anurakj/J88_stork/Air Filter.pdf

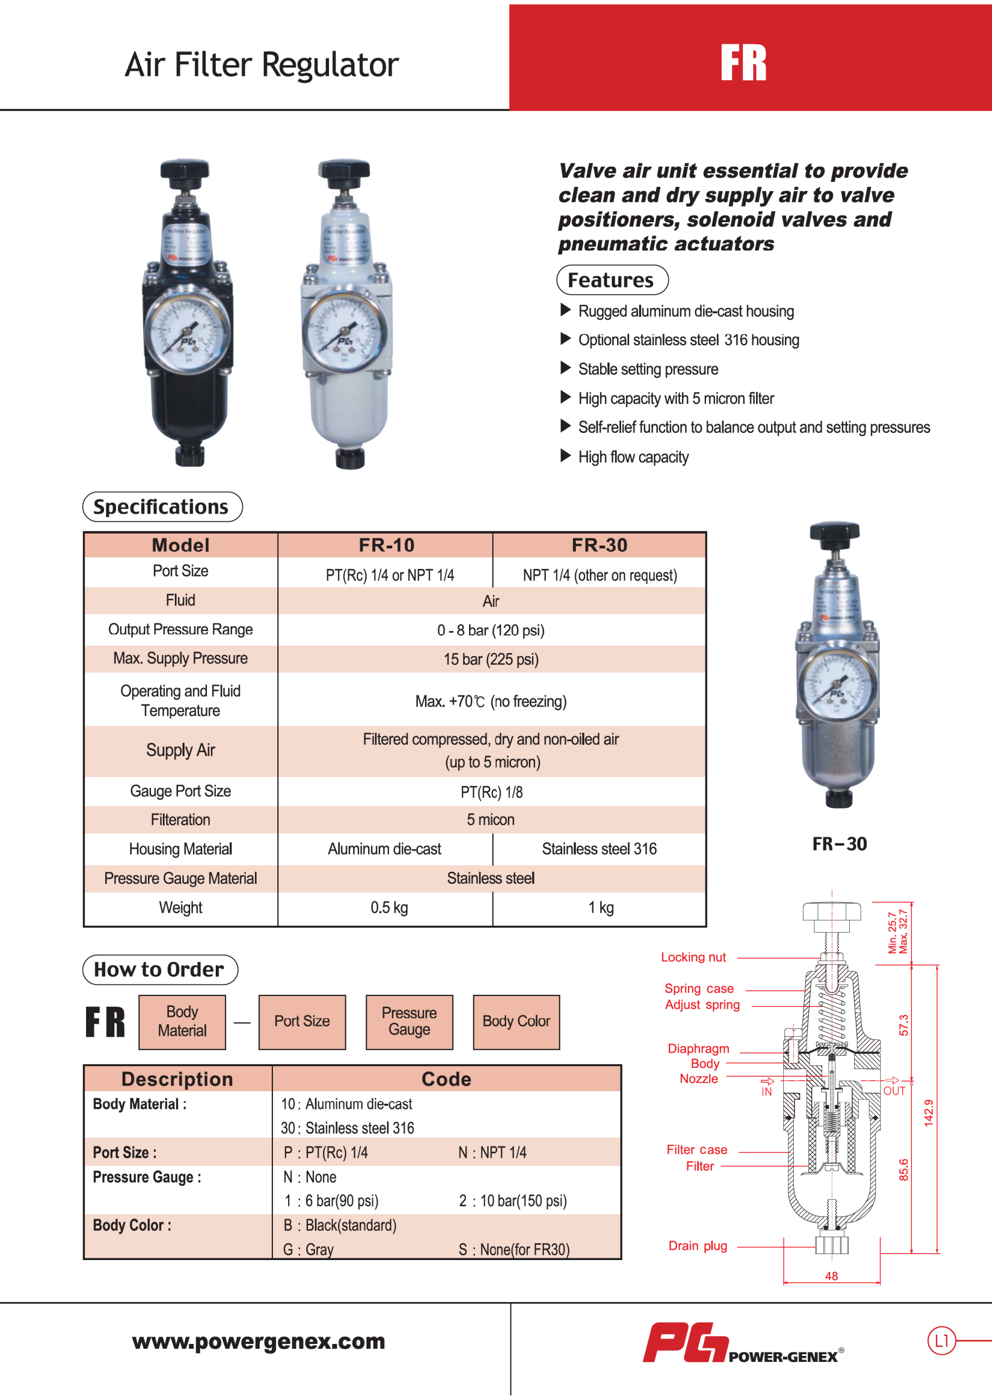
[picture p3: page 1]
