anurakj/J88_stork/Bypass_valves_logic_box/Catalogues/DIN_rail.png

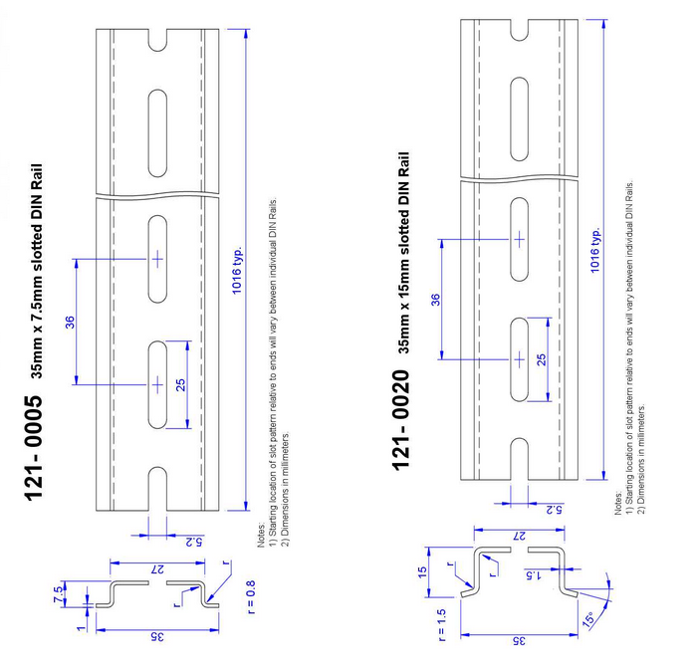
Bypass_valves_logic_box/Catalogues/DIN_rail.png
