anurakj/J88_stork/Bypass_valves_logic_box/Catalogues/Relay_socket_(Omron_PYFZ-14-E)_(top_view).png

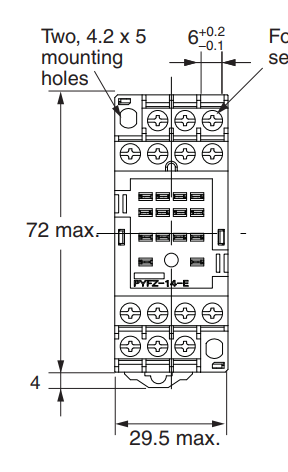
Bypass_valves_logic_box/Catalogues/Relay_socket_(Omron_PYFZ-14-E)_(top_view).png
