anurakj/J88_stork/ER.jpeg

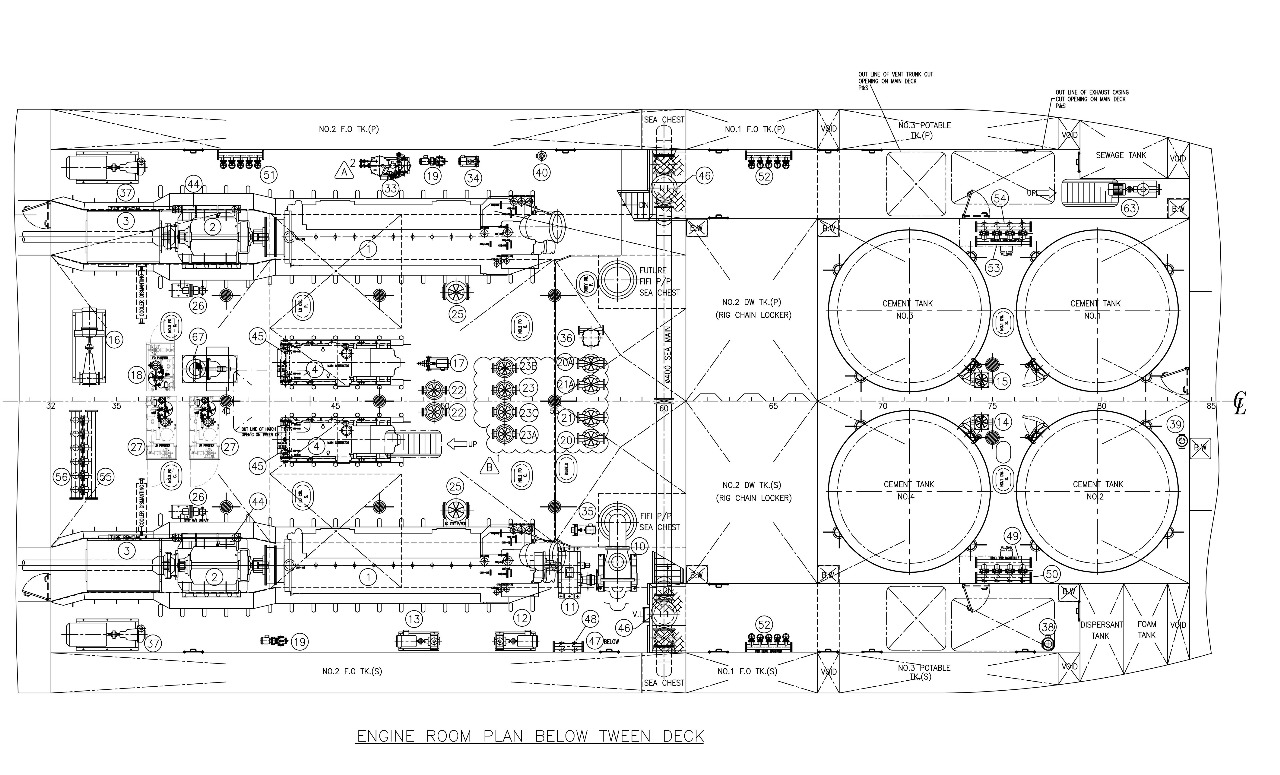
ER.jpeg
