anurakj/J88_stork/GSPL-P1482-PI-0301 Piping Spools drawing for BWTS  (1''& Above) R.B/Sampling.jpg

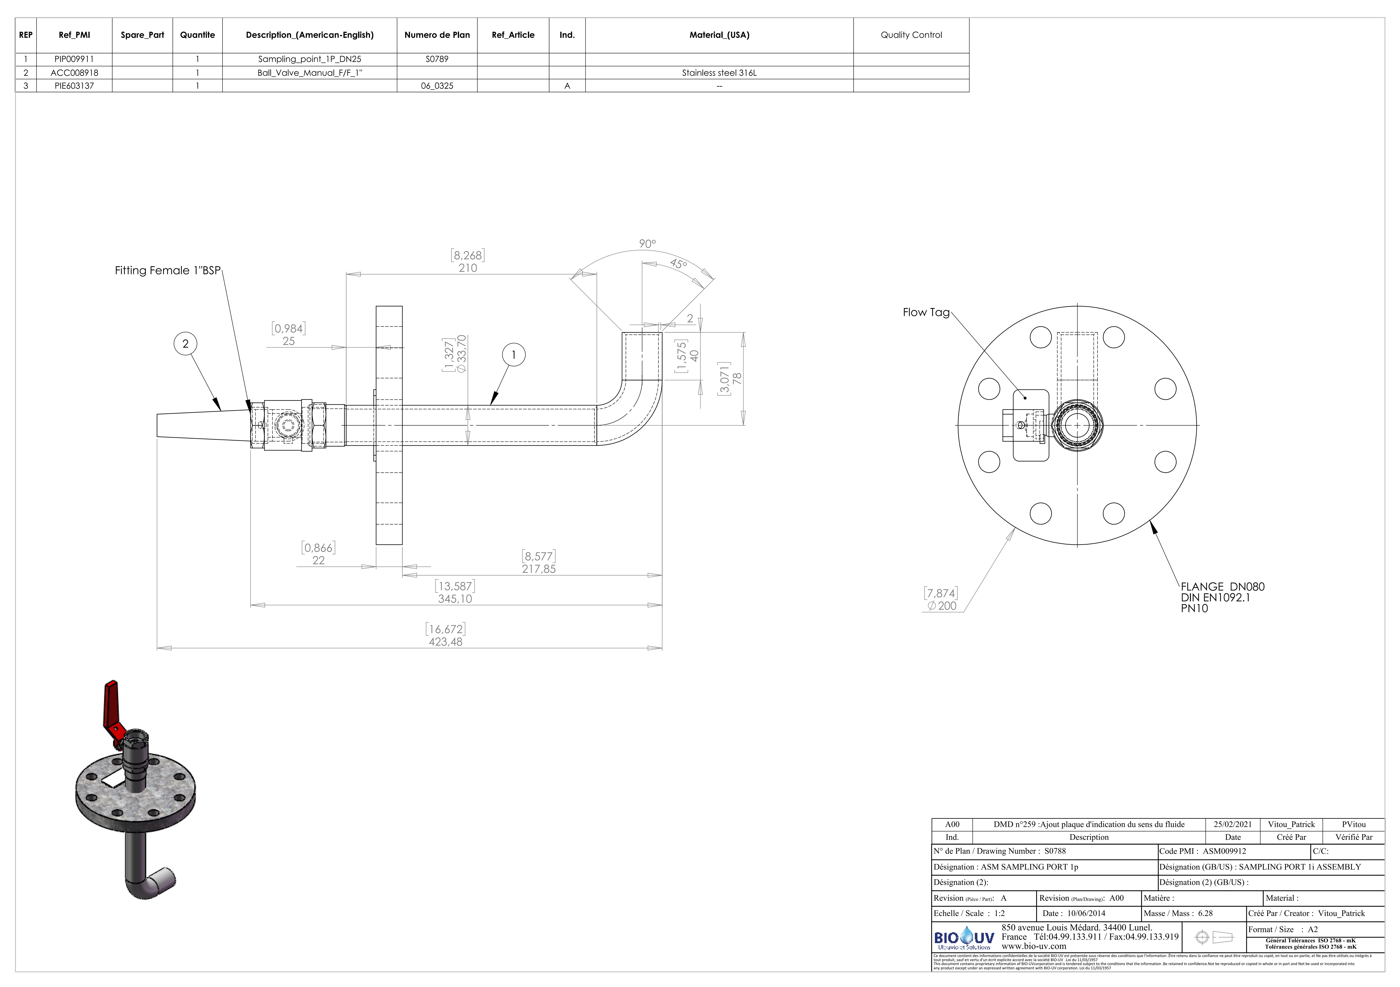
GSPL-P1482-PI-0301 Piping Spools drawing for BWTS (1''& Above) R.B/Sampling.jpg
