anurakj/J88_stork/Bypass_valves_logic_box/bypass valves logic box BOM_rev-B.xlsx

Revision-B |  |  | Note: This BOM is based on bypass valves configuration matrix revision B
Bypass valves logic box Bill Of Materials (BOM)
Vessel: J88 Stork
ITEM NO. | DESCRIPTION | BRAND/MODEL | QTY | Unit price (SGD) | sub totalc Price (SGD) | Remarks
1 | INTERPOSSING RELAY (4 CONTACTS) C/W SOCKET BASE |  | 20 pcs | $ 8.5 / set | 170 | Use 17 pcs. 3 pcs. for spare (loose spare. Not install in the box).
2 | 2 POLES 10 A MCB | Schneider | 1 pce | $ 23 / pce | 23
3 | 1.5 mm2 TERMINAL |  | 60 pcs | $ 0.85 / pce | 51
4 | Side plate for terminal |  | 10 pcs | $ 0.6 /pce | 6
5 | Stopper for terminal |  | 10 pcs | $ 0.6 /pce | 6
6 | Aluminium DIN RAIL 1 meter |  | 2 pcs | $ 3.5 / pce | 7
7 | 1.5 mm2 WIRE (GREY COLOUR) |  | 1 roll (100 meters) | $ 34 / roll | 34
8 | CABLE LUG PIN TYPE (1.5 mm2) |  | 1 pkt | $ 15 / pkt (500 pcs) | 15
9 | CONTROL BOX TO INSTALL ALL COMPONENTS) C/W MOUNTING HOLES AT 4 CORNERS) 400mm (W) X 500mm (H) X 200 MM (D) |  | 1 pce | $ 98 / pce | 98 | IP65, Color RAL7032 Light Grey
10 | M10 BOLT, NUT AND WASHER TO MOUNT THE CONTROL BOX |  | 4 set | $ 5 / set | 20 | Assume bolt nut 1 set 5 SGD
11 | 1.5 mm2 WHITE COLOUR FERRUL TUBE FOR WIRE ID |  | 5 meters | $ 0.2 / meter | 1
12 | 50mm x 50mm wire duct |  | 1 pce (2 meters) | $ 15 / pce | 15
13 | Cable grand (M20 X 1.5) (Nickel plated) |  | 17 pcs | $ 5.50 /pce | 93.5
14 | Cable grand (M25 X 1.5) (Nickel plated) |  | 1 pce | $ 7.60 /pce | 7.6
15 | Cable grand (M32 X 1.5) (Nickel plated) |  | 1 pce | $ 9.80 /pce | 9.8
16 | Design Engineering |  | 5 days | $ 25 /Hour | 1062.5 | 1day = 8.5 Hours
17 | Control BOX fabrication and wiring (Labour) |  | 5 days | $ 25 /Hour | 1062.5 | 1day = 8.5 Hours
18 | Warranty |  | 2 Years | $ 42.5 /Year | 85 | Inside the box have only MCB and relays. The components are very duable and maintenace free. Very rare that the relay will defected. (Assume in 1 year relay spoil 5 pcs.)
 |  |  |  | Total price | 2766.9 | <=== the figure is sum of prices above. (still not include the one that blank)
