anurakj/J88_stork/Bypass_valves_logic_box/Step_files/Relay_Socket.step

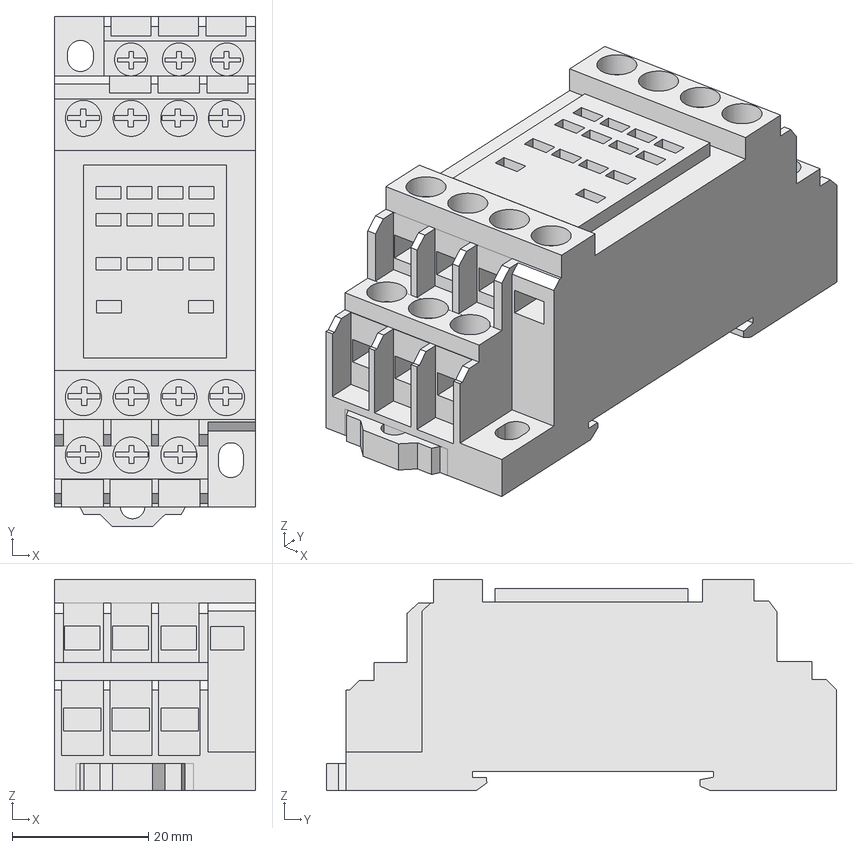
[picture p9: CAD file, 2024-11-26]
Bypass_valves_logic_box/Step_files/Relay_Socket.step
29.5 x 74.9 x 31.0 mm
