anurakj/J88_stork/Bypass_valves_logic_box/Step_files/interpossing_relay.step

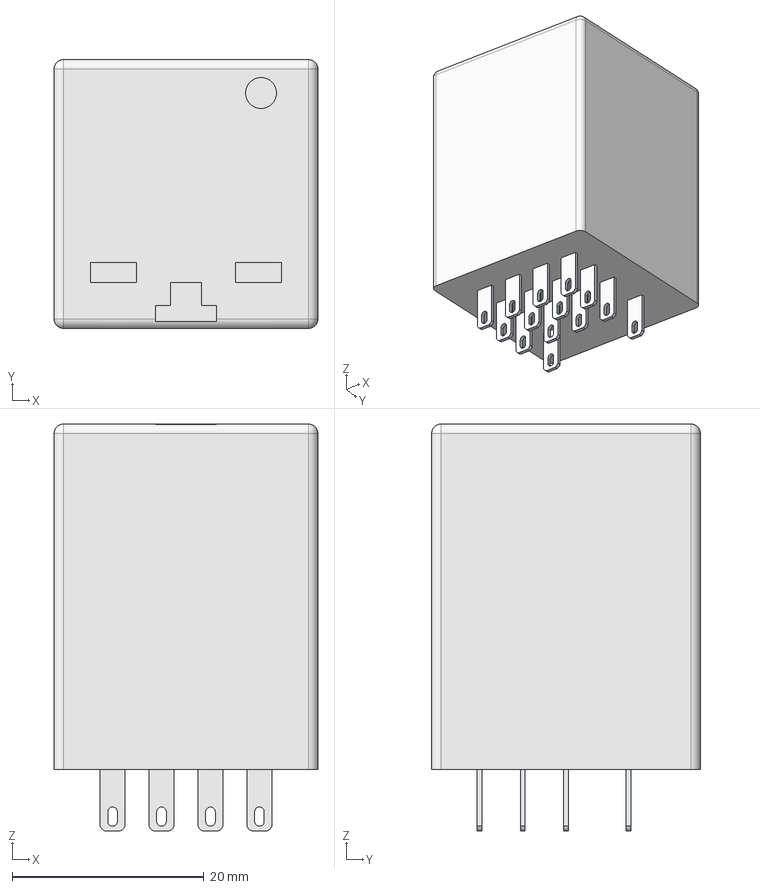
[picture p10: CAD file, 2024-11-26]
Bypass_valves_logic_box/Step_files/interpossing_relay.step
27.5 x 28.0 x 42.4 mm
