anurakj/J88_stork/Bypass_valves_logic_box/Bypass_valves_box_GA.dxf

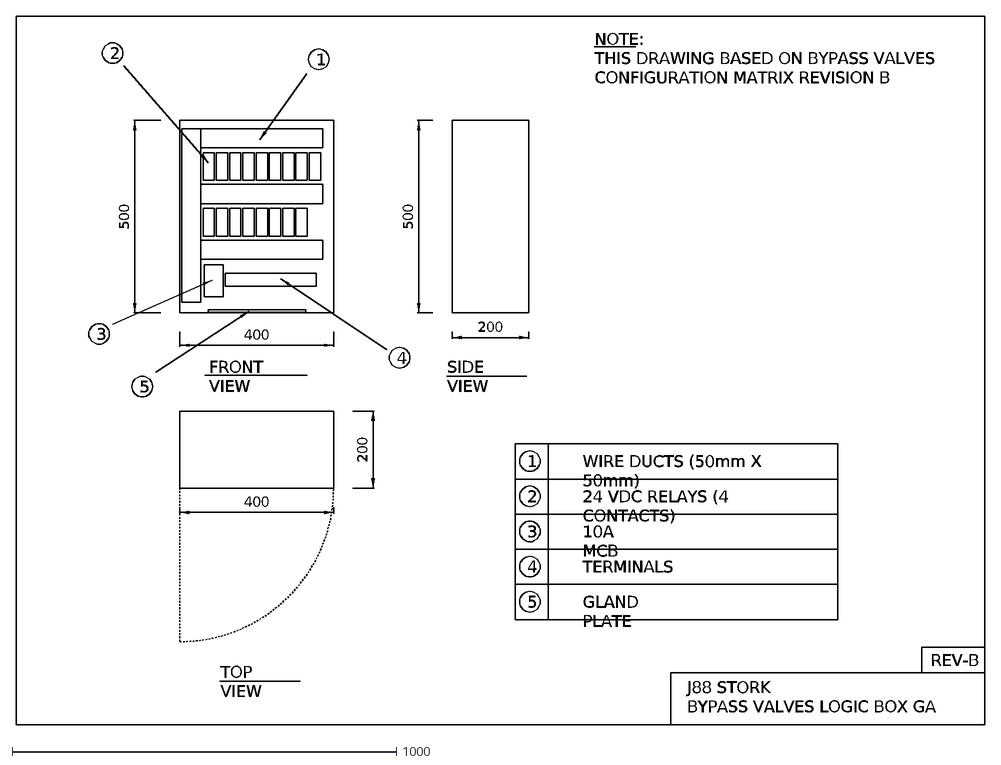
[picture p11: CAD file, 2024-11-26]
Bypass_valves_logic_box/Bypass_valves_box_GA.dxf
500
400
200
FRONT VIEW
SIDE VIEW
1
2
3
TOP VIEW
4
5
10A MCB
TERMINALS
GLAND PLATE
J88 STORK BYPASS VALVES LOGIC BOX GA
NOTE: THIS DRAWING BASED ON BYPASS VALVES CONFIGURATION MATRIX REVISION B
24 VDC RELAYS (4 CONTACTS)
WIRE DUCTS (50mm X 50mm)
REV-B
