anurakj/J88_stork/Bypass_valves_logic_box/Step_files/pxc_3044076_22_00_UT-2-5_3D_terminal.stp

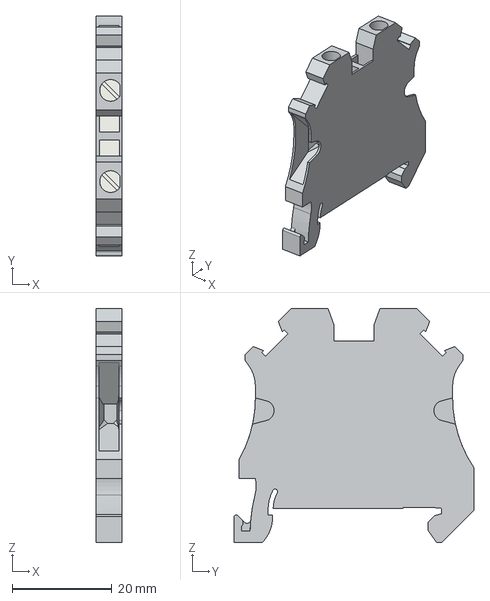
[picture p12: CAD file, 2024-11-26]
Bypass_valves_logic_box/Step_files/pxc_3044076_22_00_UT-2-5_3D_terminal.stp
5.15 x 48.0 x 46.9 mm
