anurakj/J88_stork/Bypass_valves_logic_box/Step_files/2P_10A_MCB.stp

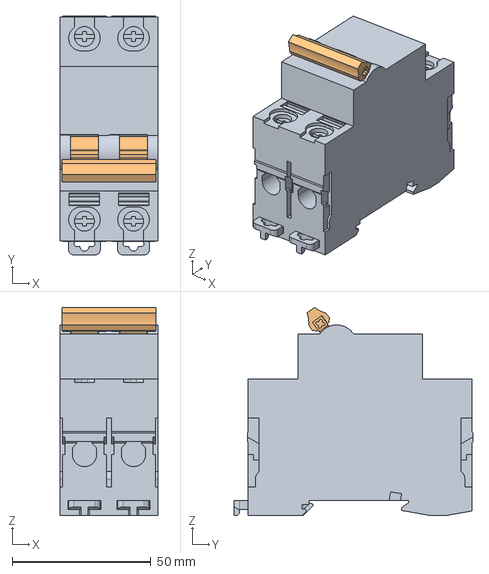
[picture p13: CAD file, 2024-11-26]
Bypass_valves_logic_box/Step_files/2P_10A_MCB.stp
35.4 x 86.2 x 75.1 mm
MANIFOLD_SOLID_BREP_17383
MANIFOLD_SOLID_BREP_21453
