anurakj/J88_stork/(list of files, cad)

Other CAD files:
Bypass_valves_logic_box/Bypass_valves_box_schematics_rev-C.dxf
Bypass_valves_logic_box/Catalogues/pxc_3044225_19_03_UT-35_2D.dxf
CAD_files/GSPL-P1482-PI-0001 BWTS PIPING SCHEMATIC R.B.dwg
GSPL-P1482-PI-0301 Piping Spools drawing for BWTS (1''& Above) R.B/BA01.010.1.dwg
CAD_files/GSPL-P1482-PI-0003 COMPRESSED AIR SYSTEM PIPING SCHEMATIC R.A.dwg
GSPL-P1482-PI-0301 Piping Spools drawing for BWTS (1''& Above) R.B/CA01.001.1.dwg
CAD_files/GSPL-P1482-PI-0004 SANITARY & F.W SERVICE SYSTEM PIPING SCHEMATIC R.A.dwg
GSPL-P1482-PI-0301 Piping Spools drawing for BWTS (1''& Above) R.B/BA02.005.1.dwg
Bypass_valves_logic_box/Step_files/Relay_Socket_black.step
GSPL-P1482-PI-0301 Piping Spools drawing for BWTS (1''& Above) R.B/BA02.003.1.dwg
Bypass_valves_logic_box/Step_files/interpossing_relay_red.step
GSPL-P1482-PI-0301 Piping Spools drawing for BWTS (1''& Above) R.B/BA01.011.1.dwg
GSPL-P1482-PI-0301 Piping Spools drawing for BWTS (1''& Above) R.B/BA01.001.1.dwg
GSPL-P1482-PI-0301 Piping Spools drawing for BWTS (1''& Above) R.B/BA03.001.1.dwg
GSPL-P1482-PI-0301 Piping Spools drawing for BWTS (1''& Above) R.B/BA05.001.1.dwg
GSPL-P1482-PI-0301 Piping Spools drawing for BWTS (1''& Above) R.B/BA06.001.1.dwg
GSPL-P1482-PI-0301 Piping Spools drawing for BWTS (1''& Above) R.B/BA03.017.1.dwg
GSPL-P1482-PI-0301 Piping Spools drawing for BWTS (1''& Above) R.B/BA03.008.1.dwg
GSPL-P1482-PI-0301 Piping Spools drawing for BWTS (1''& Above) R.B/BA01.003.1.dwg
GSPL-P1482-PI-0301 Piping Spools drawing for BWTS (1''& Above) R.B/BA01.009.1.dwg
GSPL-P1482-PI-0301 Piping Spools drawing for BWTS (1''& Above) R.B/BA03.010.1.dwg
GSPL-P1482-PI-0301 Piping Spools drawing for BWTS (1''& Above) R.B/BA04.003.1.dwg
GSPL-P1482-PI-0301 Piping Spools drawing for BWTS (1''& Above) R.B/BA04.002.1.dwg
GSPL-P1482-PI-0301 Piping Spools drawing for BWTS (1''& Above) R.B/BA03.005.1.dwg
GSPL-P1482-PI-0301 Piping Spools drawing for BWTS (1''& Above) R.B/BA03.007.1.dwg
GSPL-P1482-PI-0301 Piping Spools drawing for BWTS (1''& Above) R.B/BA03.009.1.dwg
GSPL-P1482-PI-0301 Piping Spools drawing for BWTS (1''& Above) R.B/BA03.014.1.dwg
GSPL-P1482-PI-0301 Piping Spools drawing for BWTS (1''& Above) R.B/BA03.006.1.dwg
GSPL-P1482-PI-0301 Piping Spools drawing for BWTS (1''& Above) R.B/BA02.001.1.dwg
GSPL-P1482-PI-0301 Piping Spools drawing for BWTS (1''& Above) R.B/BA03.011.1.dwg
GSPL-P1482-PI-0301 Piping Spools drawing for BWTS (1''& Above) R.B/BA02.004.1.dwg
GSPL-P1482-PI-0301 Piping Spools drawing for BWTS (1''& Above) R.B/BA01.007.1.dwg
GSPL-P1482-PI-0301 Piping Spools drawing for BWTS (1''& Above) R.B/Spool Index Sheet i.dwg
GSPL-P1482-PI-0301 Piping Spools drawing for BWTS (1''& Above) R.B/BA05.002.1.dwg
GSPL-P1482-PI-0301 Piping Spools drawing for BWTS (1''& Above) R.B/BA02.002.1.dwg
GSPL-P1482-PI-0301 Piping Spools drawing for BWTS (1''& Above) R.B/BA03.004.1.dwg
GSPL-P1482-PI-0301 Piping Spools drawing for BWTS (1''& Above) R.B/BA03.015.1.dwg
GSPL-P1482-PI-0301 Piping Spools drawing for BWTS (1''& Above) R.B/BA01.006.1.dwg
GSPL-P1482-PI-0301 Piping Spools drawing for BWTS (1''& Above) R.B/BA04.001.1.dwg
GSPL-P1482-PI-0301 Piping Spools drawing for BWTS (1''& Above) R.B/BA01.002.1.dwg
GSPL-P1482-PI-0301 Piping Spools drawing for BWTS (1''& Above) R.B/BA03.013.1.dwg
GSPL-P1482-PI-0301 Piping Spools drawing for BWTS (1''& Above) R.B/BA03.016.1.dwg
GSPL-P1482-PI-0301 Piping Spools drawing for BWTS (1''& Above) R.B/BA03.012.1.dwg
GSPL-P1482-PI-0301 Piping Spools drawing for BWTS (1''& Above) R.B/BA04.004.1.dwg
GSPL-P1482-PI-0301 Piping Spools drawing for BWTS (1''& Above) R.B/BA03.003.1.dwg
GSPL-P1482-PI-0301 Piping Spools drawing for BWTS (1''& Above) R.B/BA01.008.1.dwg
GSPL-P1482-PI-0301 Piping Spools drawing for BWTS (1''& Above) R.B/BA01.004.1.dwg
GSPL-P1482-PI-0301 Piping Spools drawing for BWTS (1''& Above) R.B/BA01.005.1.dwg
GSPL-P1482-PI-0301 Piping Spools drawing for BWTS (1''& Above) R.B/Sampling Port-01.dwg
GSPL-P1482-PI-0301 Piping Spools drawing for BWTS (1''& Above) R.B/BA03.002.1.dwg
0)_old_revisions/GSPL-P1482-PI-0001 BWTS PIPING SCHEMATIC R.A/GSPL-P1482-PI-0001 BWTS PIPING SCHEMATIC R.A.dwg
0)_old_revisions/GSPL-P1482-PI-0301 Piping Spools drawing for BWTS (1''& Above)/BA01.001.1.dwg
0)_old_revisions/GSPL-P1482-PI-0301 Piping Spools drawing for BWTS (1''& Above)/BA01.002.1.dwg
0)_old_revisions/GSPL-P1482-PI-0301 Piping Spools drawing for BWTS (1''& Above)/BA01.003.1.dwg
0)_old_revisions/GSPL-P1482-PI-0301 Piping Spools drawing for BWTS (1''& Above)/BA01.004.1.dwg
0)_old_revisions/GSPL-P1482-PI-0301 Piping Spools drawing for BWTS (1''& Above)/BA01.005.1.dwg
0)_old_revisions/GSPL-P1482-PI-0301 Piping Spools drawing for BWTS (1''& Above)/BA01.006.1.dwg
0)_old_revisions/GSPL-P1482-PI-0301 Piping Spools drawing for BWTS (1''& Above)/BA01.007.1.dwg
0)_old_revisions/GSPL-P1482-PI-0301 Piping Spools drawing for BWTS (1''& Above)/BA01.008.1.dwg
0)_old_revisions/GSPL-P1482-PI-0301 Piping Spools drawing for BWTS (1''& Above)/BA01.009.1.dwg
0)_old_revisions/GSPL-P1482-PI-0301 Piping Spools drawing for BWTS (1''& Above)/BA01.010.1.dwg
0)_old_revisions/GSPL-P1482-PI-0301 Piping Spools drawing for BWTS (1''& Above)/BA01.011.1.dwg
0)_old_revisions/GSPL-P1482-PI-0301 Piping Spools drawing for BWTS (1''& Above)/BA02.001.1.dwg
0)_old_revisions/GSPL-P1482-PI-0301 Piping Spools drawing for BWTS (1''& Above)/BA02.002.1.dwg
0)_old_revisions/GSPL-P1482-PI-0301 Piping Spools drawing for BWTS (1''& Above)/BA02.003.1.dwg
0)_old_revisions/GSPL-P1482-PI-0301 Piping Spools drawing for BWTS (1''& Above)/BA02.004.1.dwg
0)_old_revisions/GSPL-P1482-PI-0301 Piping Spools drawing for BWTS (1''& Above)/BA02.005.1.dwg
0)_old_revisions/GSPL-P1482-PI-0301 Piping Spools drawing for BWTS (1''& Above)/BA03.001.1.dwg
0)_old_revisions/GSPL-P1482-PI-0301 Piping Spools drawing for BWTS (1''& Above)/BA03.002.1.dwg
0)_old_revisions/GSPL-P1482-PI-0301 Piping Spools drawing for BWTS (1''& Above)/BA03.003.1.dwg
0)_old_revisions/GSPL-P1482-PI-0301 Piping Spools drawing for BWTS (1''& Above)/BA03.004.1.dwg
0)_old_revisions/GSPL-P1482-PI-0301 Piping Spools drawing for BWTS (1''& Above)/BA03.005.1.dwg
0)_old_revisions/GSPL-P1482-PI-0301 Piping Spools drawing for BWTS (1''& Above)/BA03.006.1.dwg
0)_old_revisions/GSPL-P1482-PI-0301 Piping Spools drawing for BWTS (1''& Above)/BA03.007.1.dwg
0)_old_revisions/GSPL-P1482-PI-0301 Piping Spools drawing for BWTS (1''& Above)/BA03.008.1.dwg
0)_old_revisions/GSPL-P1482-PI-0301 Piping Spools drawing for BWTS (1''& Above)/BA03.009.1.dwg
0)_old_revisions/GSPL-P1482-PI-0301 Piping Spools drawing for BWTS (1''& Above)/BA03.010.1.dwg
0)_old_revisions/GSPL-P1482-PI-0301 Piping Spools drawing for BWTS (1''& Above)/BA03.011.1.dwg
0)_old_revisions/GSPL-P1482-PI-0301 Piping Spools drawing for BWTS (1''& Above)/BA03.012.1.dwg
0)_old_revisions/GSPL-P1482-PI-0301 Piping Spools drawing for BWTS (1''& Above)/BA03.013.1.dwg
0)_old_revisions/GSPL-P1482-PI-0301 Piping Spools drawing for BWTS (1''& Above)/BA03.014.1.dwg
0)_old_revisions/GSPL-P1482-PI-0301 Piping Spools drawing for BWTS (1''& Above)/BA03.015.1.dwg
0)_old_revisions/GSPL-P1482-PI-0301 Piping Spools drawing for BWTS (1''& Above)/BA03.016.1.dwg
0)_old_revisions/GSPL-P1482-PI-0301 Piping Spools drawing for BWTS (1''& Above)/BA04.001.1.dwg
0)_old_revisions/GSPL-P1482-PI-0301 Piping Spools drawing for BWTS (1''& Above)/BA04.002.1.dwg
0)_old_revisions/GSPL-P1482-PI-0301 Piping Spools drawing for BWTS (1''& Above)/BA04.003.1.dwg
0)_old_revisions/GSPL-P1482-PI-0301 Piping Spools drawing for BWTS (1''& Above)/BA04.004.1.dwg
0)_old_revisions/GSPL-P1482-PI-0301 Piping Spools drawing for BWTS (1''& Above)/BA05.001.1.dwg
0)_old_revisions/GSPL-P1482-PI-0301 Piping Spools drawing for BWTS (1''& Above)/BA05.002.1.dwg
0)_old_revisions/GSPL-P1482-PI-0301 Piping Spools drawing for BWTS (1''& Above)/BA06.001.1.dwg
0)_old_revisions/GSPL-P1482-PI-0301 Piping Spools drawing for BWTS (1''& Above)/Sampling Port-01.dwg
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
