anurakj/J88_stork/GSPL-P1482-EL-0003 Wiring Diagram of Power System R.B.pdf

SCALE NTS | DRAWN | UNK | DRAWING NUMBER GSPL-P1482-EL-0003 | HULL NUMBER ------ | REV
| CHECKED | MM | | | B
SIZE A4 | VERIFIED | GC | DATE:-28.10.2024 | SHEET:- 01/12

## REVISIONS

# JP 88 STORK

# WIRING DIAGRAM OF POWER SYSTEM

B | 28.10.2024 | ISSUED FOR APPROVAL | UNK | MM | GC
A | 23.09.2024 | ISSUED FOR APPROVAL | UNK | MM | GC
REV | DATE | DESCRIPTION | MOD.BY | CKD.BY | APP.BY

## TITLE

## SHIP

1

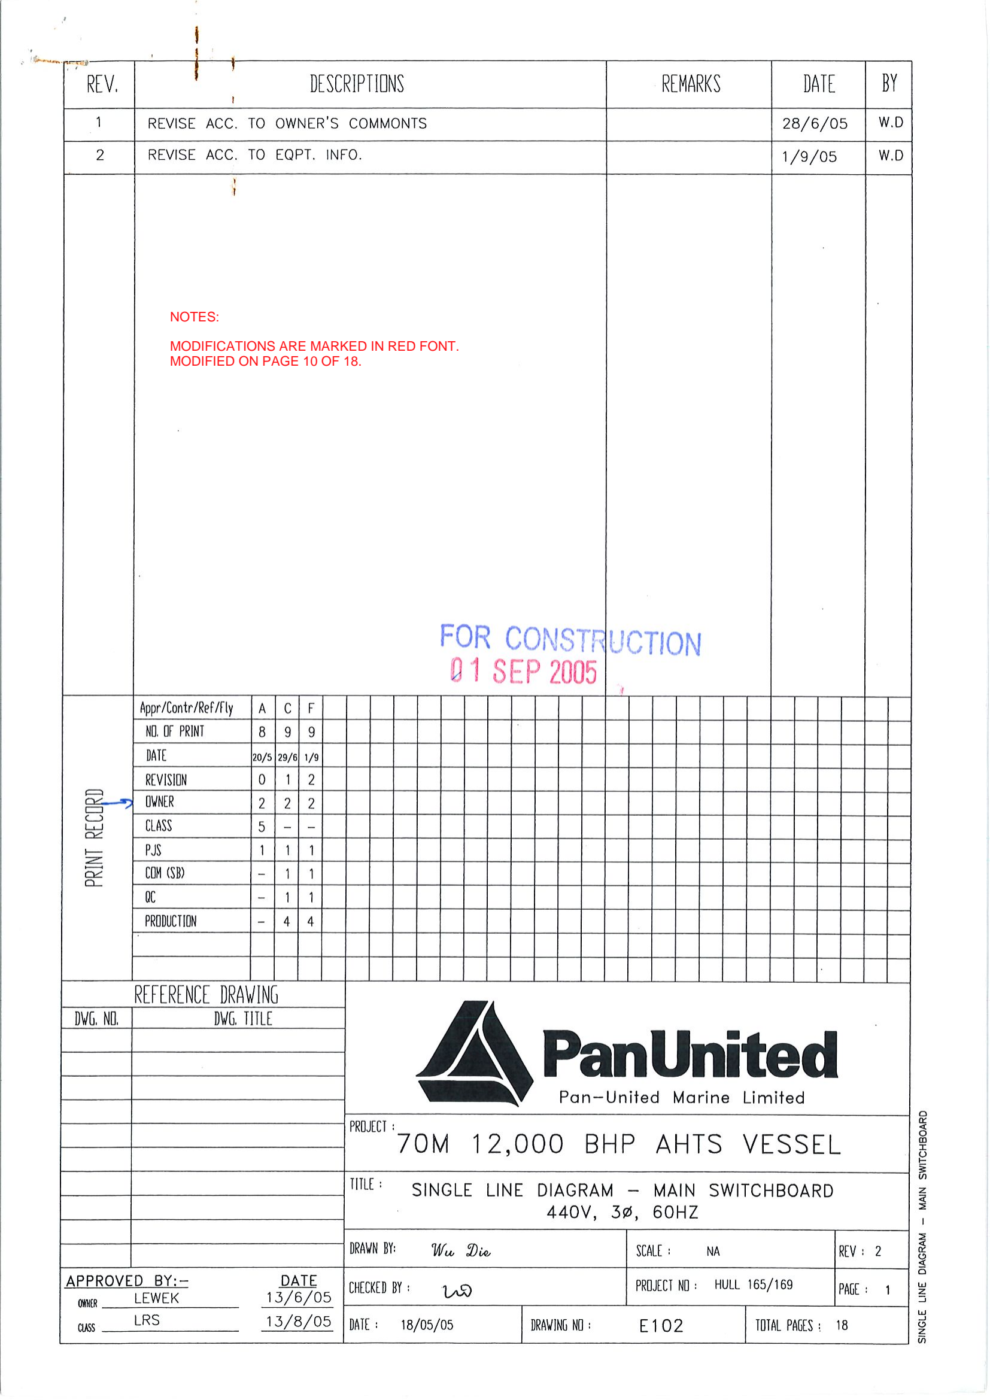
[picture p14: page 2]

NOTES:

MODIFICATIONS ARE MARKED IN RED FONT. MODIFIED ON PAGE 10 OF 18.

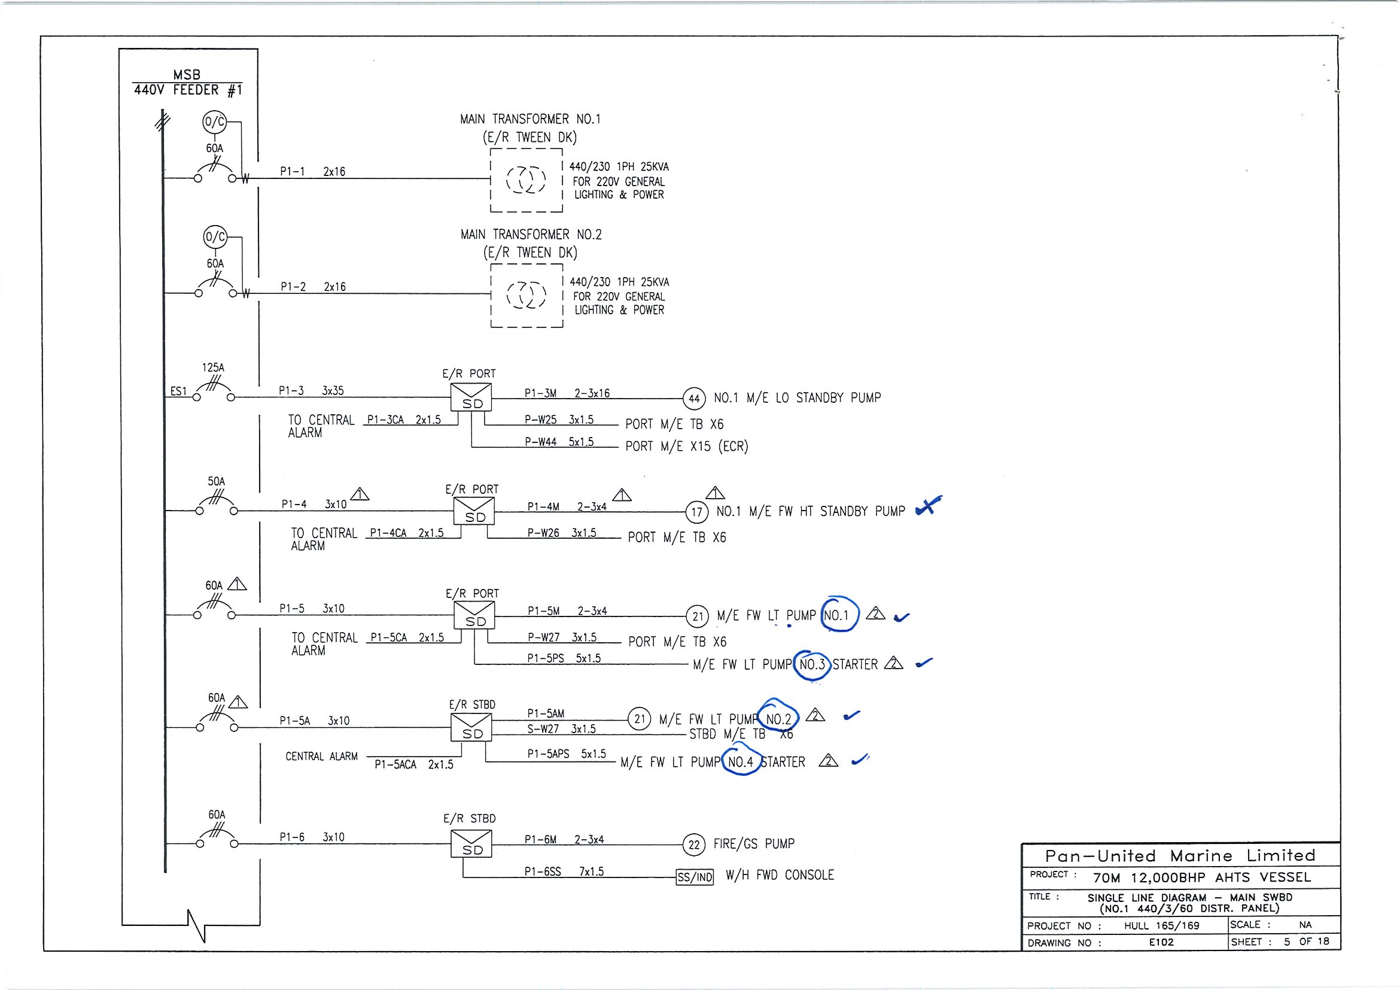
[picture p15: page 4]
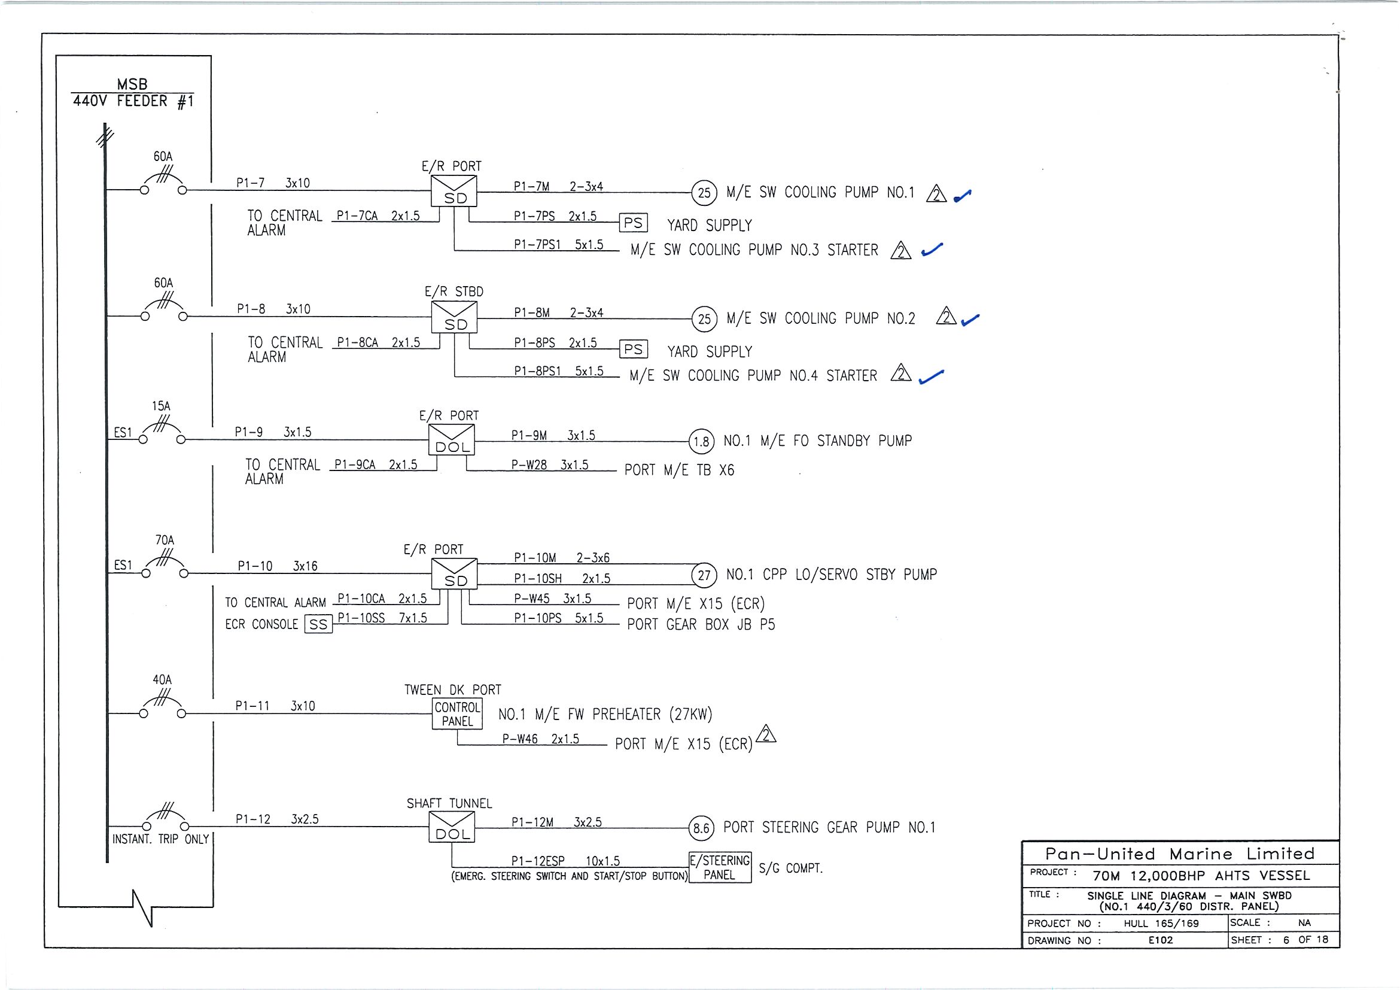
[picture p16: page 5]

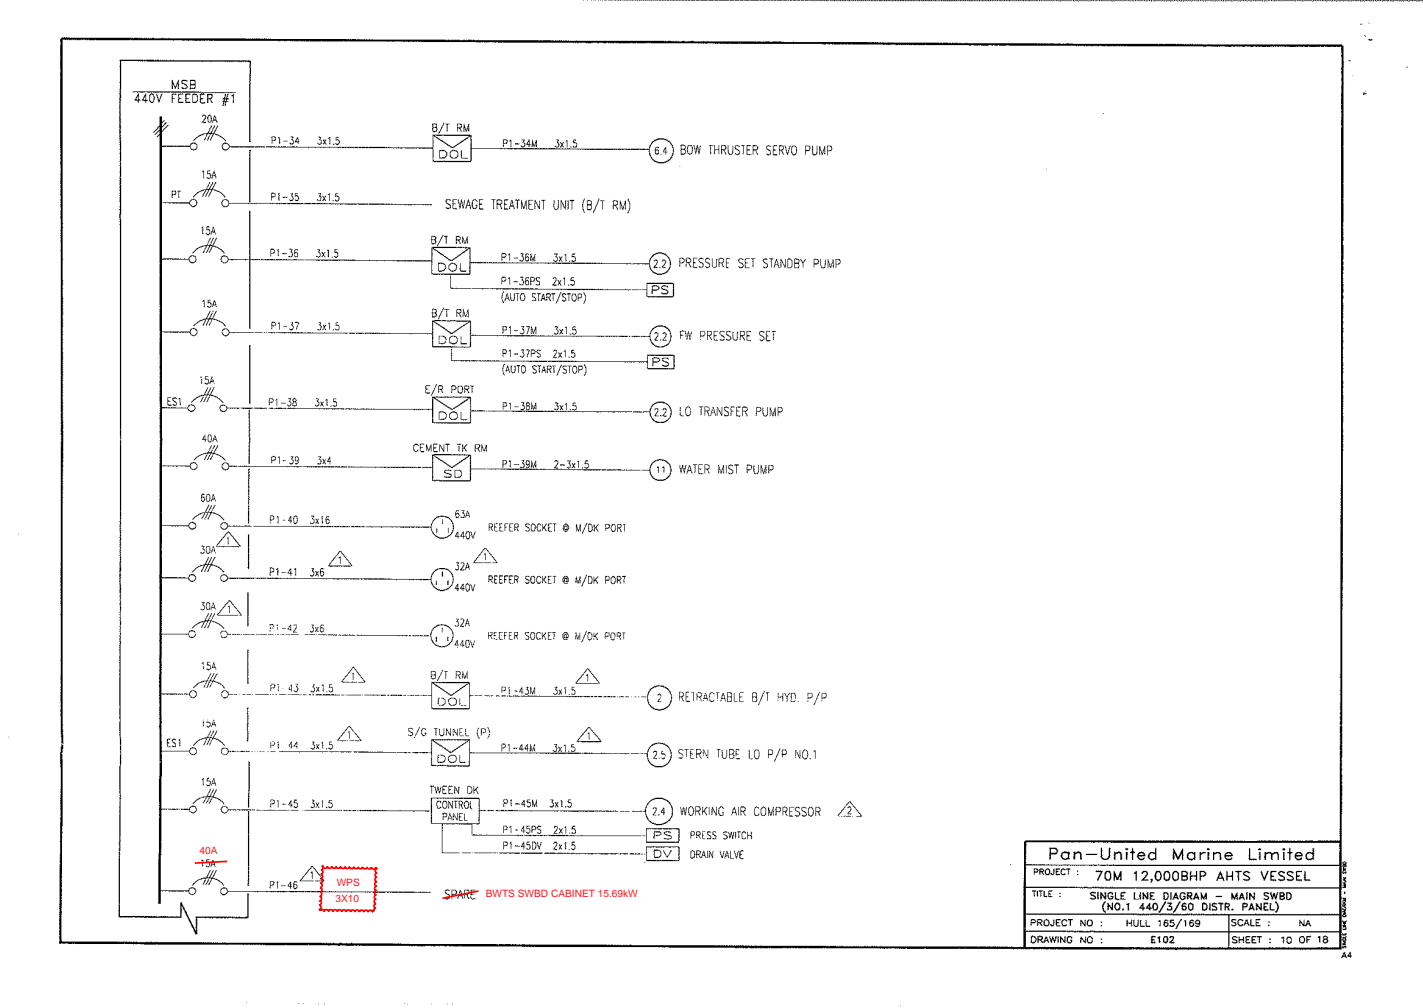
[picture p17: page 8]
P-BWTS-01 WPS; BWTS SWBD CABINET 15.69kW 3X10

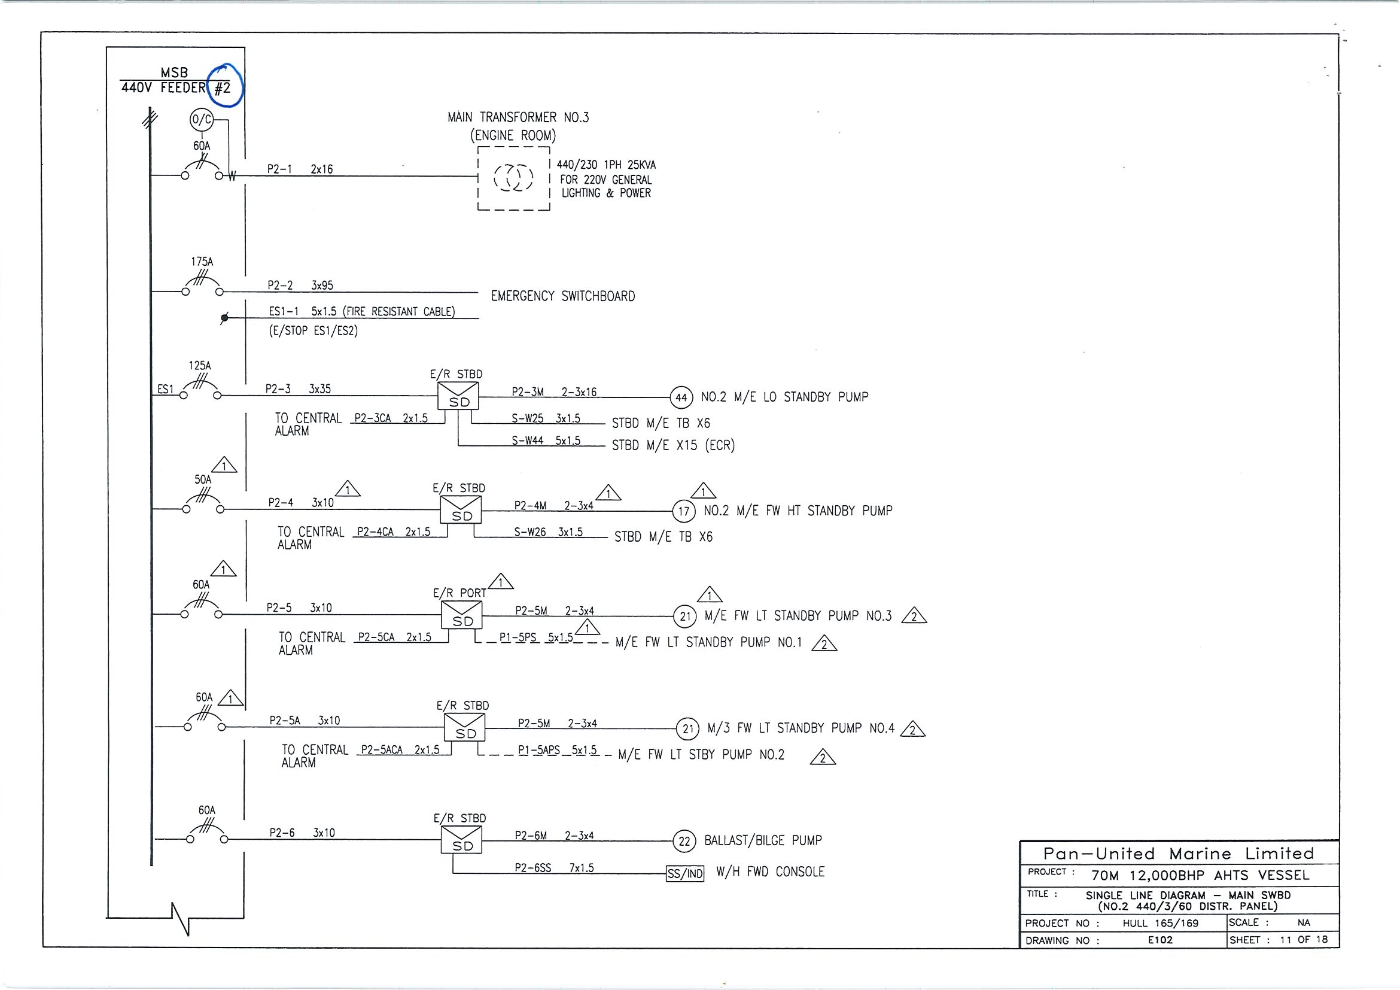
[picture p18: page 9]
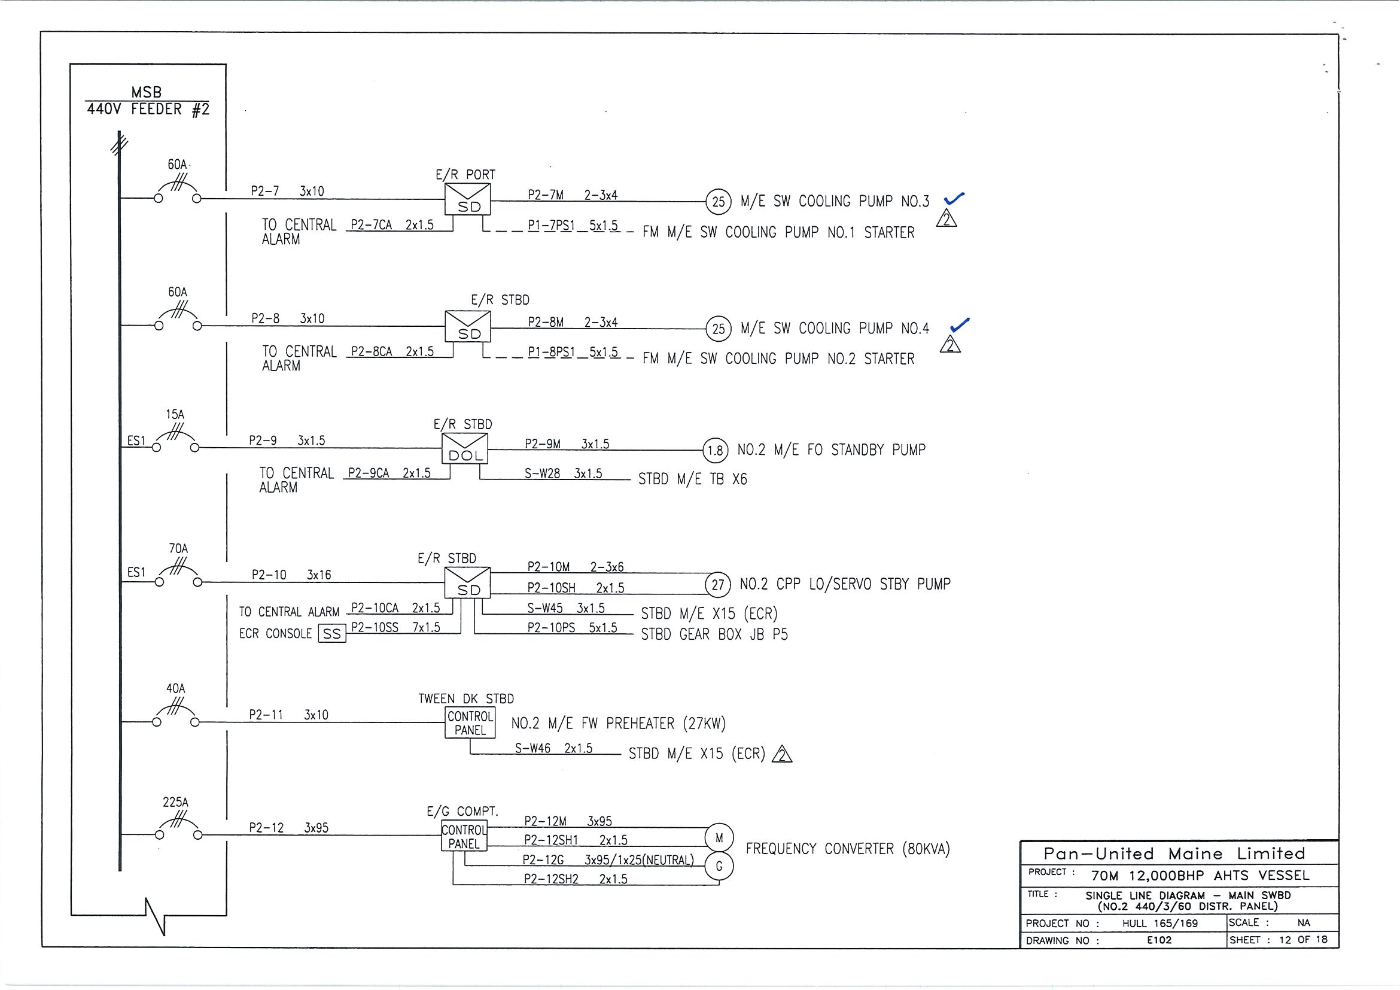
[picture p19: page 10]
