anurakj/J88_stork/0)_old_revisions/GSPL-P1482-PI-0104 VALVE LIST R.A.pdf

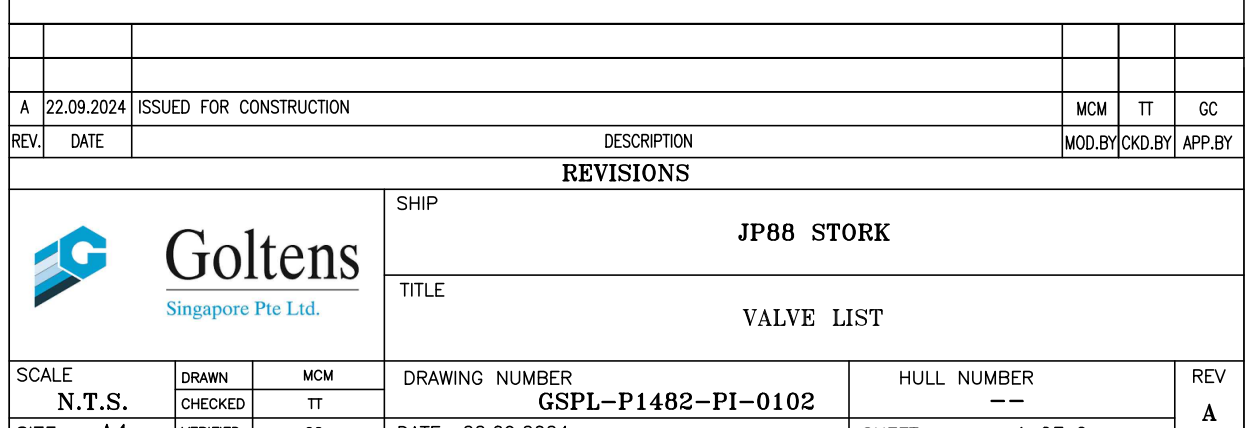
[picture p21: page 1]

BODY | TRIM
1 | BAV01 | Butterfly Valve (Manual) | 100A | 52 | JIS 5K | Wafer | Cast Iron | Al. Bronze | 1
2 | BAV02 | Butterfly Valve (Manual) | 100A | 52 | JIS 5K | Wafer | Cast Iron | Al. Bronze | 1
3 | BAV03 | Butterfly Valve (Manual) | 100A | 52 | JIS 5K | Wafer | Cast Iron | Al. Bronze | 1 | Valve with limit switch
4 | BAV04 | Butterfly Valve (Manual) | 100A | 52 | JIS 5K | Wafer | Cast Iron | Al. Bronze | 1 | Valve with limit switch
5 | BAV05 | Butterfly Valve (Manual) | 100A | 52 | JIS 5K | Wafer | Cast Iron | Al. Bronze | 1 | Valve with limit switch
6 | BAV06 | Butterfly Valve (Manual) | 100A | 52 | JIS 5K | Wafer | Cast Iron | Al. Bronze | 1 | Valve with limit switch
7 | BAV07 | Butterfly Valve (Manual) | 100A | 52 | JIS 5K | Wafer | Cast Iron | Al. Bronze | 1 | Valve with limit switch
8 | BAV08 | Butterfly Valve (Remote) | 100A | 52 | JIS 5K | Wafer | Cast Iron | Al. Bronze | 1
9 | BAV09 | Dual Plate Check Valve | 100A | 73 | JIS 5K | Wafer | Cast Iron | Al. Bronze | 1
10 | BAV10 | Butterfly Valve | 65A | 46 | JIS 5K | Wafer | Cast Iron | Al. Bronze | 1
11 | BAV11 | Dual Plate Check Valve | 65A | 67 | JIS 5K | Wafer | Cast Iron | Al. Bronze | 1
12 | CAV01 | Ball Valve | 15A | | JIS 10K | Flanged/ Threaded | Bronze | Bronze | 1
13 | AF01 | Air Regulator | 15A | | JIS 10K | Flanged/ Threaded | - | - | 1
14 | DH01 | Dehumidifier | 15A | | JIS 10K | Flanged/ Threaded | - | - | 1
15 | FWV01 | Ball Valve | 15A | | JIS 10K | Flanged/ Threaded | Bronze | Bronze | 1
16 | FWS01 | Y-Type Strainer - 50µm | 15A | | JIS 10K | Flanged/ Threaded | Bronze | | 1 | Mesh Size Max 50µm
1 | V01 | Butterfly Valve (Remote) | DN100 | PN10 | 1
2 | V02 | Butterfly Valve (Remote) | DN100 | PN10 | 1
3 | V03 | Butterfly Valve (Remote) | DN100 | PN10 | 1
4 | V04 | Butterfly Valve (Remote) | DN50 | PN10 | 1
5 | V05 | Ball Valve (Remote) | G1/2 | PN10 | 1
6 | V06 | Butterfly Valve (Remote) | DN80 | PN10 | 1
7 | VM51 | Butterfly Valve (Manual) | G1 | PN10 | 1
8 | VM52 | Butterfly Valve (Manual) | G1 | PN10 | 1
9 | VM53 | Butterfly Valve (Manual) | - | - | 1
10 | VM58 | Butterfly Valve (Manual) | - | - | 1
11 | VM54 | Butterfly Valve (Manual) | - | - | 1
12 | VM61 | Butterfly Valve (Manual) | - | - | 1
13 | VM62 | Butterfly Valve (Manual) | - | - | 1
14 | VM65 | Butterfly Valve (Manual) | - | - | 1
15 | VM71 | Butterfly Valve (Manual) | - | - | 1
16 | VM72 | Butterfly Valve (Manual) | - | - | 1
17 | PSV01 | Pressure Safety Valve | - | - | 1
18 | PSV11 | Pressure Safety Valve | - | - | 1
19 | V11 | Butterfly Valve (Remote) | DN50 | PN10 | 1
20 | V12 | Ball Valve (Remote) | G1/2 | PN10 | 1
21 | V13 | Ball Valve (Remote) | G1/2 | PN10 | 1
22 | PR01 | Pressure Reducing Valve | G1/2 | PN10 | 1
23 | PR02 | Pressure Reducing Valve | G1/2 | PN10 | 1
24 | PR03 | Pressure Reducing Valve | G1/2 | PN10 | 1
25 | SV | Solenoid Valve (Sampling) | DN25 | PN10 | 2
TAG NO. | DESCRIPTION | SIZE | LENGTH(FACE TO FACE IN MM) | RATING | STANDARD | END TYPE | MATERIAL Sl NO. | QUANTITY | WEIGHT (kg) | REMARKS

YARD/OWNER SCOPE

MAKER SCOPE
