anurakj/J88_stork/0)_old_revisions/GSPL-P1482-PI-0301 Piping Spools drawing for BWTS  (1''& Above).pdf

# SPOOL INDEX SHEET

SPOOL NAME | SHEET NO | DRAWN | DATE | REVISION | REMARKS
SPOOL INDEX SHEET | i | | 20-09-2024 | A
BA01-001 | 1 | | 20-09-2024 | A
BA01-002 | 2 | | 20-09-2024 | A
BA01-003 | 3 | | 20-09-2024 | A
BA01-004 | 4 | | 20-09-2024 | A
BA01-005 | 5 | | 20-09-2024 | A
BA01-006 | 6 | | 20-09-2024 | A
BA01-007 | 7 | | 20-09-2024 | A
BA01-008 | 8 | | 20-09-2024 | A
BA01-009 | 9 | | 20-09-2024 | A
BA01-010 | 10 | | 20-09-2024 | A
BA01-011 | 11 | | 20-09-2024 | A
BA02-001 | 12 | | 20-09-2024 | A
BA02-002 | 13 | | 20-09-2024 | A
BA02-003 | 14 | | 20-09-2024 | A
BA02-004 | 15 | | 20-09-2024 | A
BA02-005 | 16 | | 20-09-2024 | A
BA03-001 | 17 | | 20-09-2024 | A
BA03-002 | 18 | | 20-09-2024 | A
BA03-003 | 19 | | 20-09-2024 | A
BA03-004 | 20 | | 20-09-2024 | A
BA03-005 | 21 | | 20-09-2024 | A
BA03-006 | 22 | | 20-09-2024 | A
BA03-007 | 23 | | 20-09-2024 | A
BA03-008 | 24 | | 20-09-2024 | A
BA03-009 | 25 | | 20-09-2024 | A | | 1.GSPL-P1482-PI-0001 BWTS Piping Schematic 2.GSPL-P1482-PI-0003 Compressed air system piping schematic R.A 3.GSPL-P1482-PI-0004 Sanitary & F.W service system piping schematic R.A 4.GSPL-P1482-PI-0201 Piping Arrangement Drawing for BWTS (1" & Above)
BA03-010 | 26 | | 20-09-2024 | A
BA03-011 | 27 | | 20-09-2024 | A
BA03-012 | 28 | | 20-09-2024 | A
BA03-013 | 29 | | 20-09-2024 | A
BA03-014 | 30 | | 20-09-2024 | A
BA03-015 | 31 | | 20-09-2024 | A
BA03-016 | 32 | | 20-09-2024 | A
BA04-001 | 33 | | 20-09-2024 | A
BA04-002 | 34 | | 20-09-2024 | A
BA04-003 | 35 | | 20-09-2024 | A
BA04-004 | 36 | | 20-09-2024 | A
BA05-001 | 37 | | 20-09-2024 | A
BA05-002 | 38 | | 20-09-2024 | A
BA06-001 | 39 | | 20-09-2024 | A
SAMPLING PORT | 39A | 20-09-2024 | A

### BA 01 - 001 LINE NUMBER

# PIPE LEGEND

### SYSTEM SPOOL NUMBER

Client: EMAS OFFSHORE LIMITED | BWTS Maker : BIO-SEA
Location: - | IMO No.: 9354947
Project No: P1482 | Project Name: JP 88 STORK
Drawing title:
Scale | Format | Sheet | Drawing No: | Revision No.
N.T.S | A3

## PIPING SPOOL DRAWING FOR BWTS (1" & ABOVE)

A | 20/09/2024 | ISSUED FOR CONSTRUCTION | SK | TT | GC
REV. | DATE | DESCRIPTION | DRAWN BY | CHKD BY | APPRD
i | GSPL-P1482-PI-0301 | A

### REFERENCE DOCUMENTS:

### FWD(X)

### PORT(Y)

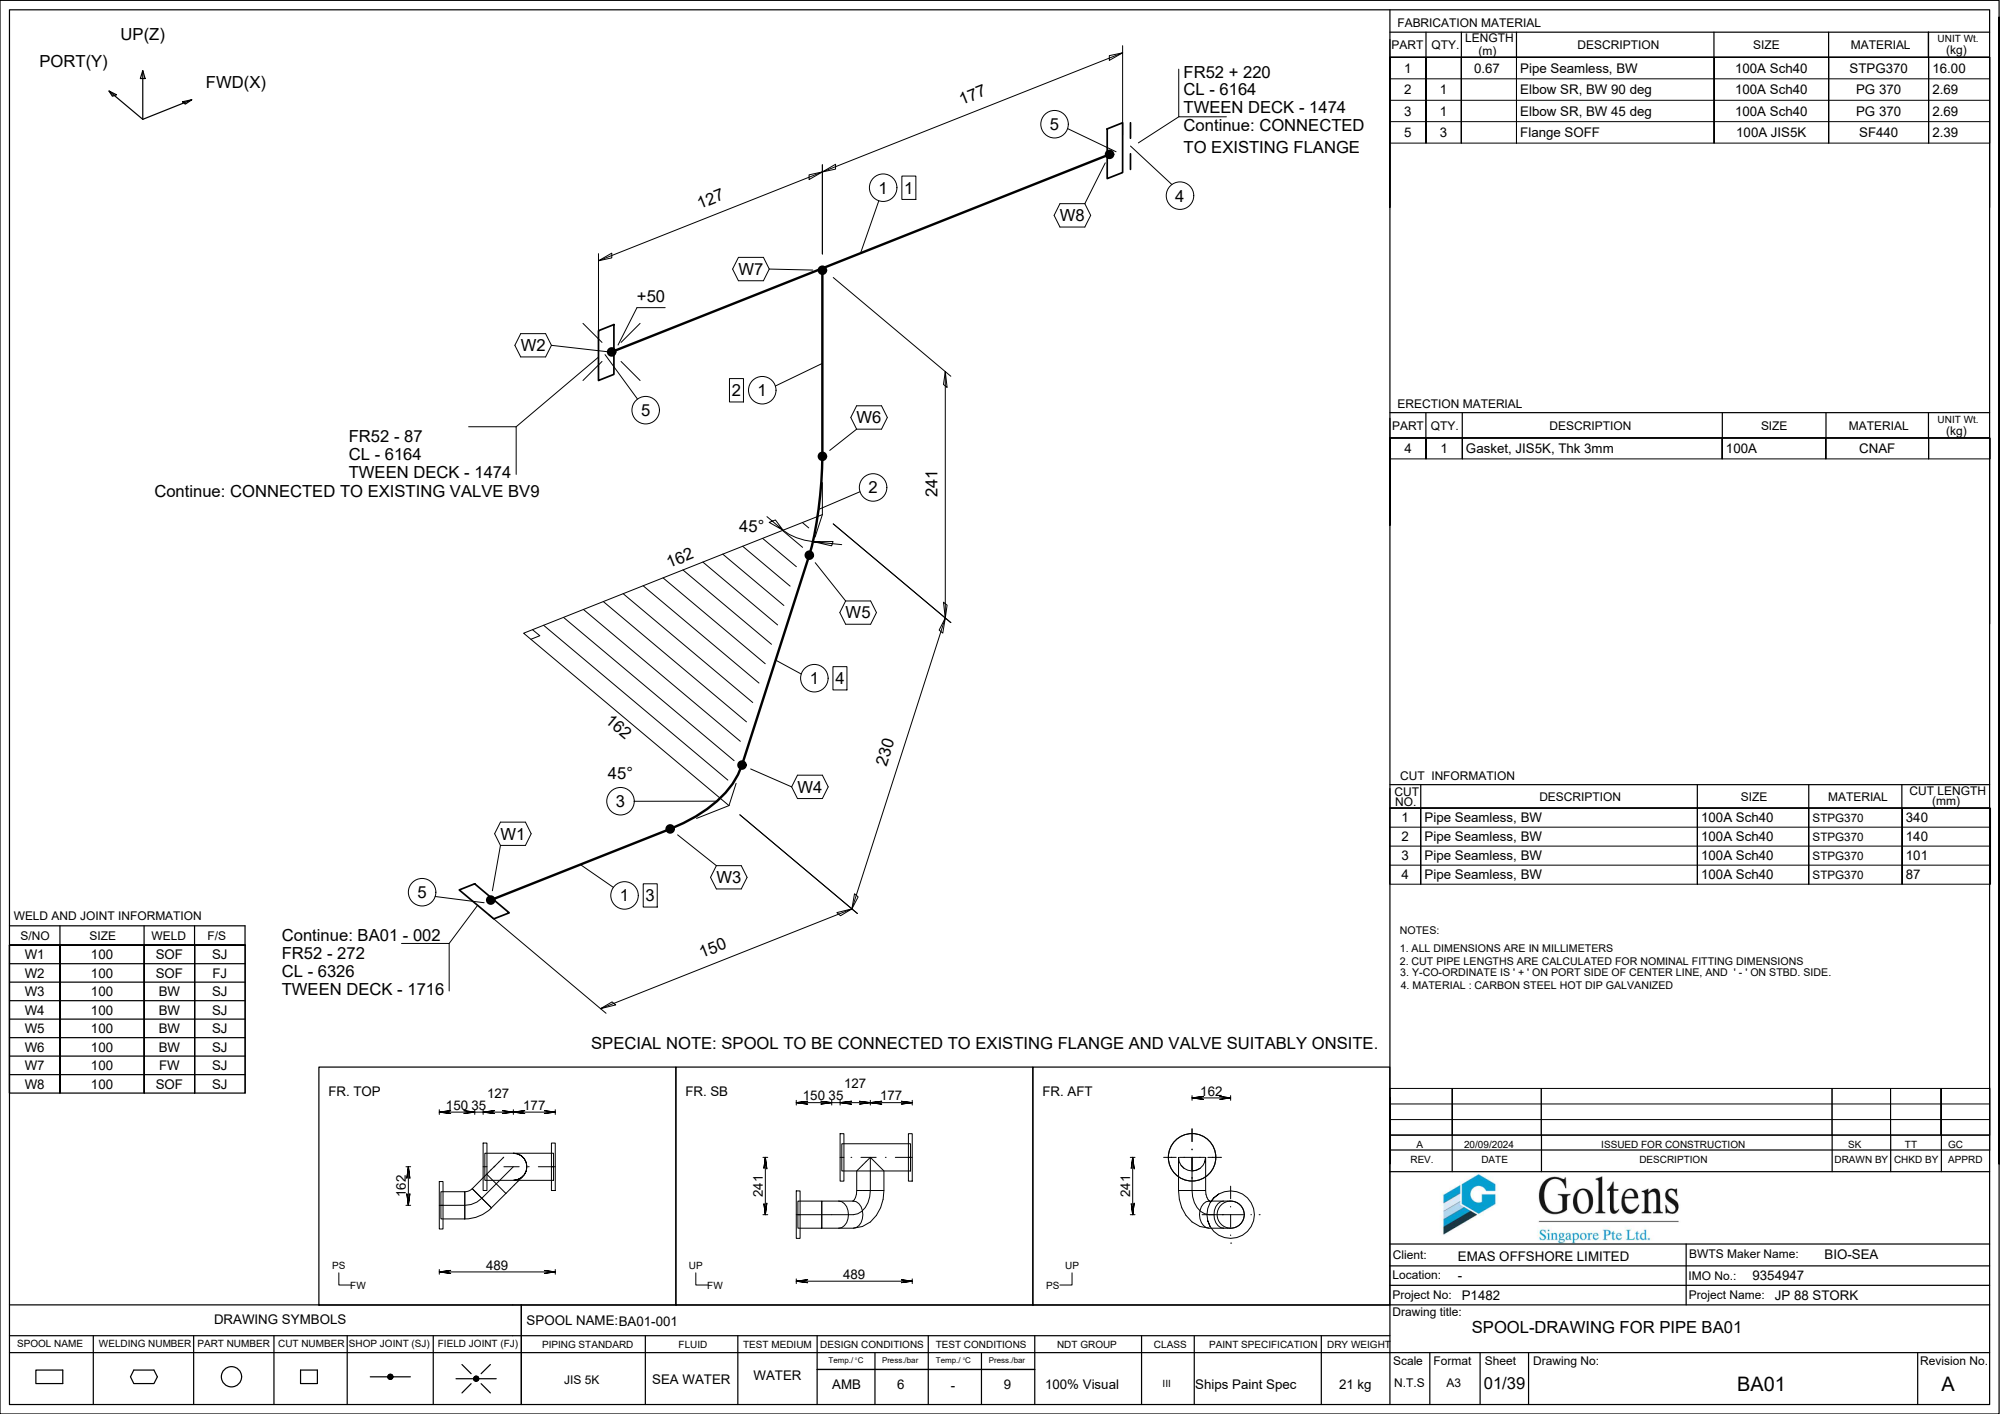
[picture p22: page 2]
162 127 FR. TOP; FR. AFT; AMB; SEA WATER; WATER; 100% Visual; Ships Paint Spec; JP 88 STORK; Flange SOFF; 100A JIS5K; Gasket, JIS5K, Thk 3mm; CNAF; SOF; Pipe Seamless, BW; 100A Sch40; STPG370; REV.; DATE; DESCRIPTION; DRAWN BY; CHKD BY; APPRD; Location:; Project No:; Client:; DRAWING SYMBOLS; SPOOL NAME; WELDING NUMBER; PART NUMBER; CUT NUMBER; FABRICATION MATERIAL; ERECTION MATERIAL; CUT INFORMATION; SIZE; WELD; PART; QTY.; MATERIAL; Temp./ C PIPING STANDARD; FLUID; TEST MEDIUM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

PART | QTY. | (m) | DESCRIPTION LENGTH | SIZE | MATERIAL | UNIT Wt. (kg)

TWEEN DECK - 1474
Continue: CONNECTED
TO EXISTING FLANGE

1 | | 0.67 | Pipe Seamless, BW | 100A Sch40 | STPG370 | 16.00
2 | 1 | | Elbow SR, BW 90 deg | 100A Sch40 | PG 370 | 2.69
3 | 1 | | Elbow SR, BW 45 deg | 100A Sch40 | PG 370 | 2.69

UNIT Wt. (kg)

Continue: CONNECTED TO EXISTING VALVE BV9

CUT NO. | DESCRIPTION | SIZE | MATERIAL | CUT LENGTH (mm)

1 | Pipe Seamless, BW | 100A Sch40 | STPG370 | 340
2 | Pipe Seamless, BW | 100A Sch40 | STPG370 | 140
3 | Pipe Seamless, BW | 100A Sch40 | STPG370 | 101

WELD AND JOINT INFORMATION

NOTES:
1. ALL DIMENSIONS ARE IN MILLIMETERS
2. CUT PIPE LENGTHS ARE CALCULATED FOR NOMINAL FITTING DIMENSIONS
3. Y-CO-ORDINATE IS ' + ' ON PORT SIDE OF CENTER LINE, AND ' - ' ON STBD. SIDE.
4. MATERIAL : CARBON STEEL HOT DIP GALVANIZED

W1 | 100 | SOF | SJ
W2 | 100 | SOF | FJ
W3 | 100 | BW | SJ
W4 | 100 | BW | SJ
W5 | 100 | BW | SJ
W6 | 100 | BW | SJ
W7 | 100 | FW | SJ

SPECIAL NOTE: SPOOL TO BE CONNECTED TO EXISTING FLANGE AND VALVE SUITABLY ONSITE.

- BIO-SEA
EMAS OFFSHORE LIMITED

BWTS Maker Name:

IMO No.: NDT GROUP

SPOOL-DRAWING FOR PIPE

SHOP JOINT (SJ) | FIELD JOINT (FJ) | TEST CONDITIONS | | CLASS | PAINT SPECIFICATION

Press./bar | Temp./ C | Press./bar

### FWD(X)

### UP(Z)

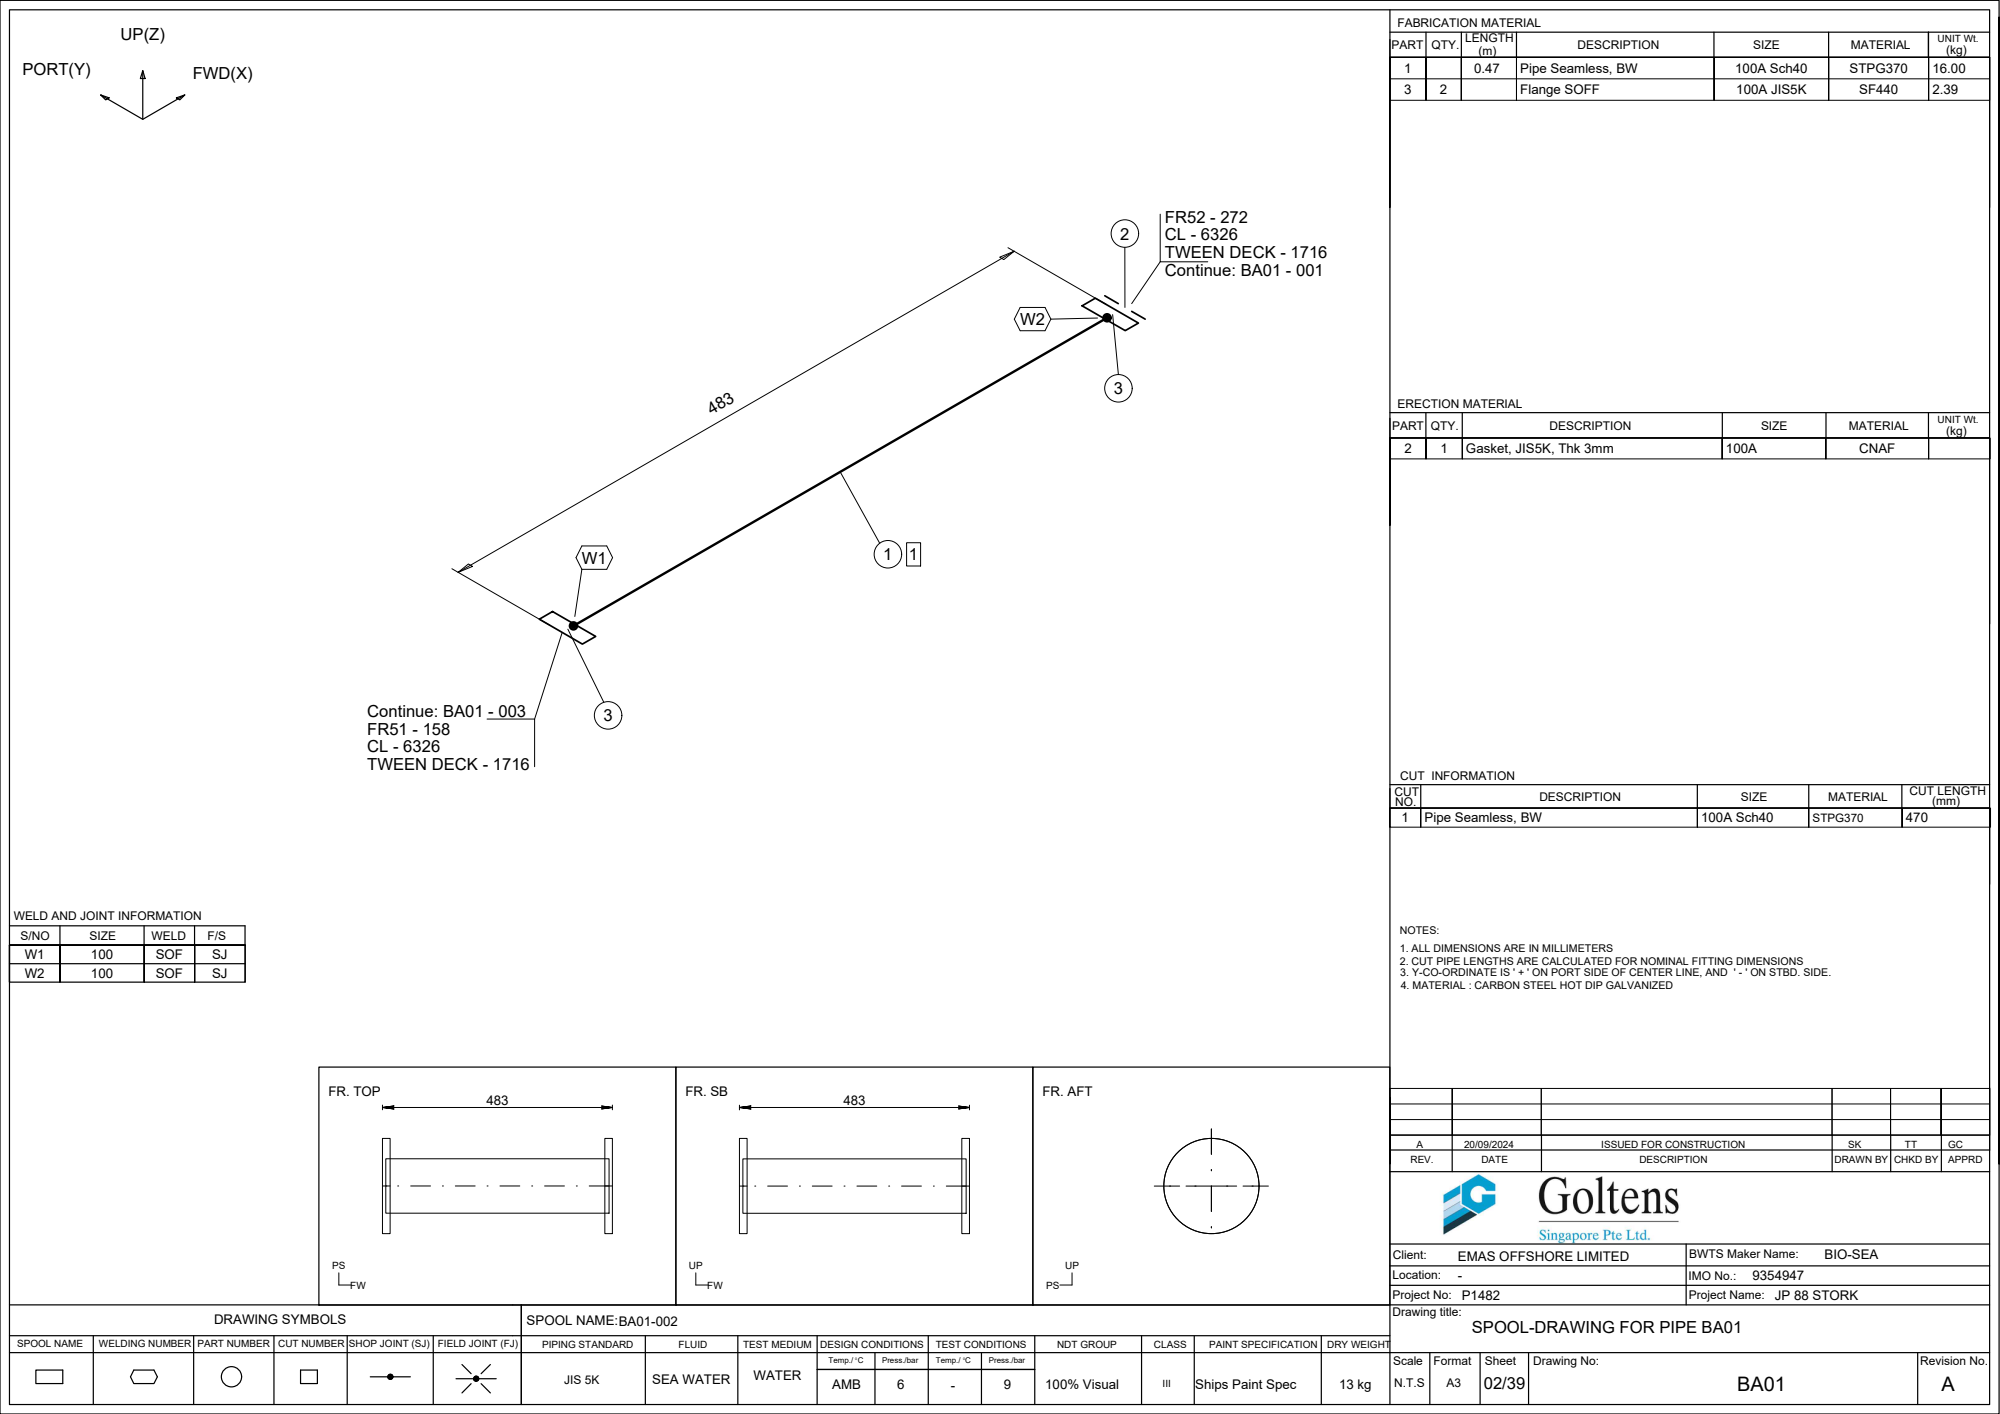
[picture p23: page 3]
PORT(Y); 483 FR. TOP; FR. AFT; AMB; Pipe Seamless, BW; 100A Sch40; STPG370; Flange SOFF; 100A JIS5K; Gasket, JIS5K, Thk 3mm; CNAF; SOF; REV.; DATE; DESCRIPTION; DRAWN BY; CHKD BY; APPRD; Location:; Client:; ERECTION MATERIAL; CUT INFORMATION; SIZE; WELD; PART; QTY.; MATERIAL; ISSUED FOR CONSTRUCTION; TWEEN DECK - 1716; Continue: BA01 - 001; FR51 - 158 CL - 6326 TWEEN DECK - 1716; Continue: BA01 - 003

UNIT Wt. (kg)

CUT NO. | DESCRIPTION | SIZE | MATERIAL | CUT LENGTH (mm)

1 | Pipe Seamless, BW | 100A Sch40 | STPG370 | 470

WELD AND JOINT INFORMATION

NOTES:
1. ALL DIMENSIONS ARE IN MILLIMETERS
2. CUT PIPE LENGTHS ARE CALCULATED FOR NOMINAL FITTING DIMENSIONS
3. Y-CO-ORDINATE IS ' + ' ON PORT SIDE OF CENTER LINE, AND ' - ' ON STBD. SIDE.
4. MATERIAL : CARBON STEEL HOT DIP GALVANIZED

- BIO-SEA
EMAS OFFSHORE LIMITED

BWTS Maker Name:

IMO No.: NDT GROUP

PORT(Y) | FWD(X)

### TWEEN DECK - 1716

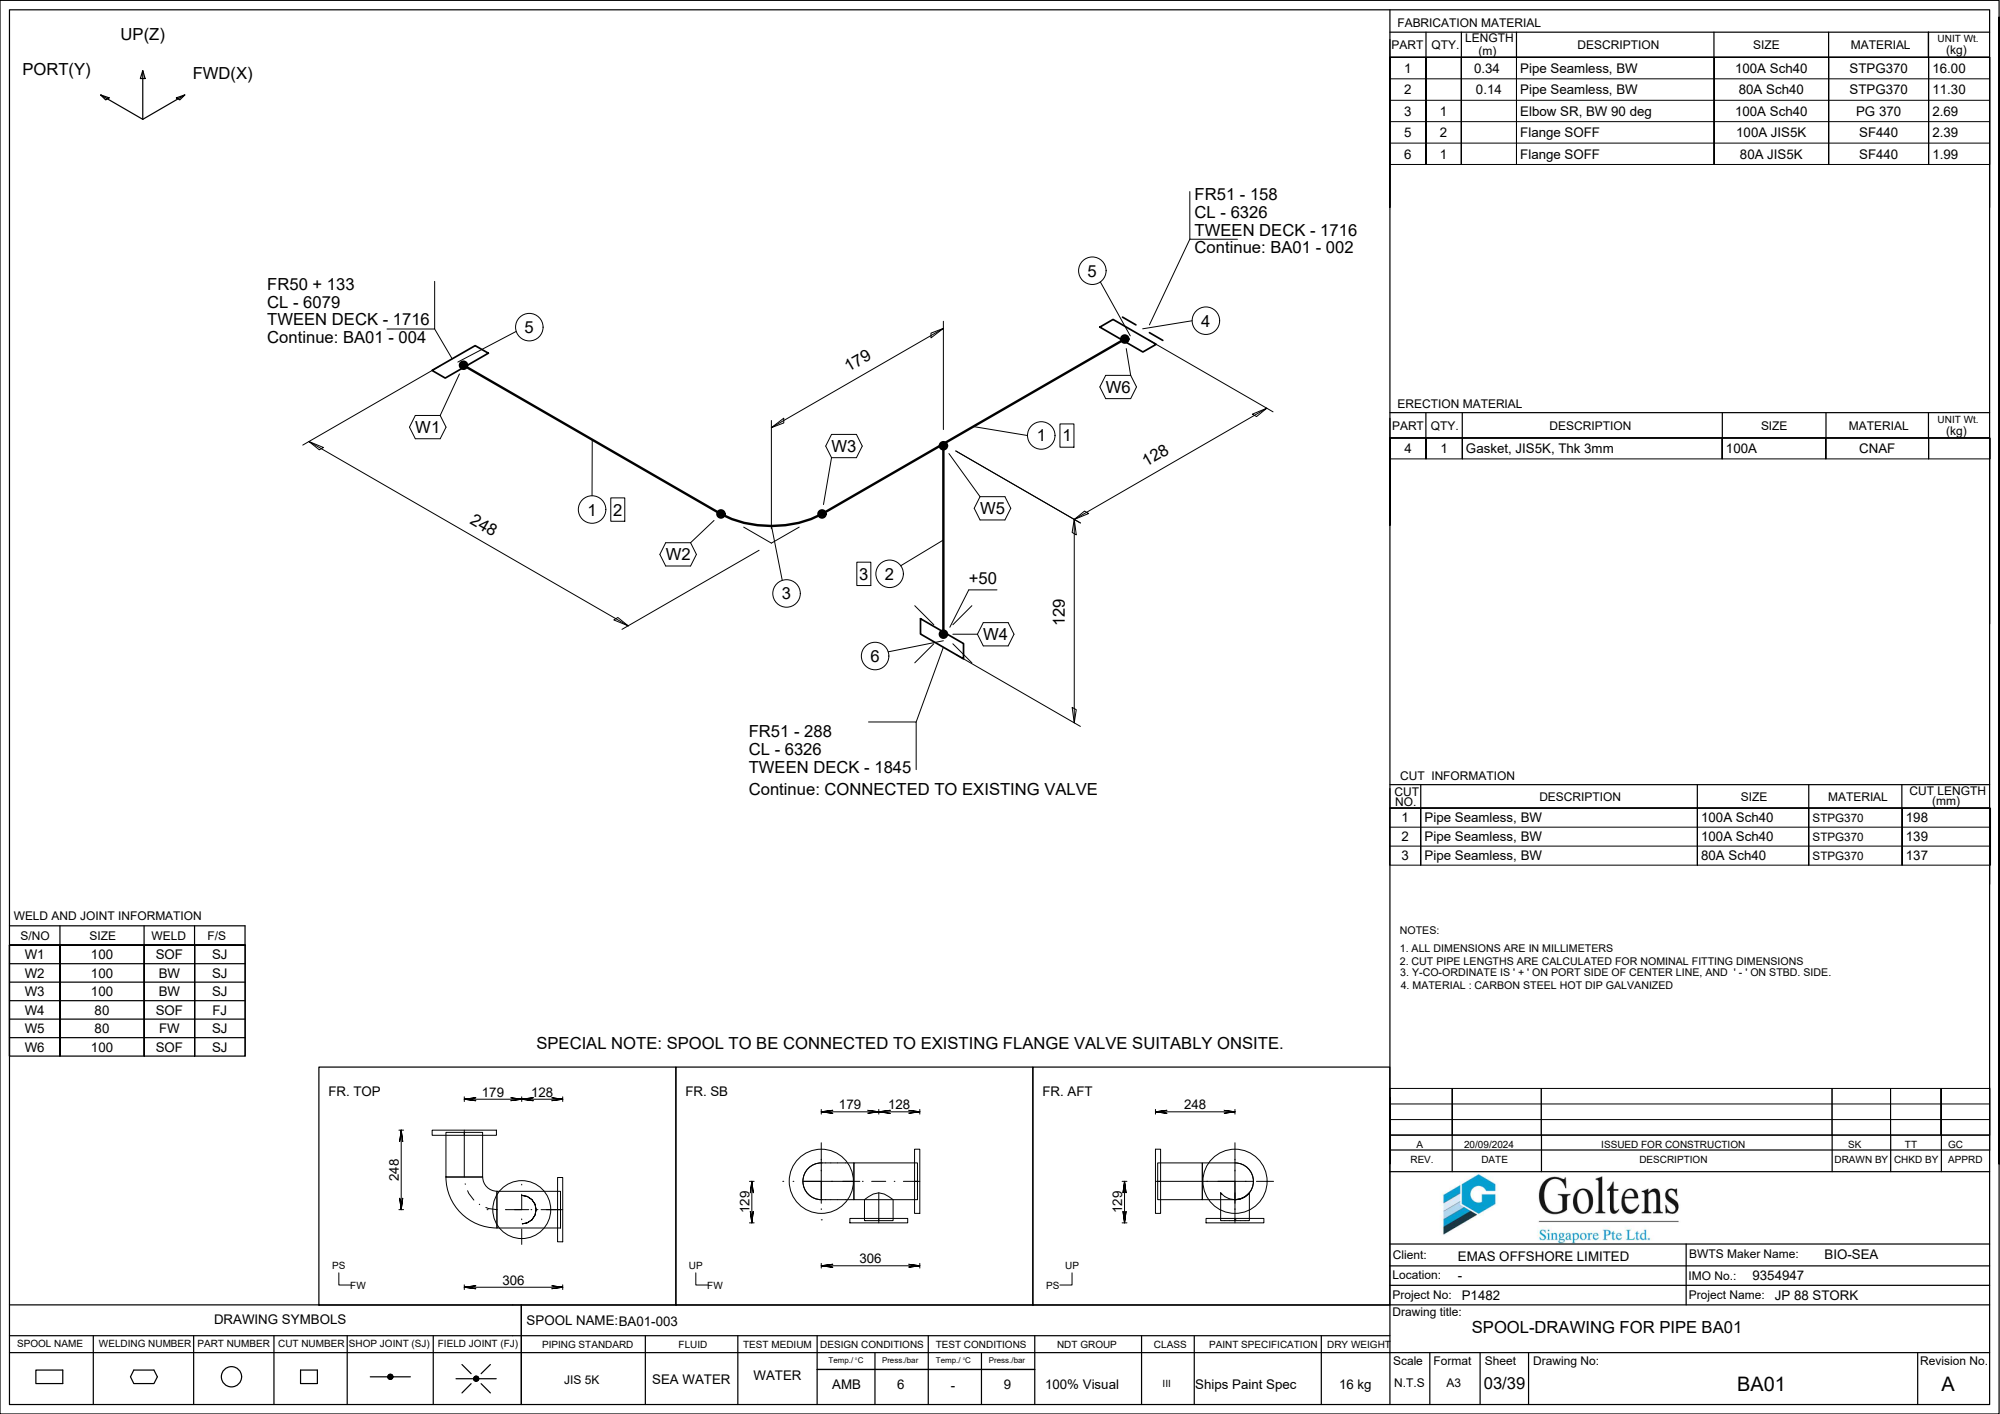
[picture p24: page 4]
FR. TOP; FR. AFT; AMB; Flange SOFF; 80A JIS5K; Gasket, JIS5K, Thk 3mm; CNAF; SOF; Pipe Seamless, BW; 80A Sch40; STPG370; REV.; DATE; DESCRIPTION; DRAWN BY; CHKD BY; APPRD; Location:; Client:; ERECTION MATERIAL; CUT INFORMATION; SIZE; WELD; PART; QTY.; MATERIAL; ISSUED FOR CONSTRUCTION; Continue: BA01 - 004; TWEEN DECK - 1716; Continue: BA01 - 002

1 | | 0.34 | Pipe Seamless, BW | 100A Sch40 | STPG370 | 16.00
2 | | 0.14 | Pipe Seamless, BW | 80A Sch40 | STPG370 | 11.30
3 | 1 | | Elbow SR, BW 90 deg | 100A Sch40 | PG 370 | 2.69
5 | 2 | | Flange SOFF | 100A JIS5K | SF440 | 2.39

UNIT Wt. (kg)

TWEEN DECK - 1845
Continue: CONNECTED TO EXISTING VALVE

CUT NO. | DESCRIPTION | SIZE | MATERIAL | CUT LENGTH (mm)

1 | Pipe Seamless, BW | 100A Sch40 | STPG370 | 198
2 | Pipe Seamless, BW | 100A Sch40 | STPG370 | 139

WELD AND JOINT INFORMATION

NOTES:
1. ALL DIMENSIONS ARE IN MILLIMETERS
2. CUT PIPE LENGTHS ARE CALCULATED FOR NOMINAL FITTING DIMENSIONS
3. Y-CO-ORDINATE IS ' + ' ON PORT SIDE OF CENTER LINE, AND ' - ' ON STBD. SIDE.
4. MATERIAL : CARBON STEEL HOT DIP GALVANIZED

W1 | 100 | SOF | SJ
W2 | 100 | BW | SJ
W3 | 100 | BW | SJ
W4 | 80 | SOF | FJ
W5 | 80 | FW | SJ

SPECIAL NOTE: SPOOL TO BE CONNECTED TO EXISTING FLANGE VALVE SUITABLY ONSITE.

- BIO-SEA
EMAS OFFSHORE LIMITED

BWTS Maker Name:

IMO No.: NDT GROUP

### TWEEN DECK - 1382

FR50 - 150

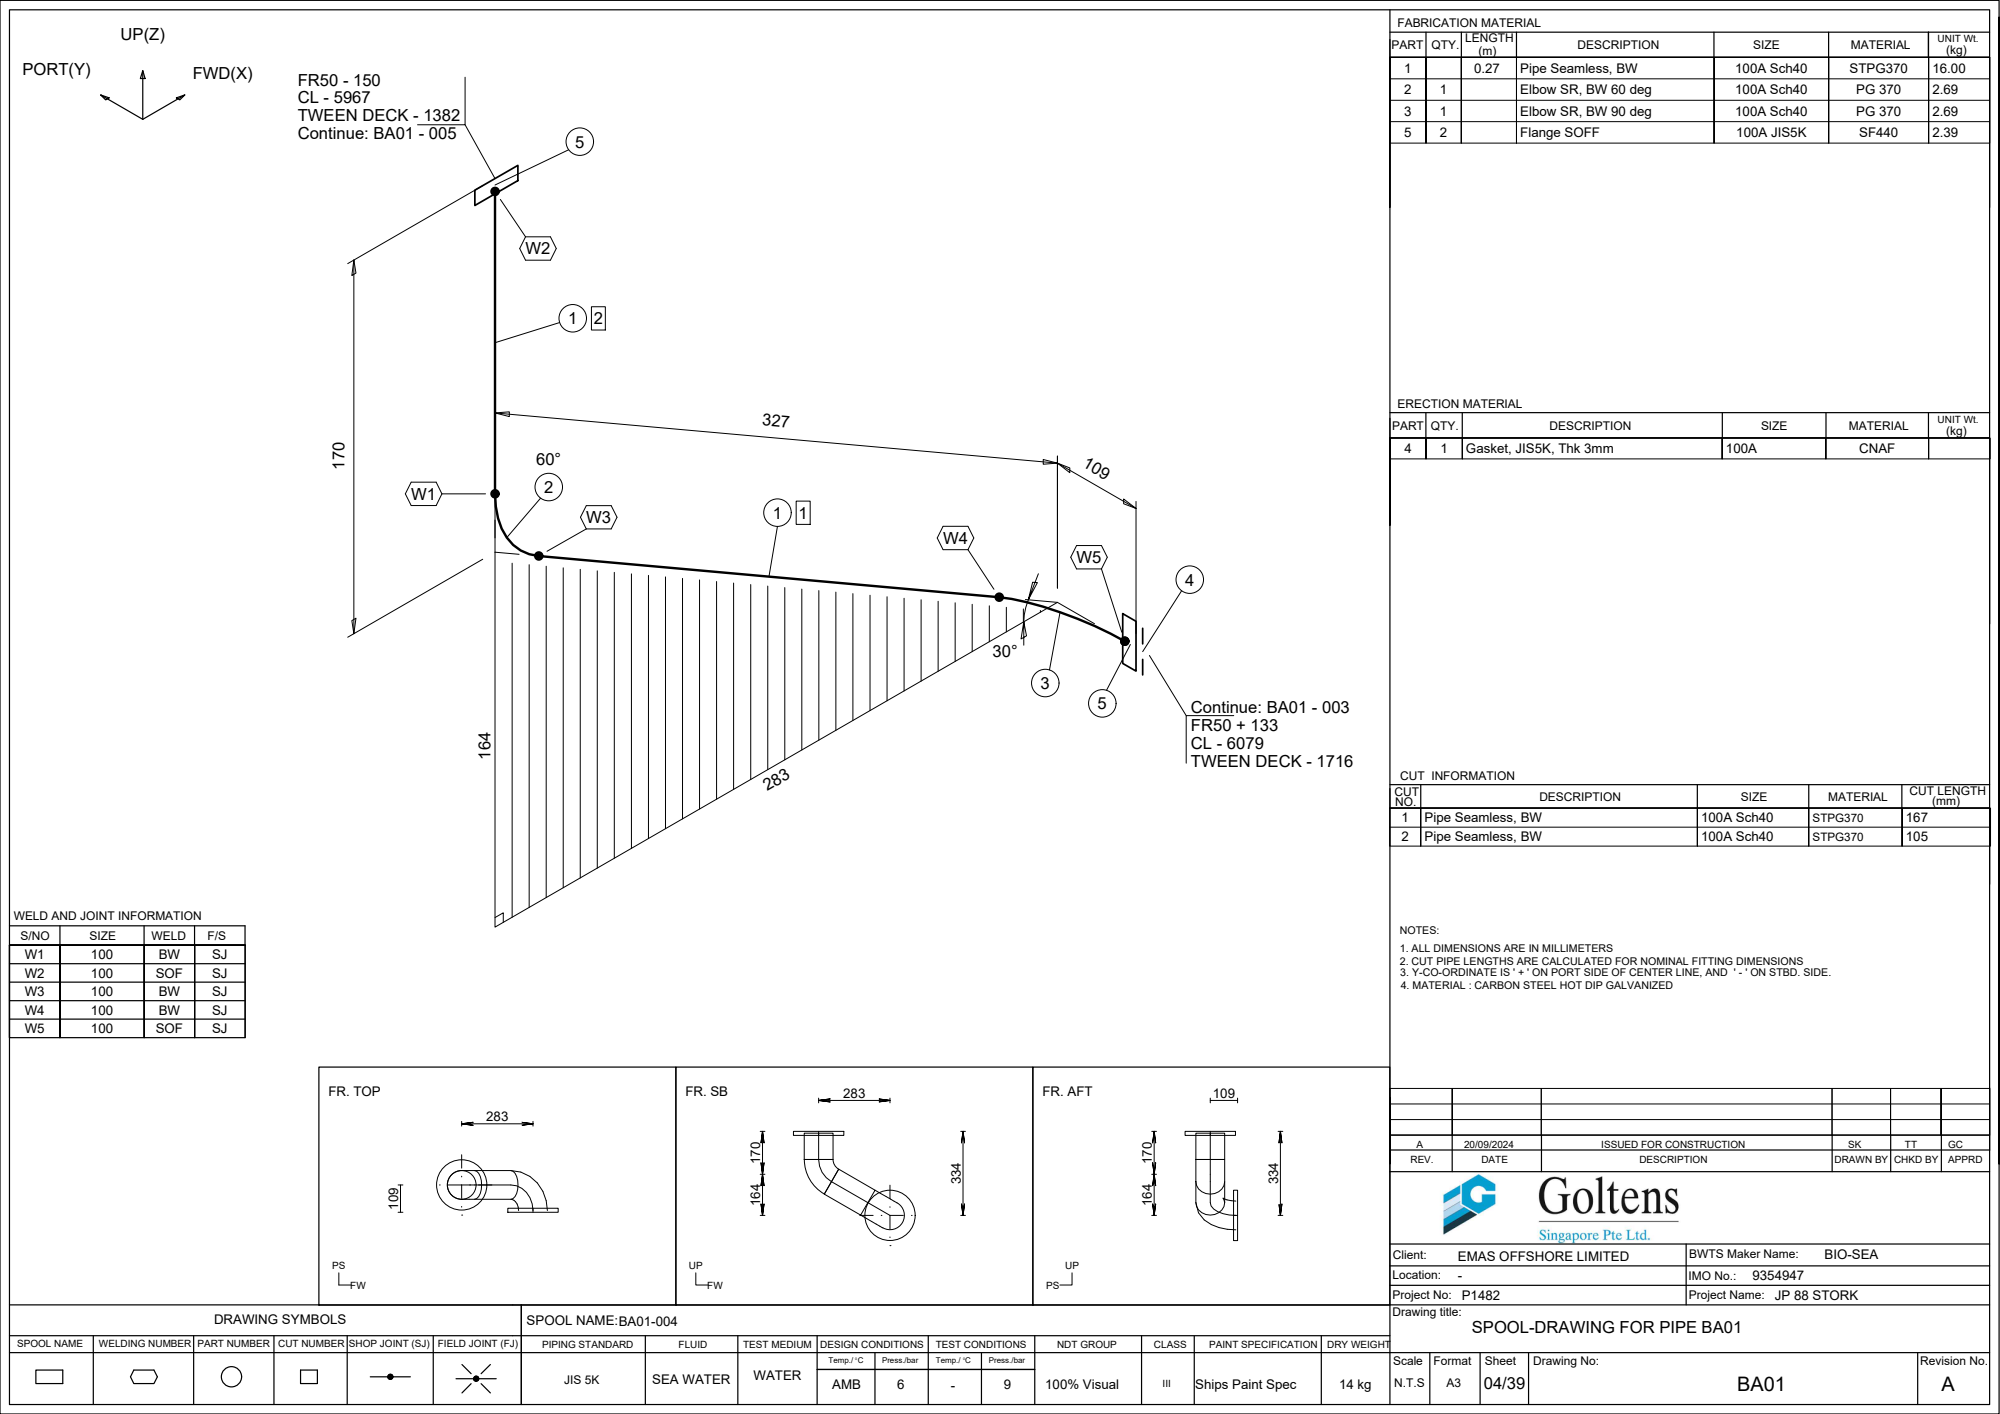
[picture p25: page 5]
FR. TOP; FR. AFT; AMB; Flange SOFF; 100A JIS5K; Gasket, JIS5K, Thk 3mm; CNAF; SOF; Pipe Seamless, BW; 100A Sch40; STPG370; REV.; DATE; DESCRIPTION; DRAWN BY; CHKD BY; APPRD; Location:; Client:; ERECTION MATERIAL; CUT INFORMATION; SIZE; WELD; PART; QTY.; MATERIAL; ISSUED FOR CONSTRUCTION; Continue: BA01 - 005; FR50 + 133 CL - 6079 TWEEN DECK - 1716; Continue: BA01 - 003

1 | | 0.27 | Pipe Seamless, BW | 100A Sch40 | STPG370 | 16.00
2 | 1 | | Elbow SR, BW 60 deg | 100A Sch40 | PG 370 | 2.69
3 | 1 | | Elbow SR, BW 90 deg | 100A Sch40 | PG 370 | 2.69

UNIT Wt. (kg)

CUT NO. | DESCRIPTION | SIZE | MATERIAL | CUT LENGTH (mm)

1 | Pipe Seamless, BW | 100A Sch40 | STPG370 | 167

WELD AND JOINT INFORMATION

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

W1 | 100 | BW | SJ
W2 | 100 | SOF | SJ
W3 | 100 | BW | SJ
W4 | 100 | BW | SJ

- BIO-SEA
EMAS OFFSHORE LIMITED

BWTS Maker Name:

IMO No.: NDT GROUP

### PORT(Y)

### FWD(X)

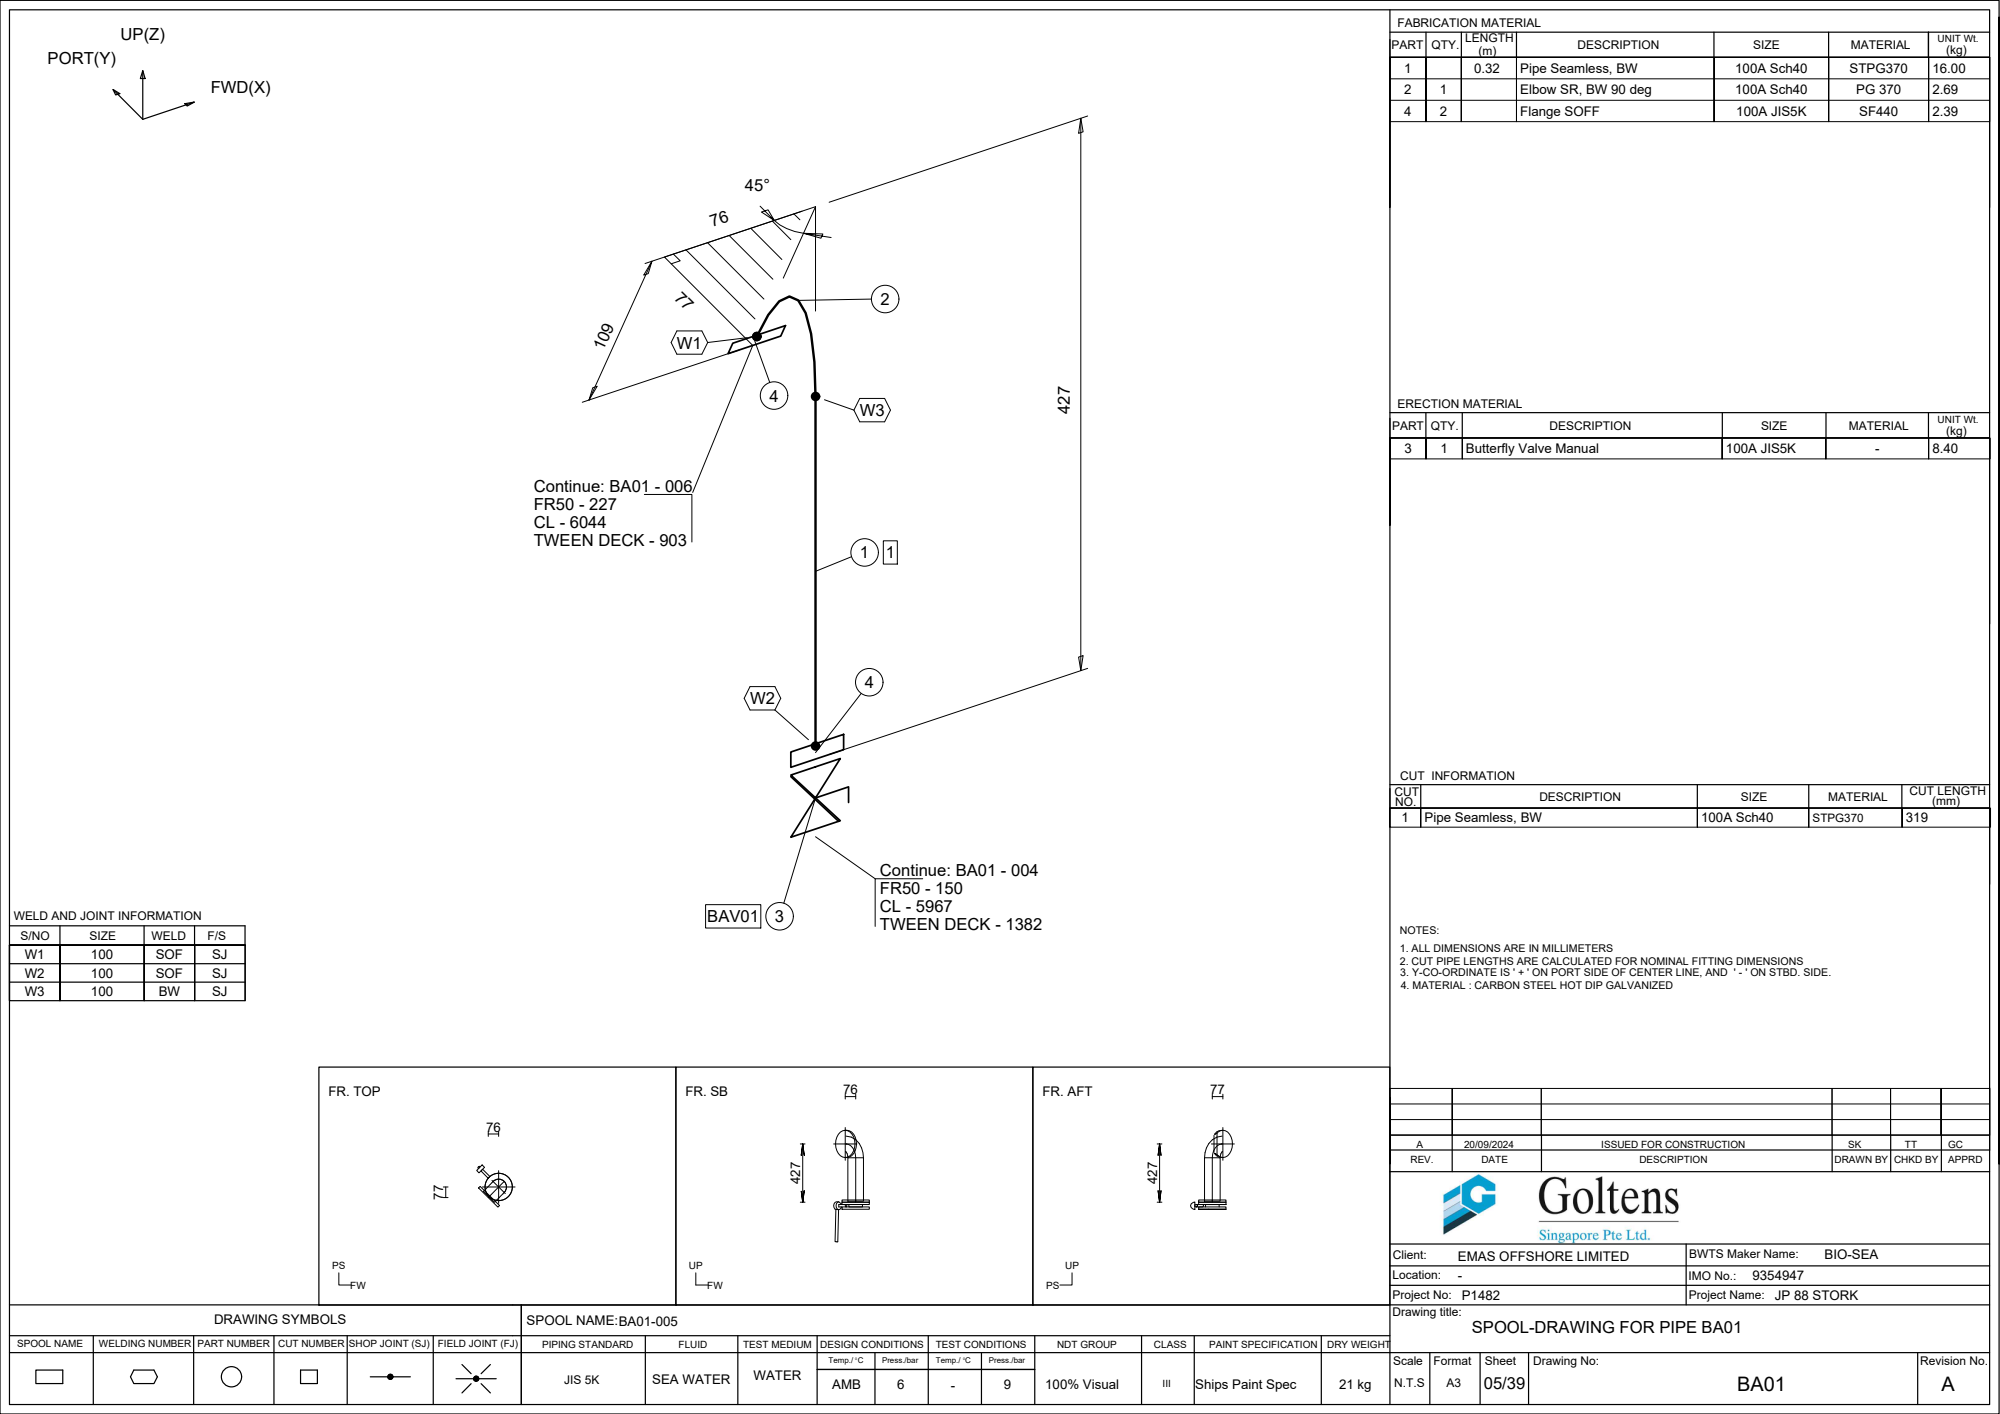
[picture p26: page 6]
FR. TOP; FR. AFT; AMB; Flange SOFF; 100A JIS5K; Butterfly Valve Manual; REV.; DATE; DESCRIPTION; DRAWN BY; CHKD BY; APPRD; Location:; Client:; ERECTION MATERIAL; CUT INFORMATION; SIZE; WELD; PART; QTY.; MATERIAL; ISSUED FOR CONSTRUCTION; FR50 - 227 CL - 6044 TWEEN DECK - 903; Continue: BA01 - 006; FR50 - 150 CL - 5967 TWEEN DECK - 1382; Continue: BA01 - 004; BAV01

1 | | 0.32 | Pipe Seamless, BW | 100A Sch40 | STPG370 | 16.00
2 | 1 | | Elbow SR, BW 90 deg | 100A Sch40 | PG 370 | 2.69

UNIT Wt. (kg)

CUT NO. | DESCRIPTION | SIZE | MATERIAL | CUT LENGTH (mm)

1 | Pipe Seamless, BW | 100A Sch40 | STPG370 | 319

WELD AND JOINT INFORMATION

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

W1 | 100 | SOF | SJ
W2 | 100 | SOF | SJ

- BIO-SEA
EMAS OFFSHORE LIMITED

BWTS Maker Name:

IMO No.: NDT GROUP

### FWD(X)

### PORT(Y)

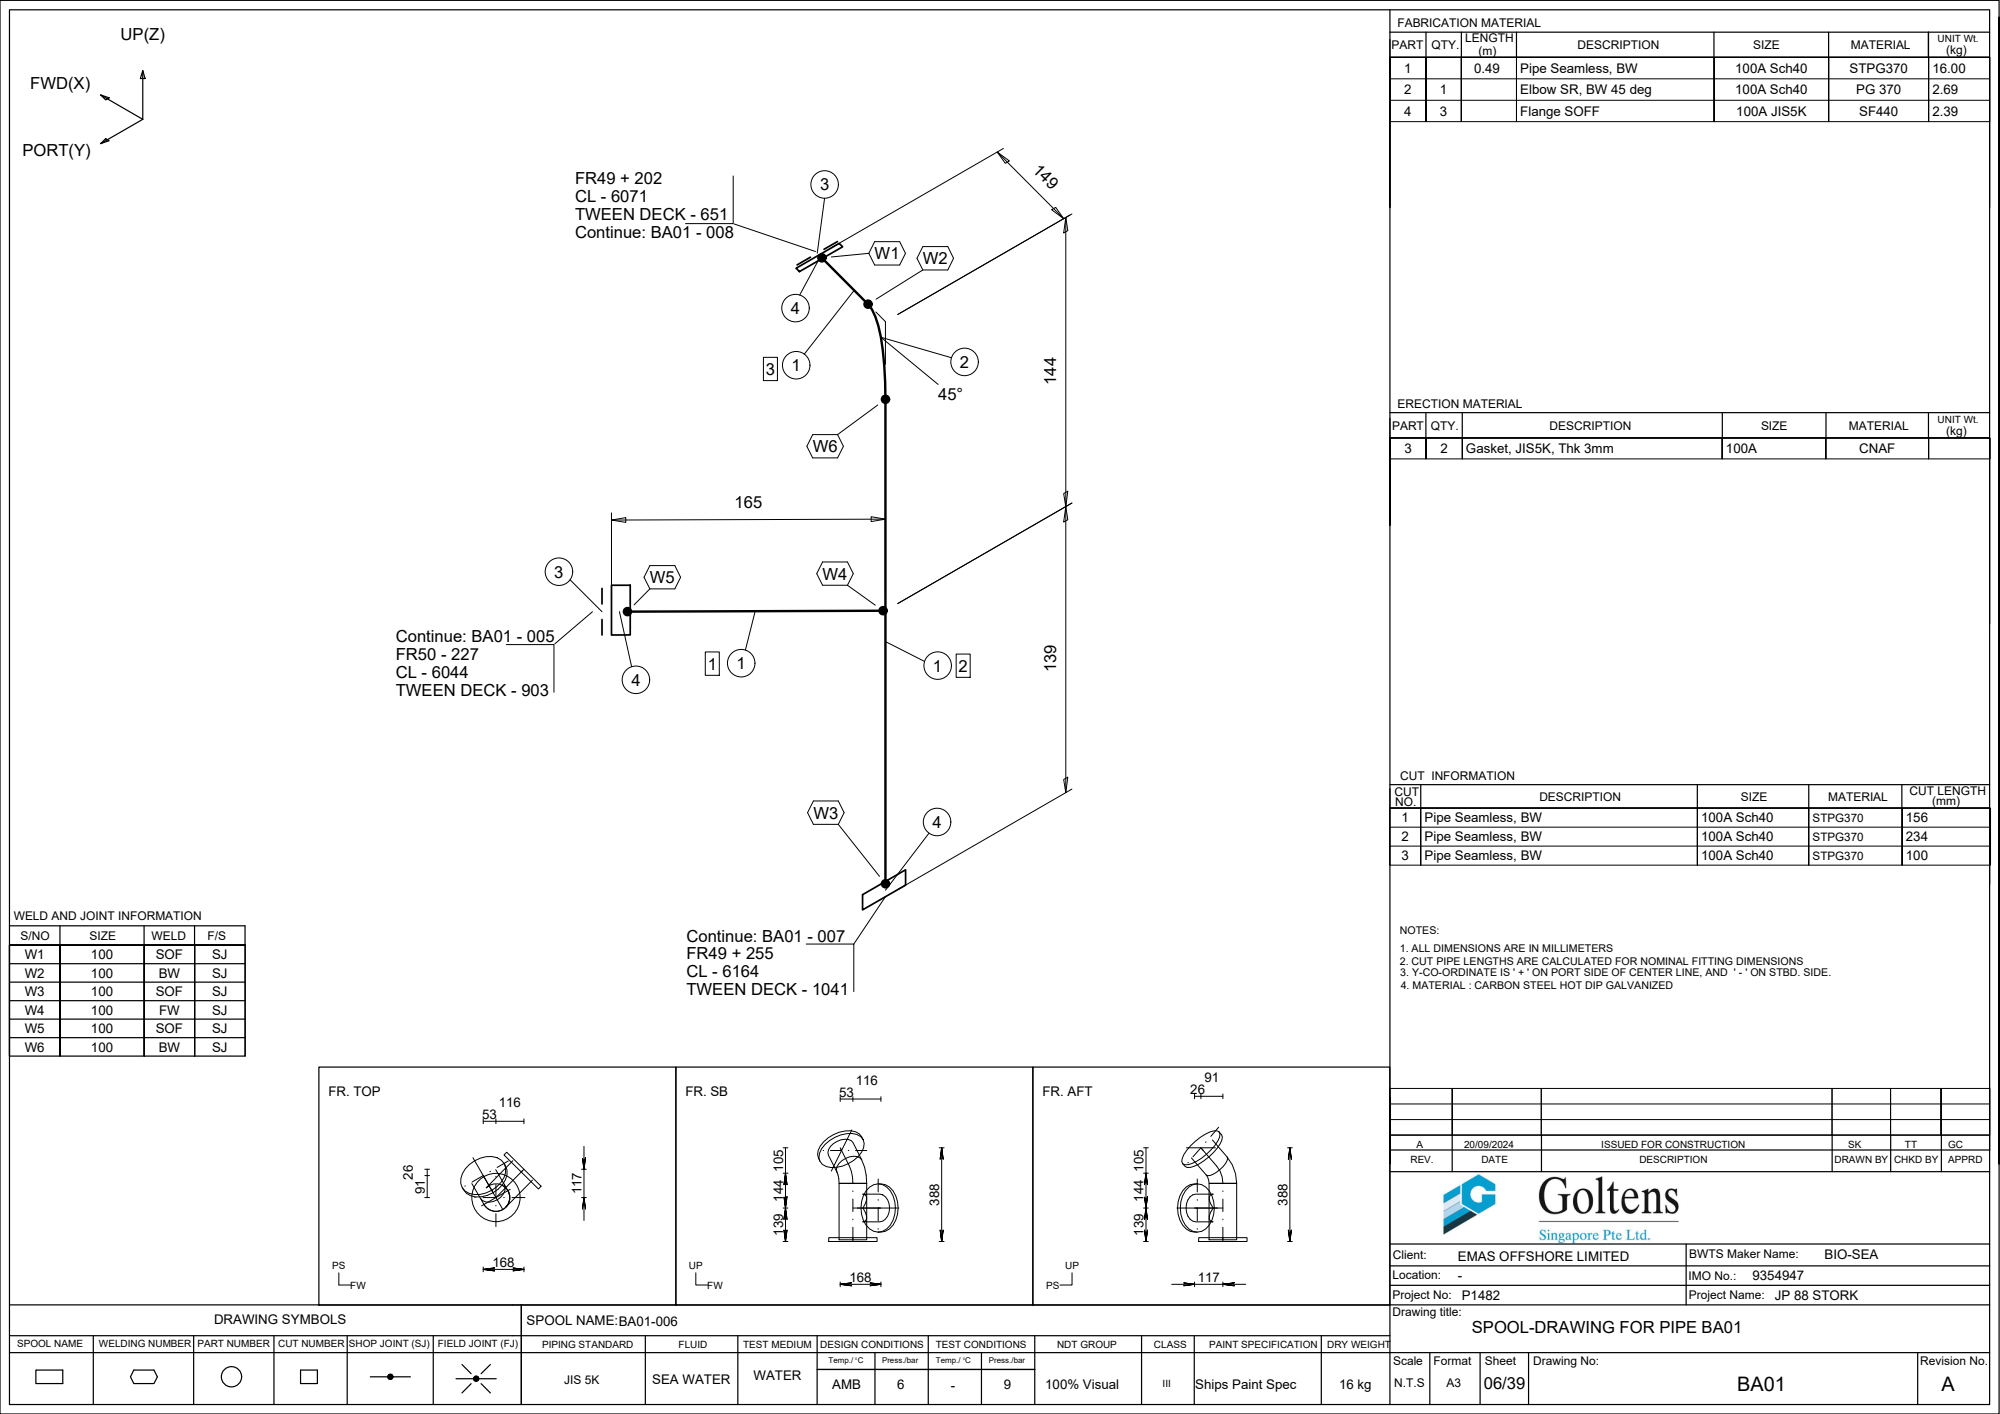
[picture p27: page 7]
FR. TOP; FR. AFT; AMB; Flange SOFF; 100A JIS5K; Gasket, JIS5K, Thk 3mm; CNAF; Pipe Seamless, BW; 100A Sch40; STPG370; REV.; DATE; DESCRIPTION; DRAWN BY; CHKD BY; APPRD; Location:; Client:; ERECTION MATERIAL; CUT INFORMATION; SIZE; WELD; PART; QTY.; MATERIAL; ISSUED FOR CONSTRUCTION; FR49 + 255 CL - 6164 TWEEN DECK - 1041; Continue: BA01 - 007; TWEEN DECK - 651; Continue: BA01 - 008; FR50 - 227 CL - 6044 TWEEN DECK - 903; Continue: BA01 - 005

1 | | 0.49 | Pipe Seamless, BW | 100A Sch40 | STPG370 | 16.00
2 | 1 | | Elbow SR, BW 45 deg | 100A Sch40 | PG 370 | 2.69

4. MATERIAL : CARBON STEEL HOT DIP GALVANIZED 139 144

UNIT Wt. (kg)

CUT NO. | DESCRIPTION | SIZE | MATERIAL | CUT LENGTH (mm)

1 | Pipe Seamless, BW | 100A Sch40 | STPG370 | 156
2 | Pipe Seamless, BW | 100A Sch40 | STPG370 | 234

WELD AND JOINT INFORMATION

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

W1 | 100 | SOF | SJ
W2 | 100 | BW | SJ
W3 | 100 | SOF | SJ
W4 | 100 | FW | SJ
W5 | 100 | SOF | SJ

- BIO-SEA
EMAS OFFSHORE LIMITED

BWTS Maker Name:

IMO No.: NDT GROUP

### TWEEN DECK - 1041

FR49 + 255

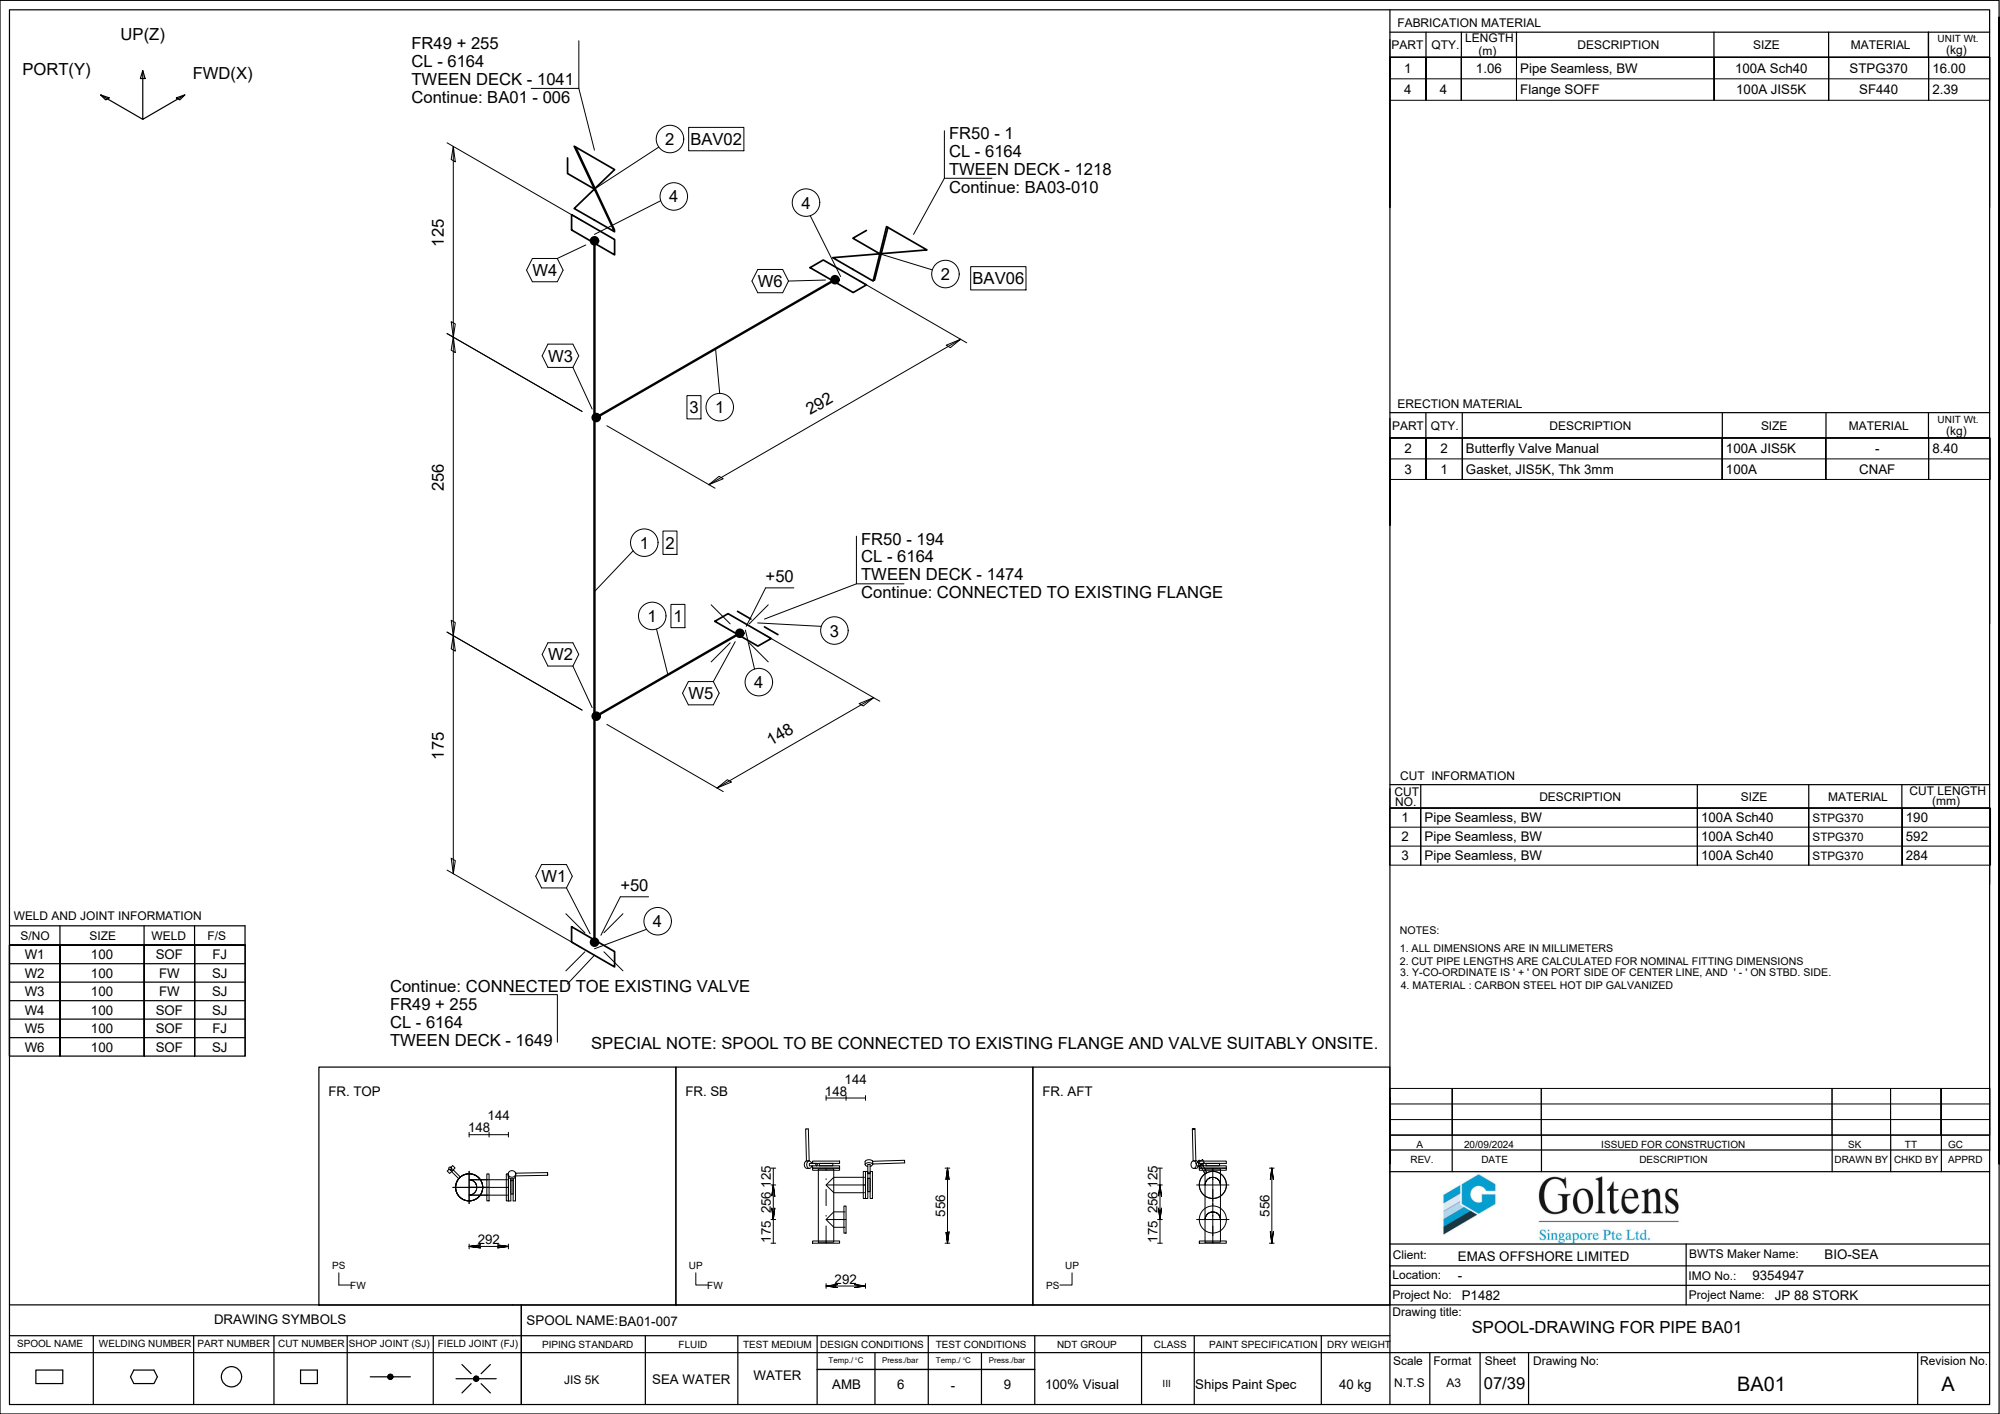
[picture p28: page 8]
FR. TOP; FR. AFT; AMB; Pipe Seamless, BW; 100A Sch40; STPG370; Flange SOFF; 100A JIS5K; Gasket, JIS5K, Thk 3mm; CNAF; SOF; REV.; DATE; DESCRIPTION; DRAWN BY; CHKD BY; APPRD; Location:; Client:; ERECTION MATERIAL; CUT INFORMATION; SIZE; WELD; ISSUED FOR CONSTRUCTION; Continue: BA01 - 006; TWEEN DECK - 1218; Continue: BA03-010; BAV02; BAV06

PART | QTY. | DESCRIPTION | SIZE | MATERIAL | UNIT Wt. (kg)

2 | 2 | Butterfly Valve Manual | 100A JIS5K | - | 8.40

4. MATERIAL : CARBON STEEL HOT DIP GALVANIZED 175 256

TWEEN DECK - 1474
Continue: CONNECTED TO EXISTING FLANGE

CUT NO. | DESCRIPTION | SIZE | MATERIAL | CUT LENGTH (mm)

1 | Pipe Seamless, BW | 100A Sch40 | STPG370 | 190
2 | Pipe Seamless, BW | 100A Sch40 | STPG370 | 592

WELD AND JOINT INFORMATION

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

W1 | 100 | SOF | FJ
W2 | 100 | FW | SJ
W3 | 100 | FW | SJ
W4 | 100 | SOF | SJ
W5 | 100 | SOF | FJ

Continue: CONNECTED TOE EXISTING VALVE
TWEEN DECK - 1649

SPECIAL NOTE: SPOOL TO BE CONNECTED TO EXISTING FLANGE AND VALVE SUITABLY ONSITE.

- BIO-SEA
EMAS OFFSHORE LIMITED

BWTS Maker Name:

IMO No.: NDT GROUP

### TWEEN DECK - 430

FR49 + 137

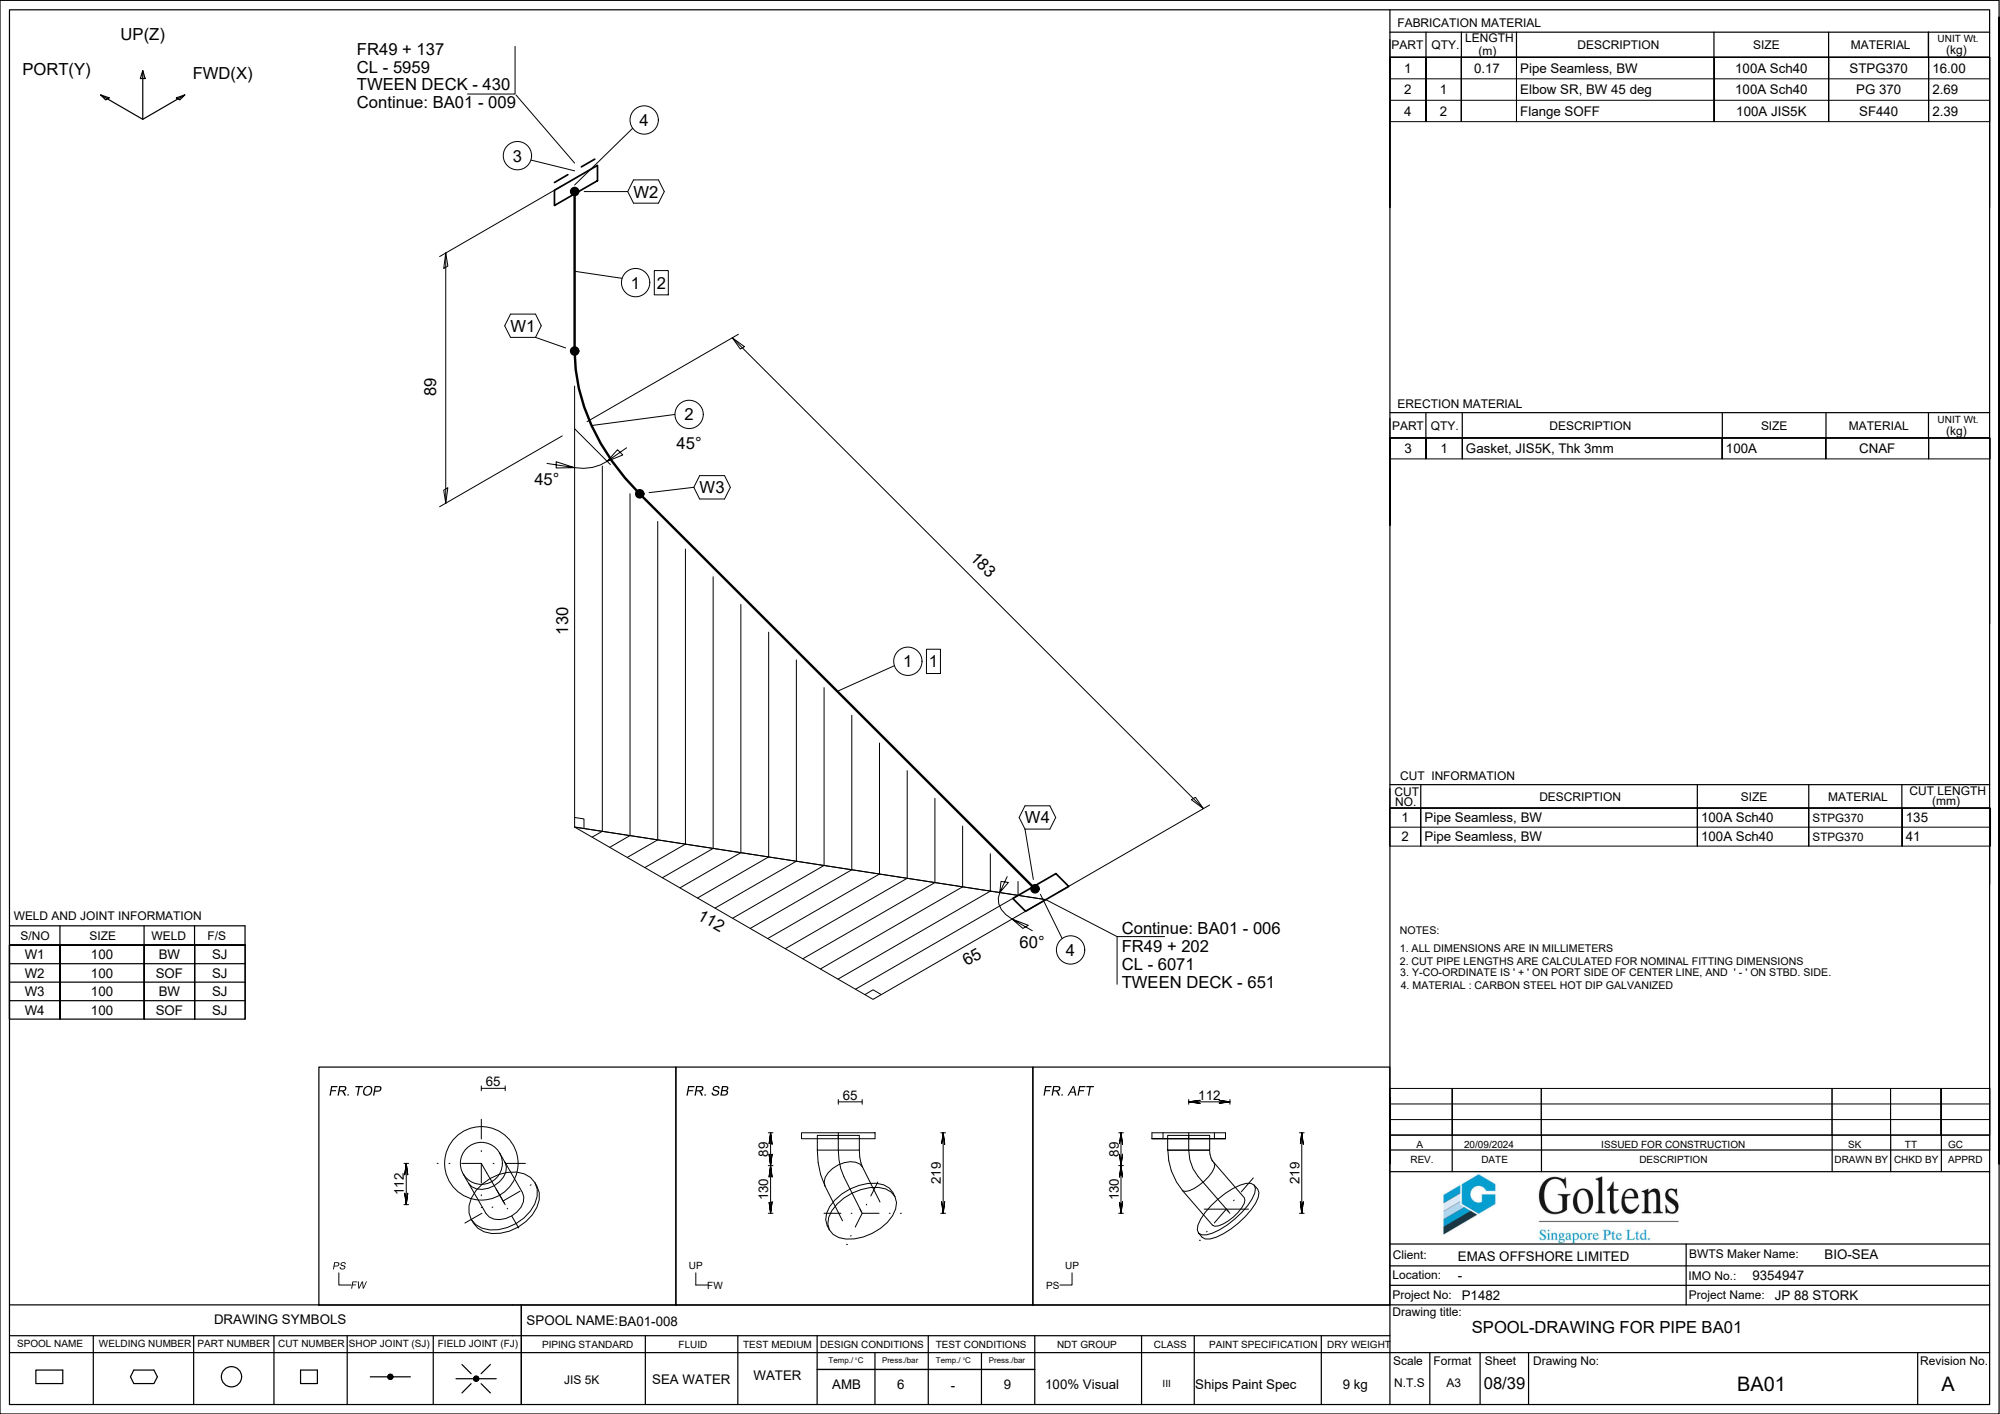
[picture p29: page 9]
FR. TOP; FR. AFT; AMB; Flange SOFF; 100A JIS5K; Gasket, JIS5K, Thk 3mm; CNAF; SOF; Pipe Seamless, BW; 100A Sch40; STPG370; REV.; DATE; DESCRIPTION; DRAWN BY; CHKD BY; APPRD; Location:; Client:; ERECTION MATERIAL; CUT INFORMATION; SIZE; WELD; PART; QTY.; MATERIAL; ISSUED FOR CONSTRUCTION; Continue: BA01 - 009; FR49 + 202 CL - 6071 TWEEN DECK - 651; Continue: BA01 - 006

1 | | 0.17 | Pipe Seamless, BW | 100A Sch40 | STPG370 | 16.00
2 | 1 | | Elbow SR, BW 45 deg | 100A Sch40 | PG 370 | 2.69

UNIT Wt. (kg)

CUT NO. | DESCRIPTION | SIZE | MATERIAL | CUT LENGTH (mm)

1 | Pipe Seamless, BW | 100A Sch40 | STPG370 | 135

WELD AND JOINT INFORMATION

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

W1 | 100 | BW | SJ
W2 | 100 | SOF | SJ
W3 | 100 | BW | SJ

- BIO-SEA
EMAS OFFSHORE LIMITED

BWTS Maker Name:

IMO No.: NDT GROUP

### TWEEN DECK - 24

FR49 + 137

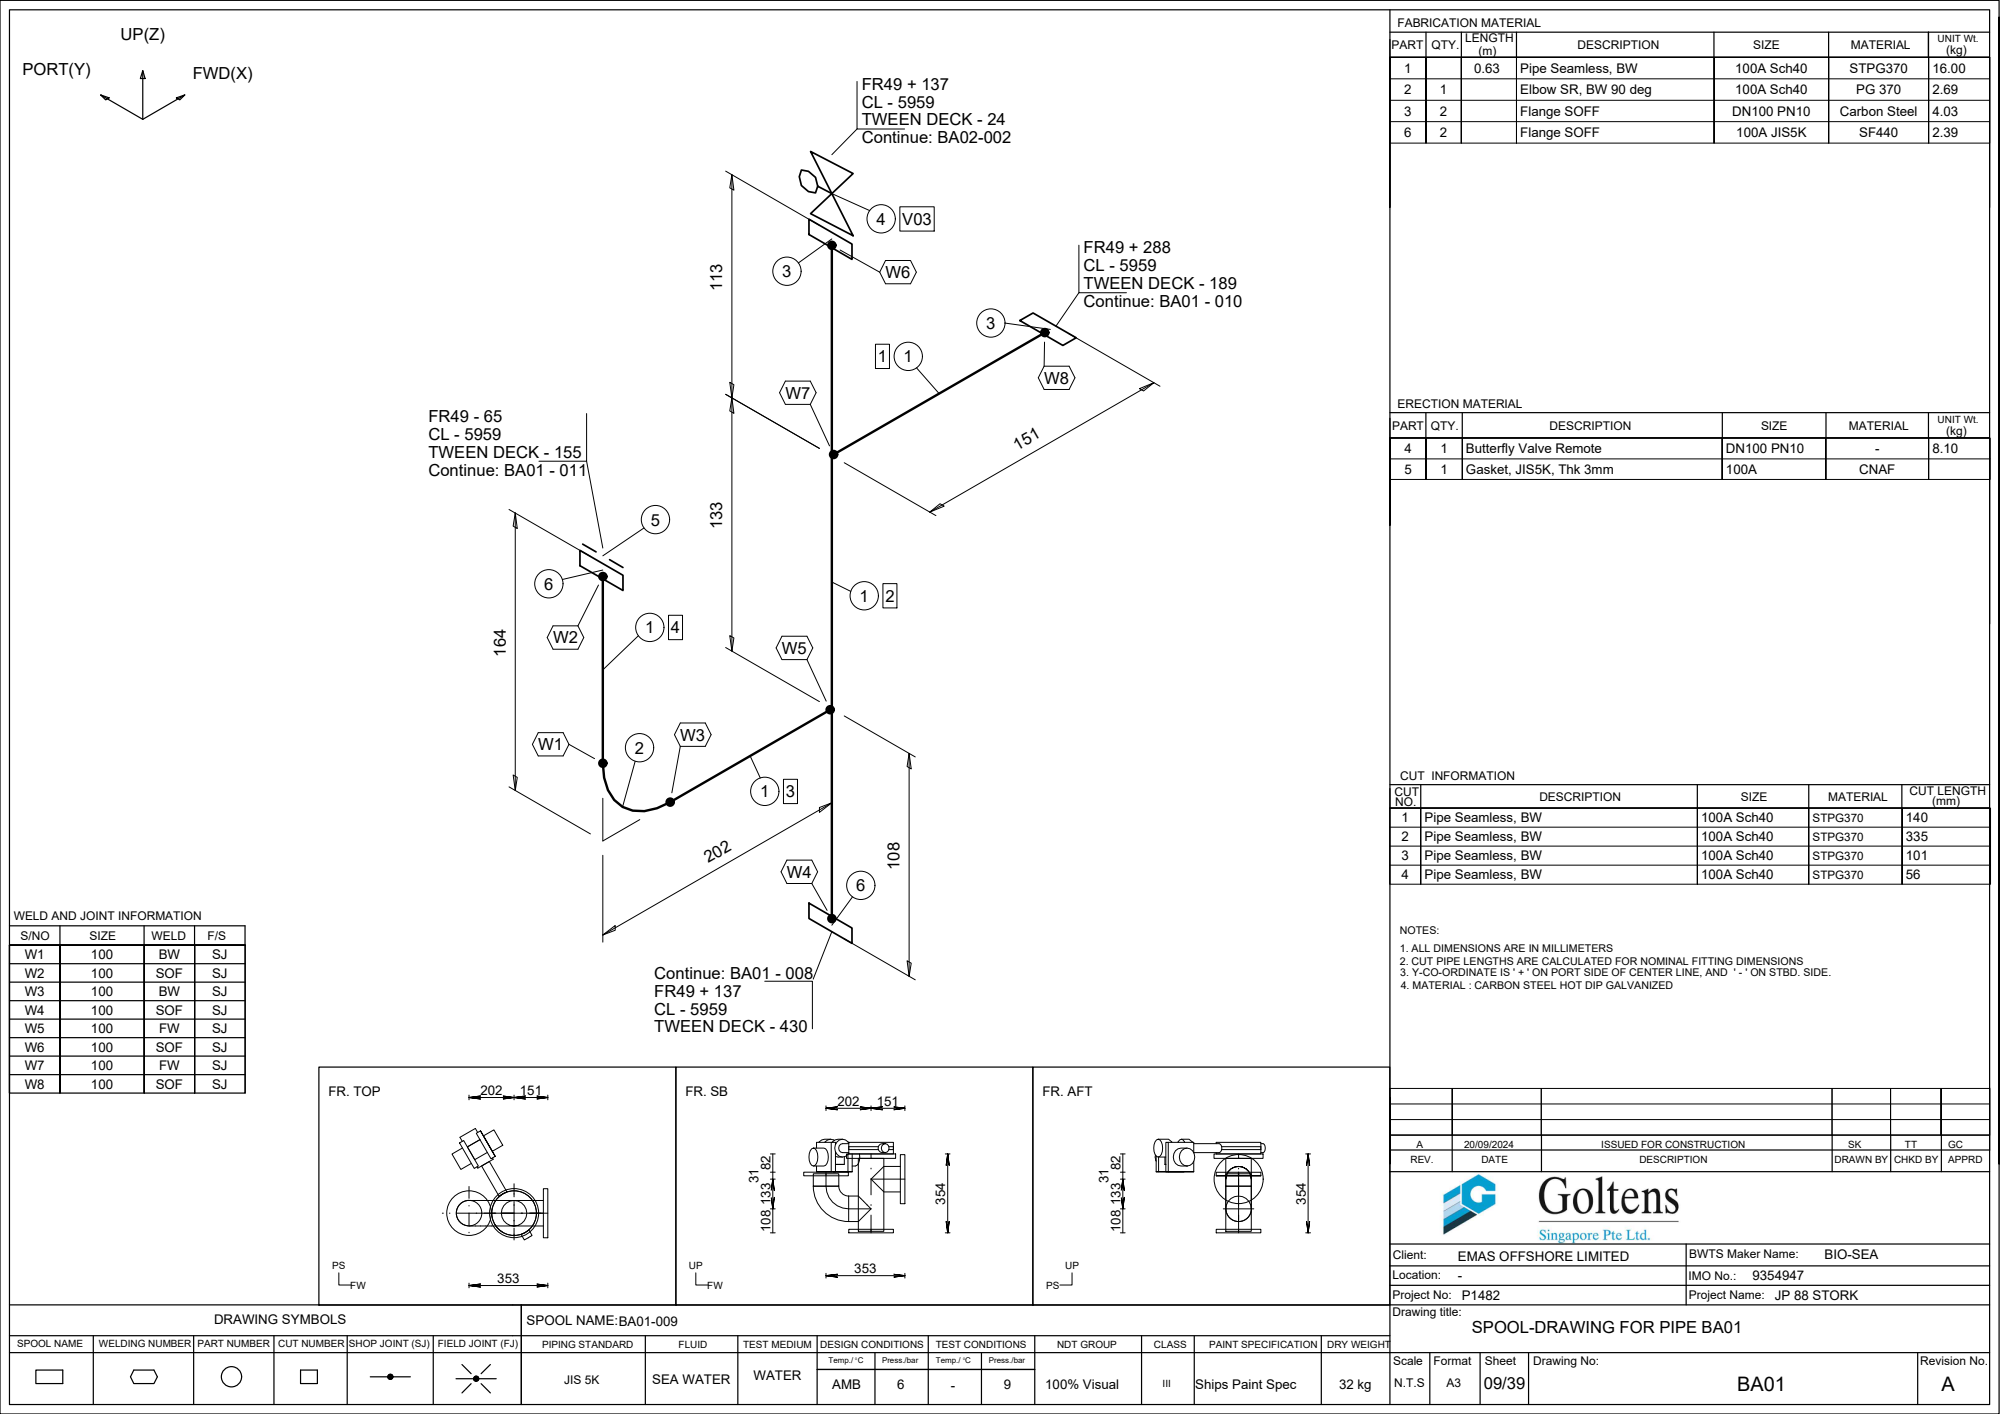
[picture p30: page 10]
FR. TOP; FR. AFT; AMB; Flange SOFF; 100A JIS5K; Gasket, JIS5K, Thk 3mm; CNAF; SOF; Pipe Seamless, BW; 100A Sch40; STPG370; REV.; DATE; DESCRIPTION; DRAWN BY; CHKD BY; APPRD; Location:; Client:; ERECTION MATERIAL; CUT INFORMATION; SIZE; WELD; ISSUED FOR CONSTRUCTION; FR49 + 137 CL - 5959 TWEEN DECK - 430; Continue: BA01 - 008; Continue: BA02-002; TWEEN DECK - 189; Continue: BA01 - 010; TWEEN DECK - 155; Continue: BA01 - 011

1 | | 0.63 | Pipe Seamless, BW | 100A Sch40 | STPG370 | 16.00
2 | 1 | | Elbow SR, BW 90 deg | 100A Sch40 | PG 370 | 2.69
3 | 2 | | Flange SOFF | DN100 PN10 | Carbon Steel | 4.03

PART | QTY. | DESCRIPTION | SIZE | MATERIAL | UNIT Wt. (kg)

4 | 1 | Butterfly Valve Remote | DN100 PN10 | - | 8.10

CUT NO. | DESCRIPTION | SIZE | MATERIAL | CUT LENGTH (mm)

1 | Pipe Seamless, BW | 100A Sch40 | STPG370 | 140
2 | Pipe Seamless, BW | 100A Sch40 | STPG370 | 335
3 | Pipe Seamless, BW | 100A Sch40 | STPG370 | 101

WELD AND JOINT INFORMATION

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

W1 | 100 | BW | SJ
W2 | 100 | SOF | SJ
W3 | 100 | BW | SJ
W4 | 100 | SOF | SJ
W5 | 100 | FW | SJ
W6 | 100 | SOF | SJ
W7 | 100 | FW | SJ

- BIO-SEA
EMAS OFFSHORE LIMITED

BWTS Maker Name:

IMO No.: NDT GROUP

### FWD(X)

### PORT(Y)

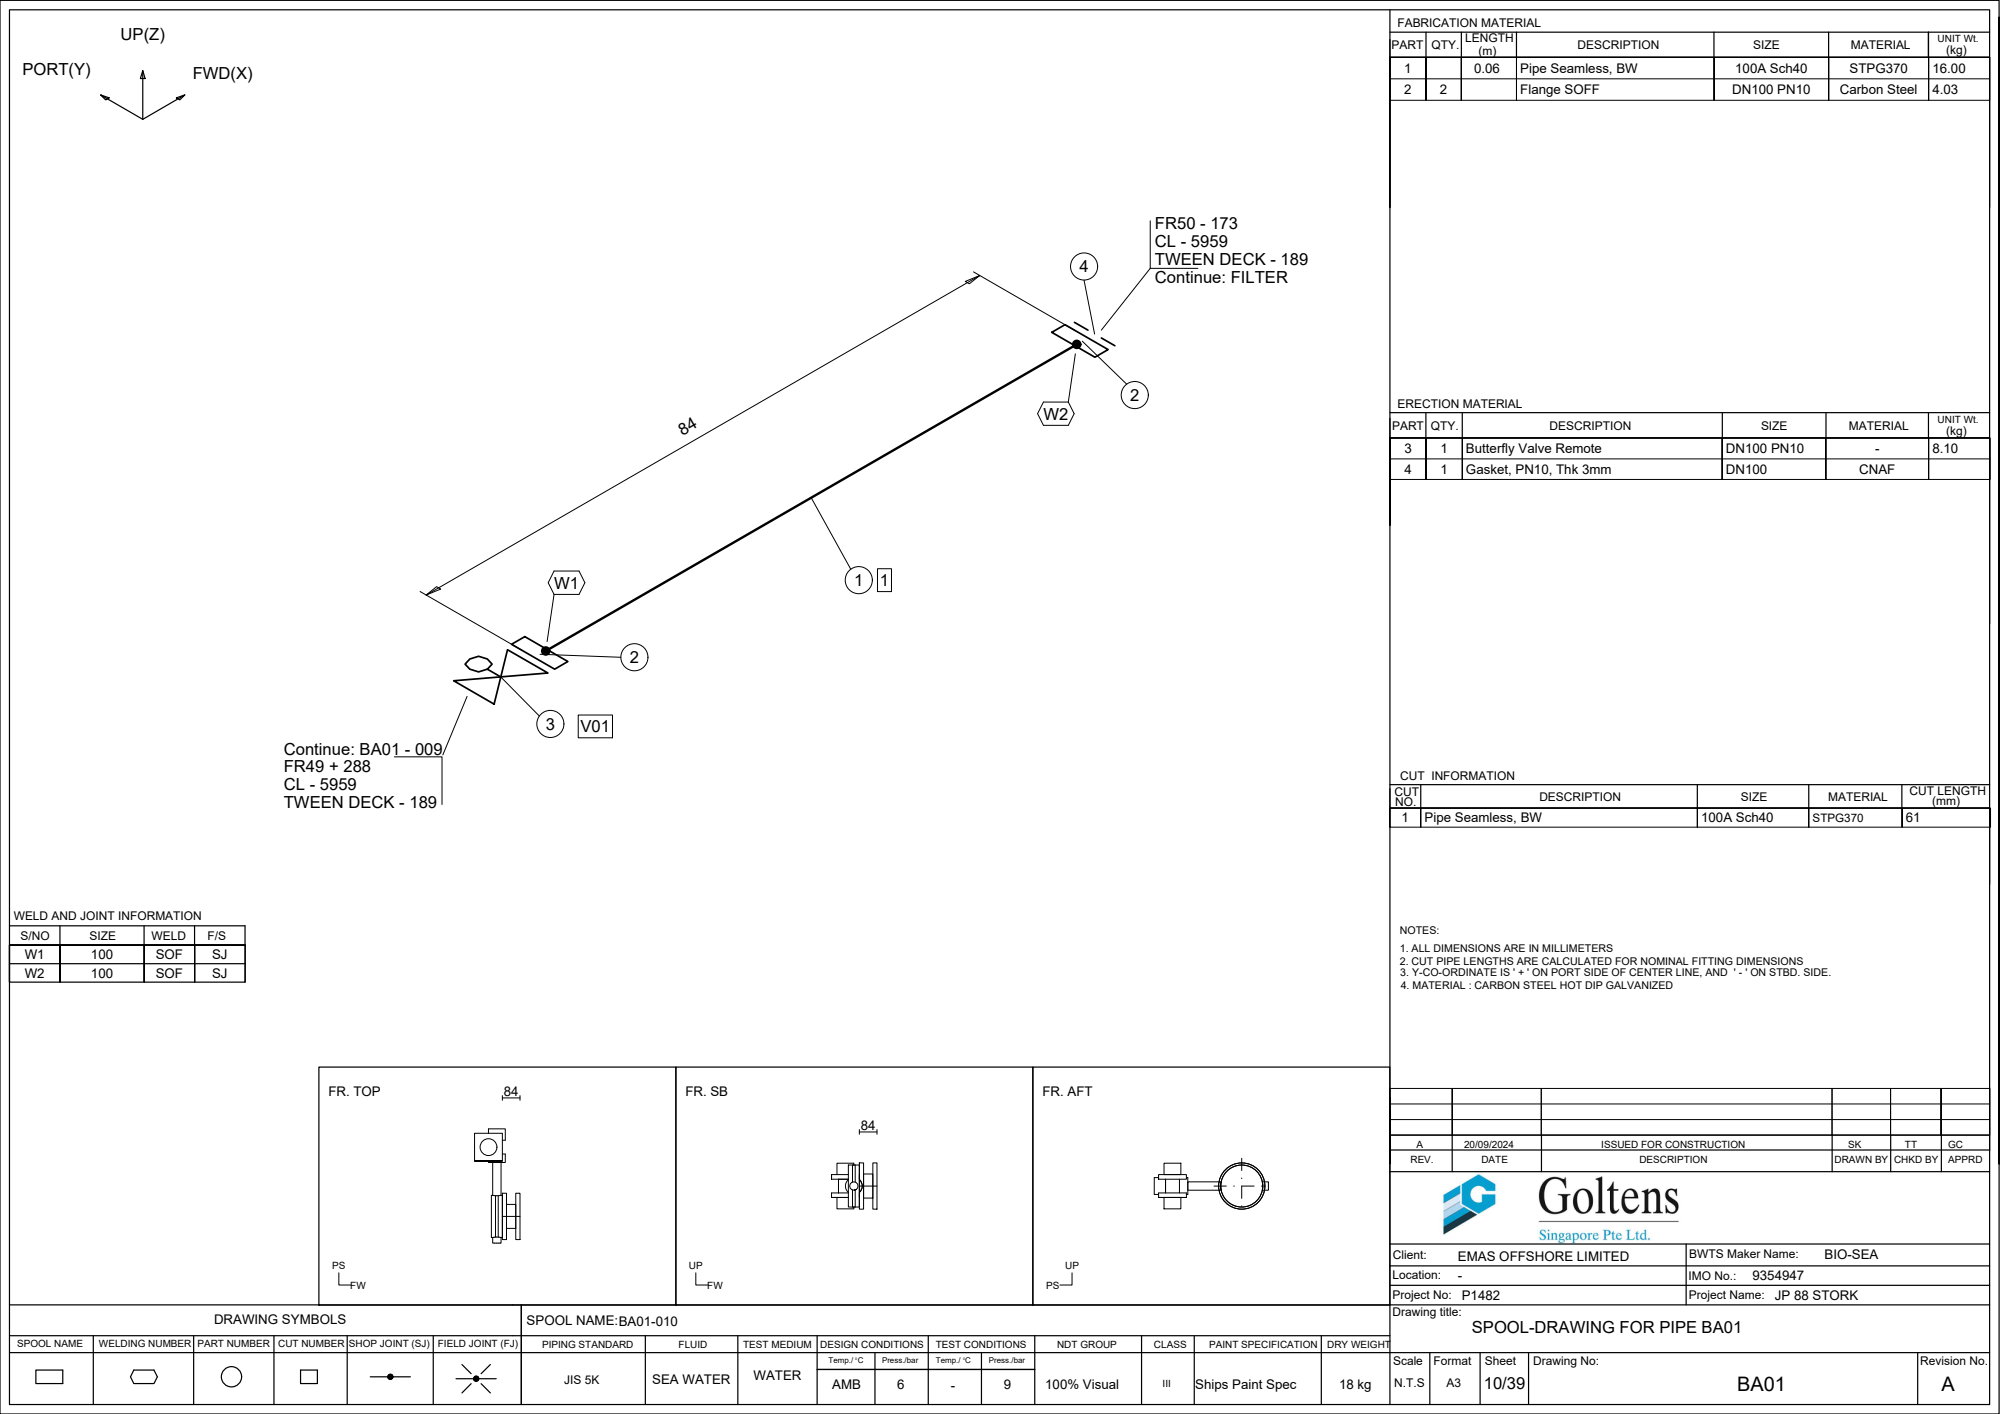
[picture p31: page 11]
FR. TOP; FR. AFT; AMB; Pipe Seamless, BW; 100A Sch40; STPG370; Flange SOFF; Carbon Steel; Gasket, PN10, Thk 3mm; CNAF; SOF; REV.; DATE; DESCRIPTION; DRAWN BY; CHKD BY; APPRD; Location:; Client:; ERECTION MATERIAL; CUT INFORMATION; SIZE; WELD; ISSUED FOR CONSTRUCTION; TWEEN DECK - 189; Continue: FILTER; FR49 + 288 CL - 5959 TWEEN DECK - 189; Continue: BA01 - 009

PART | QTY. | DESCRIPTION | SIZE | MATERIAL | UNIT Wt. (kg)

3 | 1 | Butterfly Valve Remote | DN100 PN10 | - | 8.10

CUT NO. | DESCRIPTION | SIZE | MATERIAL | CUT LENGTH (mm)

1 | Pipe Seamless, BW | 100A Sch40 | STPG370 | 61

WELD AND JOINT INFORMATION

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

- BIO-SEA
EMAS OFFSHORE LIMITED

BWTS Maker Name:

IMO No.: NDT GROUP

### FWD(X)

PORT(Y) | 347 | 347

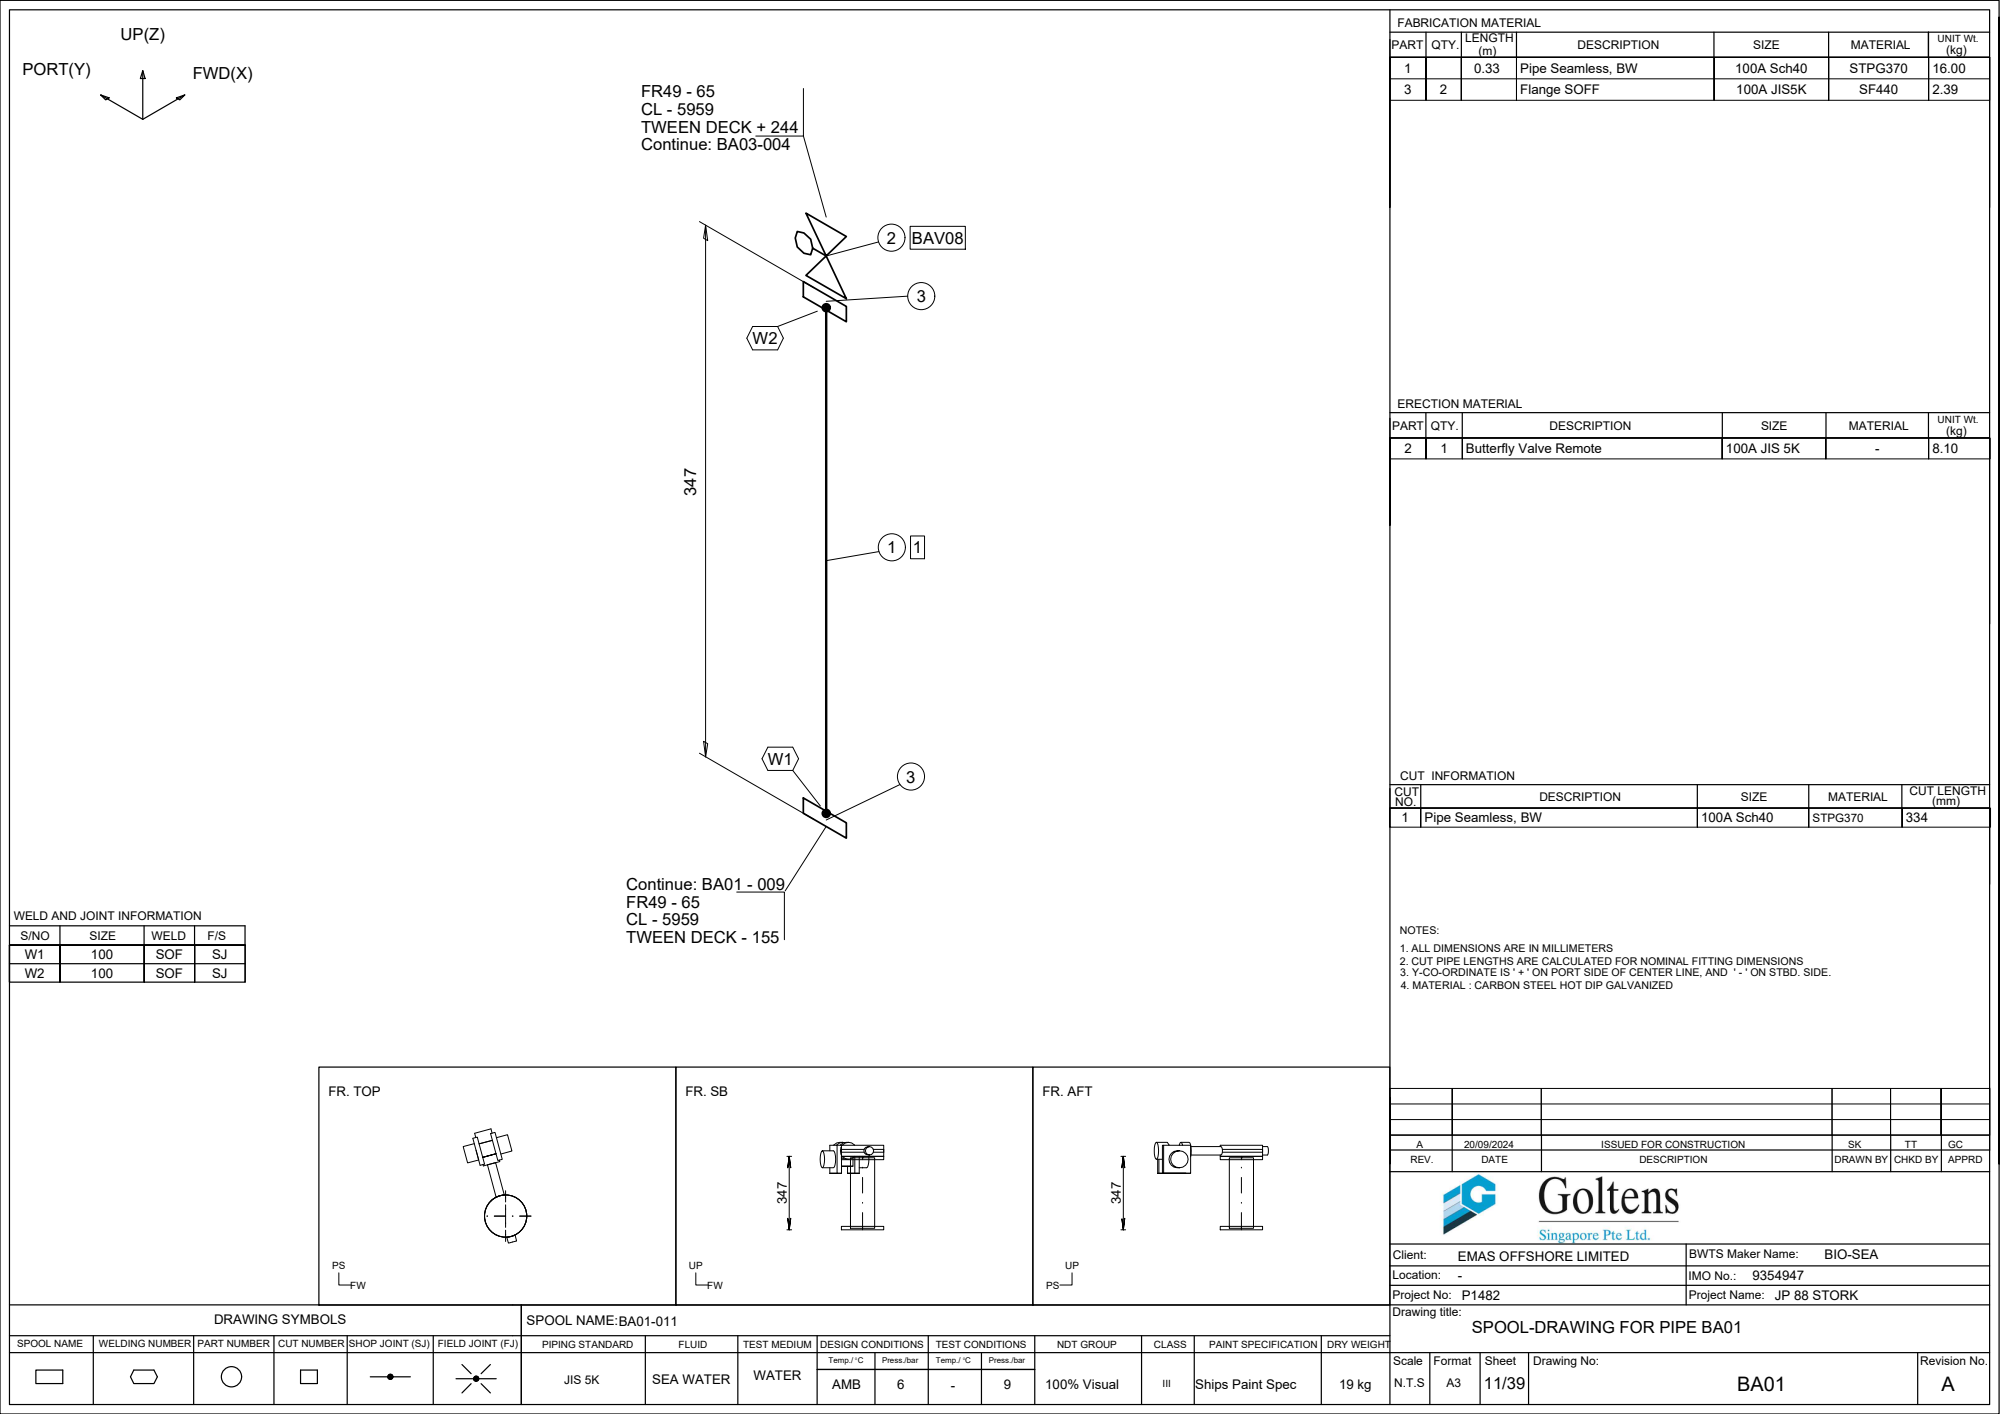
[picture p32: page 12]
FR. TOP; FR. AFT; AMB; Pipe Seamless, BW; 100A Sch40; STPG370; Flange SOFF; 100A JIS5K; Butterfly Valve Remote; 100A JIS 5K; SOF; REV.; DATE; DESCRIPTION; DRAWN BY; CHKD BY; APPRD; Location:; Client:; ERECTION MATERIAL; CUT INFORMATION; SIZE; WELD; PART; QTY.; MATERIAL; ISSUED FOR CONSTRUCTION; TWEEN DECK + 244; Continue: BA03-004; FR49 - 65 CL - 5959 TWEEN DECK - 155; Continue: BA01 - 009; BAV08

UNIT Wt. (kg)

4. MATERIAL : CARBON STEEL HOT DIP GALVANIZED 347

CUT NO. | DESCRIPTION | SIZE | MATERIAL | CUT LENGTH (mm)

1 | Pipe Seamless, BW | 100A Sch40 | STPG370 | 334

WELD AND JOINT INFORMATION

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

- BIO-SEA
EMAS OFFSHORE LIMITED

BWTS Maker Name:

IMO No.: NDT GROUP

### FWD(X)

### PORT(Y)

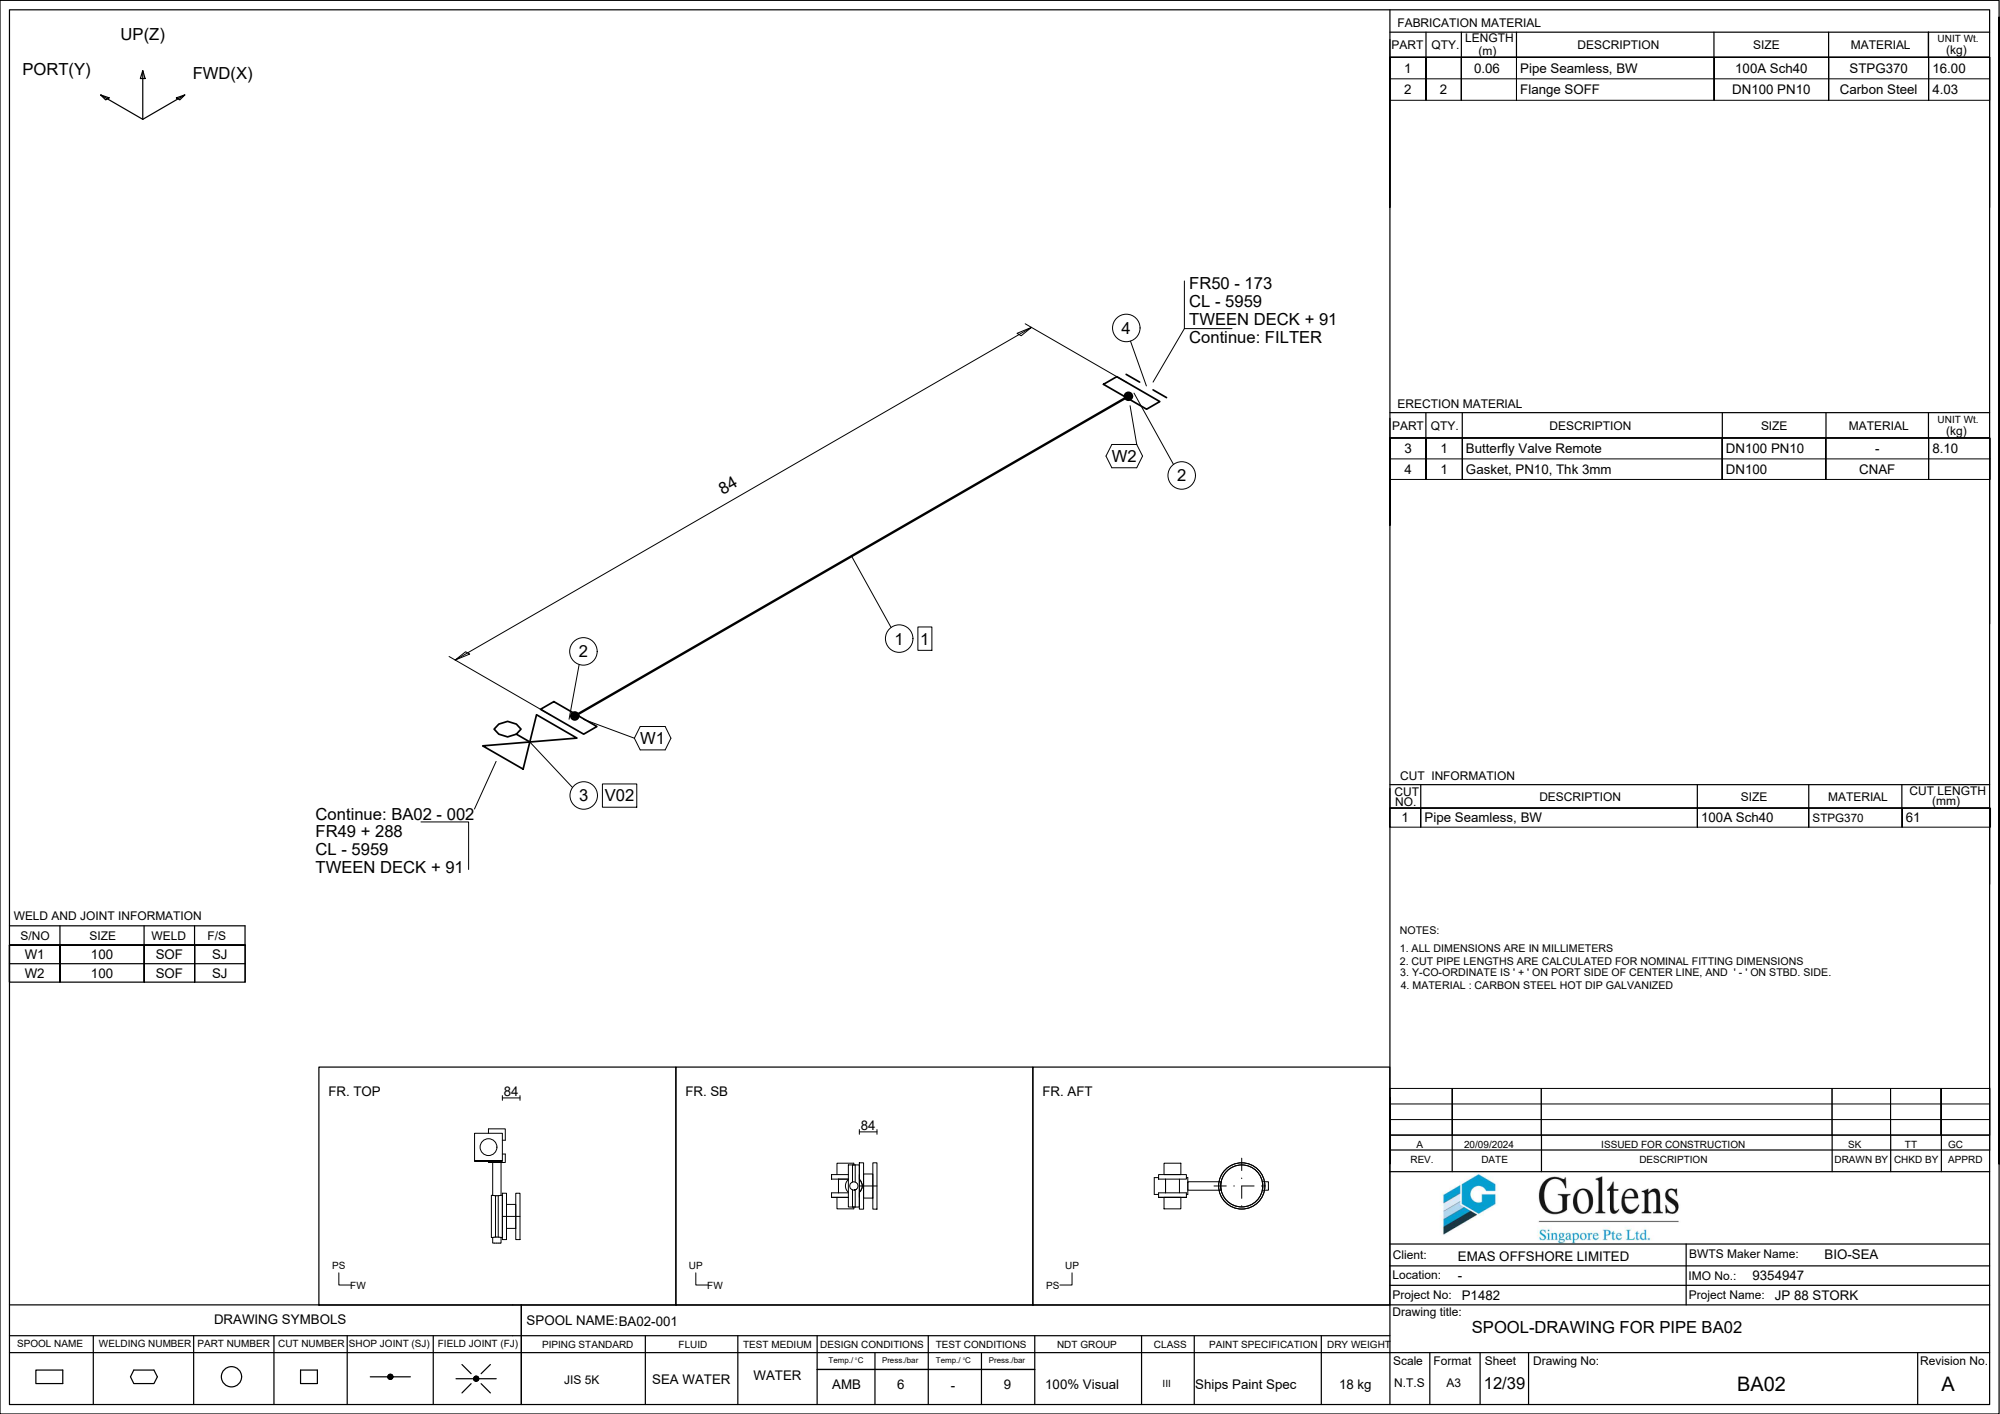
[picture p33: page 13]
FR. TOP; FR. AFT; AMB; Pipe Seamless, BW; 100A Sch40; STPG370; Flange SOFF; Carbon Steel; Gasket, PN10, Thk 3mm; CNAF; SOF; REV.; DATE; DESCRIPTION; DRAWN BY; CHKD BY; APPRD; Location:; Client:; ERECTION MATERIAL; CUT INFORMATION; SIZE; WELD; ISSUED FOR CONSTRUCTION; TWEEN DECK + 91; Continue: FILTER; FR49 + 288 CL - 5959 TWEEN DECK + 91; Continue: BA02 - 002

PART | QTY. | DESCRIPTION | SIZE | MATERIAL | UNIT Wt. (kg)

3 | 1 | Butterfly Valve Remote | DN100 PN10 | - | 8.10

CUT NO. | DESCRIPTION | SIZE | MATERIAL | CUT LENGTH (mm)

1 | Pipe Seamless, BW | 100A Sch40 | STPG370 | 61

WELD AND JOINT INFORMATION

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

- BIO-SEA
EMAS OFFSHORE LIMITED

BWTS Maker Name:

IMO No.: NDT GROUP

### TWEEN DECK + 362

CL - 5959

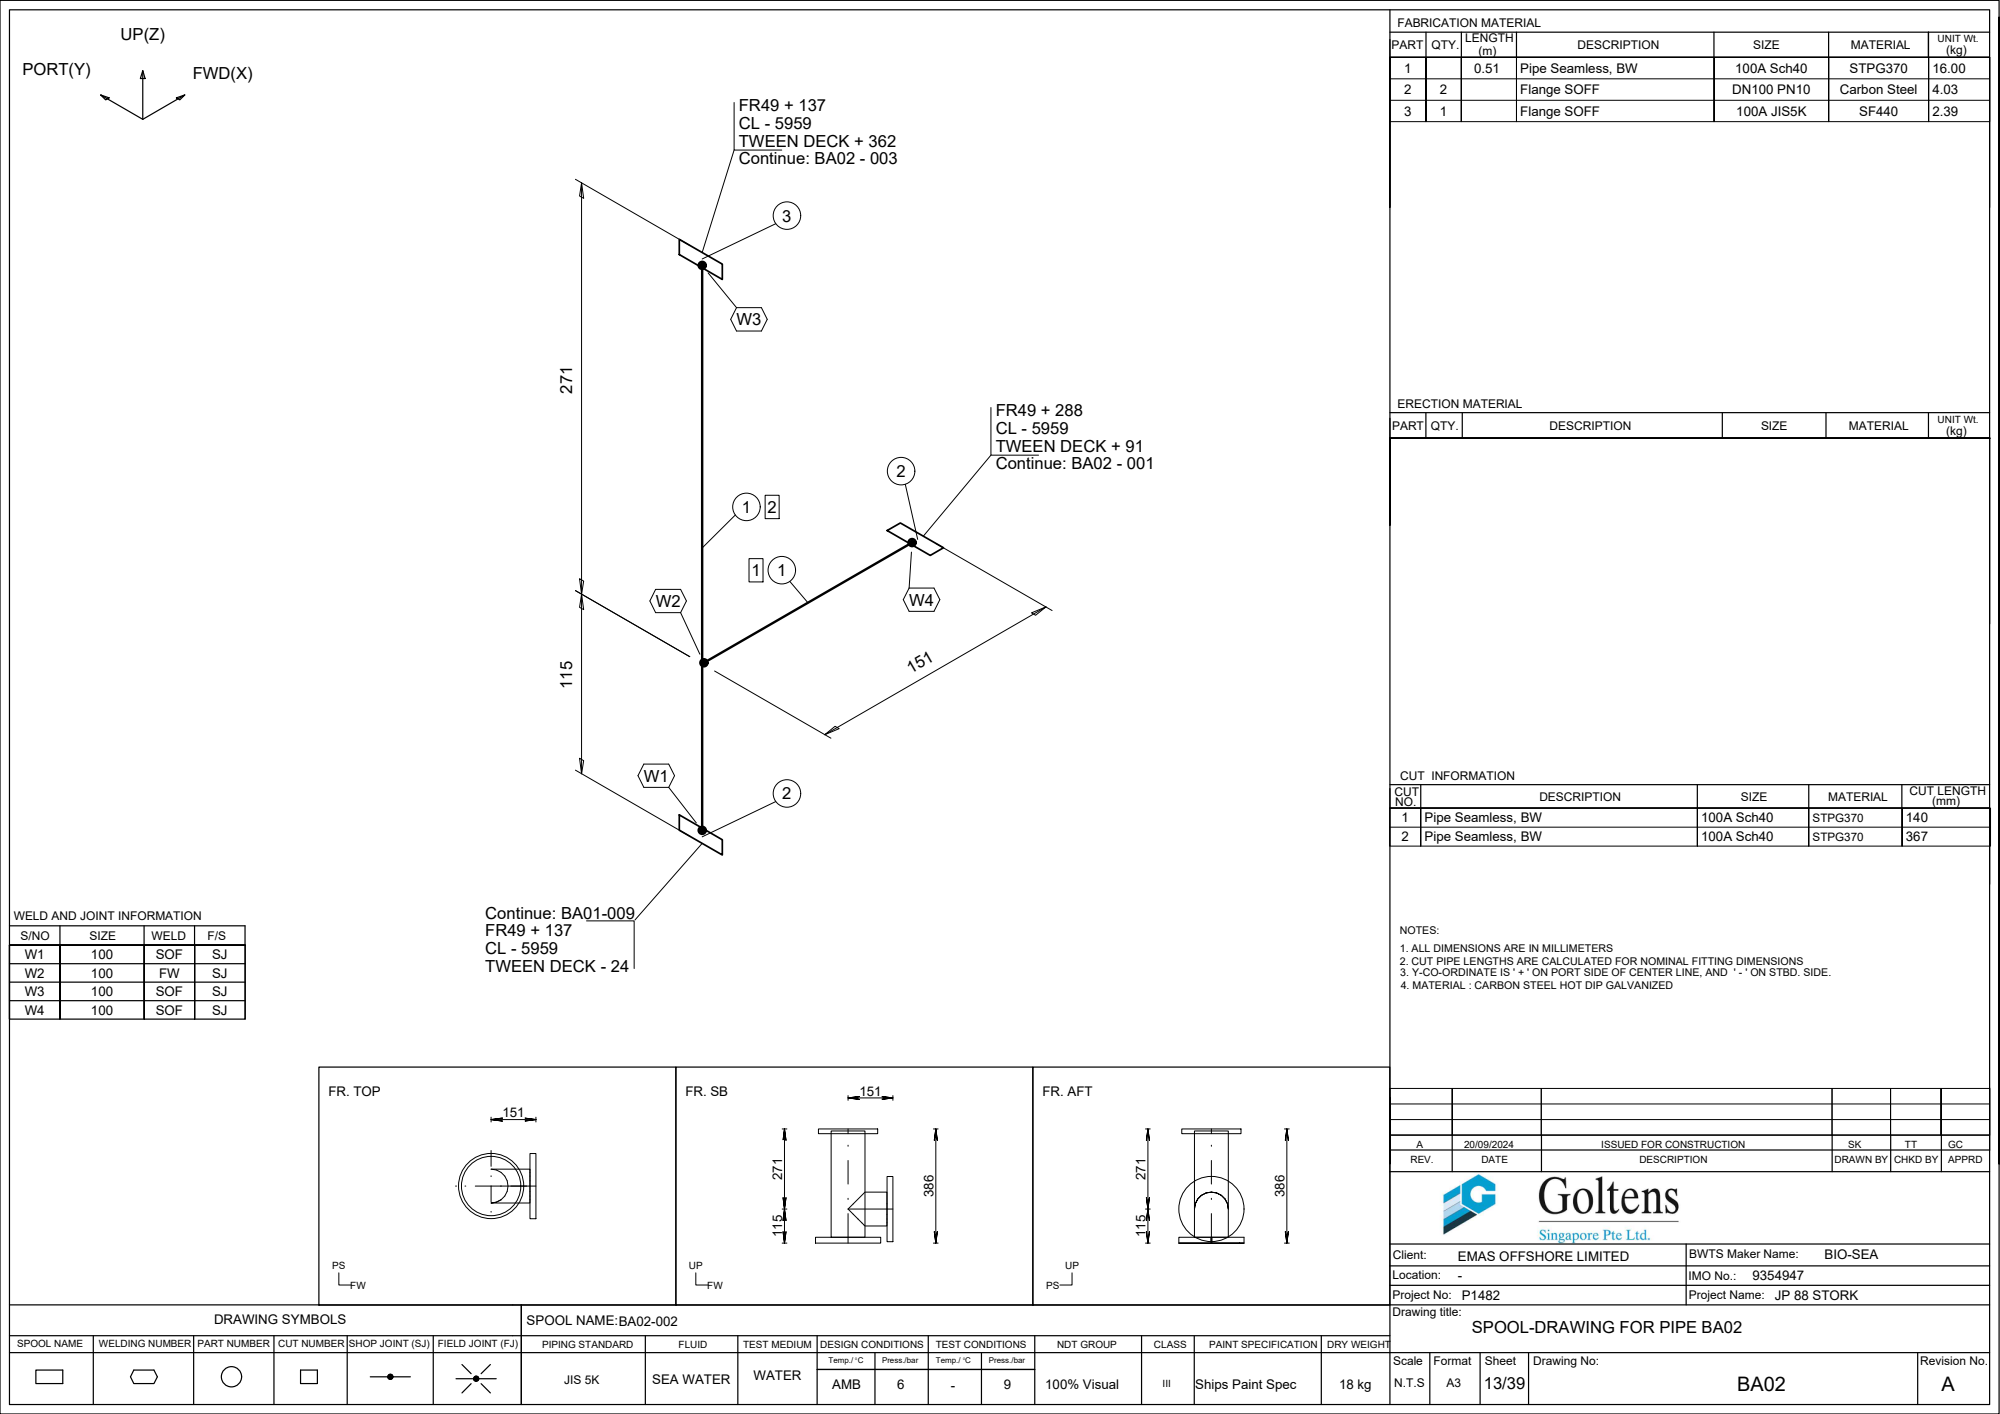
[picture p34: page 14]
FR. TOP; FR. AFT; AMB; Flange SOFF; 100A JIS5K; SOF; Pipe Seamless, BW; 100A Sch40; STPG370; REV.; DATE; DESCRIPTION; DRAWN BY; CHKD BY; APPRD; Location:; Client:; ERECTION MATERIAL; CUT INFORMATION; SIZE; WELD; PART; QTY.; MATERIAL; ISSUED FOR CONSTRUCTION; 4. MATERIAL : CARBON STEEL HOT DIP GALVANIZED 115; 151 ²⁷¹; Continue: BA02 - 003; TWEEN DECK + 91; Continue: BA02 - 001; FR49 + 137 CL - 5959 TWEEN DECK - 24; Continue: BA01-009

1 | | 0.51 | Pipe Seamless, BW | 100A Sch40 | STPG370 | 16.00
2 | 2 | | Flange SOFF | DN100 PN10 | Carbon Steel | 4.03

UNIT Wt. (kg)

CUT NO. | DESCRIPTION | SIZE | MATERIAL | CUT LENGTH (mm)

1 | Pipe Seamless, BW | 100A Sch40 | STPG370 | 140

WELD AND JOINT INFORMATION

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

W1 | 100 | SOF | SJ
W2 | 100 | FW | SJ
W3 | 100 | SOF | SJ

- BIO-SEA
EMAS OFFSHORE LIMITED

BWTS Maker Name:

IMO No.: NDT GROUP

2
W3

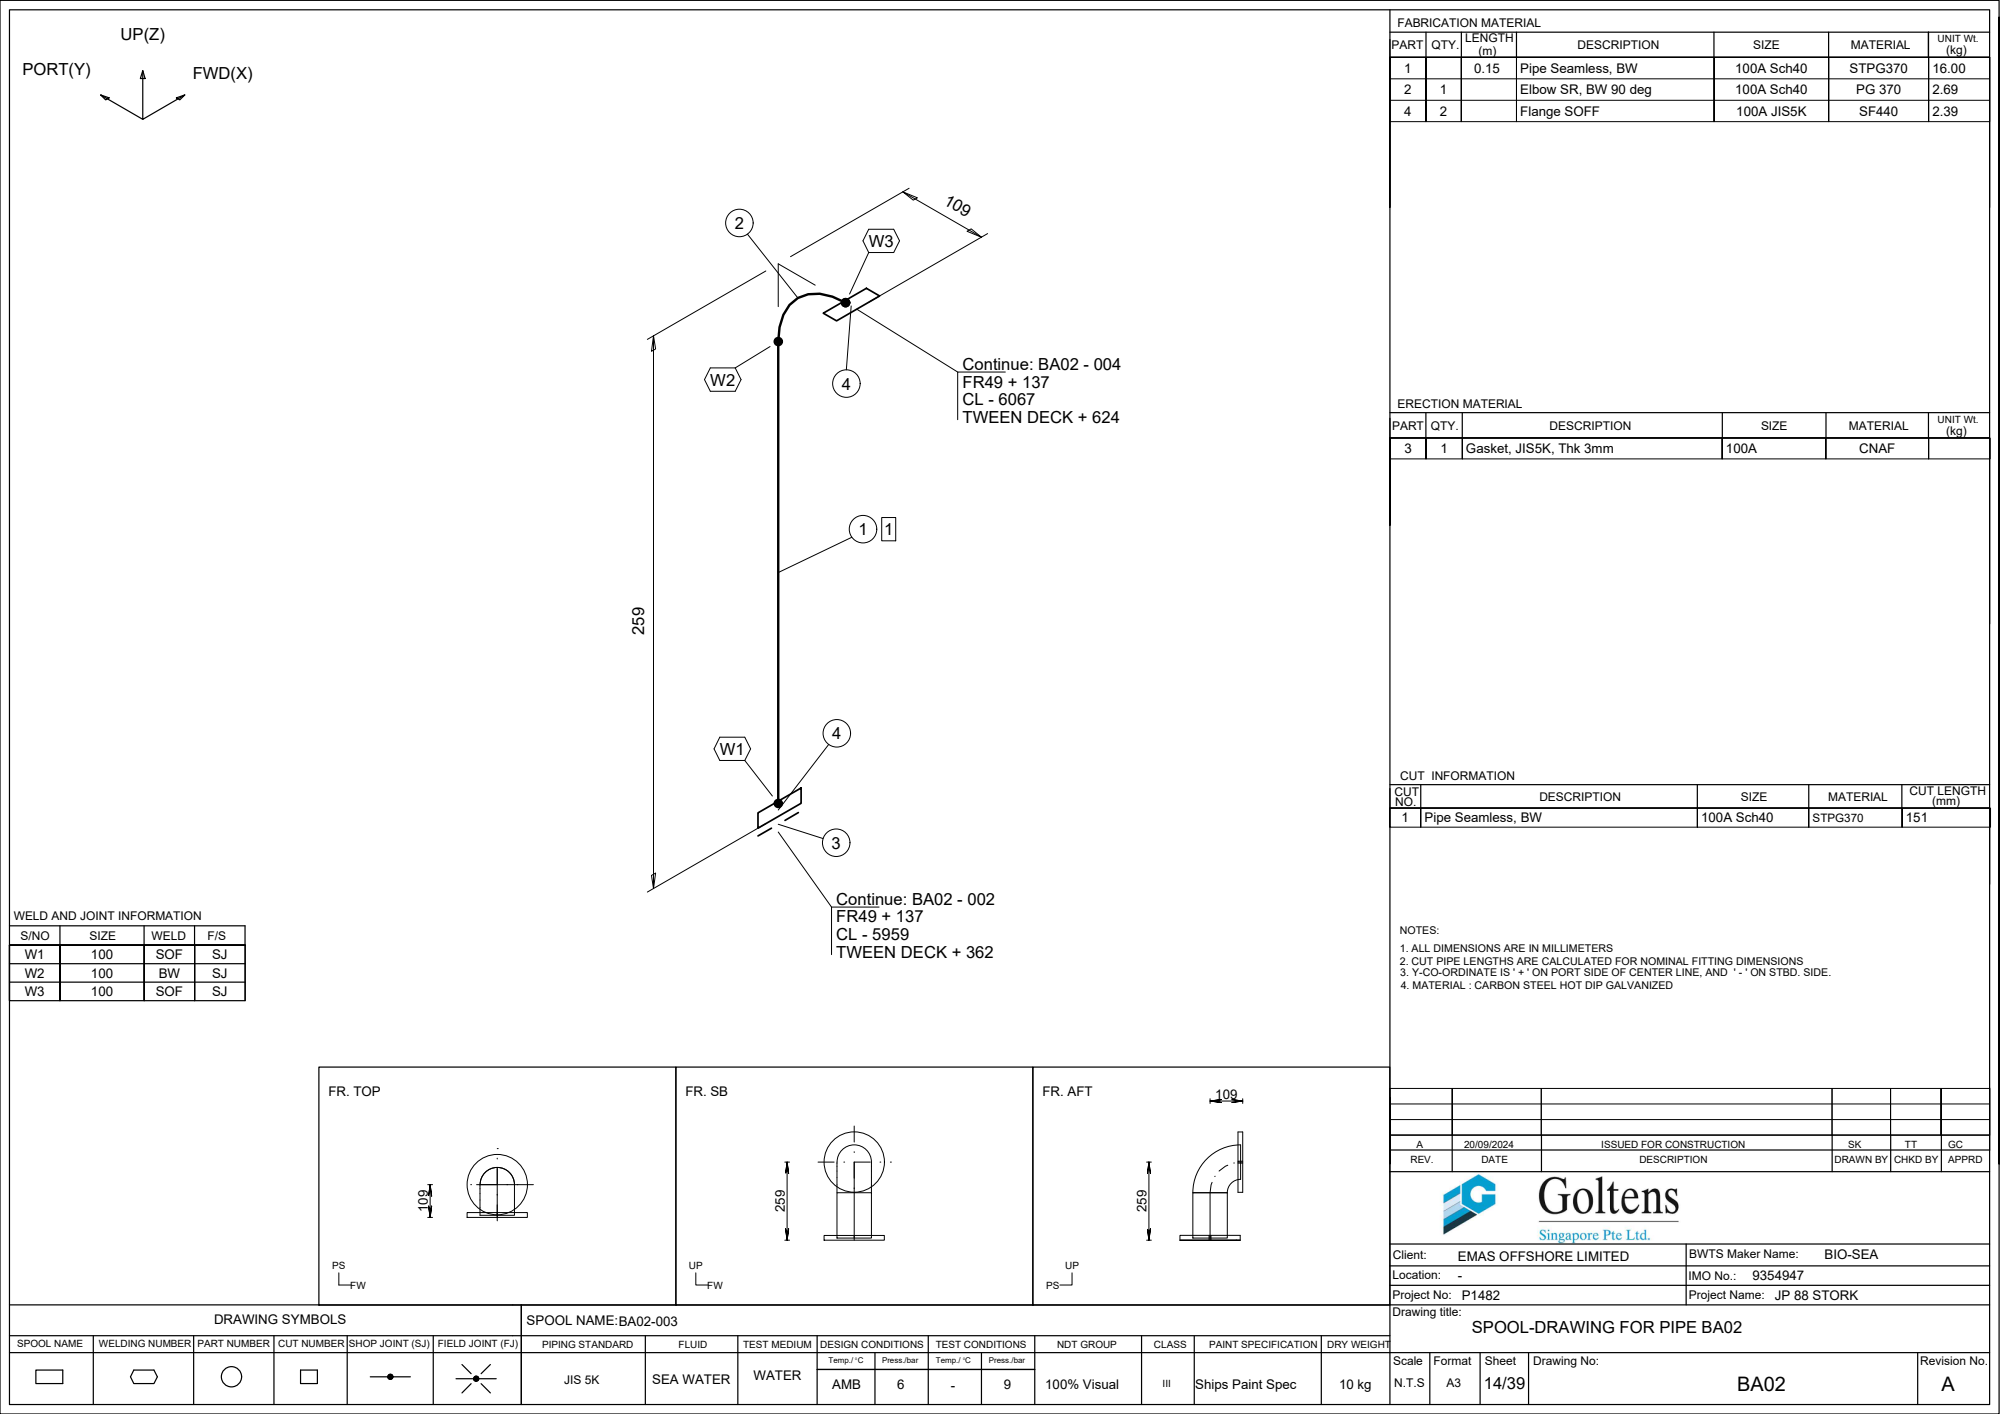
[picture p35: page 15]
FR. TOP; FR. AFT; AMB; Flange SOFF; 100A JIS5K; Gasket, JIS5K, Thk 3mm; CNAF; SOF; REV.; DATE; DESCRIPTION; DRAWN BY; CHKD BY; APPRD; Location:; Client:; ERECTION MATERIAL; CUT INFORMATION; SIZE; WELD; PART; QTY.; MATERIAL; ISSUED FOR CONSTRUCTION; FR49 + 137 CL - 5959 TWEEN DECK + 362; Continue: BA02 - 002; FR49 + 137 CL - 6067 TWEEN DECK + 624; Continue: BA02 - 004

1 | | 0.15 | Pipe Seamless, BW | 100A Sch40 | STPG370 | 16.00
2 | 1 | | Elbow SR, BW 90 deg | 100A Sch40 | PG 370 | 2.69

UNIT Wt. (kg)

4. MATERIAL : CARBON STEEL HOT DIP GALVANIZED 259

CUT NO. | DESCRIPTION | SIZE | MATERIAL | CUT LENGTH (mm)

1 | Pipe Seamless, BW | 100A Sch40 | STPG370 | 151

WELD AND JOINT INFORMATION

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

W1 | 100 | SOF | SJ
W2 | 100 | BW | SJ

- BIO-SEA
EMAS OFFSHORE LIMITED

BWTS Maker Name:

IMO No.: NDT GROUP

# UP(Z) 175

### TWEEN DECK + 624

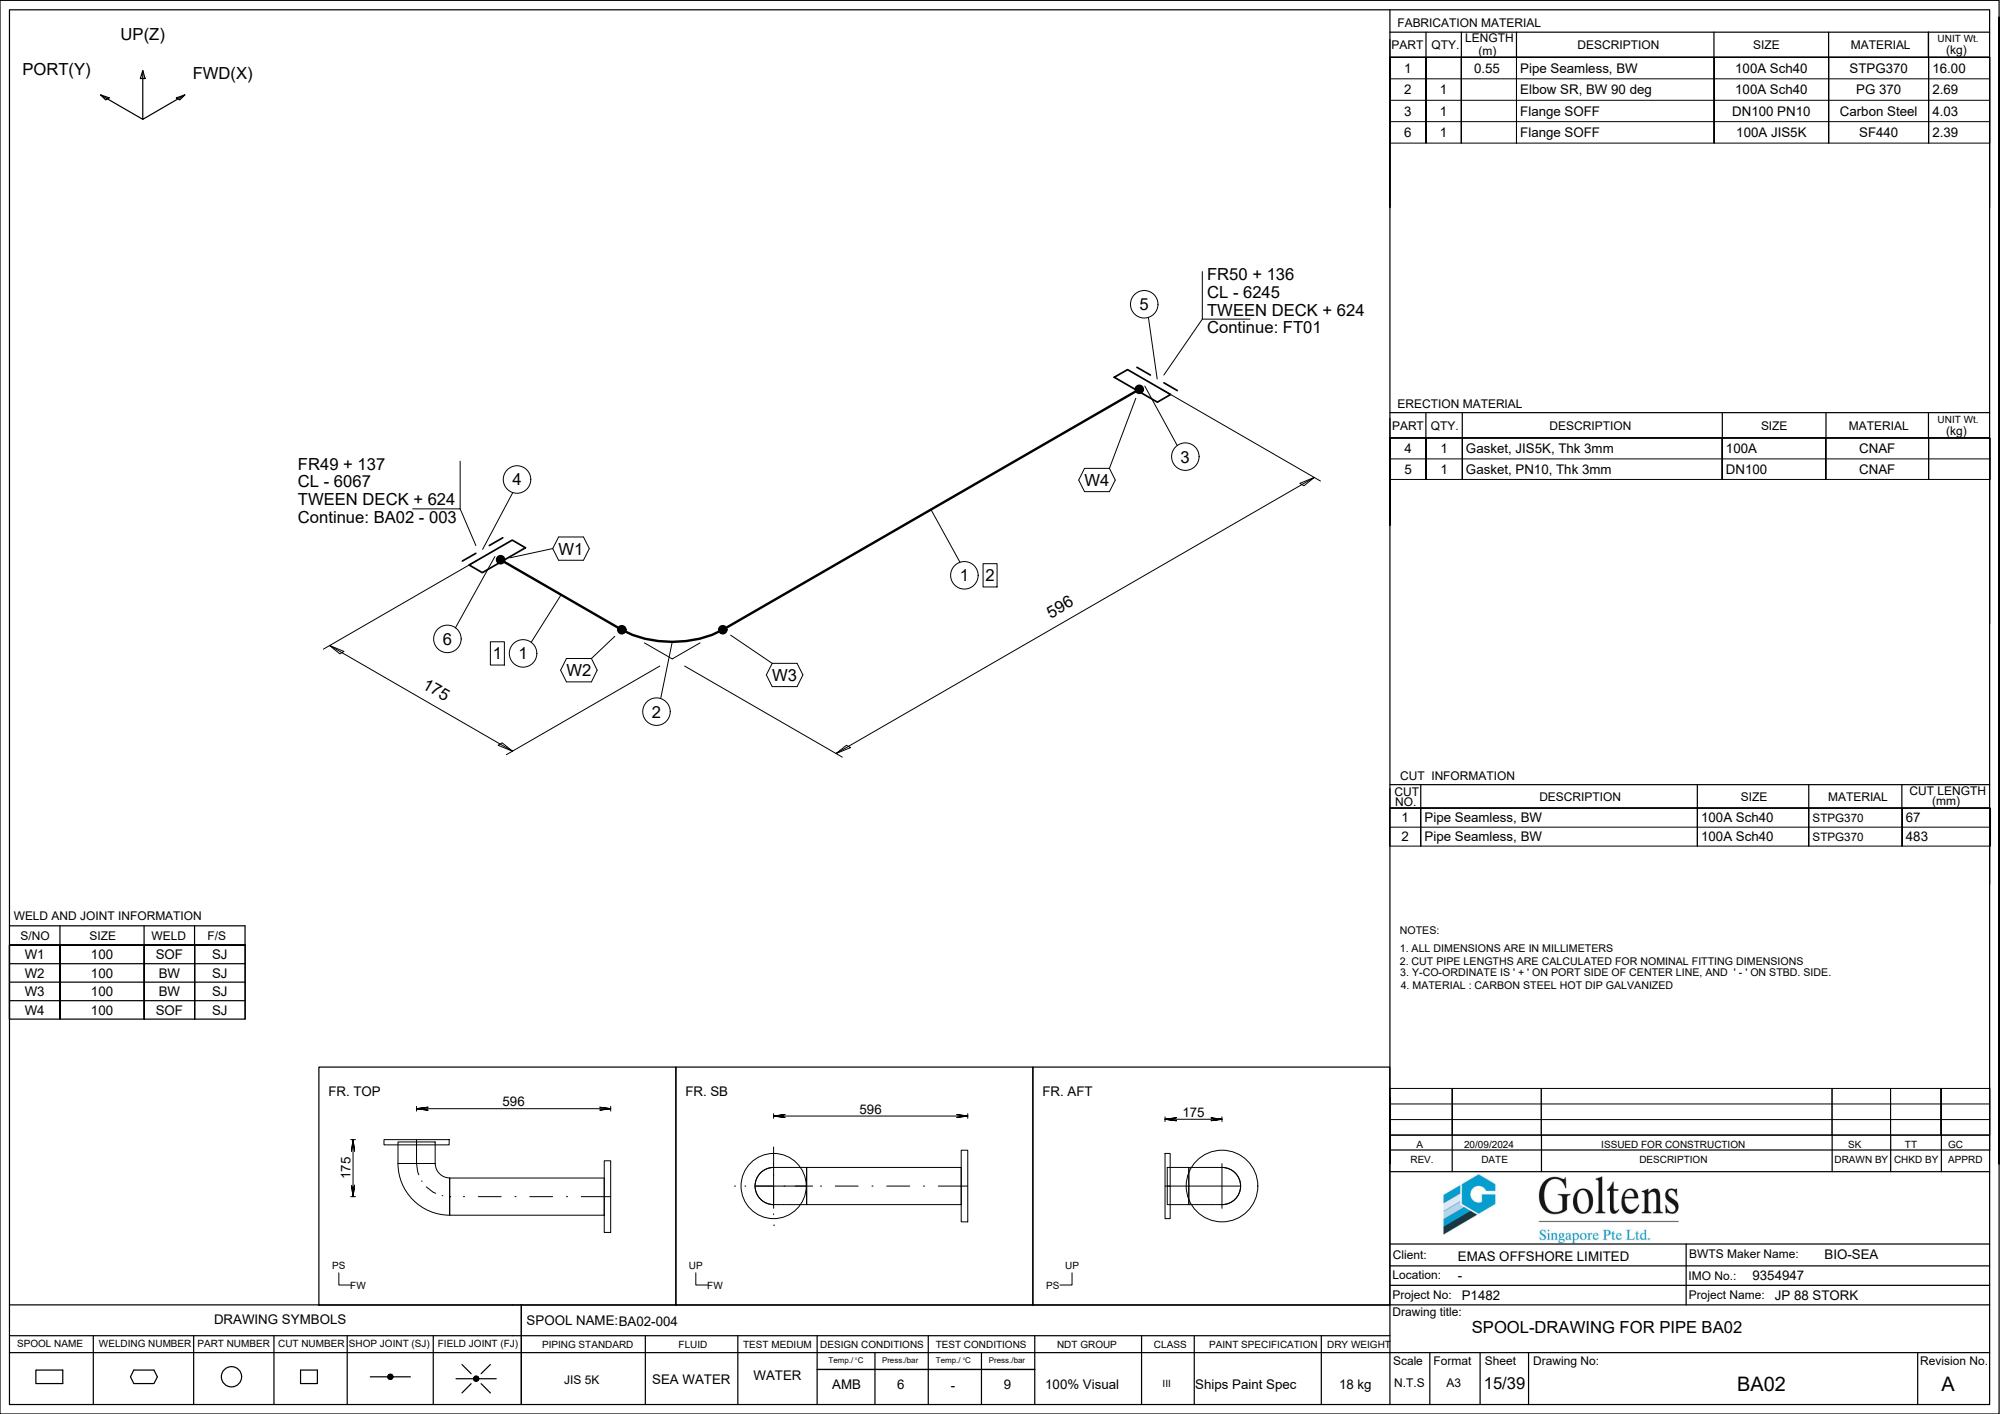
[picture p36: page 16]
FR. TOP; FR. AFT; AMB; Flange SOFF; 100A JIS5K; Gasket, PN10, Thk 3mm; CNAF; SOF; Pipe Seamless, BW; 100A Sch40; STPG370; REV.; DATE; DESCRIPTION; DRAWN BY; CHKD BY; APPRD; Location:; Client:; ERECTION MATERIAL; CUT INFORMATION; SIZE; WELD; ISSUED FOR CONSTRUCTION; TWEEN DECK + 624; Continue: BA02 - 003; Continue: FT01

1 | | 0.55 | Pipe Seamless, BW | 100A Sch40 | STPG370 | 16.00
2 | 1 | | Elbow SR, BW 90 deg | 100A Sch40 | PG 370 | 2.69
3 | 1 | | Flange SOFF | DN100 PN10 | Carbon Steel | 4.03

PART | QTY. | DESCRIPTION | SIZE | MATERIAL | UNIT Wt. (kg)

4 | 1 | Gasket, JIS5K, Thk 3mm | 100A | CNAF

CUT NO. | DESCRIPTION | SIZE | MATERIAL | CUT LENGTH (mm)

1 | Pipe Seamless, BW | 100A Sch40 | STPG370 | 67

WELD AND JOINT INFORMATION

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

W1 | 100 | SOF | SJ
W2 | 100 | BW | SJ
W3 | 100 | BW | SJ

- BIO-SEA
EMAS OFFSHORE LIMITED

BWTS Maker Name:

IMO No.: NDT GROUP

### PORT(Y) FWD(X)

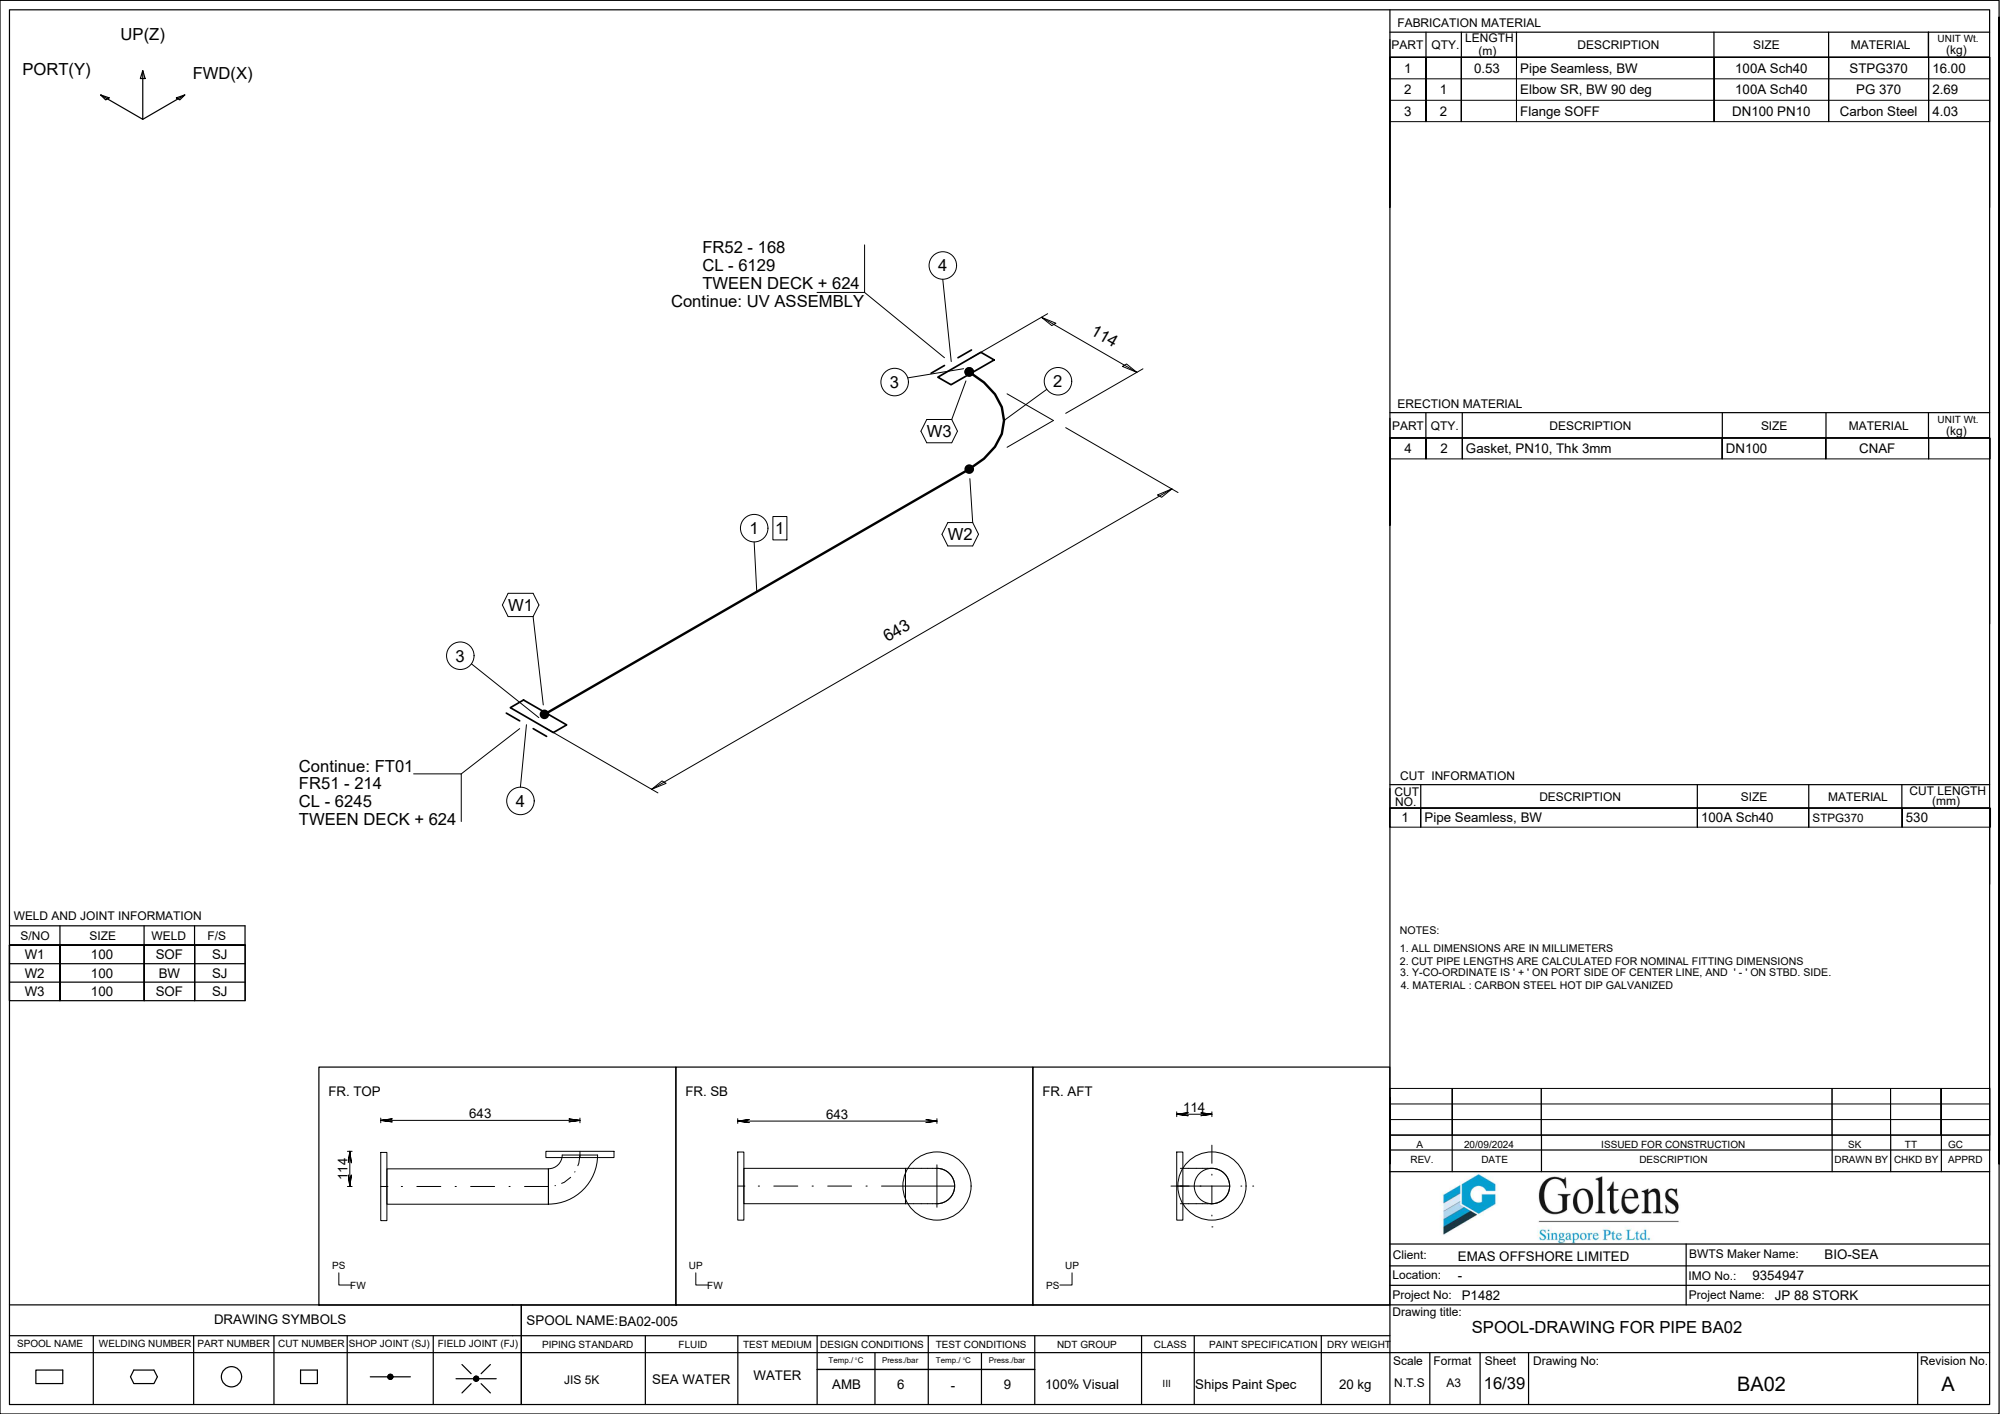
[picture p37: page 17]
FR. TOP; FR. AFT; AMB; Flange SOFF; Carbon Steel; Gasket, PN10, Thk 3mm; CNAF; SOF; REV.; DATE; DESCRIPTION; DRAWN BY; CHKD BY; APPRD; Location:; Client:; ERECTION MATERIAL; CUT INFORMATION; SIZE; WELD; PART; QTY.; MATERIAL; ISSUED FOR CONSTRUCTION; FR51 - 214 CL - 6245 TWEEN DECK + 624; Continue: FT01

1 | | 0.53 | Pipe Seamless, BW | 100A Sch40 | STPG370 | 16.00
2 | 1 | | Elbow SR, BW 90 deg | 100A Sch40 | PG 370 | 2.69

TWEEN DECK + 624
Continue: UV ASSEMBLY

UNIT Wt. (kg)

CUT NO. | DESCRIPTION | SIZE | MATERIAL | CUT LENGTH (mm)

1 | Pipe Seamless, BW | 100A Sch40 | STPG370 | 530

WELD AND JOINT INFORMATION

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

W1 | 100 | SOF | SJ
W2 | 100 | BW | SJ

- BIO-SEA
EMAS OFFSHORE LIMITED

BWTS Maker Name:

IMO No.: NDT GROUP

### FWD(X)

### PORT(Y)

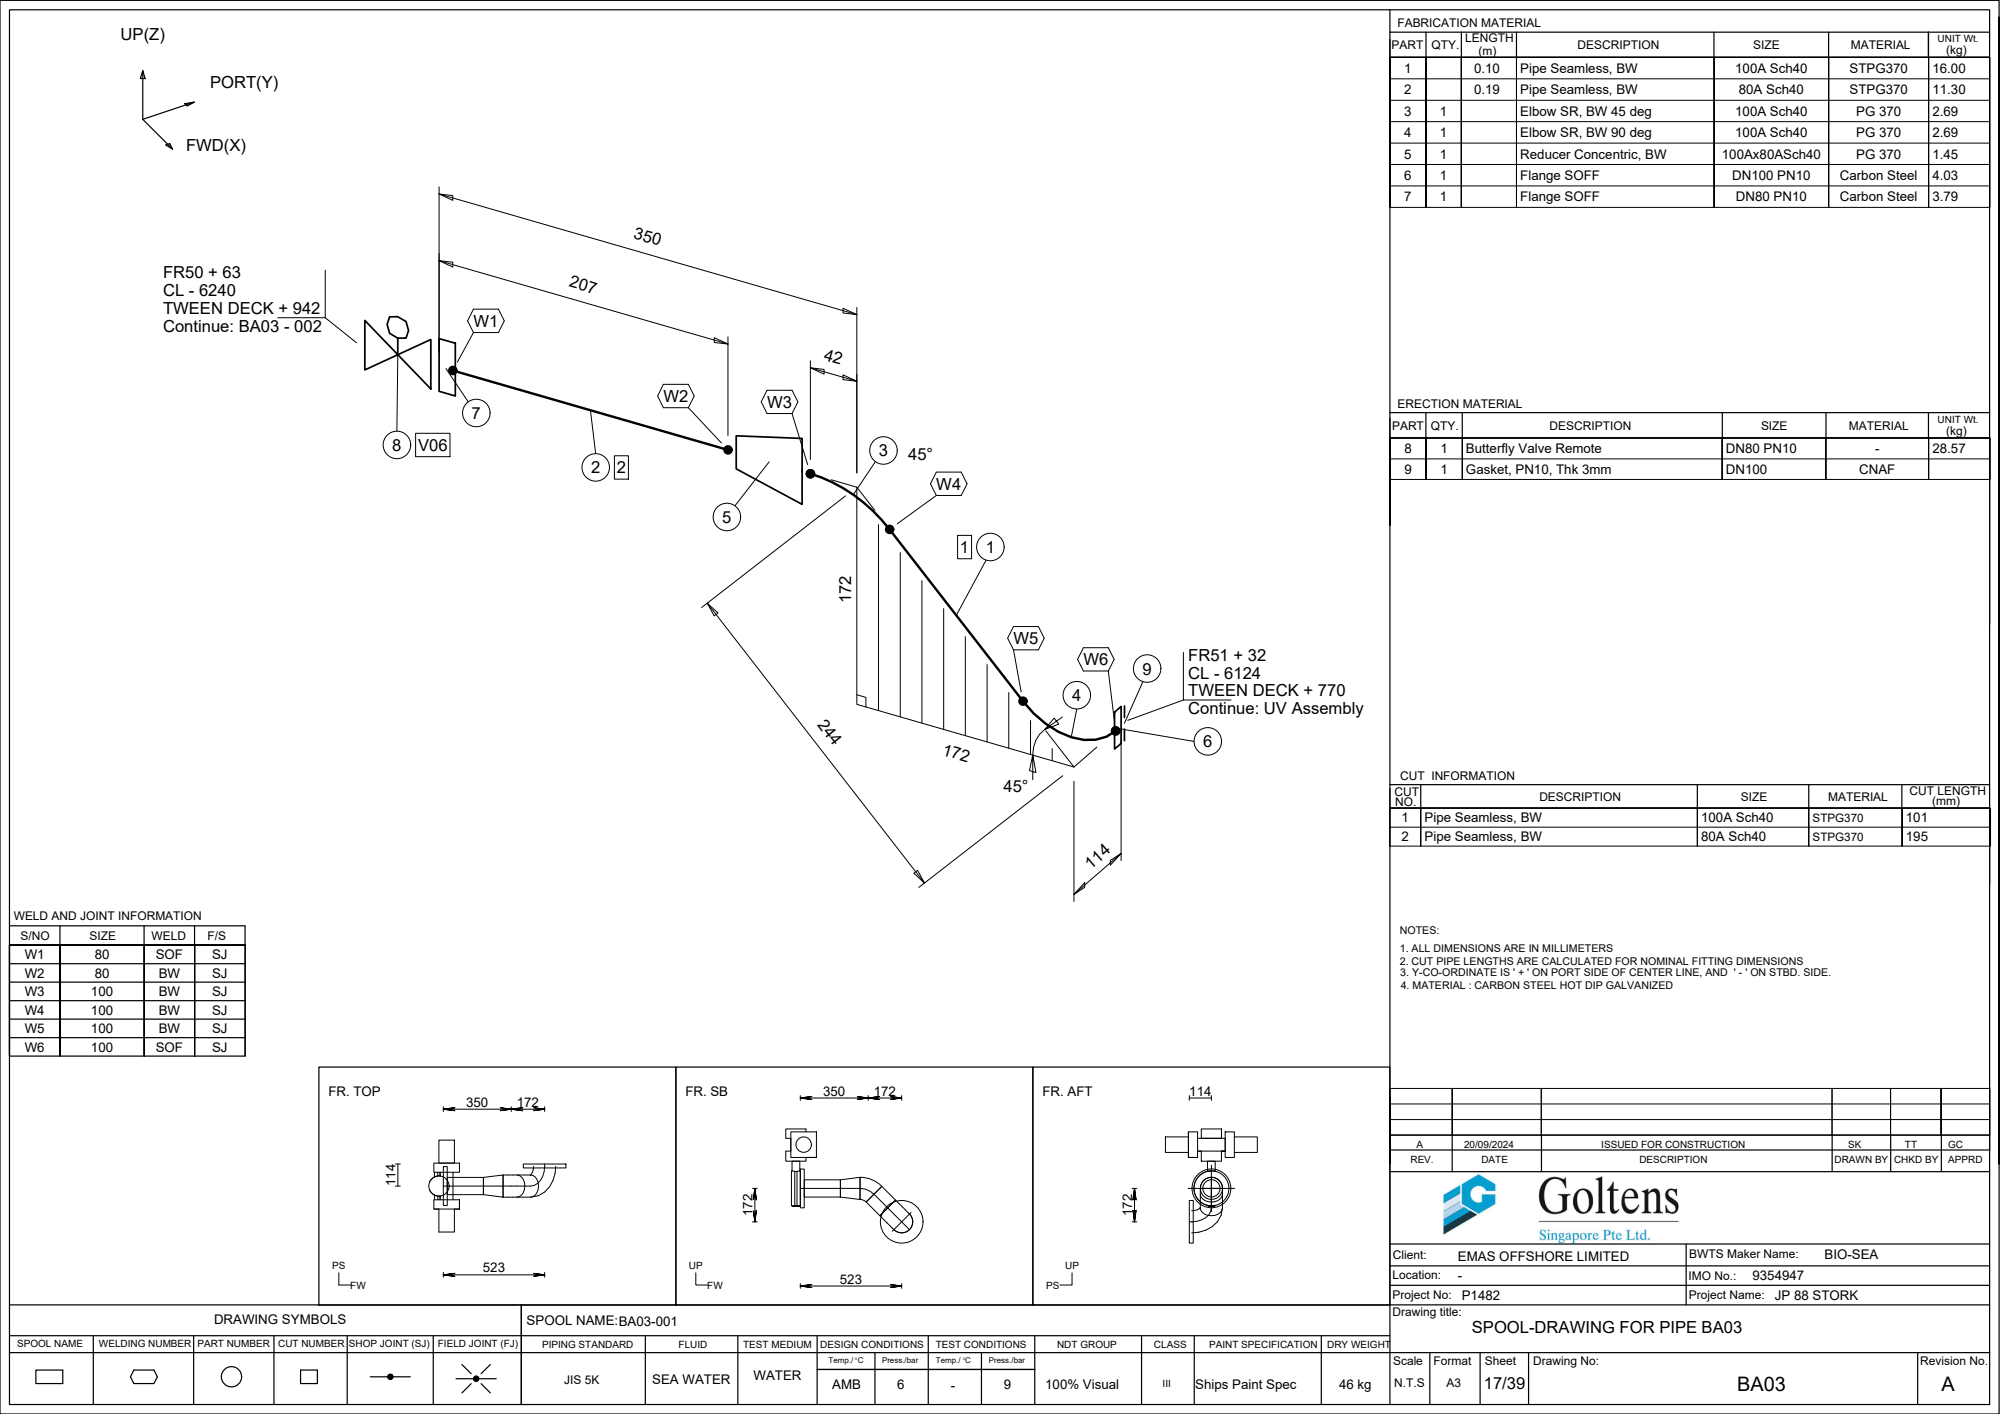
[picture p38: page 18]
FR. TOP; FR. AFT; AMB; Flange SOFF; Carbon Steel; Gasket, PN10, Thk 3mm; CNAF; SOF; Pipe Seamless, BW; 80A Sch40; STPG370; REV.; DATE; DESCRIPTION; DRAWN BY; CHKD BY; APPRD; Location:; Client:; ERECTION MATERIAL; CUT INFORMATION; SIZE; WELD; ISSUED FOR CONSTRUCTION; TWEEN DECK + 942; Continue: BA03 - 002; TWEEN DECK + 770; Continue: UV Assembly

1 | | 0.10 | Pipe Seamless, BW | 100A Sch40 | STPG370 | 16.00
2 | | 0.19 | Pipe Seamless, BW | 80A Sch40 | STPG370 | 11.30
3 | 1 | | Elbow SR, BW 45 deg | 100A Sch40 | PG 370 | 2.69
4 | 1 | | Elbow SR, BW 90 deg | 100A Sch40 | PG 370 | 2.69
5 | 1 | | Reducer Concentric, BW | 100Ax80ASch40 | PG 370 | 1.45
6 | 1 | | Flange SOFF | DN100 PN10 | Carbon Steel | 4.03

PART | QTY. | DESCRIPTION | SIZE | MATERIAL | UNIT Wt. (kg)

8 | 1 | Butterfly Valve Remote | DN80 PN10 | - | 28.57

CUT NO. | DESCRIPTION | SIZE | MATERIAL | CUT LENGTH (mm)

1 | Pipe Seamless, BW | 100A Sch40 | STPG370 | 101

WELD AND JOINT INFORMATION

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

W1 | 80 | SOF | SJ
W2 | 80 | BW | SJ
W3 | 100 | BW | SJ
W4 | 100 | BW | SJ
W5 | 100 | BW | SJ

- BIO-SEA
EMAS OFFSHORE LIMITED

BWTS Maker Name:

IMO No.: NDT GROUP

UP(Z) | 60 | 60

### TWEEN DECK + 942

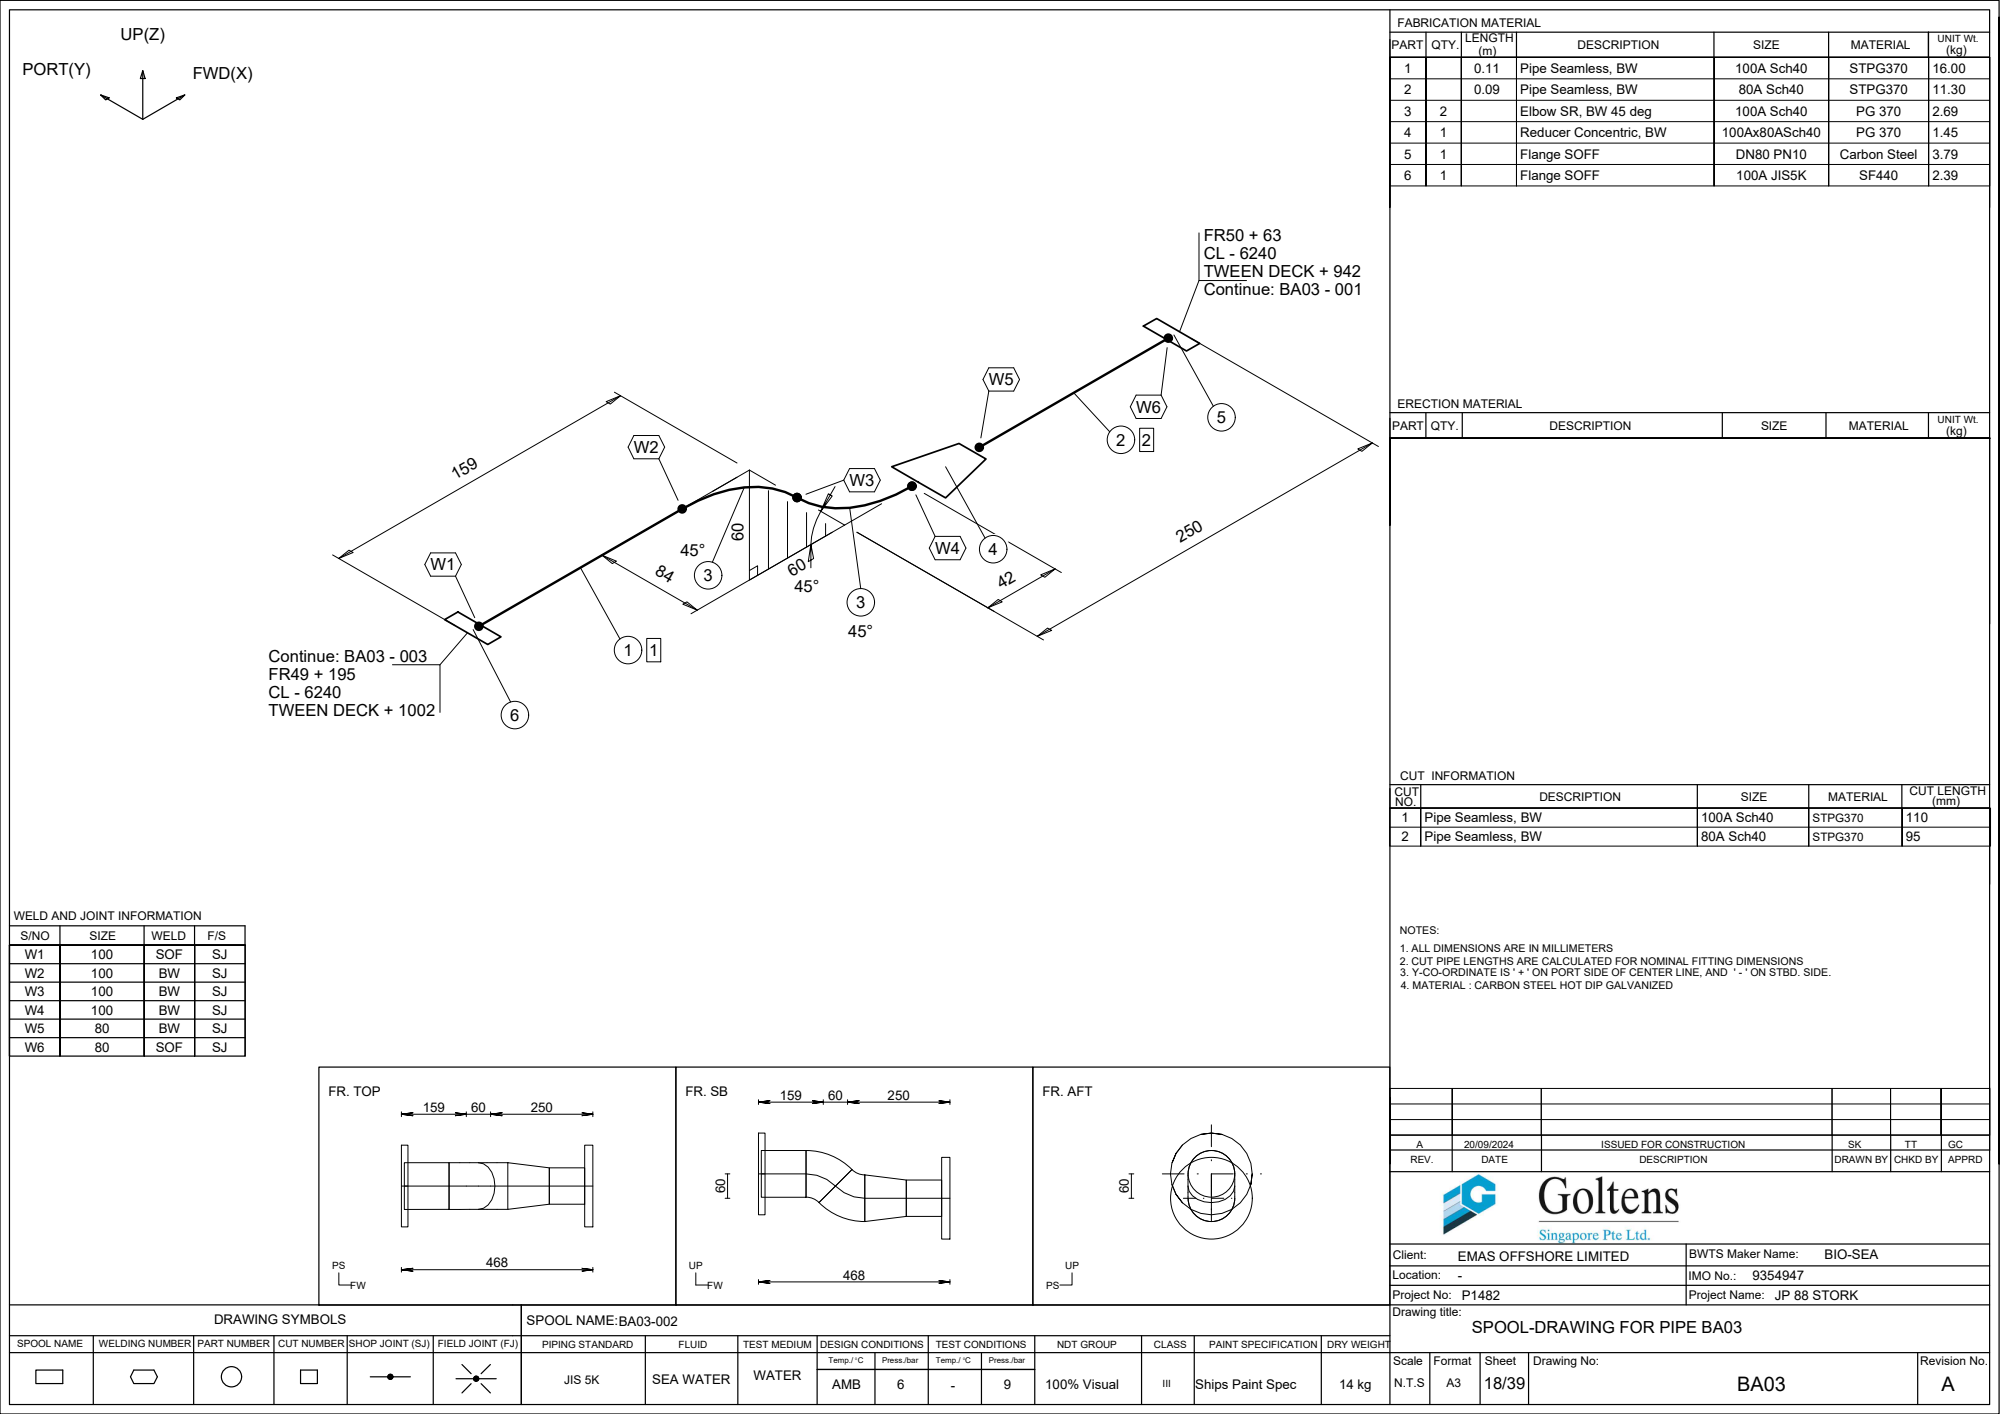
[picture p39: page 19]
FR. TOP; FR. AFT; AMB; Flange SOFF; 100A JIS5K; SOF; Pipe Seamless, BW; 80A Sch40; STPG370; REV.; DATE; DESCRIPTION; DRAWN BY; CHKD BY; APPRD; Location:; Client:; ERECTION MATERIAL; CUT INFORMATION; SIZE; WELD; PART; QTY.; MATERIAL; ISSUED FOR CONSTRUCTION; FR49 + 195 CL - 6240 TWEEN DECK + 1002; Continue: BA03 - 003; Continue: BA03 - 001

1 | | 0.11 | Pipe Seamless, BW | 100A Sch40 | STPG370 | 16.00
2 | | 0.09 | Pipe Seamless, BW | 80A Sch40 | STPG370 | 11.30
3 | 2 | | Elbow SR, BW 45 deg | 100A Sch40 | PG 370 | 2.69
4 | 1 | | Reducer Concentric, BW | 100Ax80ASch40 | PG 370 | 1.45
5 | 1 | | Flange SOFF | DN80 PN10 | Carbon Steel | 3.79

UNIT Wt. (kg)

CUT NO. | DESCRIPTION | SIZE | MATERIAL | CUT LENGTH (mm)

1 | Pipe Seamless, BW | 100A Sch40 | STPG370 | 110

WELD AND JOINT INFORMATION

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

W1 | 100 | SOF | SJ
W2 | 100 | BW | SJ
W3 | 100 | BW | SJ
W4 | 100 | BW | SJ
W5 | 80 | BW | SJ

- BIO-SEA
EMAS OFFSHORE LIMITED

BWTS Maker Name:

IMO No.: NDT GROUP

### TWEEN DECK + 1002

FR49 + 195

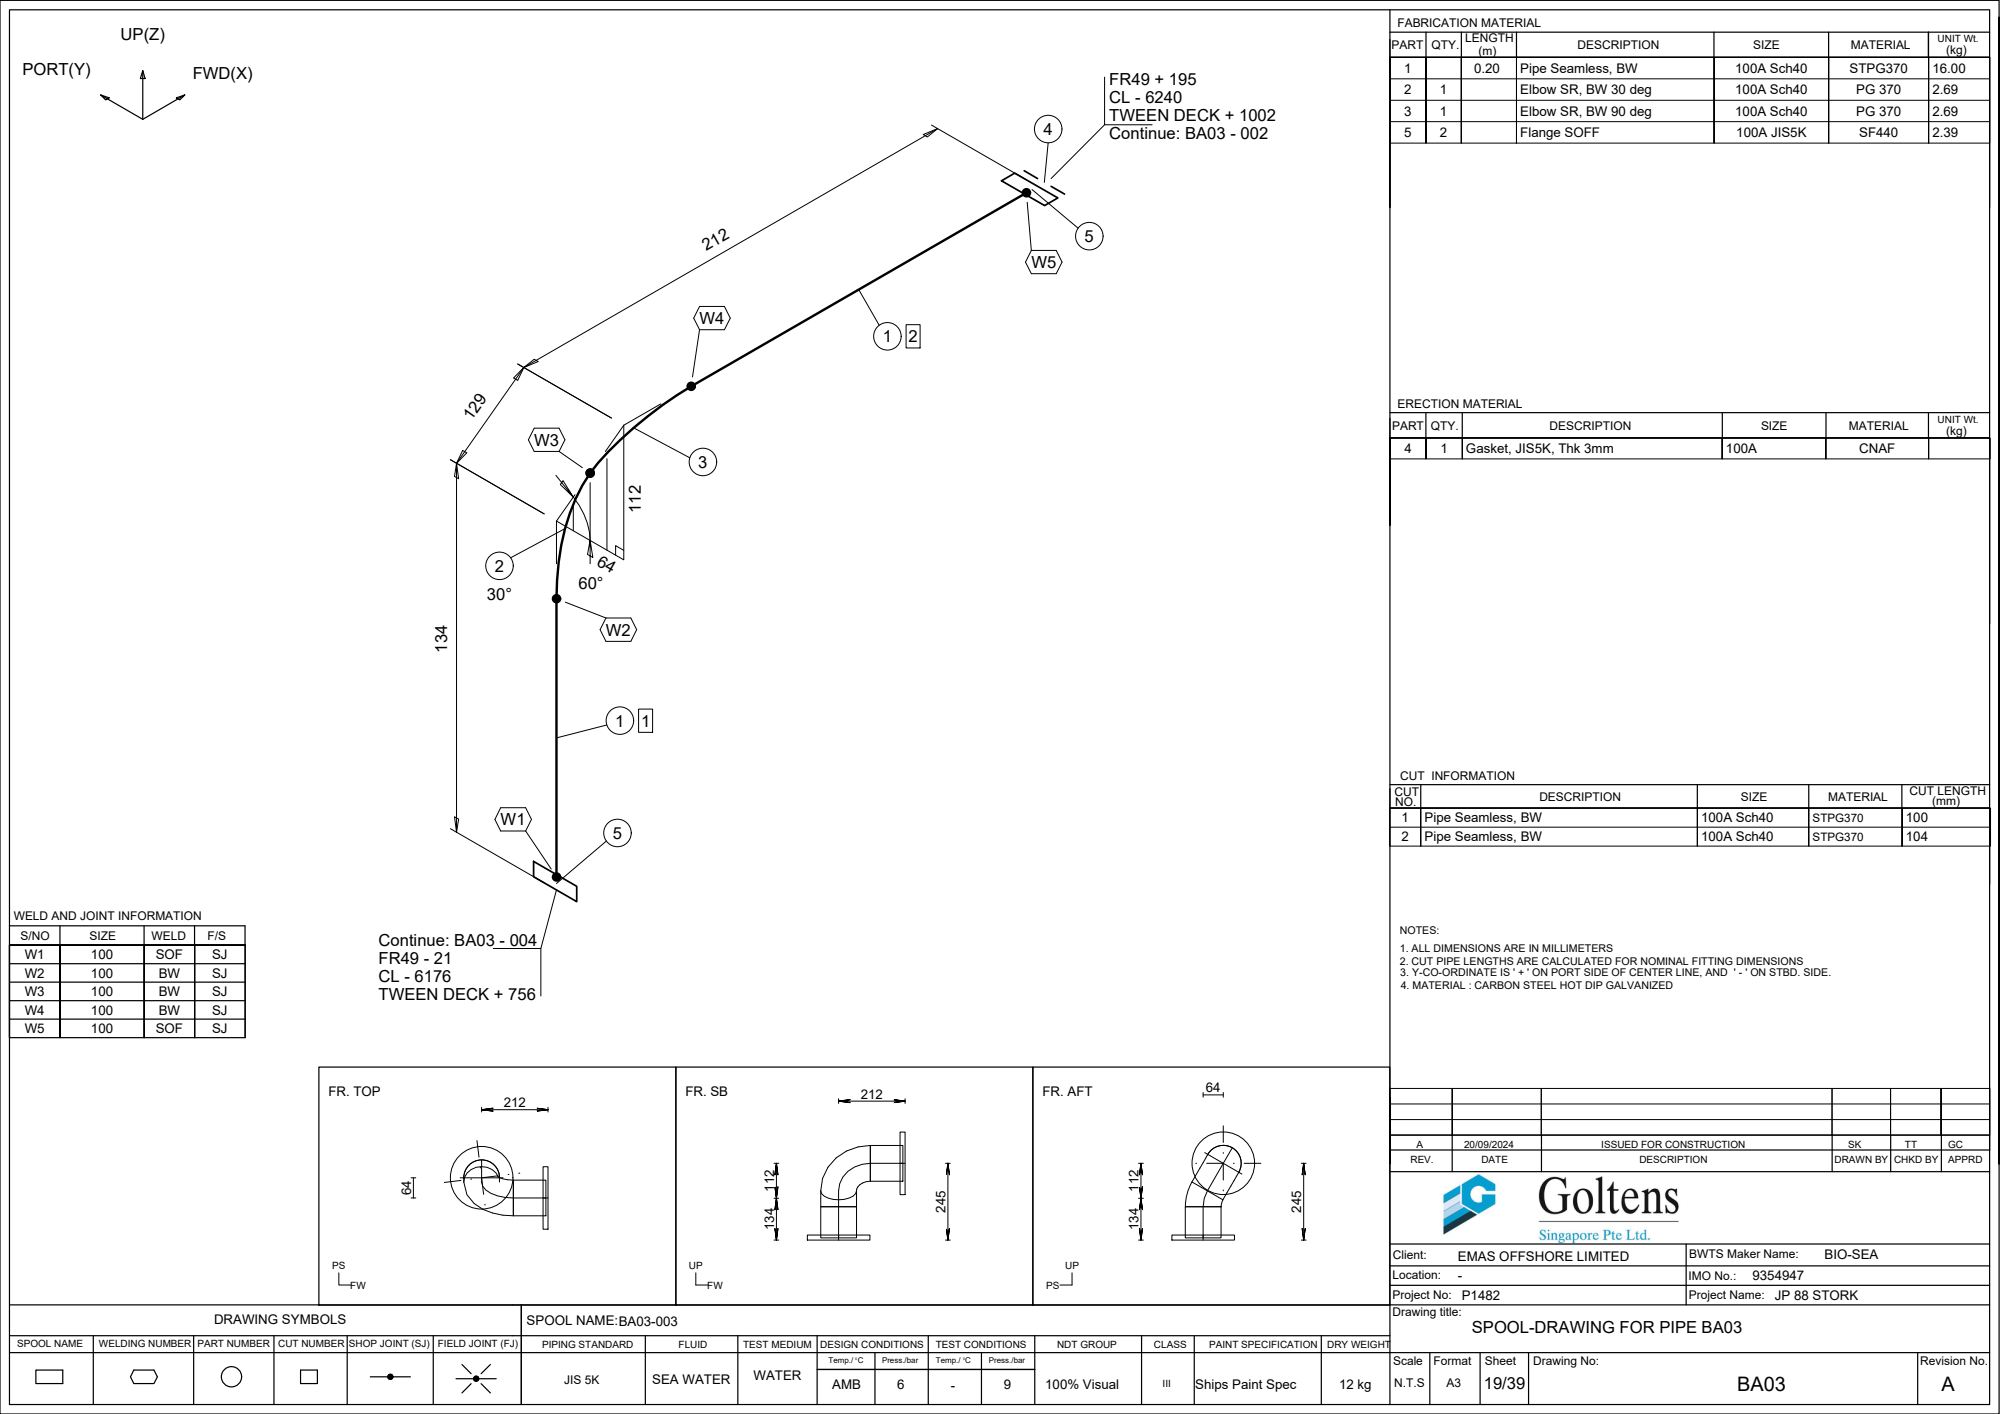
[picture p40: page 20]
FR. TOP; FR. AFT; AMB; Flange SOFF; 100A JIS5K; Gasket, JIS5K, Thk 3mm; CNAF; SOF; Pipe Seamless, BW; 100A Sch40; STPG370; REV.; DATE; DESCRIPTION; DRAWN BY; CHKD BY; APPRD; Location:; Client:; ERECTION MATERIAL; CUT INFORMATION; SIZE; WELD; PART; QTY.; MATERIAL; ISSUED FOR CONSTRUCTION; FR49 - 21 CL - 6176 TWEEN DECK + 756; Continue: BA03 - 004; Continue: BA03 - 002

1 | | 0.20 | Pipe Seamless, BW | 100A Sch40 | STPG370 | 16.00
2 | 1 | | Elbow SR, BW 30 deg | 100A Sch40 | PG 370 | 2.69
3 | 1 | | Elbow SR, BW 90 deg | 100A Sch40 | PG 370 | 2.69

UNIT Wt. (kg)

CUT NO. | DESCRIPTION | SIZE | MATERIAL | CUT LENGTH (mm)

1 | Pipe Seamless, BW | 100A Sch40 | STPG370 | 100

WELD AND JOINT INFORMATION

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

W1 | 100 | SOF | SJ
W2 | 100 | BW | SJ
W3 | 100 | BW | SJ
W4 | 100 | BW | SJ

- BIO-SEA
EMAS OFFSHORE LIMITED

BWTS Maker Name:

IMO No.: NDT GROUP

### TWEEN DECK + 756

FR49 - 21

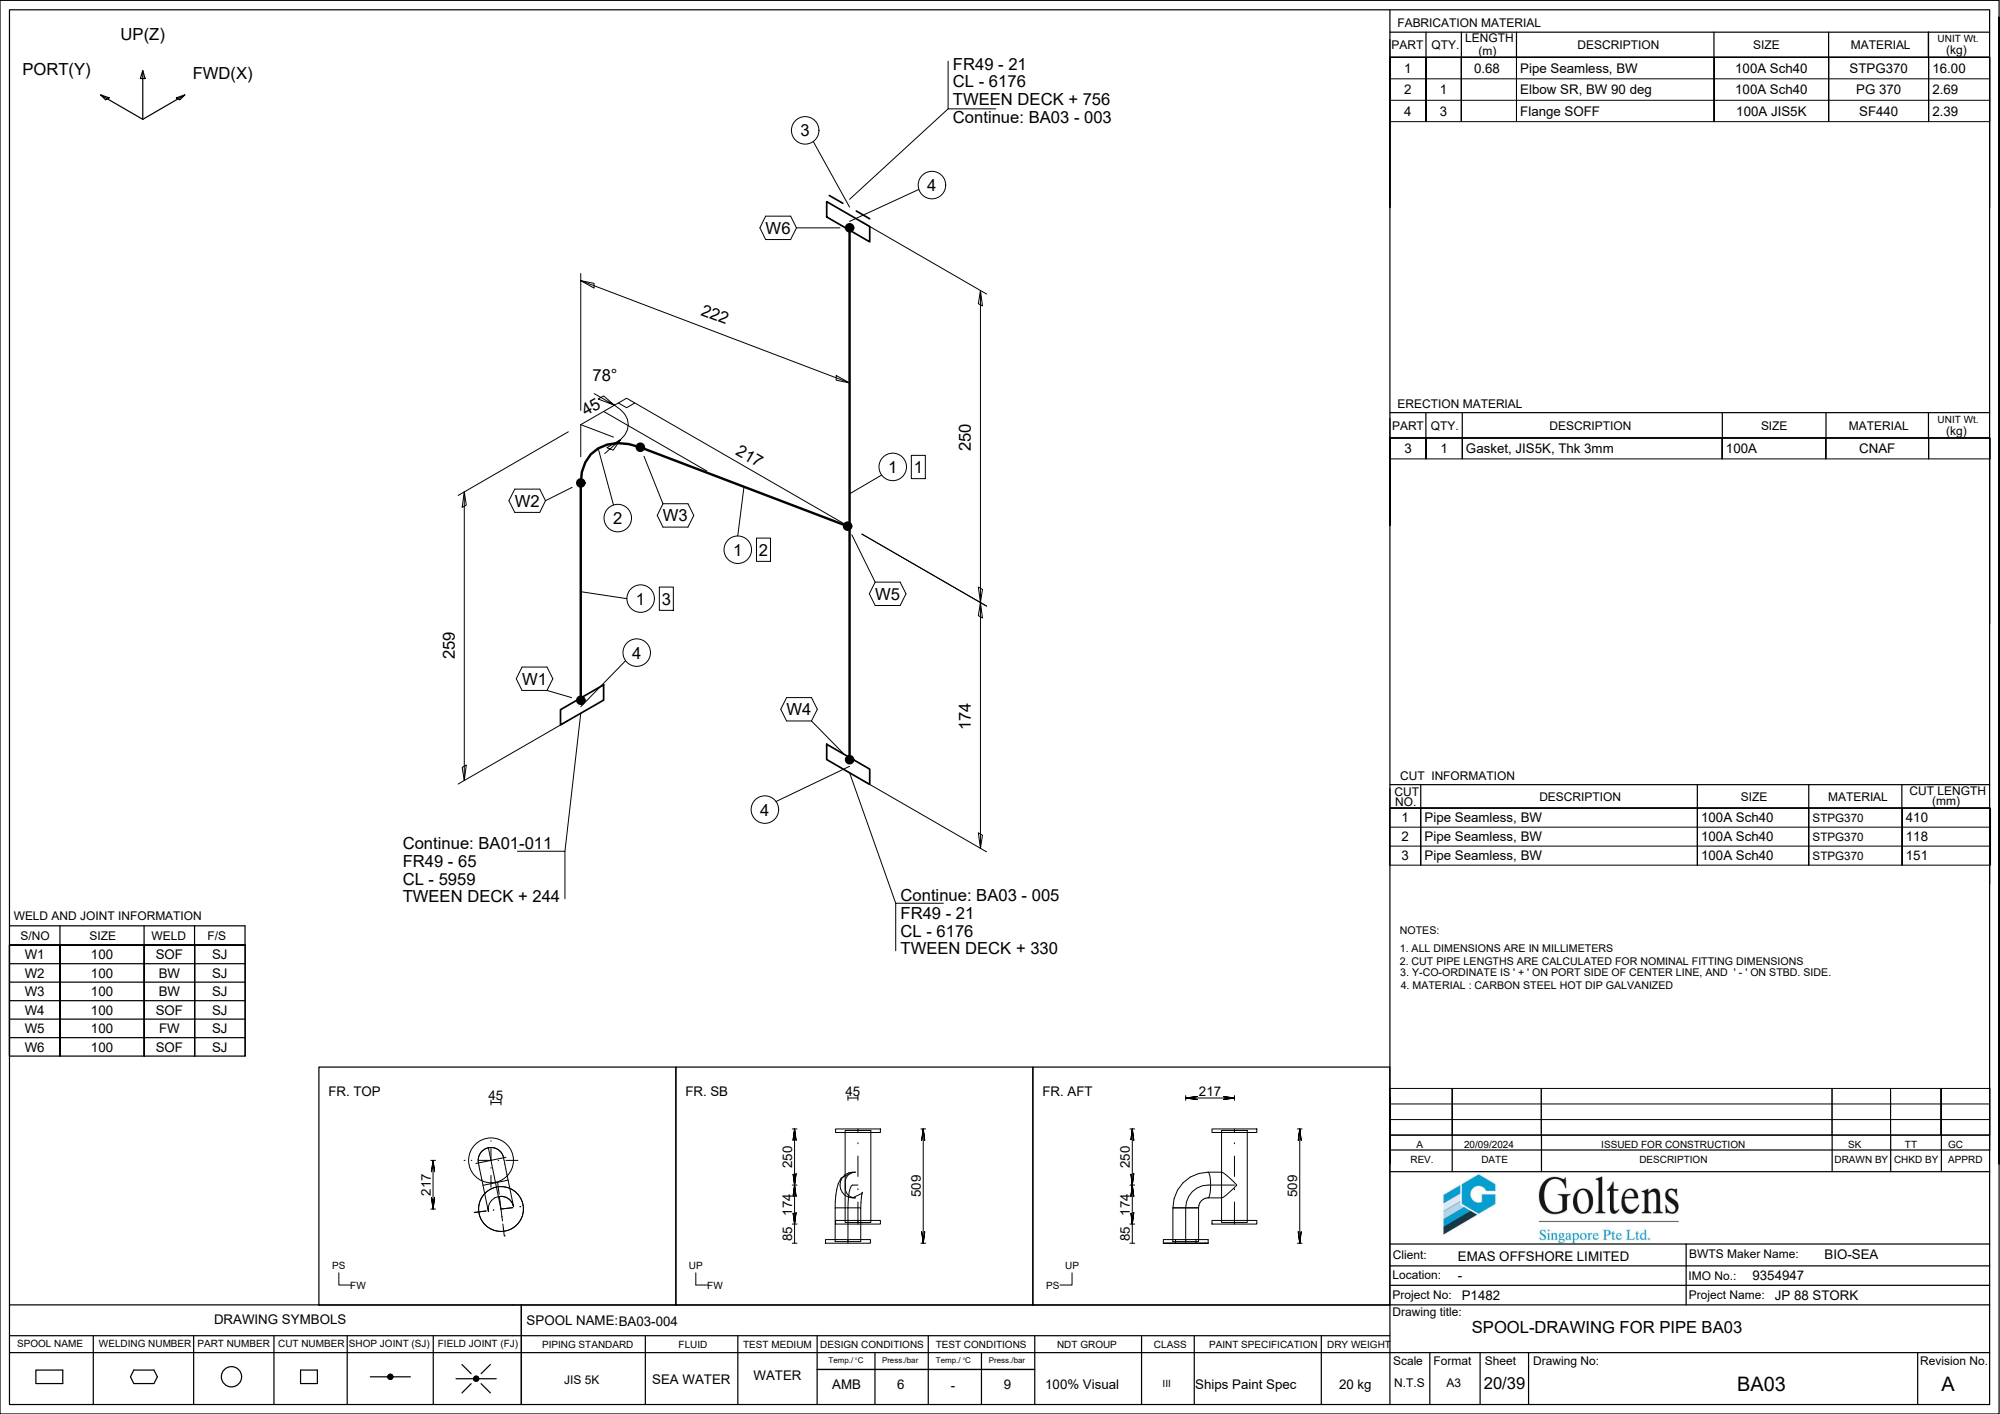
[picture p41: page 21]
217 45 FR. TOP; FR. AFT; AMB; Flange SOFF; 100A JIS5K; Gasket, JIS5K, Thk 3mm; CNAF; SOF; Pipe Seamless, BW; 100A Sch40; STPG370; REV.; DATE; DESCRIPTION; DRAWN BY; CHKD BY; APPRD; Location:; Client:; ERECTION MATERIAL; CUT INFORMATION; SIZE; WELD; PART; QTY.; MATERIAL; ISSUED FOR CONSTRUCTION; Continue: BA03 - 003; FR49 - 65 CL - 5959 TWEEN DECK + 244; Continue: BA01-011; FR49 - 21 CL - 6176 TWEEN DECK + 330; Continue: BA03 - 005

1 | | 0.68 | Pipe Seamless, BW | 100A Sch40 | STPG370 | 16.00
2 | 1 | | Elbow SR, BW 90 deg | 100A Sch40 | PG 370 | 2.69

UNIT Wt. (kg)

CUT NO. | DESCRIPTION | SIZE | MATERIAL | CUT LENGTH (mm)

1 | Pipe Seamless, BW | 100A Sch40 | STPG370 | 410
2 | Pipe Seamless, BW | 100A Sch40 | STPG370 | 118

WELD AND JOINT INFORMATION

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

W1 | 100 | SOF | SJ
W2 | 100 | BW | SJ
W3 | 100 | BW | SJ
W4 | 100 | SOF | SJ
W5 | 100 | FW | SJ

- BIO-SEA
EMAS OFFSHORE LIMITED

BWTS Maker Name:

IMO No.: NDT GROUP

### TWEEN DECK + 167

CL - 6176

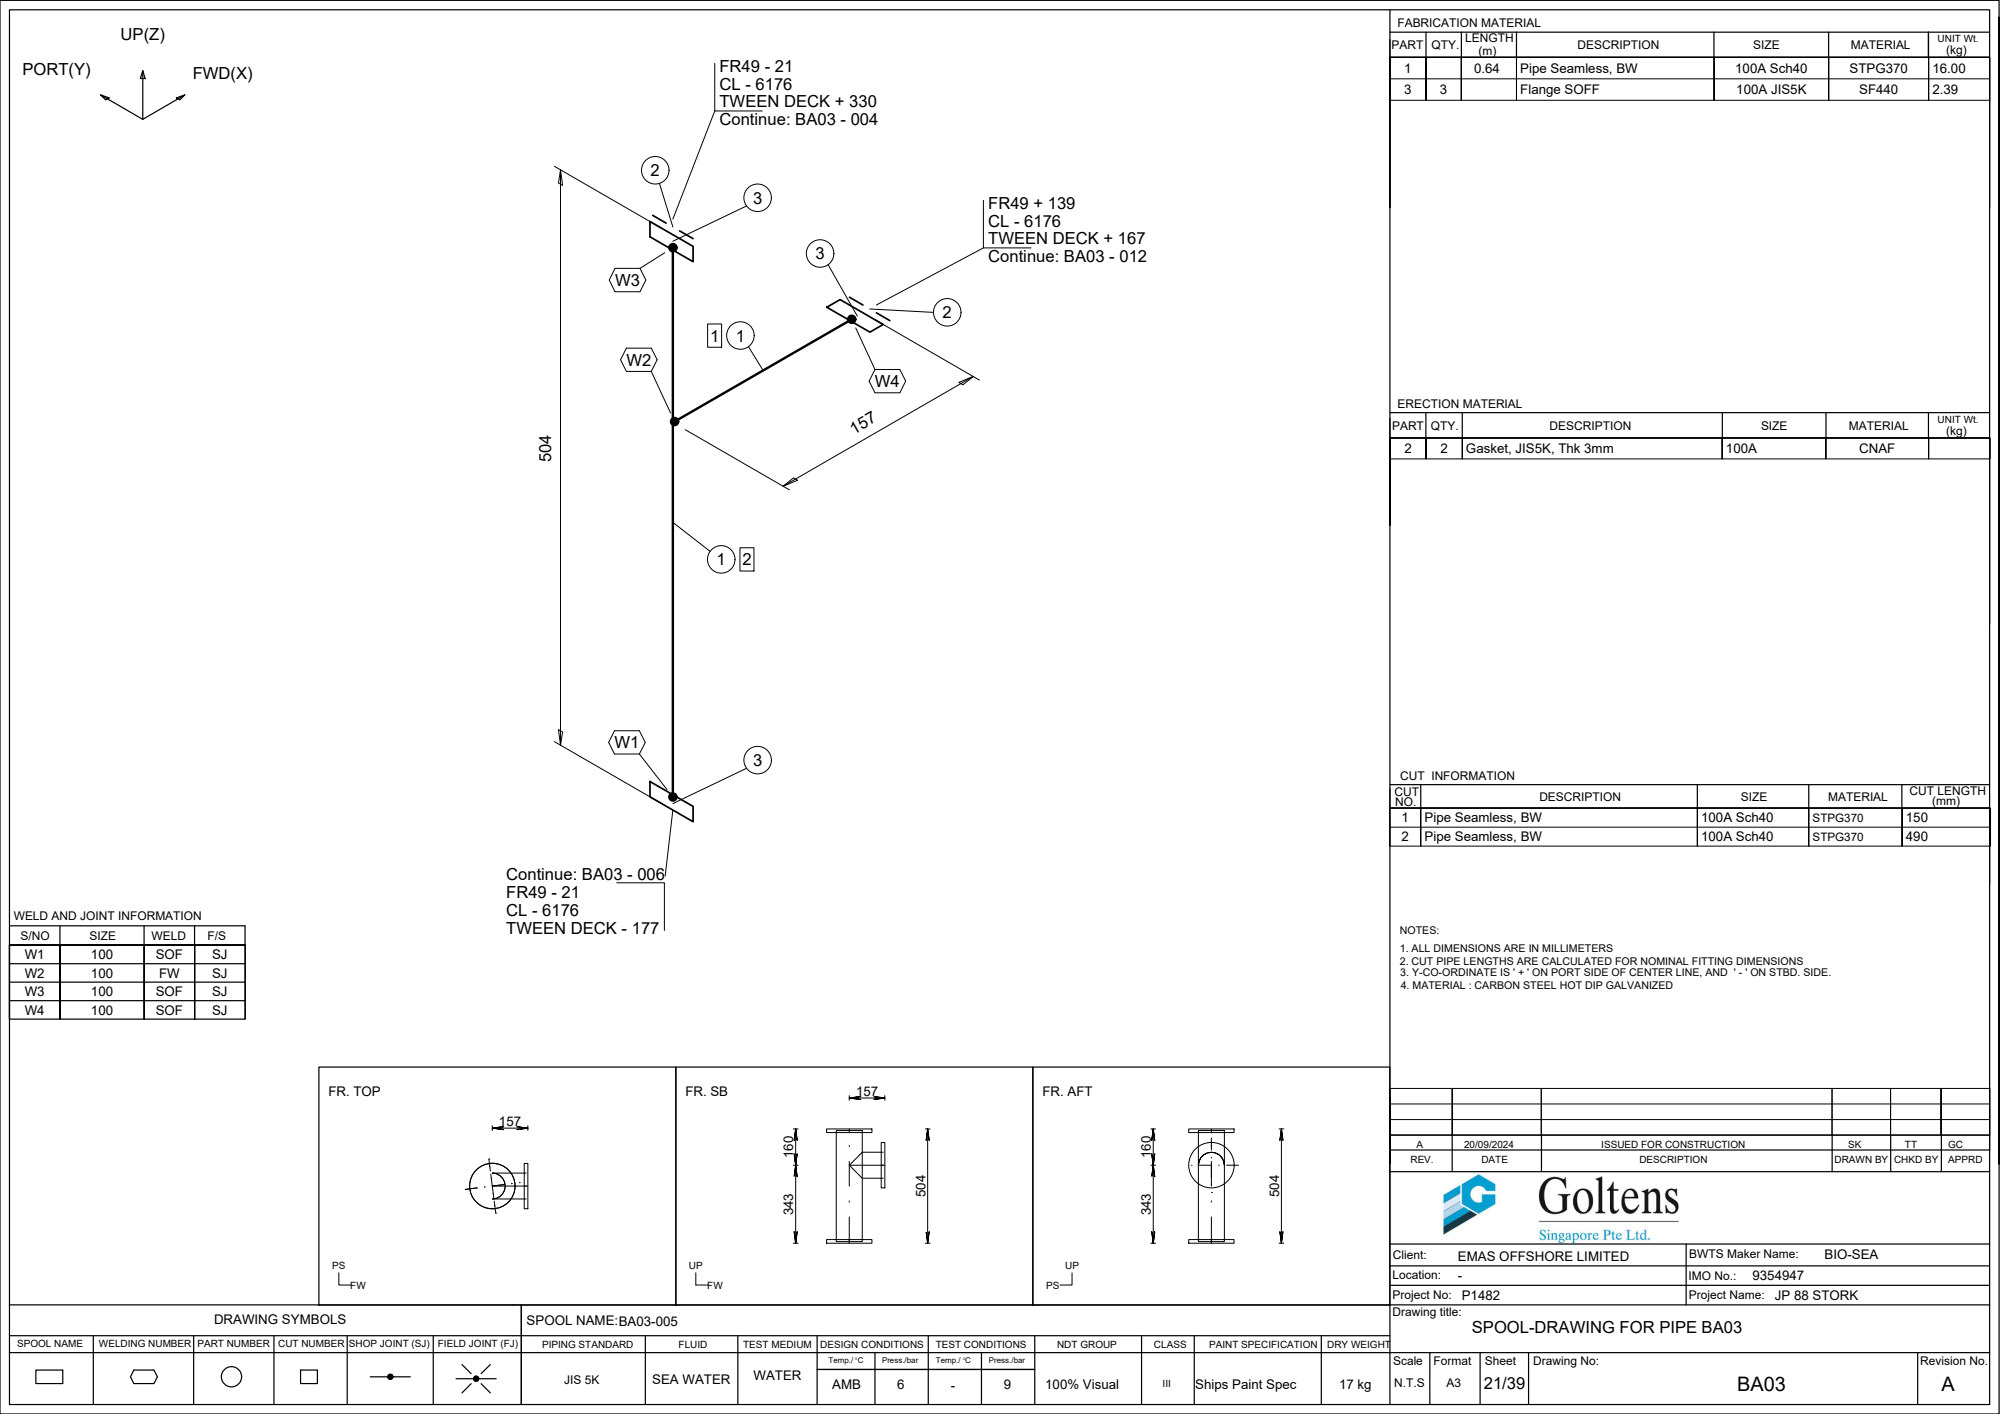
[picture p42: page 22]
FR. TOP; FR. AFT; AMB; Pipe Seamless, BW; 100A Sch40; STPG370; Flange SOFF; 100A JIS5K; Gasket, JIS5K, Thk 3mm; CNAF; SOF; REV.; DATE; DESCRIPTION; DRAWN BY; CHKD BY; APPRD; Location:; Client:; ERECTION MATERIAL; CUT INFORMATION; SIZE; WELD; PART; QTY.; MATERIAL; ISSUED FOR CONSTRUCTION; FR49 - 21 CL - 6176 TWEEN DECK - 177; Continue: BA03 - 006; Continue: BA03 - 012; TWEEN DECK + 330; Continue: BA03 - 004

UNIT Wt. (kg)

4. MATERIAL : CARBON STEEL HOT DIP GALVANIZED 504

CUT NO. | DESCRIPTION | SIZE | MATERIAL | CUT LENGTH (mm)

1 | Pipe Seamless, BW | 100A Sch40 | STPG370 | 150

WELD AND JOINT INFORMATION

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

W1 | 100 | SOF | SJ
W2 | 100 | FW | SJ
W3 | 100 | SOF | SJ

- BIO-SEA
EMAS OFFSHORE LIMITED

BWTS Maker Name:

IMO No.: NDT GROUP

### FWD(X)

PORT(Y) | 514 | 514

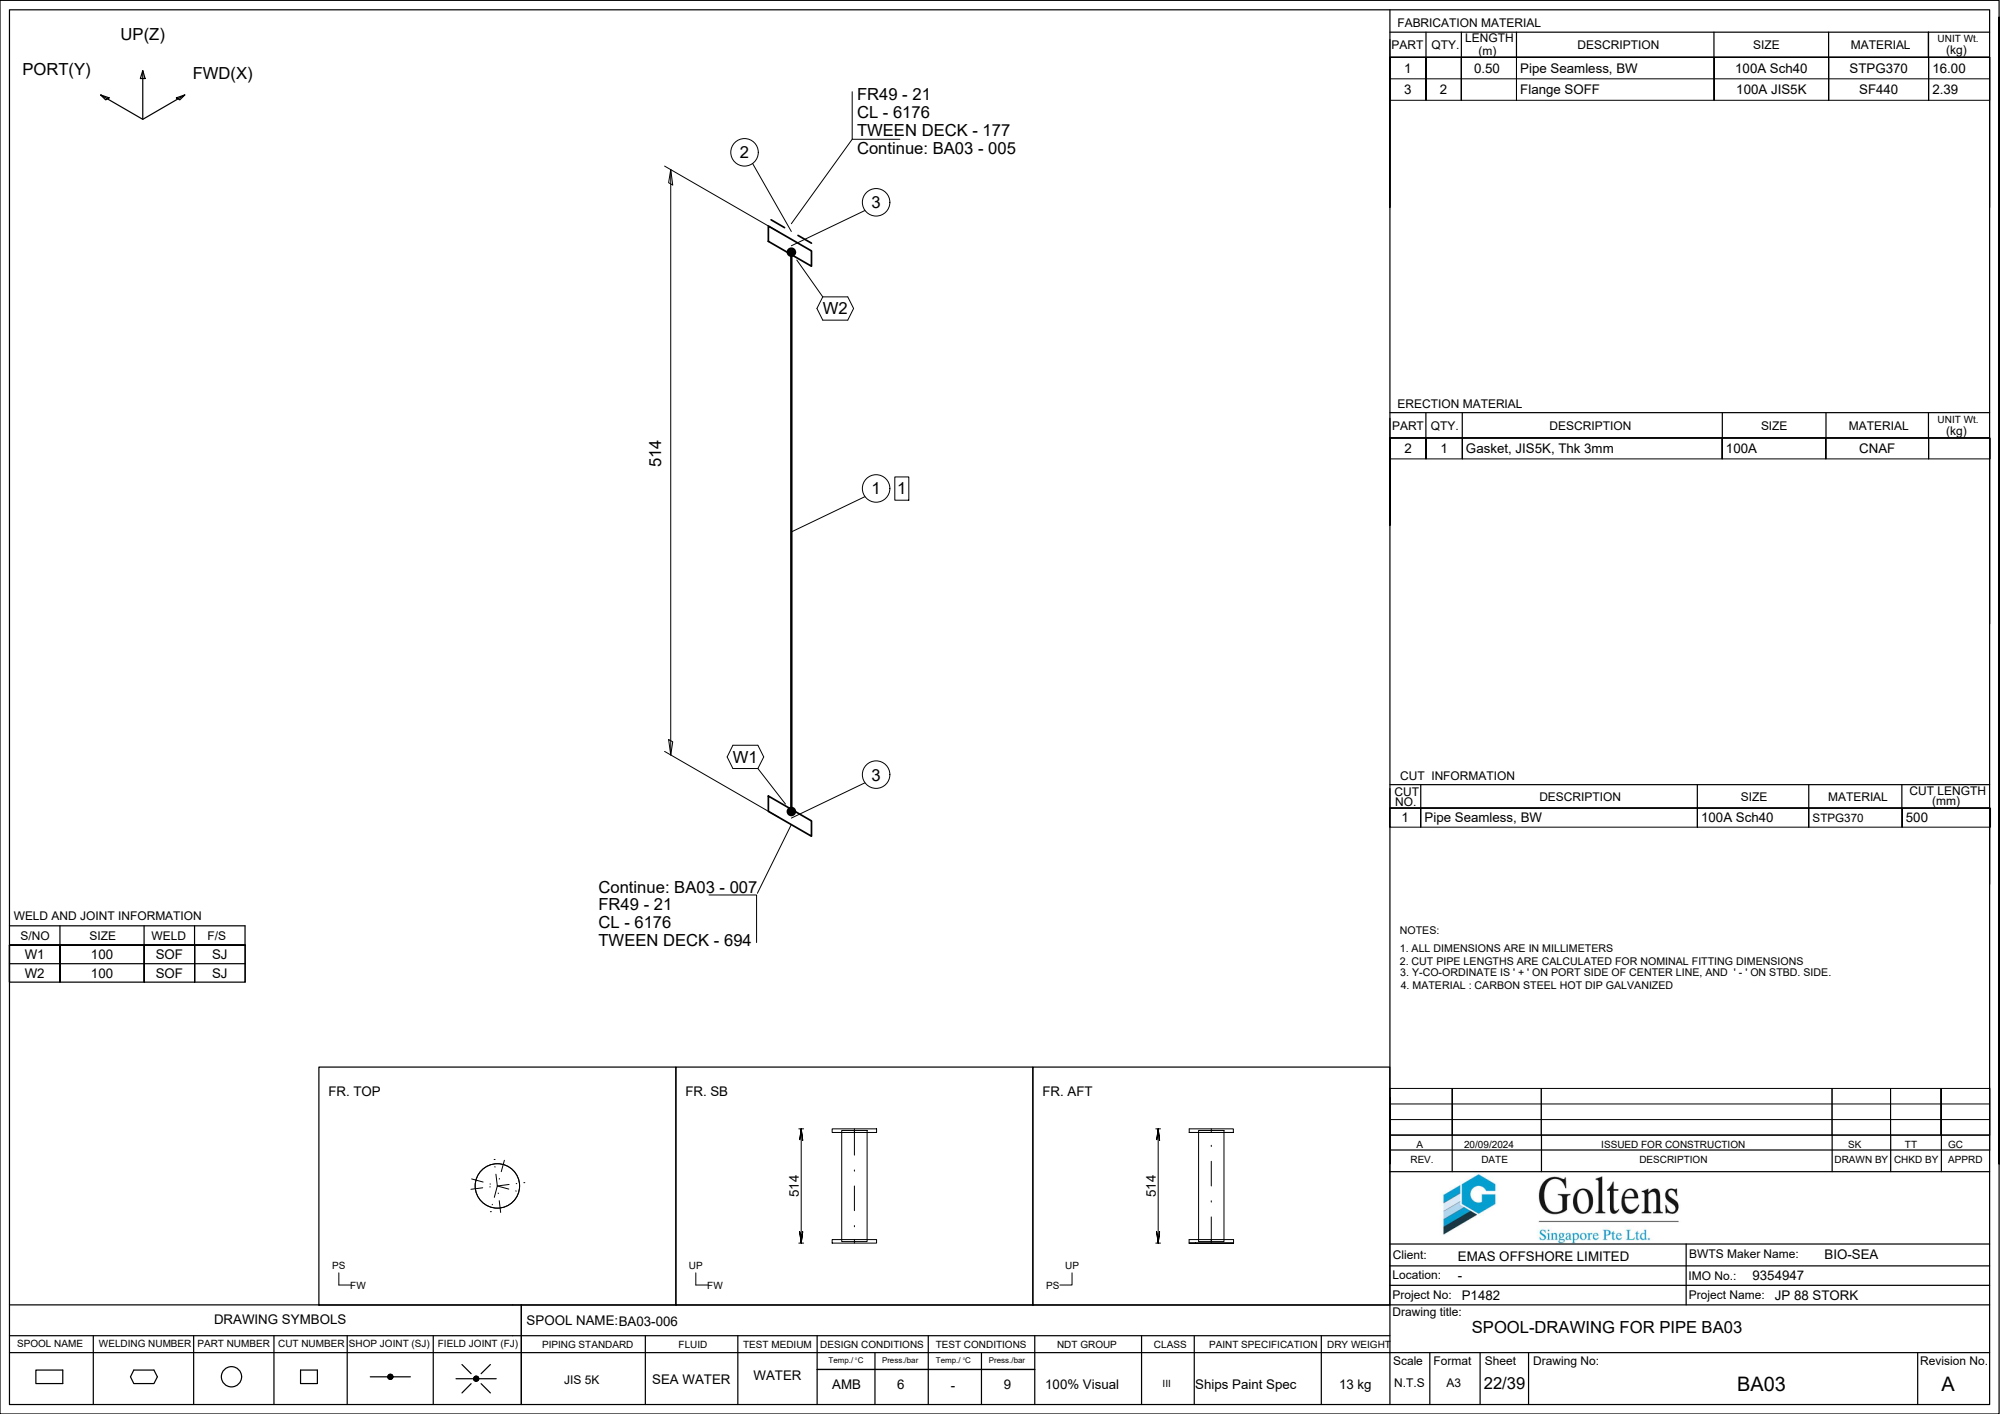
[picture p43: page 23]
FR. TOP; FR. AFT; AMB; Pipe Seamless, BW; 100A Sch40; STPG370; Flange SOFF; 100A JIS5K; Gasket, JIS5K, Thk 3mm; CNAF; SOF; REV.; DATE; DESCRIPTION; DRAWN BY; CHKD BY; APPRD; Location:; Client:; ERECTION MATERIAL; CUT INFORMATION; SIZE; WELD; PART; QTY.; MATERIAL; ISSUED FOR CONSTRUCTION; FR49 - 21 CL - 6176 TWEEN DECK - 694; Continue: BA03 - 007; TWEEN DECK - 177; Continue: BA03 - 005

UNIT Wt. (kg)

4. MATERIAL : CARBON STEEL HOT DIP GALVANIZED 514

CUT NO. | DESCRIPTION | SIZE | MATERIAL | CUT LENGTH (mm)

1 | Pipe Seamless, BW | 100A Sch40 | STPG370 | 500

WELD AND JOINT INFORMATION

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

- BIO-SEA
EMAS OFFSHORE LIMITED

BWTS Maker Name:

IMO No.: NDT GROUP

### TWEEN DECK - 694

FR49 - 21

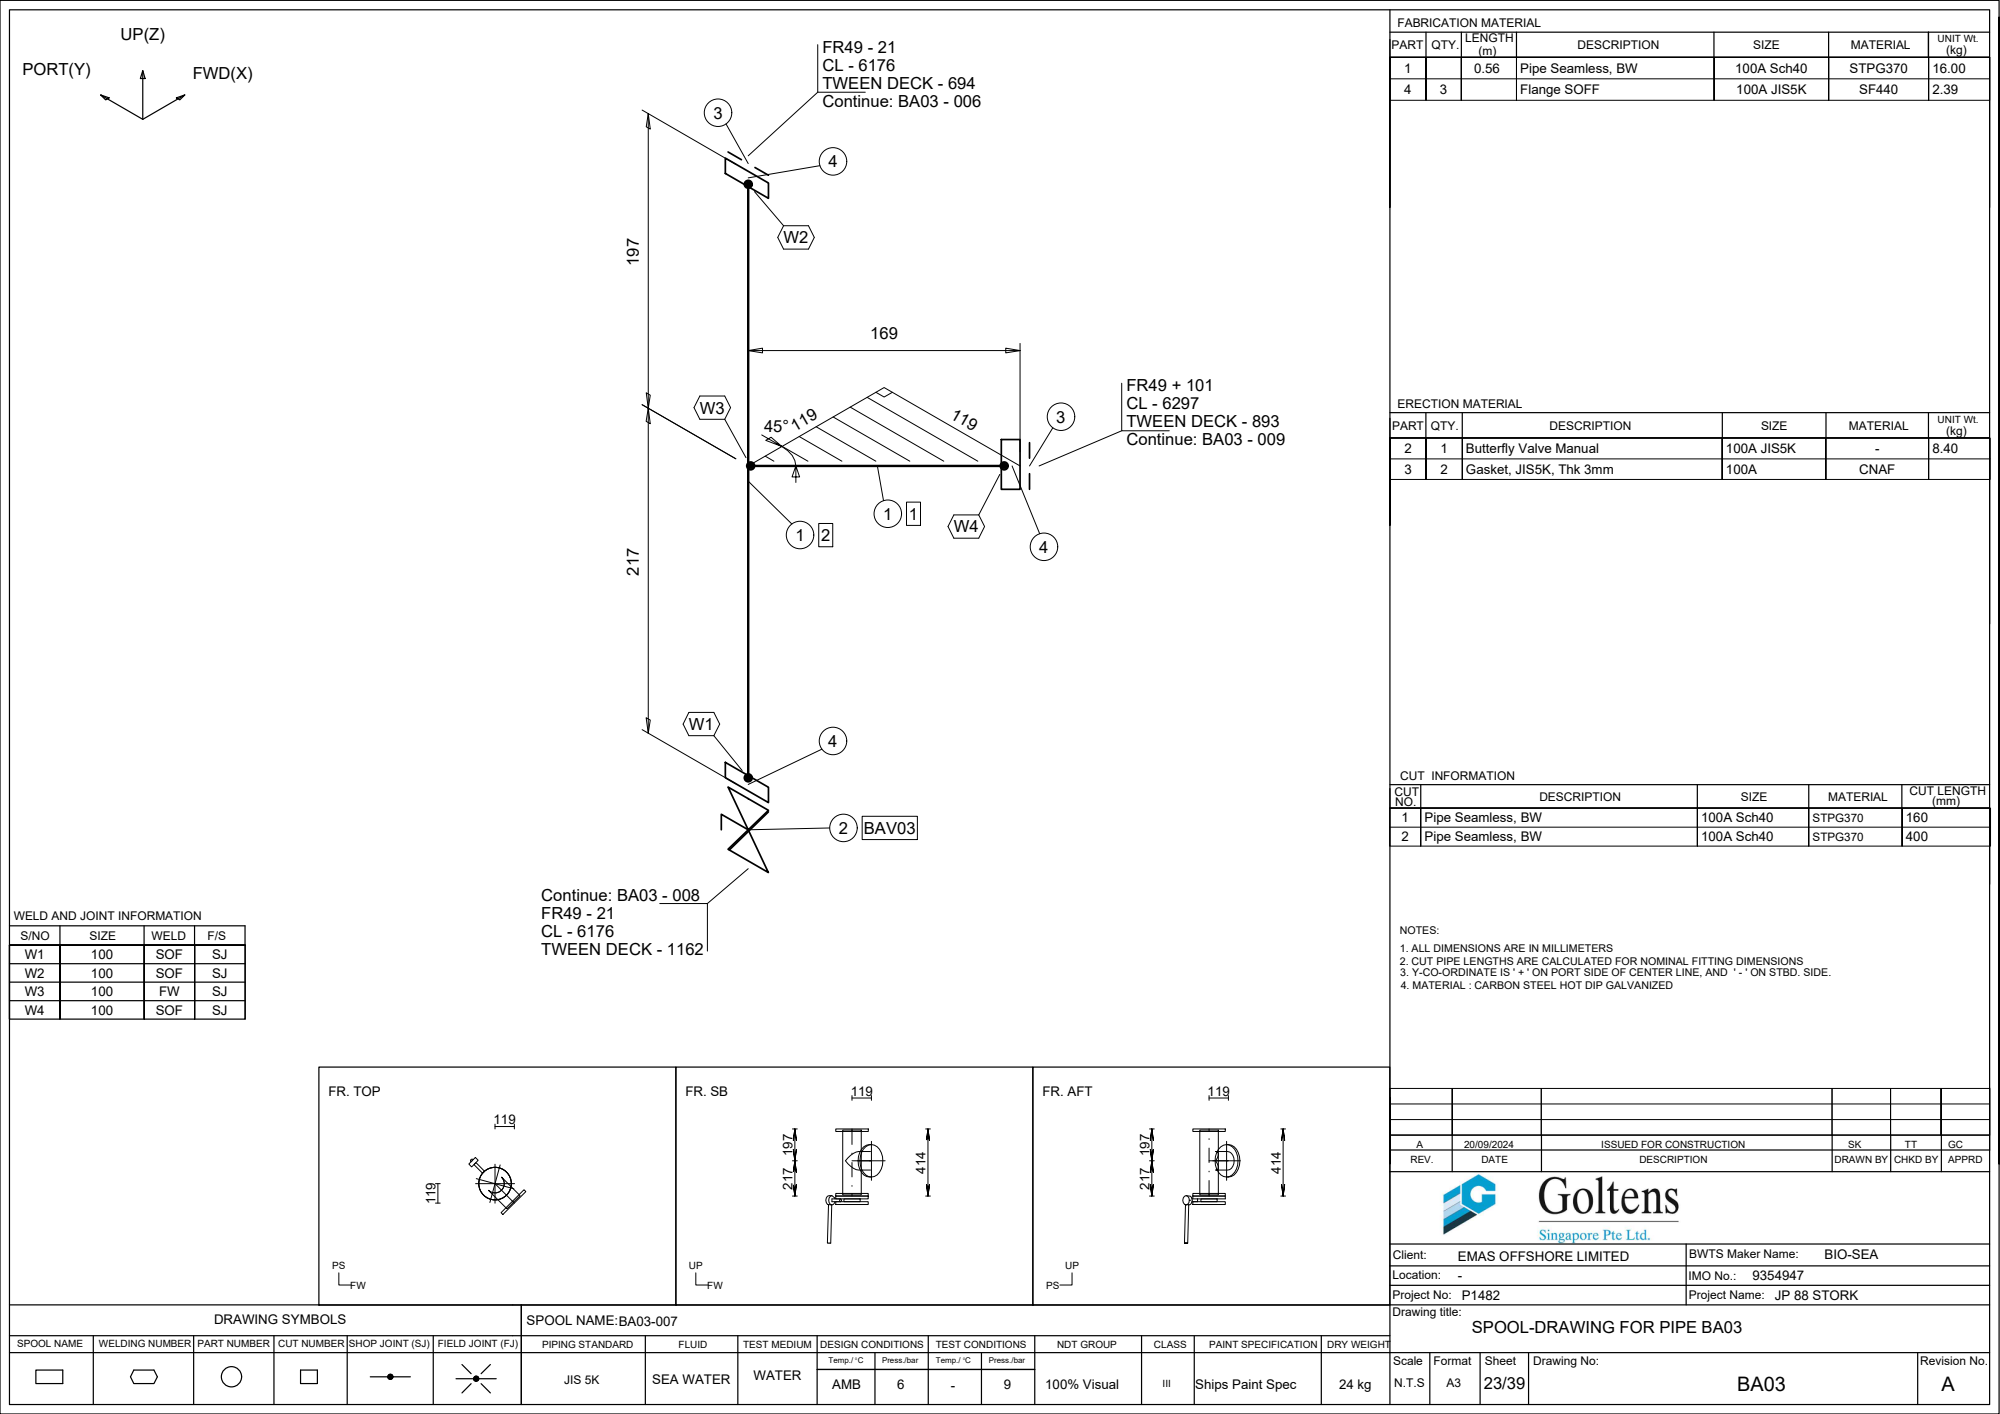
[picture p44: page 24]
FR. TOP; FR. AFT; AMB; Pipe Seamless, BW; 100A Sch40; STPG370; Flange SOFF; 100A JIS5K; Gasket, JIS5K, Thk 3mm; CNAF; SOF; REV.; DATE; DESCRIPTION; DRAWN BY; CHKD BY; APPRD; Location:; Client:; ERECTION MATERIAL; CUT INFORMATION; SIZE; WELD; ISSUED FOR CONSTRUCTION; TWEEN DECK - 893; Continue: BA03 - 009; Continue: BA03 - 006; FR49 - 21 CL - 6176 TWEEN DECK - 1162; Continue: BA03 - 008; BAV03

PART | QTY. | DESCRIPTION | SIZE | MATERIAL | UNIT Wt. (kg)

2 | 1 | Butterfly Valve Manual | 100A JIS5K | - | 8.40

CUT NO. | DESCRIPTION | SIZE | MATERIAL | CUT LENGTH (mm)

1 | Pipe Seamless, BW | 100A Sch40 | STPG370 | 160

WELD AND JOINT INFORMATION

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

W1 | 100 | SOF | SJ
W2 | 100 | SOF | SJ
W3 | 100 | FW | SJ

- BIO-SEA
EMAS OFFSHORE LIMITED

BWTS Maker Name:

IMO No.: NDT GROUP

### TWEEN DECK - 1162

FR49 - 21

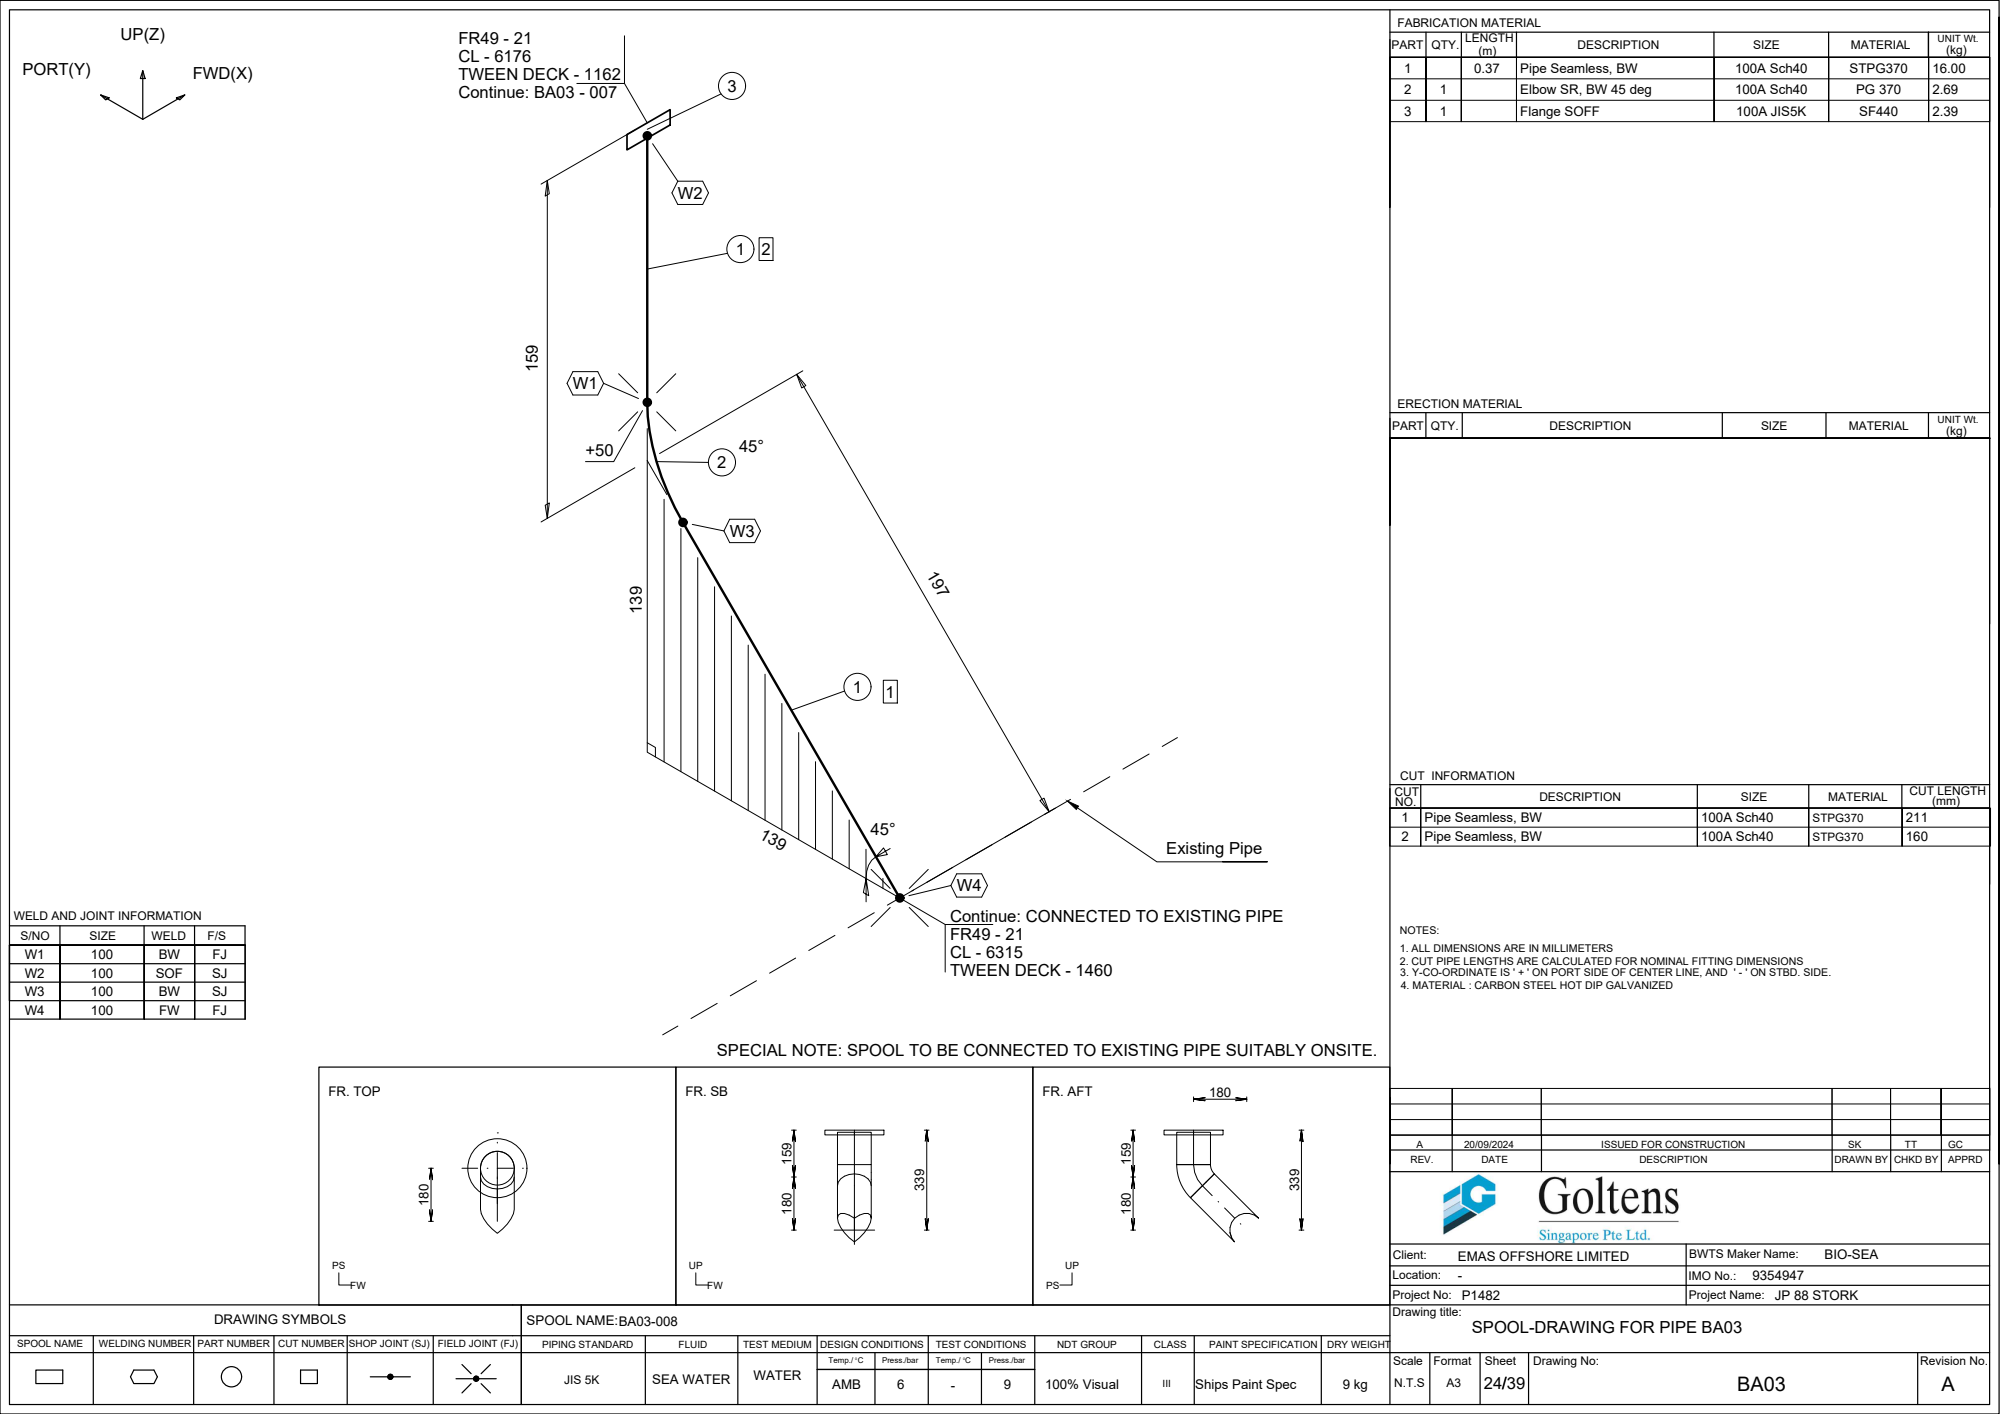
[picture p45: page 25]
FR. TOP; FR. AFT; AMB; Flange SOFF; 100A JIS5K; Pipe Seamless, BW; 100A Sch40; STPG370; REV.; DATE; DESCRIPTION; DRAWN BY; CHKD BY; APPRD; Location:; Client:; ERECTION MATERIAL; CUT INFORMATION; SIZE; WELD; PART; QTY.; MATERIAL; ISSUED FOR CONSTRUCTION; Continue: BA03 - 007; Existing Pipe

1 | | 0.37 | Pipe Seamless, BW | 100A Sch40 | STPG370 | 16.00
2 | 1 | | Elbow SR, BW 45 deg | 100A Sch40 | PG 370 | 2.69

UNIT Wt. (kg)

CUT NO. | DESCRIPTION | SIZE | MATERIAL | CUT LENGTH (mm)

1 | Pipe Seamless, BW | 100A Sch40 | STPG370 | 211

WELD AND JOINT INFORMATION

Continue: CONNECTED TO EXISTING PIPE
TWEEN DECK - 1460

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

W1 | 100 | BW | FJ
W2 | 100 | SOF | SJ
W3 | 100 | BW | SJ

SPECIAL NOTE: SPOOL TO BE CONNECTED TO EXISTING PIPE SUITABLY ONSITE.

- BIO-SEA
EMAS OFFSHORE LIMITED

BWTS Maker Name:

IMO No.: NDT GROUP

### TWEEN DECK - 893

CL - 6332

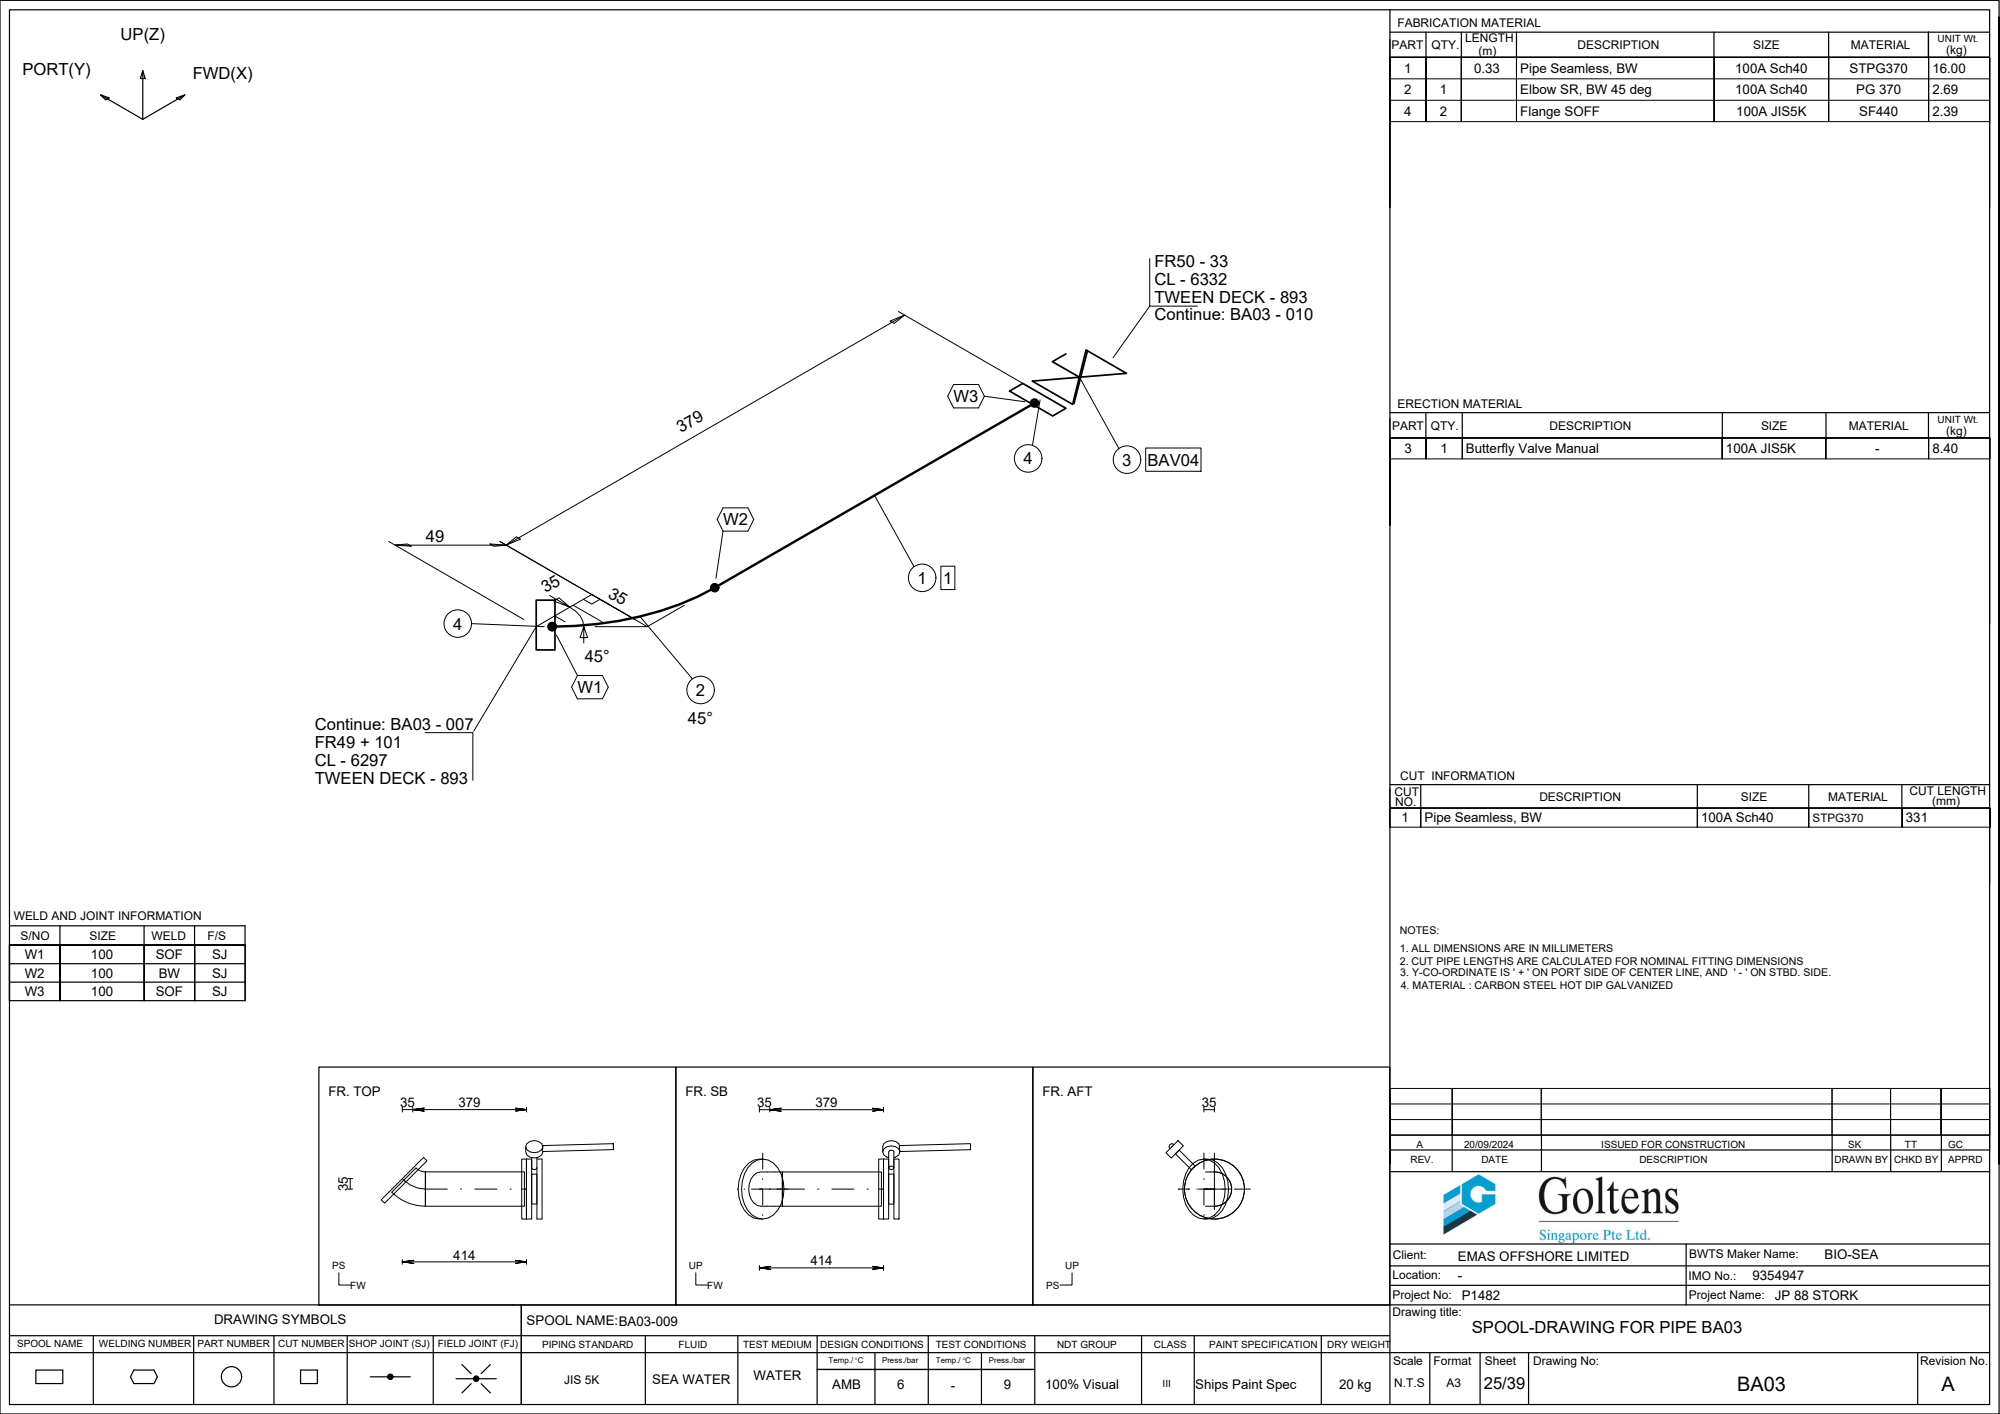
[picture p46: page 26]
FR. TOP; FR. AFT; AMB; Flange SOFF; 100A JIS5K; Butterfly Valve Manual; SOF; REV.; DATE; DESCRIPTION; DRAWN BY; CHKD BY; APPRD; Location:; Client:; ERECTION MATERIAL; CUT INFORMATION; SIZE; WELD; PART; QTY.; MATERIAL; ISSUED FOR CONSTRUCTION; FR49 + 101 CL - 6297 TWEEN DECK - 893; Continue: BA03 - 007; Continue: BA03 - 010; BAV04

1 | | 0.33 | Pipe Seamless, BW | 100A Sch40 | STPG370 | 16.00
2 | 1 | | Elbow SR, BW 45 deg | 100A Sch40 | PG 370 | 2.69

UNIT Wt. (kg)

CUT NO. | DESCRIPTION | SIZE | MATERIAL | CUT LENGTH (mm)

1 | Pipe Seamless, BW | 100A Sch40 | STPG370 | 331

WELD AND JOINT INFORMATION

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

W1 | 100 | SOF | SJ
W2 | 100 | BW | SJ

- BIO-SEA
EMAS OFFSHORE LIMITED

BWTS Maker Name:

IMO No.: NDT GROUP

### FWD(X)

### TWEEN DECK - 1218

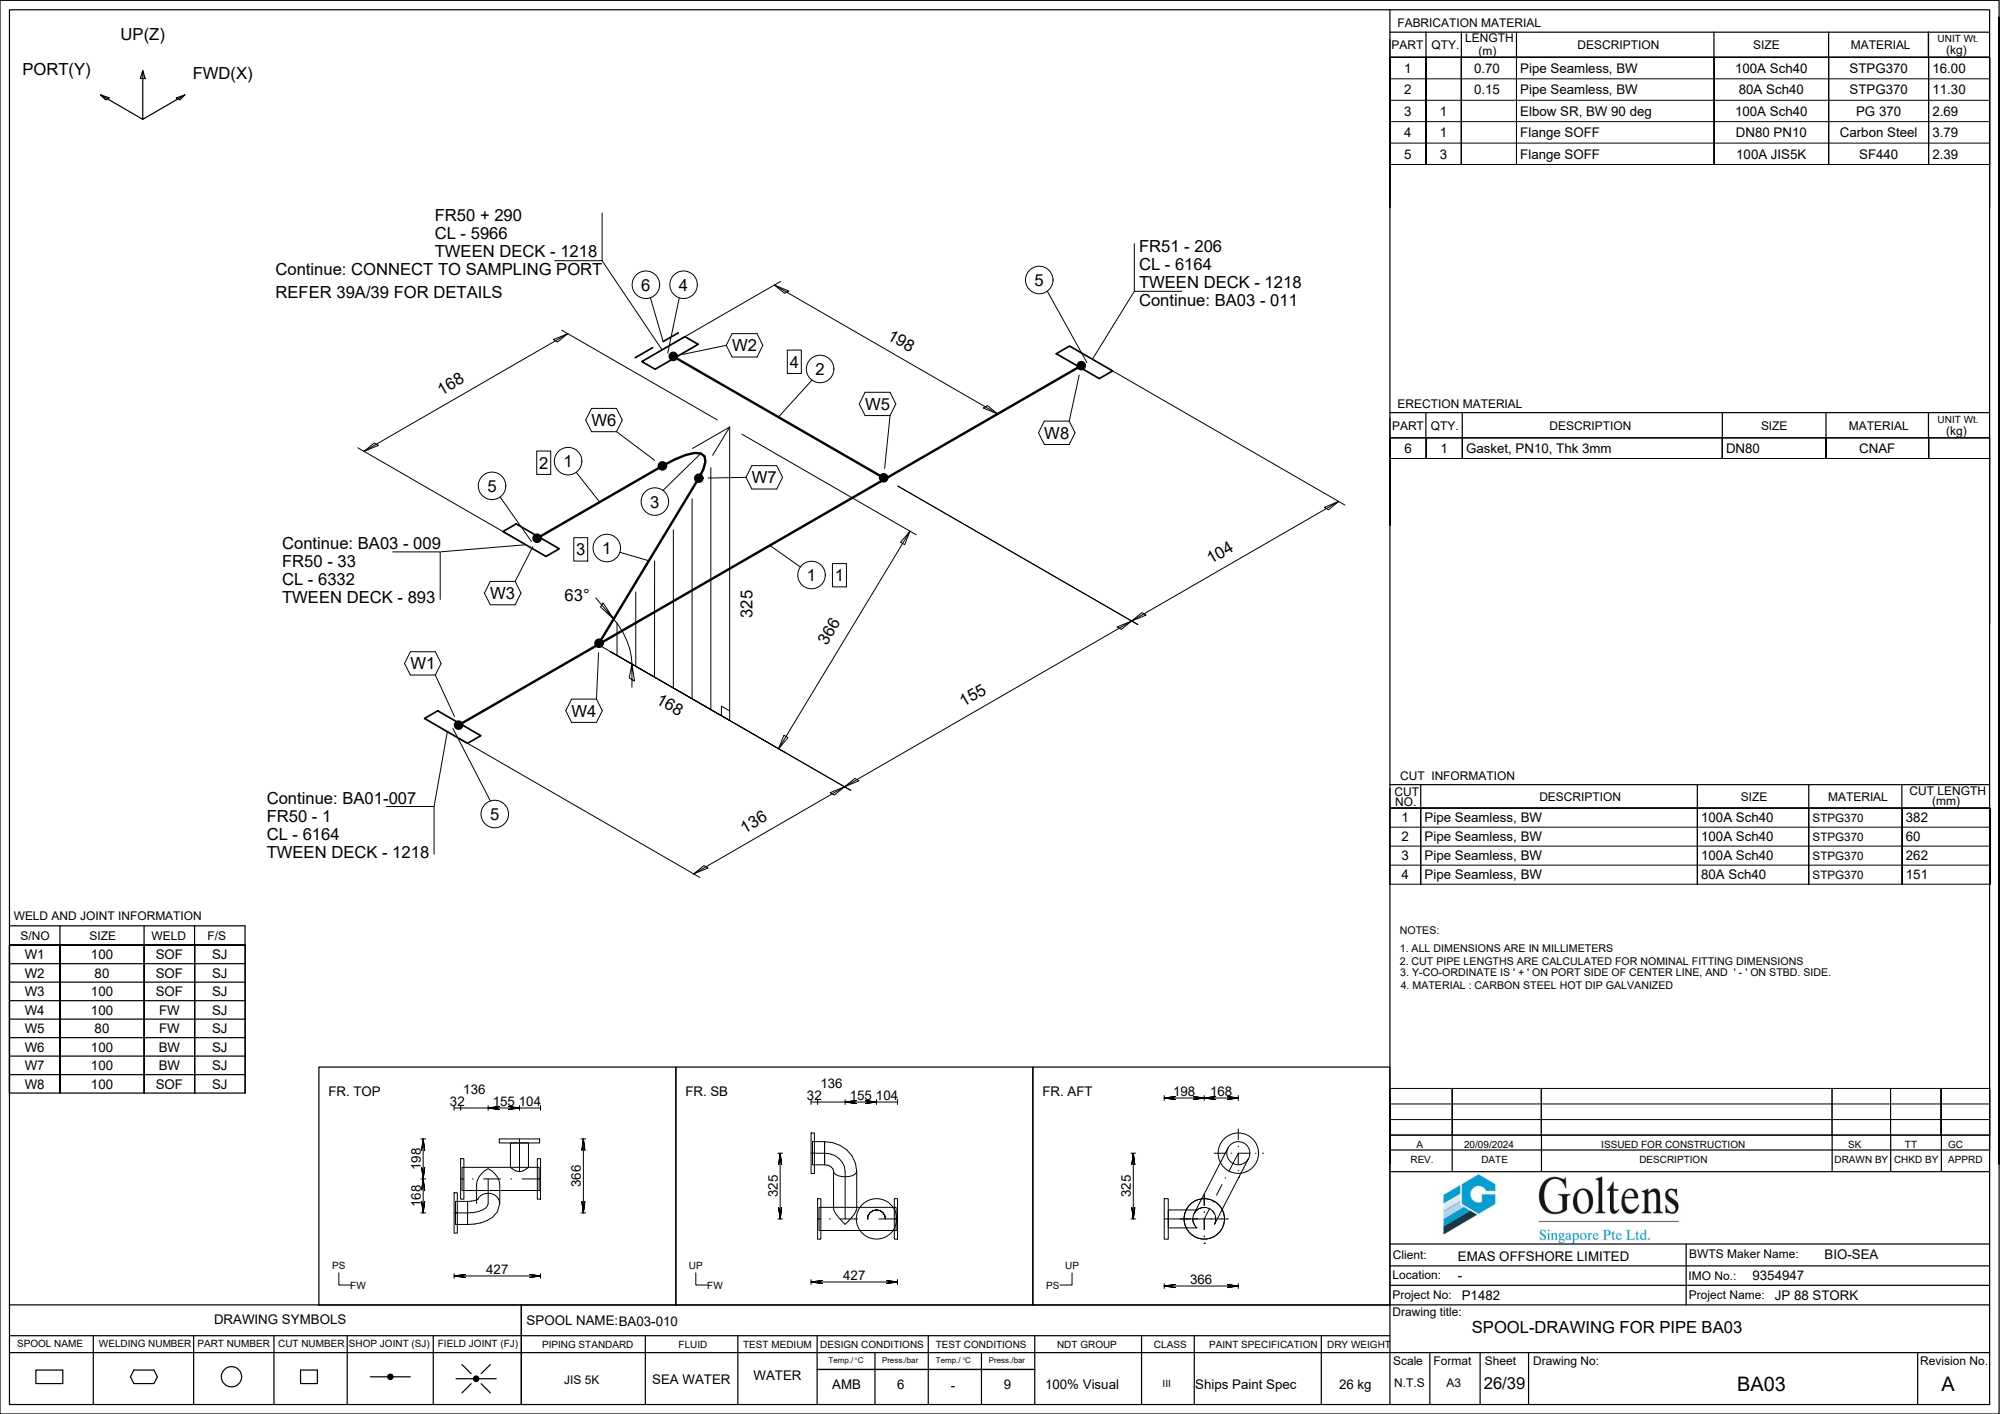
[picture p47: page 27]
PORT(Y); FR. TOP; FR. AFT; AMB; Flange SOFF; 100A JIS5K; SOF; Pipe Seamless, BW; 80A Sch40; STPG370; REV.; DATE; DESCRIPTION; DRAWN BY; CHKD BY; APPRD; Location:; Client:; ERECTION MATERIAL; CUT INFORMATION; SIZE; WELD; ISSUED FOR CONSTRUCTION; FR50 - 1 CL - 6164 TWEEN DECK - 1218; Continue: BA01-007; FR50 - 33 CL - 6332 TWEEN DECK - 893; Continue: BA03 - 009; TWEEN DECK - 1218; Continue: BA03 - 011; REFER 39A/39 FOR DETAILS

1 | | 0.70 | Pipe Seamless, BW | 100A Sch40 | STPG370 | 16.00
2 | | 0.15 | Pipe Seamless, BW | 80A Sch40 | STPG370 | 11.30
3 | 1 | | Elbow SR, BW 90 deg | 100A Sch40 | PG 370 | 2.69
4 | 1 | | Flange SOFF | DN80 PN10 | Carbon Steel | 3.79

Continue: CONNECT TO SAMPLING PORT

PART | QTY. | DESCRIPTION | SIZE | MATERIAL | UNIT Wt. (kg)

6 | 1 | Gasket, PN10, Thk 3mm | DN80 | CNAF

CUT NO. | DESCRIPTION | SIZE | MATERIAL | CUT LENGTH (mm)

1 | Pipe Seamless, BW | 100A Sch40 | STPG370 | 382
2 | Pipe Seamless, BW | 100A Sch40 | STPG370 | 60
3 | Pipe Seamless, BW | 100A Sch40 | STPG370 | 262

WELD AND JOINT INFORMATION

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

W1 | 100 | SOF | SJ
W2 | 80 | SOF | SJ
W3 | 100 | SOF | SJ
W4 | 100 | FW | SJ
W5 | 80 | FW | SJ
W6 | 100 | BW | SJ
W7 | 100 | BW | SJ

- BIO-SEA
EMAS OFFSHORE LIMITED

BWTS Maker Name:

IMO No.: NDT GROUP

### TWEEN DECK - 1218

CL - 6164

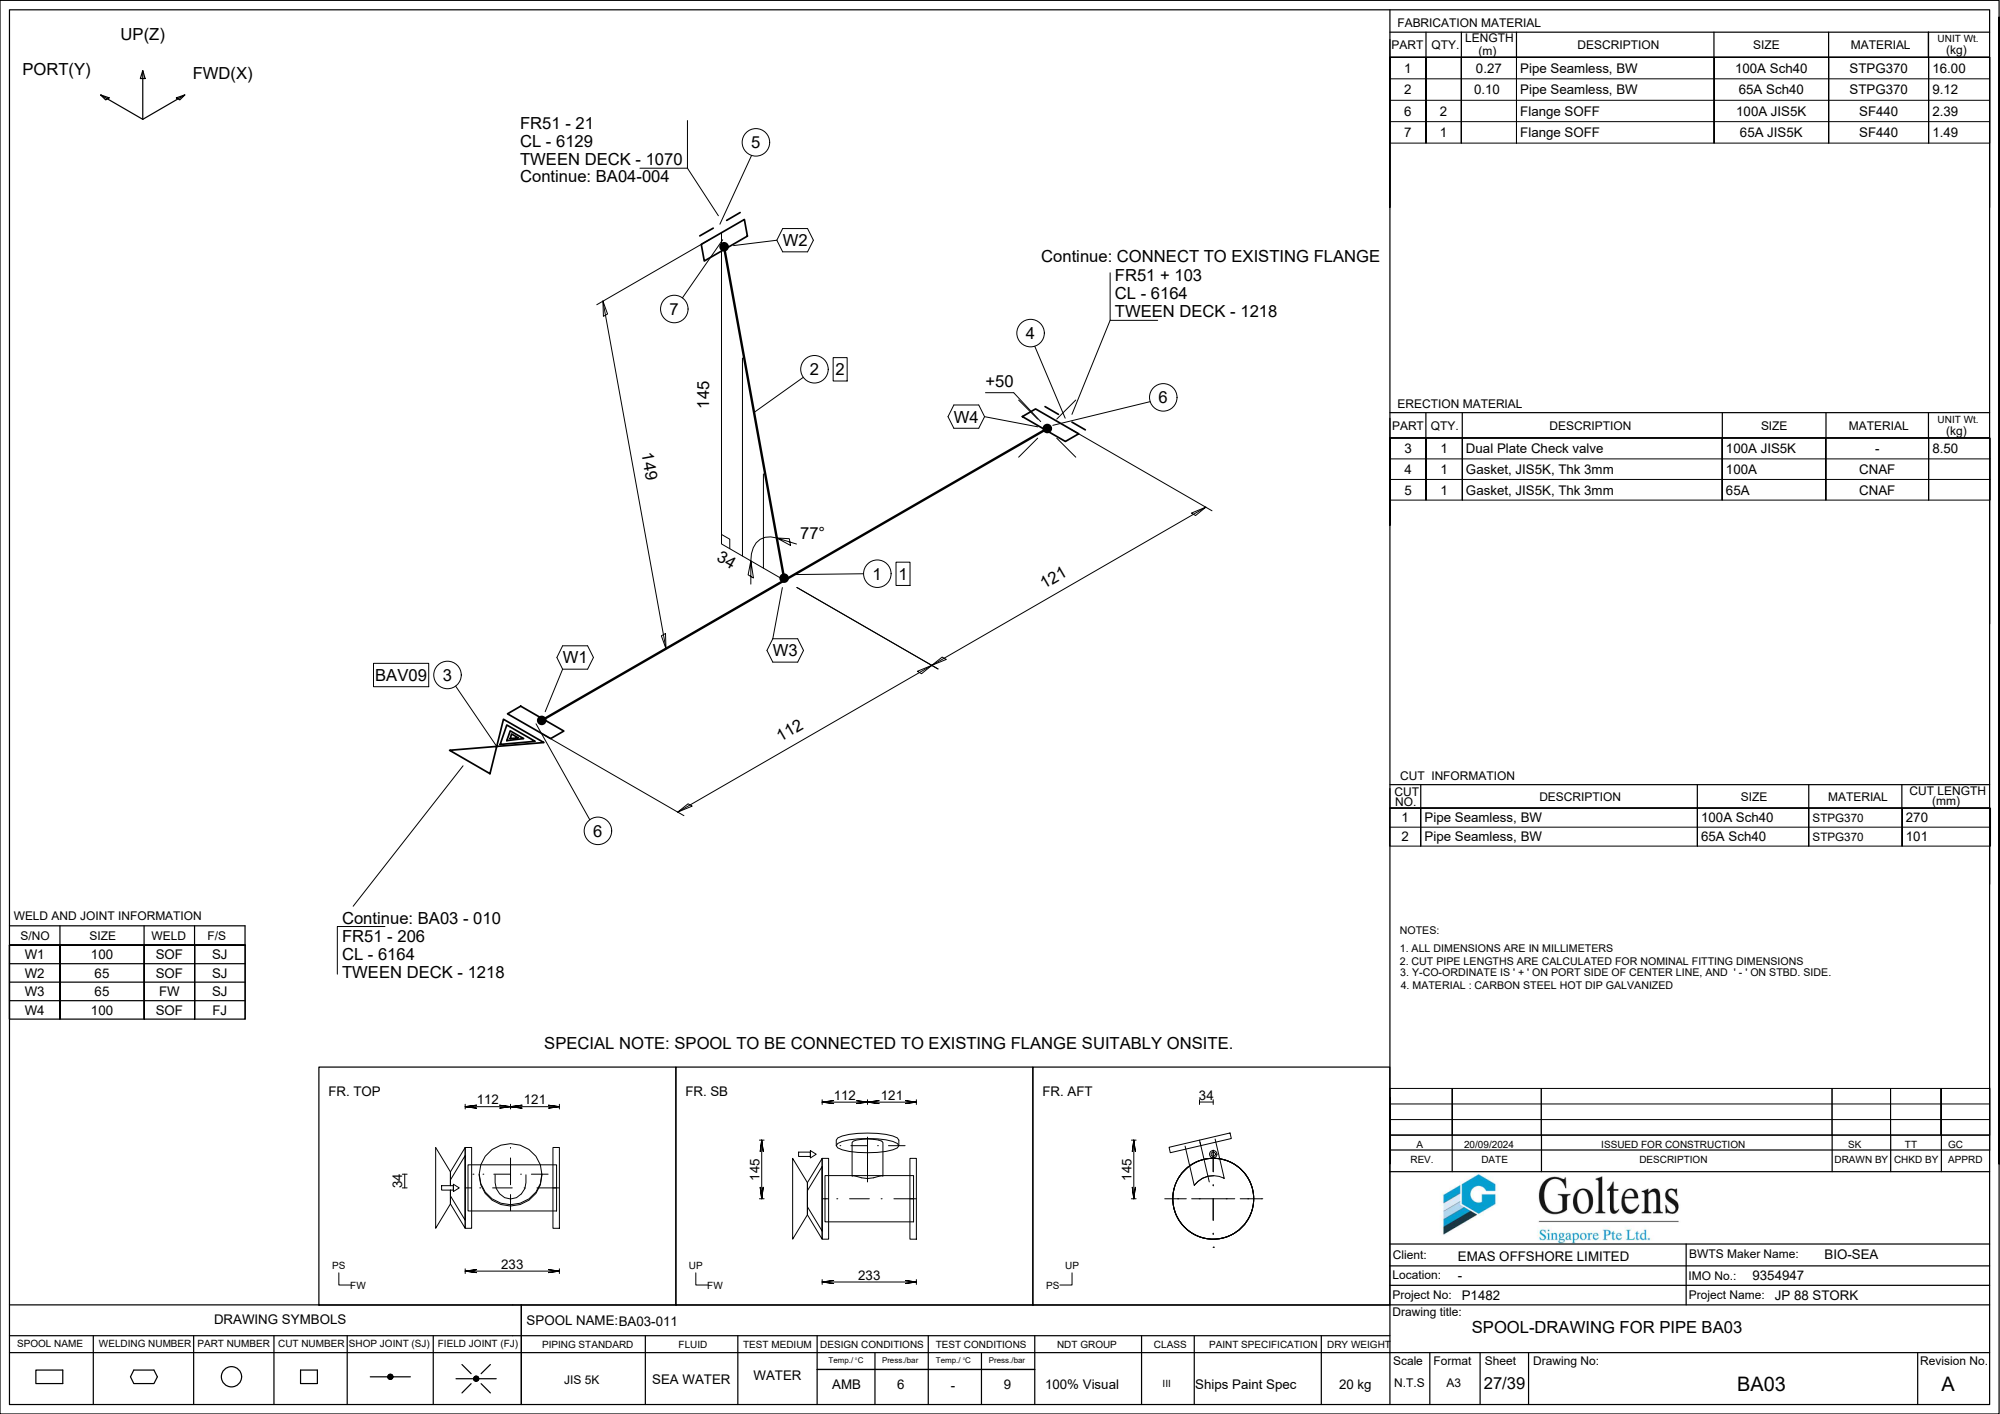
[picture p48: page 28]
FR. TOP; FR. AFT; AMB; Flange SOFF; 65A JIS5K; Gasket, JIS5K, Thk 3mm; CNAF; SOF; Pipe Seamless, BW; 65A Sch40; STPG370; REV.; DATE; DESCRIPTION; DRAWN BY; CHKD BY; APPRD; Location:; Client:; ERECTION MATERIAL; CUT INFORMATION; SIZE; WELD; ISSUED FOR CONSTRUCTION; FR51 - 206 CL - 6164 TWEEN DECK - 1218; Continue: BA03 - 010; TWEEN DECK - 1070; Continue: BA04-004; BAV09

1 | | 0.27 | Pipe Seamless, BW | 100A Sch40 | STPG370 | 16.00
2 | | 0.10 | Pipe Seamless, BW | 65A Sch40 | STPG370 | 9.12
6 | 2 | | Flange SOFF | 100A JIS5K | SF440 | 2.39

Continue: CONNECT TO EXISTING FLANGE

PART | QTY. | DESCRIPTION | SIZE | MATERIAL | UNIT Wt. (kg)

3 | 1 | Dual Plate Check valve | 100A JIS5K | - | 8.50
4 | 1 | Gasket, JIS5K, Thk 3mm | 100A | CNAF

CUT NO. | DESCRIPTION | SIZE | MATERIAL | CUT LENGTH (mm)

1 | Pipe Seamless, BW | 100A Sch40 | STPG370 | 270

WELD AND JOINT INFORMATION

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

W1 | 100 | SOF | SJ
W2 | 65 | SOF | SJ
W3 | 65 | FW | SJ

SPECIAL NOTE: SPOOL TO BE CONNECTED TO EXISTING FLANGE SUITABLY ONSITE.

- BIO-SEA
EMAS OFFSHORE LIMITED

BWTS Maker Name:

IMO No.: NDT GROUP

### FWD(X)

### PORT(Y)

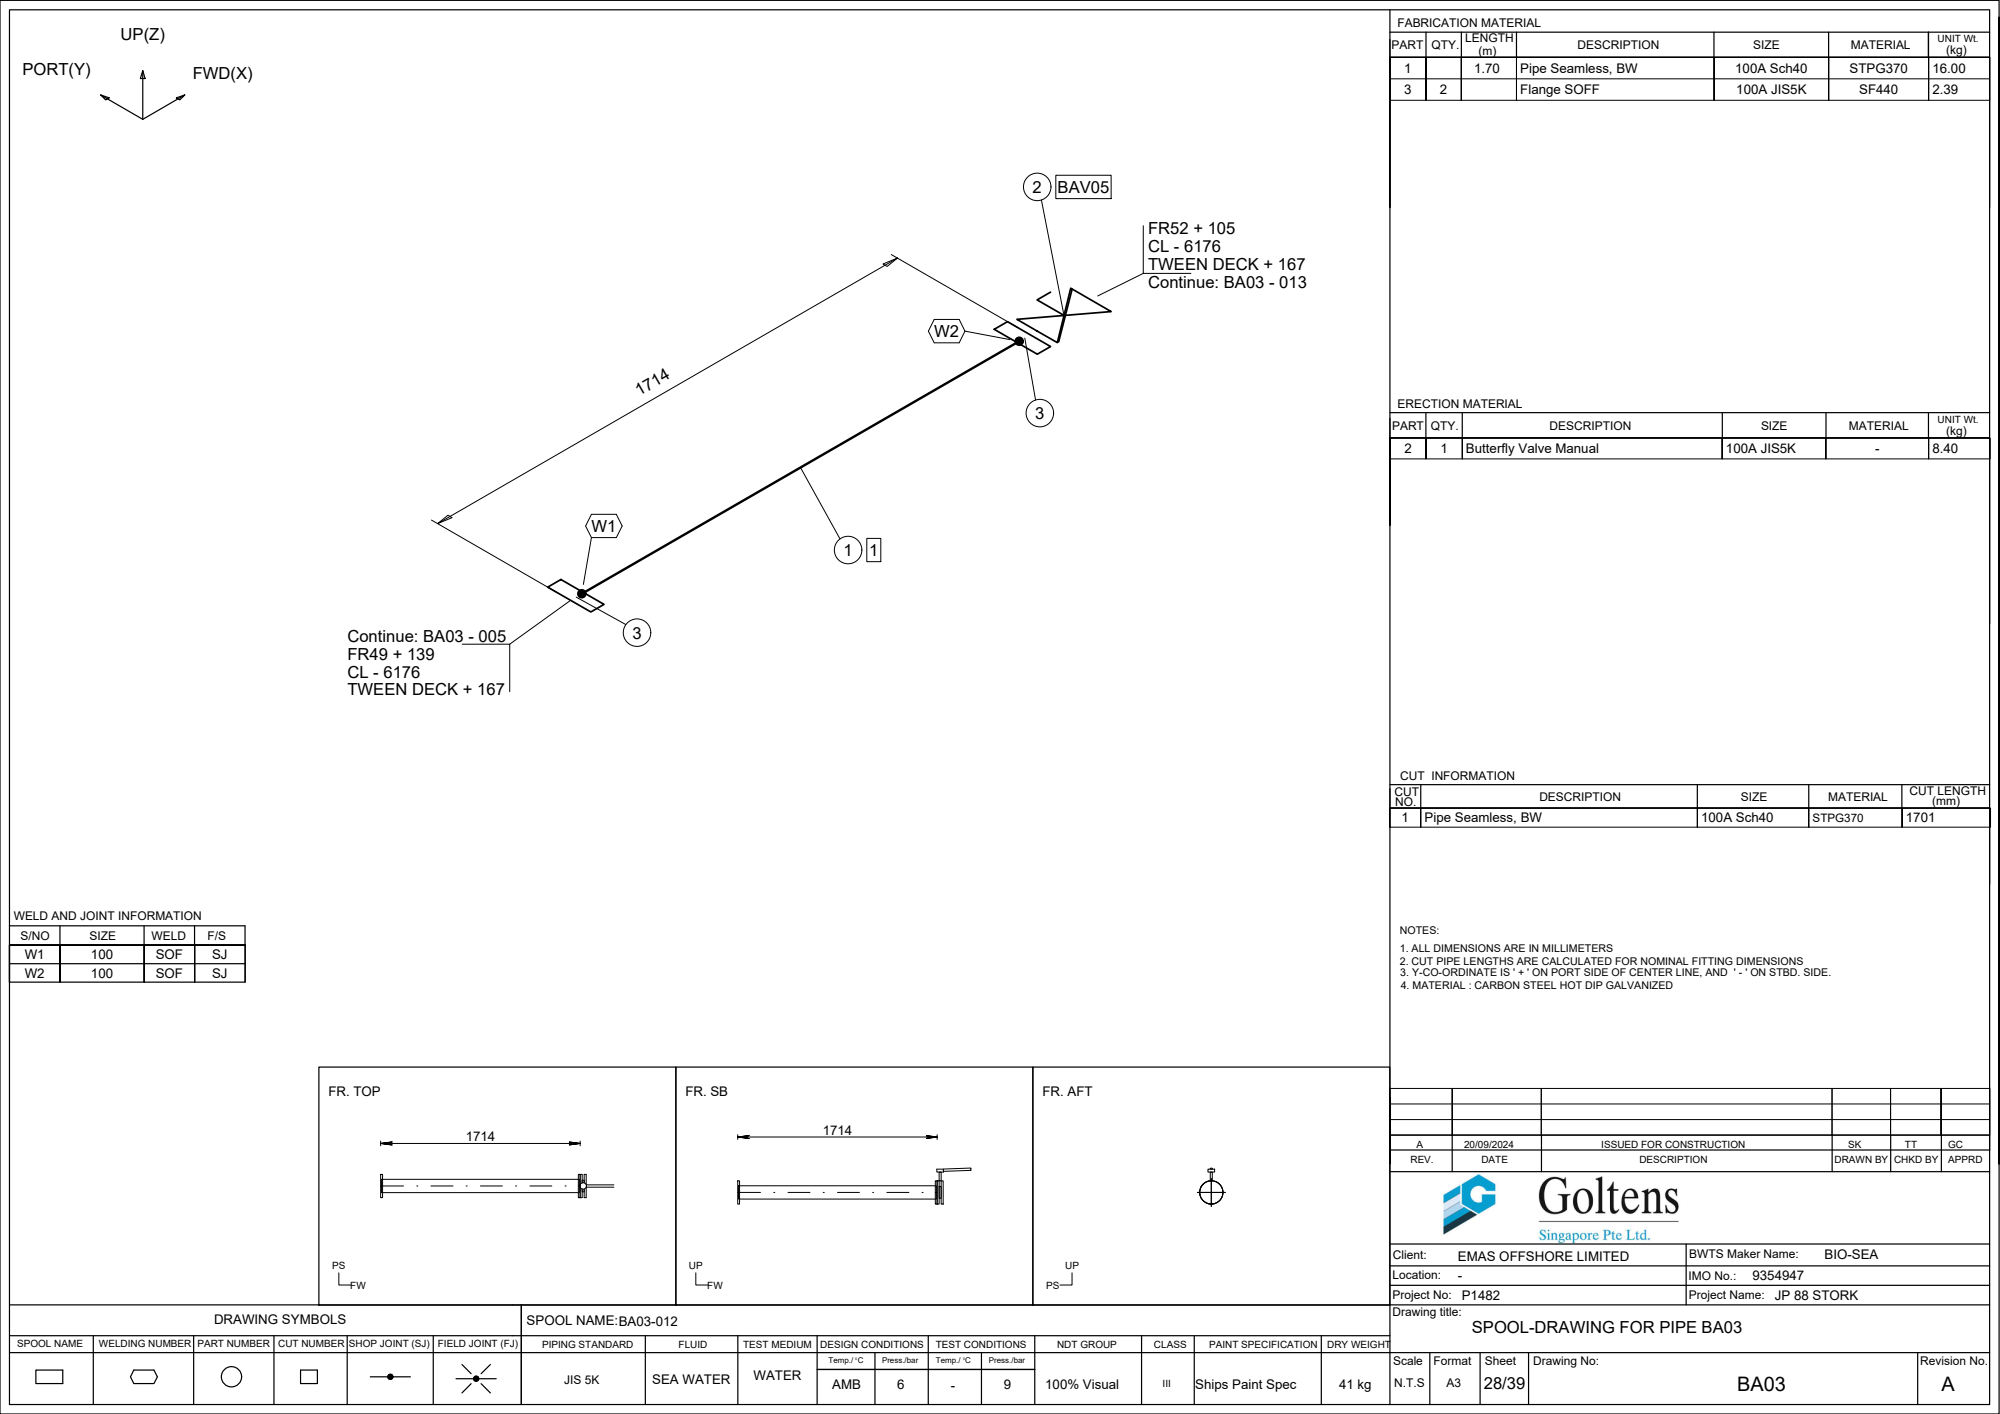
[picture p49: page 29]
FR. TOP; FR. AFT; AMB; Pipe Seamless, BW; 100A Sch40; STPG370; Flange SOFF; 100A JIS5K; Butterfly Valve Manual; SOF; REV.; DATE; DESCRIPTION; DRAWN BY; CHKD BY; APPRD; Location:; Client:; ERECTION MATERIAL; CUT INFORMATION; SIZE; WELD; PART; QTY.; MATERIAL; ISSUED FOR CONSTRUCTION; FR49 + 139 CL - 6176 TWEEN DECK + 167; Continue: BA03 - 005; TWEEN DECK + 167; Continue: BA03 - 013; BAV05

UNIT Wt. (kg)

CUT NO. | DESCRIPTION | SIZE | MATERIAL | CUT LENGTH (mm)

1 | Pipe Seamless, BW | 100A Sch40 | STPG370 | 1701

WELD AND JOINT INFORMATION

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

- BIO-SEA
EMAS OFFSHORE LIMITED

BWTS Maker Name:

IMO No.: NDT GROUP

W4

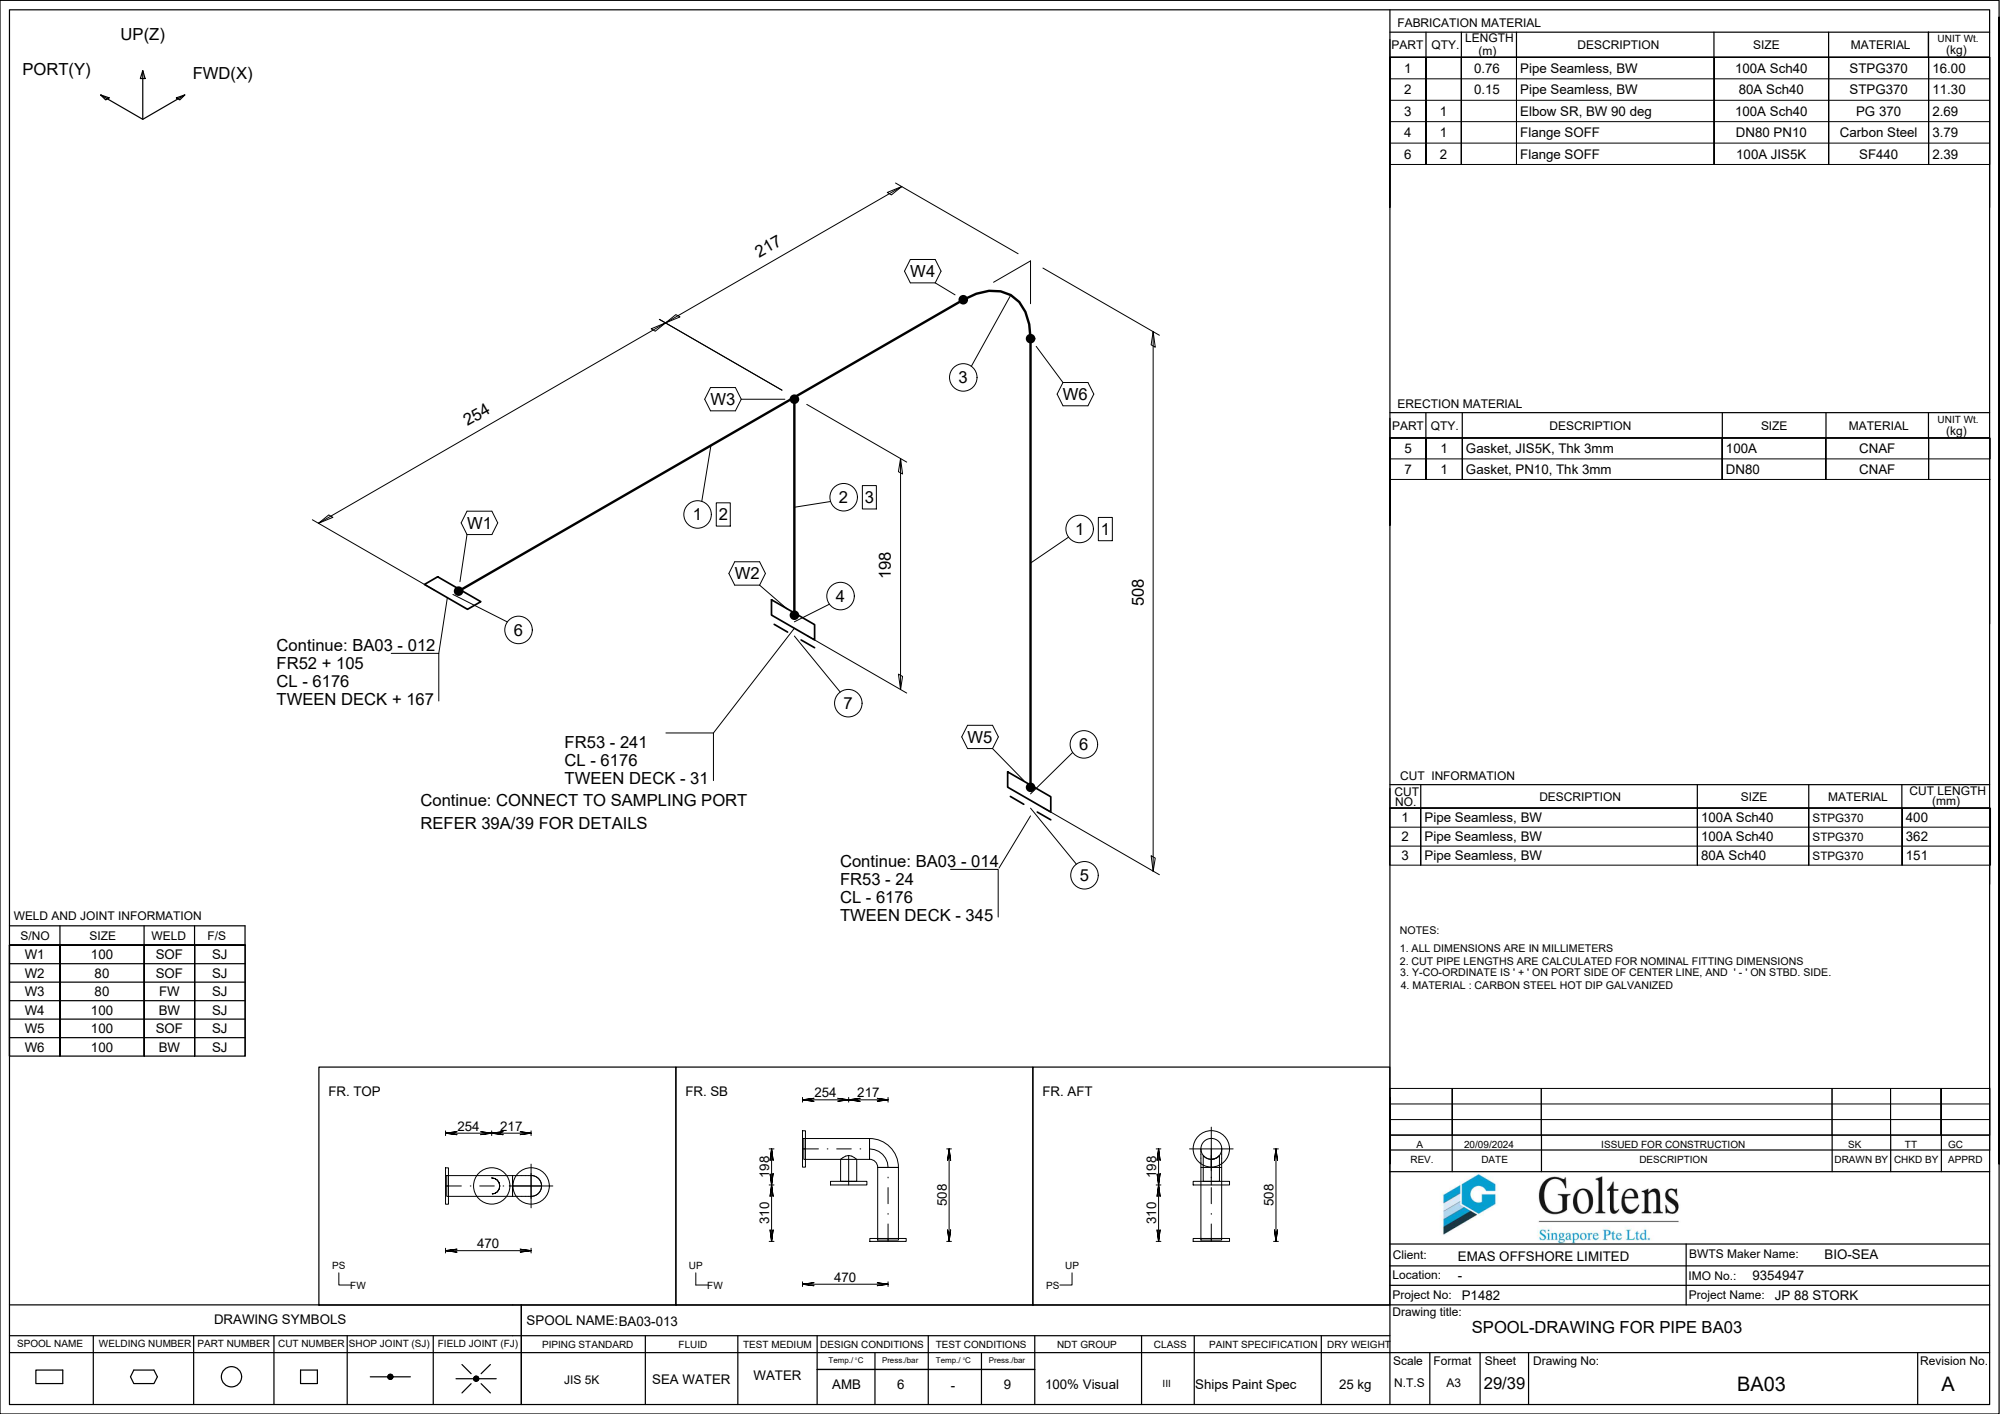
[picture p50: page 30]
FR. TOP; FR. AFT; AMB; Flange SOFF; 100A JIS5K; Pipe Seamless, BW; 80A Sch40; STPG370; REV.; DATE; DESCRIPTION; DRAWN BY; CHKD BY; APPRD; Location:; Client:; ERECTION MATERIAL; CUT INFORMATION; SIZE; WELD; ISSUED FOR CONSTRUCTION; FR52 + 105 CL - 6176 TWEEN DECK + 167; Continue: BA03 - 012; FR53 - 241 CL - 6176 TWEEN DECK - 31; FR53 - 24 CL - 6176 TWEEN DECK - 345; Continue: BA03 - 014

1 | | 0.76 | Pipe Seamless, BW | 100A Sch40 | STPG370 | 16.00
2 | | 0.15 | Pipe Seamless, BW | 80A Sch40 | STPG370 | 11.30
3 | 1 | | Elbow SR, BW 90 deg | 100A Sch40 | PG 370 | 2.69
4 | 1 | | Flange SOFF | DN80 PN10 | Carbon Steel | 3.79

PART | QTY. | DESCRIPTION | SIZE | MATERIAL | UNIT Wt. (kg)

5 7 | 1 1 | Gasket, JIS5K, Thk 3mm Gasket, PN10, Thk 3mm | 100A DN80 | CNAF

Continue: CONNECT TO SAMPLING PORT
REFER 39A/39 FOR DETAILS

CUT NO. | DESCRIPTION | SIZE | MATERIAL | CUT LENGTH (mm)

1 | Pipe Seamless, BW | 100A Sch40 | STPG370 | 400
2 | Pipe Seamless, BW | 100A Sch40 | STPG370 | 362

WELD AND JOINT INFORMATION

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

W1 | 100 | SOF | SJ
W2 | 80 | SOF | SJ
W3 | 80 | FW | SJ
W4 | 100 | BW | SJ
W5 | 100 | SOF | SJ

- BIO-SEA
EMAS OFFSHORE LIMITED

BWTS Maker Name:

IMO No.: NDT GROUP

### TWEEN DECK - 345

FR53 - 24

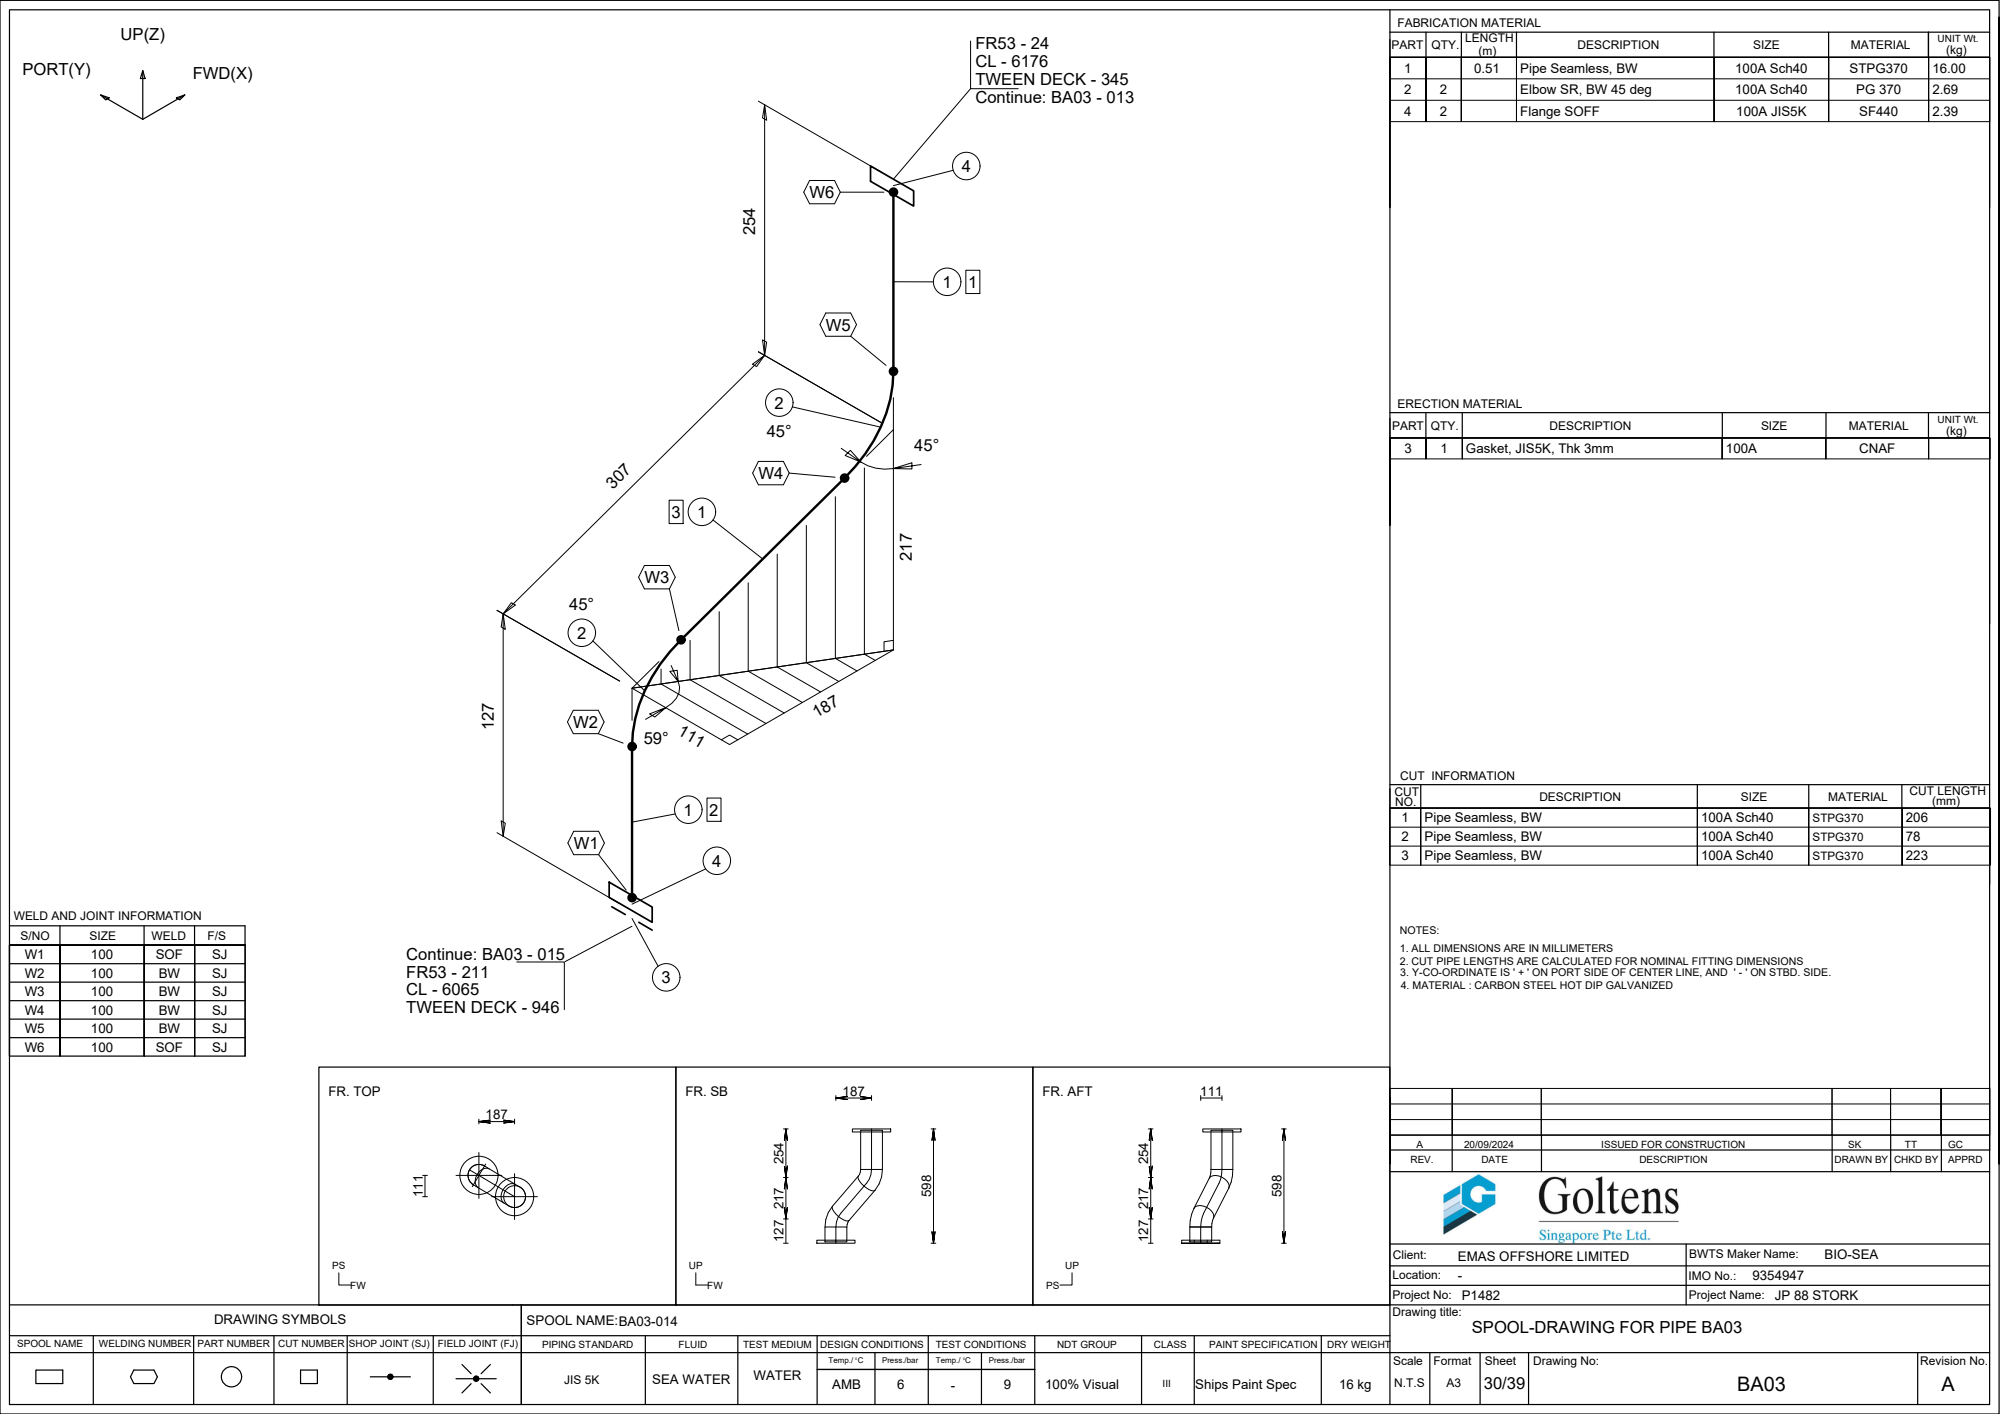
[picture p51: page 31]
FR. TOP; FR. AFT; AMB; Flange SOFF; 100A JIS5K; Gasket, JIS5K, Thk 3mm; CNAF; SOF; Pipe Seamless, BW; 100A Sch40; STPG370; REV.; DATE; DESCRIPTION; DRAWN BY; CHKD BY; APPRD; Location:; Client:; ERECTION MATERIAL; CUT INFORMATION; SIZE; WELD; PART; QTY.; MATERIAL; ISSUED FOR CONSTRUCTION; FR53 - 211 CL - 6065 TWEEN DECK - 946; Continue: BA03 - 015; Continue: BA03 - 013

1 | | 0.51 | Pipe Seamless, BW | 100A Sch40 | STPG370 | 16.00
2 | 2 | | Elbow SR, BW 45 deg | 100A Sch40 | PG 370 | 2.69

UNIT Wt. (kg)

CUT NO. | DESCRIPTION | SIZE | MATERIAL | CUT LENGTH (mm)

1 | Pipe Seamless, BW | 100A Sch40 | STPG370 | 206
2 | Pipe Seamless, BW | 100A Sch40 | STPG370 | 78

WELD AND JOINT INFORMATION

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

W1 | 100 | SOF | SJ
W2 | 100 | BW | SJ
W3 | 100 | BW | SJ
W4 | 100 | BW | SJ
W5 | 100 | BW | SJ

- BIO-SEA
EMAS OFFSHORE LIMITED

BWTS Maker Name:

IMO No.: NDT GROUP

### TWEEN DECK - 946

CL - 6065

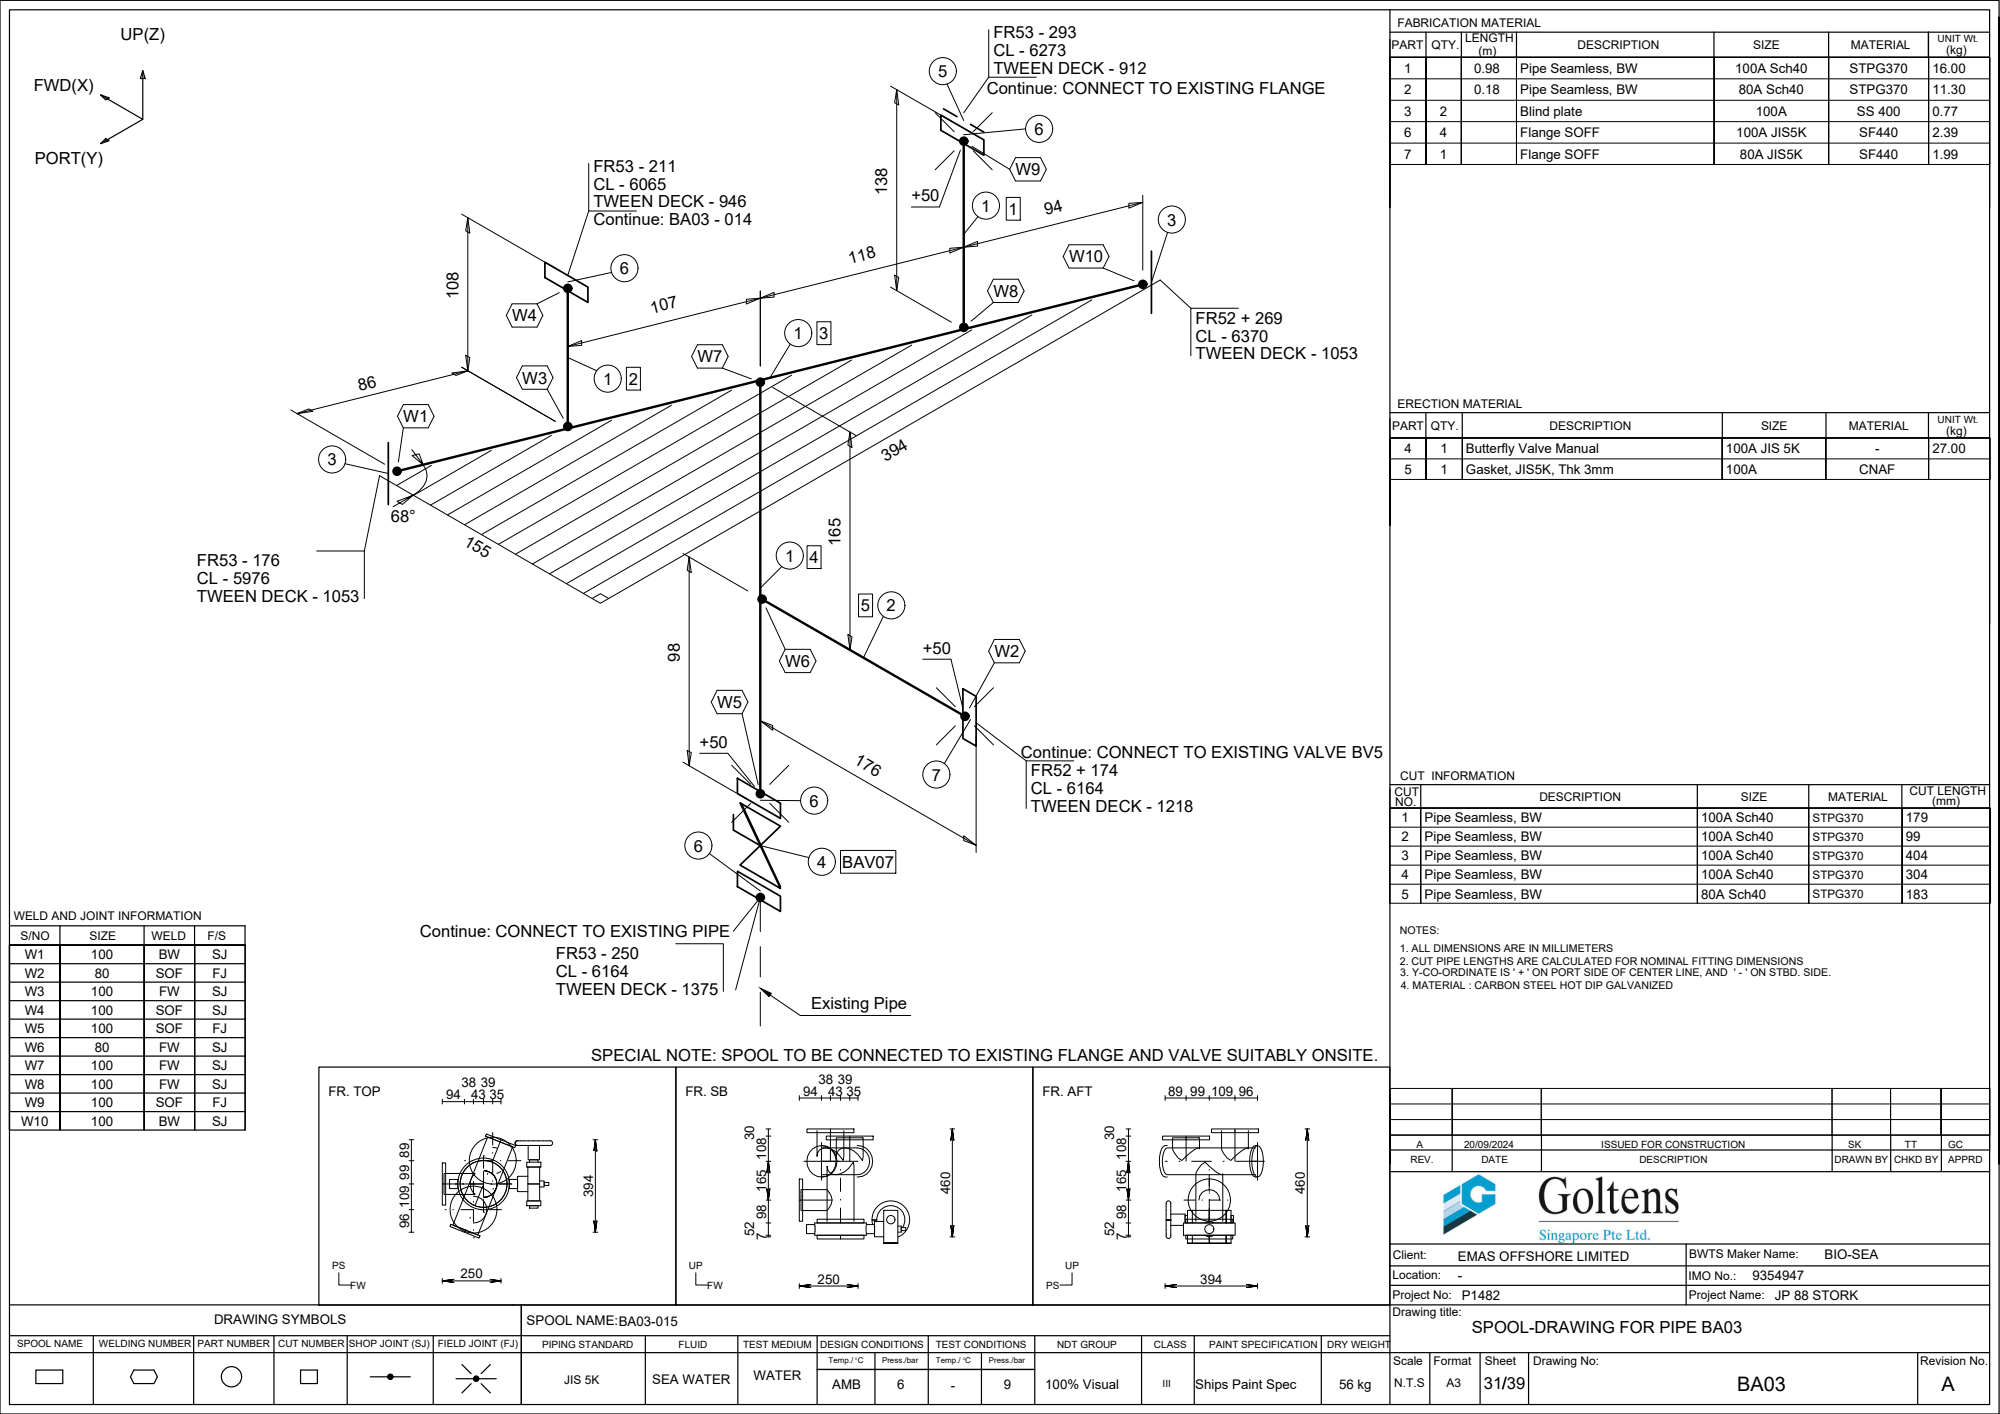
[picture p52: page 32]
94 39 FR. TOP; FR. AFT; AMB; Flange SOFF; 80A JIS5K; Gasket, JIS5K, Thk 3mm; CNAF; Pipe Seamless, BW; 80A Sch40; STPG370; REV.; DATE; DESCRIPTION; DRAWN BY; CHKD BY; APPRD; Location:; Client:; ERECTION MATERIAL; CUT INFORMATION; SIZE; WELD; ISSUED FOR CONSTRUCTION; Continue: BA03 - 014; TWEEN DECK - 912; FR52 + 269 CL - 6370 TWEEN DECK - 1053; FR53 - 176 CL - 5976 TWEEN DECK - 1053; FR53 - 250 CL - 6164 TWEEN DECK - 1375; BAV07; Existing Pipe; FWD(X); Continue: CONNECT TO EXISTING FLANGE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

1 | | 0.98 | Pipe Seamless, BW | 100A Sch40 | STPG370 | 16.00
2 | | 0.18 | Pipe Seamless, BW | 80A Sch40 | STPG370 | 11.30
3 | 2 | | Blind plate | 100A | SS 400 | 0.77
6 | 4 | | Flange SOFF | 100A JIS5K | SF440 | 2.39

PART | QTY. | DESCRIPTION | SIZE | MATERIAL | UNIT Wt. (kg)

4 | 1 | Butterfly Valve Manual | 100A JIS 5K | - | 27.00

Continue: CONNECT TO EXISTING VALVE BV5
TWEEN DECK - 1218

CUT NO. | DESCRIPTION | SIZE | MATERIAL | CUT LENGTH (mm)

1 | Pipe Seamless, BW | 100A Sch40 | STPG370 | 179
2 | Pipe Seamless, BW | 100A Sch40 | STPG370 | 99
3 | Pipe Seamless, BW | 100A Sch40 | STPG370 | 404
4 | Pipe Seamless, BW | 100A Sch40 | STPG370 | 304

WELD AND JOINT INFORMATION

Continue: CONNECT TO EXISTING PIPE

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

W1 | 100 | BW | SJ
W2 | 80 | SOF | FJ
W3 | 100 | FW | SJ
W4 | 100 | SOF | SJ
W5 | 100 | SOF | FJ
W6 | 80 | FW | SJ
W7 | 100 | FW | SJ
W8 | 100 | FW | SJ
W9 | 100 | SOF | FJ

SPECIAL NOTE: SPOOL TO BE CONNECTED TO EXISTING FLANGE AND VALVE SUITABLY ONSITE.

- BIO-SEA
EMAS OFFSHORE LIMITED

BWTS Maker Name:

IMO No.: NDT GROUP

### FWD(X)

### PORT(Y)

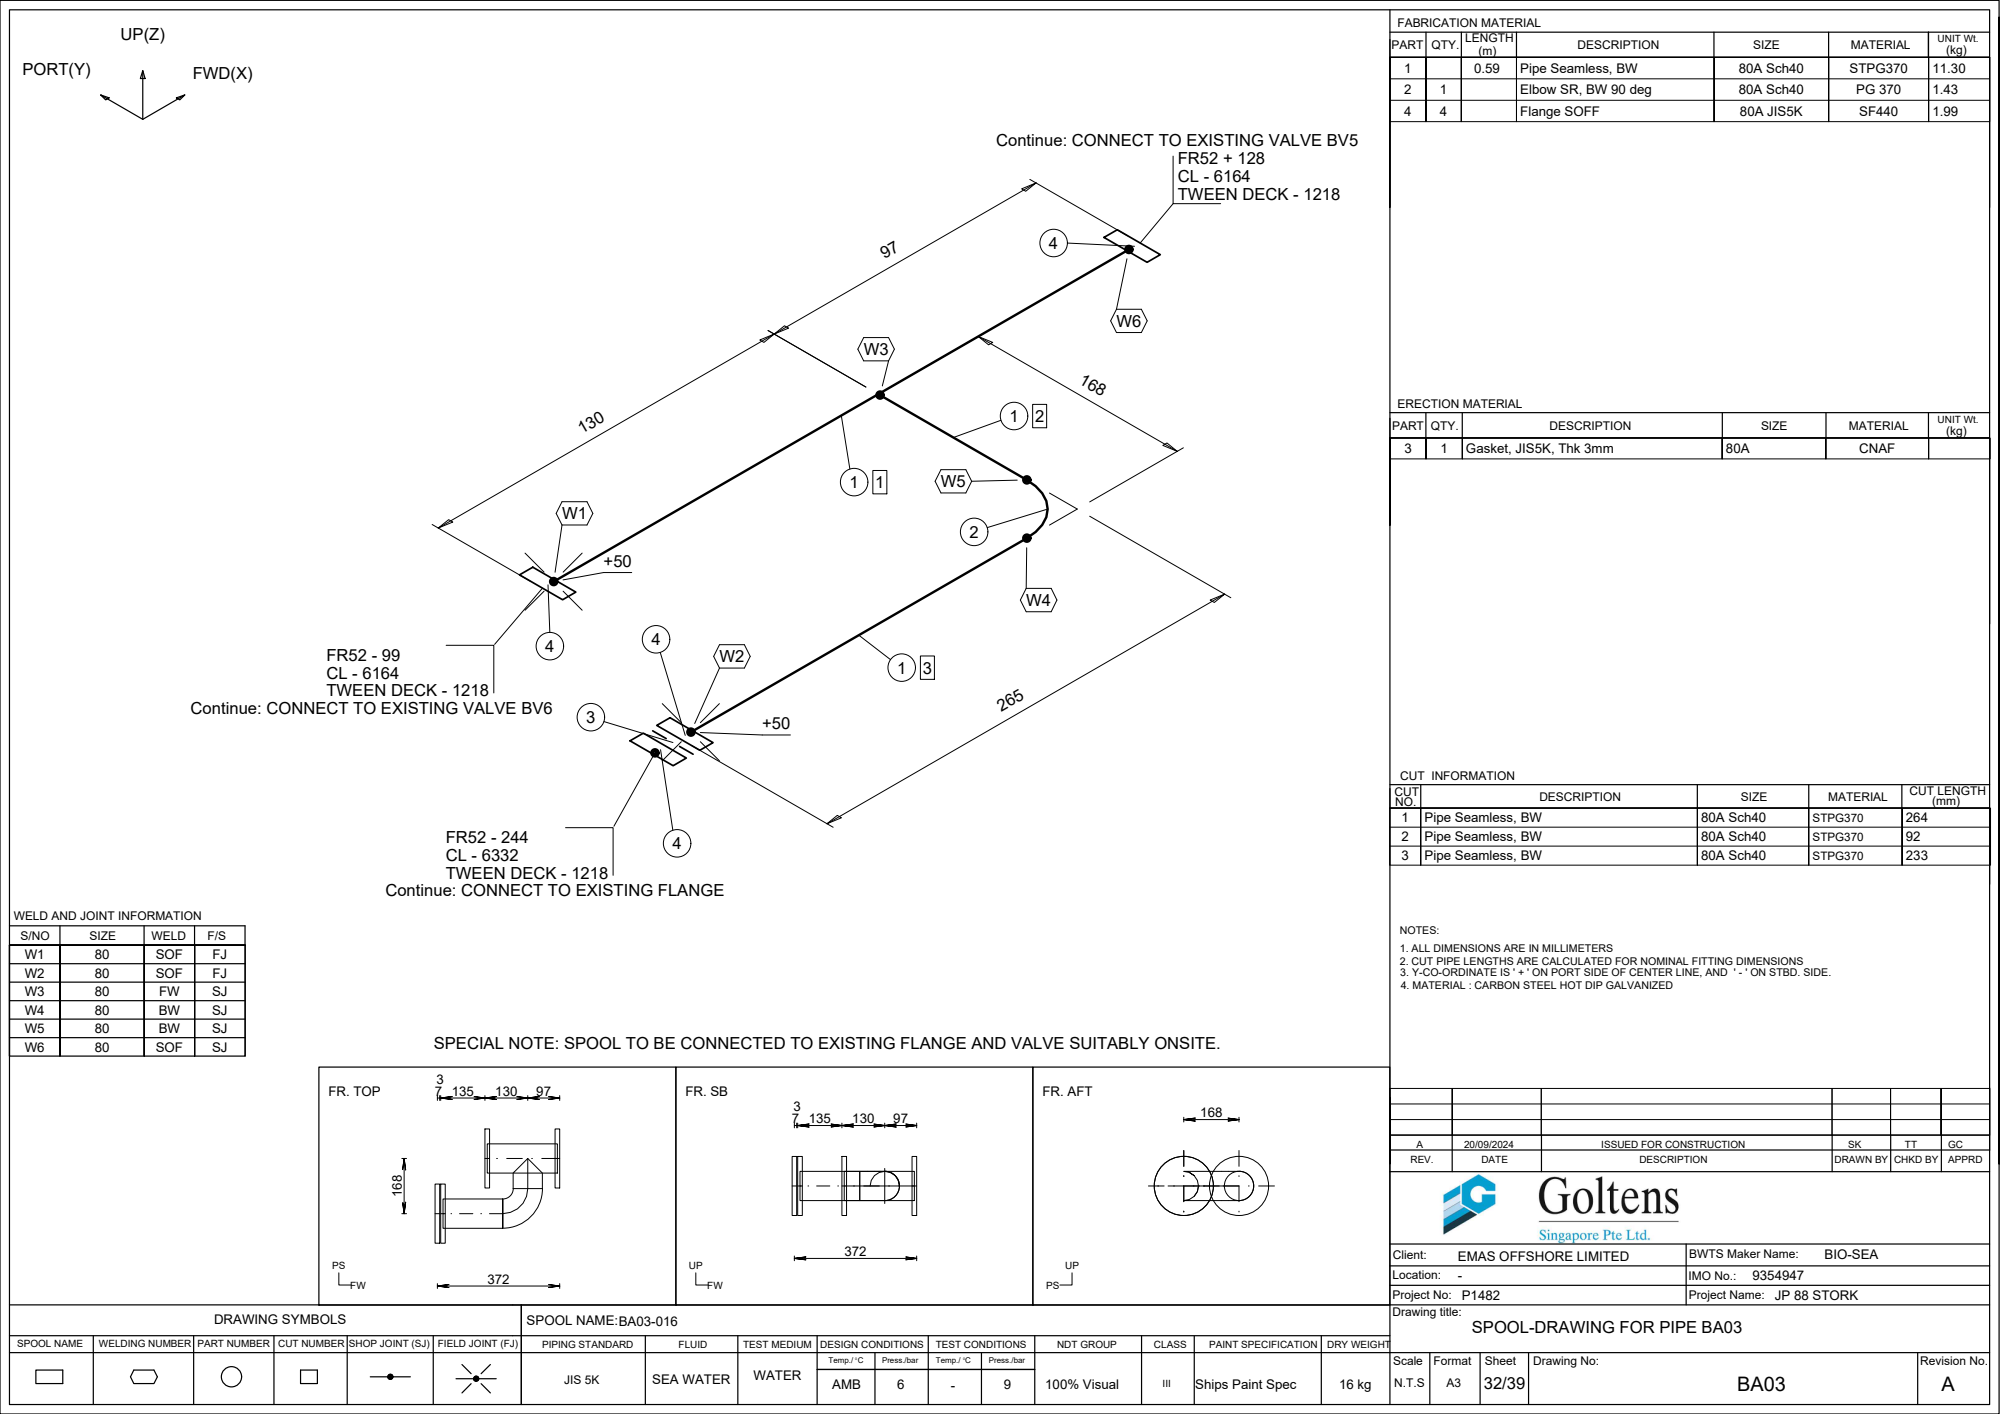
[picture p53: page 33]
FR. TOP; FR. AFT; AMB; Flange SOFF; 80A JIS5K; Gasket, JIS5K, Thk 3mm; CNAF; SOF; Pipe Seamless, BW; 80A Sch40; STPG370; REV.; DATE; DESCRIPTION; DRAWN BY; CHKD BY; APPRD; Location:; Client:; ERECTION MATERIAL; CUT INFORMATION; SIZE; WELD; PART; QTY.; MATERIAL; ISSUED FOR CONSTRUCTION; FR52 - 99 CL - 6164 TWEEN DECK - 1218; TWEEN DECK - 1218; FR52 - 244 CL - 6332 TWEEN DECK - 1218

1 | | 0.59 | Pipe Seamless, BW | 80A Sch40 | STPG370 | 11.30
2 | 1 | | Elbow SR, BW 90 deg | 80A Sch40 | PG 370 | 1.43

Continue: CONNECT TO EXISTING VALVE BV5

UNIT Wt. (kg)

Continue: CONNECT TO EXISTING VALVE BV6

CUT NO. | DESCRIPTION | SIZE | MATERIAL | CUT LENGTH (mm)

1 | Pipe Seamless, BW | 80A Sch40 | STPG370 | 264
2 | Pipe Seamless, BW | 80A Sch40 | STPG370 | 92

Continue: CONNECT TO EXISTING FLANGE

WELD AND JOINT INFORMATION

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

W1 | 80 | SOF | FJ
W2 | 80 | SOF | FJ
W3 | 80 | FW | SJ
W4 | 80 | BW | SJ
W5 | 80 | BW | SJ

SPECIAL NOTE: SPOOL TO BE CONNECTED TO EXISTING FLANGE AND VALVE SUITABLY ONSITE.

- BIO-SEA
EMAS OFFSHORE LIMITED

BWTS Maker Name:

IMO No.: NDT GROUP

### TWEEN DECK - 46

FR51 - 49

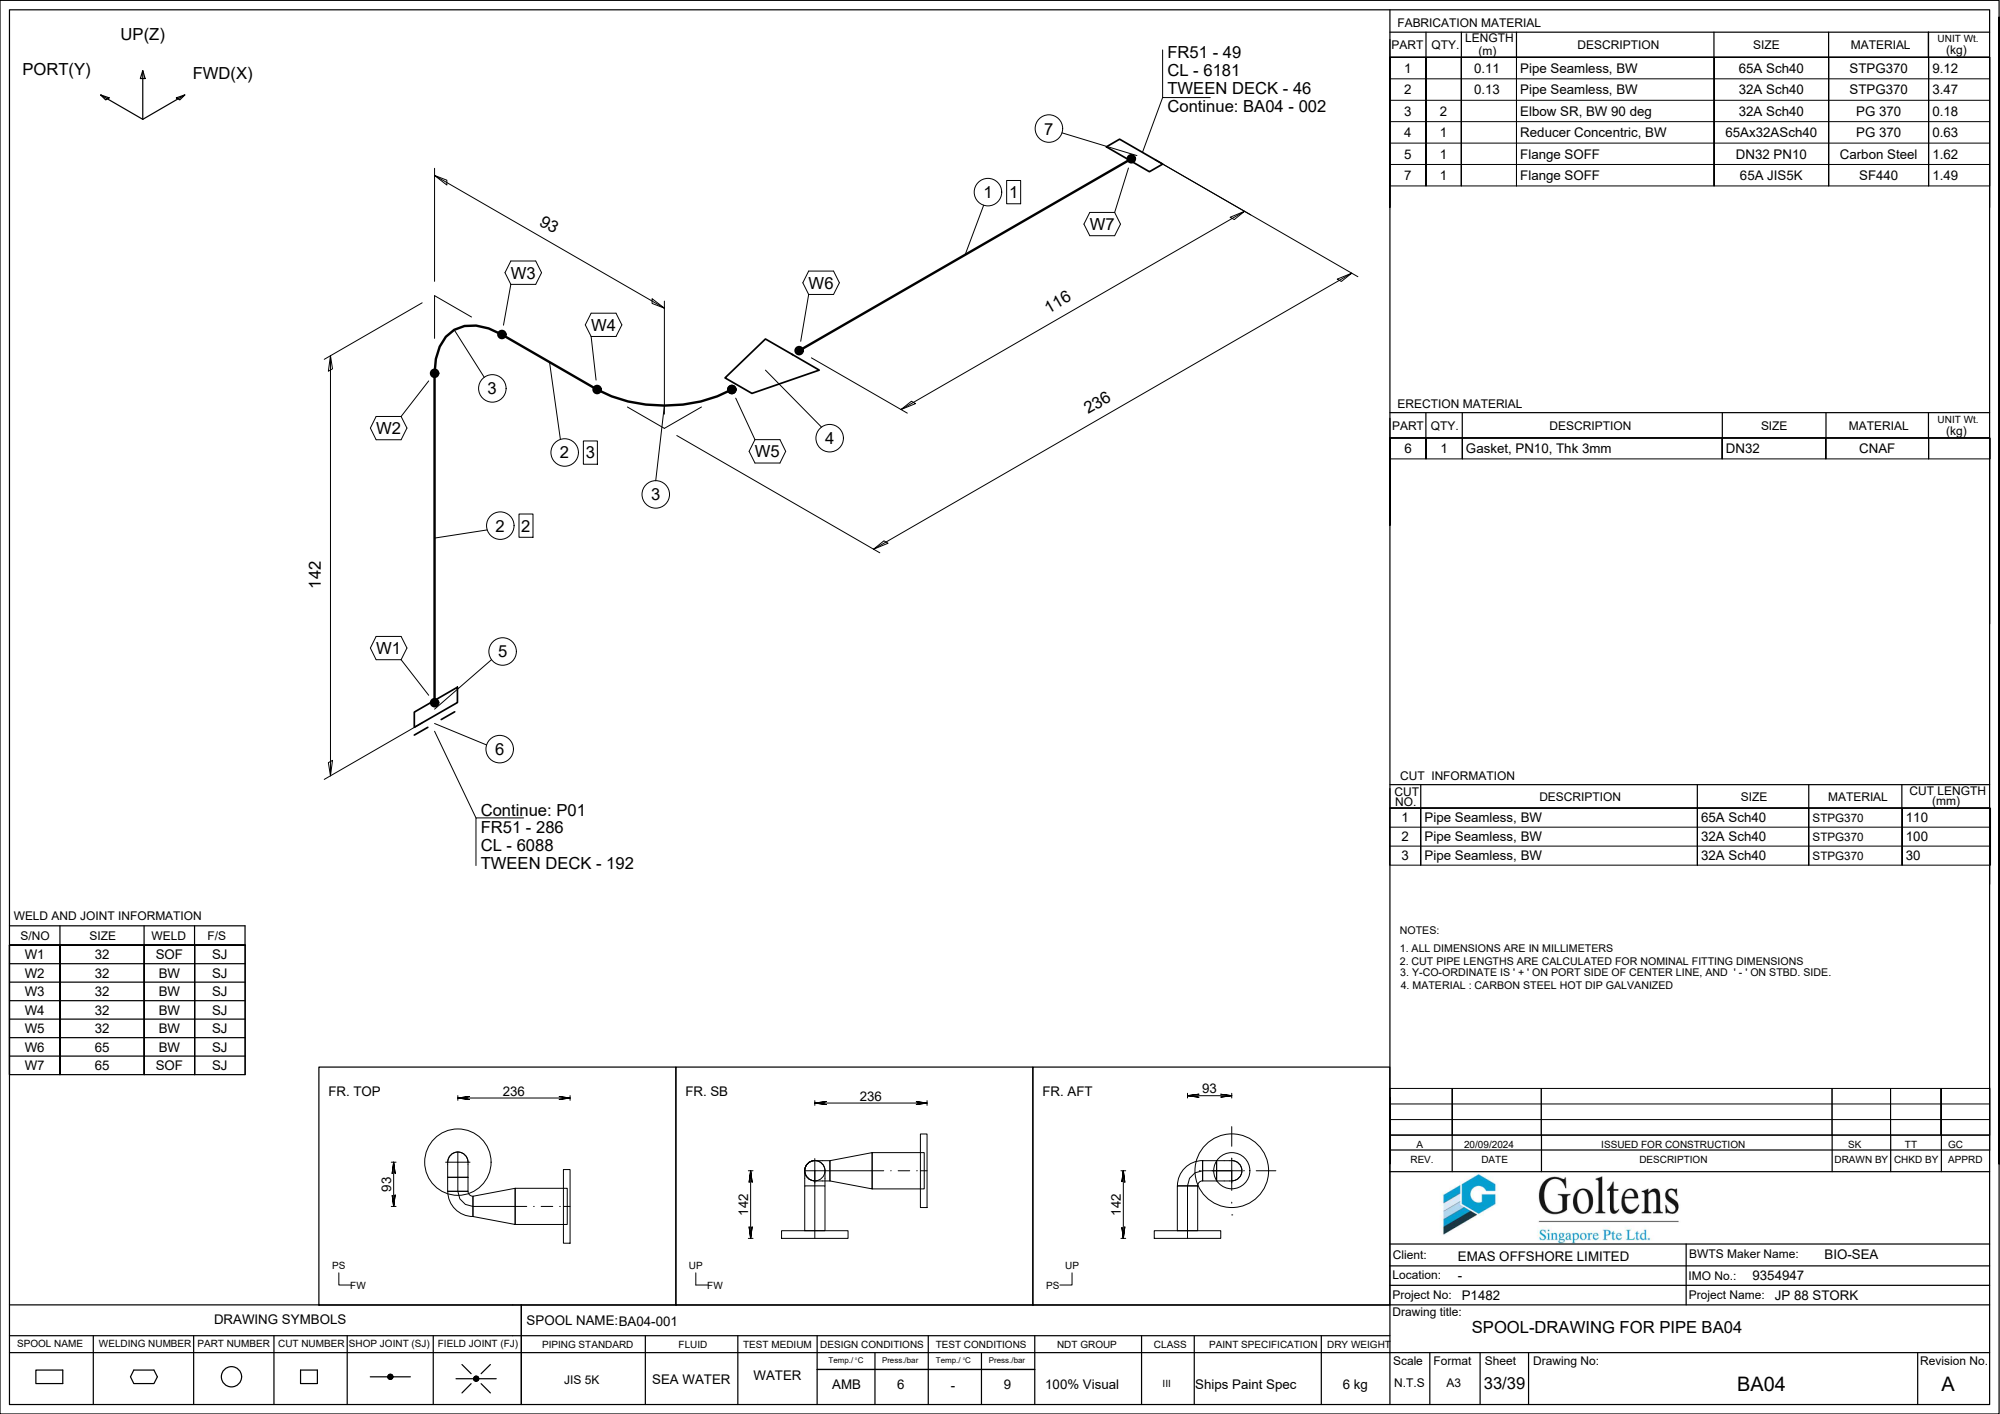
[picture p54: page 34]
93 236 FR. TOP; FR. AFT; AMB; Flange SOFF; 65A JIS5K; Gasket, PN10, Thk 3mm; CNAF; SOF; Pipe Seamless, BW; 32A Sch40; STPG370; REV.; DATE; DESCRIPTION; DRAWN BY; CHKD BY; APPRD; Location:; Client:; ERECTION MATERIAL; CUT INFORMATION; SIZE; WELD; PART; QTY.; MATERIAL; ISSUED FOR CONSTRUCTION; Continue: BA04 - 002; FR51 - 286 CL - 6088 TWEEN DECK - 192; Continue: P01

1 | | 0.11 | Pipe Seamless, BW | 65A Sch40 | STPG370 | 9.12
2 | | 0.13 | Pipe Seamless, BW | 32A Sch40 | STPG370 | 3.47
3 | 2 | | Elbow SR, BW 90 deg | 32A Sch40 | PG 370 | 0.18
4 | 1 | | Reducer Concentric, BW | 65Ax32ASch40 | PG 370 | 0.63
5 | 1 | | Flange SOFF | DN32 PN10 | Carbon Steel | 1.62

UNIT Wt. (kg)

CUT NO. | DESCRIPTION | SIZE | MATERIAL | CUT LENGTH (mm)

1 | Pipe Seamless, BW | 65A Sch40 | STPG370 | 110
2 | Pipe Seamless, BW | 32A Sch40 | STPG370 | 100

WELD AND JOINT INFORMATION

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

W1 | 32 | SOF | SJ
W2 | 32 | BW | SJ
W3 | 32 | BW | SJ
W4 | 32 | BW | SJ
W5 | 32 | BW | SJ
W6 | 65 | BW | SJ

- BIO-SEA
EMAS OFFSHORE LIMITED

BWTS Maker Name:

IMO No.: NDT GROUP

### FWD(X)

PORT(Y) | 169 | 169

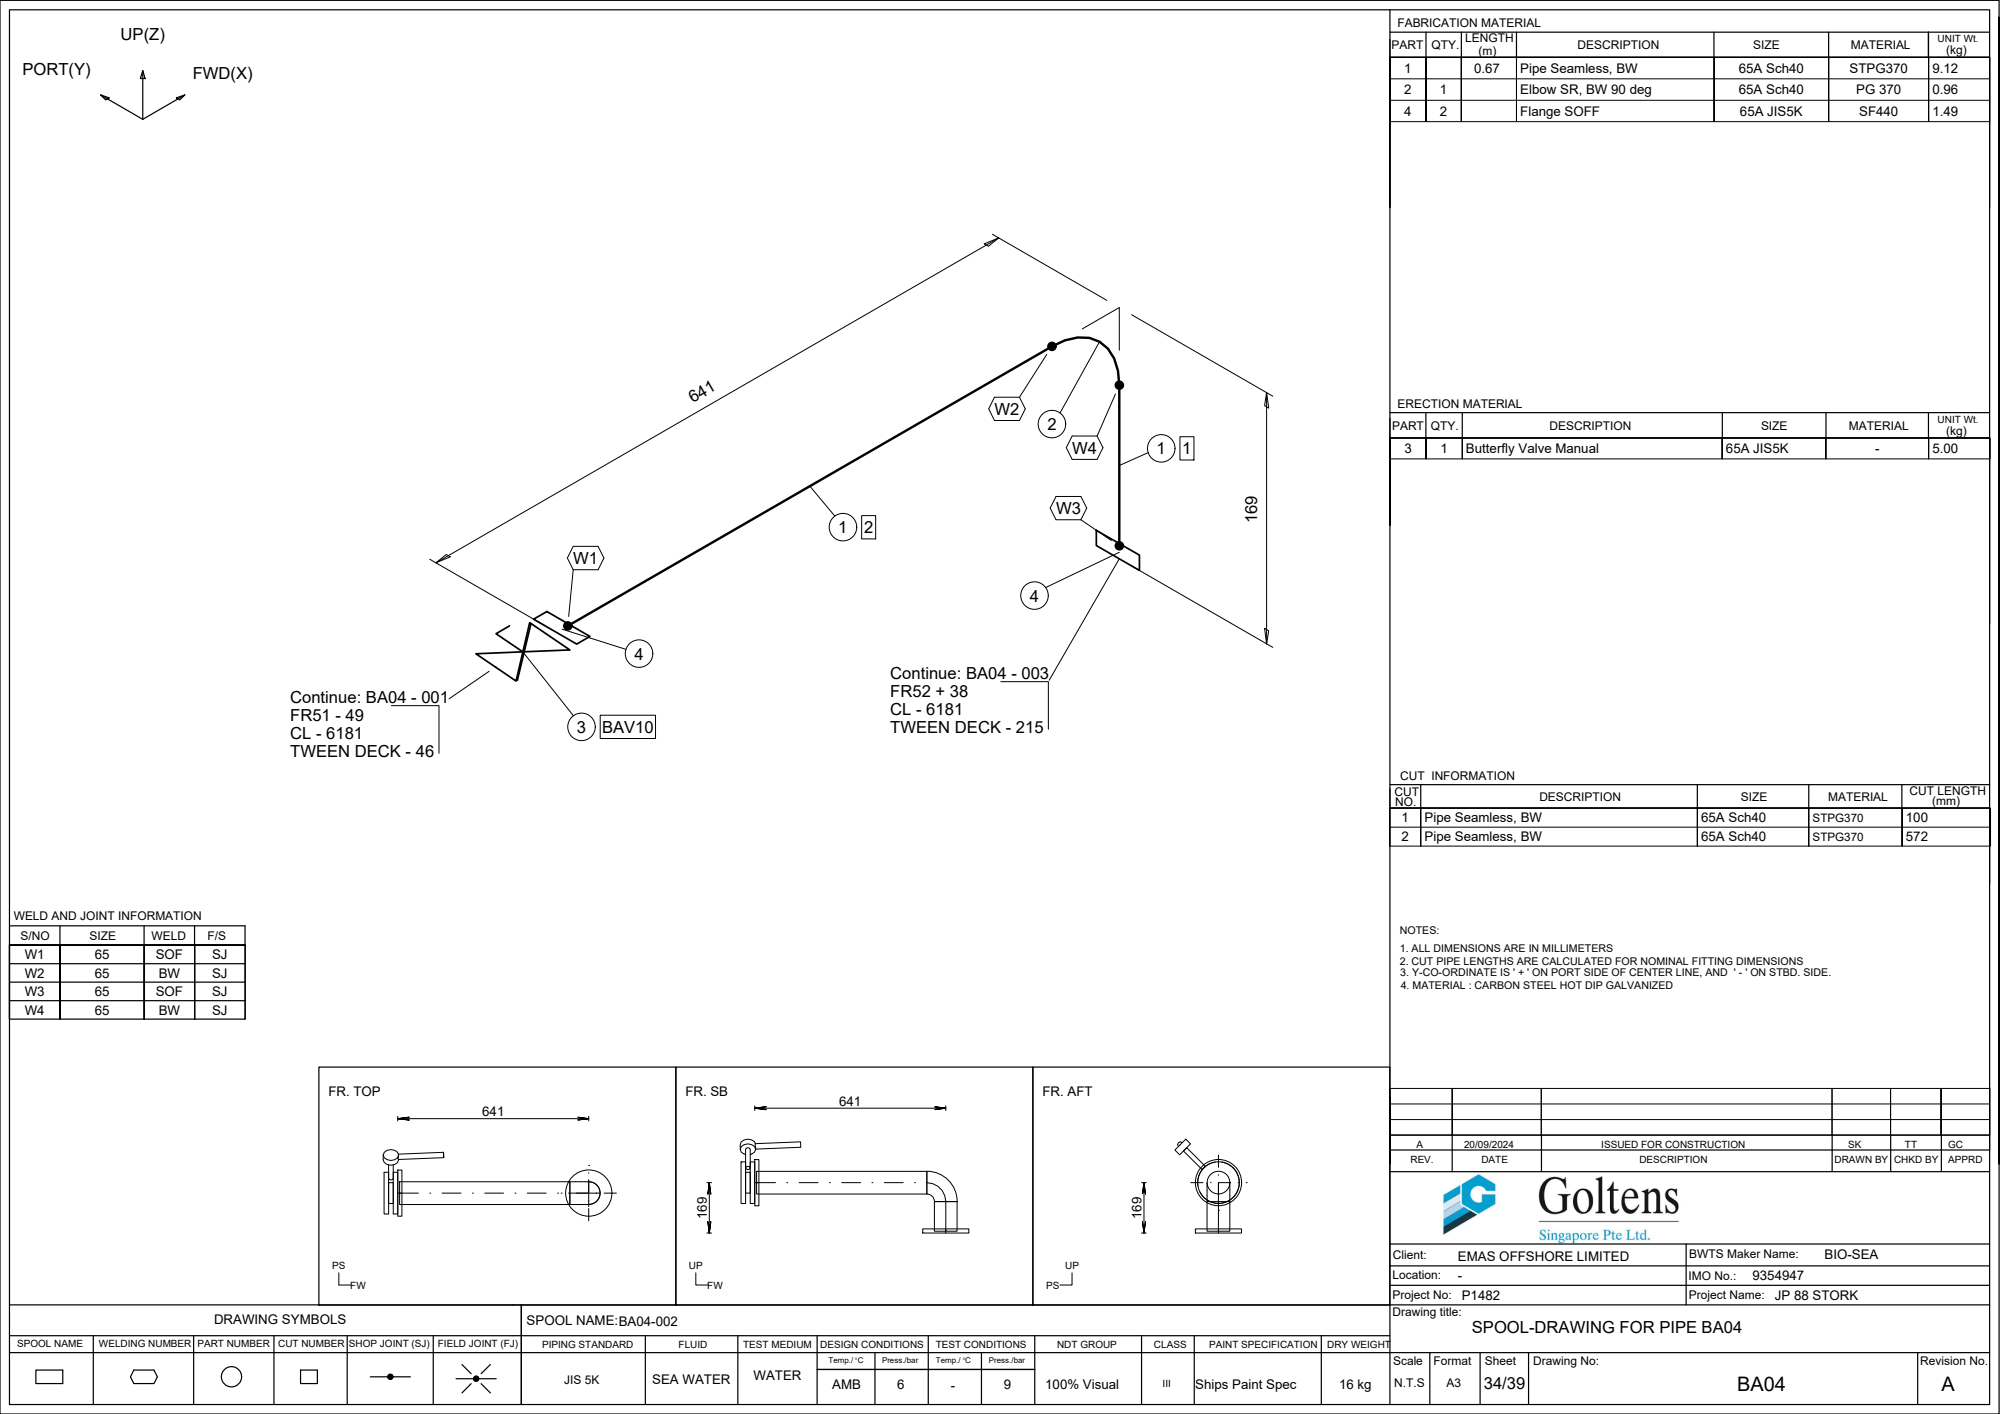
[picture p55: page 35]
FR. TOP; FR. AFT; AMB; Flange SOFF; 65A JIS5K; Butterfly Valve Manual; Pipe Seamless, BW; 65A Sch40; STPG370; REV.; DATE; DESCRIPTION; DRAWN BY; CHKD BY; APPRD; Location:; Client:; ERECTION MATERIAL; CUT INFORMATION; SIZE; WELD; PART; QTY.; MATERIAL; ISSUED FOR CONSTRUCTION; FR51 - 49 CL - 6181 TWEEN DECK - 46; Continue: BA04 - 001; CL - 6181 TWEEN DECK - 215; Continue: BA04 - 003; BAV10

1 | | 0.67 | Pipe Seamless, BW | 65A Sch40 | STPG370 | 9.12
2 | 1 | | Elbow SR, BW 90 deg | 65A Sch40 | PG 370 | 0.96

UNIT Wt. (kg)

4. MATERIAL : CARBON STEEL HOT DIP GALVANIZED 169

CUT NO. | DESCRIPTION | SIZE | MATERIAL | CUT LENGTH (mm)

1 | Pipe Seamless, BW | 65A Sch40 | STPG370 | 100

WELD AND JOINT INFORMATION

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

W1 | 65 | SOF | SJ
W2 | 65 | BW | SJ
W3 | 65 | SOF | SJ

- BIO-SEA
EMAS OFFSHORE LIMITED

BWTS Maker Name:

IMO No.: NDT GROUP

### PORT(Y) FWD(X)

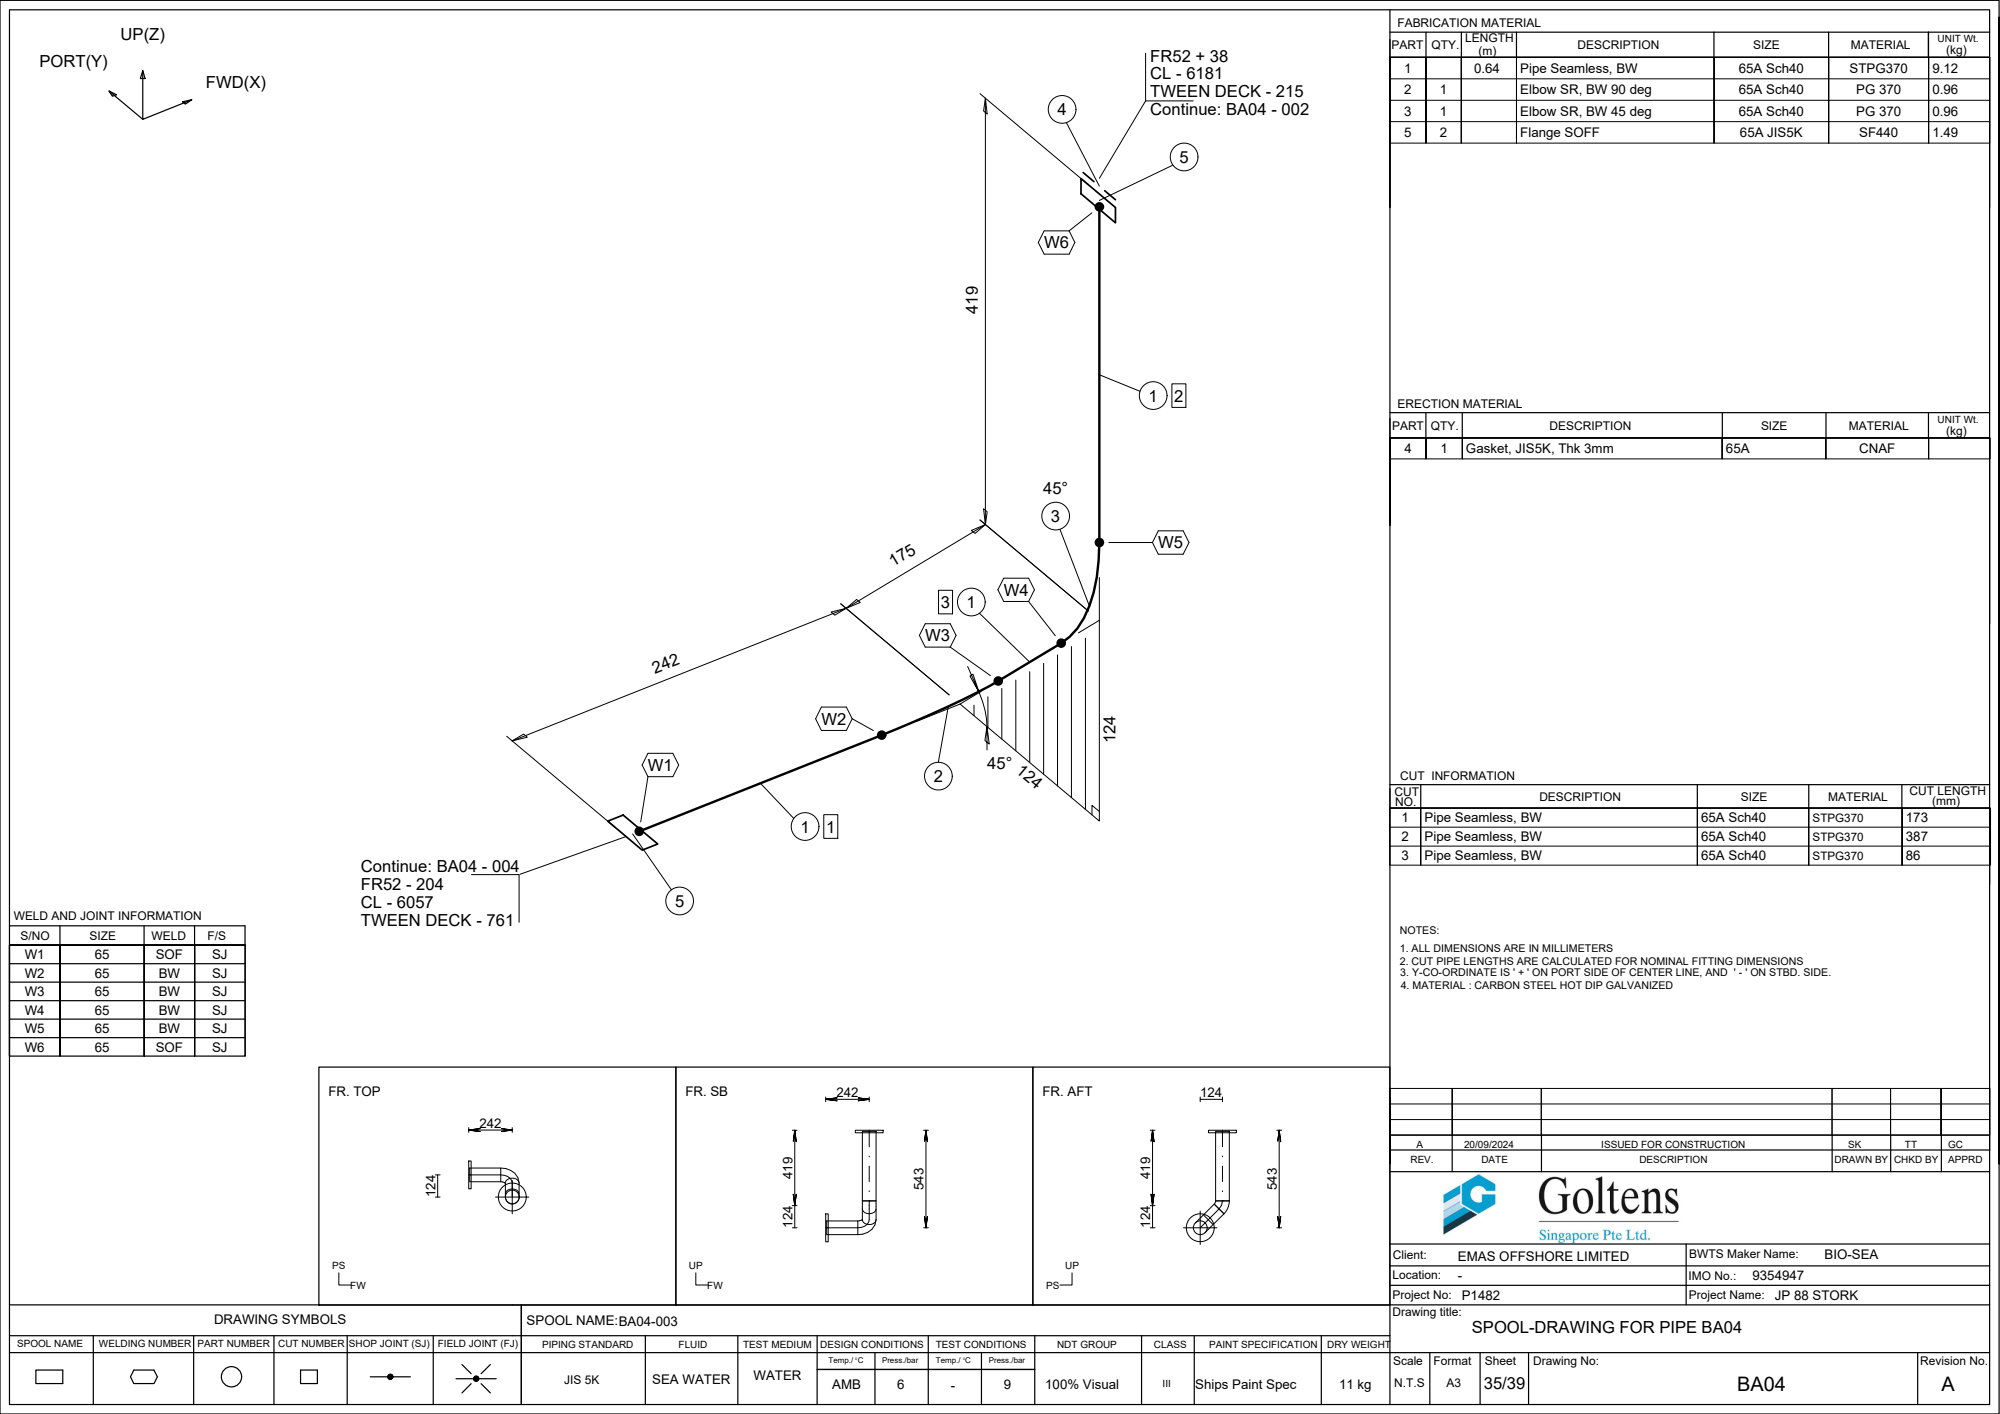
[picture p56: page 36]
FR. TOP; FR. AFT; AMB; Flange SOFF; 65A JIS5K; Gasket, JIS5K, Thk 3mm; CNAF; SOF; Pipe Seamless, BW; 65A Sch40; STPG370; REV.; DATE; DESCRIPTION; DRAWN BY; CHKD BY; APPRD; Location:; Client:; ERECTION MATERIAL; CUT INFORMATION; SIZE; WELD; PART; QTY.; MATERIAL; ISSUED FOR CONSTRUCTION; TWEEN DECK - 215; Continue: BA04 - 002; FR52 - 204 CL - 6057 TWEEN DECK - 761; Continue: BA04 - 004

1 | | 0.64 | Pipe Seamless, BW | 65A Sch40 | STPG370 | 9.12
2 | 1 | | Elbow SR, BW 90 deg | 65A Sch40 | PG 370 | 0.96
3 | 1 | | Elbow SR, BW 45 deg | 65A Sch40 | PG 370 | 0.96

UNIT Wt. (kg)

CUT NO. | DESCRIPTION | SIZE | MATERIAL | CUT LENGTH (mm)

1 | Pipe Seamless, BW | 65A Sch40 | STPG370 | 173
2 | Pipe Seamless, BW | 65A Sch40 | STPG370 | 387

WELD AND JOINT INFORMATION

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

W1 | 65 | SOF | SJ
W2 | 65 | BW | SJ
W3 | 65 | BW | SJ
W4 | 65 | BW | SJ
W5 | 65 | BW | SJ

- BIO-SEA
EMAS OFFSHORE LIMITED

BWTS Maker Name:

IMO No.: NDT GROUP

### TWEEN DECK - 761

CL - 6057

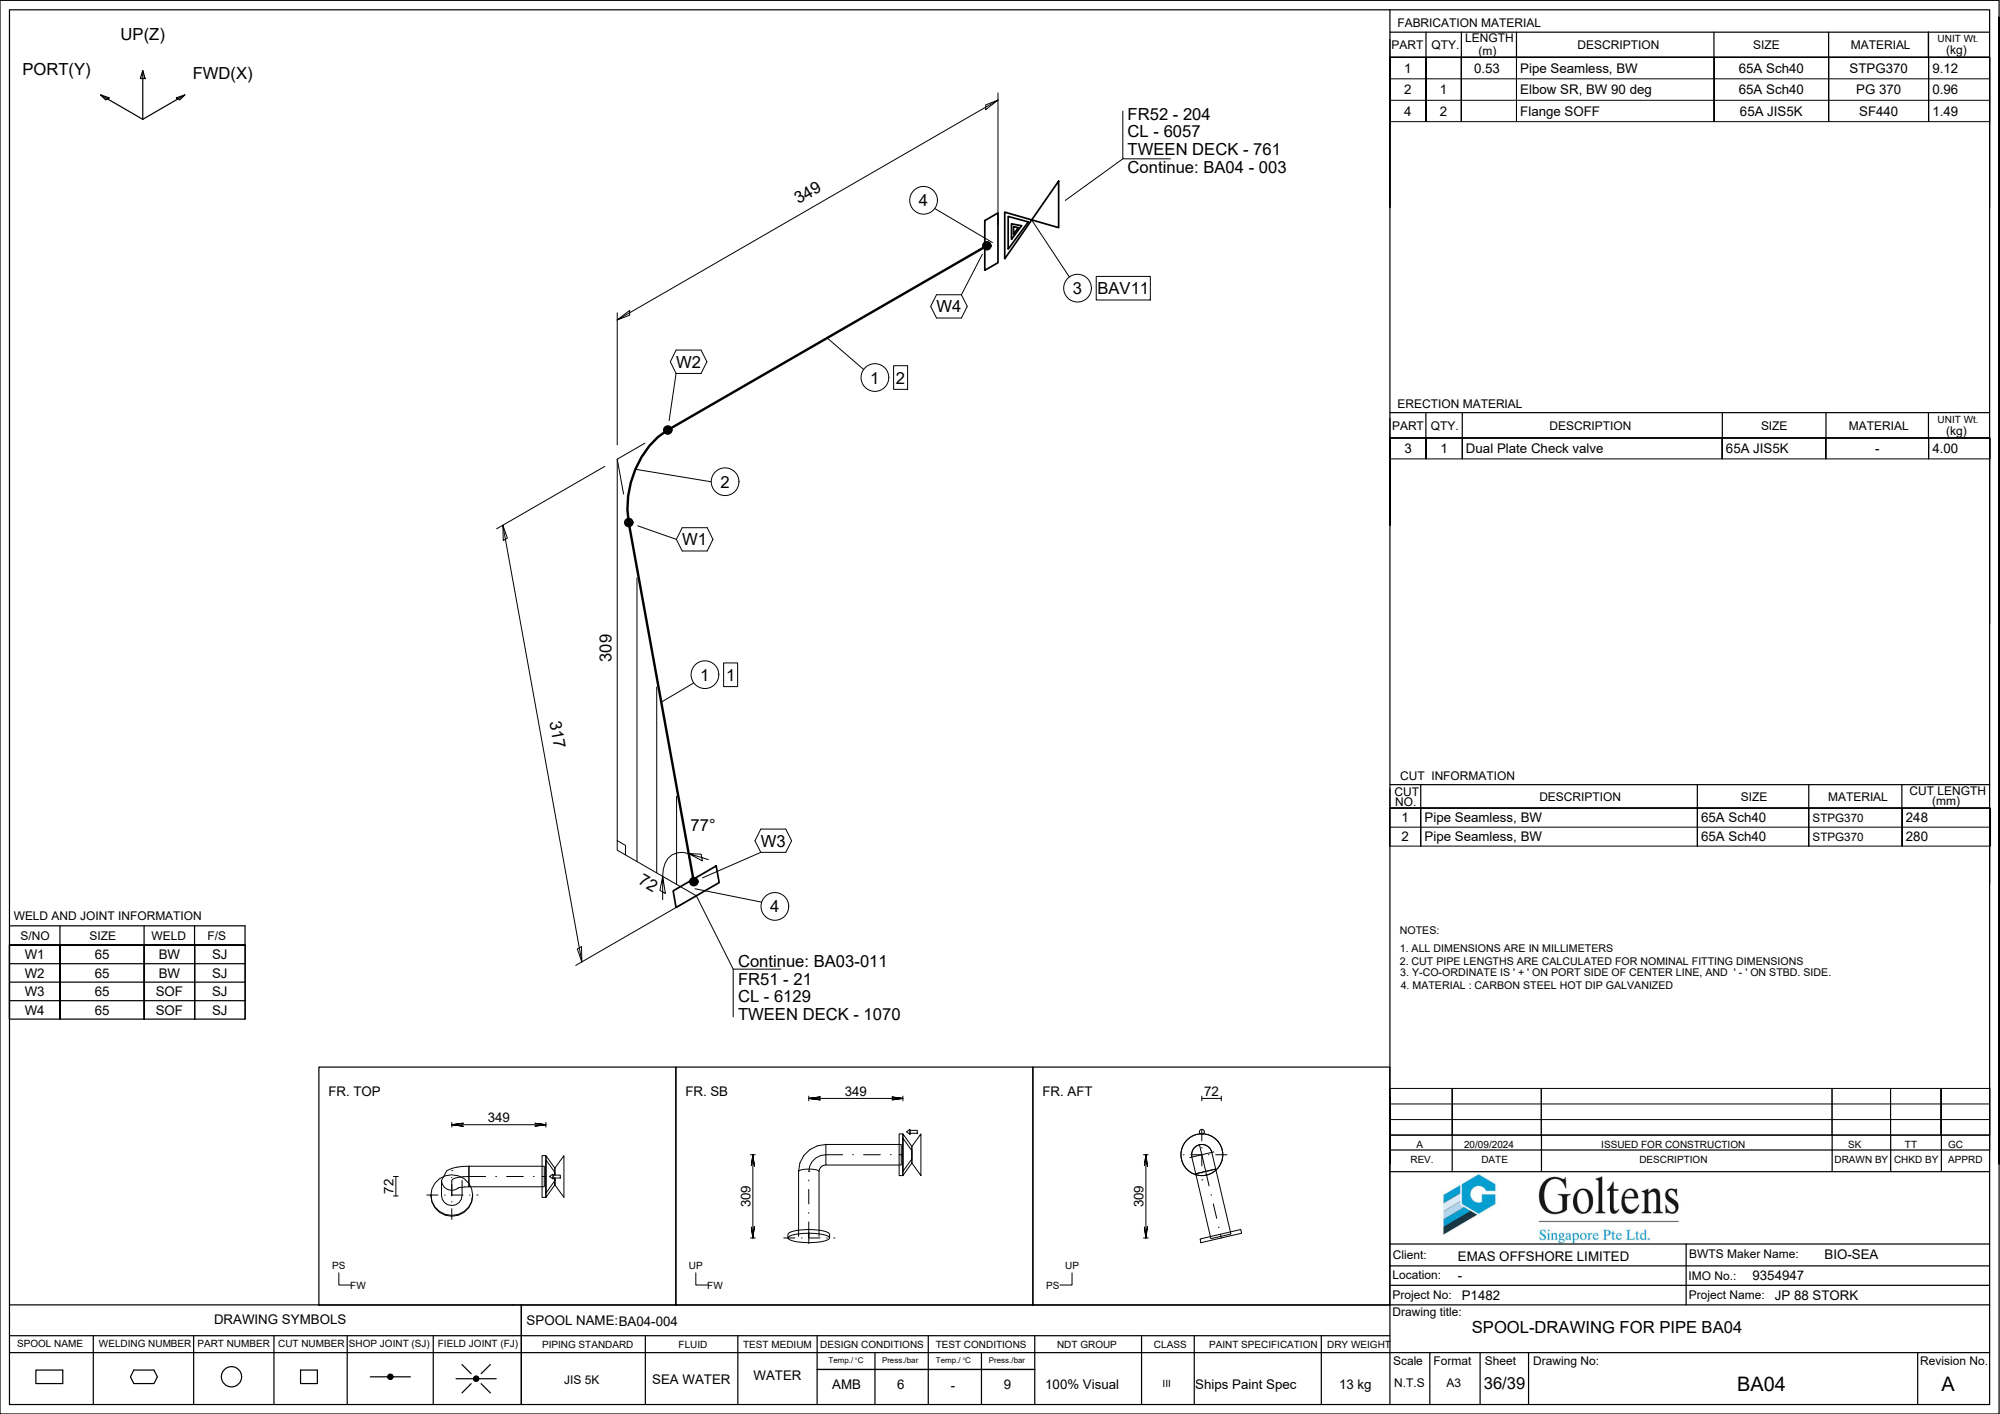
[picture p57: page 37]
FR. TOP; FR. AFT; AMB; Flange SOFF; 65A JIS5K; Dual Plate Check valve; SOF; Pipe Seamless, BW; 65A Sch40; STPG370; REV.; DATE; DESCRIPTION; DRAWN BY; CHKD BY; APPRD; Location:; Client:; ERECTION MATERIAL; CUT INFORMATION; SIZE; WELD; PART; QTY.; MATERIAL; ISSUED FOR CONSTRUCTION; Continue: BA04 - 003; FR51 - 21 CL - 6129 TWEEN DECK - 1070; Continue: BA03-011; BAV11

1 | | 0.53 | Pipe Seamless, BW | 65A Sch40 | STPG370 | 9.12
2 | 1 | | Elbow SR, BW 90 deg | 65A Sch40 | PG 370 | 0.96

UNIT Wt. (kg)

CUT NO. | DESCRIPTION | SIZE | MATERIAL | CUT LENGTH (mm)

1 | Pipe Seamless, BW | 65A Sch40 | STPG370 | 248

WELD AND JOINT INFORMATION

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

W1 | 65 | BW | SJ
W2 | 65 | BW | SJ
W3 | 65 | SOF | SJ

- BIO-SEA
EMAS OFFSHORE LIMITED

BWTS Maker Name:

IMO No.: NDT GROUP

### PORT(Y) FWD(X)

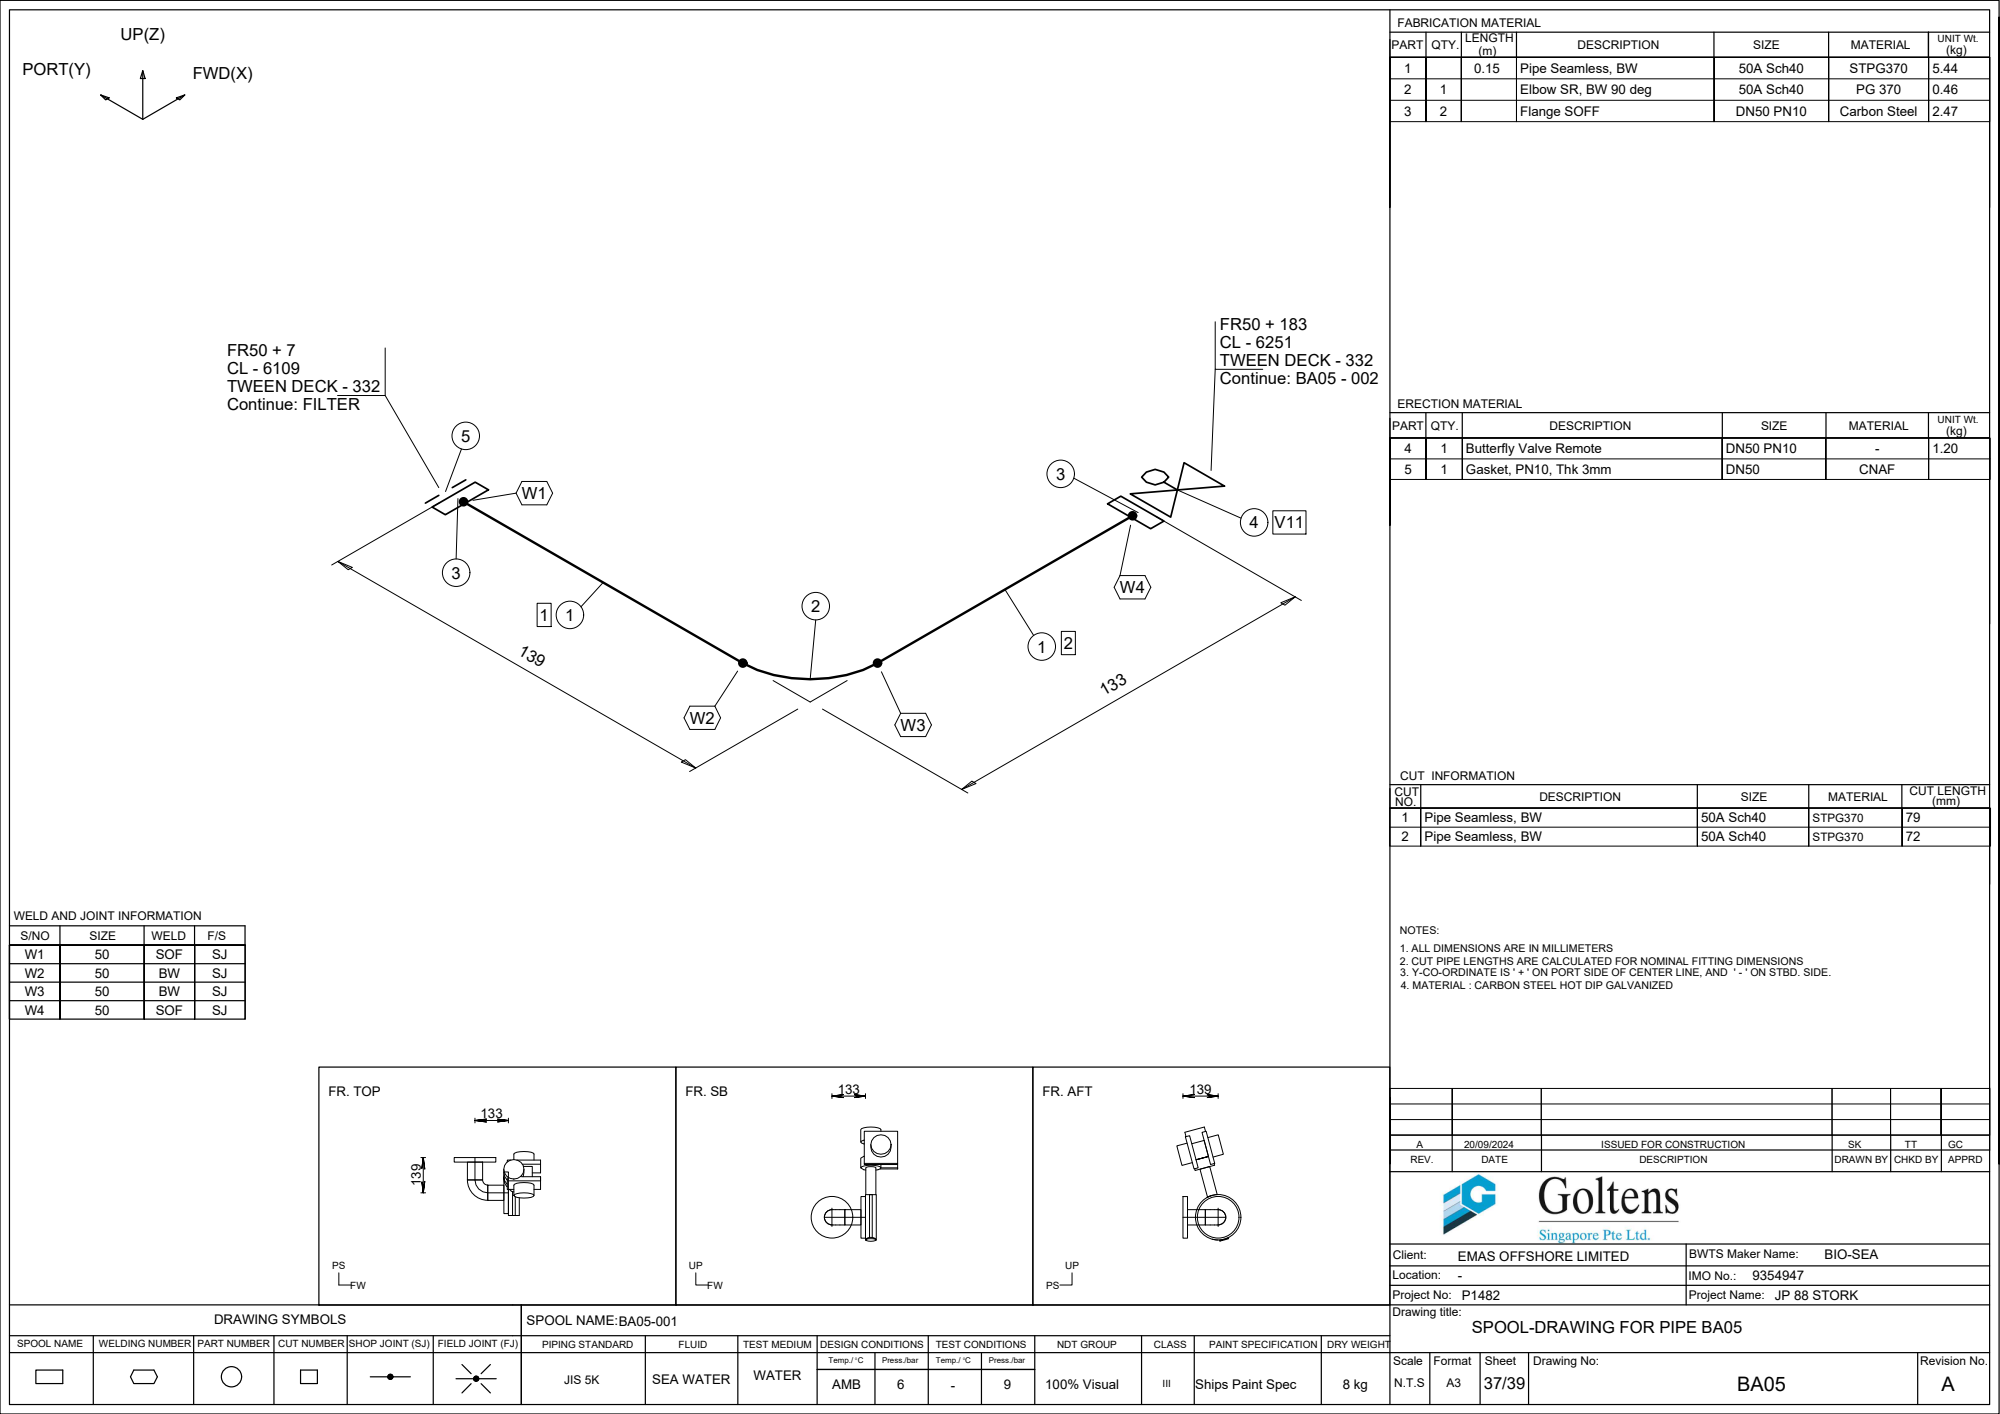
[picture p58: page 38]
FR. TOP; FR. AFT; AMB; Flange SOFF; Carbon Steel; Gasket, PN10, Thk 3mm; CNAF; SOF; Pipe Seamless, BW; 50A Sch40; STPG370; REV.; DATE; DESCRIPTION; DRAWN BY; CHKD BY; APPRD; Location:; Client:; ERECTION MATERIAL; CUT INFORMATION; SIZE; WELD; ISSUED FOR CONSTRUCTION; TWEEN DECK - 332

1 | | 0.15 | Pipe Seamless, BW | 50A Sch40 | STPG370 | 5.44
2 | 1 | | Elbow SR, BW 90 deg | 50A Sch40 | PG 370 | 0.46

Continue: BA05 - 002 TWEEN DECK - 332
Continue: FILTER

PART | QTY. | DESCRIPTION | SIZE | MATERIAL | UNIT Wt. (kg)

4 | 1 | Butterfly Valve Remote | DN50 PN10 | - | 1.20

CUT NO. | DESCRIPTION | SIZE | MATERIAL | CUT LENGTH (mm)

1 | Pipe Seamless, BW | 50A Sch40 | STPG370 | 79

WELD AND JOINT INFORMATION

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

W1 | 50 | SOF | SJ
W2 | 50 | BW | SJ
W3 | 50 | BW | SJ

- BIO-SEA
EMAS OFFSHORE LIMITED

BWTS Maker Name:

IMO No.: NDT GROUP

### TWEEN DECK - 332

FR51 + 177

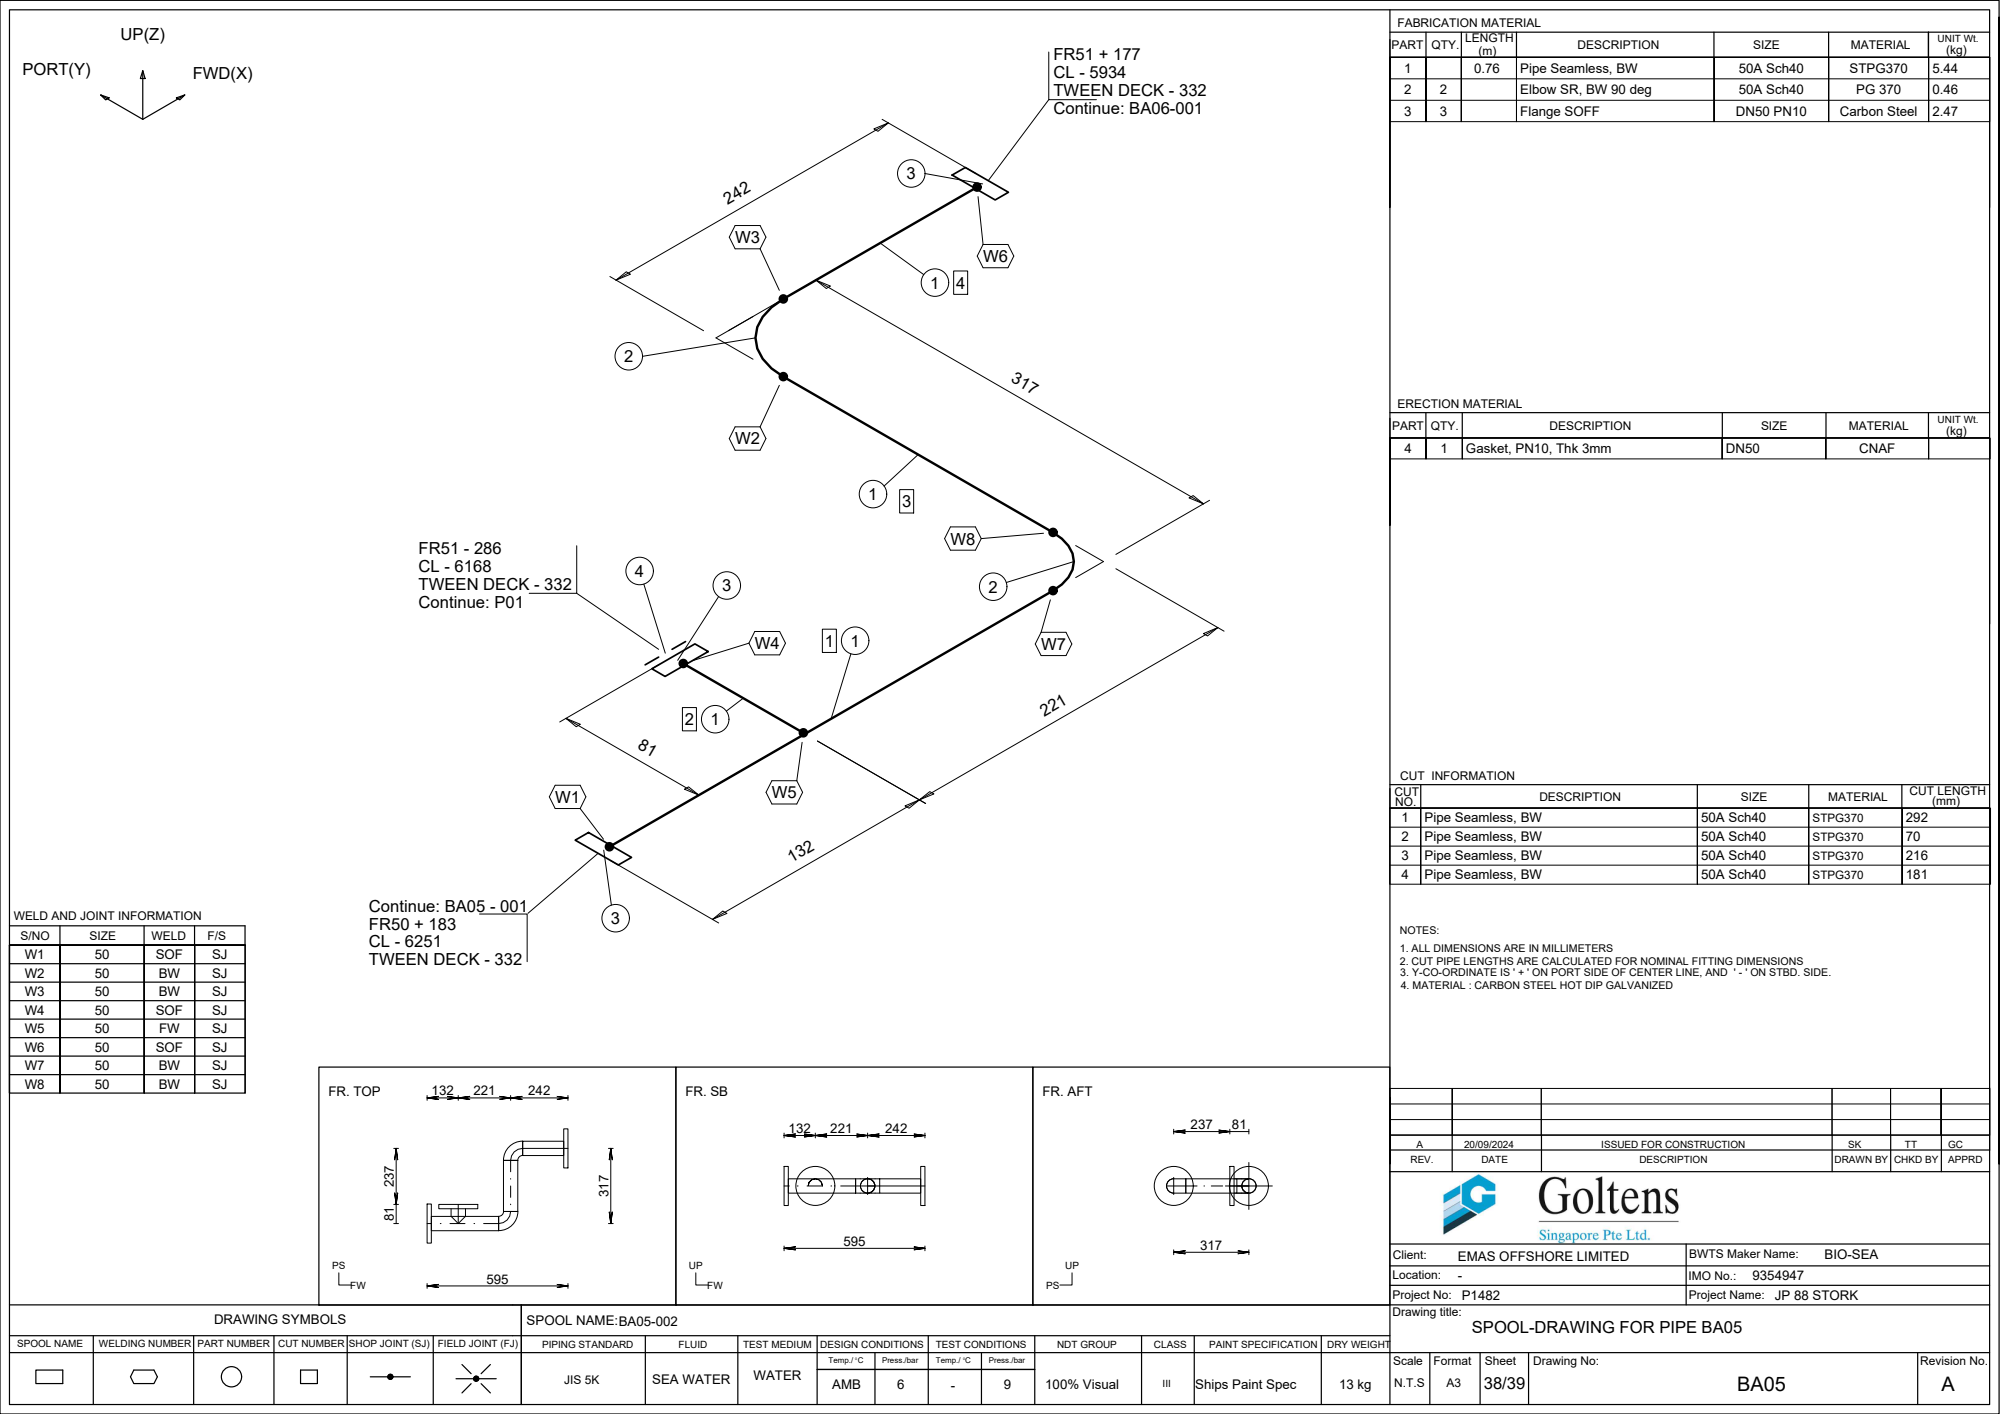
[picture p59: page 39]
FR. TOP; FR. AFT; AMB; Flange SOFF; Carbon Steel; Gasket, PN10, Thk 3mm; CNAF; Pipe Seamless, BW; 50A Sch40; STPG370; REV.; DATE; DESCRIPTION; DRAWN BY; CHKD BY; APPRD; Location:; Client:; ERECTION MATERIAL; CUT INFORMATION; SIZE; WELD; PART; QTY.; MATERIAL; ISSUED FOR CONSTRUCTION; Continue: BA06-001; FR50 + 183 CL - 6251 TWEEN DECK - 332; Continue: BA05 - 001; TWEEN DECK - 332; Continue: P01

1 | | 0.76 | Pipe Seamless, BW | 50A Sch40 | STPG370 | 5.44
2 | 2 | | Elbow SR, BW 90 deg | 50A Sch40 | PG 370 | 0.46

UNIT Wt. (kg)

CUT NO. | DESCRIPTION | SIZE | MATERIAL | CUT LENGTH (mm)

1 | Pipe Seamless, BW | 50A Sch40 | STPG370 | 292
2 | Pipe Seamless, BW | 50A Sch40 | STPG370 | 70
3 | Pipe Seamless, BW | 50A Sch40 | STPG370 | 216

WELD AND JOINT INFORMATION

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

W1 | 50 | SOF | SJ
W2 | 50 | BW | SJ
W3 | 50 | BW | SJ
W4 | 50 | SOF | SJ
W5 | 50 | FW | SJ
W6 | 50 | SOF | SJ
W7 | 50 | BW | SJ

- BIO-SEA
EMAS OFFSHORE LIMITED

BWTS Maker Name:

IMO No.: NDT GROUP

### FWD(X)

PORT(Y) | 150 | 150

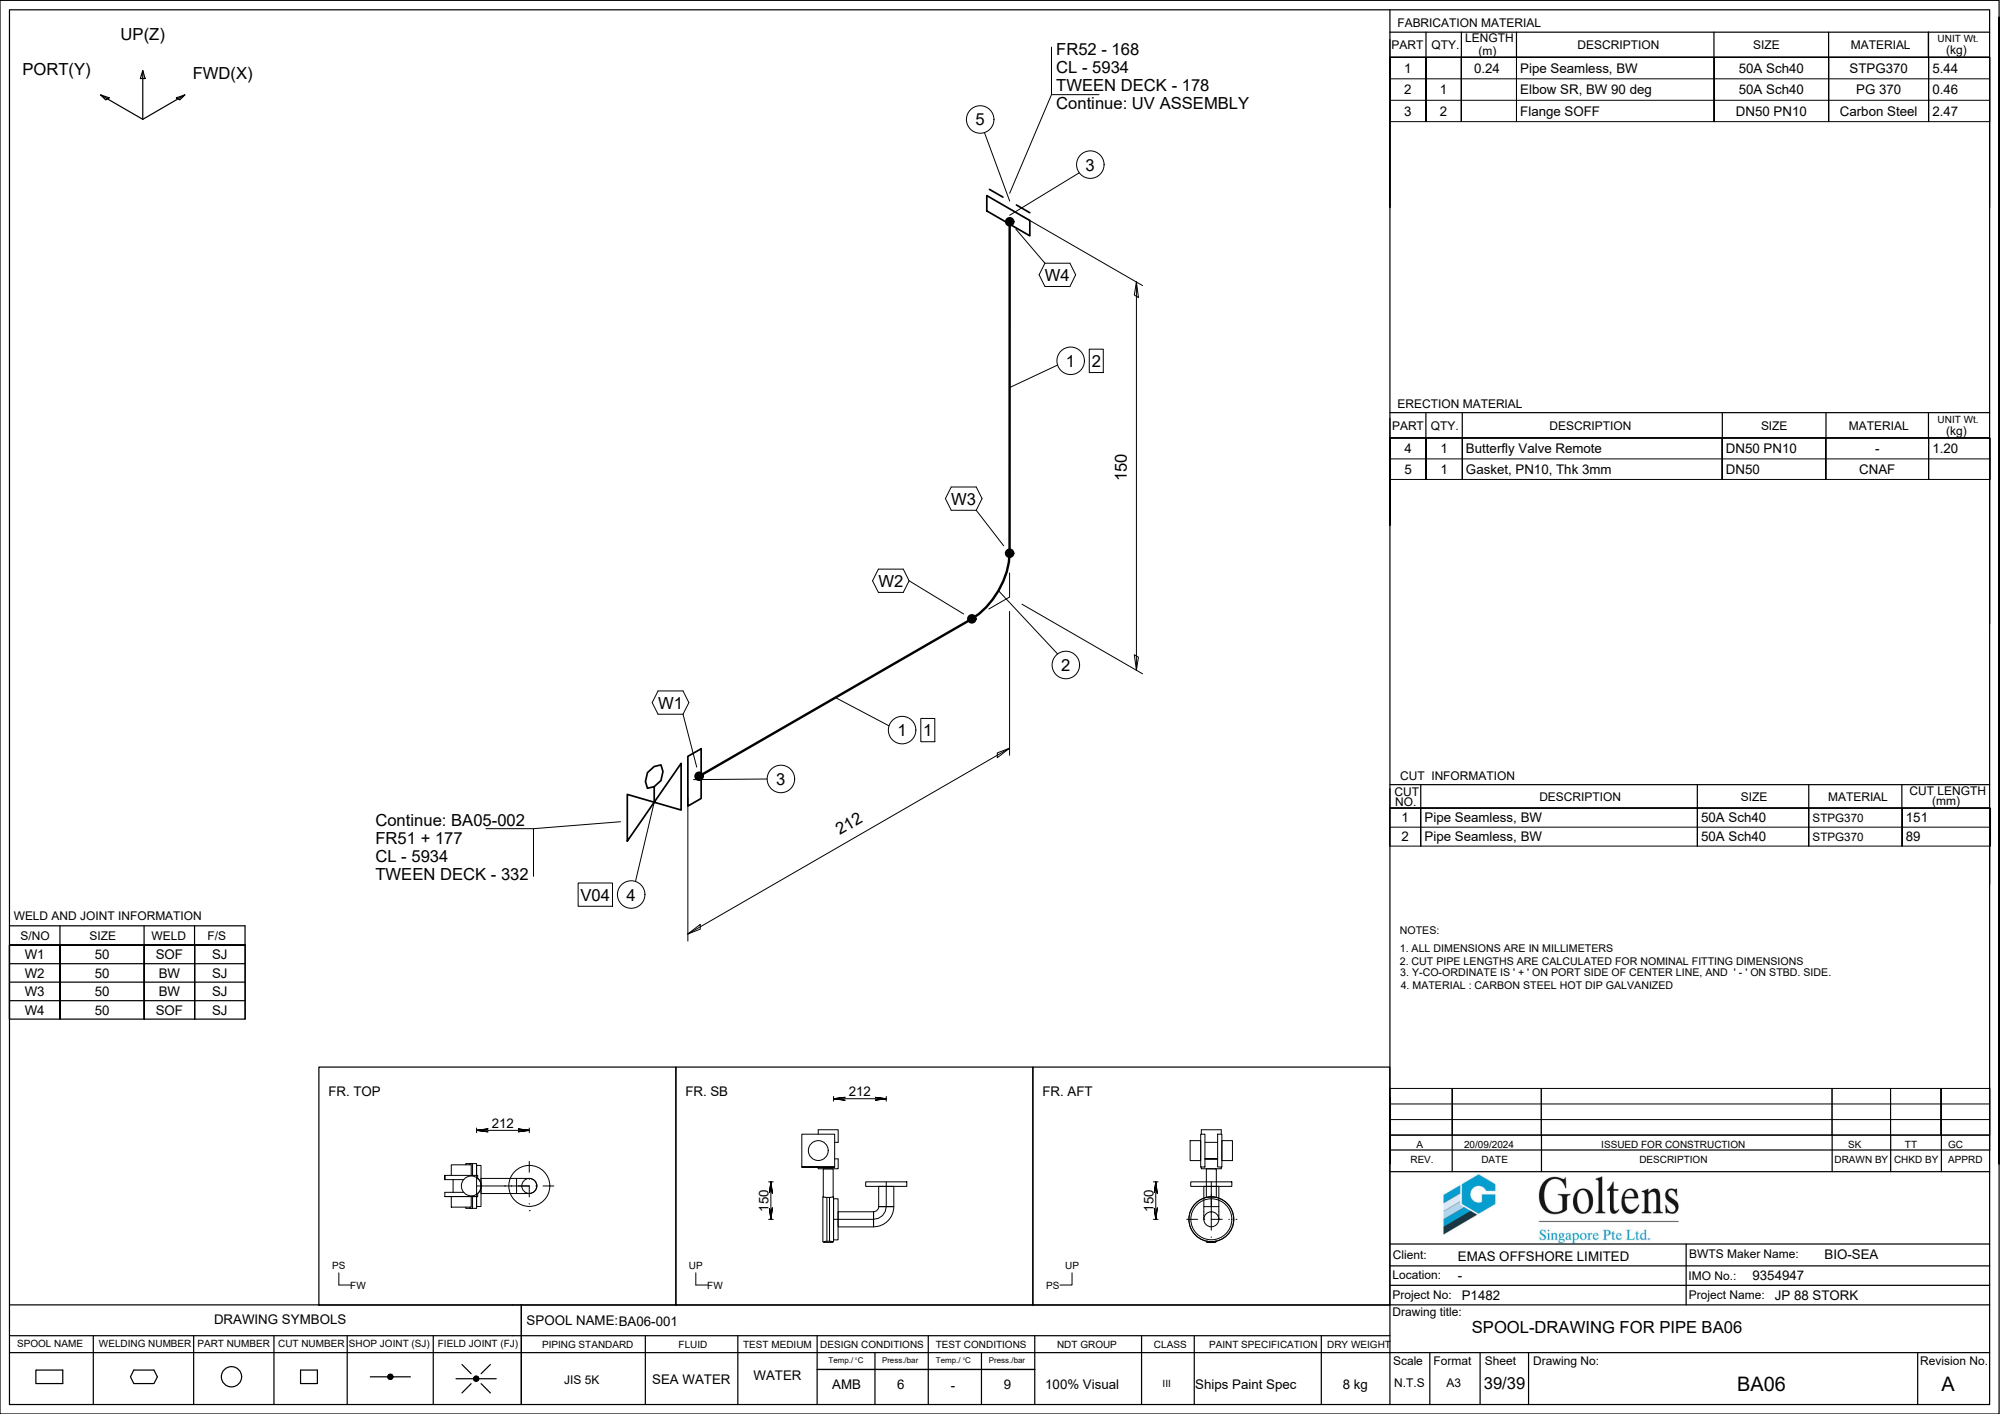
[picture p60: page 40]
FR. TOP; FR. AFT; AMB; Flange SOFF; Carbon Steel; Gasket, PN10, Thk 3mm; CNAF; SOF; Pipe Seamless, BW; 50A Sch40; STPG370; REV.; DATE; DESCRIPTION; DRAWN BY; CHKD BY; APPRD; Location:; Client:; ERECTION MATERIAL; CUT INFORMATION; SIZE; WELD; ISSUED FOR CONSTRUCTION; FR51 + 177 CL - 5934 TWEEN DECK - 332; Continue: BA05-002

1 | | 0.24 | Pipe Seamless, BW | 50A Sch40 | STPG370 | 5.44
2 | 1 | | Elbow SR, BW 90 deg | 50A Sch40 | PG 370 | 0.46

TWEEN DECK - 178
Continue: UV ASSEMBLY

PART | QTY. | DESCRIPTION | SIZE | MATERIAL | UNIT Wt. (kg)

4 | 1 | Butterfly Valve Remote | DN50 PN10 | - | 1.20

CUT NO. | DESCRIPTION | SIZE | MATERIAL | CUT LENGTH (mm)

1 | Pipe Seamless, BW | 50A Sch40 | STPG370 | 151

WELD AND JOINT INFORMATION

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

W1 | 50 | SOF | SJ
W2 | 50 | BW | SJ
W3 | 50 | BW | SJ

- BIO-SEA
EMAS OFFSHORE LIMITED

BWTS Maker Name:

IMO No.: NDT GROUP

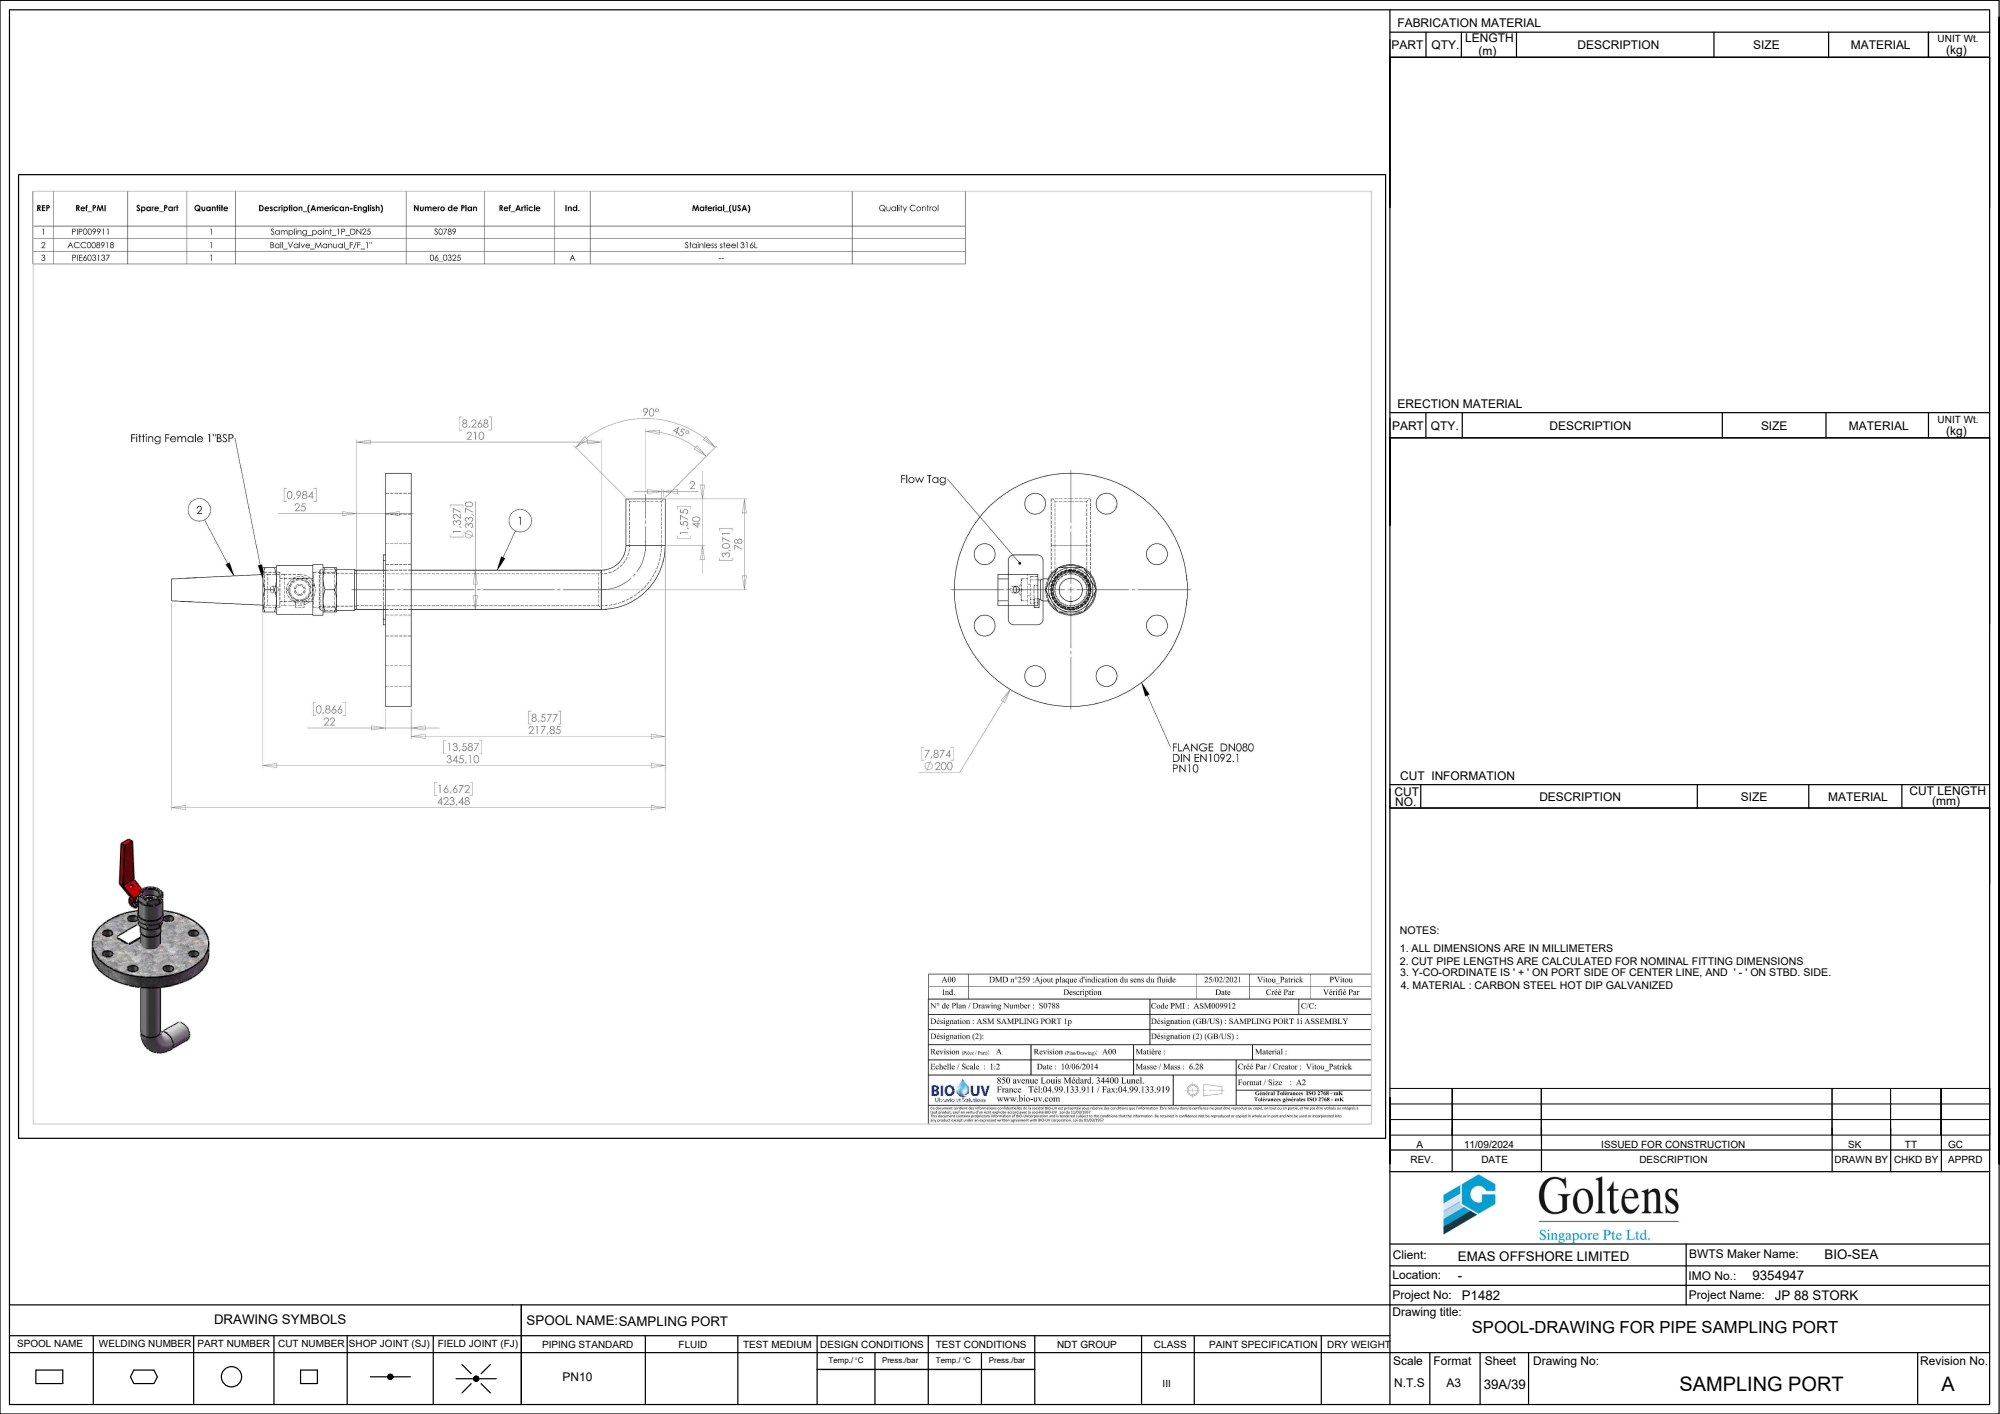
[picture p61: page 41]
SAMPLING PORT; REV.; DATE; DESCRIPTION; DRAWN BY; CHKD BY; APPRD; Location:; Client:; ERECTION MATERIAL; CUT; SIZE; MATERIAL; CUT INFORMATION; PART; QTY.; CUT LENGTH (mm); ISSUED FOR CONSTRUCTION

UNIT Wt. (kg)

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

- BIO-SEA
EMAS OFFSHORE LIMITED

BWTS Maker Name:

IMO No.: NDT GROUP
