anurakj/J88_stork/0)_old_revisions/GSPL-P1482-PI-0001 BWTS PIPING SCHEMATIC R.C.pdf

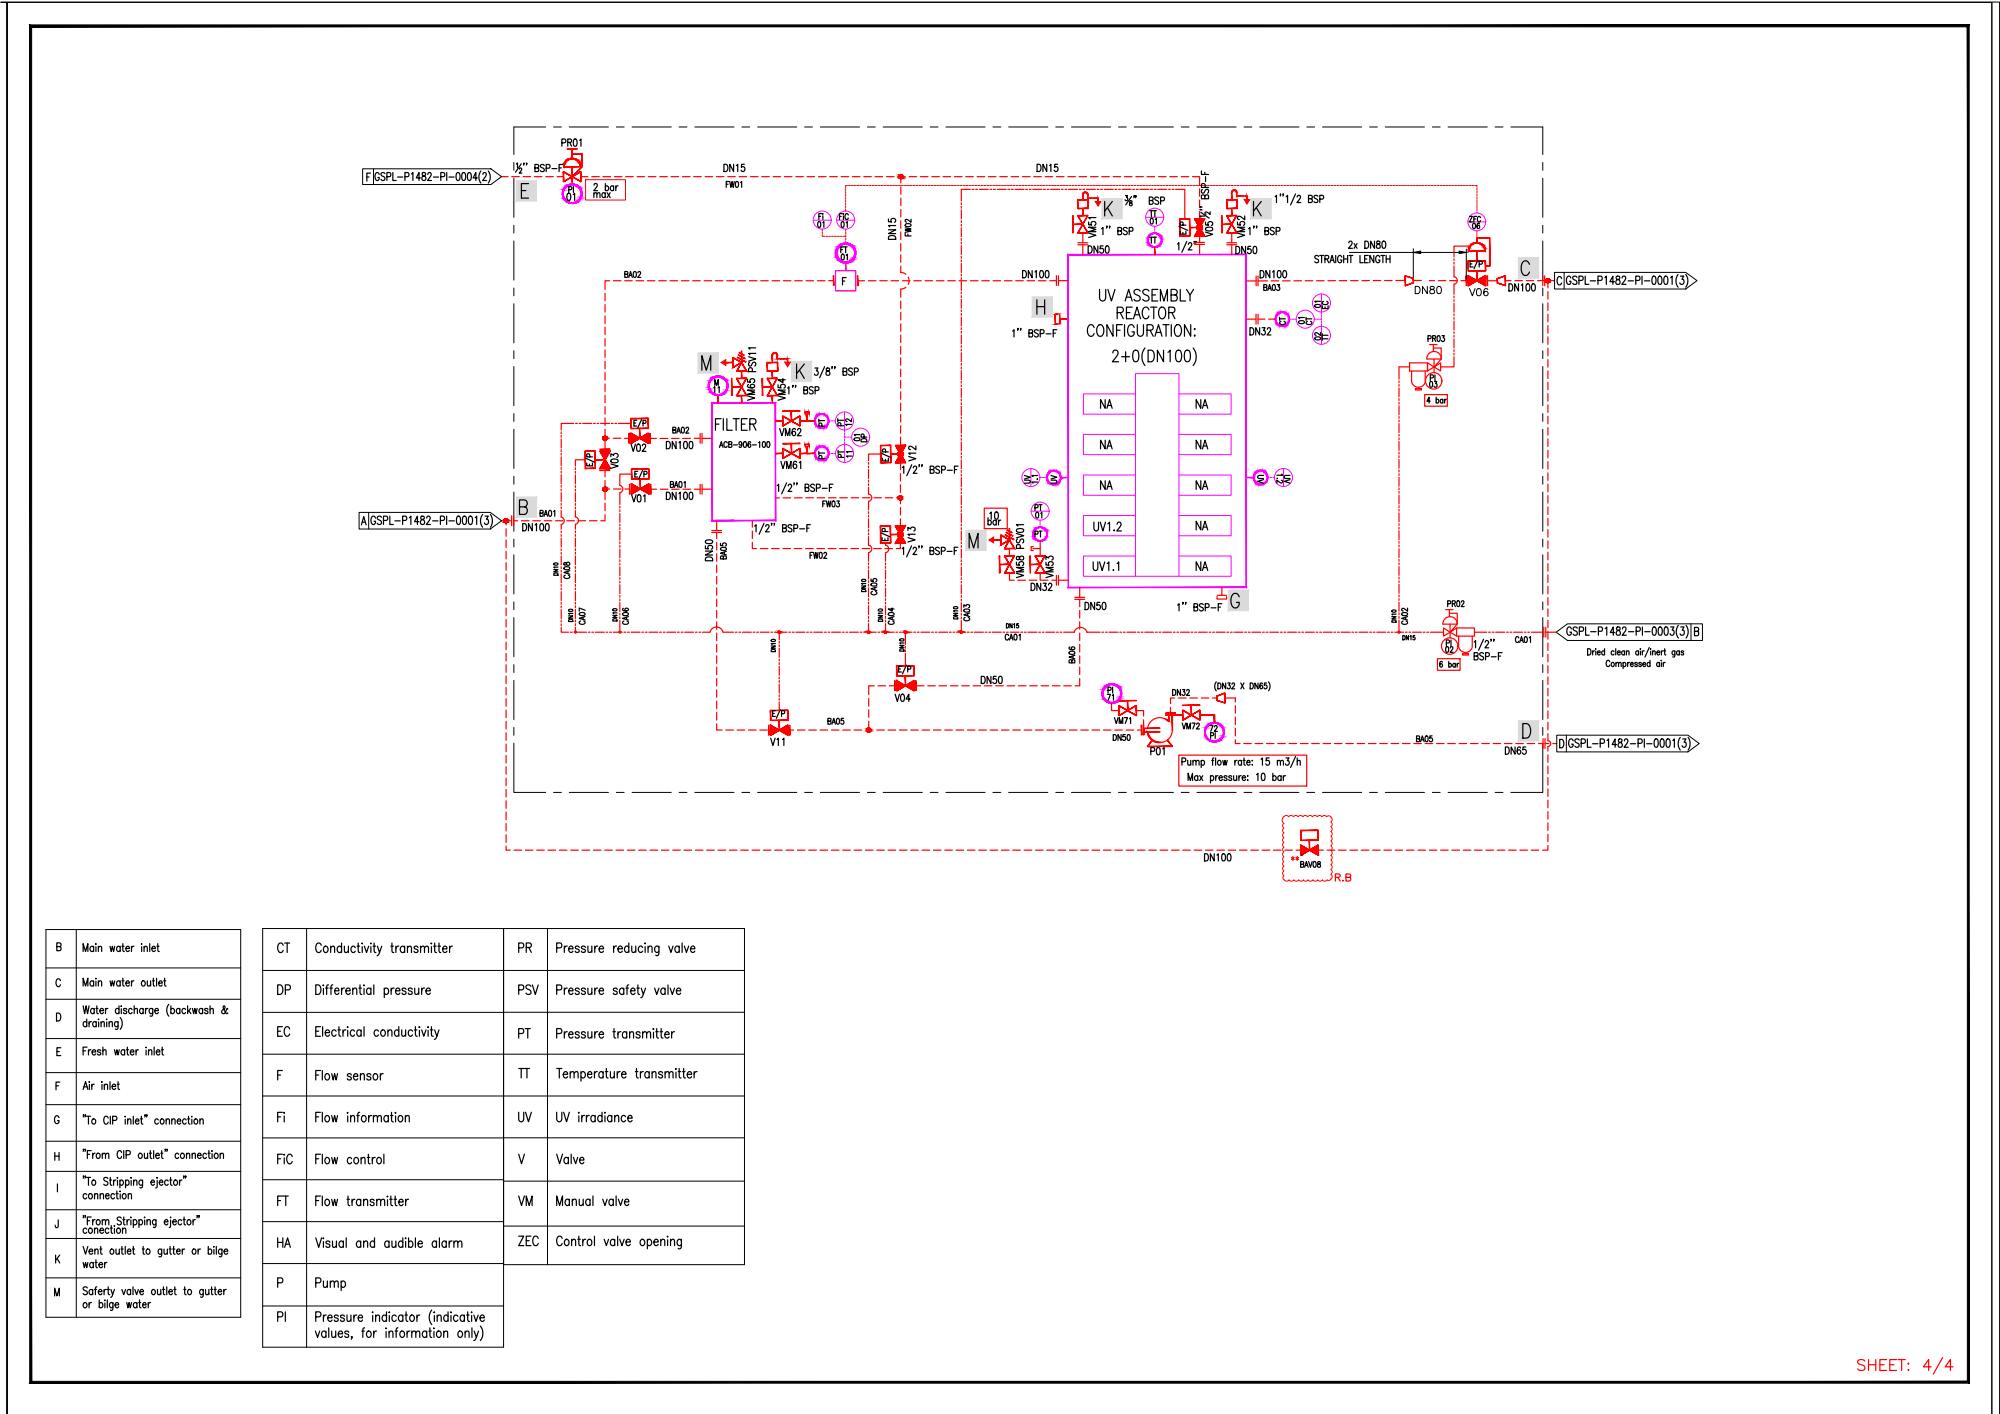
[picture p162: page 4]
