anurakj/J88_stork/Bypass_valves_logic_box/0)_old_revisions/Bypass_valves_box_schematics_rev_A.pdf

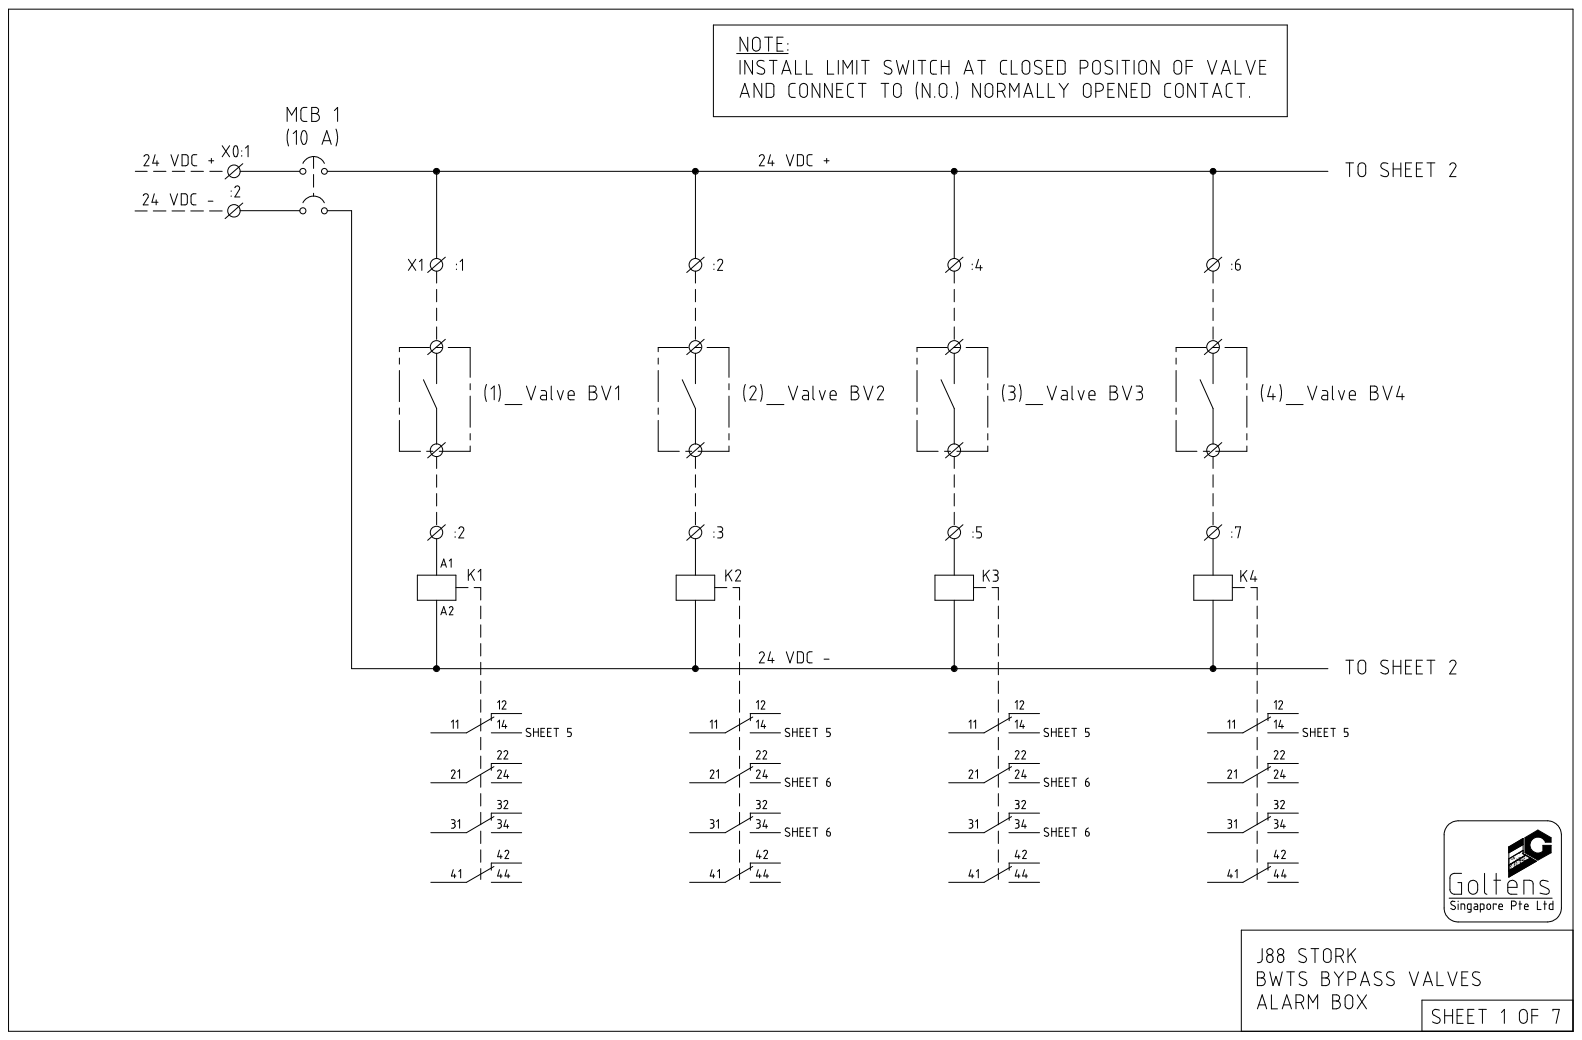
[picture p163: page 1]
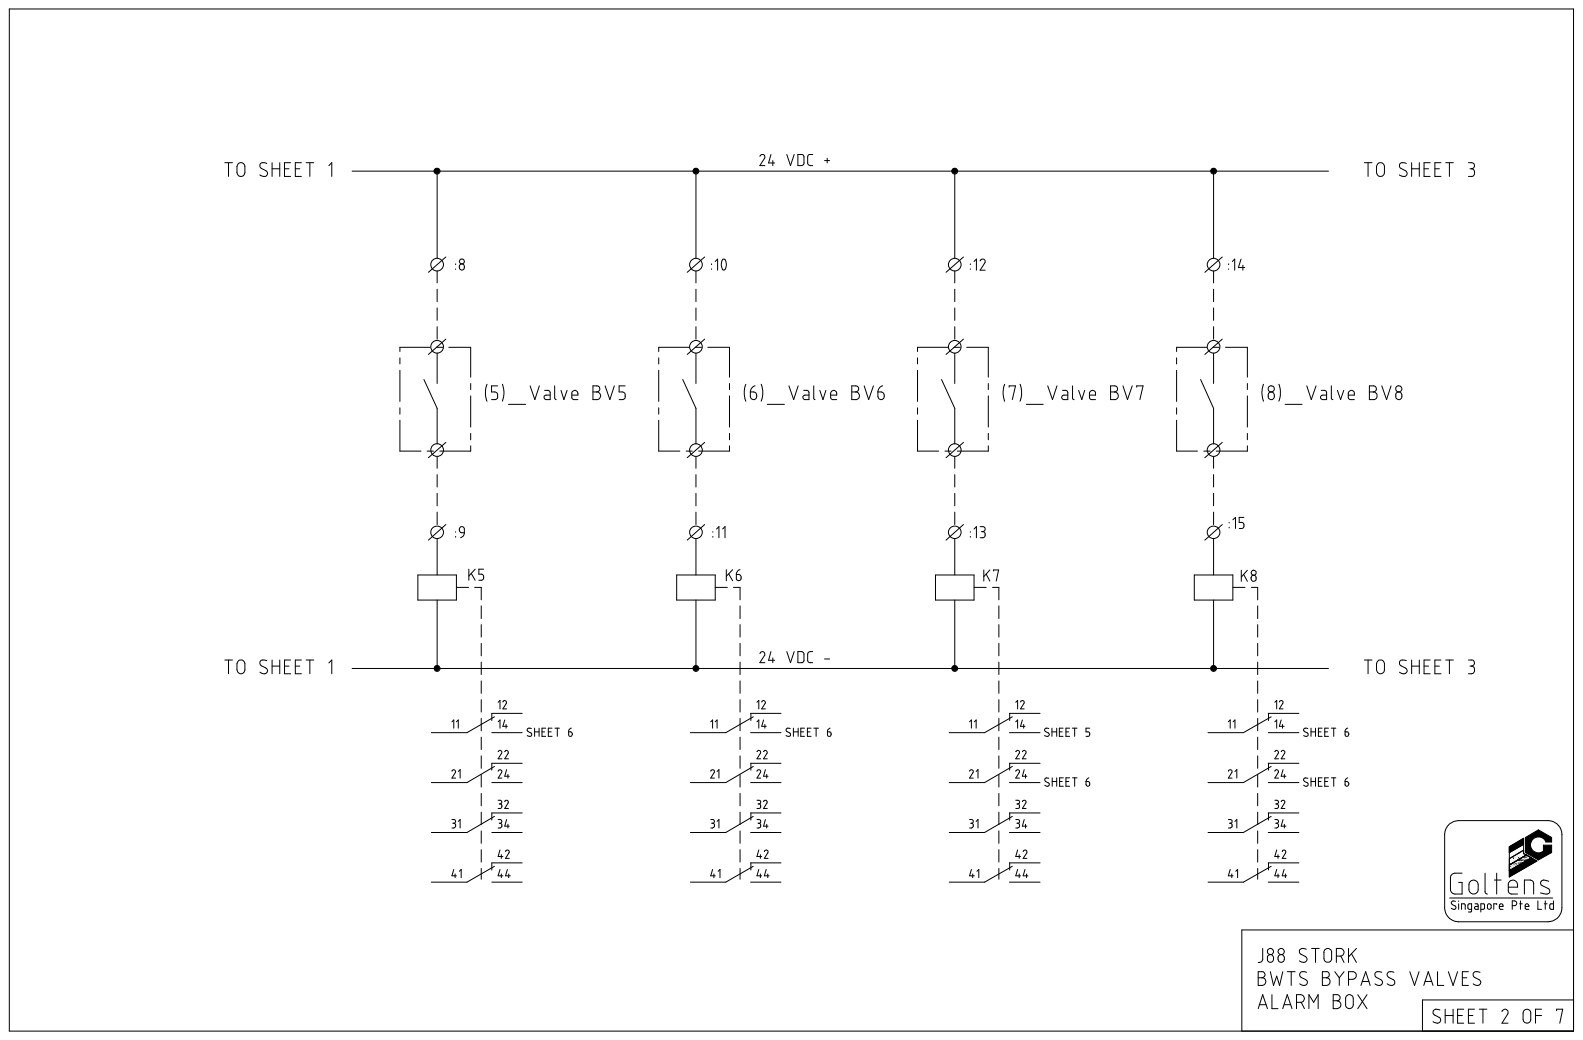
[picture p164: page 2]
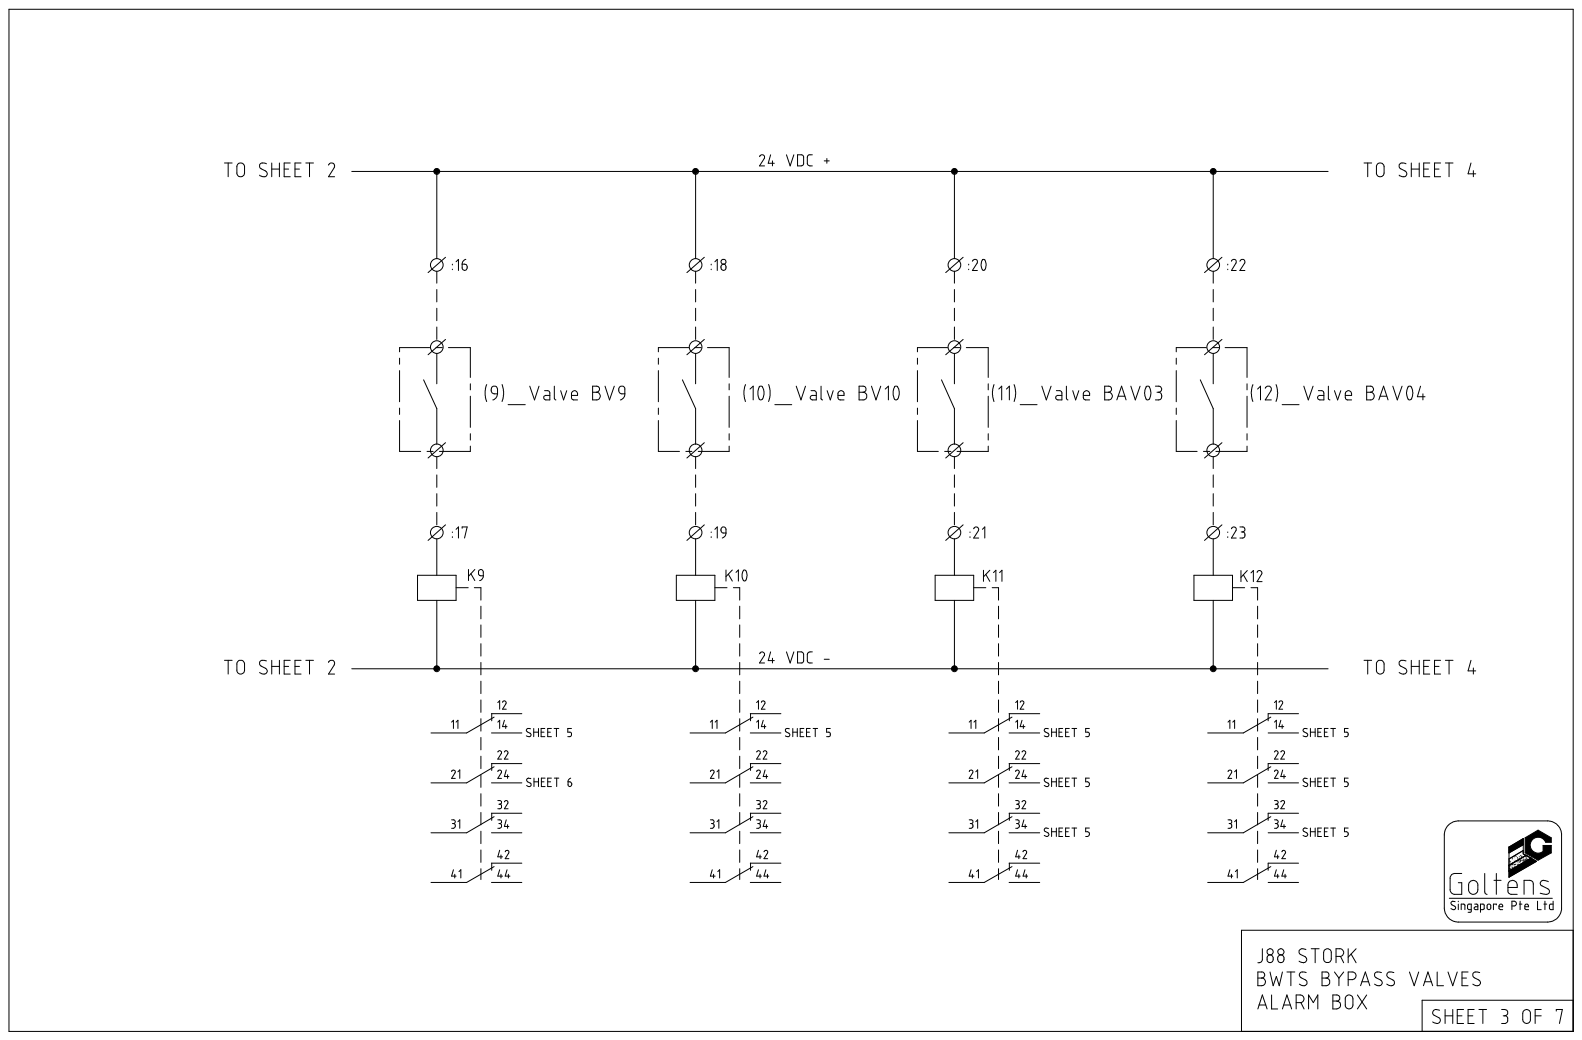
[picture p165: page 3]
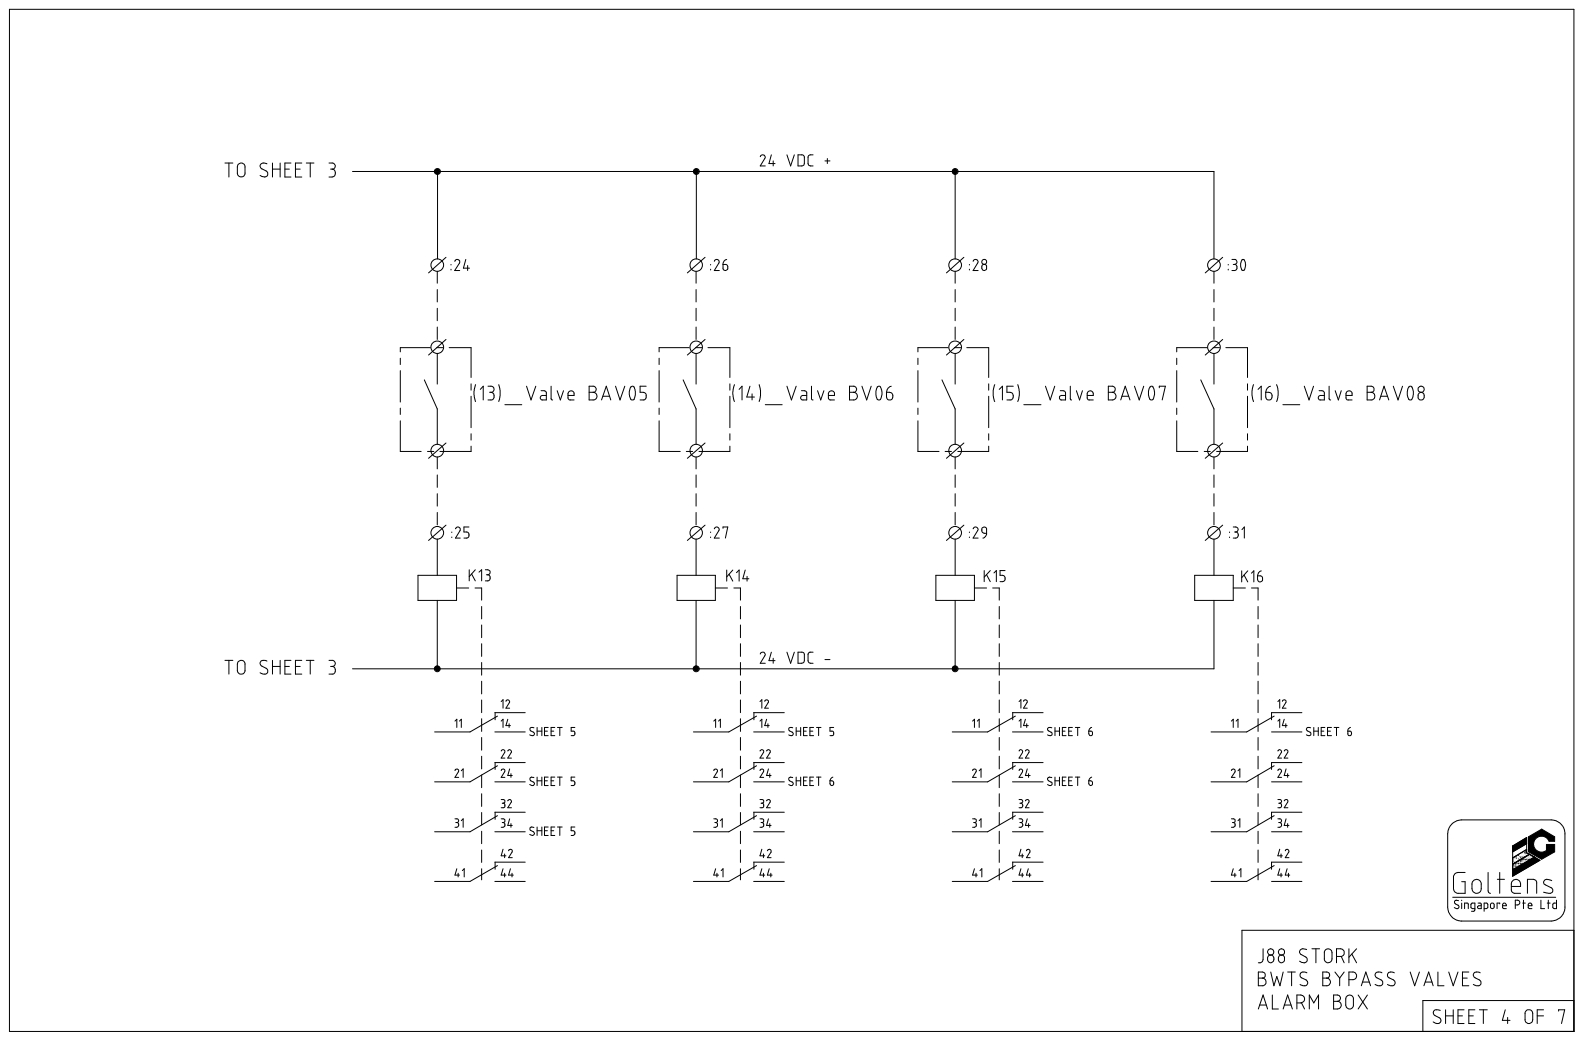
[picture p166: page 4]
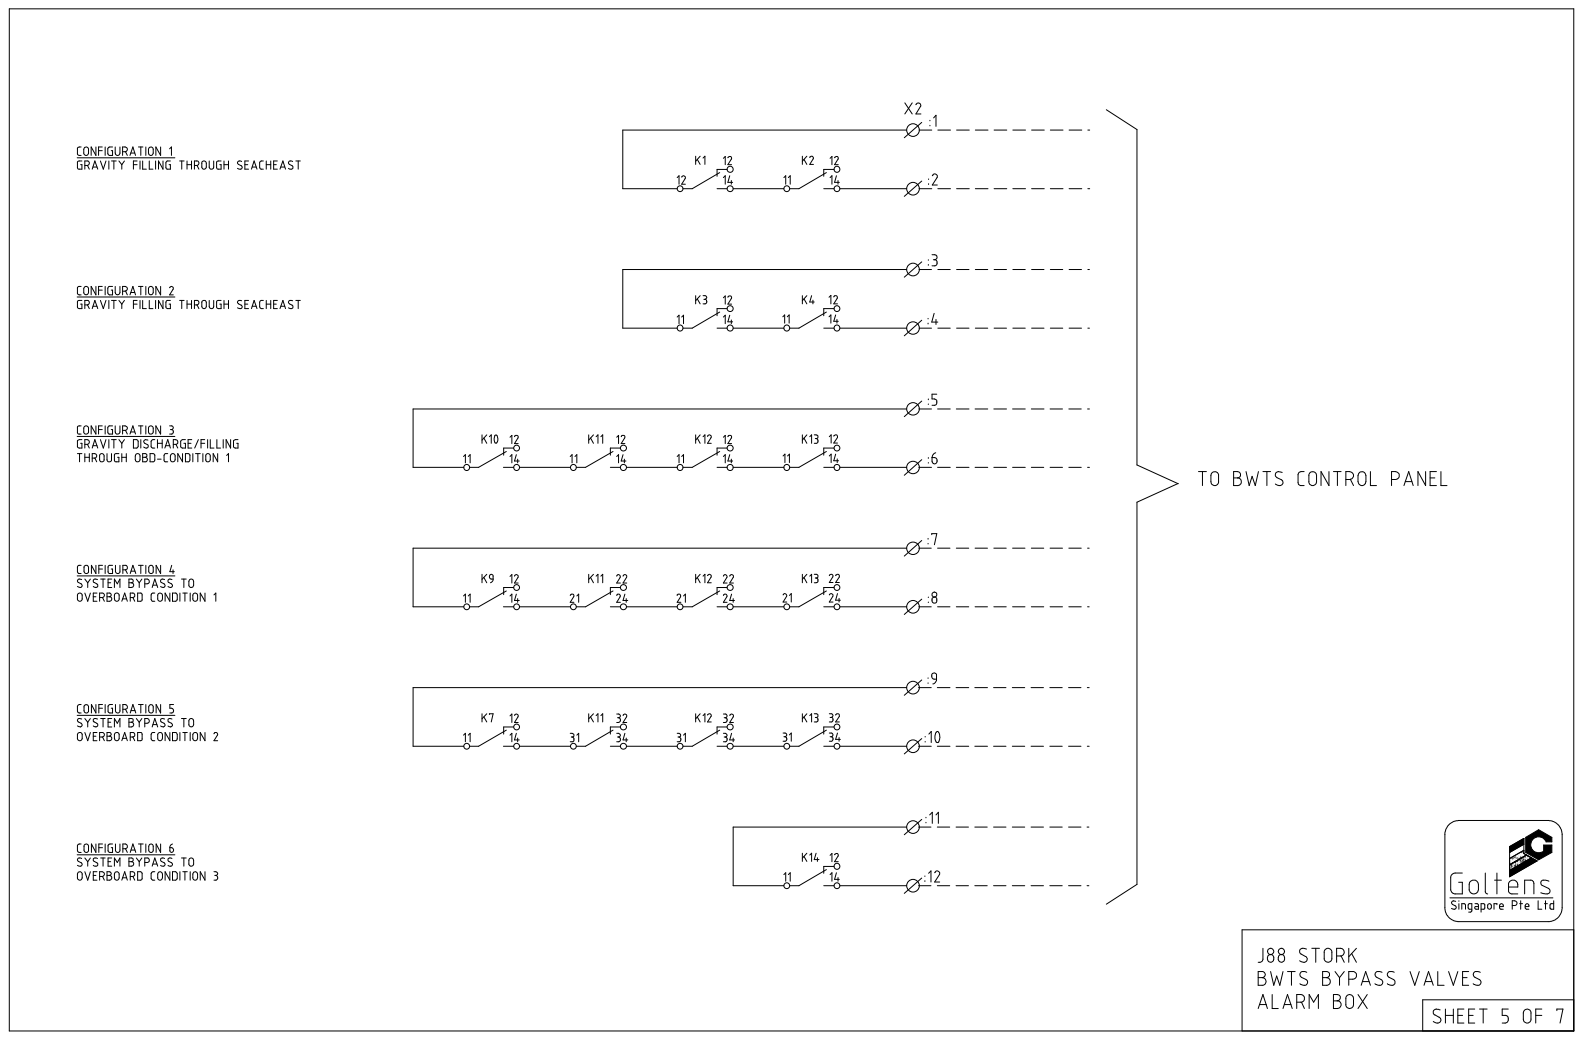
[picture p167: page 5]
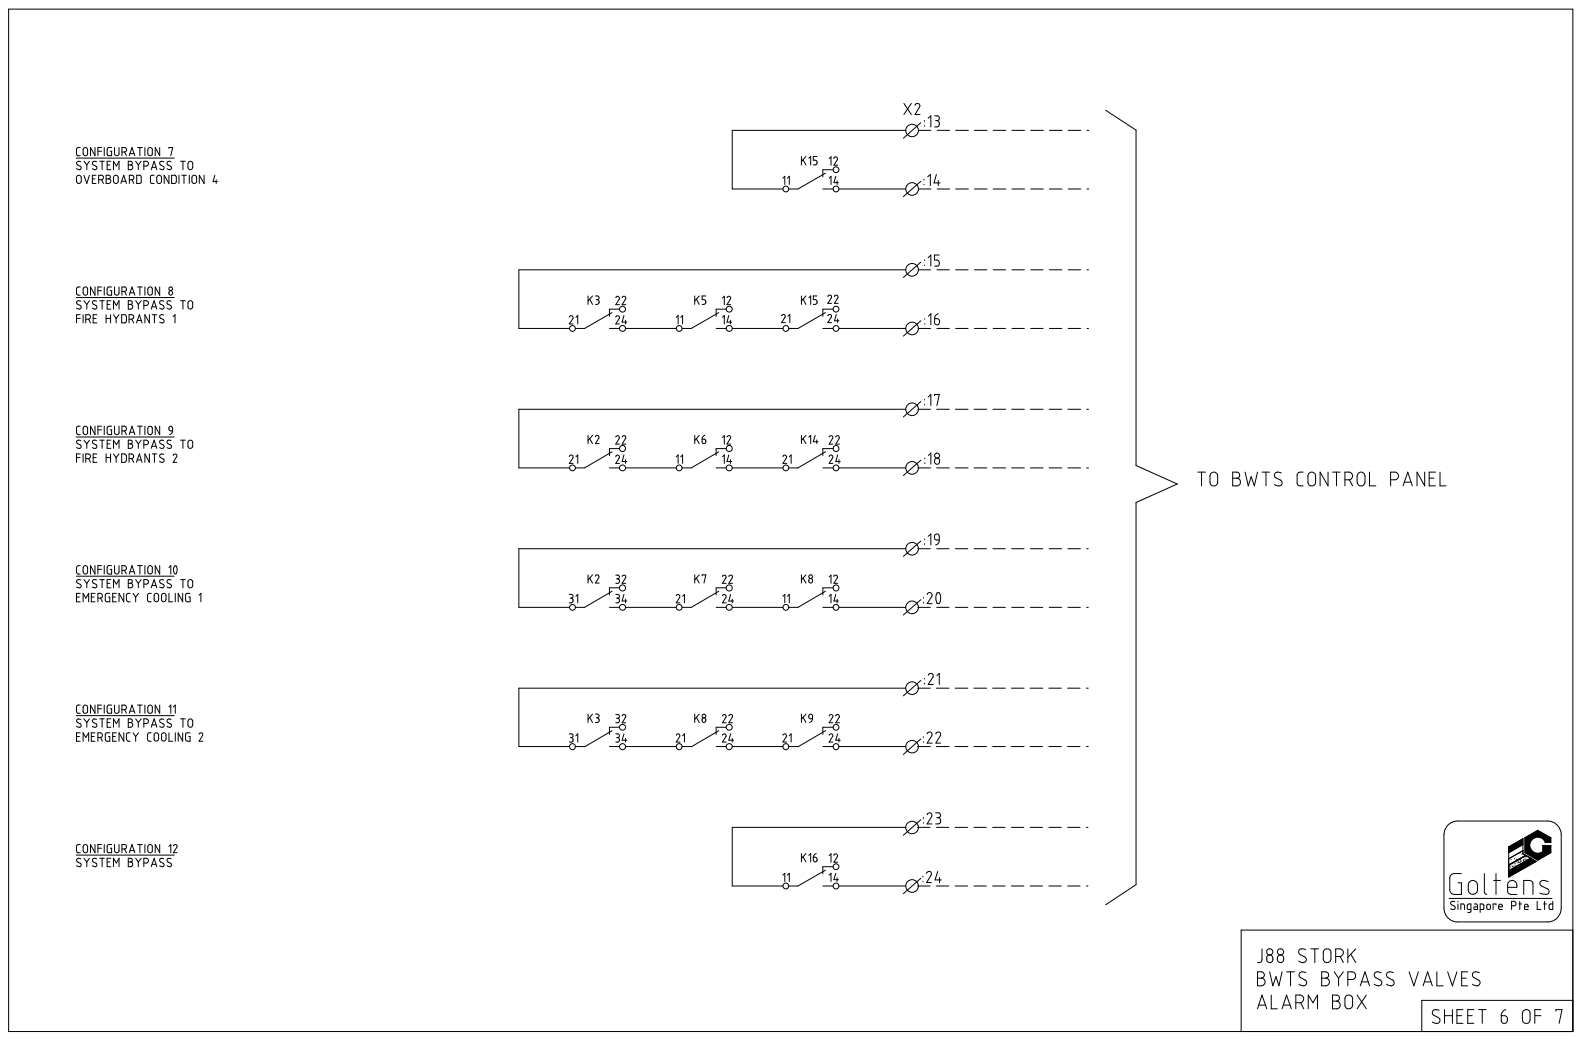
[picture p168: page 6]
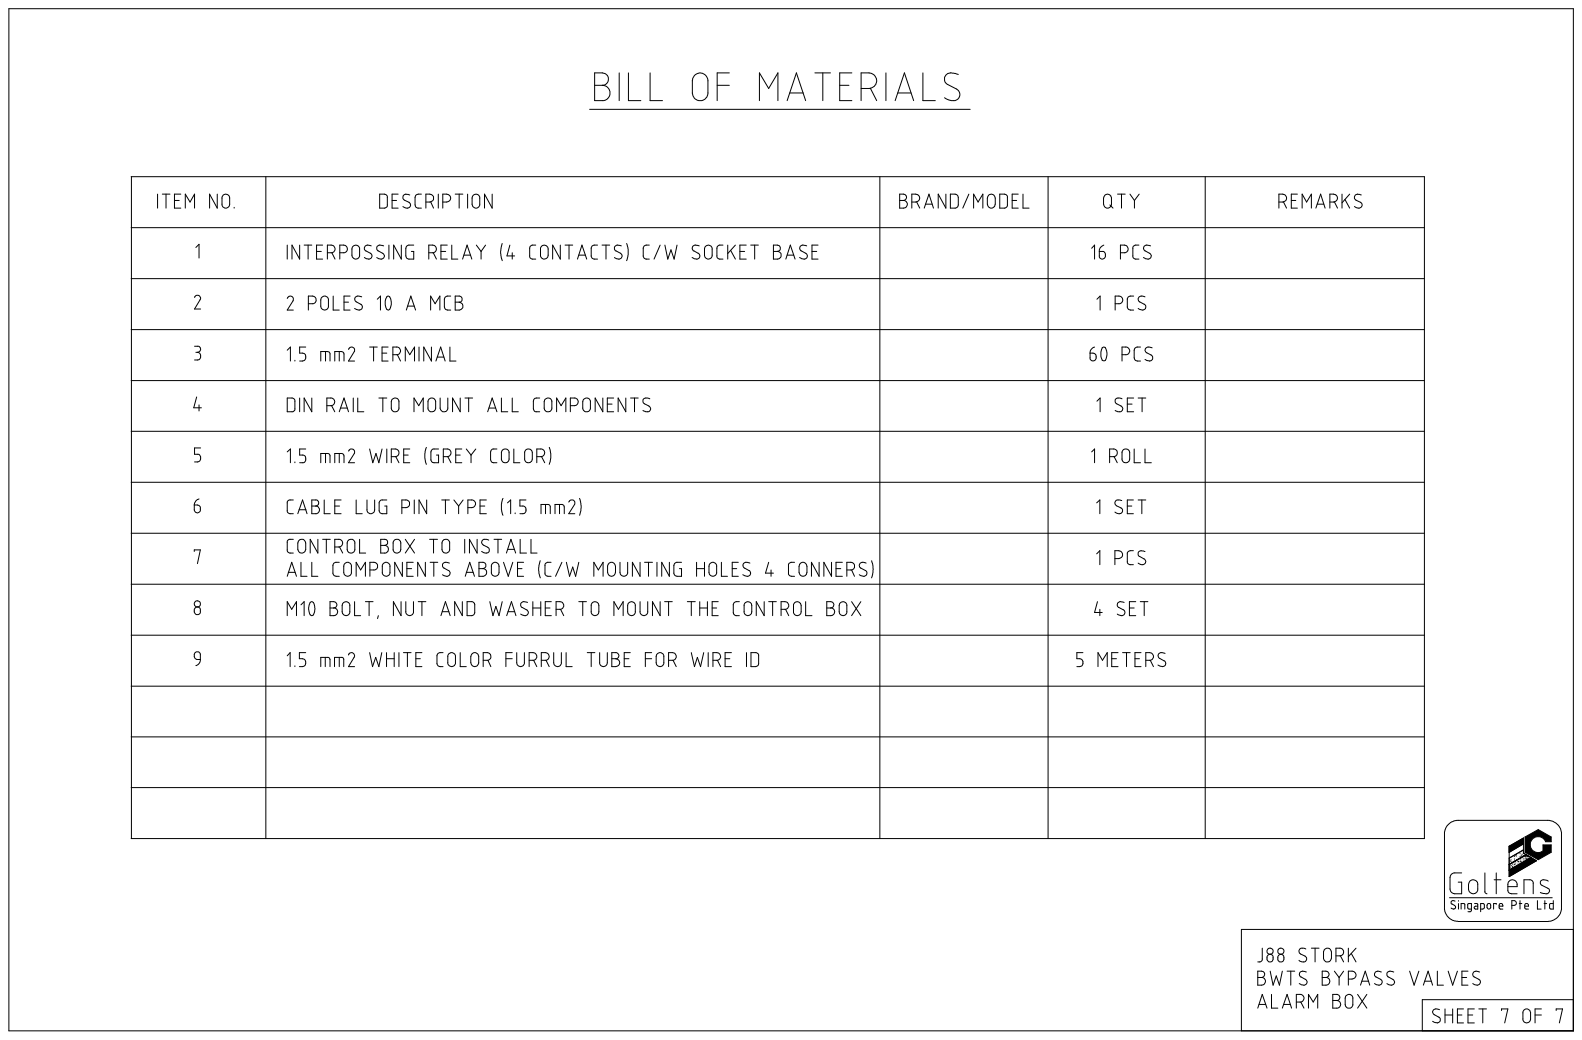
[picture p169: page 7]
