anurakj/J88_stork/GSPL-P1482-GE-0004 Light ship weight estimation R.A.pdf

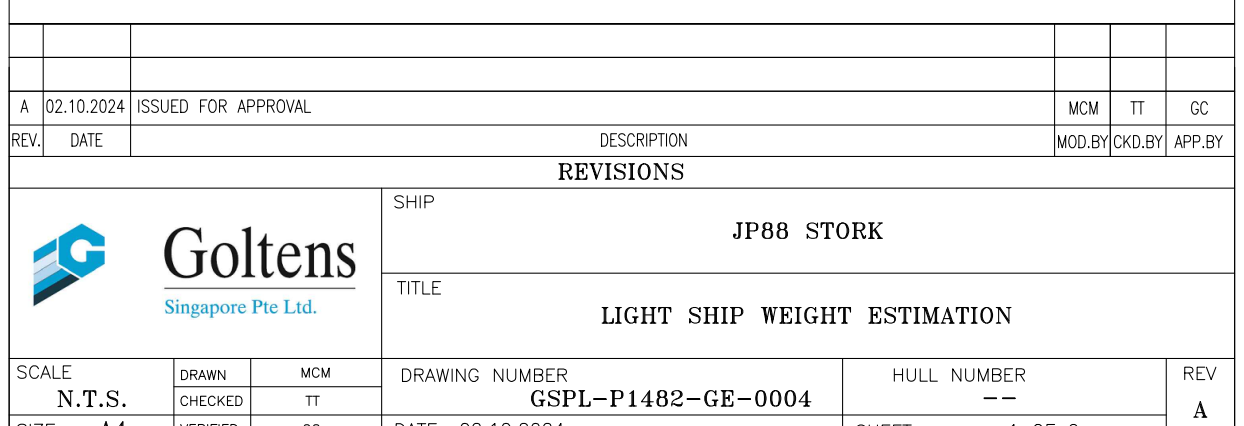
[picture p62: page 1]

LIGHT SHIP WEIGHT | 2552.26 Tons
1% of LSW | 25.5226 Tons
DESCRIPTION | TON | LCG | TCG | VCG | L-M
FILTER | 0.098 | 30.004 | -5.958 | 4.425 | 2.940
UV ASSEMBLY | 0.145 | 30.915 | -5.625 | 5.140 | 4.483
BACK FLUSH PUMP | 0.027 | 30.317 | -5.997 | 4.072 | 0.819
SWITCHBOARD CABINET | 0.016 | 32.008 | -6.186 | 3.515 | 0.512
CONTROL CABINET | 0.035 | 33.399 | -6.186 | 3.445 | 1.169
ELECTRONIC BALLAST NO.1 | 0.010 | 32.099 | -6.031 | 3.242 | 0.334
ELECTRONIC BALLAST NO.2 | 0.010 | 32.099 | -6.031 | 3.100 | 0.334
FILTER & BACK FLUSH FOUNDATION | 0.060 | 30.126 | -5.964 | 3.956 | 1.808
CONTROL CABINET FOUNDATION | 0.031 | 33.375 | -6.298 | 3.449 | 1.035
Pipe & Support | 1.348 | 30.524 | -6.104 | 3.800 | 41.146
Platform, Grating | 0.190 | 31.275 | -5.839 | 3.902 | 5.942
1.971 | 30.709 | -6.035 | 3.927 | 60.521
DESCRIPTION | MT | LCG | L-M
Existing Lightship | 2552.26 | 31.5 | 80396.19
New Additional Weight | 1.971 | 30.709 | 60.52117
New Lightship and LCG | 2554.23 | 31.4993896 | 80456.71
Percentage Change of Lightship | 0.07721784 | Less than 1%
DESCRIPTION | MT | VCG | V-M
Existing Lightship | 2552.26 | 6.385 | 16296.18
New Additional Weight | 1.971 | 3.927 | 7.739725
New Lightship and VCG | 2554.23 | 6.3831036 | 16303.92
-0.00061037 | m

### 63 m

CONCLUSION:

Difference in LCG
Length between perpendiculars
Change In LCG | 0.01%
Change In VCG | 0.010%
Allowable change in LCG | 0.315
| LIGHTSHIP WEIGHT ESTIMATE
DRAWING NO. | FORMAT | A4 | DRAWN | SK
SHIP NAMEJP88 STORK | | SHEET NO | 02/02 | CHECKED | TT
DATE | 02-10-2024 | REV. | A | APPRD | GC

After BWTS Reftrofit, the change in lightship weight is not exceeding 1.0% and the change in LCG is not exceeding 0.5% of LBP. Hence the most recent approved stability booklet remain valid.

Total Weight

The change in Lightship weight is Less than 1%

The change in LCG is Less than 0.5% of LBP

m (0.5% of LBP)
