anurakj/J88_stork/GSPL-P1482-PI-0301 Piping Spools drawing for BWTS  (1''& Above) R.B.pdf

# SPOOL INDEX SHEET

SPOOL NAME | SHEET NO | DRAWN | DATE | REVISION | REMARKS
SPOOL INDEX SHEET | i | | 12-10-2024 | B
BA01-001 | 1 | | 12-10-2024 | B
BA01-002 | 2 | | 12-10-2024 | B
BA01-003 | 3 | | 12-10-2024 | B
BA01-004 | 4 | | 12-10-2024 | B
BA01-005 | 5 | | 12-10-2024 | B
BA01-006 | 6 | | 12-10-2024 | B
BA01-007 | 7 | | 12-10-2024 | B
BA01-008 | 8 | | 12-10-2024 | B
BA01-009 | 9 | | 12-10-2024 | B
BA01-010 | 10 | | 12-10-2024 | B
BA01-011 | 11 | | 12-10-2024 | B
BA02-001 | 12 | | 12-10-2024 | B
BA02-002 | 13 | | 12-10-2024 | B
BA02-003 | 14 | | 12-10-2024 | B
BA02-004 | 15 | | 12-10-2024 | B
BA02-005 | 16 | | 12-10-2024 | B
BA03-001 | 17 | | 12-10-2024 | B
BA03-002 | 18 | | 12-10-2024 | B
BA03-003 | 19 | | 12-10-2024 | B
BA03-004 | 20 | | 12-10-2024 | B
BA03-005 | 21 | | 12-10-2024 | B
BA03-006 | 22 | | 12-10-2024 | B
BA03-007 | 23 | | 12-10-2024 | B
BA03-008 | 24 | | 12-10-2024 | B
BA03-009 | 25 | | 12-10-2024 | B | | 1.GSPL-P1482-PI-0001 BWTS Piping Schematic 2.GSPL-P1482-PI-0003 Compressed air system piping schematic 3.GSPL-P1482-PI-0004 Sanitary & F.W service system piping schematic 4.GSPL-P1482-PI-0201 Piping Arrangement Drawing for BWTS (1" & Above)
BA03-010 | 26 | | 12-10-2024 | B
BA03-011 | 27 | | 12-10-2024 | B
BA03-012 | 28 | | 12-10-2024 | B
BA03-013 | 29 | | 12-10-2024 | B
BA03-014 | 30 | | 12-10-2024 | B
BA03-015 | 31 | | 12-10-2024 | B
BA03-016 | 32 | | 12-10-2024 | B
BA03-017 | 33 | | 12-10-2024 | B
BA04-001 | 34 | | 12-10-2024 | B
BA04-002 | 35 | | 12-10-2024 | B
BA04-003 | 36 | | 12-10-2024 | B
BA04-004 | 37 | 12-10-2024 | B
BA05-001 | 38 | 12-10-2024 | B
BA05-002 | 39 | 12-10-2024 | B
BA06-001 | 40 | 12-10-2024 | B
SAMPLING PORT | 40A | 12-10-2024 | B
CA01 | 40B | 12-10-2024 | B

### BA 01 - 001 LINE NUMBER

# PIPE LEGEND

### SYSTEM SPOOL NUMBER

Client: EMAS OFFSHORE LIMITED | BWTS Maker : BIO-SEA
Location: - | IMO No.: 9354947
Project No: P1482 | Project Name: JP 88 STORK
Drawing title:
Scale | Format | Sheet | Drawing No: | Revision No.
N.T.S | A3

## PIPING SPOOL DRAWING FOR BWTS (1" & ABOVE)

A | 20/09/2024 | ISSUED FOR CONSTRUCTION | SK | TT | GC
REV. | DATE | DESCRIPTION | DRAWN BY | CHKD BY | APPRD
i | GSPL-P1482-PI-0301 | B

### REFERENCE DOCUMENTS:

B | 12/10/2024 | ISSUED FOR CONSTRUCTION | SK | TT | GC

### FWD(X)

### PORT(Y)

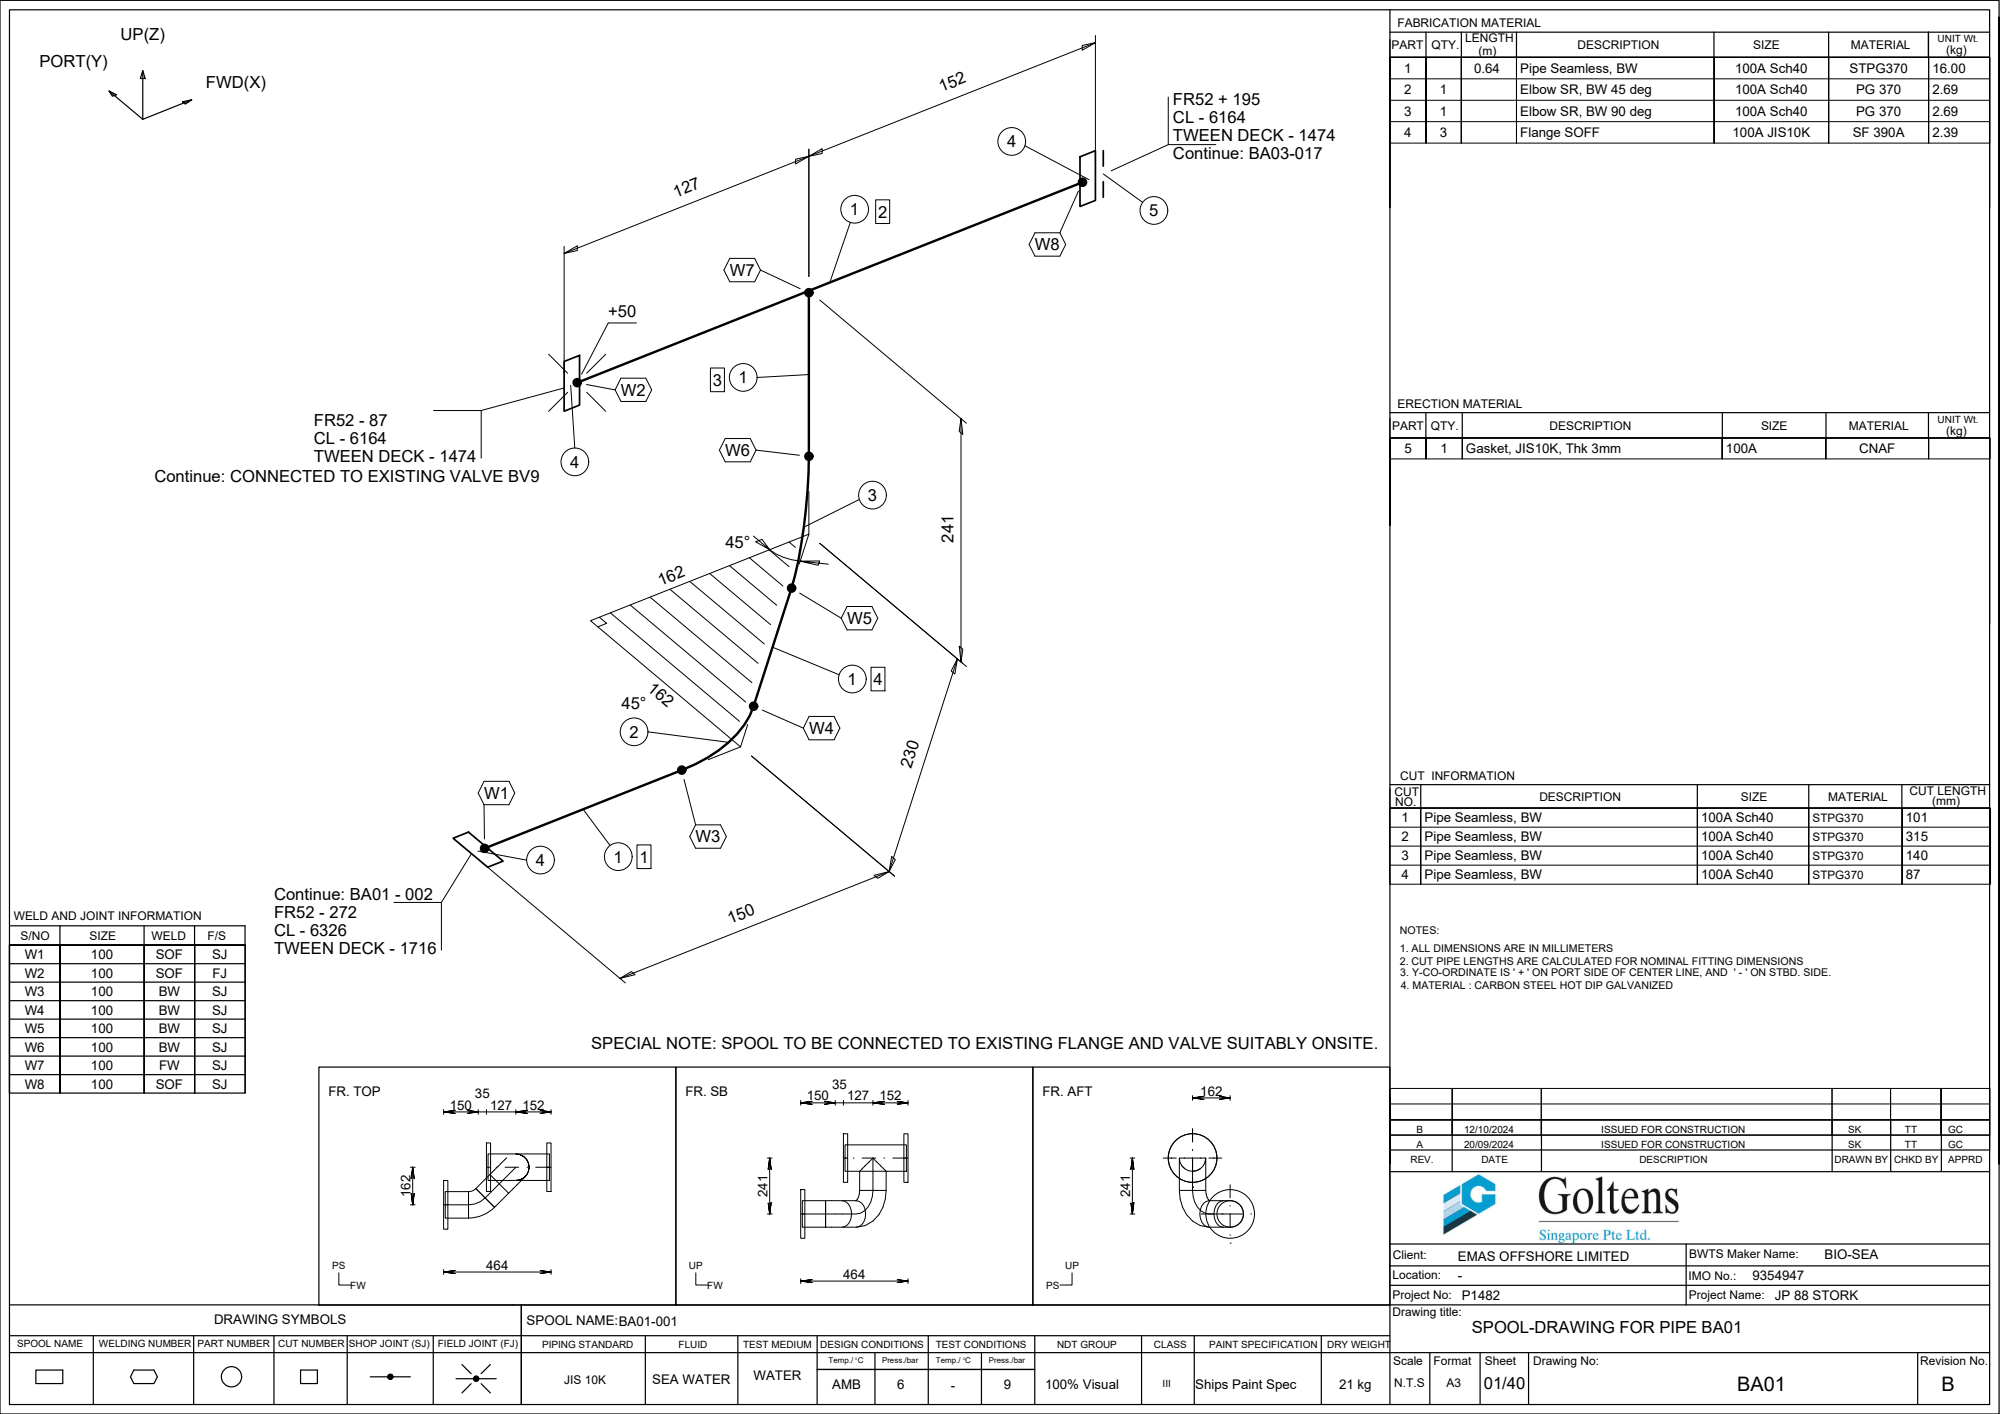
[picture p69: page 2]
FR. TOP; FR. AFT; AMB; SEA WATER; WATER; 100% Visual; Ships Paint Spec; JP 88 STORK; Flange SOFF; 100A JIS10K; Gasket, JIS10K, Thk 3mm; CNAF; SOF; Pipe Seamless, BW; 100A Sch40; STPG370; REV.; DATE; DESCRIPTION; DRAWN BY; CHKD BY; APPRD; Location:; Project No:; Client:; DRAWING SYMBOLS; SPOOL NAME; WELDING NUMBER; PART NUMBER; CUT NUMBER; FABRICATION MATERIAL; ERECTION MATERIAL; CUT INFORMATION; SIZE; WELD; PART; QTY.; MATERIAL; Temp./ C PIPING STANDARD; FLUID; TEST MEDIUM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

PART | QTY. | (m) | DESCRIPTION LENGTH | SIZE | MATERIAL | UNIT Wt. (kg)

1 | | 0.64 | Pipe Seamless, BW | 100A Sch40 | STPG370 | 16.00
2 | 1 | | Elbow SR, BW 45 deg | 100A Sch40 | PG 370 | 2.69
3 | 1 | | Elbow SR, BW 90 deg | 100A Sch40 | PG 370 | 2.69

UNIT Wt. (kg)

Continue: CONNECTED TO EXISTING VALVE BV9

CUT NO. | DESCRIPTION | SIZE | MATERIAL | CUT LENGTH (mm)

1 | Pipe Seamless, BW | 100A Sch40 | STPG370 | 101
2 | Pipe Seamless, BW | 100A Sch40 | STPG370 | 315
3 | Pipe Seamless, BW | 100A Sch40 | STPG370 | 140

WELD AND JOINT INFORMATION

NOTES:
1. ALL DIMENSIONS ARE IN MILLIMETERS
2. CUT PIPE LENGTHS ARE CALCULATED FOR NOMINAL FITTING DIMENSIONS
3. Y-CO-ORDINATE IS ' + ' ON PORT SIDE OF CENTER LINE, AND ' - ' ON STBD. SIDE.
4. MATERIAL : CARBON STEEL HOT DIP GALVANIZED

W1 | 100 | SOF | SJ
W2 | 100 | SOF | FJ
W3 | 100 | BW | SJ
W4 | 100 | BW | SJ
W5 | 100 | BW | SJ
W6 | 100 | BW | SJ
W7 | 100 | FW | SJ

SPECIAL NOTE: SPOOL TO BE CONNECTED TO EXISTING FLANGE AND VALVE SUITABLY ONSITE.

B | 12/10/2024 | ISSUED FOR CONSTRUCTION | SK | TT | GC
A | 20/09/2024 | ISSUED FOR CONSTRUCTION | SK | TT | GC

- BIO-SEA
EMAS OFFSHORE LIMITED

BWTS Maker Name:

IMO No.: NDT GROUP

SPOOL-DRAWING FOR PIPE

SHOP JOINT (SJ) | FIELD JOINT (FJ) | TEST CONDITIONS | | CLASS | PAINT SPECIFICATION

Press./bar | Temp./ C | Press./bar

### UP(Z)

PORT(Y) | FWD(X)

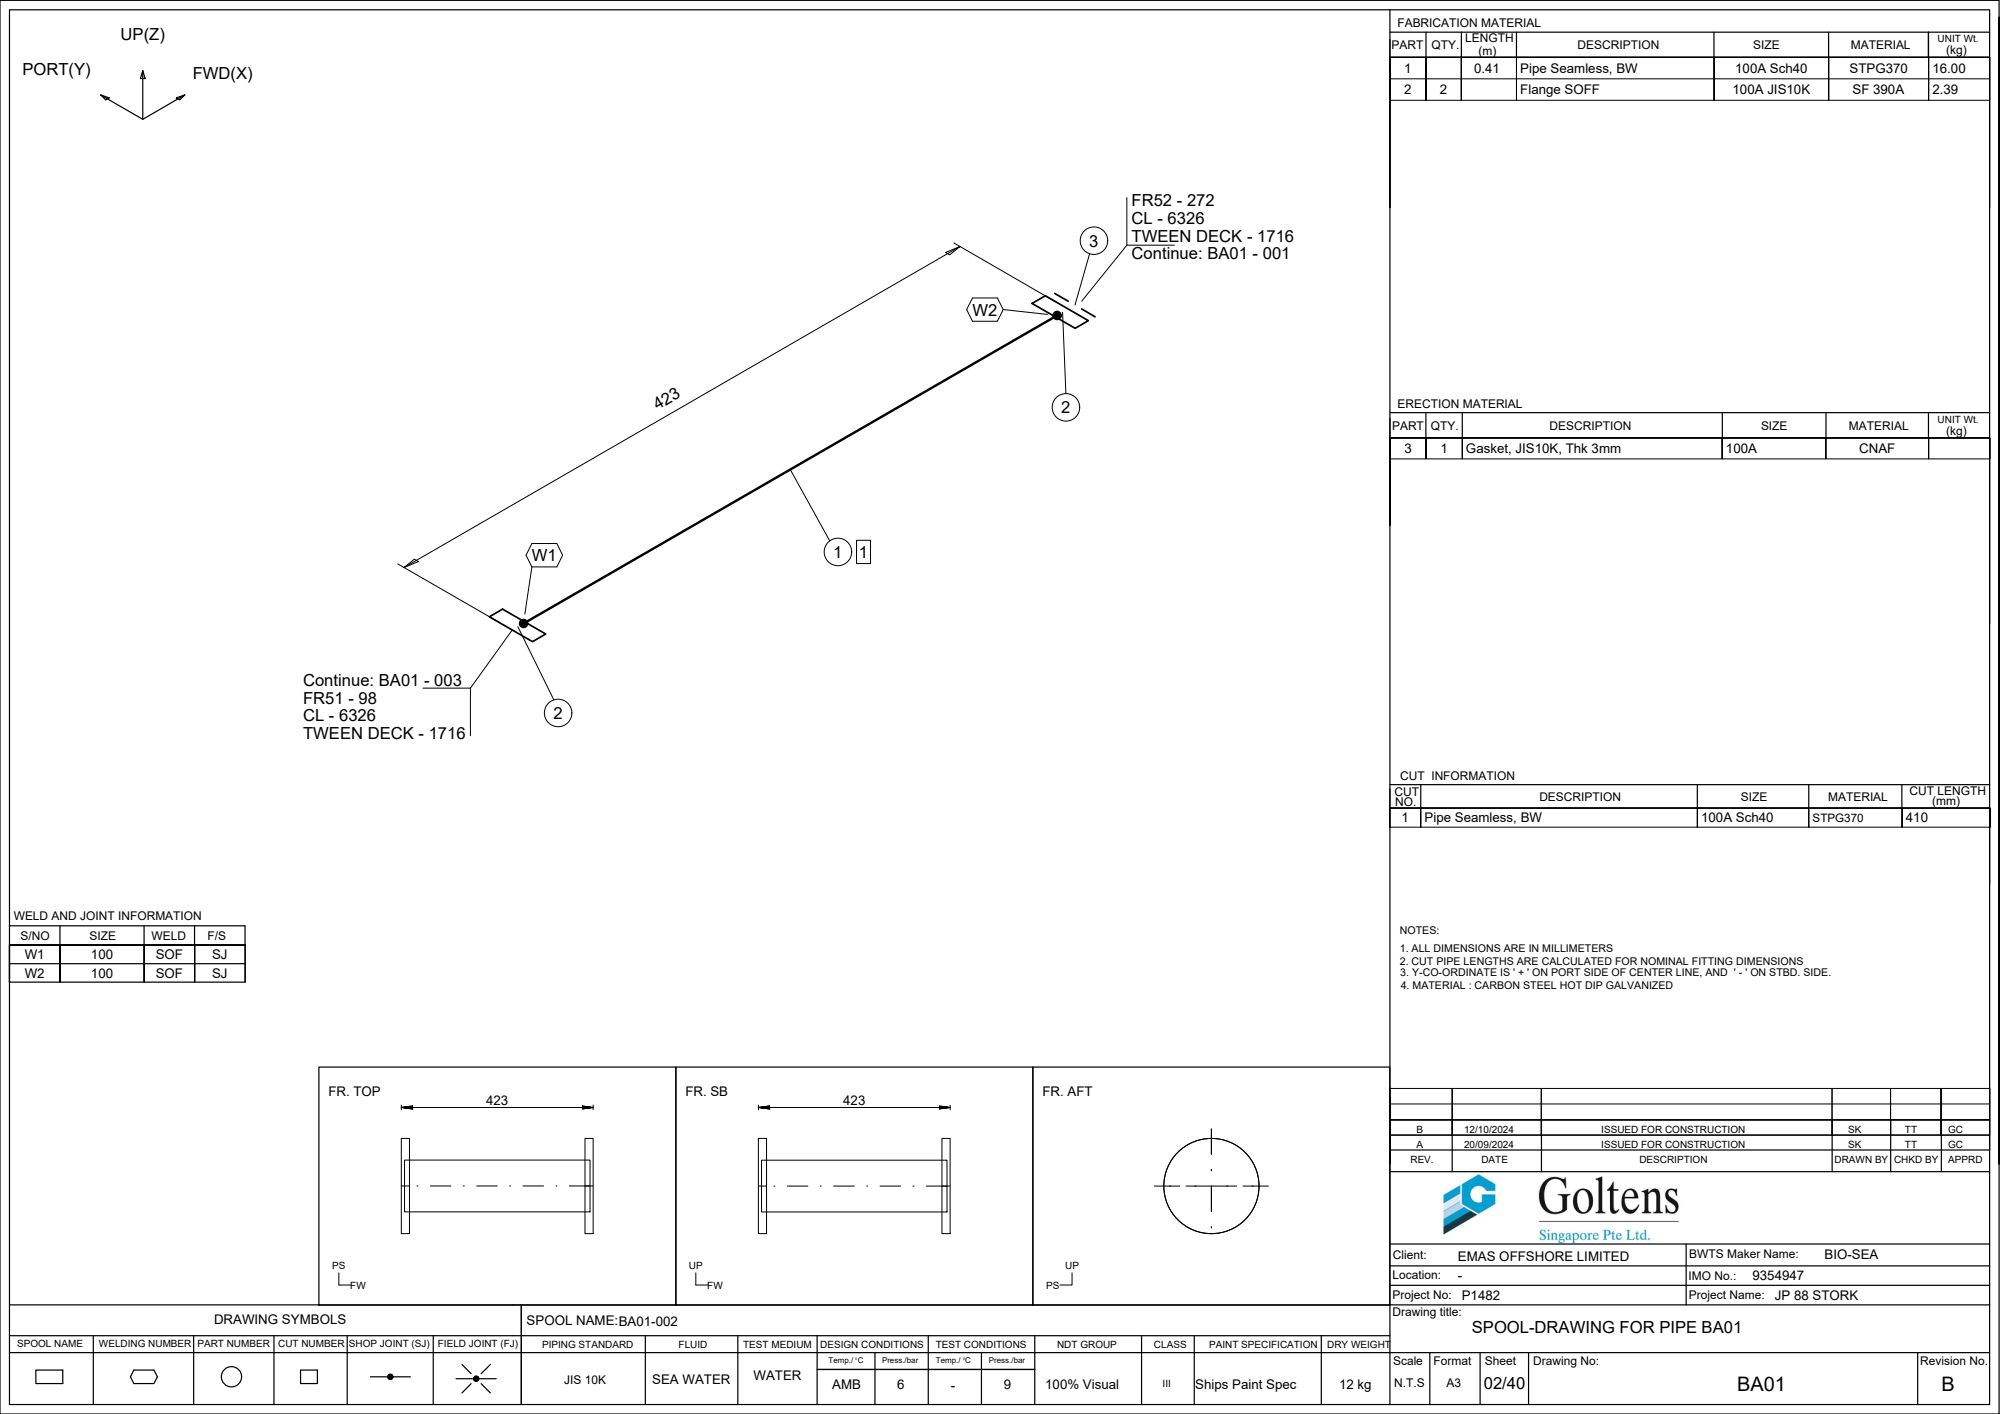
[picture p70: page 3]
FR. TOP; FR. AFT 423; AMB; Pipe Seamless, BW; 100A Sch40; STPG370; Flange SOFF; 100A JIS10K; Gasket, JIS10K, Thk 3mm; CNAF; SOF; REV.; DATE; DESCRIPTION; DRAWN BY; CHKD BY; APPRD; Location:; Client:; ERECTION MATERIAL; CUT INFORMATION; SIZE; WELD; PART; QTY.; MATERIAL; TWEEN DECK - 1716; Continue: BA01 - 001; FR51 - 98 CL - 6326 TWEEN DECK - 1716; Continue: BA01 - 003

UNIT Wt. (kg)

CUT NO. | DESCRIPTION | SIZE | MATERIAL | CUT LENGTH (mm)

1 | Pipe Seamless, BW | 100A Sch40 | STPG370 | 410

WELD AND JOINT INFORMATION

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

- BIO-SEA
EMAS OFFSHORE LIMITED

BWTS Maker Name:

IMO No.: NDT GROUP

### TWEEN DECK - 1716

CL - 6326

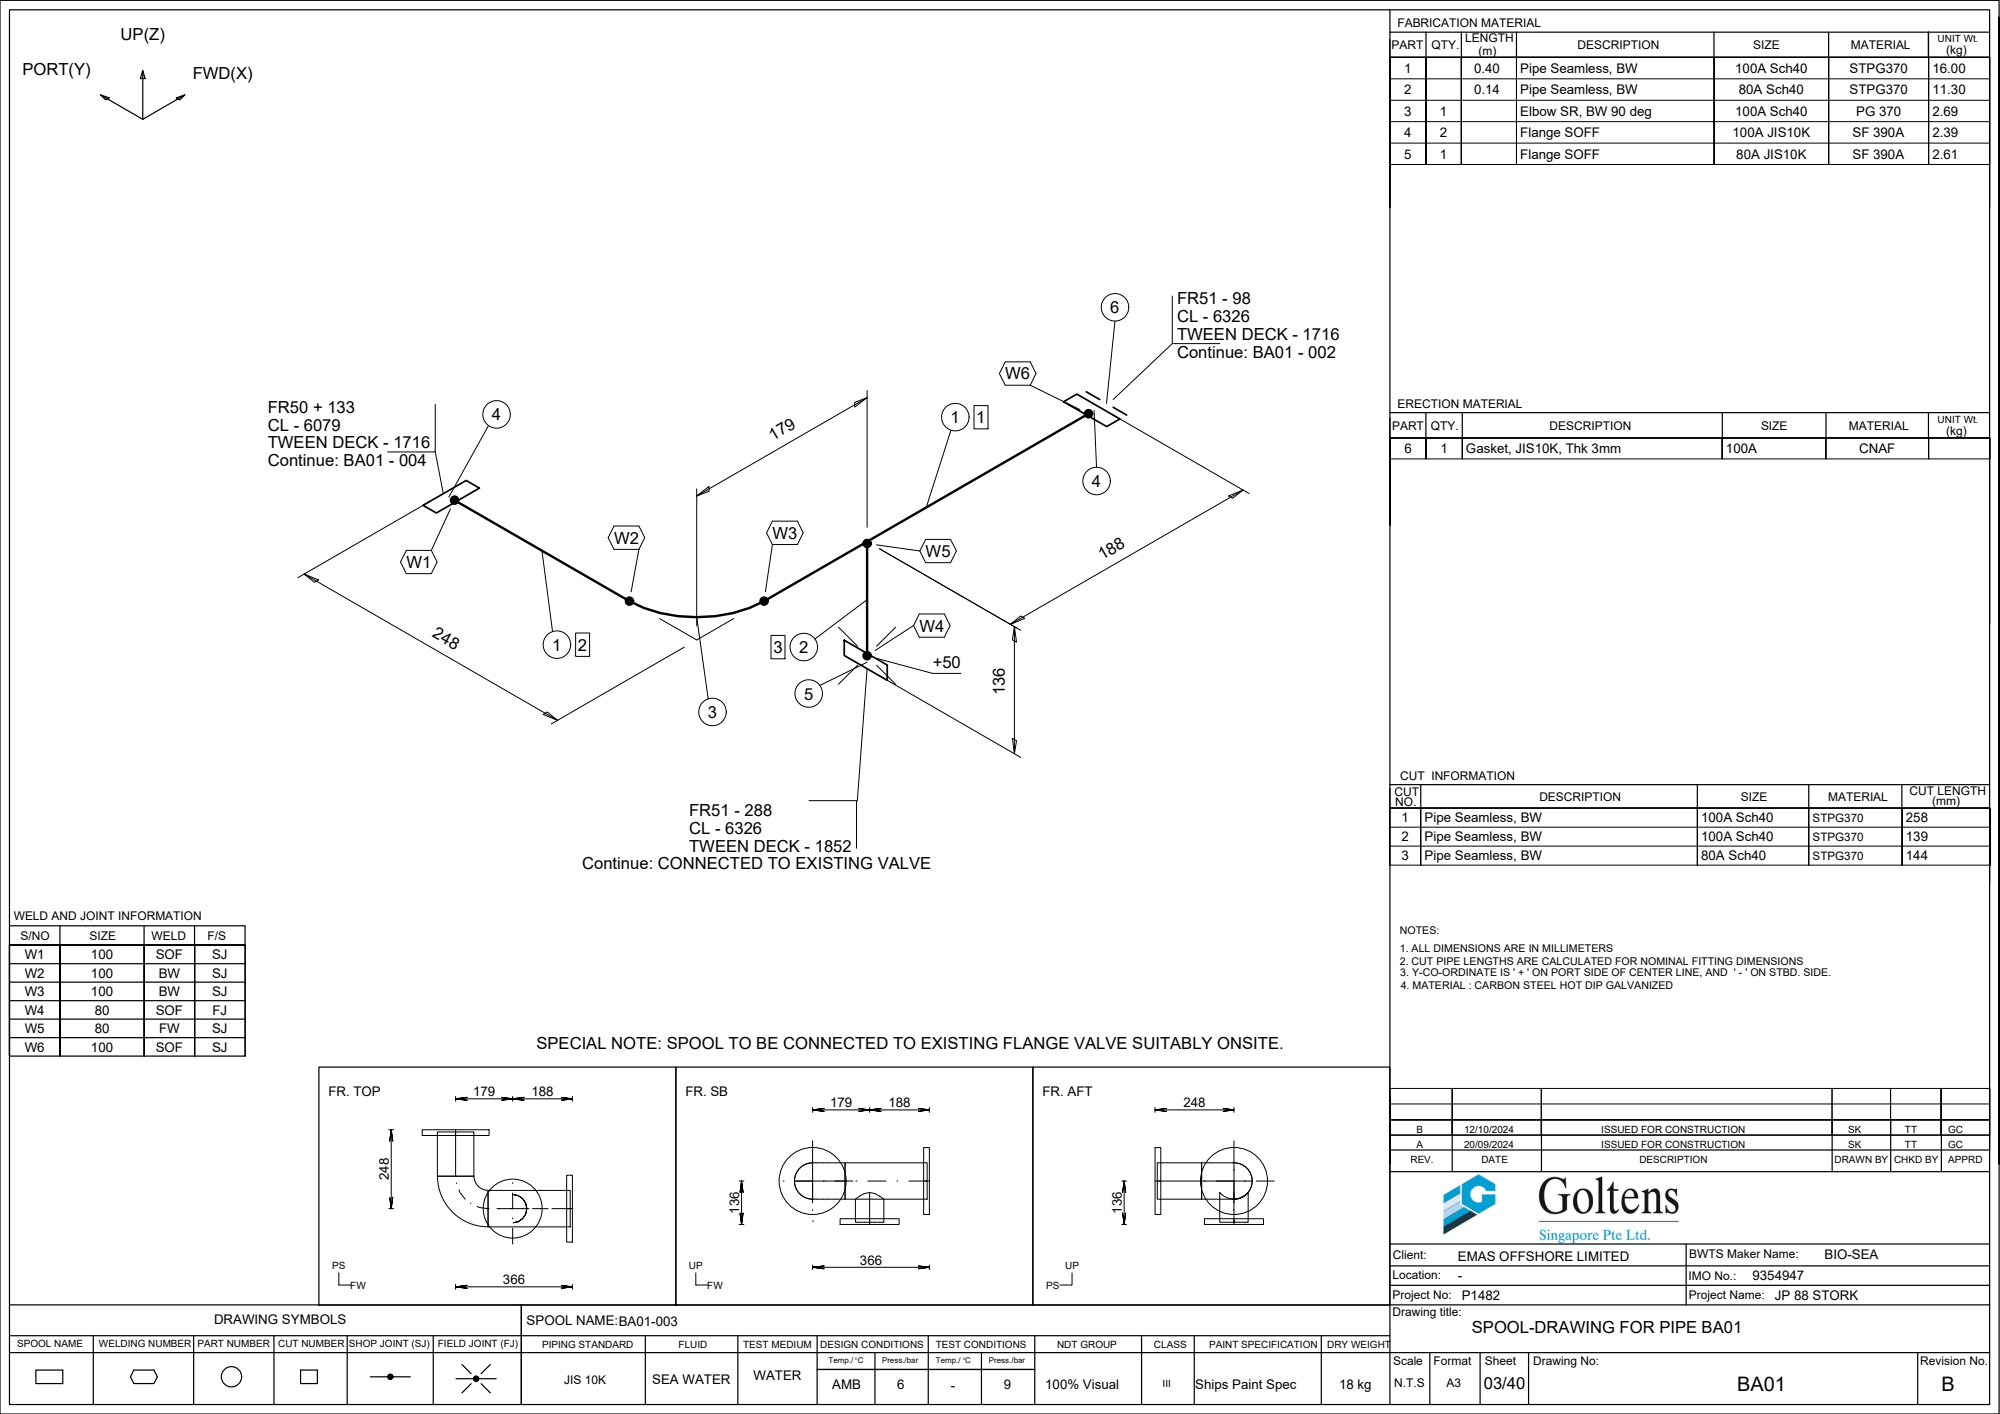
[picture p71: page 4]
FR. TOP; FR. AFT 248; AMB; Flange SOFF; 80A JIS10K; Gasket, JIS10K, Thk 3mm; CNAF; SOF; Pipe Seamless, BW; 80A Sch40; STPG370; REV.; DATE; DESCRIPTION; DRAWN BY; CHKD BY; APPRD; Location:; Client:; ERECTION MATERIAL; CUT INFORMATION; SIZE; WELD; PART; QTY.; MATERIAL; TWEEN DECK - 1716; Continue: BA01 - 004; Continue: BA01 - 002; FR51 - 288 CL - 6326 TWEEN DECK - 1852

1 | | 0.40 | Pipe Seamless, BW | 100A Sch40 | STPG370 | 16.00
2 | | 0.14 | Pipe Seamless, BW | 80A Sch40 | STPG370 | 11.30
3 | 1 | | Elbow SR, BW 90 deg | 100A Sch40 | PG 370 | 2.69
4 | 2 | | Flange SOFF | 100A JIS10K | SF 390A | 2.39

UNIT Wt. (kg)

CUT NO. | DESCRIPTION | SIZE | MATERIAL | CUT LENGTH (mm)

1 | Pipe Seamless, BW | 100A Sch40 | STPG370 | 258
2 | Pipe Seamless, BW | 100A Sch40 | STPG370 | 139

Continue: CONNECTED TO EXISTING VALVE

WELD AND JOINT INFORMATION

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

W1 | 100 | SOF | SJ
W2 | 100 | BW | SJ
W3 | 100 | BW | SJ
W4 | 80 | SOF | FJ
W5 | 80 | FW | SJ

SPECIAL NOTE: SPOOL TO BE CONNECTED TO EXISTING FLANGE VALVE SUITABLY ONSITE.

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

- BIO-SEA
EMAS OFFSHORE LIMITED

BWTS Maker Name:

IMO No.: NDT GROUP

### TWEEN DECK - 1382

FR50 - 150

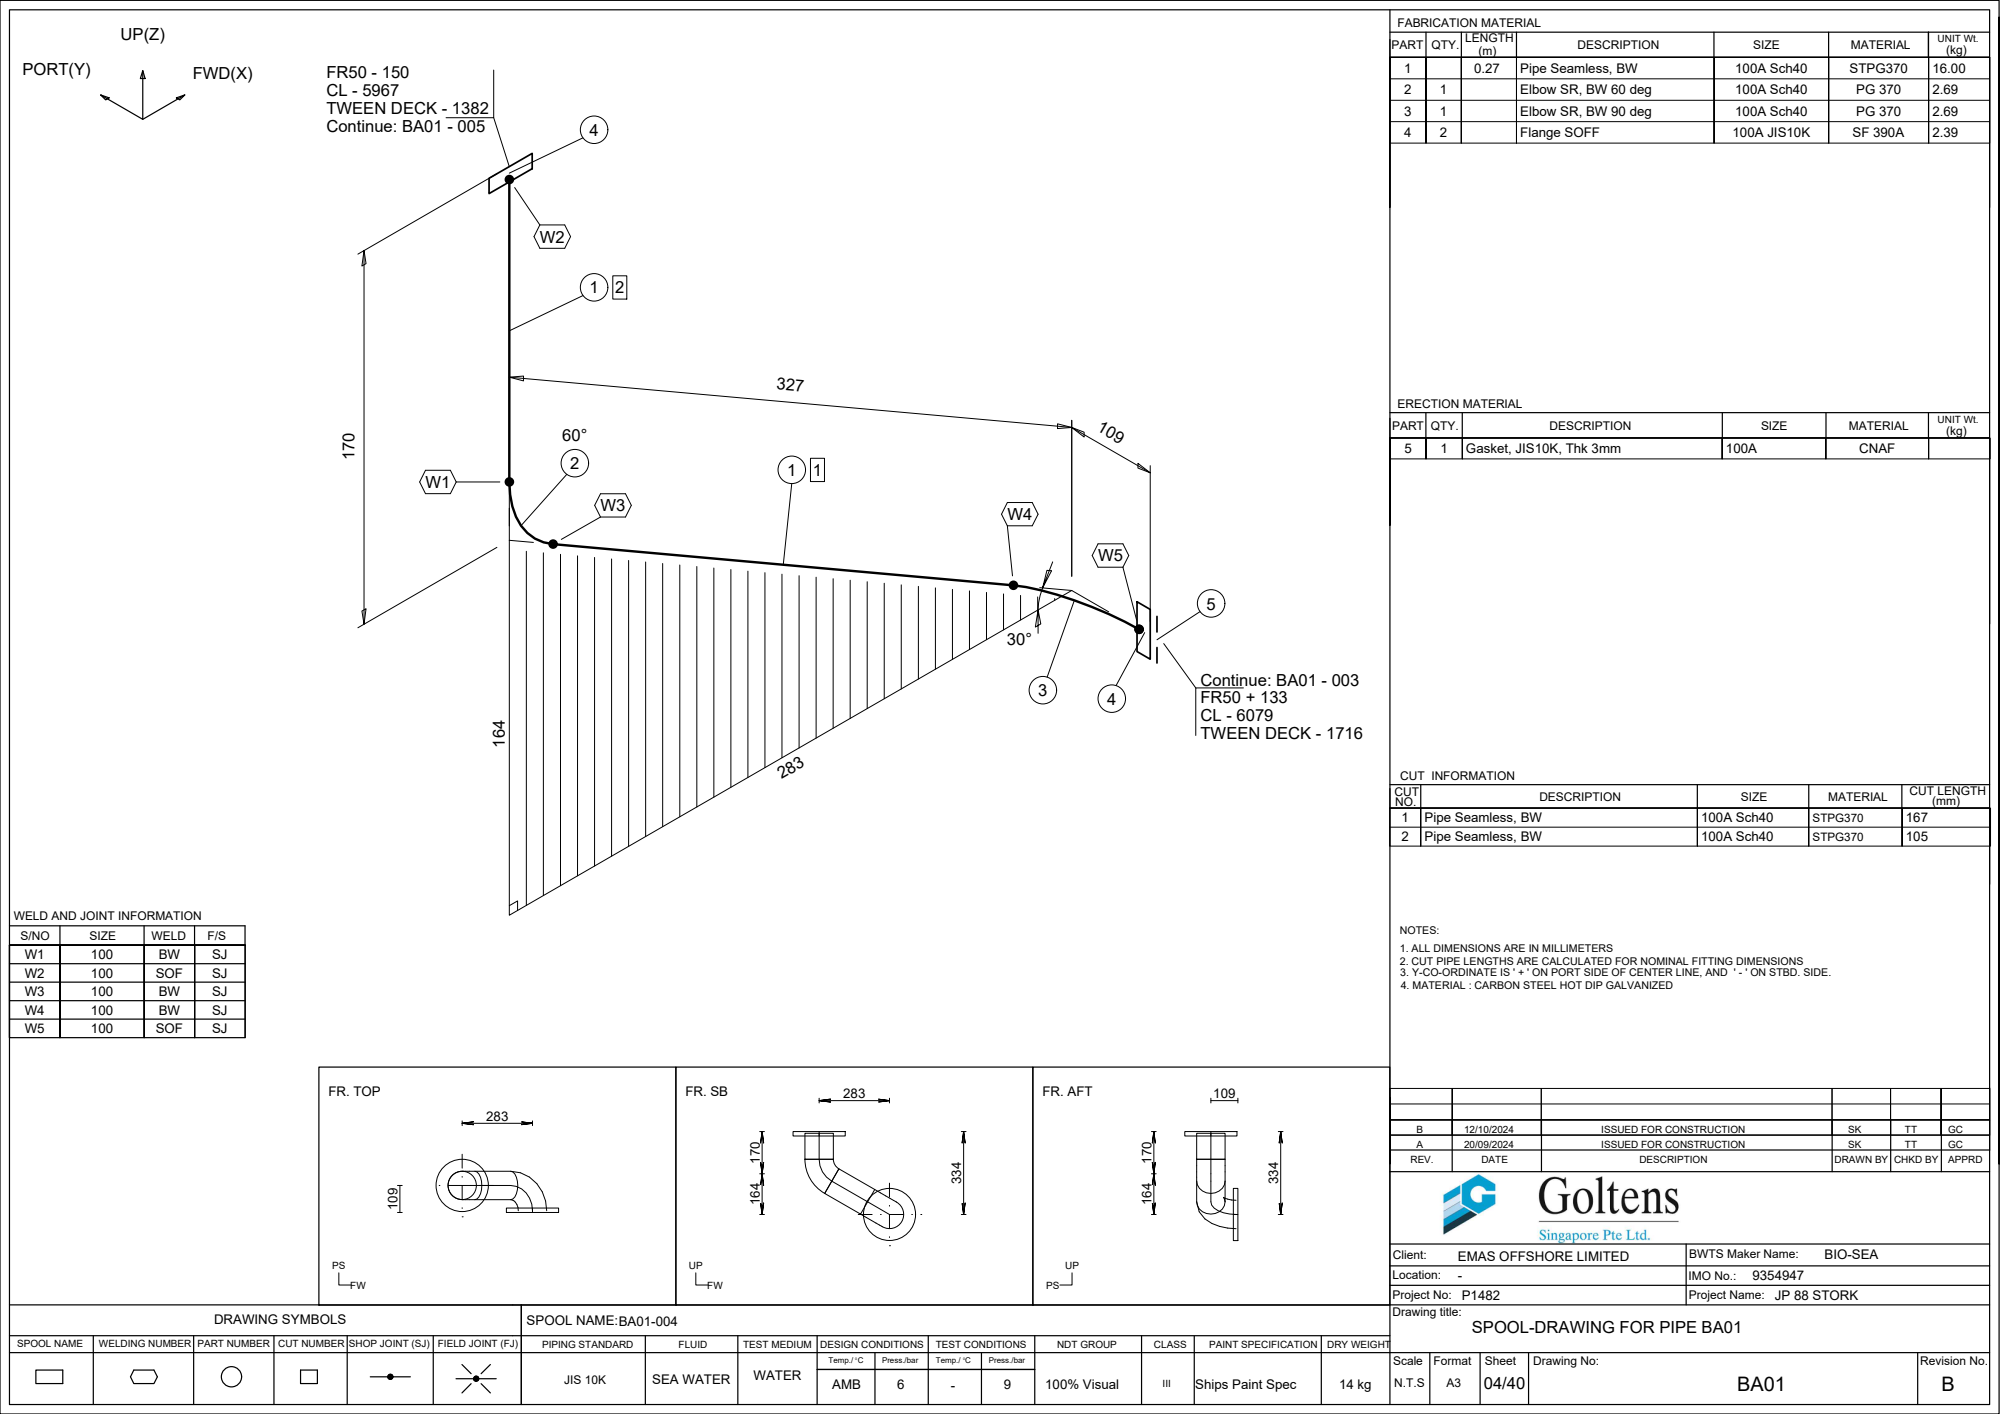
[picture p72: page 5]
FR. TOP; FR. AFT; AMB; Flange SOFF; 100A JIS10K; Gasket, JIS10K, Thk 3mm; CNAF; SOF; Pipe Seamless, BW; 100A Sch40; STPG370; REV.; DATE; DESCRIPTION; DRAWN BY; CHKD BY; APPRD; Location:; Client:; ERECTION MATERIAL; CUT INFORMATION; SIZE; WELD; PART; QTY.; MATERIAL; Continue: BA01 - 005; FR50 + 133 CL - 6079 TWEEN DECK - 1716; Continue: BA01 - 003 3

1 | | 0.27 | Pipe Seamless, BW | 100A Sch40 | STPG370 | 16.00
2 | 1 | | Elbow SR, BW 60 deg | 100A Sch40 | PG 370 | 2.69
3 | 1 | | Elbow SR, BW 90 deg | 100A Sch40 | PG 370 | 2.69

UNIT Wt. (kg)

CUT NO. | DESCRIPTION | SIZE | MATERIAL | CUT LENGTH (mm)

1 | Pipe Seamless, BW | 100A Sch40 | STPG370 | 167

WELD AND JOINT INFORMATION

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

W1 | 100 | BW | SJ
W2 | 100 | SOF | SJ
W3 | 100 | BW | SJ
W4 | 100 | BW | SJ

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

- BIO-SEA
EMAS OFFSHORE LIMITED

BWTS Maker Name:

IMO No.: NDT GROUP

### FWD(X)

### PORT(Y)

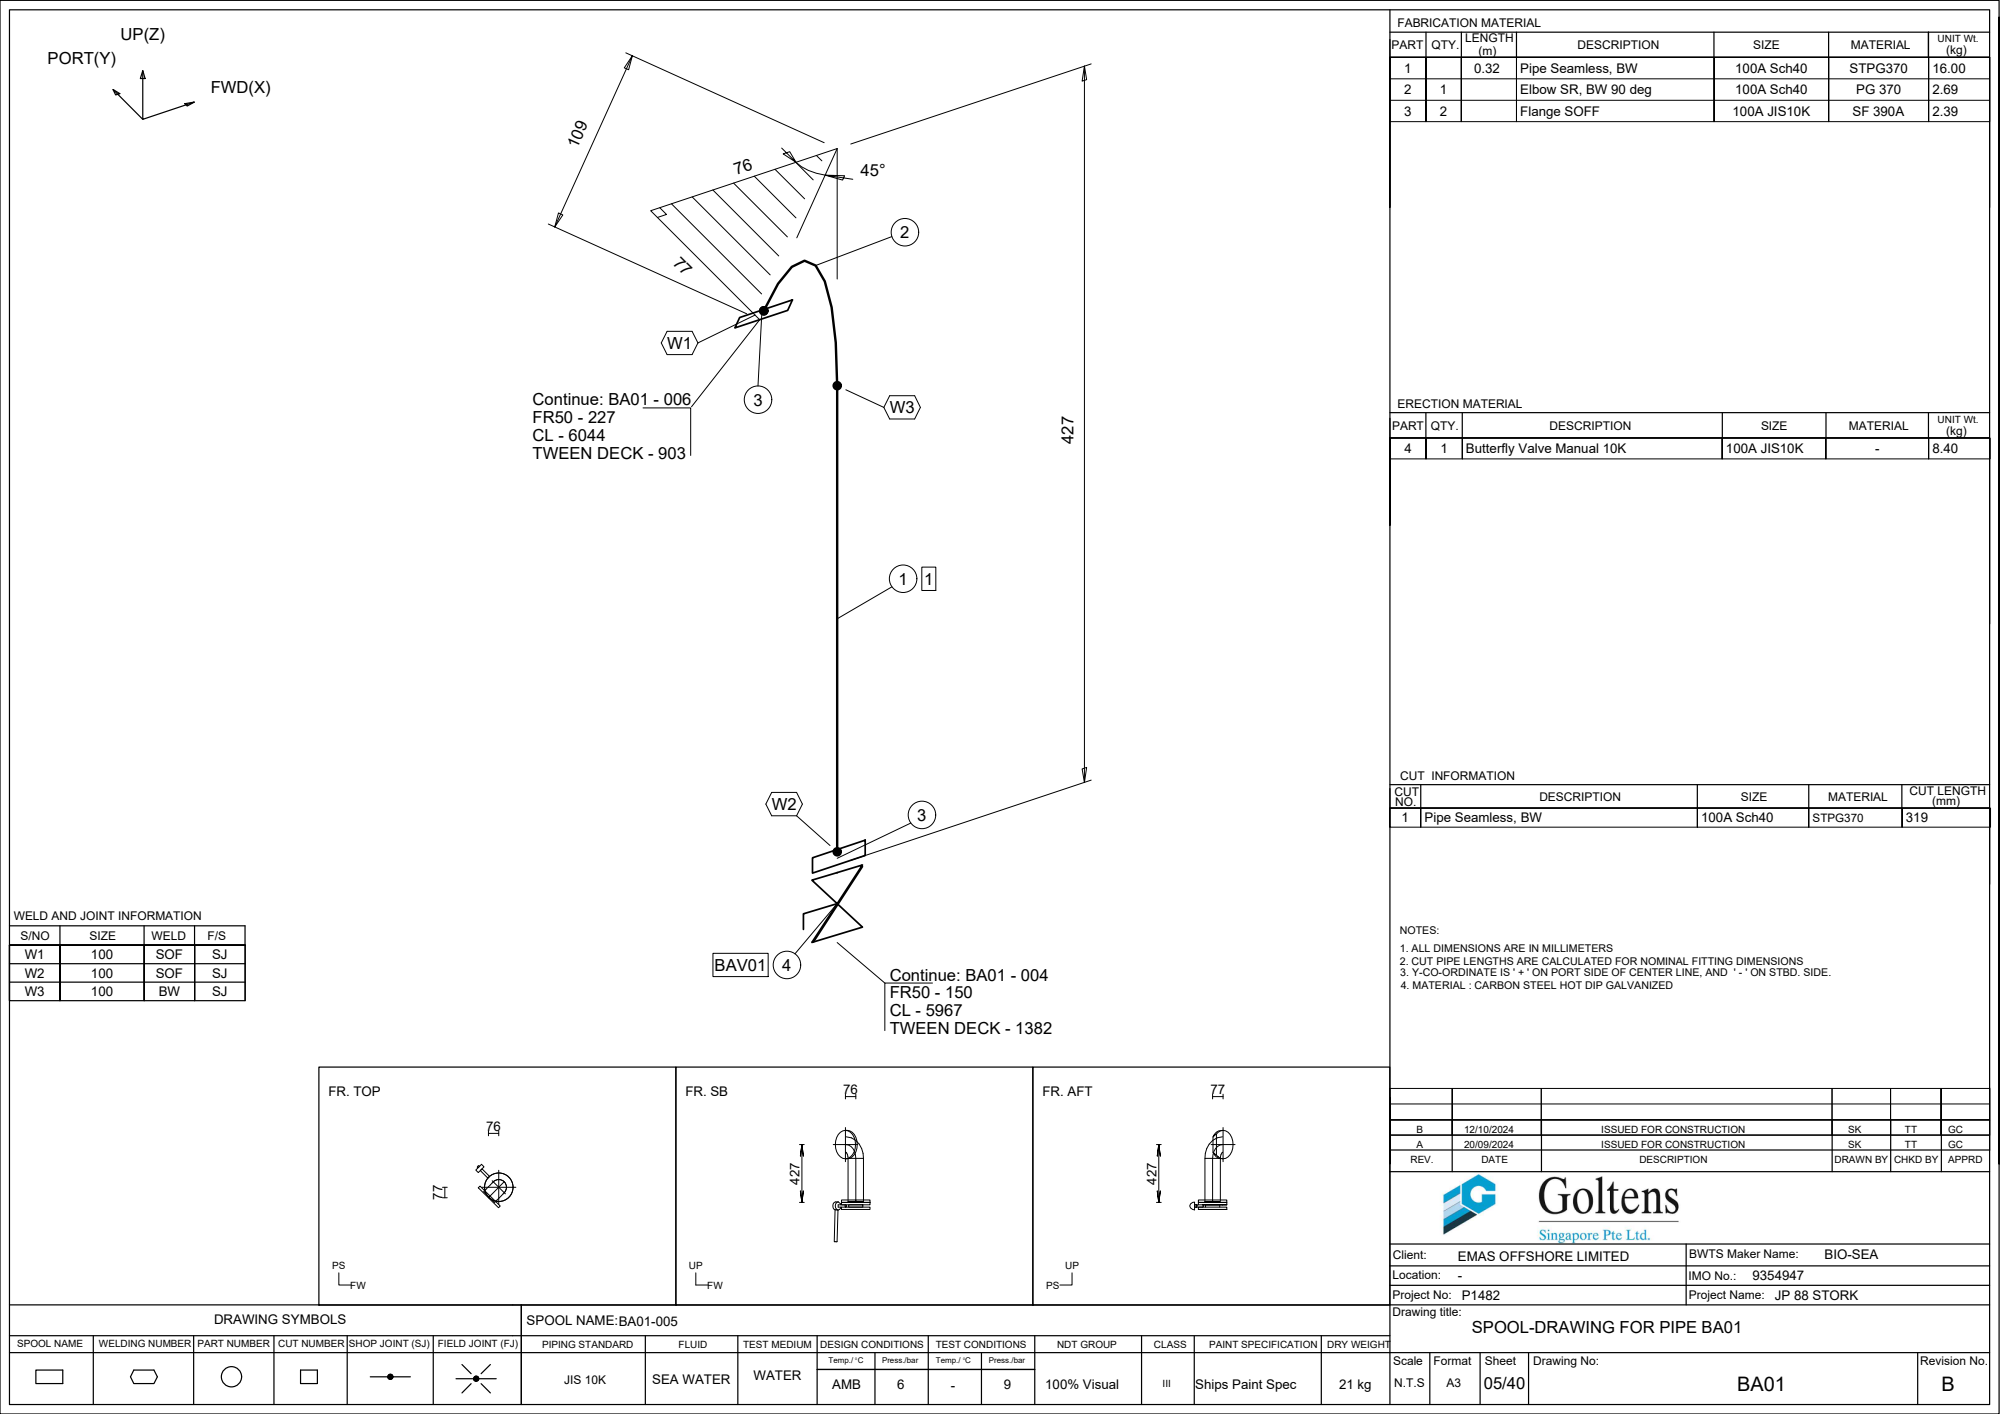
[picture p73: page 6]
FR. TOP; FR. AFT; AMB; Flange SOFF; 100A JIS10K; Butterfly Valve Manual 10K; REV.; DATE; DESCRIPTION; DRAWN BY; CHKD BY; APPRD; Location:; Client:; ERECTION MATERIAL; CUT INFORMATION; SIZE; WELD; PART; QTY.; MATERIAL; FR50 - 150 CL - 5967 TWEEN DECK - 1382; Continue: BA01 - 004; FR50 - 227 CL - 6044 TWEEN DECK - 903; Continue: BA01 - 006; BAV01

1 | | 0.32 | Pipe Seamless, BW | 100A Sch40 | STPG370 | 16.00
2 | 1 | | Elbow SR, BW 90 deg | 100A Sch40 | PG 370 | 2.69

UNIT Wt. (kg)

CUT NO. | DESCRIPTION | SIZE | MATERIAL | CUT LENGTH (mm)

1 | Pipe Seamless, BW | 100A Sch40 | STPG370 | 319

WELD AND JOINT INFORMATION

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

W1 | 100 | SOF | SJ
W2 | 100 | SOF | SJ

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

- BIO-SEA
EMAS OFFSHORE LIMITED

BWTS Maker Name:

IMO No.: NDT GROUP

### PORT(Y)

### FWD(X)

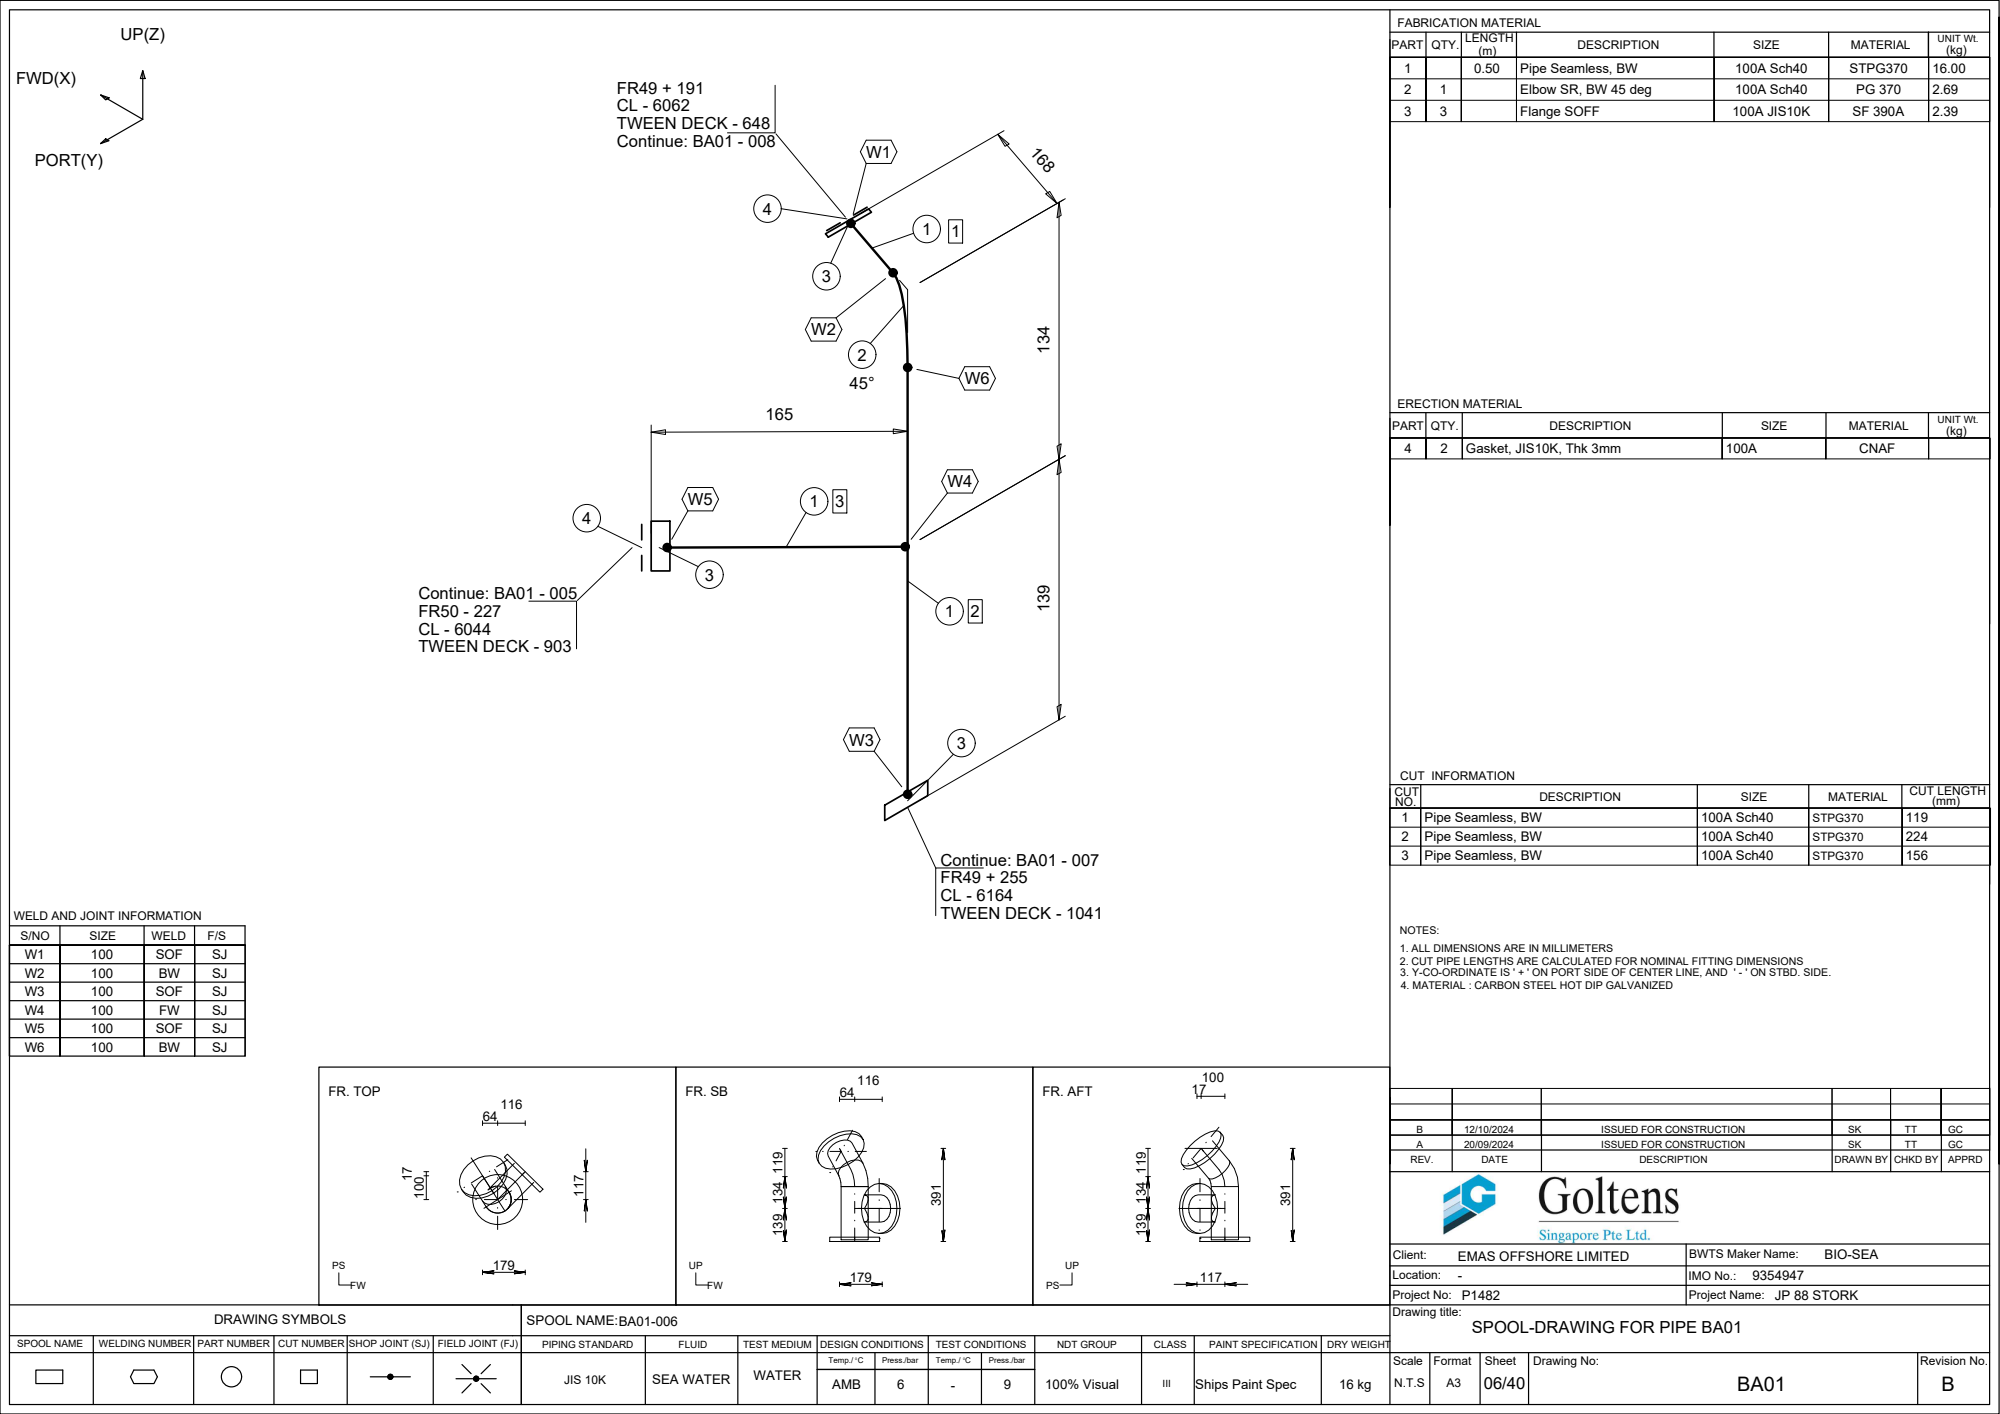
[picture p74: page 7]
FR. TOP; FR. AFT 134 100; AMB; Flange SOFF; 100A JIS10K; Gasket, JIS10K, Thk 3mm; CNAF; Pipe Seamless, BW; 100A Sch40; STPG370; REV.; DATE; DESCRIPTION; DRAWN BY; CHKD BY; APPRD; Location:; Client:; ERECTION MATERIAL; CUT INFORMATION; SIZE; WELD; PART; QTY.; MATERIAL; FR50 - 227 CL - 6044 TWEEN DECK - 903; Continue: BA01 - 005; FR49 + 255 CL - 6164 TWEEN DECK - 1041; Continue: BA01 - 007; TWEEN DECK - 648; Continue: BA01 - 008

1 | | 0.50 | Pipe Seamless, BW | 100A Sch40 | STPG370 | 16.00
2 | 1 | | Elbow SR, BW 45 deg | 100A Sch40 | PG 370 | 2.69

UNIT Wt. (kg)

CUT NO. | DESCRIPTION | SIZE | MATERIAL | CUT LENGTH (mm)

1 | Pipe Seamless, BW | 100A Sch40 | STPG370 | 119
2 | Pipe Seamless, BW | 100A Sch40 | STPG370 | 224

WELD AND JOINT INFORMATION

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

W1 | 100 | SOF | SJ
W2 | 100 | BW | SJ
W3 | 100 | SOF | SJ
W4 | 100 | FW | SJ
W5 | 100 | SOF | SJ

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

- BIO-SEA
EMAS OFFSHORE LIMITED

BWTS Maker Name:

IMO No.: NDT GROUP

### TWEEN DECK - 1218

CL - 6164

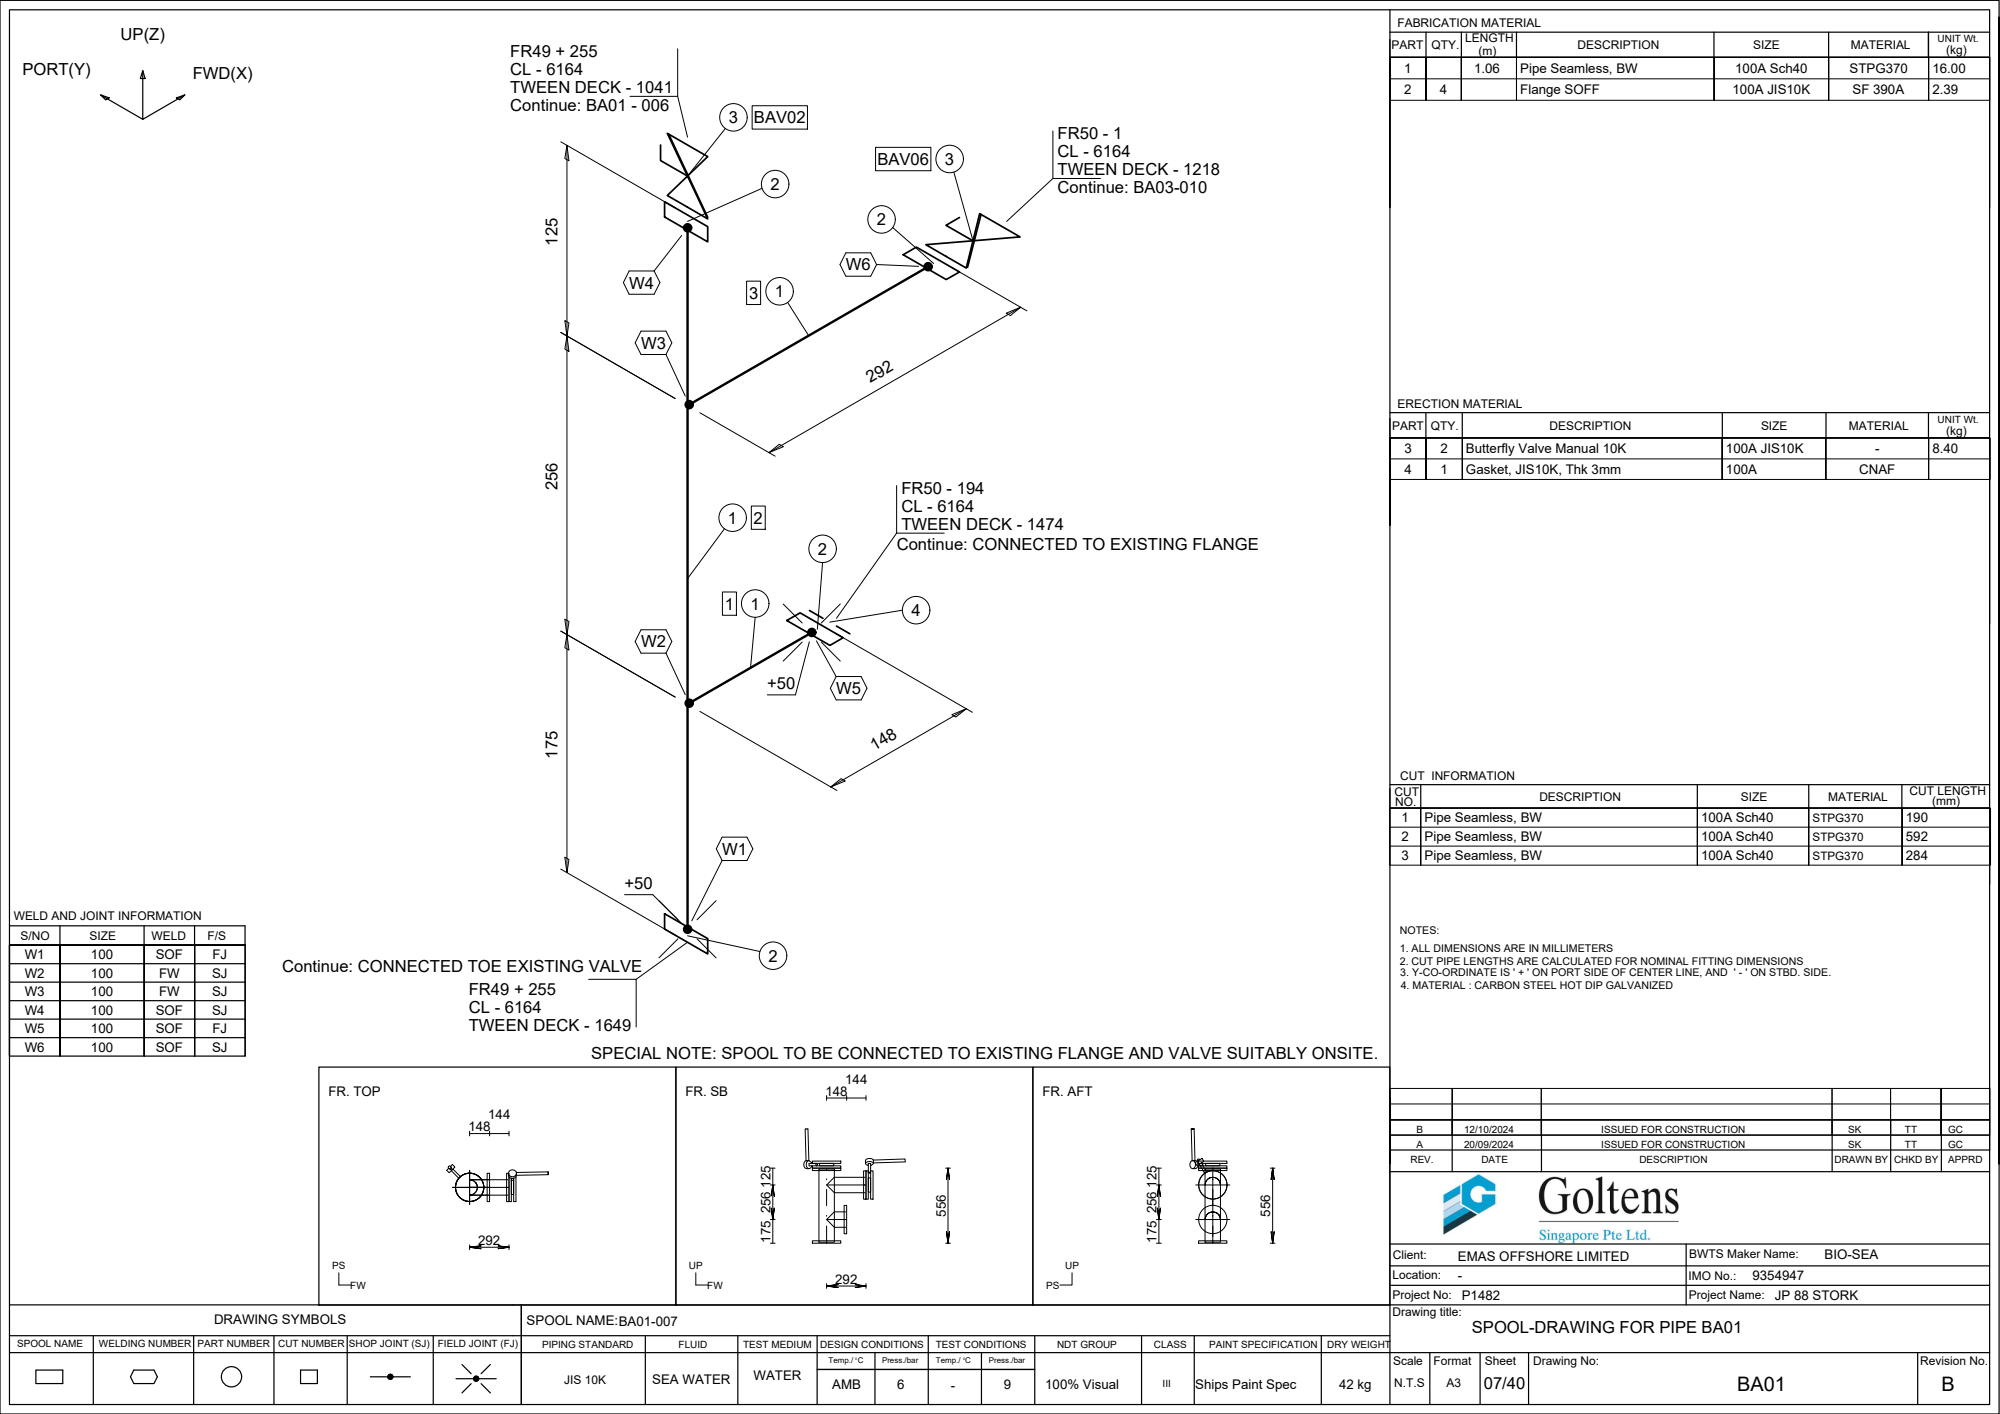
[picture p75: page 8]
FR. TOP; FR. AFT; AMB; Pipe Seamless, BW; 100A Sch40; STPG370; Flange SOFF; 100A JIS10K; Gasket, JIS10K, Thk 3mm; CNAF; SOF; REV.; DATE; DESCRIPTION; DRAWN BY; CHKD BY; APPRD; Location:; Client:; ERECTION MATERIAL; CUT INFORMATION; SIZE; WELD; ISSUED FOR CONSTRUCTION; FR49 + 255 CL - 6164 TWEEN DECK - 1649; Continue: BA03-010; TWEEN DECK - 1041; Continue: BA01 - 006; BAV02; BAV06

PART | QTY. | DESCRIPTION | SIZE | MATERIAL | UNIT Wt. (kg)

3 | 2 | Butterfly Valve Manual 10K | 100A JIS10K | - | 8.40

TWEEN DECK - 1474
Continue: CONNECTED TO EXISTING FLANGE

CUT NO. | DESCRIPTION | SIZE | MATERIAL | CUT LENGTH (mm)

1 | Pipe Seamless, BW | 100A Sch40 | STPG370 | 190
2 | Pipe Seamless, BW | 100A Sch40 | STPG370 | 592

WELD AND JOINT INFORMATION

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

W1 | 100 | SOF | FJ
W2 | 100 | FW | SJ
W3 | 100 | FW | SJ
W4 | 100 | SOF | SJ
W5 | 100 | SOF | FJ

Continue: CONNECTED TOE EXISTING VALVE

SPECIAL NOTE: SPOOL TO BE CONNECTED TO EXISTING FLANGE AND VALVE SUITABLY ONSITE.

- BIO-SEA
EMAS OFFSHORE LIMITED

BWTS Maker Name:

IMO No.: NDT GROUP

### TWEEN DECK - 431

FR49 + 125

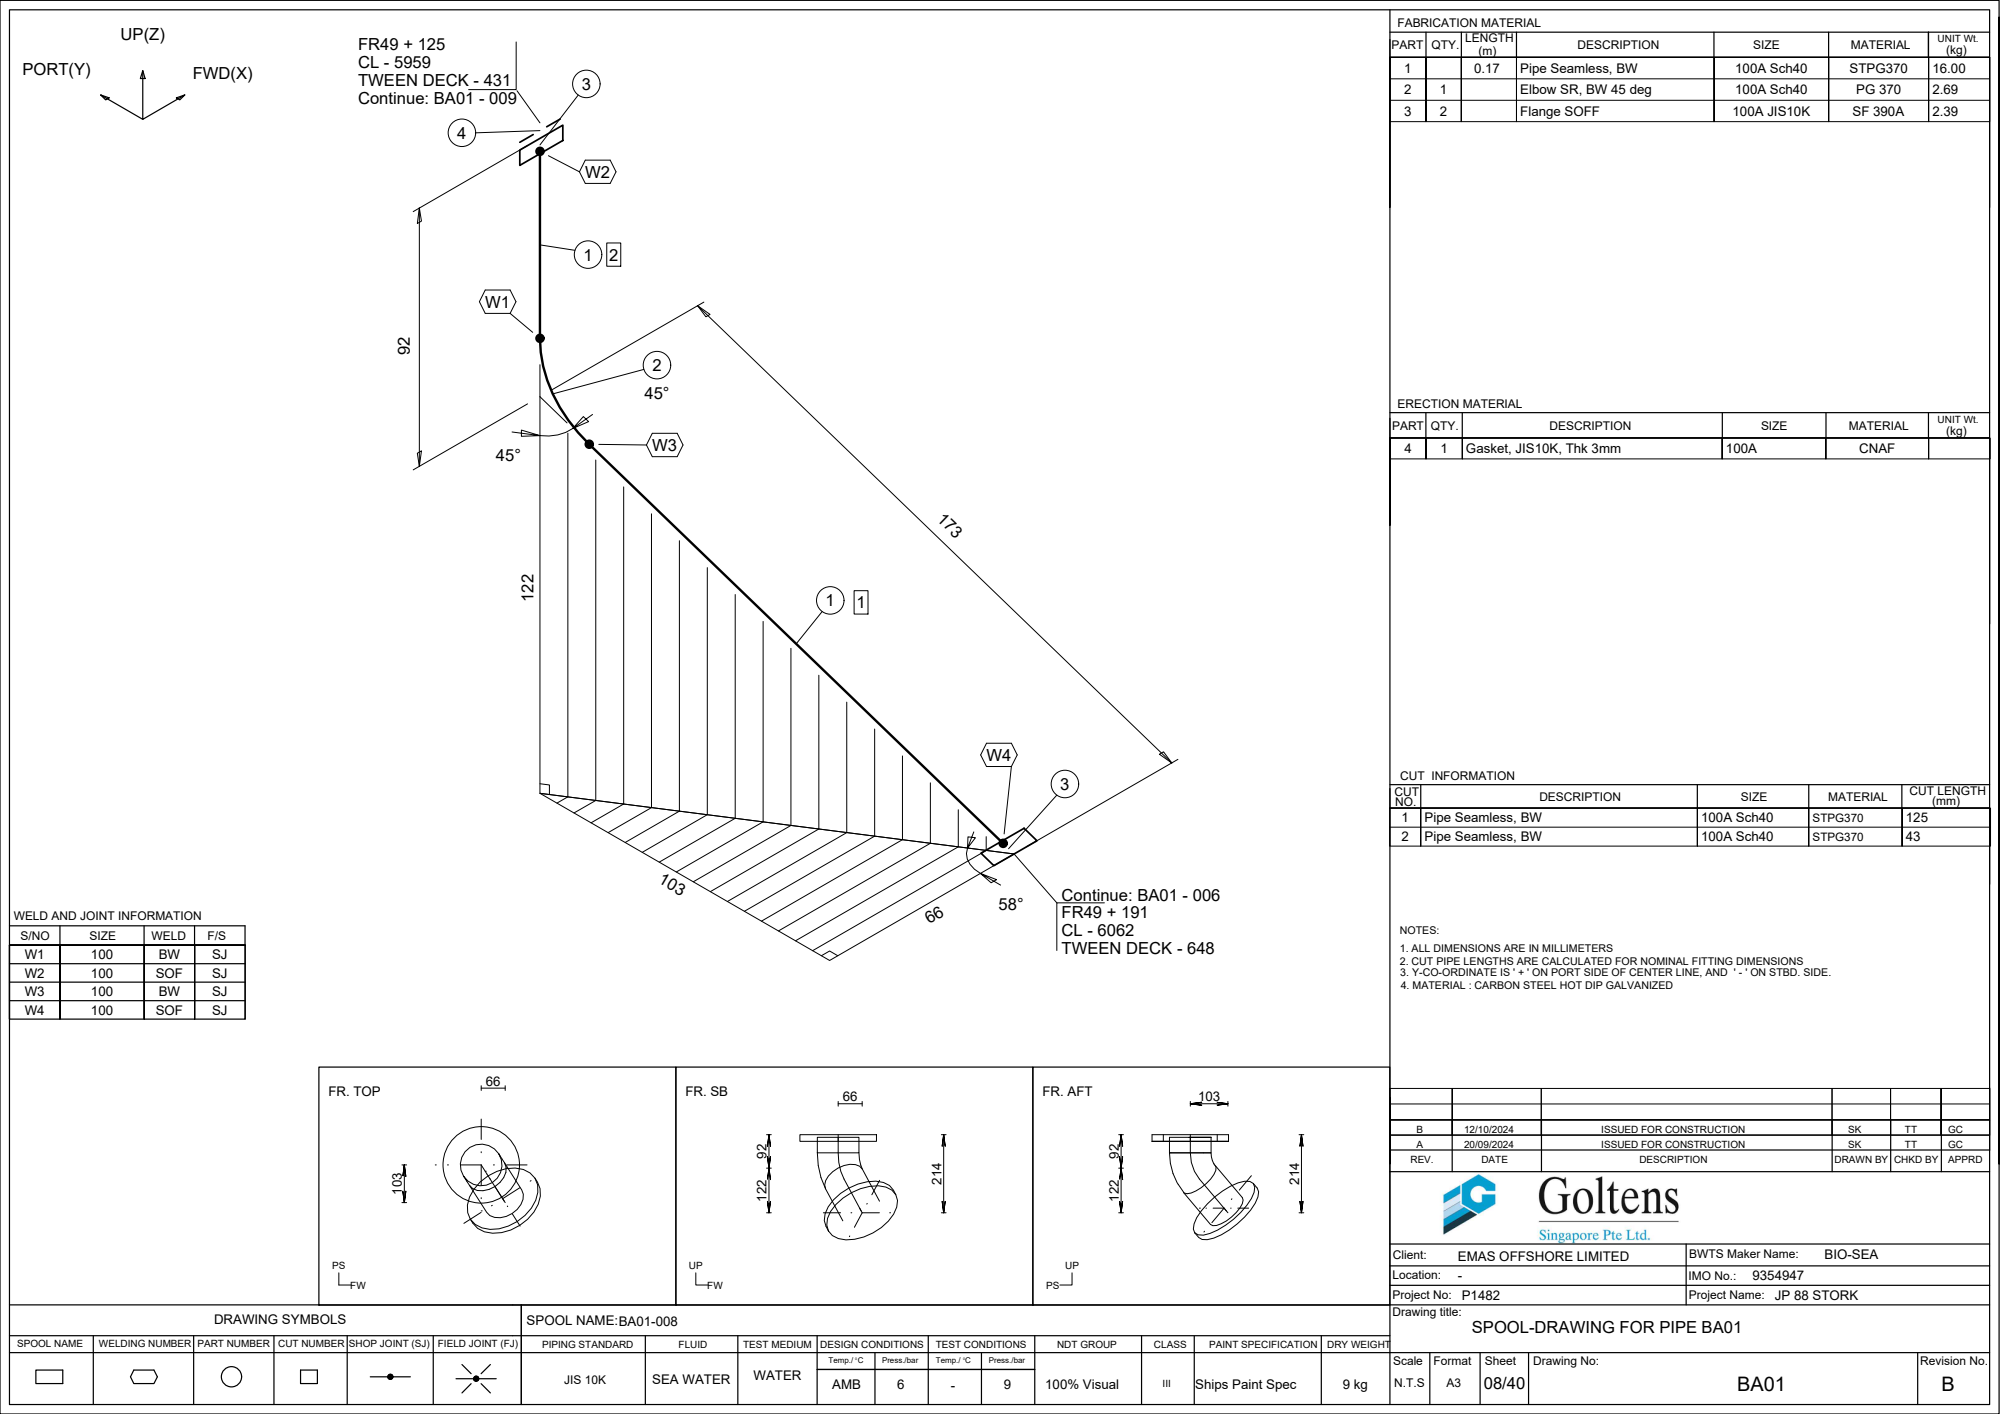
[picture p76: page 9]
103 FR. TOP; FR. AFT 214 92 103; AMB; Flange SOFF; 100A JIS10K; Gasket, JIS10K, Thk 3mm; CNAF; SOF; Pipe Seamless, BW; 100A Sch40; STPG370; REV.; DATE; DESCRIPTION; DRAWN BY; CHKD BY; APPRD; Location:; Client:; ERECTION MATERIAL; CUT INFORMATION; SIZE; WELD; PART; QTY.; MATERIAL; Continue: BA01 - 009; FR49 + 191 CL - 6062 TWEEN DECK - 648; Continue: BA01 - 006

1 | | 0.17 | Pipe Seamless, BW | 100A Sch40 | STPG370 | 16.00
2 | 1 | | Elbow SR, BW 45 deg | 100A Sch40 | PG 370 | 2.69

UNIT Wt. (kg)

CUT NO. | DESCRIPTION | SIZE | MATERIAL | CUT LENGTH (mm)

1 | Pipe Seamless, BW | 100A Sch40 | STPG370 | 125

WELD AND JOINT INFORMATION

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

W1 | 100 | BW | SJ
W2 | 100 | SOF | SJ
W3 | 100 | BW | SJ

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

- BIO-SEA
EMAS OFFSHORE LIMITED

BWTS Maker Name:

IMO No.: NDT GROUP

### TWEEN DECK - 15

FR49 + 125

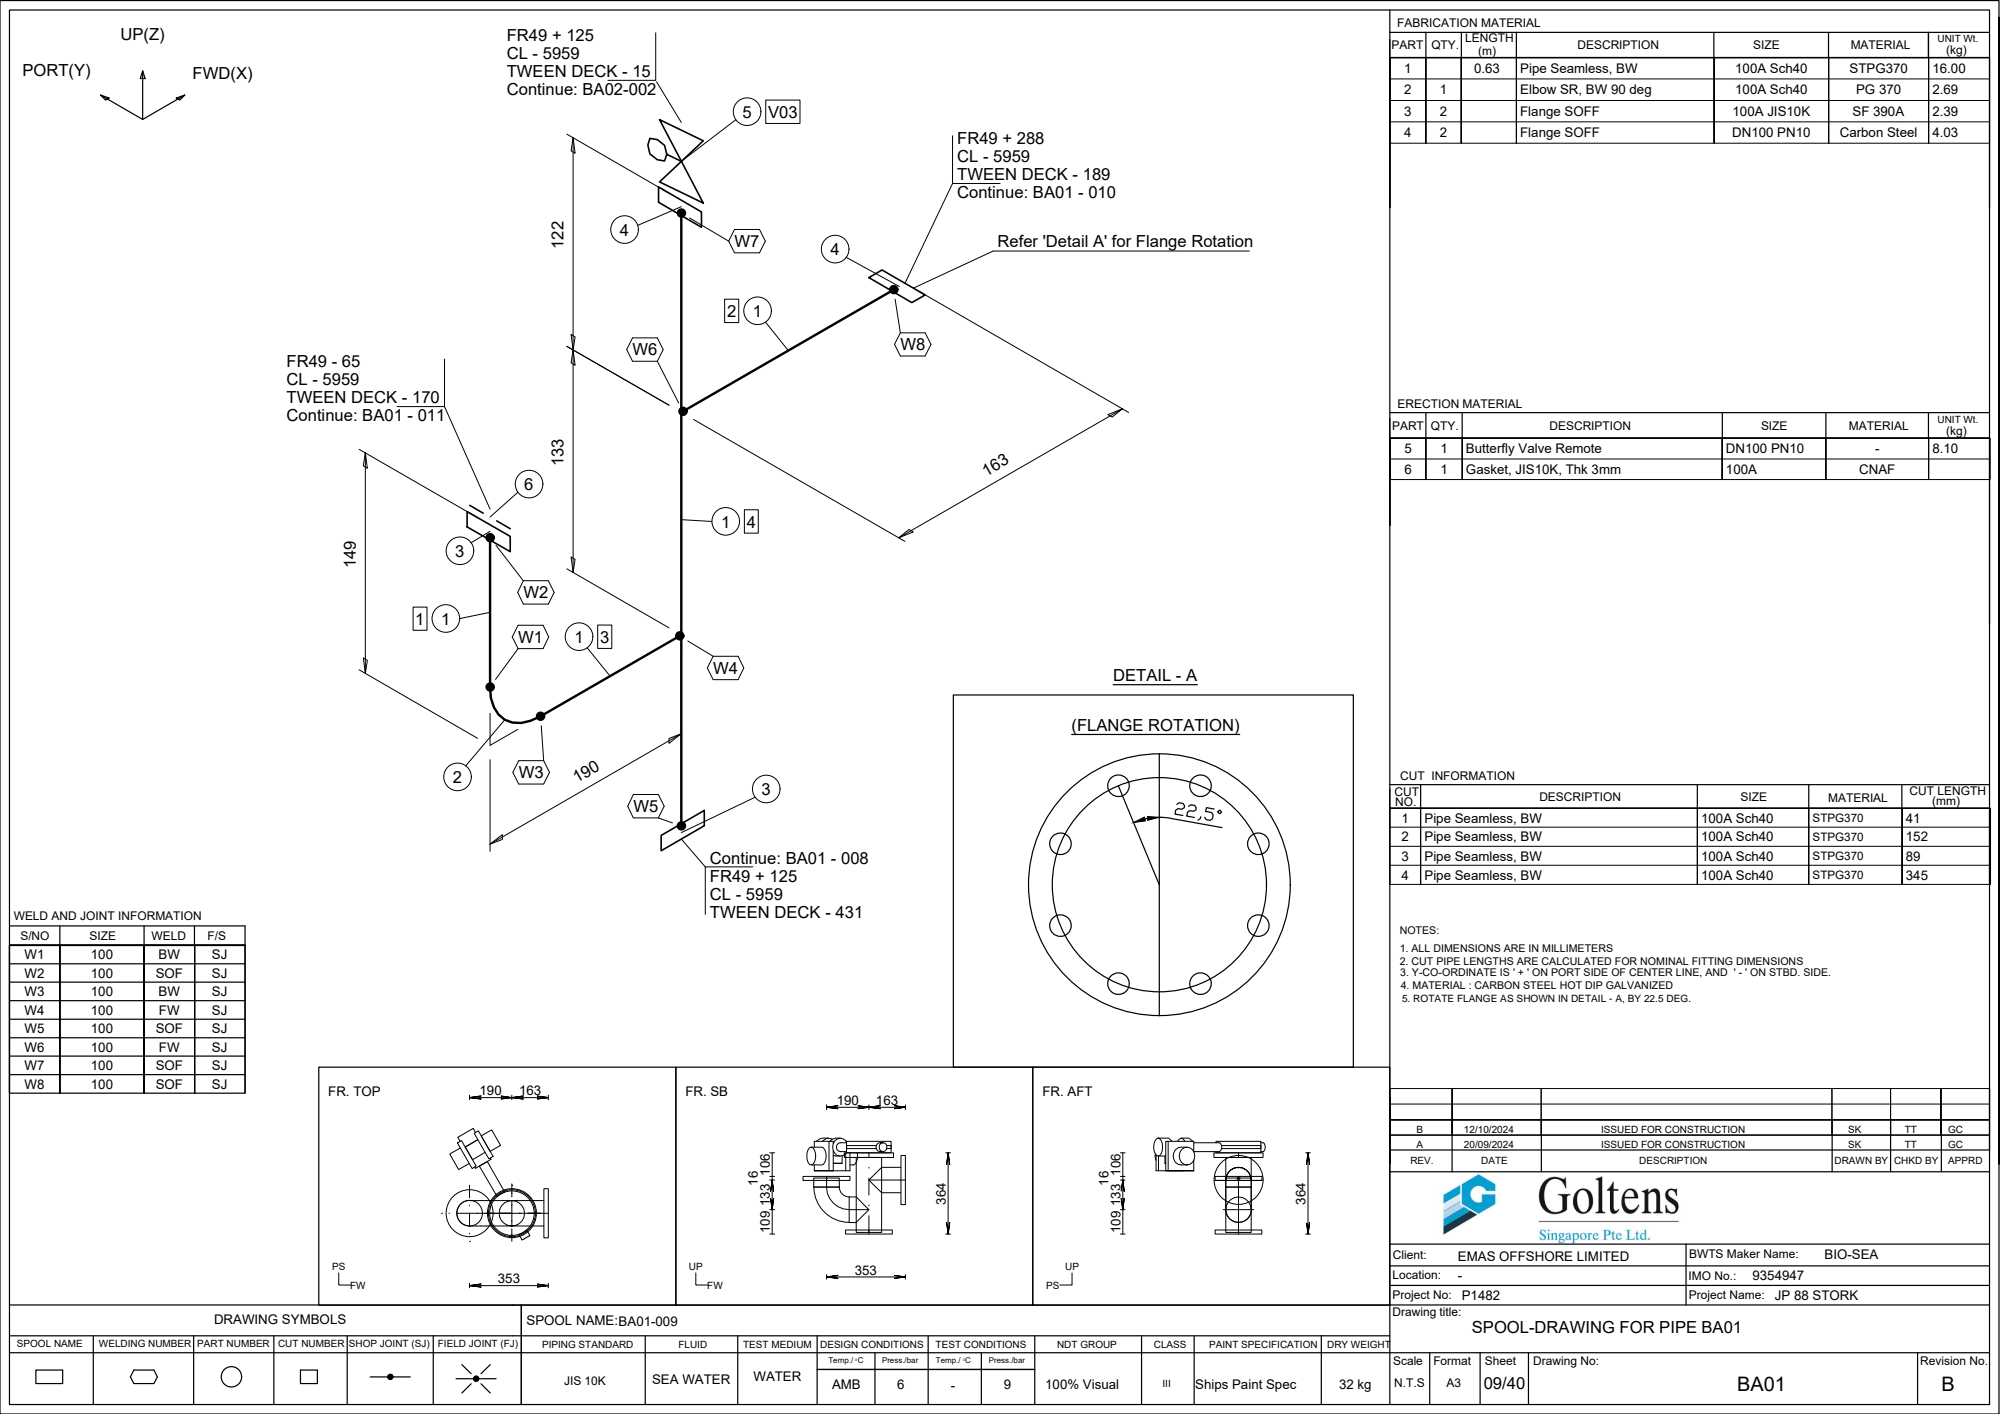
[picture p77: page 10]
FR. TOP; FR. AFT 16; AMB; Flange SOFF; Carbon Steel; Gasket, JIS10K, Thk 3mm; CNAF; SOF; Pipe Seamless, BW; 100A Sch40; STPG370; REV.; DATE; DESCRIPTION; DRAWN BY; CHKD BY; APPRD; Location:; Client:; ERECTION MATERIAL; CUT INFORMATION; SIZE; WELD; IMO No.:; NDT GROUP; ISSUED FOR CONSTRUCTION; FR49 + 125 CL - 5959 TWEEN DECK - 431; Continue: BA01 - 008; TWEEN DECK - 170; Continue: BA01 - 011; Continue: BA02-002; TWEEN DECK - 189; Continue: BA01 - 010; (FLANGE ROTATION); DETAIL - A

1 | | 0.63 | Pipe Seamless, BW | 100A Sch40 | STPG370 | 16.00
2 | 1 | | Elbow SR, BW 90 deg | 100A Sch40 | PG 370 | 2.69
3 | 2 | | Flange SOFF | 100A JIS10K | SF 390A | 2.39

Refer 'Detail A' for Flange Rotation

PART | QTY. | DESCRIPTION | SIZE | MATERIAL | UNIT Wt. (kg)

5 | 1 | Butterfly Valve Remote | DN100 PN10 | - | 8.10

CUT NO. | DESCRIPTION | SIZE | MATERIAL | CUT LENGTH (mm)

1 | Pipe Seamless, BW | 100A Sch40 | STPG370 | 41
2 | Pipe Seamless, BW | 100A Sch40 | STPG370 | 152
3 | Pipe Seamless, BW | 100A Sch40 | STPG370 | 89

WELD AND JOINT INFORMATION

NOTES:
1. ALL DIMENSIONS ARE IN MILLIMETERS
2. CUT PIPE LENGTHS ARE CALCULATED FOR NOMINAL FITTING DIMENSIONS
3. Y-CO-ORDINATE IS ' + ' ON PORT SIDE OF CENTER LINE, AND ' - ' ON STBD. SIDE.
4. MATERIAL : CARBON STEEL HOT DIP GALVANIZED
5. ROTATE FLANGE AS SHOWN IN DETAIL - A, BY 22.5 DEG.

W1 | 100 | BW | SJ
W2 | 100 | SOF | SJ
W3 | 100 | BW | SJ
W4 | 100 | FW | SJ
W5 | 100 | SOF | SJ
W6 | 100 | FW | SJ
W7 | 100 | SOF | SJ

- BIO-SEA
EMAS OFFSHORE LIMITED

BWTS Maker Name:

### TWEEN DECK - 189

CL - 5959

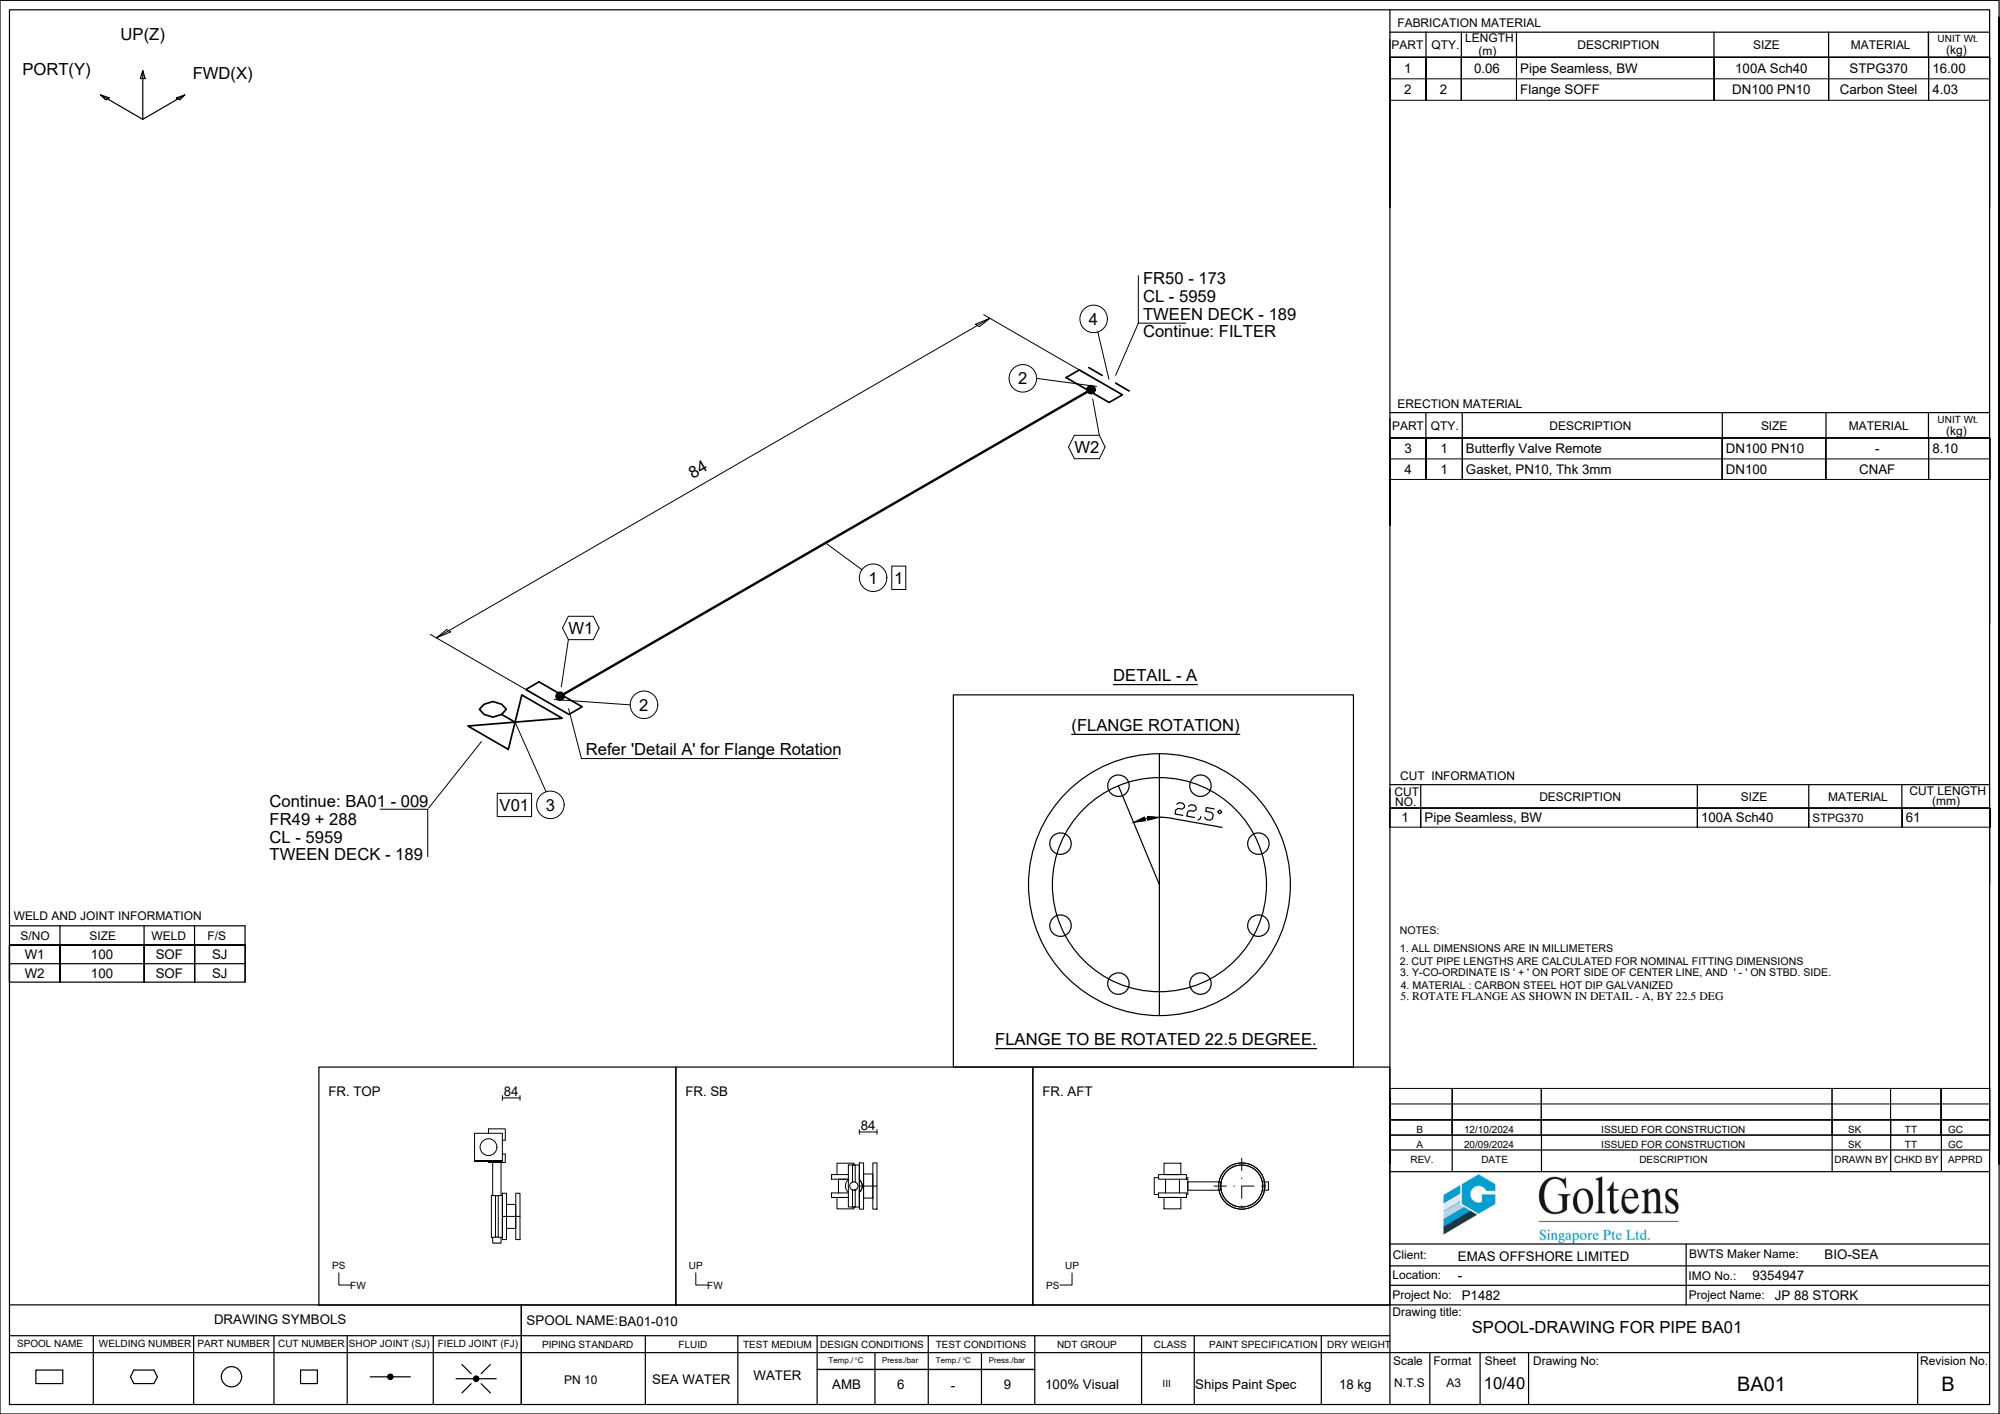
[picture p78: page 11]
FR. TOP; FR. AFT; AMB; Pipe Seamless, BW; 100A Sch40; STPG370; Flange SOFF; Carbon Steel; Gasket, PN10, Thk 3mm; CNAF; SOF; REV.; DATE; DESCRIPTION; DRAWN BY; CHKD BY; APPRD; Location:; Client:; ERECTION MATERIAL; CUT INFORMATION; SIZE; WELD; FR49 + 288 CL - 5959 TWEEN DECK - 189; Continue: BA01 - 009; Continue: FILTER; (FLANGE ROTATION); DETAIL - A

PART | QTY. | DESCRIPTION | SIZE | MATERIAL | UNIT Wt. (kg)

3 | 1 | Butterfly Valve Remote | DN100 PN10 | - | 8.10

Refer 'Detail A' for Flange Rotation

CUT NO. | DESCRIPTION | SIZE | MATERIAL | CUT LENGTH (mm)

1 | Pipe Seamless, BW | 100A Sch40 | STPG370 | 61

WELD AND JOINT INFORMATION

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

FLANGE TO BE ROTATED 22.5 DEGREE.

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

- BIO-SEA
EMAS OFFSHORE LIMITED

BWTS Maker Name:

IMO No.: NDT GROUP

### FWD(X)

PORT(Y) | 362 | 362

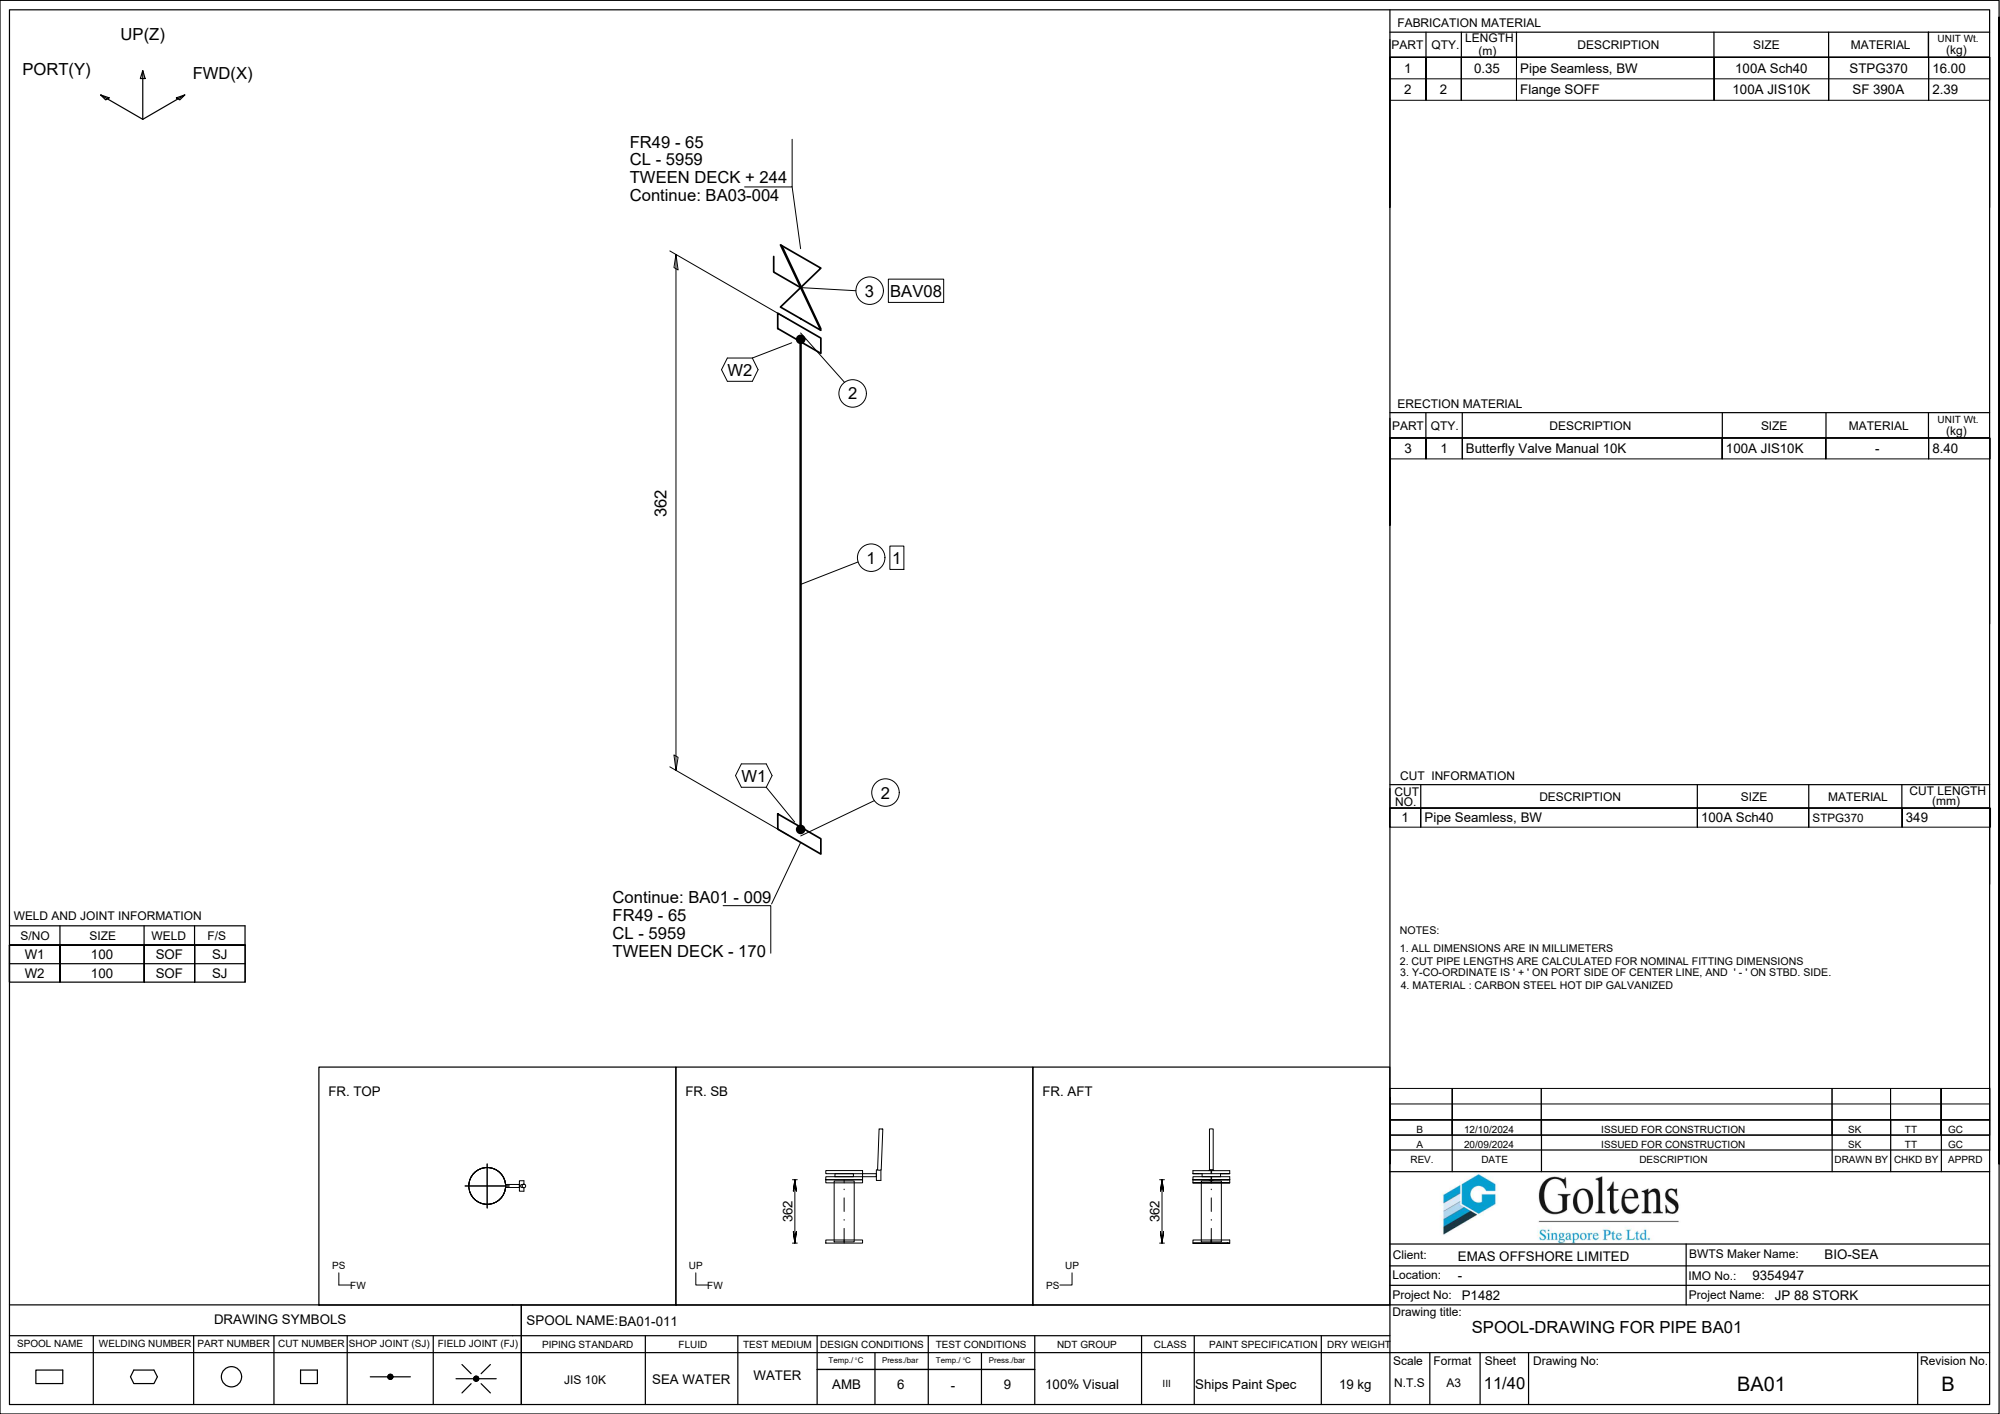
[picture p79: page 12]
FR. TOP; FR. AFT; AMB; Pipe Seamless, BW; 100A Sch40; STPG370; Flange SOFF; 100A JIS10K; Butterfly Valve Manual 10K; SOF; REV.; DATE; DESCRIPTION; DRAWN BY; CHKD BY; APPRD; Location:; Client:; ERECTION MATERIAL; CUT INFORMATION; SIZE; WELD; PART; QTY.; MATERIAL; ISSUED FOR CONSTRUCTION; TWEEN DECK + 244; Continue: BA03-004; FR49 - 65 CL - 5959 TWEEN DECK - 170; Continue: BA01 - 009; BAV08

UNIT Wt. (kg)

CUT NO. | DESCRIPTION | SIZE | MATERIAL | CUT LENGTH (mm)

1 | Pipe Seamless, BW | 100A Sch40 | STPG370 | 349

WELD AND JOINT INFORMATION

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

- BIO-SEA
EMAS OFFSHORE LIMITED

BWTS Maker Name:

IMO No.: NDT GROUP

### TWEEN DECK + 91

CL - 5959

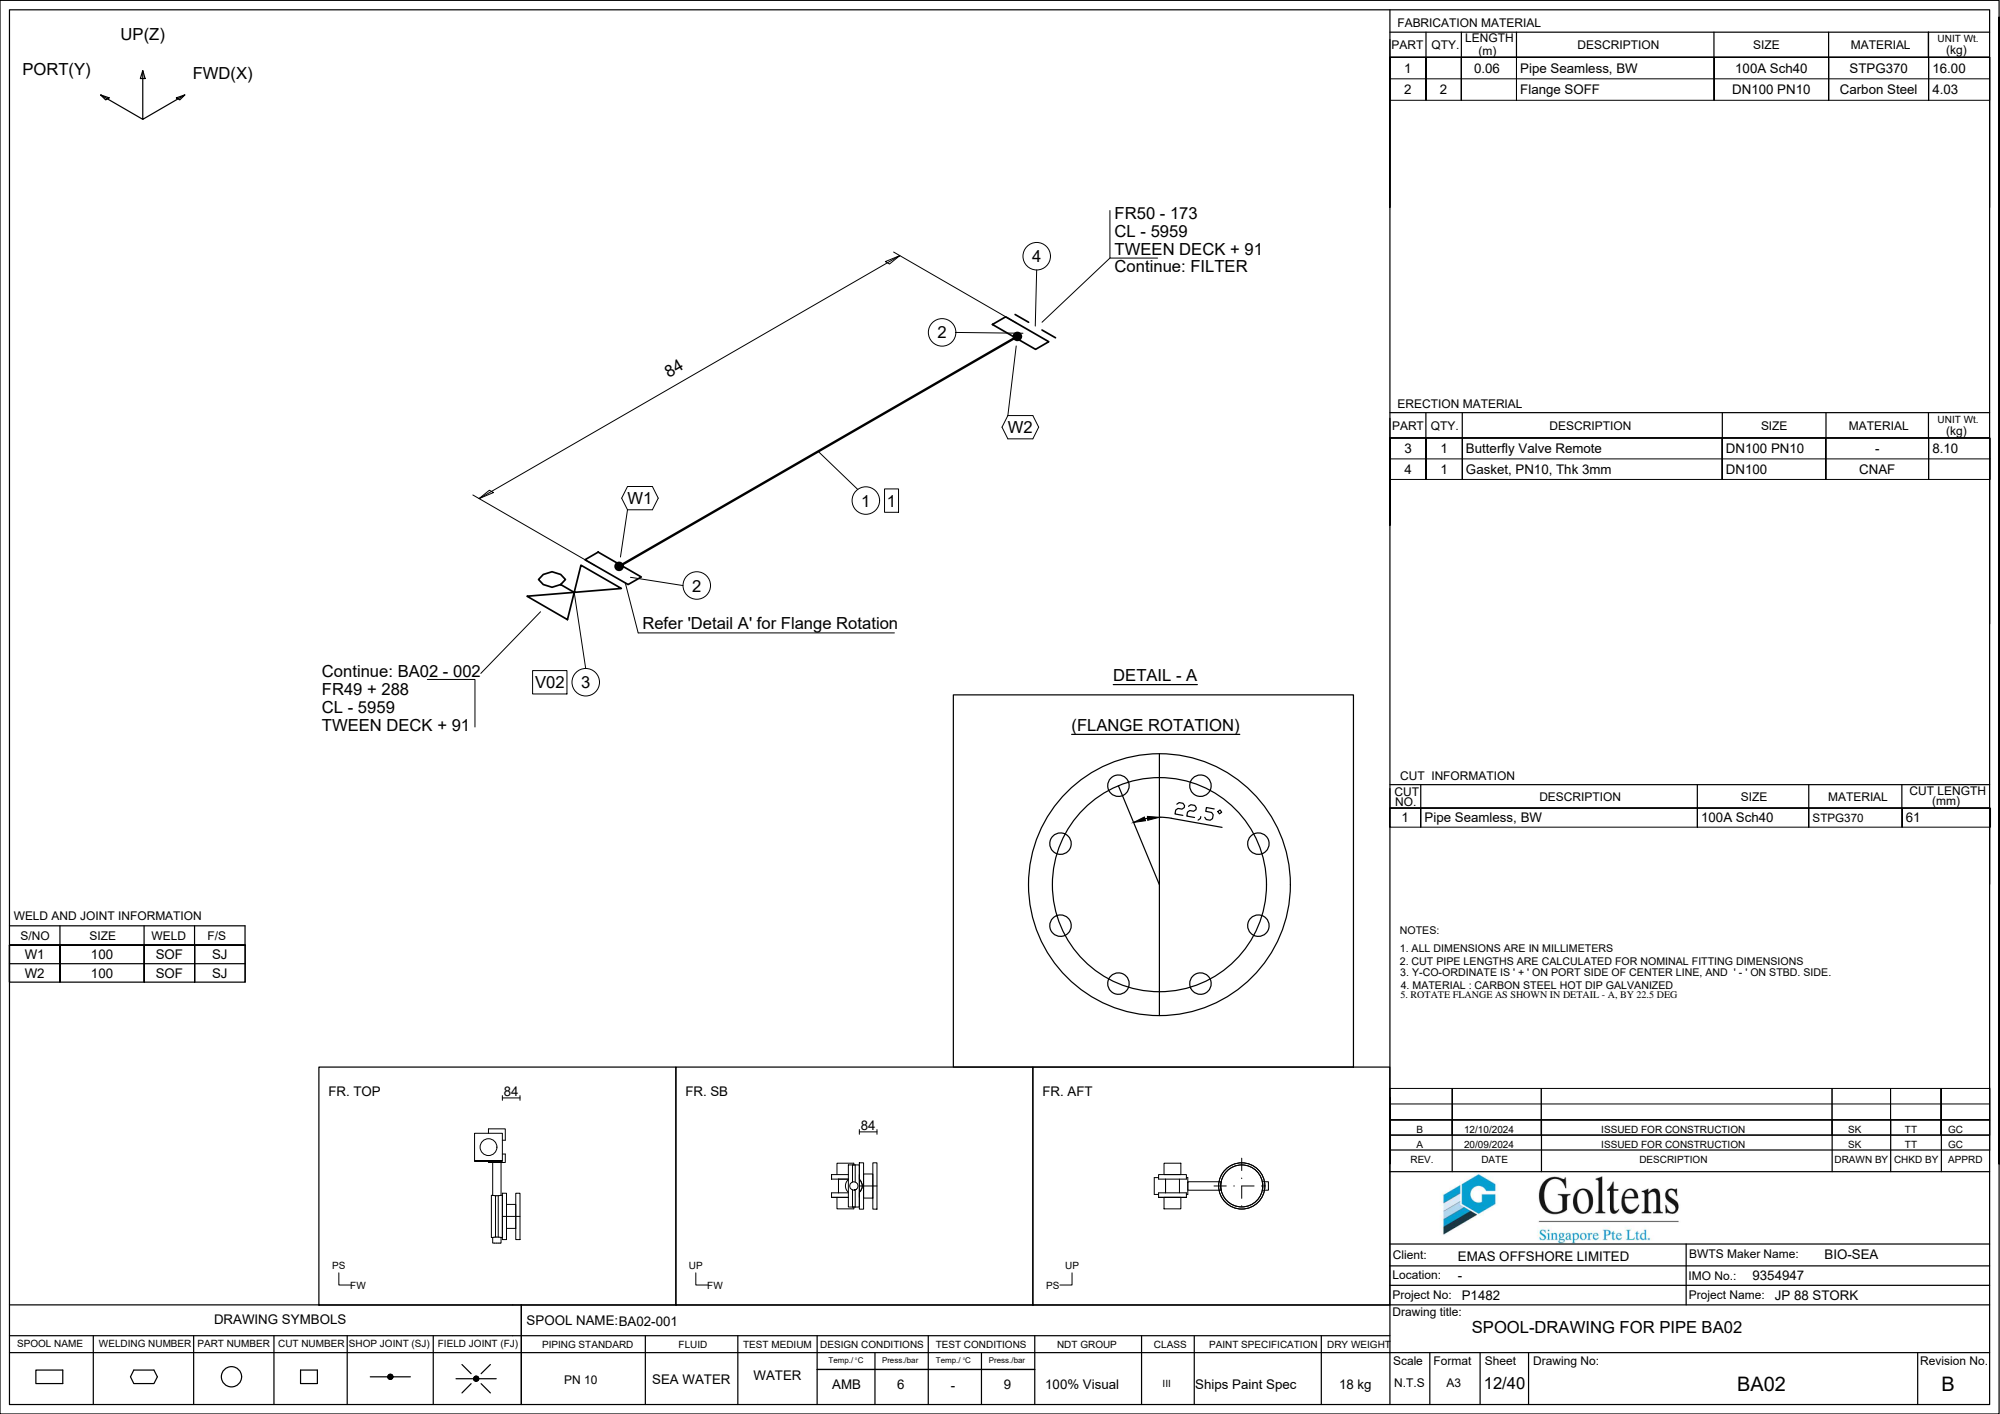
[picture p80: page 13]
FR. TOP; FR. AFT; AMB; Pipe Seamless, BW; 100A Sch40; STPG370; Flange SOFF; Carbon Steel; Gasket, PN10, Thk 3mm; CNAF; SOF; REV.; DATE; DESCRIPTION; DRAWN BY; CHKD BY; APPRD; Location:; Client:; ERECTION MATERIAL; CUT INFORMATION; SIZE; WELD; FR49 + 288 CL - 5959 TWEEN DECK + 91; Continue: BA02 - 002; Continue: FILTER; (FLANGE ROTATION); DETAIL - A

PART | QTY. | DESCRIPTION | SIZE | MATERIAL | UNIT Wt. (kg)

3 | 1 | Butterfly Valve Remote | DN100 PN10 | - | 8.10

Refer 'Detail A' for Flange Rotation

CUT NO. | DESCRIPTION | SIZE | MATERIAL | CUT LENGTH (mm)

1 | Pipe Seamless, BW | 100A Sch40 | STPG370 | 61

WELD AND JOINT INFORMATION

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

- BIO-SEA
EMAS OFFSHORE LIMITED

BWTS Maker Name:

IMO No.: NDT GROUP

### TWEEN DECK + 370

FR49 + 125

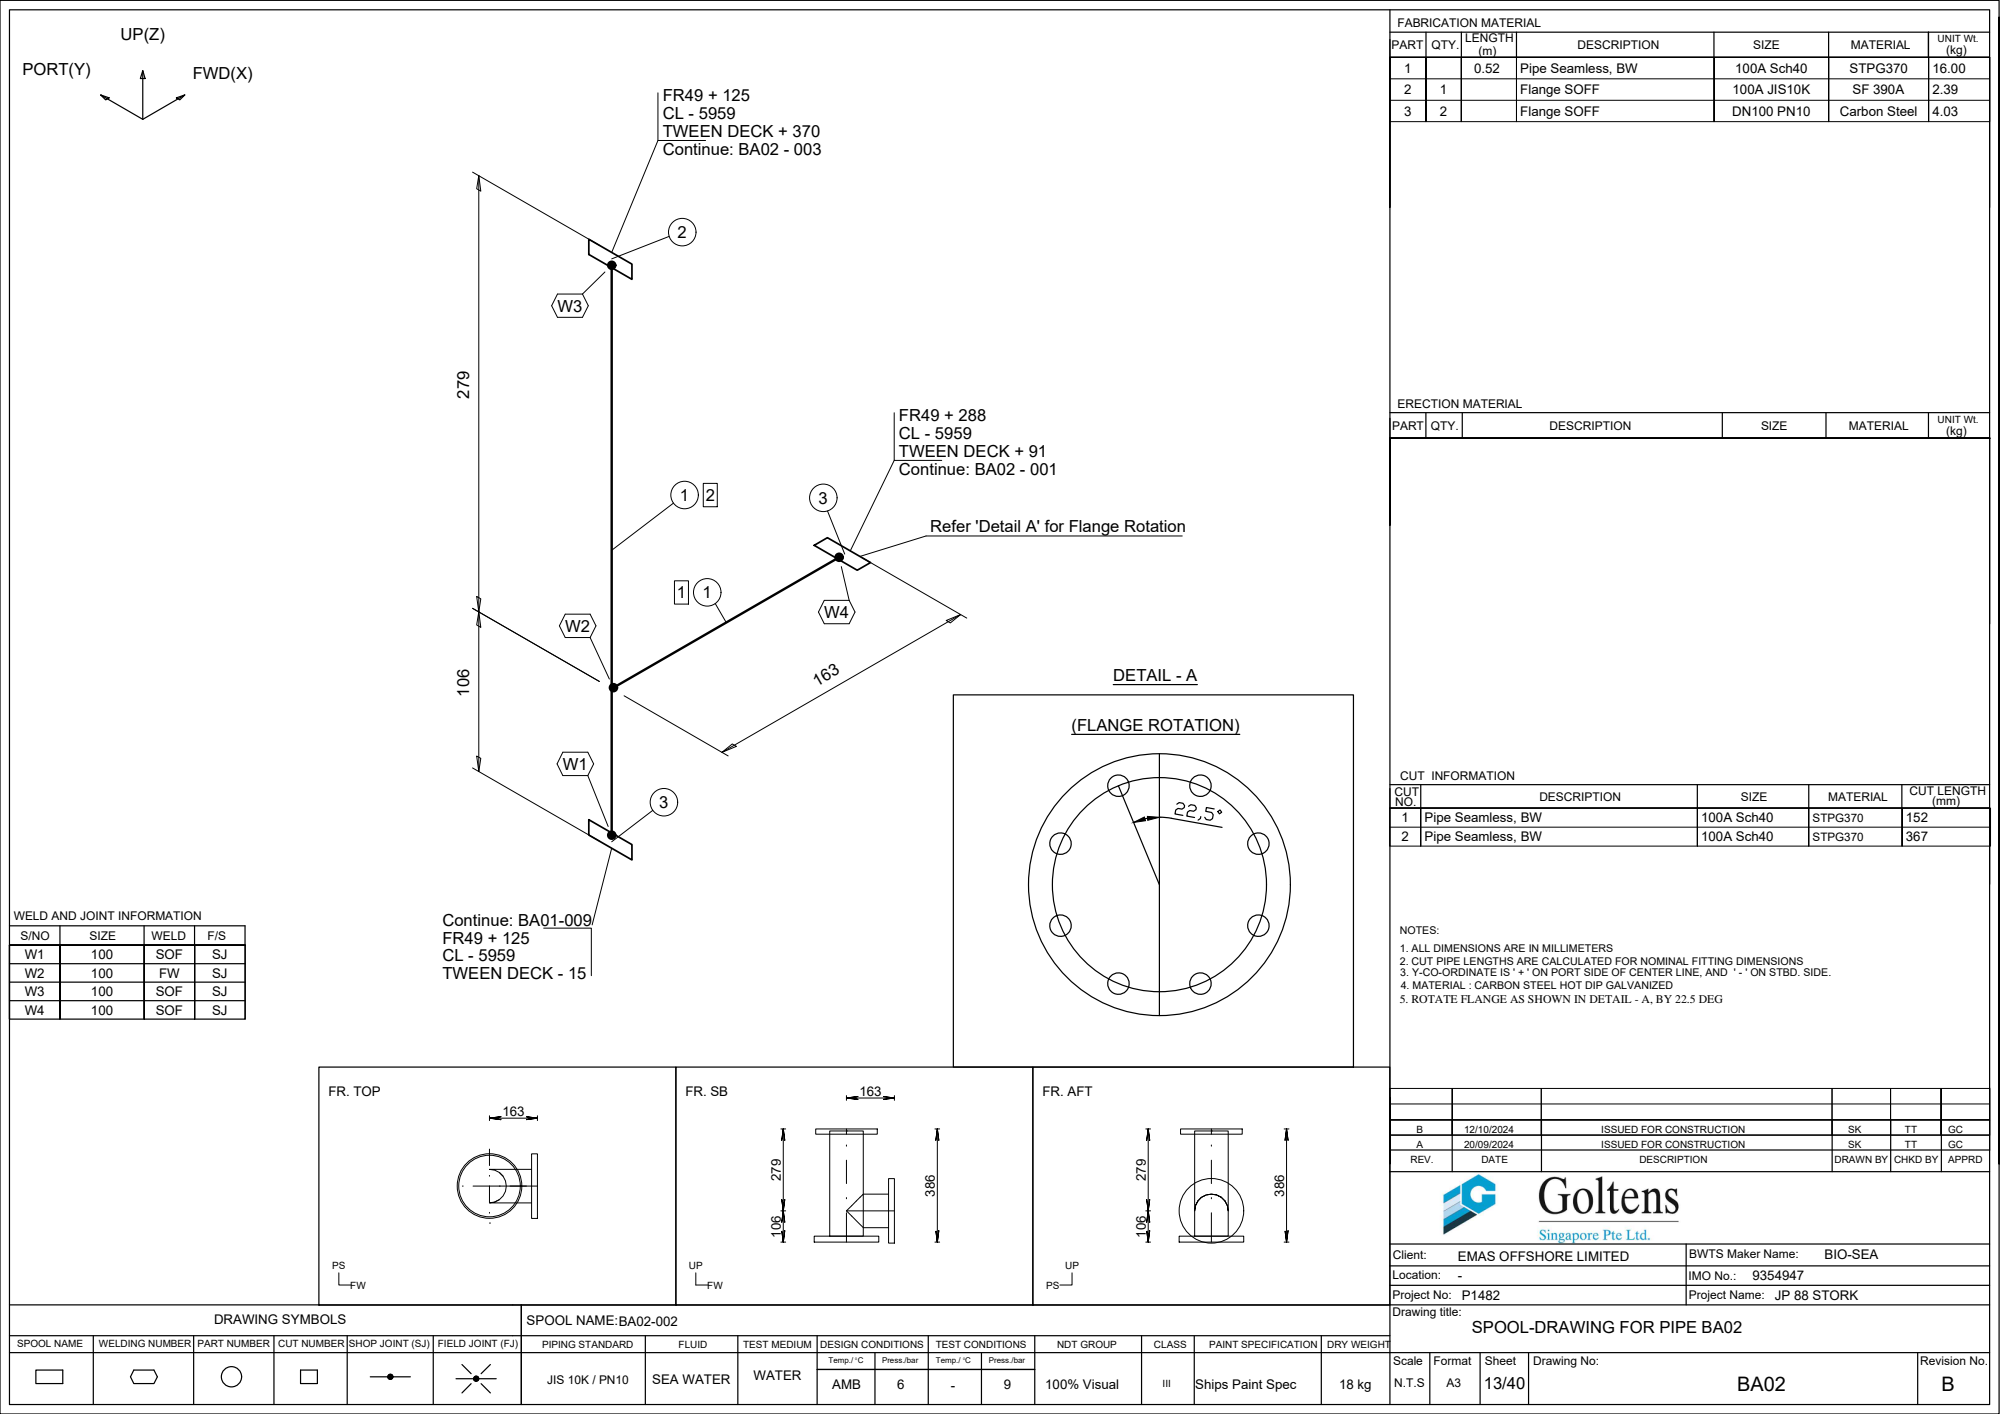
[picture p81: page 14]
FR. TOP; FR. AFT 106 279; AMB; Flange SOFF; Carbon Steel; SOF; Pipe Seamless, BW; 100A Sch40; STPG370; REV.; DATE; DESCRIPTION; DRAWN BY; CHKD BY; APPRD; Location:; Client:; ERECTION MATERIAL; CUT INFORMATION; SIZE; WELD; PART; QTY.; MATERIAL; JIS 10K / PN10; ISSUED FOR CONSTRUCTION; Continue: BA02 - 003; FR49 + 125 CL - 5959 TWEEN DECK - 15; Continue: BA01-009; TWEEN DECK + 91; Continue: BA02 - 001; (FLANGE ROTATION); DETAIL - A

1 | | 0.52 | Pipe Seamless, BW | 100A Sch40 | STPG370 | 16.00
2 | 1 | | Flange SOFF | 100A JIS10K | SF 390A | 2.39

UNIT Wt. (kg)

Refer 'Detail A' for Flange Rotation

CUT NO. | DESCRIPTION | SIZE | MATERIAL | CUT LENGTH (mm)

1 | Pipe Seamless, BW | 100A Sch40 | STPG370 | 152

WELD AND JOINT INFORMATION

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

W1 | 100 | SOF | SJ
W2 | 100 | FW | SJ
W3 | 100 | SOF | SJ

- BIO-SEA
EMAS OFFSHORE LIMITED

BWTS Maker Name:

IMO No.: NDT GROUP

FR49 + 125
CL - 6067

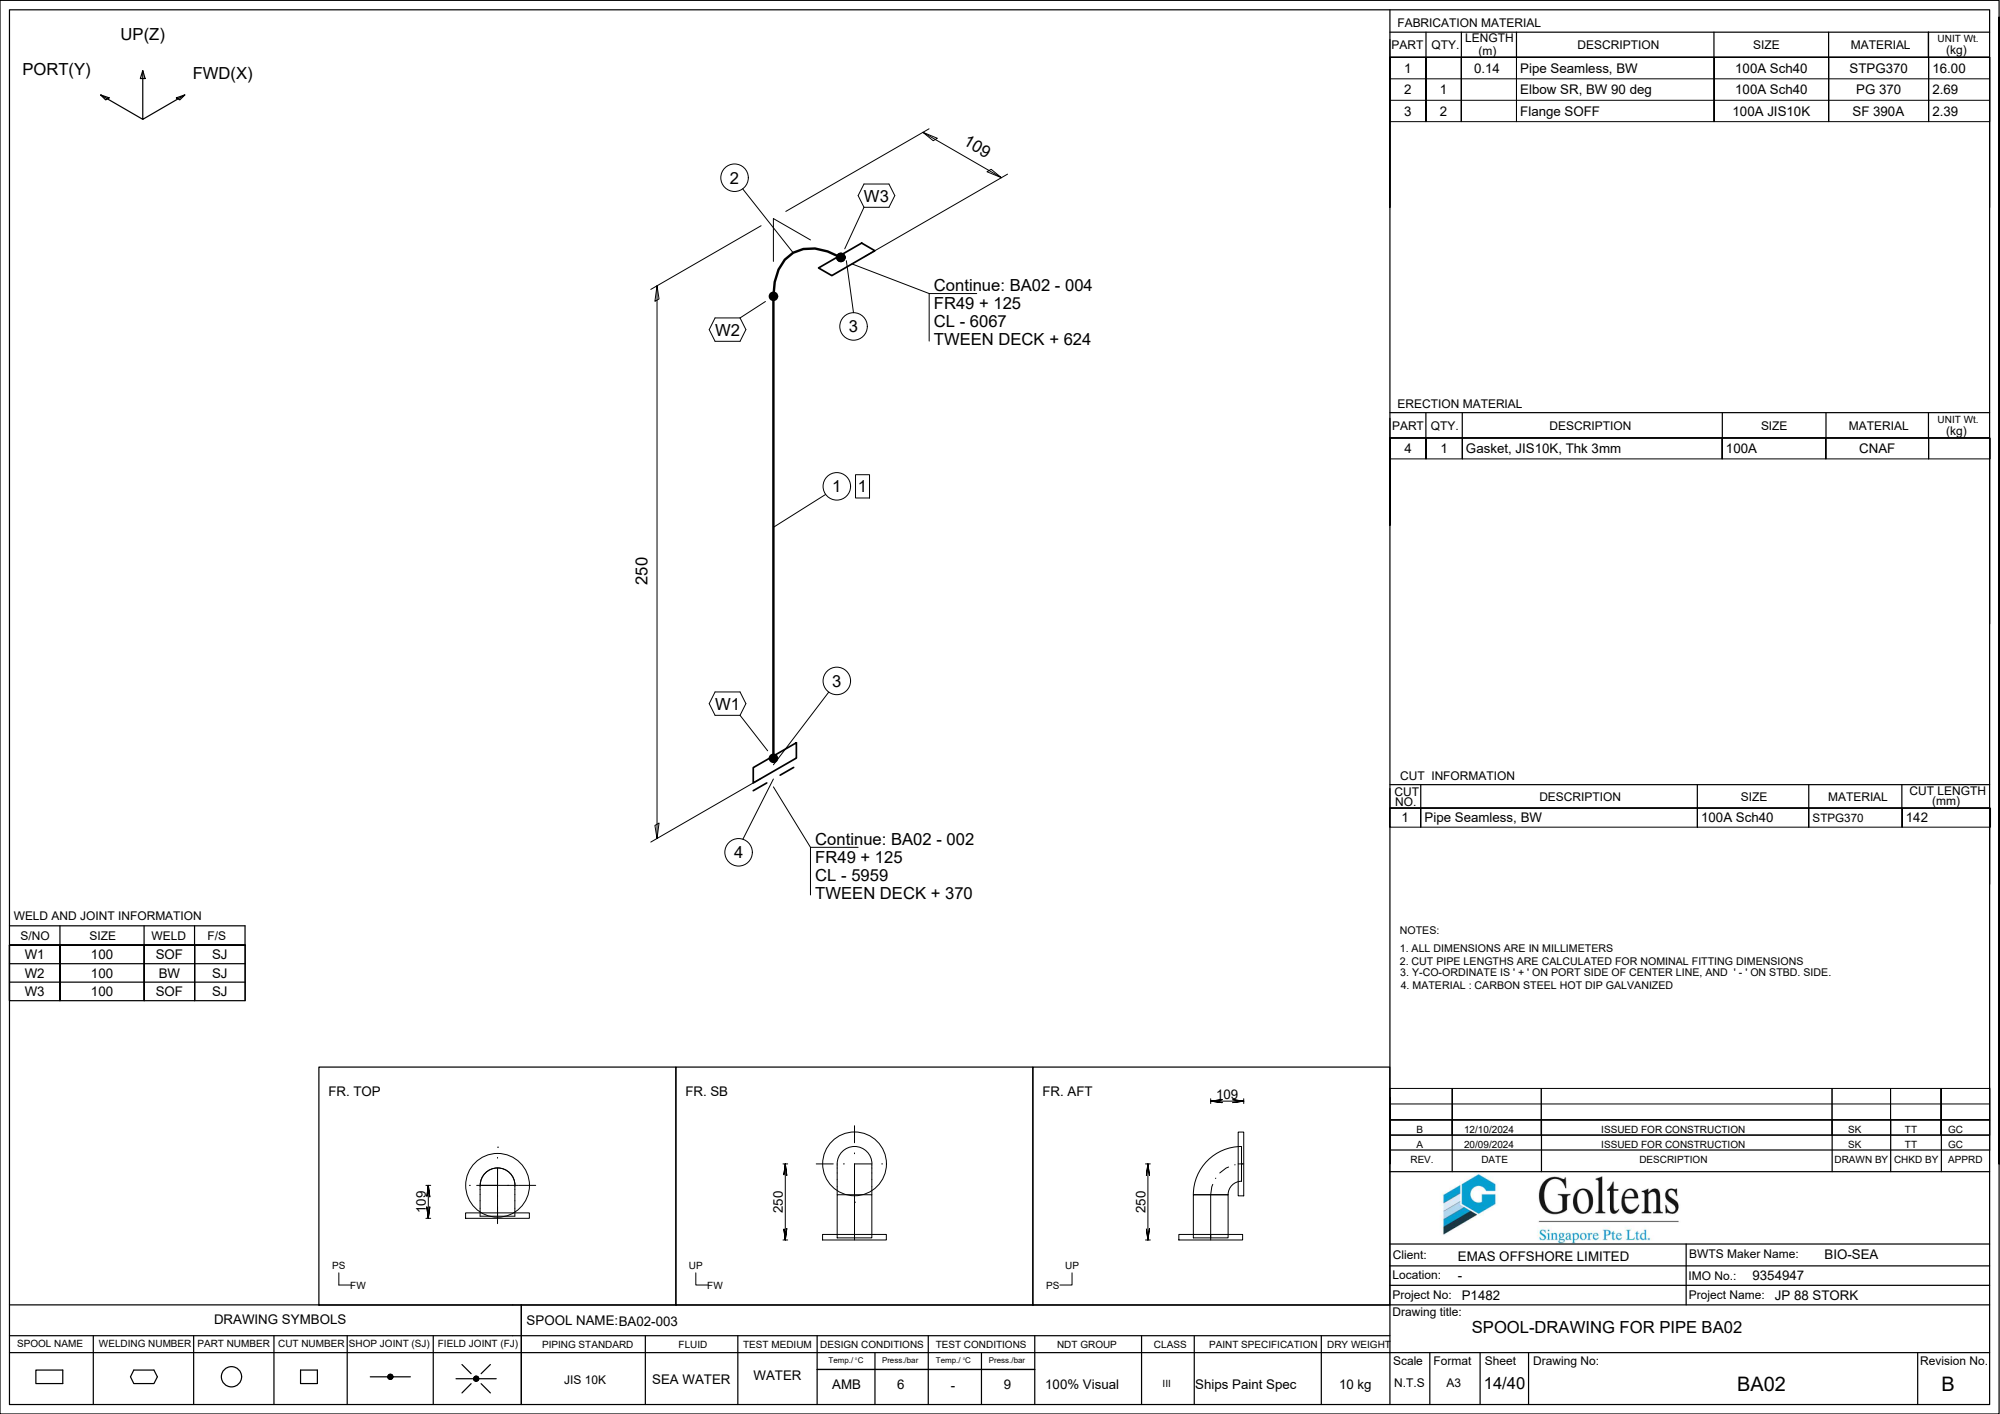
[picture p82: page 15]
FR. TOP; FR. AFT; AMB; Flange SOFF; 100A JIS10K; Gasket, JIS10K, Thk 3mm; CNAF; SOF; REV.; DATE; DESCRIPTION; DRAWN BY; CHKD BY; APPRD; Location:; Client:; ERECTION MATERIAL; CUT INFORMATION; SIZE; WELD; PART; QTY.; MATERIAL; ISSUED FOR CONSTRUCTION; FR49 + 125 CL - 5959 TWEEN DECK + 370; Continue: BA02 - 002; TWEEN DECK + 624; Continue: BA02 - 004

1 | | 0.14 | Pipe Seamless, BW | 100A Sch40 | STPG370 | 16.00
2 | 1 | | Elbow SR, BW 90 deg | 100A Sch40 | PG 370 | 2.69

UNIT Wt. (kg)

CUT NO. | DESCRIPTION | SIZE | MATERIAL | CUT LENGTH (mm)

1 | Pipe Seamless, BW | 100A Sch40 | STPG370 | 142

WELD AND JOINT INFORMATION

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

W1 | 100 | SOF | SJ
W2 | 100 | BW | SJ

- BIO-SEA
EMAS OFFSHORE LIMITED

BWTS Maker Name:

IMO No.: NDT GROUP

PORT(Y) | FWD(X) | 175

### TWEEN DECK + 624

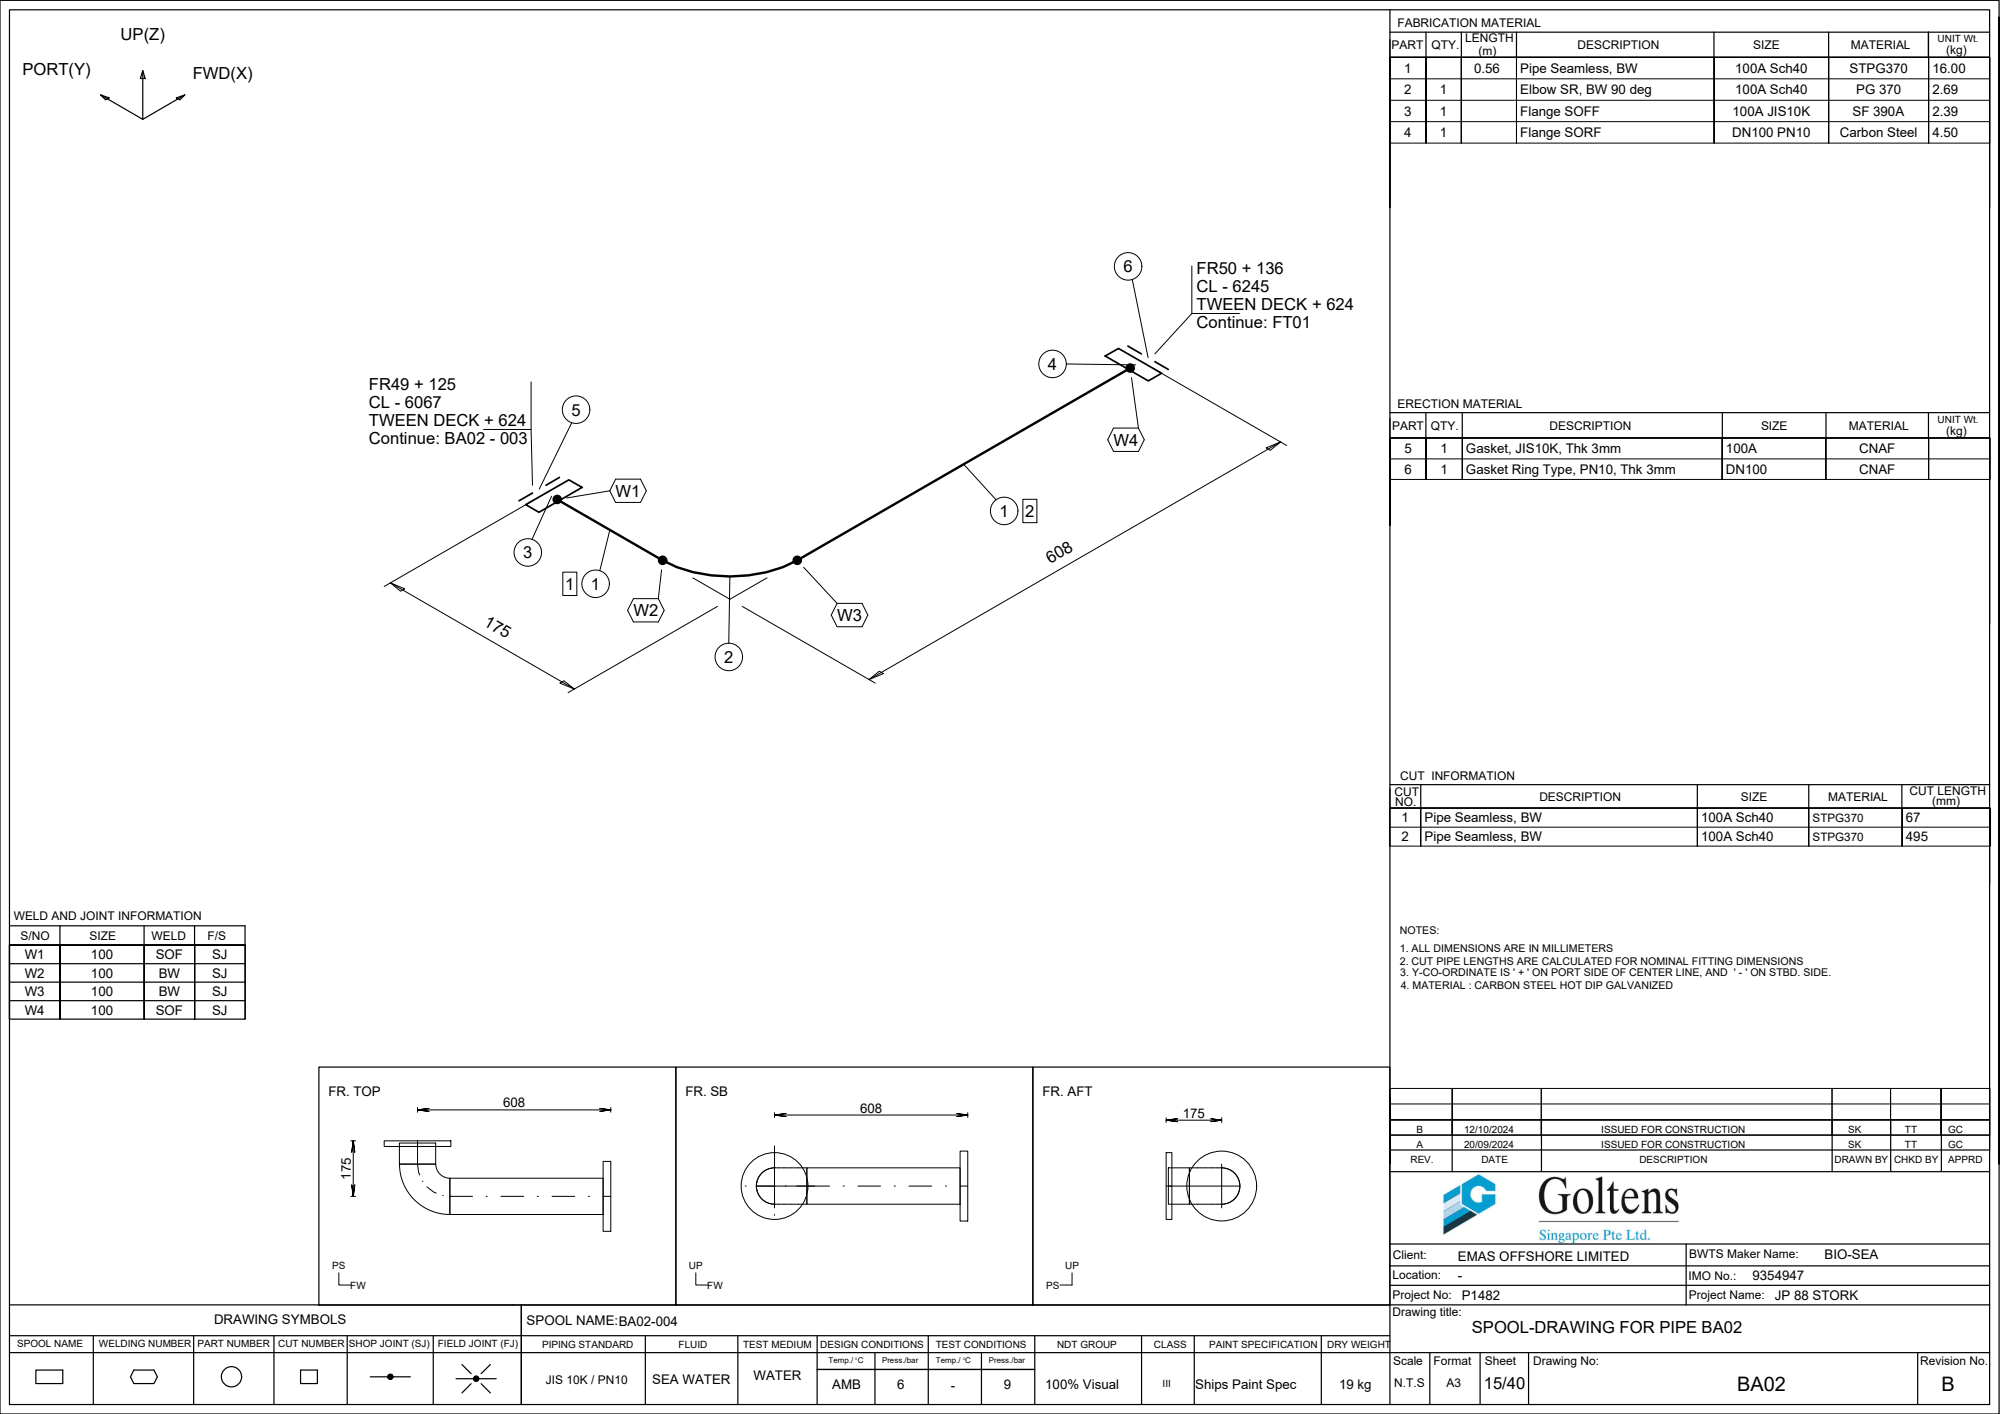
[picture p83: page 16]
FR. TOP; FR. AFT; AMB; Flange SORF; Carbon Steel; Gasket Ring Type, PN10, Thk 3mm; CNAF; SOF; Pipe Seamless, BW; 100A Sch40; STPG370; REV.; DATE; DESCRIPTION; DRAWN BY; CHKD BY; APPRD; Location:; Client:; ERECTION MATERIAL; CUT INFORMATION; SIZE; WELD; JIS 10K / PN10; TWEEN DECK + 624; Continue: BA02 - 003; Continue: FT01

1 | | 0.56 | Pipe Seamless, BW | 100A Sch40 | STPG370 | 16.00
2 | 1 | | Elbow SR, BW 90 deg | 100A Sch40 | PG 370 | 2.69
3 | 1 | | Flange SOFF | 100A JIS10K | SF 390A | 2.39

PART | QTY. | DESCRIPTION | SIZE | MATERIAL | UNIT Wt. (kg)

5 | 1 | Gasket, JIS10K, Thk 3mm | 100A | CNAF

CUT NO. | DESCRIPTION | SIZE | MATERIAL | CUT LENGTH (mm)

1 | Pipe Seamless, BW | 100A Sch40 | STPG370 | 67

WELD AND JOINT INFORMATION

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

W1 | 100 | SOF | SJ
W2 | 100 | BW | SJ
W3 | 100 | BW | SJ

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

- BIO-SEA
EMAS OFFSHORE LIMITED

BWTS Maker Name:

IMO No.: NDT GROUP

PORT(Y) | FWD(X) | 114

### TWEEN DECK + 624

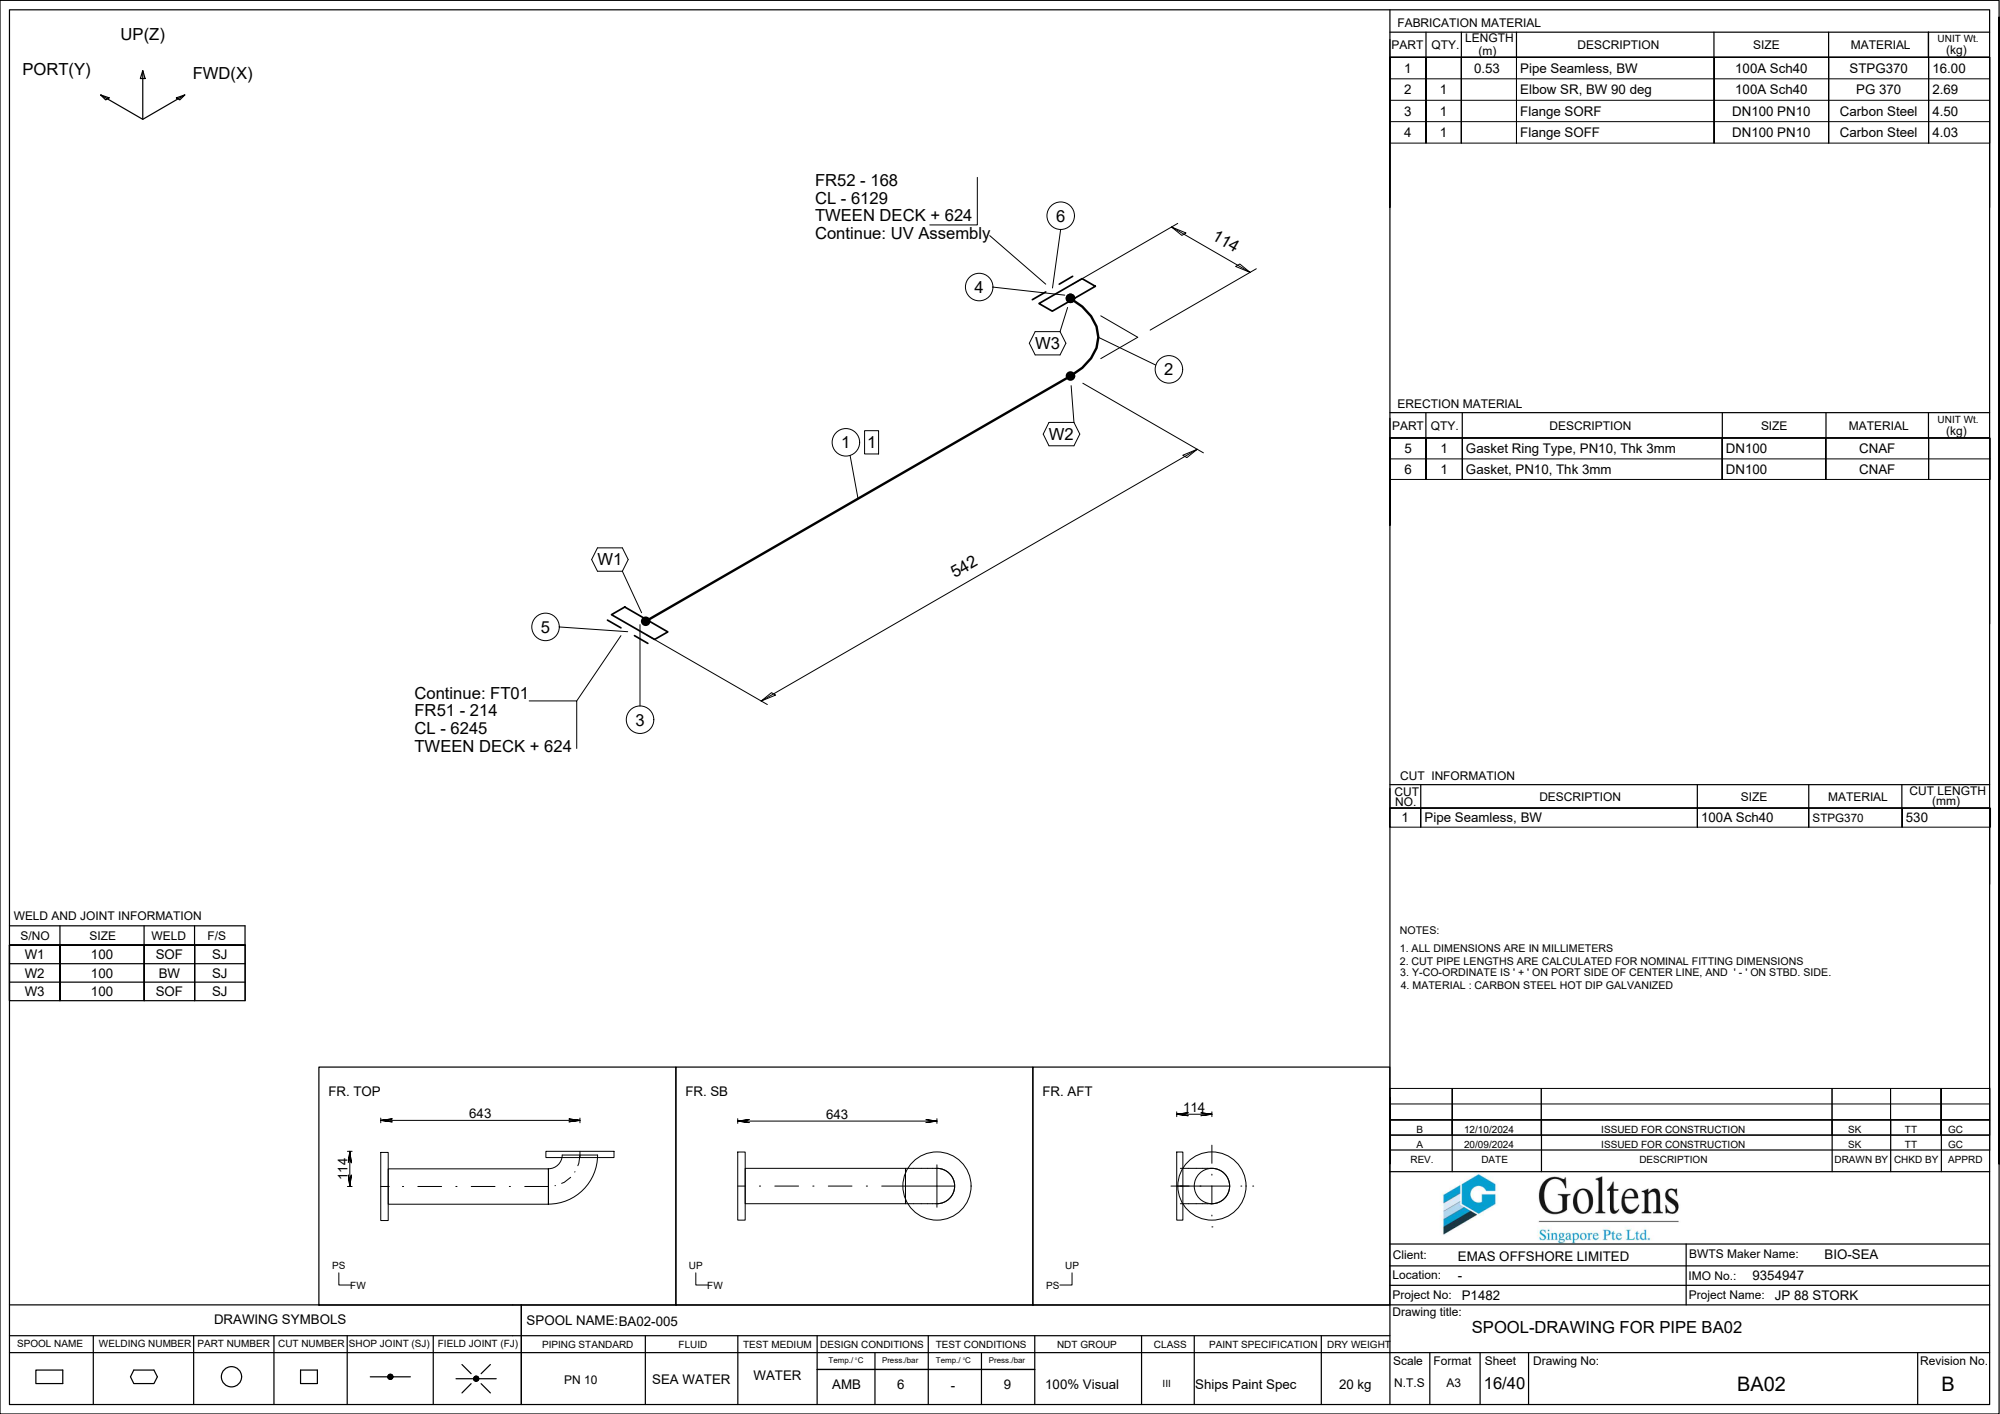
[picture p84: page 17]
FR. TOP; FR. AFT; AMB; Flange SOFF; Carbon Steel; Gasket, PN10, Thk 3mm; CNAF; SOF; REV.; DATE; DESCRIPTION; DRAWN BY; CHKD BY; APPRD; Location:; Client:; ERECTION MATERIAL; CUT INFORMATION; SIZE; WELD; FR51 - 214 CL - 6245 TWEEN DECK + 624; Continue: FT01

1 | | 0.53 | Pipe Seamless, BW | 100A Sch40 | STPG370 | 16.00
2 | 1 | | Elbow SR, BW 90 deg | 100A Sch40 | PG 370 | 2.69
3 | 1 | | Flange SORF | DN100 PN10 | Carbon Steel | 4.50

Continue: UV Assembly

PART | QTY. | DESCRIPTION | SIZE | MATERIAL | UNIT Wt. (kg)

5 | 1 | Gasket Ring Type, PN10, Thk 3mm | DN100 | CNAF

CUT NO. | DESCRIPTION | SIZE | MATERIAL | CUT LENGTH (mm)

1 | Pipe Seamless, BW | 100A Sch40 | STPG370 | 530

WELD AND JOINT INFORMATION

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

W1 | 100 | SOF | SJ
W2 | 100 | BW | SJ

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

- BIO-SEA
EMAS OFFSHORE LIMITED

BWTS Maker Name:

IMO No.: NDT GROUP

### FWD(X)

### PORT(Y)

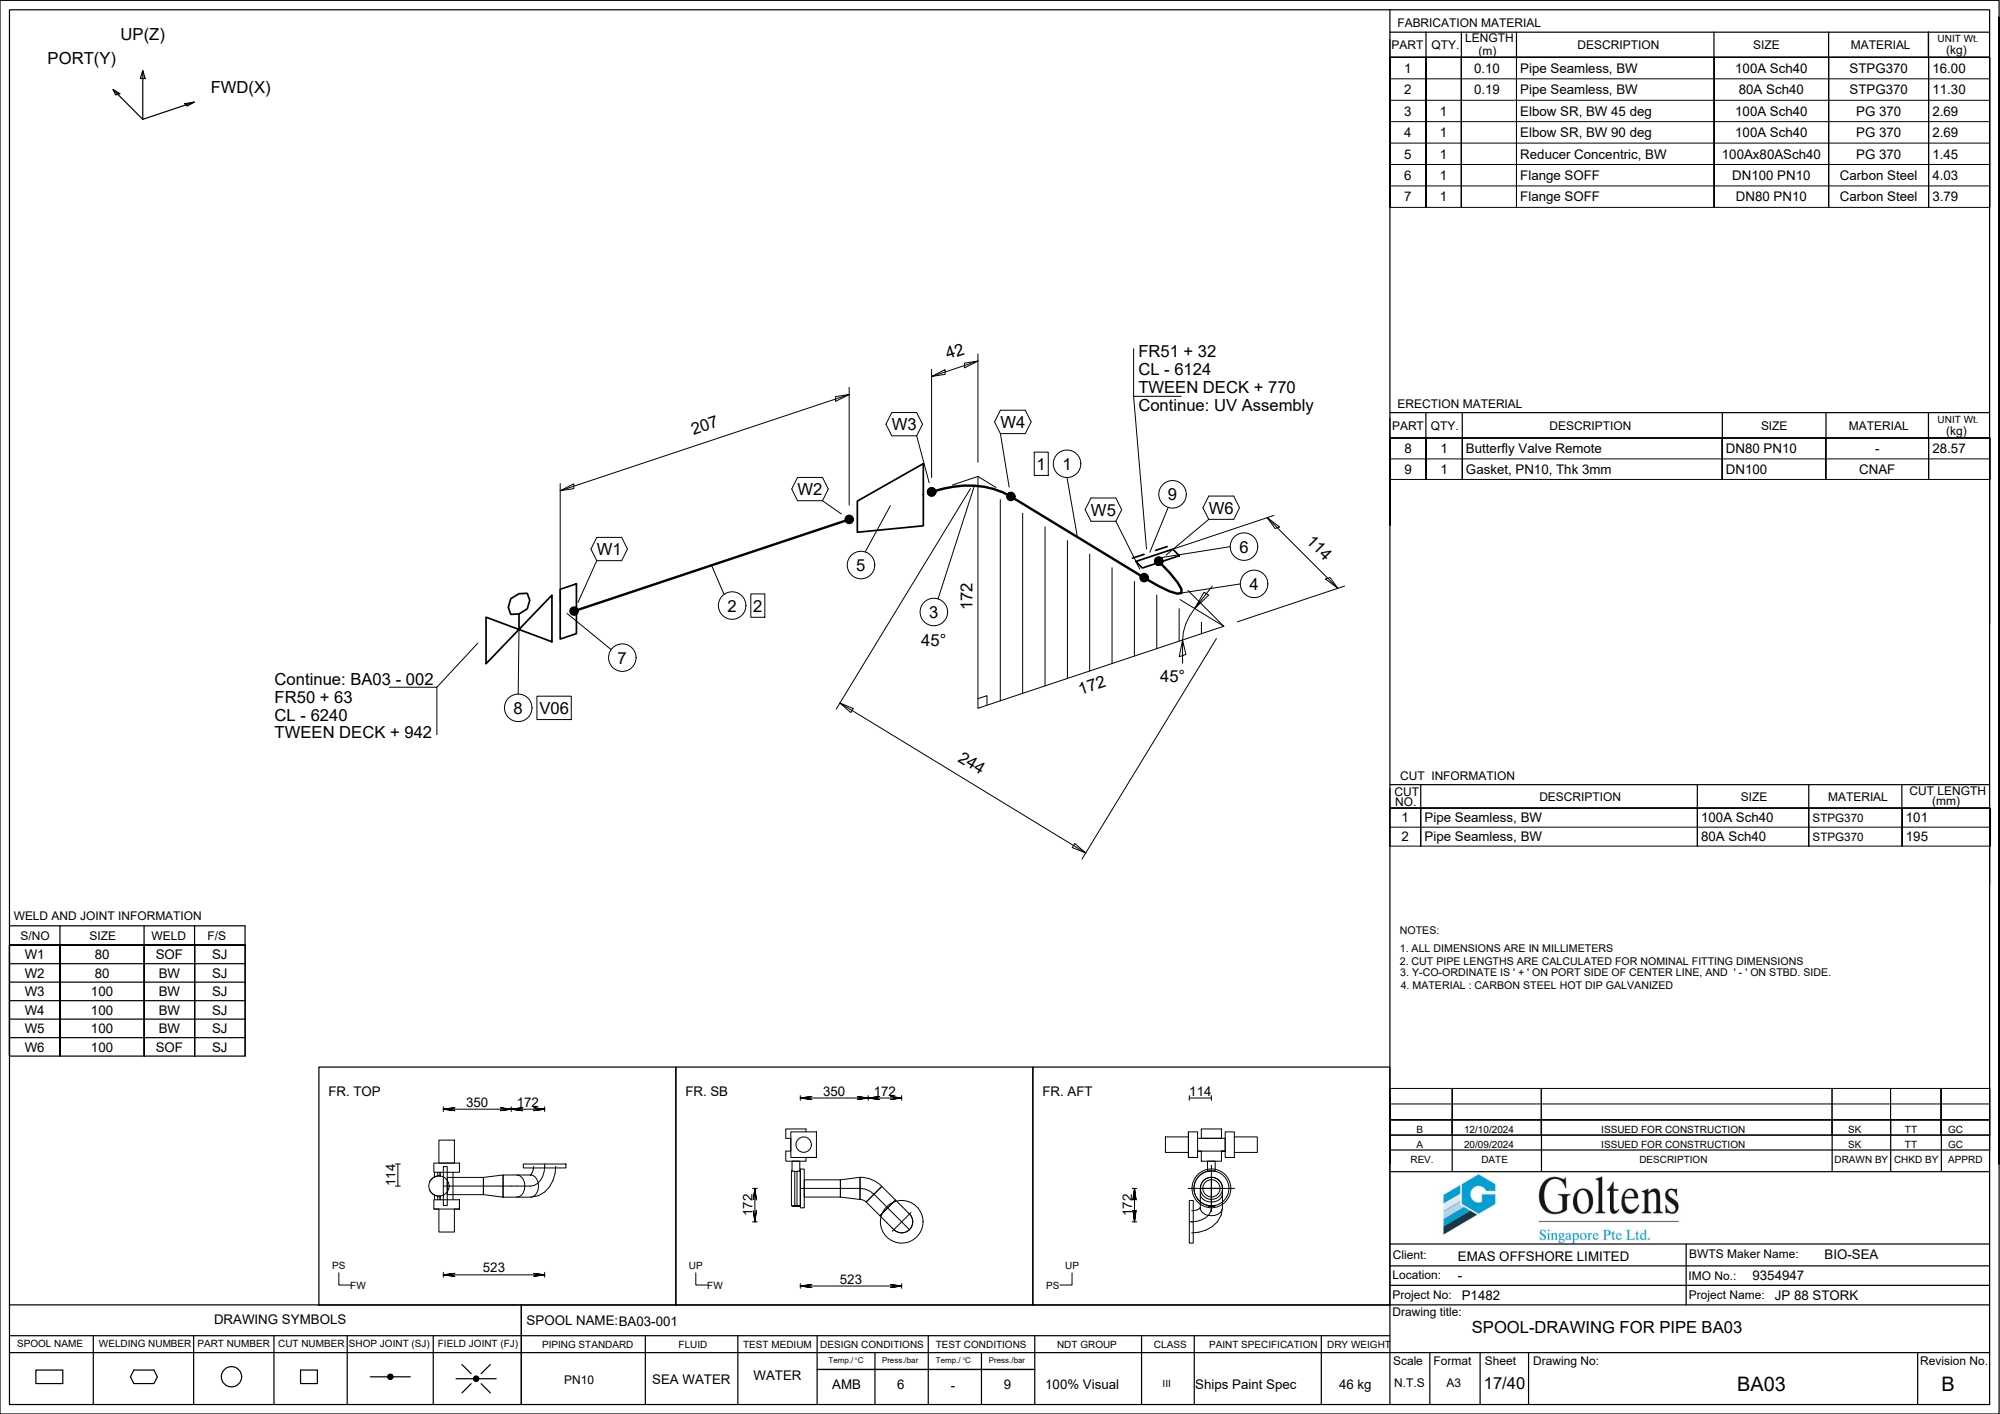
[picture p85: page 18]
FR. TOP; FR. AFT; AMB; Flange SOFF; Carbon Steel; Gasket, PN10, Thk 3mm; CNAF; SOF; Pipe Seamless, BW; 80A Sch40; STPG370; REV.; DATE; DESCRIPTION; DRAWN BY; CHKD BY; APPRD; Location:; Client:; ERECTION MATERIAL; CUT INFORMATION; SIZE; WELD; 45° 172 ¹⁷²; FR50 + 63 CL - 6240 TWEEN DECK + 942; Continue: BA03 - 002

1 | | 0.10 | Pipe Seamless, BW | 100A Sch40 | STPG370 | 16.00
2 | | 0.19 | Pipe Seamless, BW | 80A Sch40 | STPG370 | 11.30
3 | 1 | | Elbow SR, BW 45 deg | 100A Sch40 | PG 370 | 2.69
4 | 1 | | Elbow SR, BW 90 deg | 100A Sch40 | PG 370 | 2.69
5 | 1 | | Reducer Concentric, BW | 100Ax80ASch40 | PG 370 | 1.45
6 | 1 | | Flange SOFF | DN100 PN10 | Carbon Steel | 4.03

TWEEN DECK + 770
Continue: UV Assembly

PART | QTY. | DESCRIPTION | SIZE | MATERIAL | UNIT Wt. (kg)

8 | 1 | Butterfly Valve Remote | DN80 PN10 | - | 28.57

CUT NO. | DESCRIPTION | SIZE | MATERIAL | CUT LENGTH (mm)

1 | Pipe Seamless, BW | 100A Sch40 | STPG370 | 101

WELD AND JOINT INFORMATION

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

W1 | 80 | SOF | SJ
W2 | 80 | BW | SJ
W3 | 100 | BW | SJ
W4 | 100 | BW | SJ
W5 | 100 | BW | SJ

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

- BIO-SEA
EMAS OFFSHORE LIMITED

BWTS Maker Name:

IMO No.: NDT GROUP

UP(Z) | 60 | 60

CL - 6240

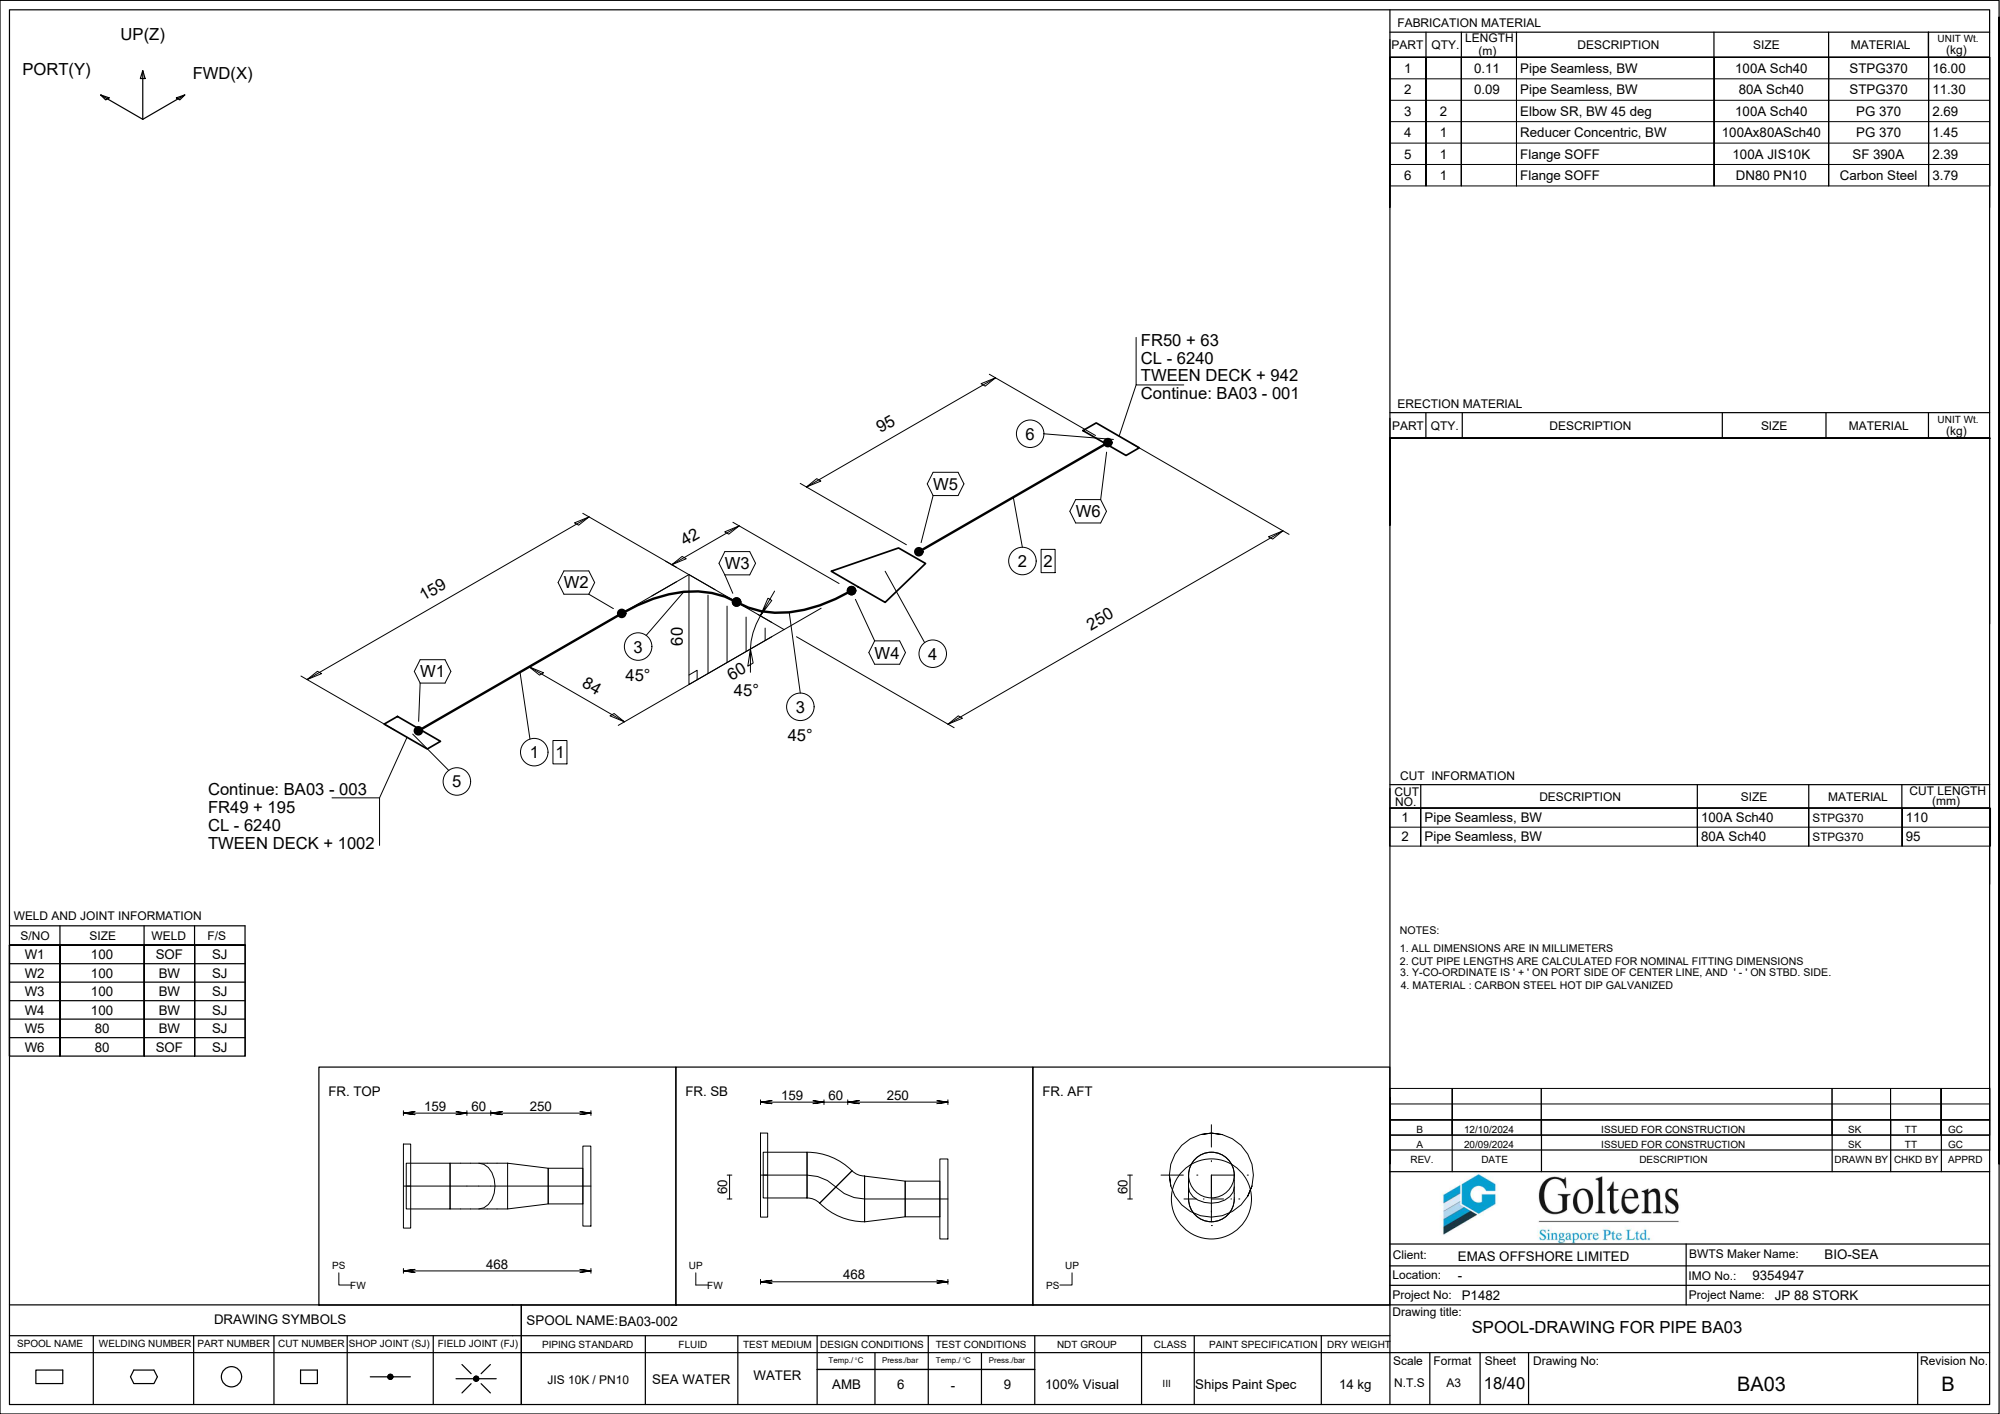
[picture p86: page 19]
FR. TOP; FR. AFT; AMB; Flange SOFF; Carbon Steel; SOF; Pipe Seamless, BW; 80A Sch40; STPG370; REV.; DATE; DESCRIPTION; DRAWN BY; CHKD BY; APPRD; Location:; Client:; ERECTION MATERIAL; CUT INFORMATION; SIZE; WELD; PART; QTY.; MATERIAL; JIS 10K / PN10; FR49 + 195 CL - 6240 TWEEN DECK + 1002; Continue: BA03 - 003; TWEEN DECK + 942; Continue: BA03 - 001

1 | | 0.11 | Pipe Seamless, BW | 100A Sch40 | STPG370 | 16.00
2 | | 0.09 | Pipe Seamless, BW | 80A Sch40 | STPG370 | 11.30
3 | 2 | | Elbow SR, BW 45 deg | 100A Sch40 | PG 370 | 2.69
4 | 1 | | Reducer Concentric, BW | 100Ax80ASch40 | PG 370 | 1.45
5 | 1 | | Flange SOFF | 100A JIS10K | SF 390A | 2.39

UNIT Wt. (kg)

CUT NO. | DESCRIPTION | SIZE | MATERIAL | CUT LENGTH (mm)

1 | Pipe Seamless, BW | 100A Sch40 | STPG370 | 110

WELD AND JOINT INFORMATION

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

W1 | 100 | SOF | SJ
W2 | 100 | BW | SJ
W3 | 100 | BW | SJ
W4 | 100 | BW | SJ
W5 | 80 | BW | SJ

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

- BIO-SEA
EMAS OFFSHORE LIMITED

BWTS Maker Name:

IMO No.: NDT GROUP

### TWEEN DECK + 1002

CL - 6240

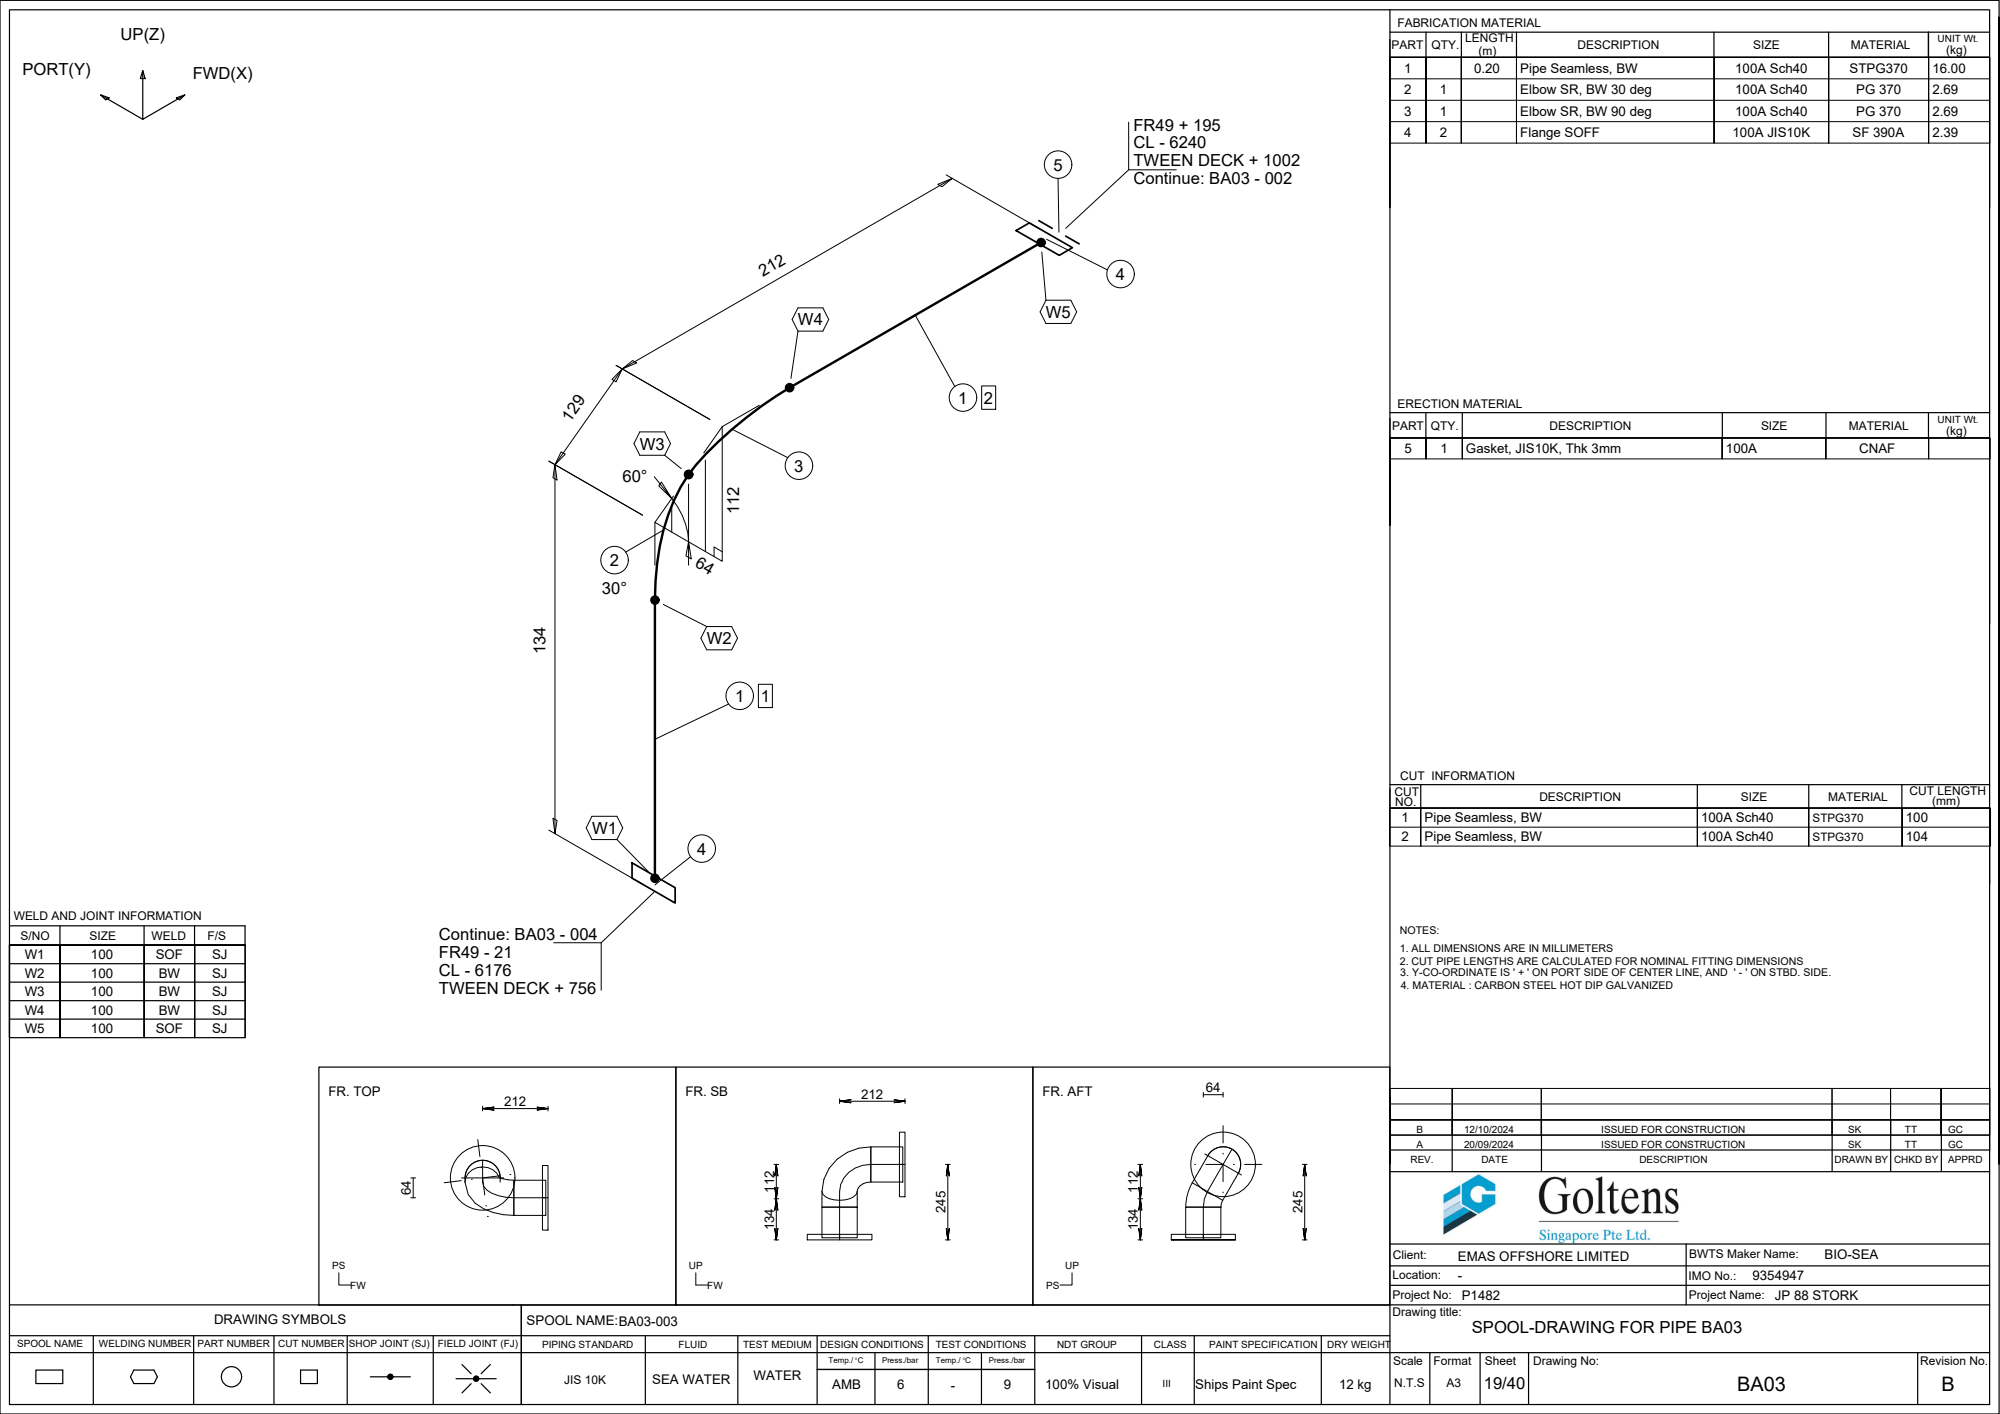
[picture p87: page 20]
64 FR. TOP; FR. AFT; AMB; Flange SOFF; 100A JIS10K; Gasket, JIS10K, Thk 3mm; CNAF; SOF; Pipe Seamless, BW; 100A Sch40; STPG370; REV.; DATE; DESCRIPTION; DRAWN BY; CHKD BY; APPRD; Location:; Client:; ERECTION MATERIAL; CUT INFORMATION; SIZE; WELD; PART; QTY.; MATERIAL; FR49 - 21 CL - 6176 TWEEN DECK + 756; Continue: BA03 - 004; Continue: BA03 - 002

1 | | 0.20 | Pipe Seamless, BW | 100A Sch40 | STPG370 | 16.00
2 | 1 | | Elbow SR, BW 30 deg | 100A Sch40 | PG 370 | 2.69
3 | 1 | | Elbow SR, BW 90 deg | 100A Sch40 | PG 370 | 2.69

UNIT Wt. (kg)

CUT NO. | DESCRIPTION | SIZE | MATERIAL | CUT LENGTH (mm)

1 | Pipe Seamless, BW | 100A Sch40 | STPG370 | 100

WELD AND JOINT INFORMATION

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

W1 | 100 | SOF | SJ
W2 | 100 | BW | SJ
W3 | 100 | BW | SJ
W4 | 100 | BW | SJ

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

- BIO-SEA
EMAS OFFSHORE LIMITED

BWTS Maker Name:

IMO No.: NDT GROUP

### TWEEN DECK + 756

FR49 - 21

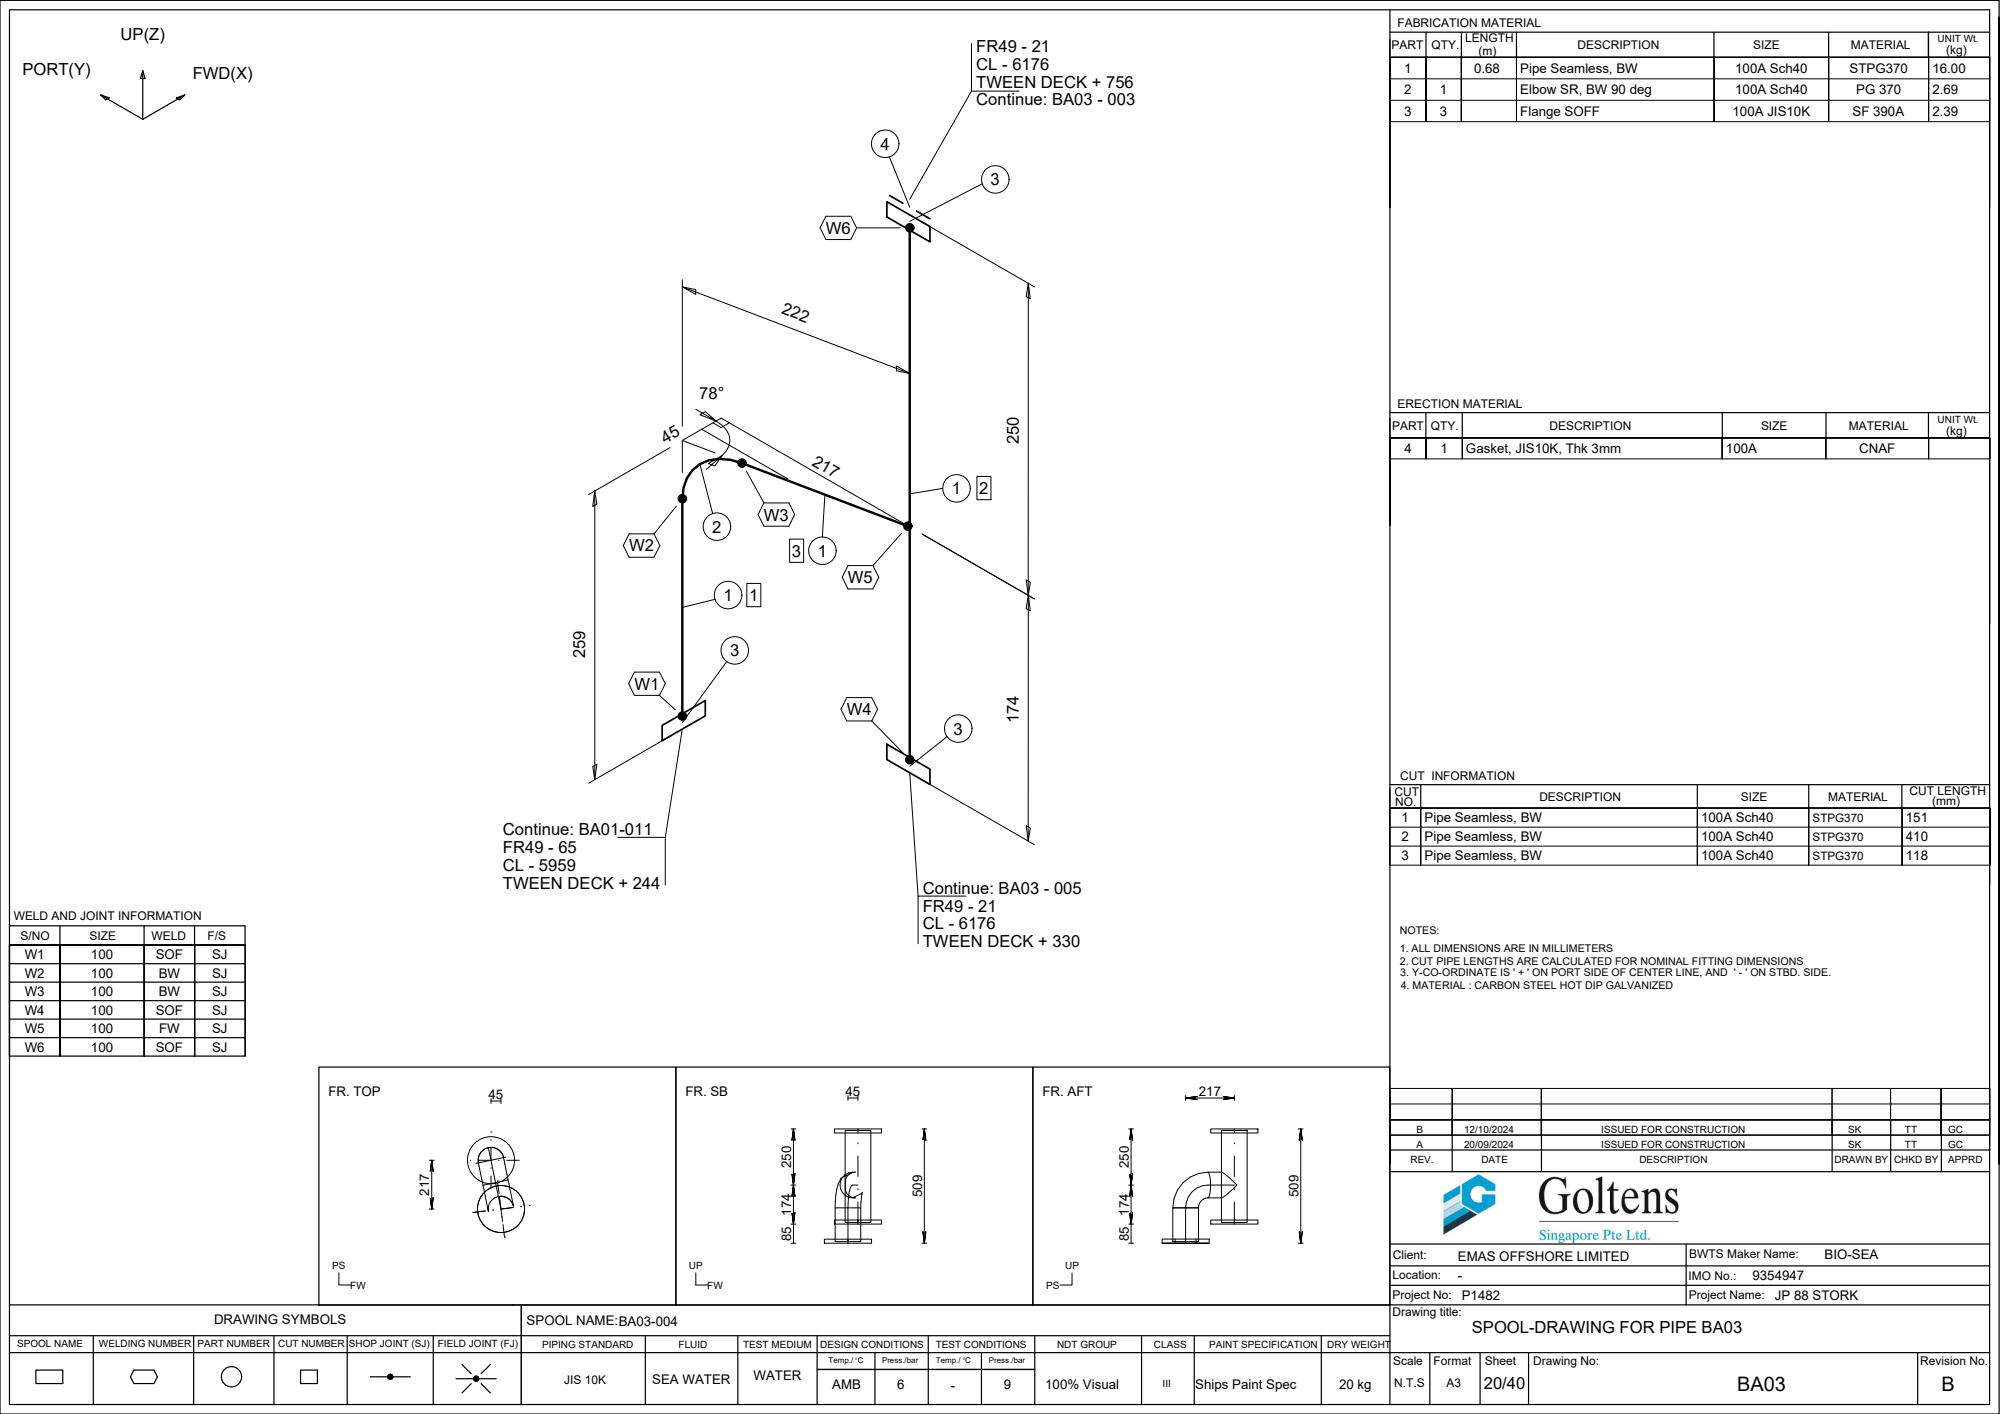
[picture p88: page 21]
FR. TOP; FR. AFT; AMB; Flange SOFF; 100A JIS10K; Gasket, JIS10K, Thk 3mm; CNAF; SOF; Pipe Seamless, BW; 100A Sch40; STPG370; REV.; DATE; DESCRIPTION; DRAWN BY; CHKD BY; APPRD; Location:; Client:; ERECTION MATERIAL; CUT INFORMATION; SIZE; WELD; PART; QTY.; MATERIAL; Continue: BA03 - 003; FR49 - 21 CL - 6176 TWEEN DECK + 330; Continue: BA03 - 005; FR49 - 65 CL - 5959 TWEEN DECK + 244; Continue: BA01-011

1 | | 0.68 | Pipe Seamless, BW | 100A Sch40 | STPG370 | 16.00
2 | 1 | | Elbow SR, BW 90 deg | 100A Sch40 | PG 370 | 2.69

UNIT Wt. (kg)

CUT NO. | DESCRIPTION | SIZE | MATERIAL | CUT LENGTH (mm)

1 | Pipe Seamless, BW | 100A Sch40 | STPG370 | 151
2 | Pipe Seamless, BW | 100A Sch40 | STPG370 | 410

WELD AND JOINT INFORMATION

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

W1 | 100 | SOF | SJ
W2 | 100 | BW | SJ
W3 | 100 | BW | SJ
W4 | 100 | SOF | SJ
W5 | 100 | FW | SJ

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

- BIO-SEA
EMAS OFFSHORE LIMITED

BWTS Maker Name:

IMO No.: NDT GROUP

### TWEEN DECK + 330

FR49 - 21

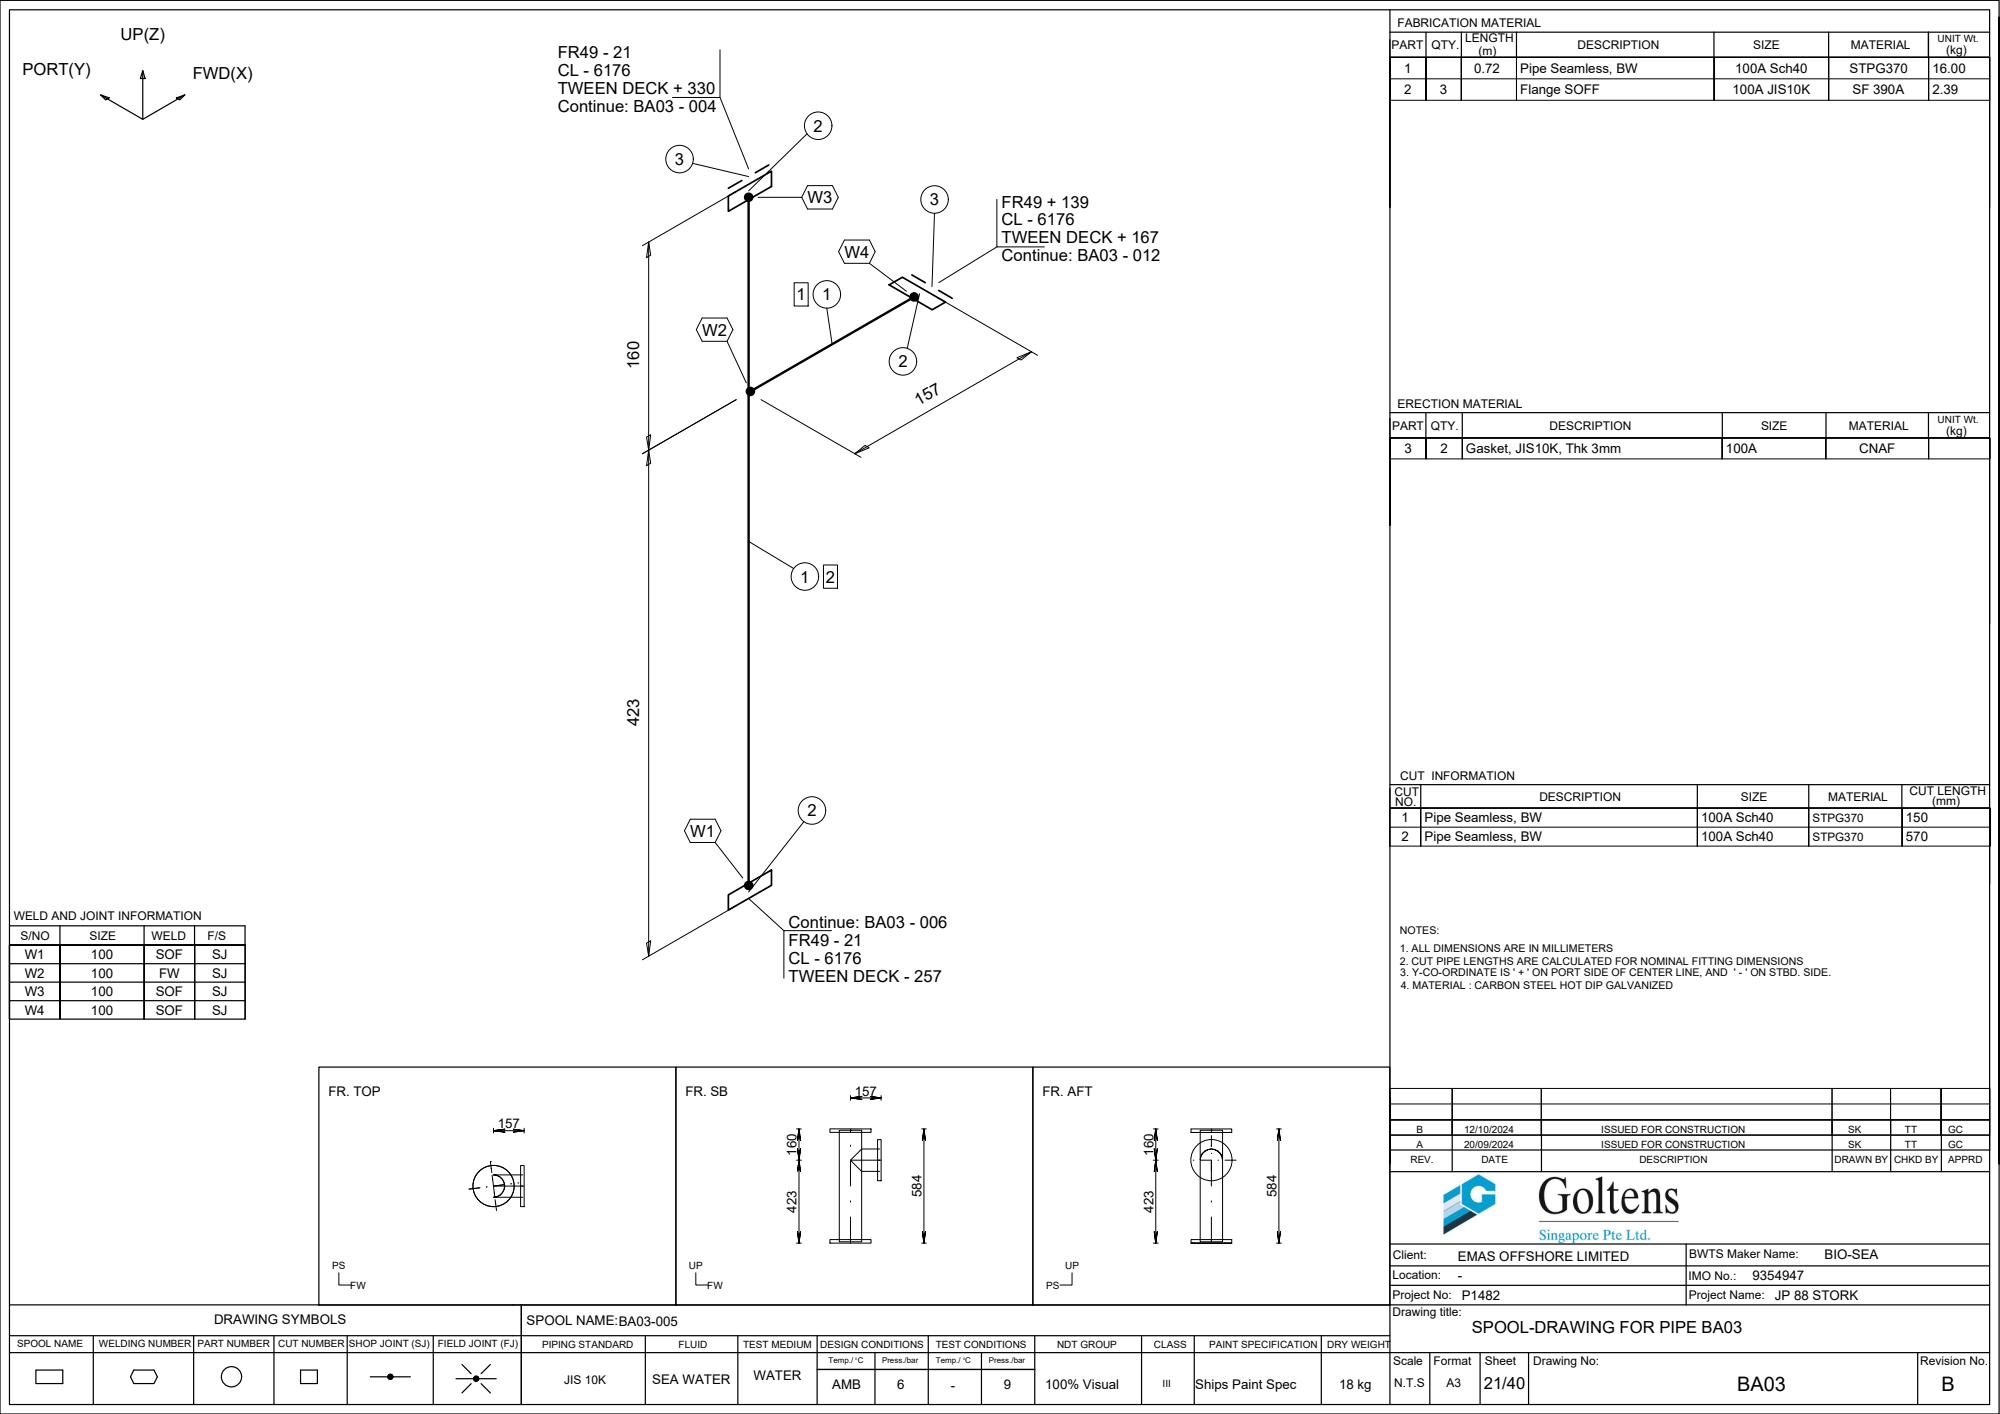
[picture p89: page 22]
FR. TOP; FR. AFT; AMB; Pipe Seamless, BW; 100A Sch40; STPG370; Flange SOFF; 100A JIS10K; Gasket, JIS10K, Thk 3mm; CNAF; SOF; REV.; DATE; DESCRIPTION; DRAWN BY; CHKD BY; APPRD; Location:; Client:; ERECTION MATERIAL; CUT INFORMATION; SIZE; WELD; PART; QTY.; MATERIAL; ISSUED FOR CONSTRUCTION; Continue: BA03 - 004; FR49 - 21 CL - 6176 TWEEN DECK - 257; Continue: BA03 - 006; TWEEN DECK + 167; Continue: BA03 - 012

UNIT Wt. (kg)

CUT NO. | DESCRIPTION | SIZE | MATERIAL | CUT LENGTH (mm)

1 | Pipe Seamless, BW | 100A Sch40 | STPG370 | 150

WELD AND JOINT INFORMATION

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

W1 | 100 | SOF | SJ
W2 | 100 | FW | SJ
W3 | 100 | SOF | SJ

- BIO-SEA
EMAS OFFSHORE LIMITED

BWTS Maker Name:

IMO No.: NDT GROUP

### FWD(X)

PORT(Y) | 434 | 434

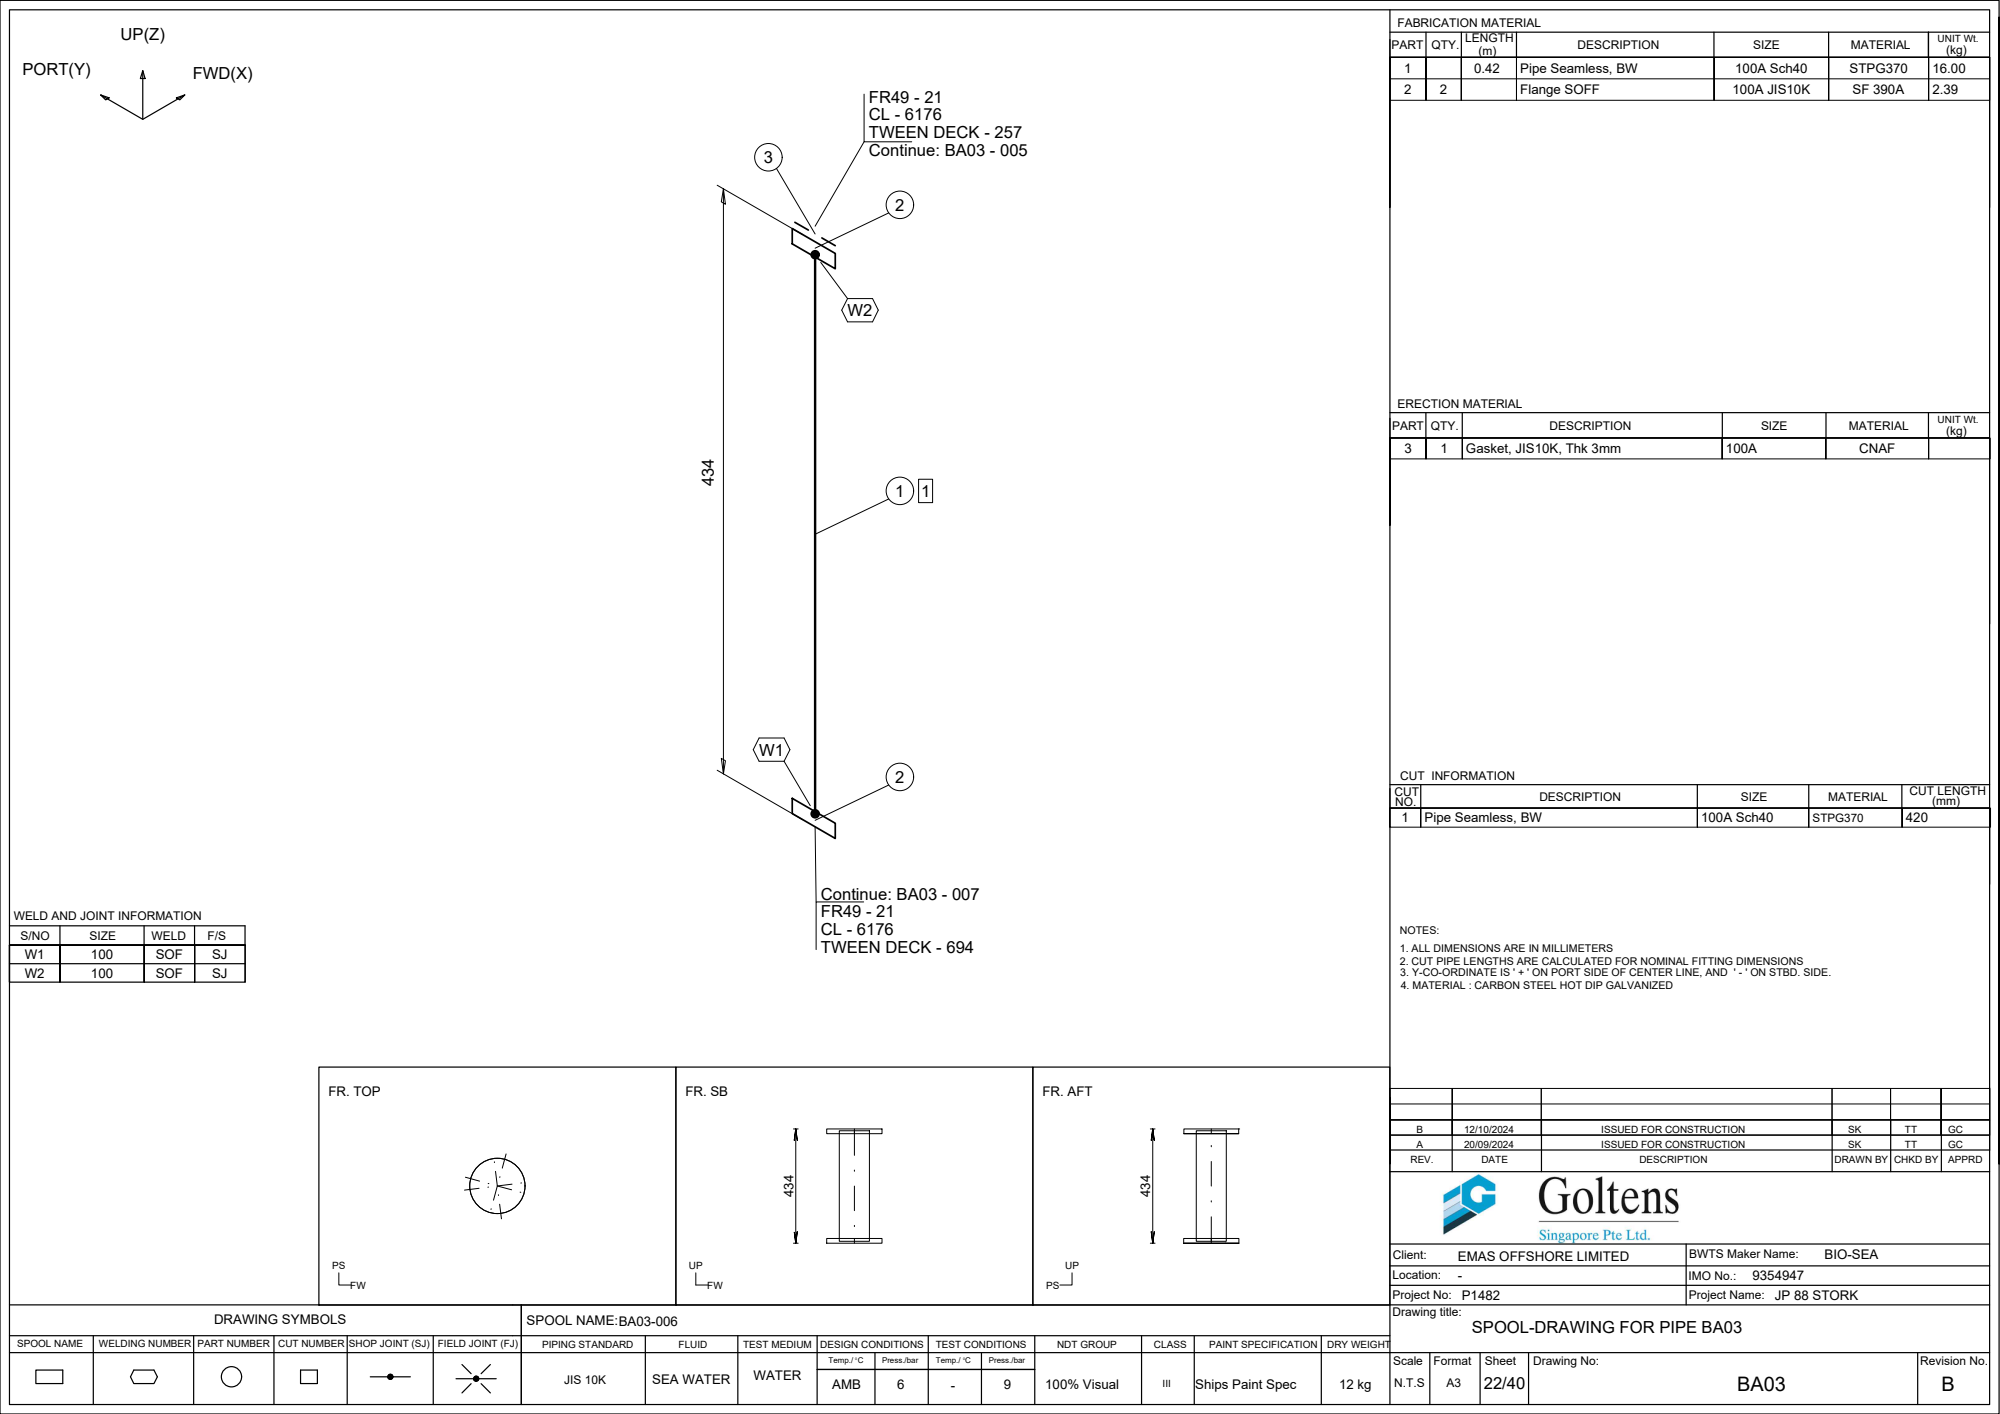
[picture p90: page 23]
FR. TOP; FR. AFT; AMB; Pipe Seamless, BW; 100A Sch40; STPG370; Flange SOFF; 100A JIS10K; Gasket, JIS10K, Thk 3mm; CNAF; SOF; REV.; DATE; DESCRIPTION; DRAWN BY; CHKD BY; APPRD; Location:; Client:; ERECTION MATERIAL; CUT INFORMATION; SIZE; WELD; PART; QTY.; MATERIAL; ISSUED FOR CONSTRUCTION; TWEEN DECK - 257; Continue: BA03 - 005; FR49 - 21 CL - 6176 TWEEN DECK - 694; Continue: BA03 - 007

UNIT Wt. (kg)

CUT NO. | DESCRIPTION | SIZE | MATERIAL | CUT LENGTH (mm)

1 | Pipe Seamless, BW | 100A Sch40 | STPG370 | 420

WELD AND JOINT INFORMATION

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

- BIO-SEA
EMAS OFFSHORE LIMITED

BWTS Maker Name:

IMO No.: NDT GROUP
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
