anurakj/J88_stork/GSPL-P1482-PI-0302 Piping Support Detailed drawing for BWTS  (1 & Above).pdf

1. ALL DIMENSIONS ARE IN MILLIMETERS. 2. THE PAD TO ANGLE JOINT SHALL BE TACK WELDED FOR FINAL ADJUSTMENT ON-BOARD. NOTES: REFERENCE DRAWINGS:- 1) PIPING SUPPORT LAYOUT DRAWING FOR BWTS SUPPORT INDEX SHEET SHEET NO | DRAWN | DATE | REVISION | REMARKS COVER PAGE | i | 20/09/2024 | A PAD DETAILS | ii | 20/09/2024 | A U-Bolt Typical Details | iii | 20/09/2024 | A BA-S-01 | 1 | 20/09/2024 | A BA-S-02 | 2 | 20/09/2024 | A BA-S-03 | 3 | 20/09/2024 | A BA-S-04 | 4 | 20/09/2024 | A BA-S-05 | 5 | 20/09/2024 | A BA-S-06 | 6 | 20/09/2024 | A BA-S-07 | 7 | 20/09/2024 | A BA-S-08 | 8 | 20/09/2024 | A BA-S-09 | 9 | 20/09/2024 | A BA-S-10 | 10 | 20/09/2024 | A | A EMAS OFFSHORE LIMITED P1482 - | BIO-SEA 9354947 JP 88 STORK REV. | DATE | DESCRIPTION | DRAWN BY | CHKD BY | APPRD Drawing title: Location: Project No: Client: Scale | Format | Sheet | Drawing No: | Revision No. N.T.S | A3 | Project Name: IMO No.: BWTS Maker Name: PIPING SUPPORT DETAILED DRAWING FOR BWTS (1" & ABOVE) A | 20/09/2024 | ISSUED FOR CONSTRUCTION | SK | TT | GC i | GSPL-P1482-PI-0302

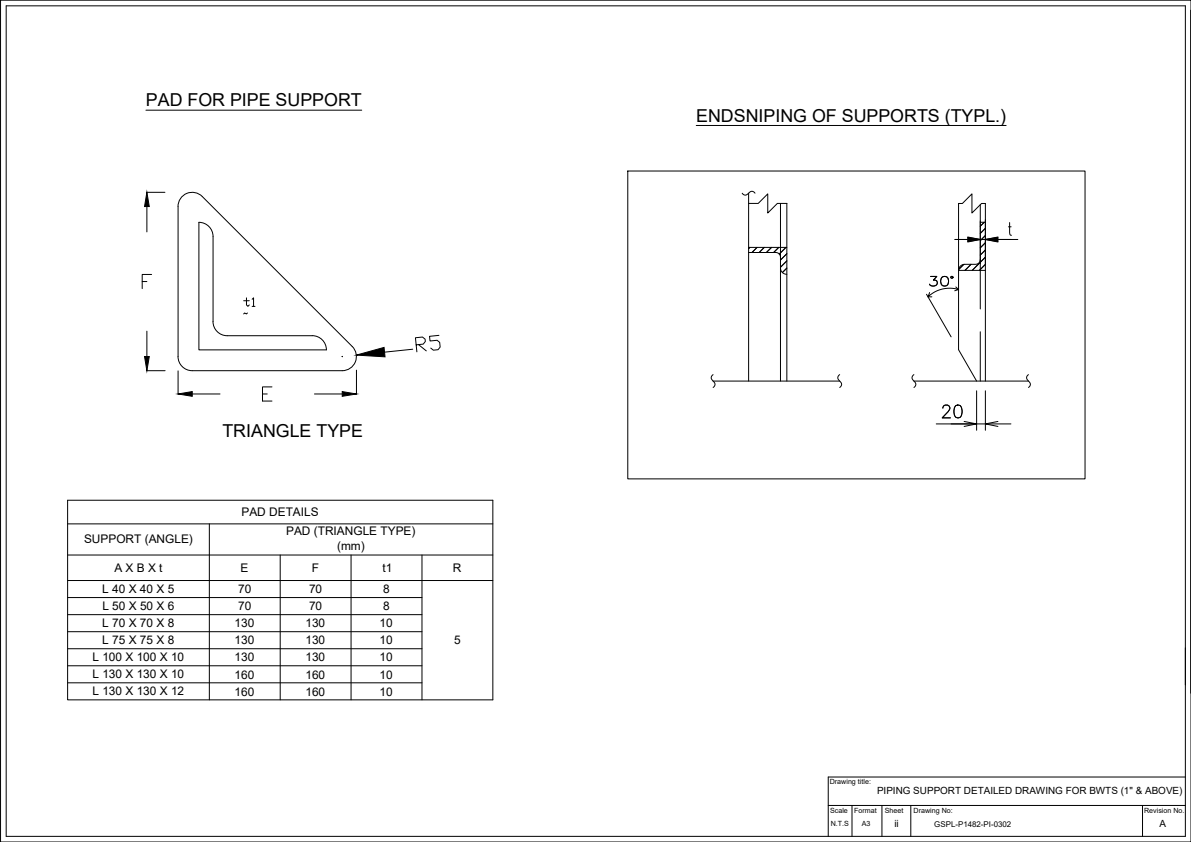
[picture p91: page 2]
A Drawing title: Scale; Format; Sheet; Drawing No:; Revision No. N.T.S; A3 PAD FOR PIPE SUPPORT TRIANGLE TYPE PAD DETAILS SUPPORT (ANGLE); PAD (TRIANGLE TYPE) (mm) A X B X t; ii ENDSNIPING OF SUPPORTS (TYPL.) PIPING SUPPORT DETAILED DRAWING FOR BWTS (1" & ABOVE) GSPL-P1482-PI-0302

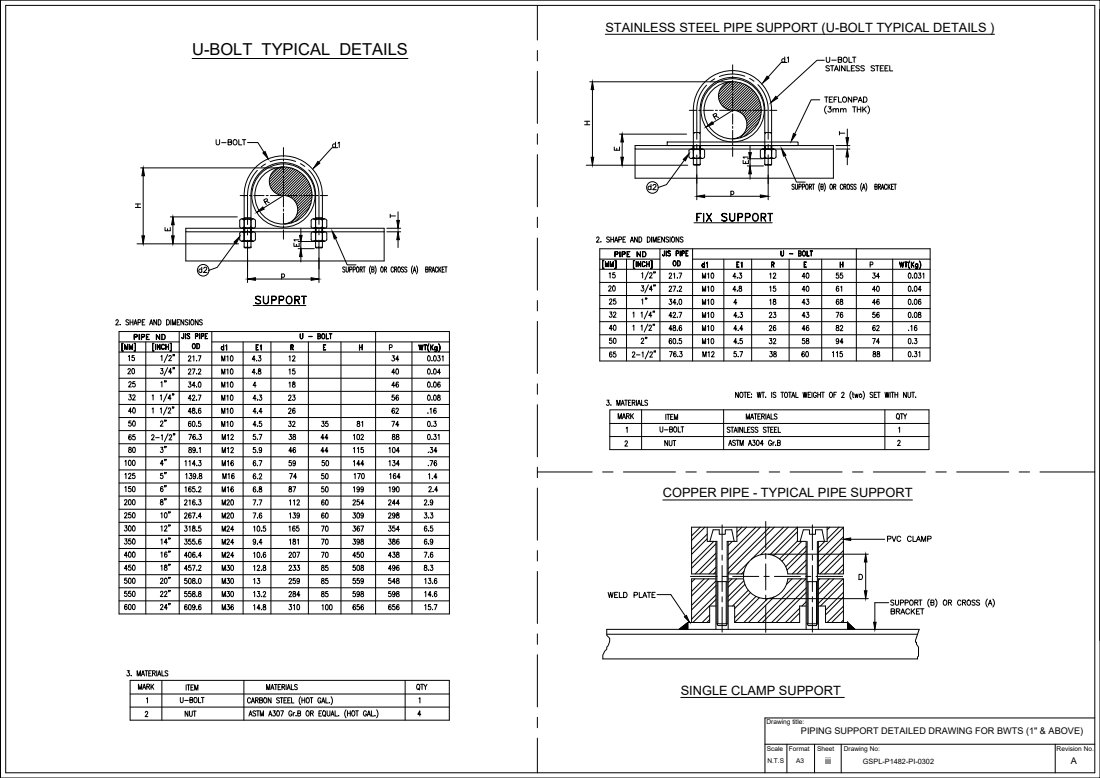
[picture p92: page 3]
A Drawing title: Scale; Format; Sheet; Drawing No:; Revision No. N.T.S; iii PIPING SUPPORT DETAILED DRAWING FOR BWTS (1" & ABOVE) GSPL-P1482-PI-0302 U-BOLT TYPICAL DETAILS; STAINLESS STEEL PIPE SUPPORT (U-BOLT TYPICAL DETAILS ) COPPER PIPE - TYPICAL PIPE SUPPORT SINGLE CLAMP SUPPORT

## BA-S-01

# SUPPORT DRAWING

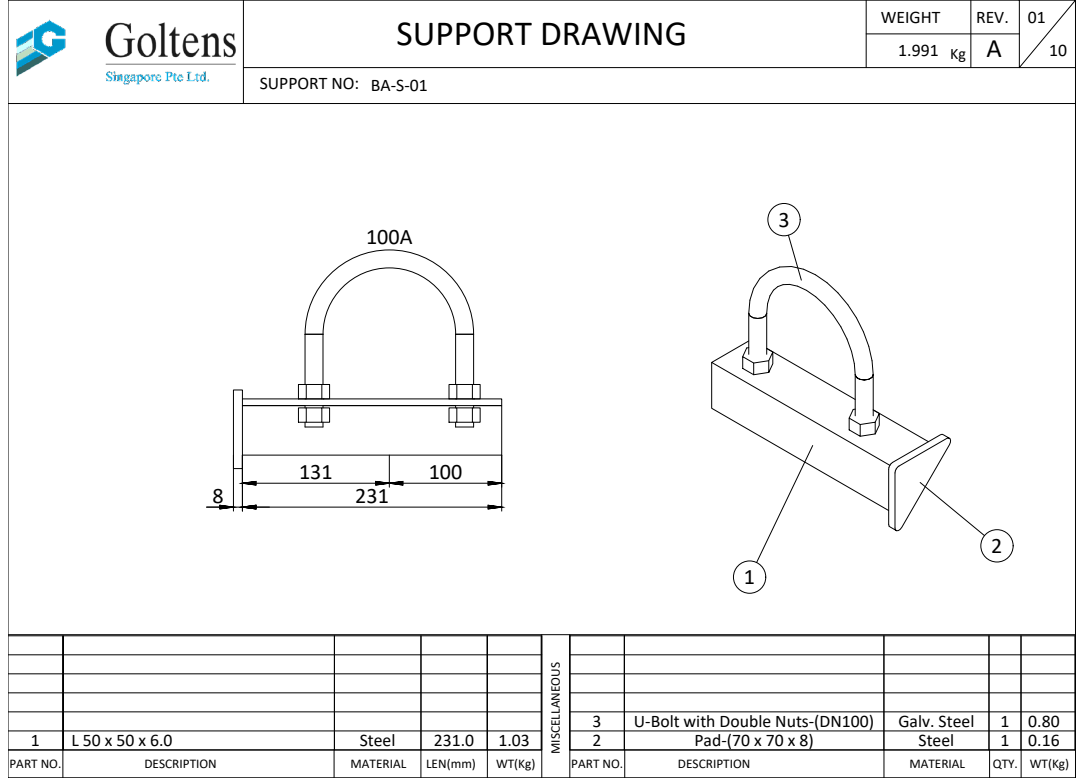
[picture p93: page 4]
Steel; Pad-(70 x 70 x 8); U-Bolt with Double Nuts-(DN100); Galv. Steel; PART NO.; DESCRIPTION; LEN(mm); MISCELLANEOUS; REV.; SUPPORT NO:; MATERIAL; QTY.; WEIGHT

424
100 | 324 | 462

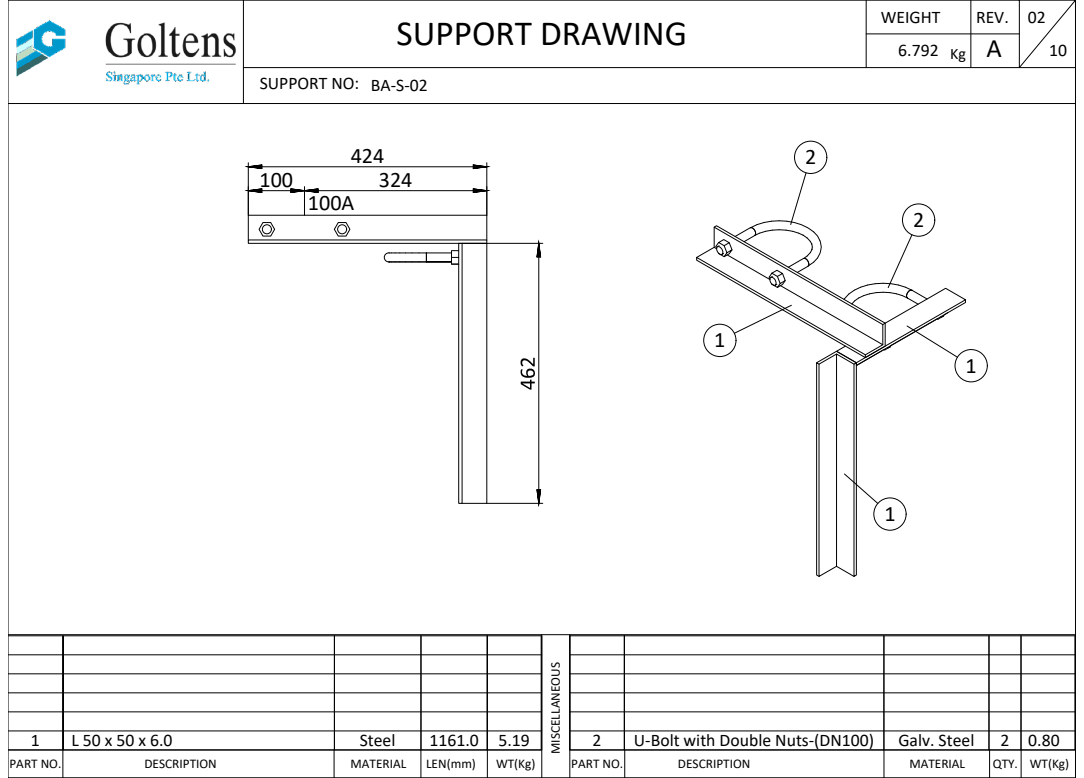
[picture p94: page 5]
Steel; U-Bolt with Double Nuts-(DN100); Galv. Steel; PART NO.; DESCRIPTION; LEN(mm); MISCELLANEOUS; SUPPORT NO:

3

## BA-S-03

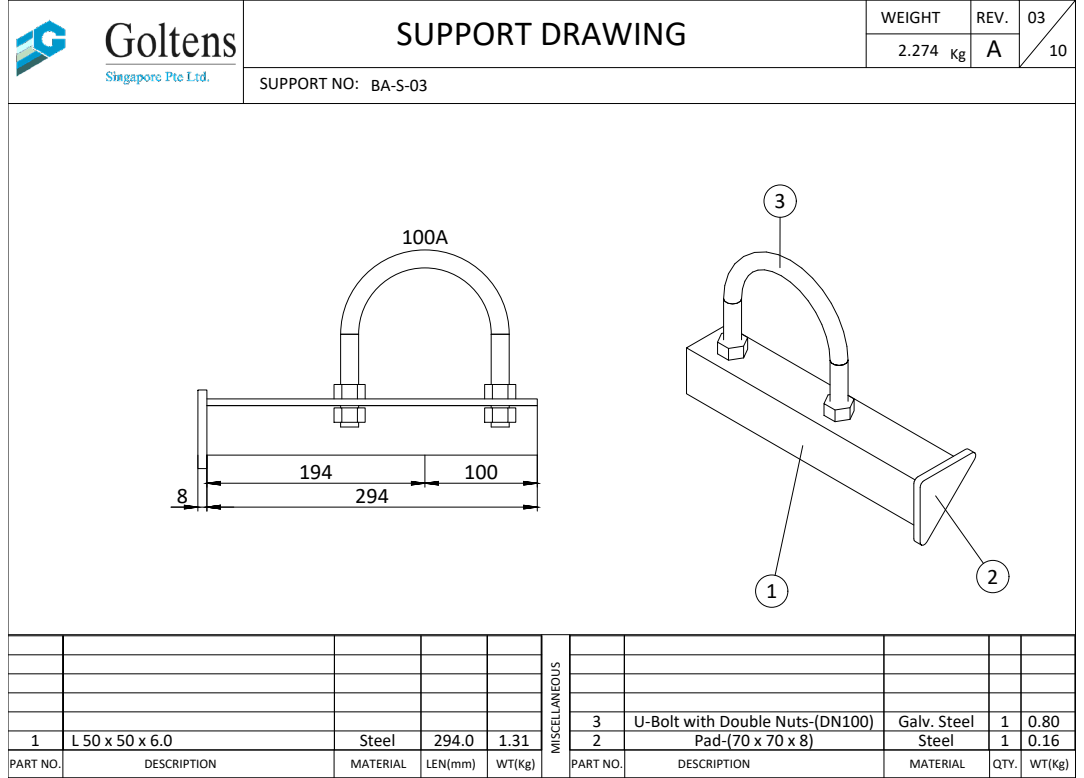
[picture p95: page 6]
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

## BA-S-04

## SUPPORT NO:

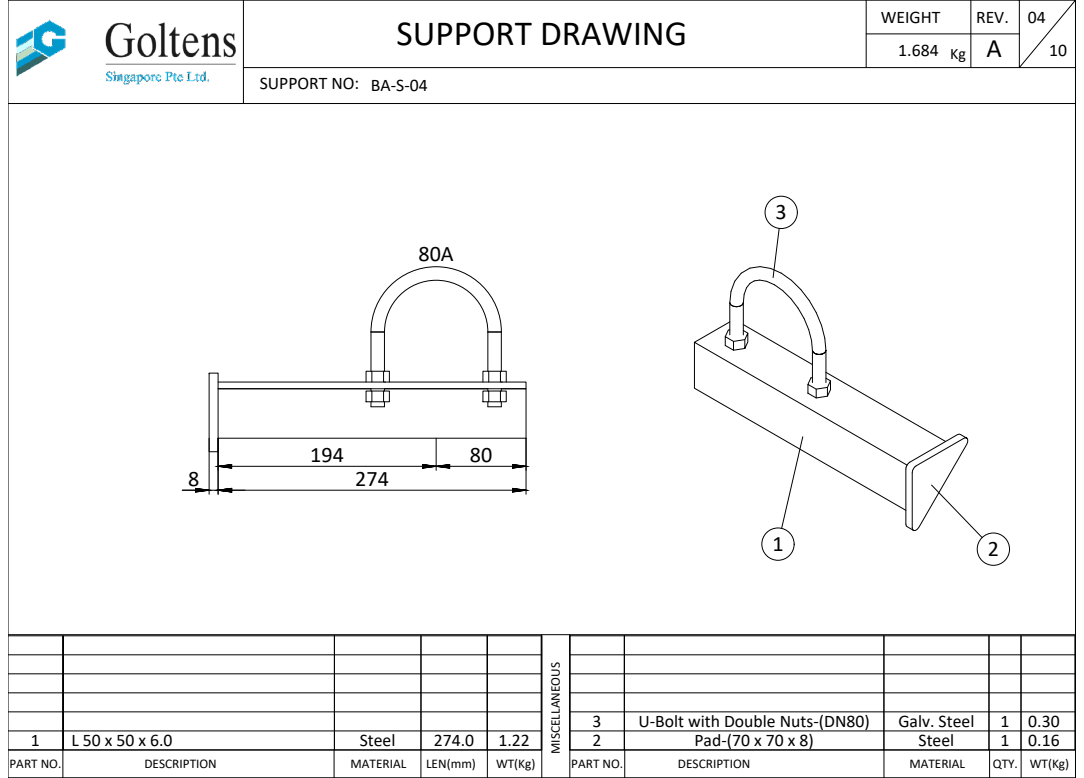
[picture p96: page 7]
Steel; Pad-(70 x 70 x 8); U-Bolt with Double Nuts-(DN80); Galv. Steel; PART NO.; DESCRIPTION; LEN(mm); MISCELLANEOUS

398

## BA-S-05

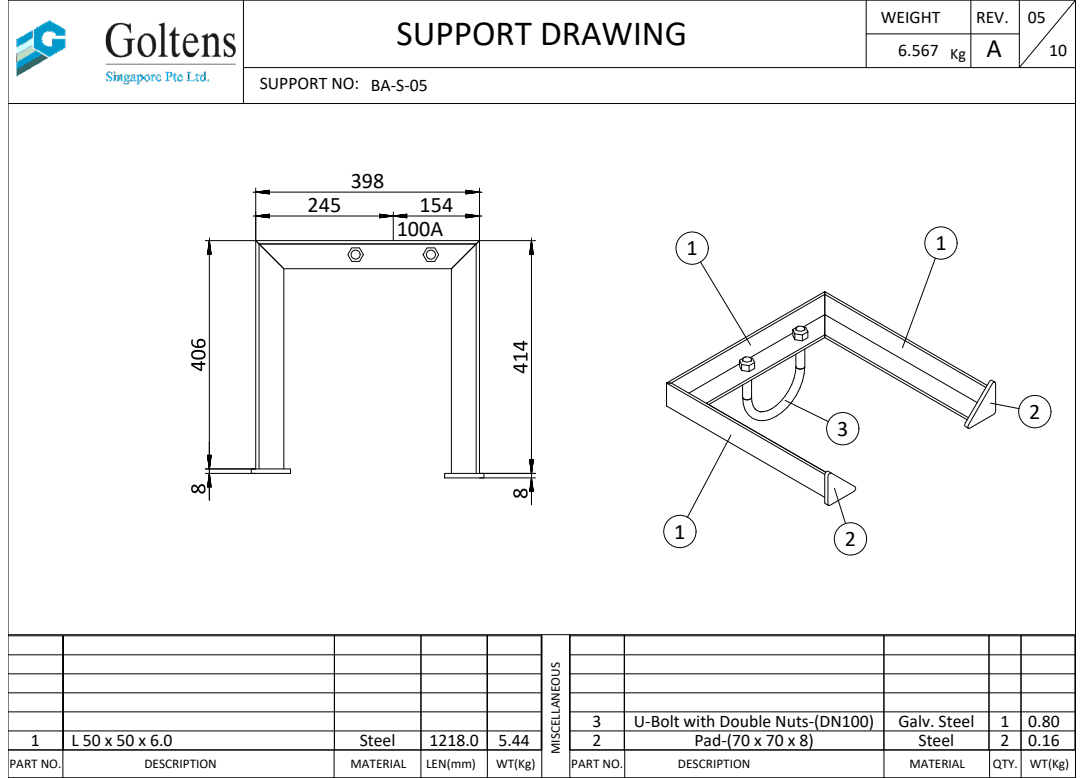
[picture p97: page 8]
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

452
258 | 194 | 100A

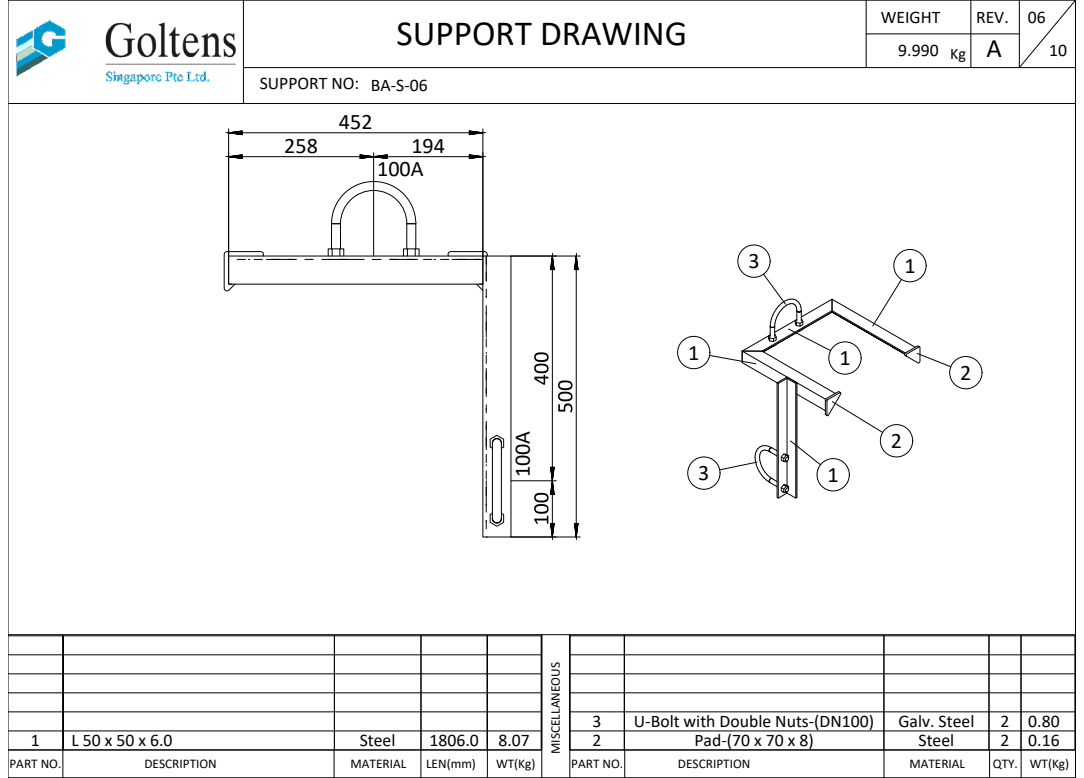
[picture p98: page 9]
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

## BA-S-07

## SUPPORT NO:

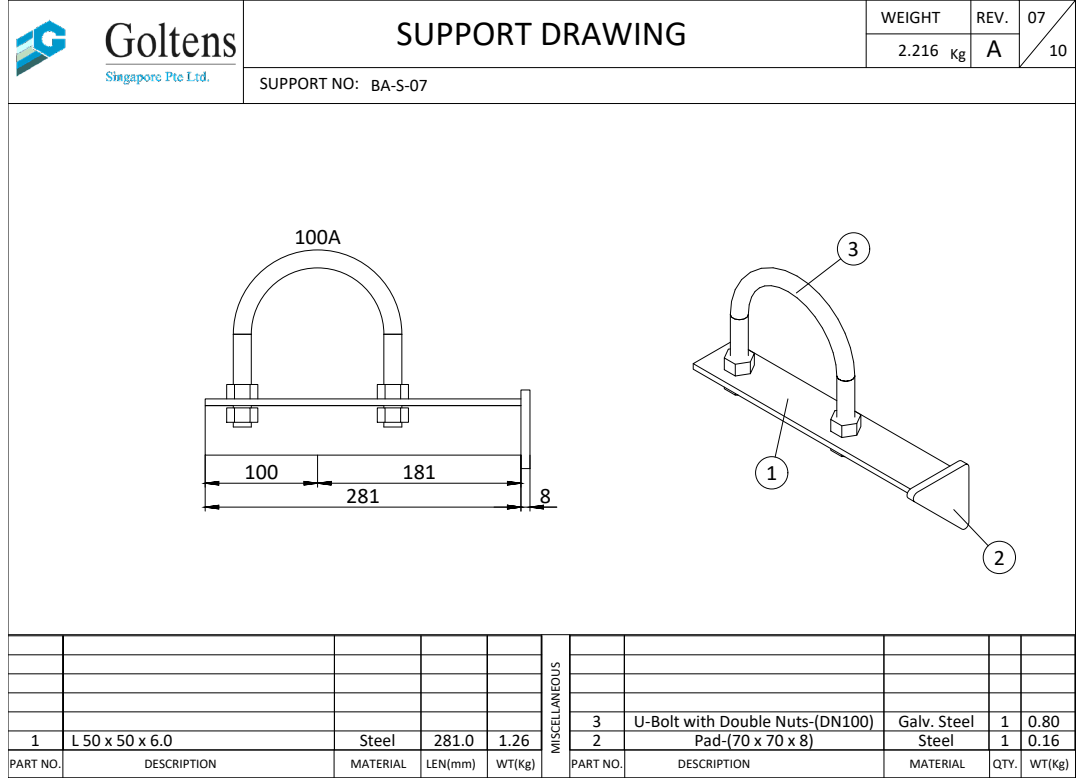
[picture p99: page 10]
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

8 | 281
181 | 100

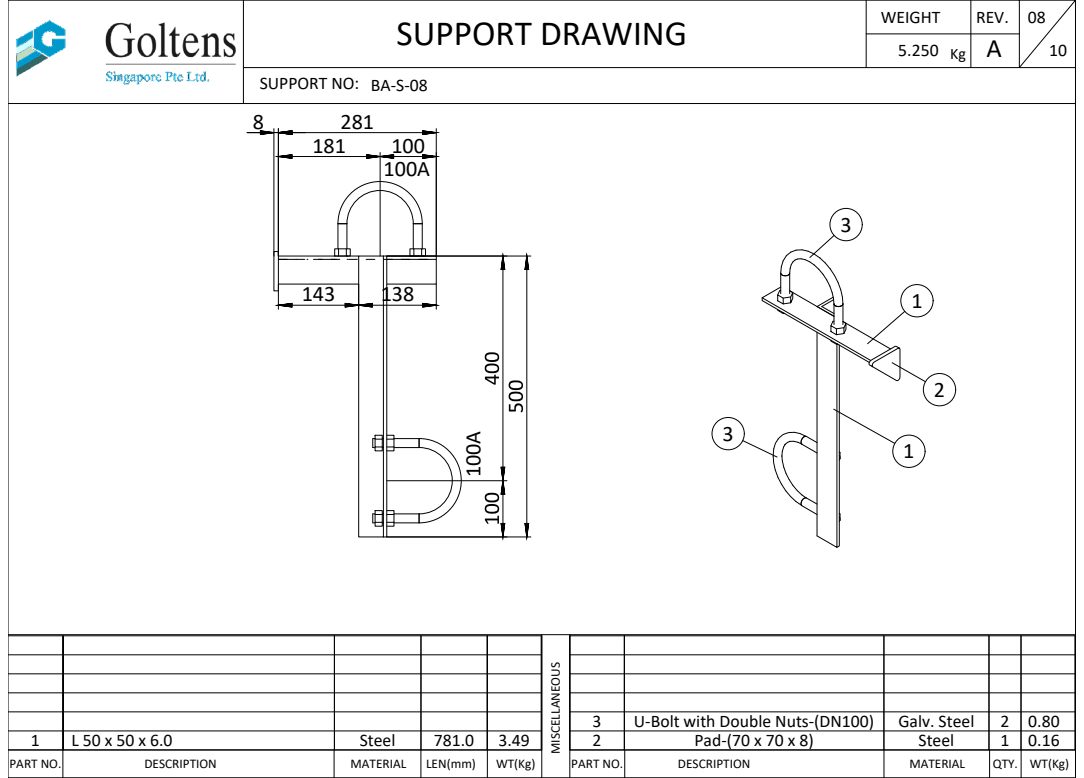
[picture p100: page 11]
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

## BA-S-09

## SUPPORT NO:

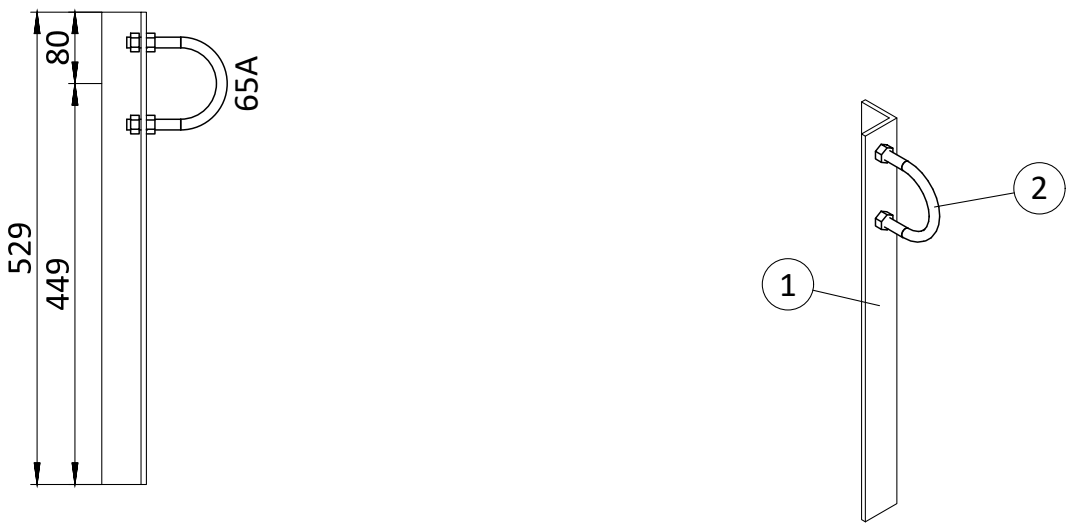
[picture p101: page 12]
Steel; U-Bolt with Double Nuts-(DN65); Galv. Steel; PART NO.; DESCRIPTION; LEN(mm); MISCELLANEOUS

## BA-S-10

## SUPPORT NO:

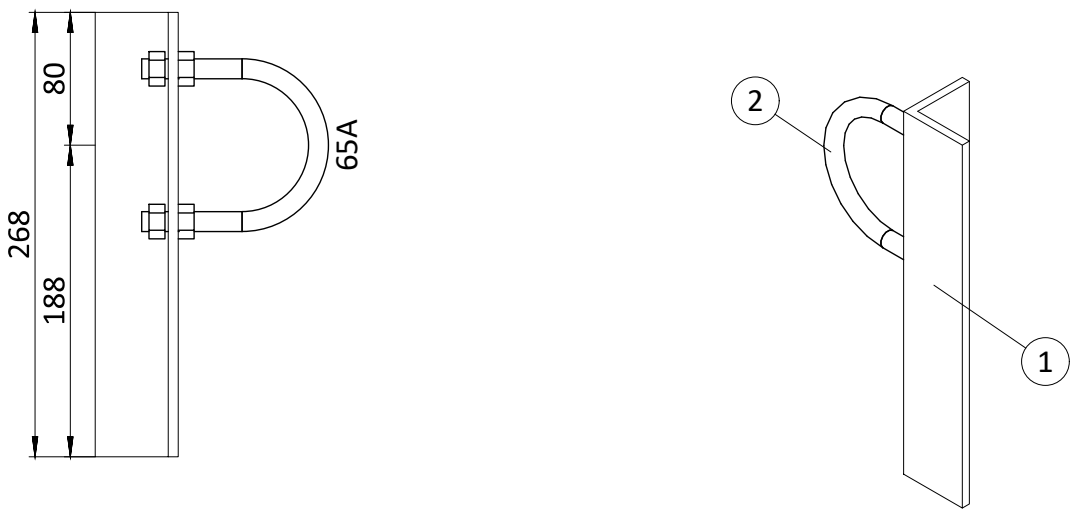
[picture p102: page 13]
Steel; U-Bolt with Double Nuts-(DN65); Galv. Steel; PART NO.; DESCRIPTION; LEN(mm); MISCELLANEOUS
