anurakj/J88_stork/GSPL-P1482-ST-0101- Bulk Structural MTO R.C.pdf

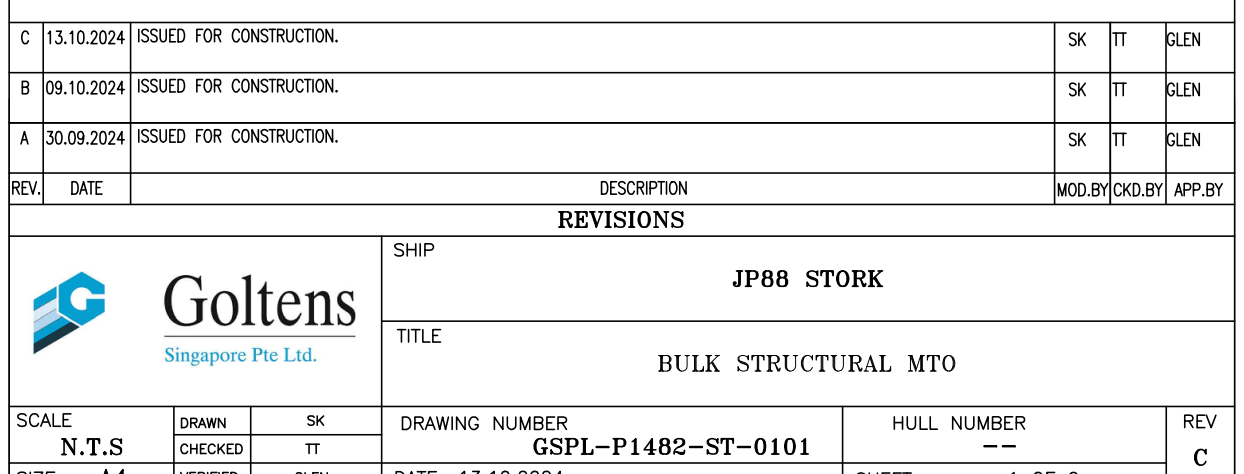
[picture p103: page 1]

SI NO. | DESCRIPTION | DIMENSION (mm) | MATERIAL | QTY | WEIGHT.(Kg) | REMARKS
1 | ANGLE BAR | L 100x75x10 | A Grade steel | 5.2 M | 67.60
2 | ANGLE BAR | L 75x75x10 | A Grade steel | 3.5 M | 38.50
3 | ANGLE BAR | L 50x50x6 | A Grade steel | 9.5 M | 27.00
4 | PAD PLATE | 130x130x10 | A Grade steel | 7 Nos. | 4.20
5 | PAD PLATE | 95x95x8 | A Grade steel | 5 Nos. | 1.20
6 | PLATE | OD 60 X 9mm thk | A Grade steel | 10 No. | 4.25
7 | GRATING. 45mm Thk | 1001x610x45 | A Grade steel | 1 No. | 24.42
8 | GRATING. 45mm Thk | 1001x655x45 | A Grade steel | 1 No. | 26.22
9 | GRATING. 45mm Thk | 793x581x45 | A Grade steel | 1 No. | 18.42
10 | GRATING. 45mm Thk | 793x696x45 | A Grade steel | 1 No. | 22.07
11 | GRATING. 45mm Thk | 510x369x45 | A Grade steel | 1 No. | 7.52
12 | GRATING. 45mm Thk | 849x510x45 | A Grade steel | 1 No. | 17.31
13 | GRATING. 45mm Thk | 675x626x45 | A Grade steel | 1 No. | 16.90
14 | GRATING. 45mm Thk | 849x491x45 | A Grade steel | 1 No. | 16.67
15 | GRATING. 45mm Thk | 491x414x45 | A Grade steel | 1 No. | 8.13
16 | GRATING. 45mm Thk | 666x491x45 | A Grade steel | 1 No. | 13.08
17 | GRATING. 45mm Thk | 581x491x45 | A Grade steel | 1 No. | 11.41
18 | ANGLE BAR | L 75x75x5 | A Grade steel | 14.5 M | 82.65
19 | ANGLE BAR | L 75x50x5 | A Grade steel | 5M | 23.50
20 | ANGLE BAR | L 50x50x5 | A Grade steel | 3M | 6.90
21 | PAD PLATE | 130x130x10 | A Grade steel | 12 Nos. | 14.00
22 | PAD PLATE | 95x95x8 | A Grade steel | 10 Nos. | 12.00
23 | PAD PLATE | 70x70x8 | A Grade steel | 10 Nos. | 10.00
Total Weight (Kg.) | | | | | 473.95

BILL OF MATERIALS

Notes:
1) Data considered are approximate and based on point cloud data & input documents received.
