anurakj/J88_stork/GSPL-P1482-ST-0301 BWTS Equipment Foundation Detail Drawing R.A.pdf

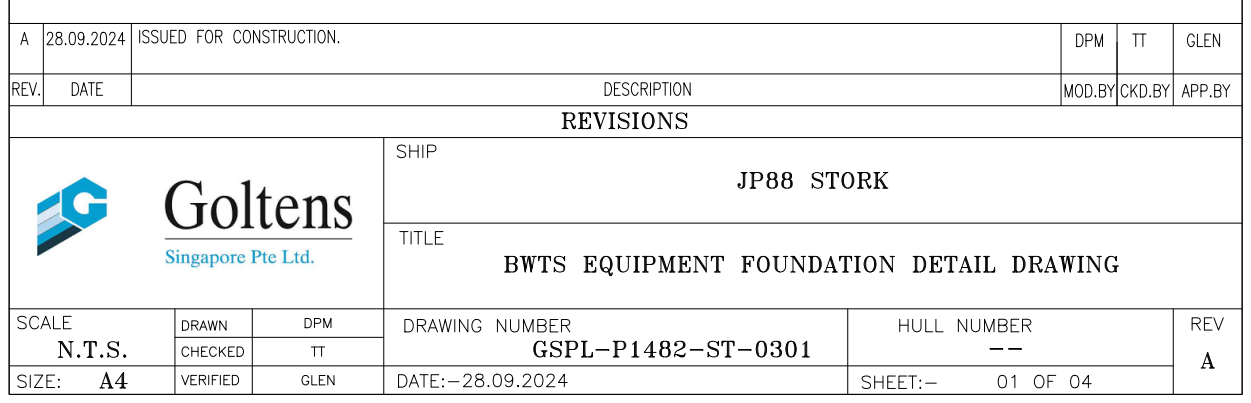
[picture p104: page 1]

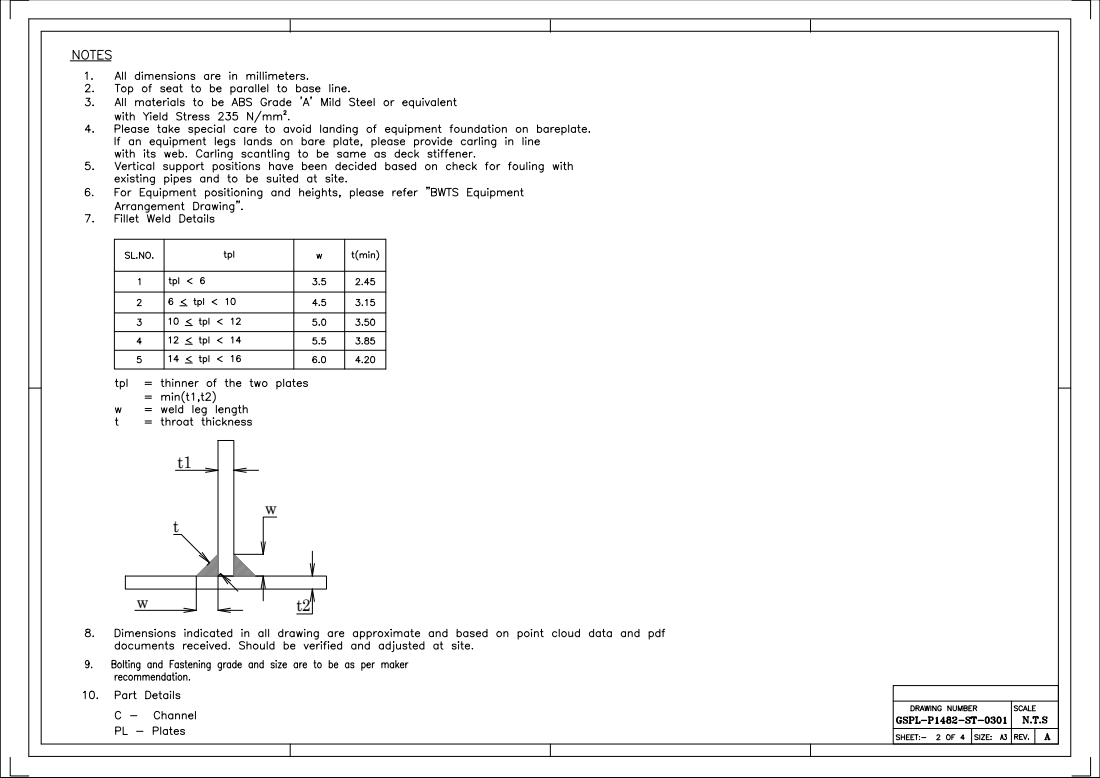
[picture p105: page 2]

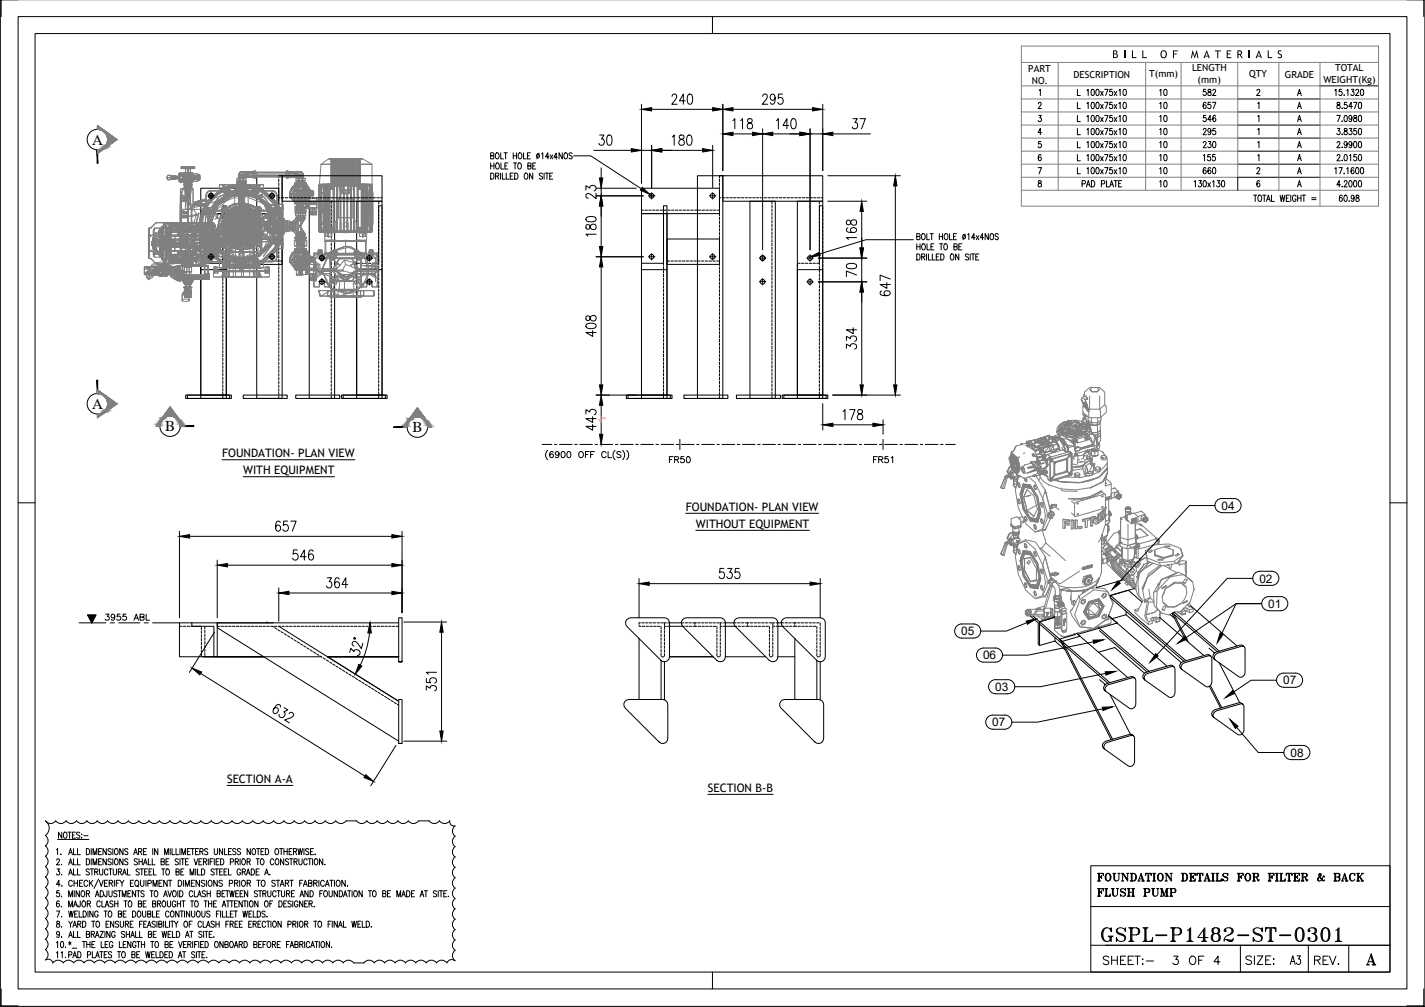
[picture p106: page 3]
FOUNDATION- PLAN VIEW WITH EQUIPMENT AA; FOUNDATION- PLAN VIEW WITHOUT EQUIPMENT SECTION B-B SECTION A-A; 08 BILL OF MATERIALS PART NO.; DESCRIPTION; LENGTH (mm); QTY; GRADE; TOTAL WEIGHT(Kg)

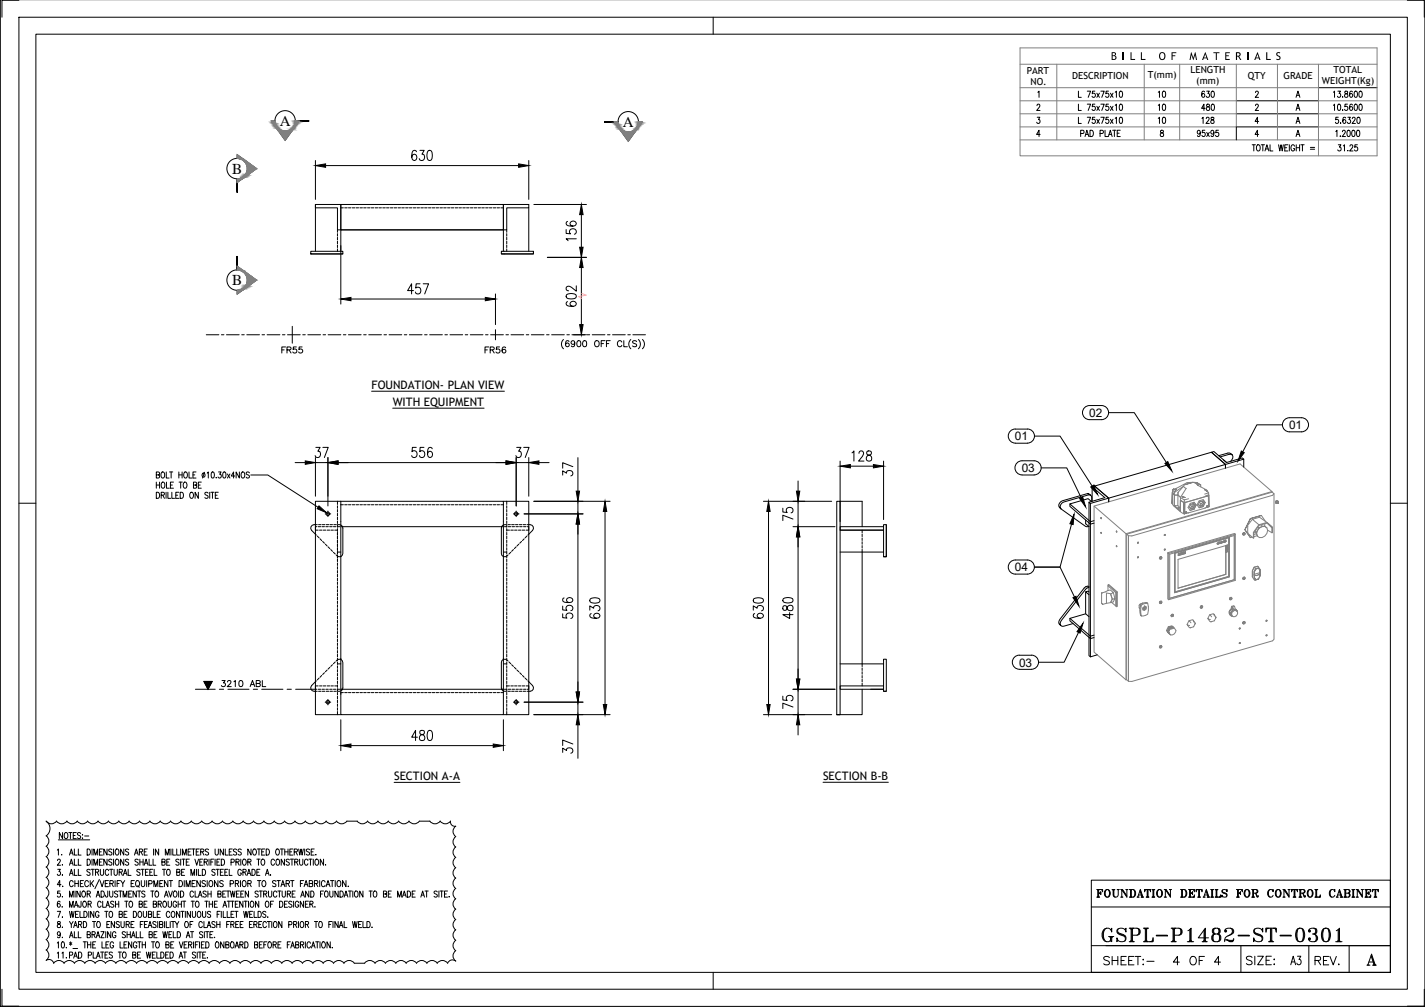
[picture p107: page 4]
FOUNDATION- PLAN VIEW WITH EQUIPMENT BB; A SECTION A-A; BILL; MATERIALS PART NO.; DESCRIPTION; LENGTH (mm); QTY; GRADE; TOTAL WEIGHT(Kg) 0403 01; 01 03 SECTION B-B
