anurakj/J88_stork/GSPL-P1482-ST-0302 Equipment Lifting pad drawing R.A.pdf

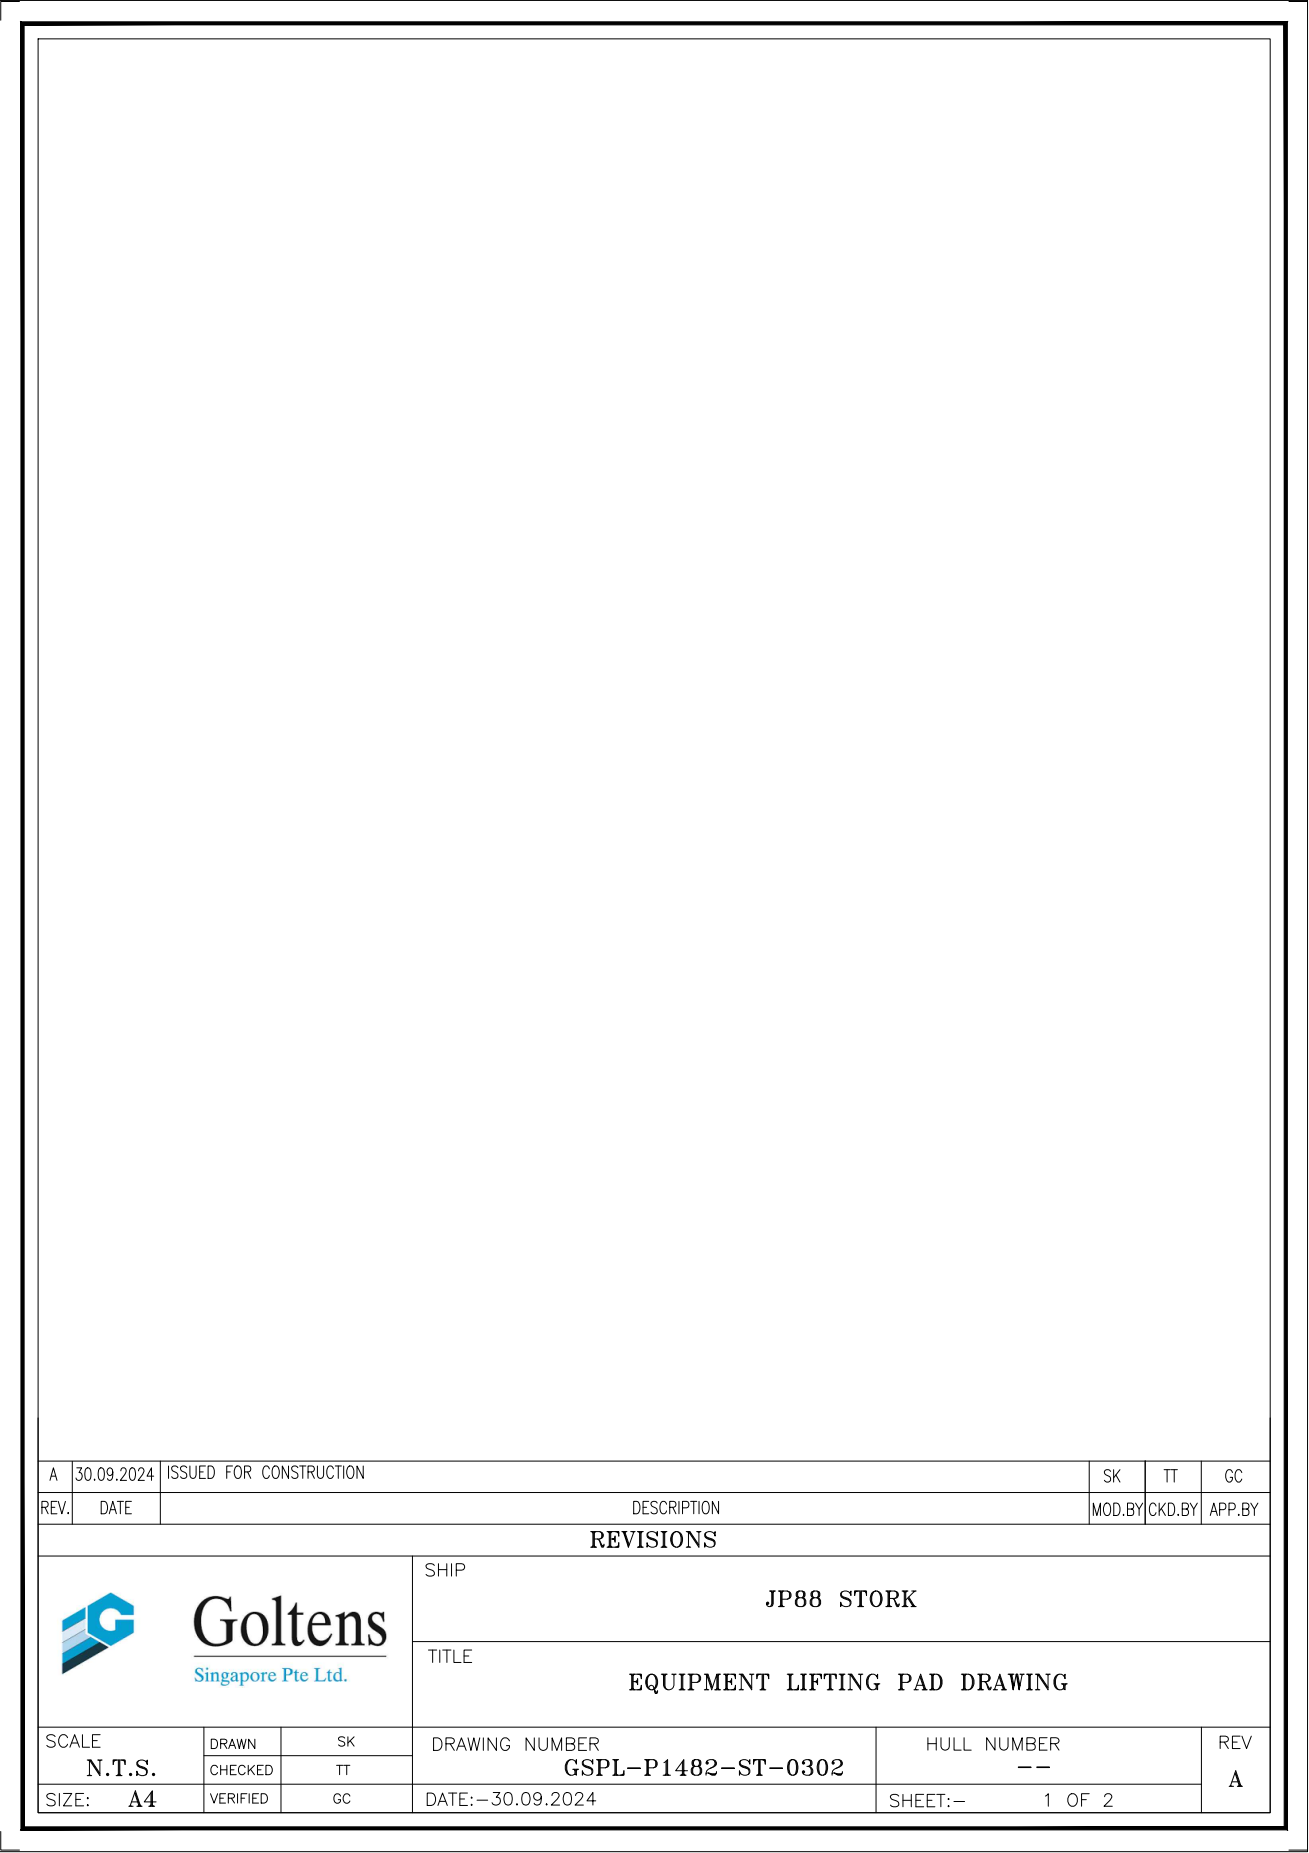
[picture p108: page 1]

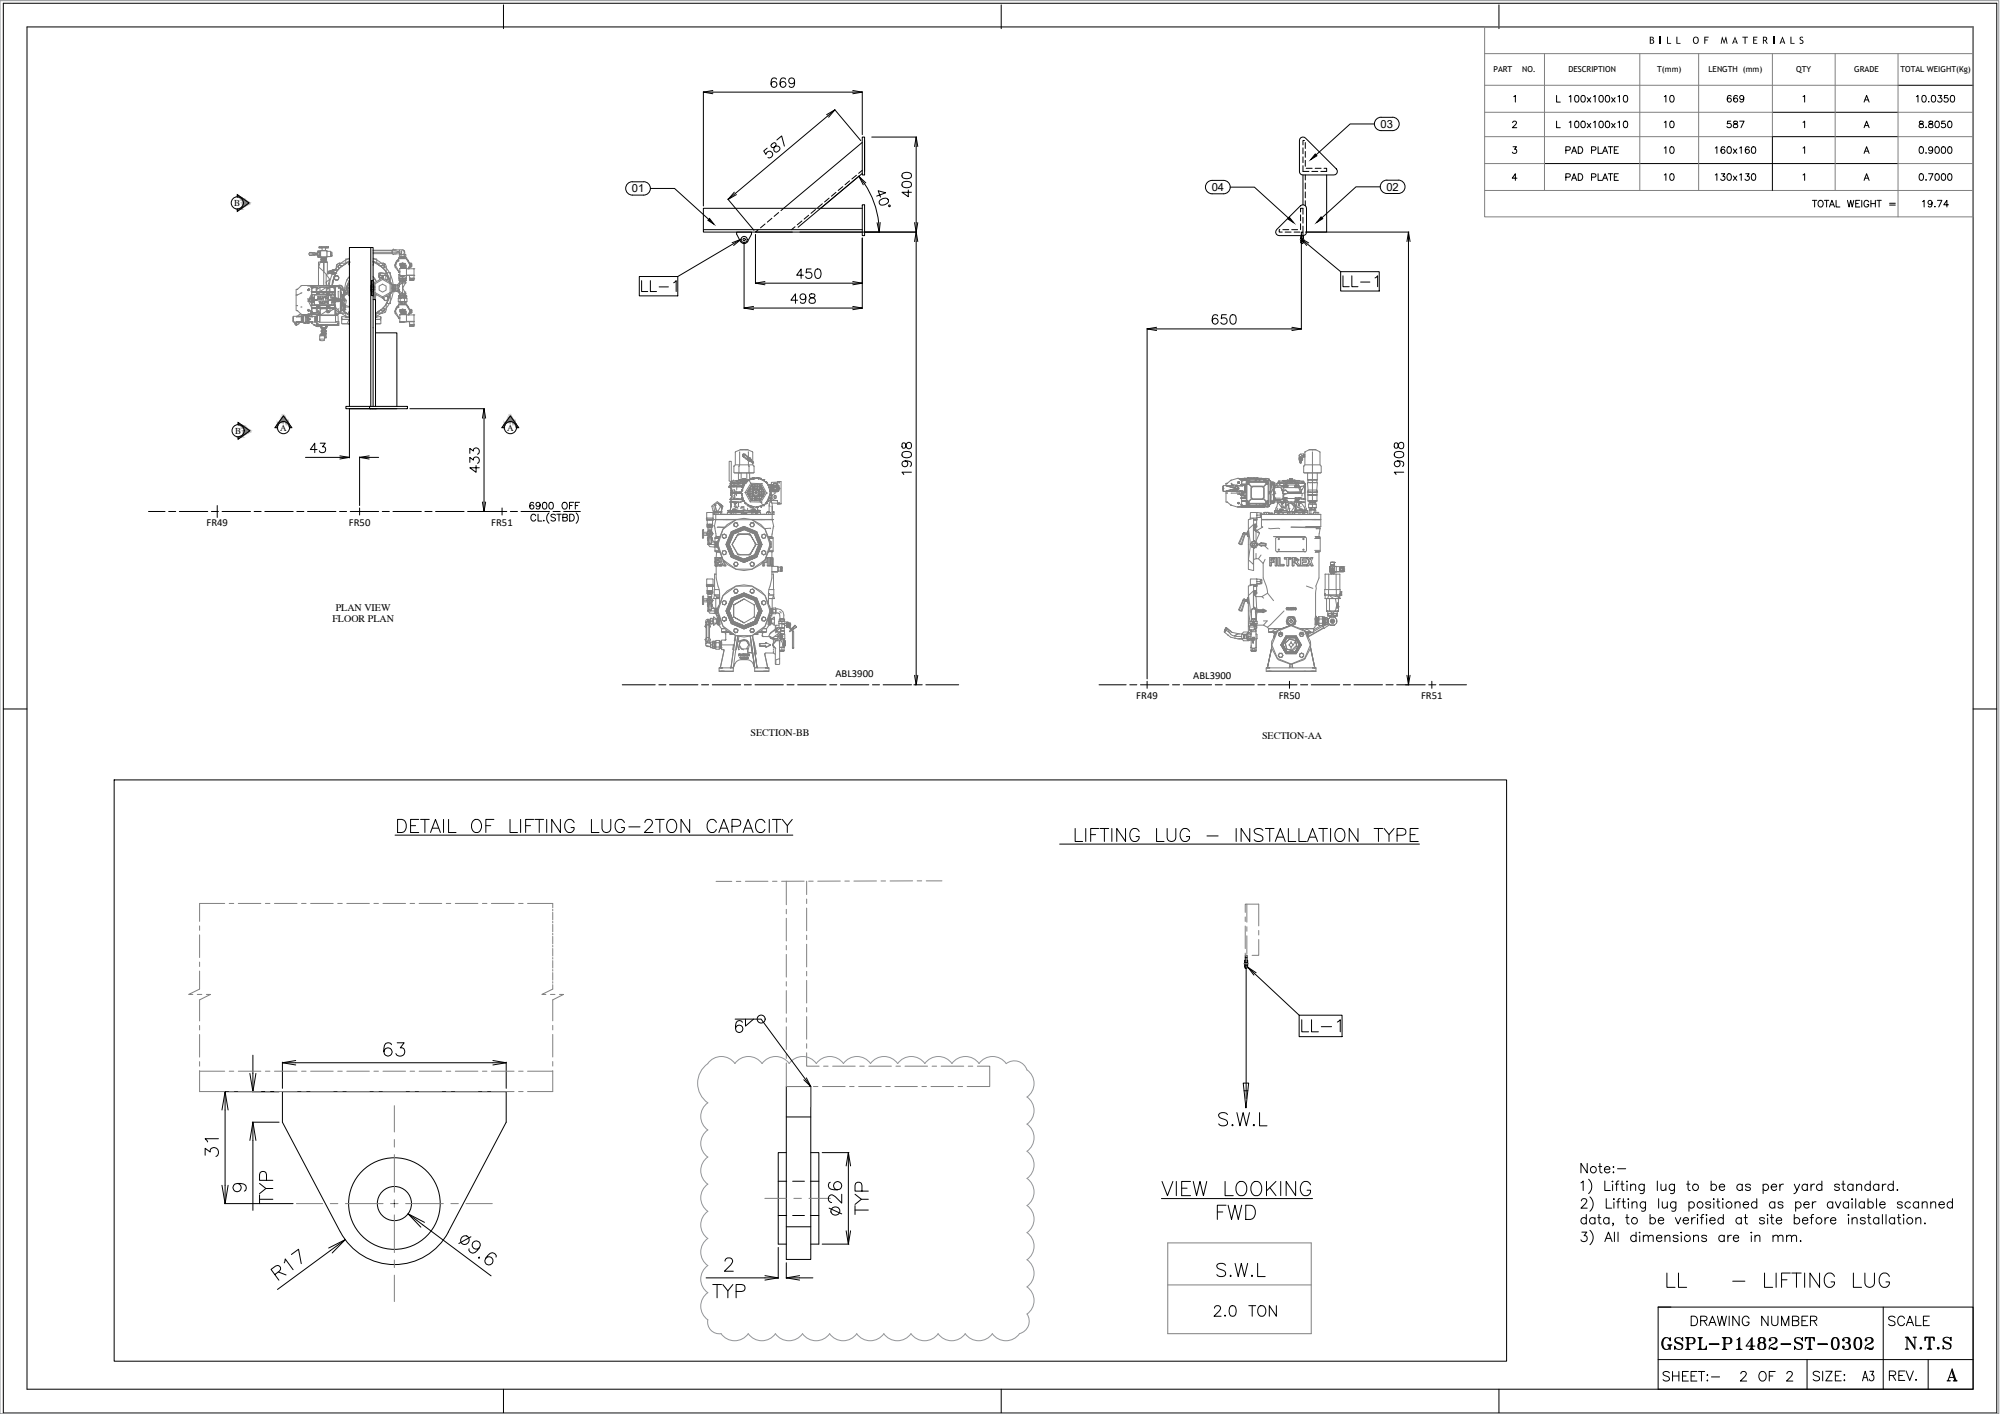
[picture p109: page 2]
PLAN VIEW FLOOR PLAN; ABL3900 SECTION-BB; FR51 SECTION-AA; PART; DESCRIPTION; LENGTH (mm); QTY; GRADE; TOTAL WEIGHT(Kg)

BILL OF MATERIALS
