anurakj/J88_stork/GSPL-P1482-ST-0303 ARRANGEMENT OF PLATFORM & GRATING R.A.pdf

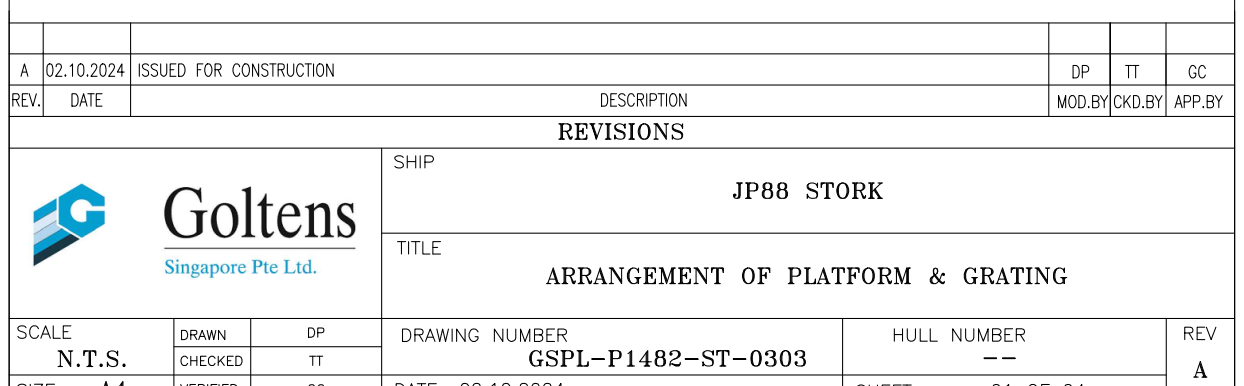
[picture p110: page 1]

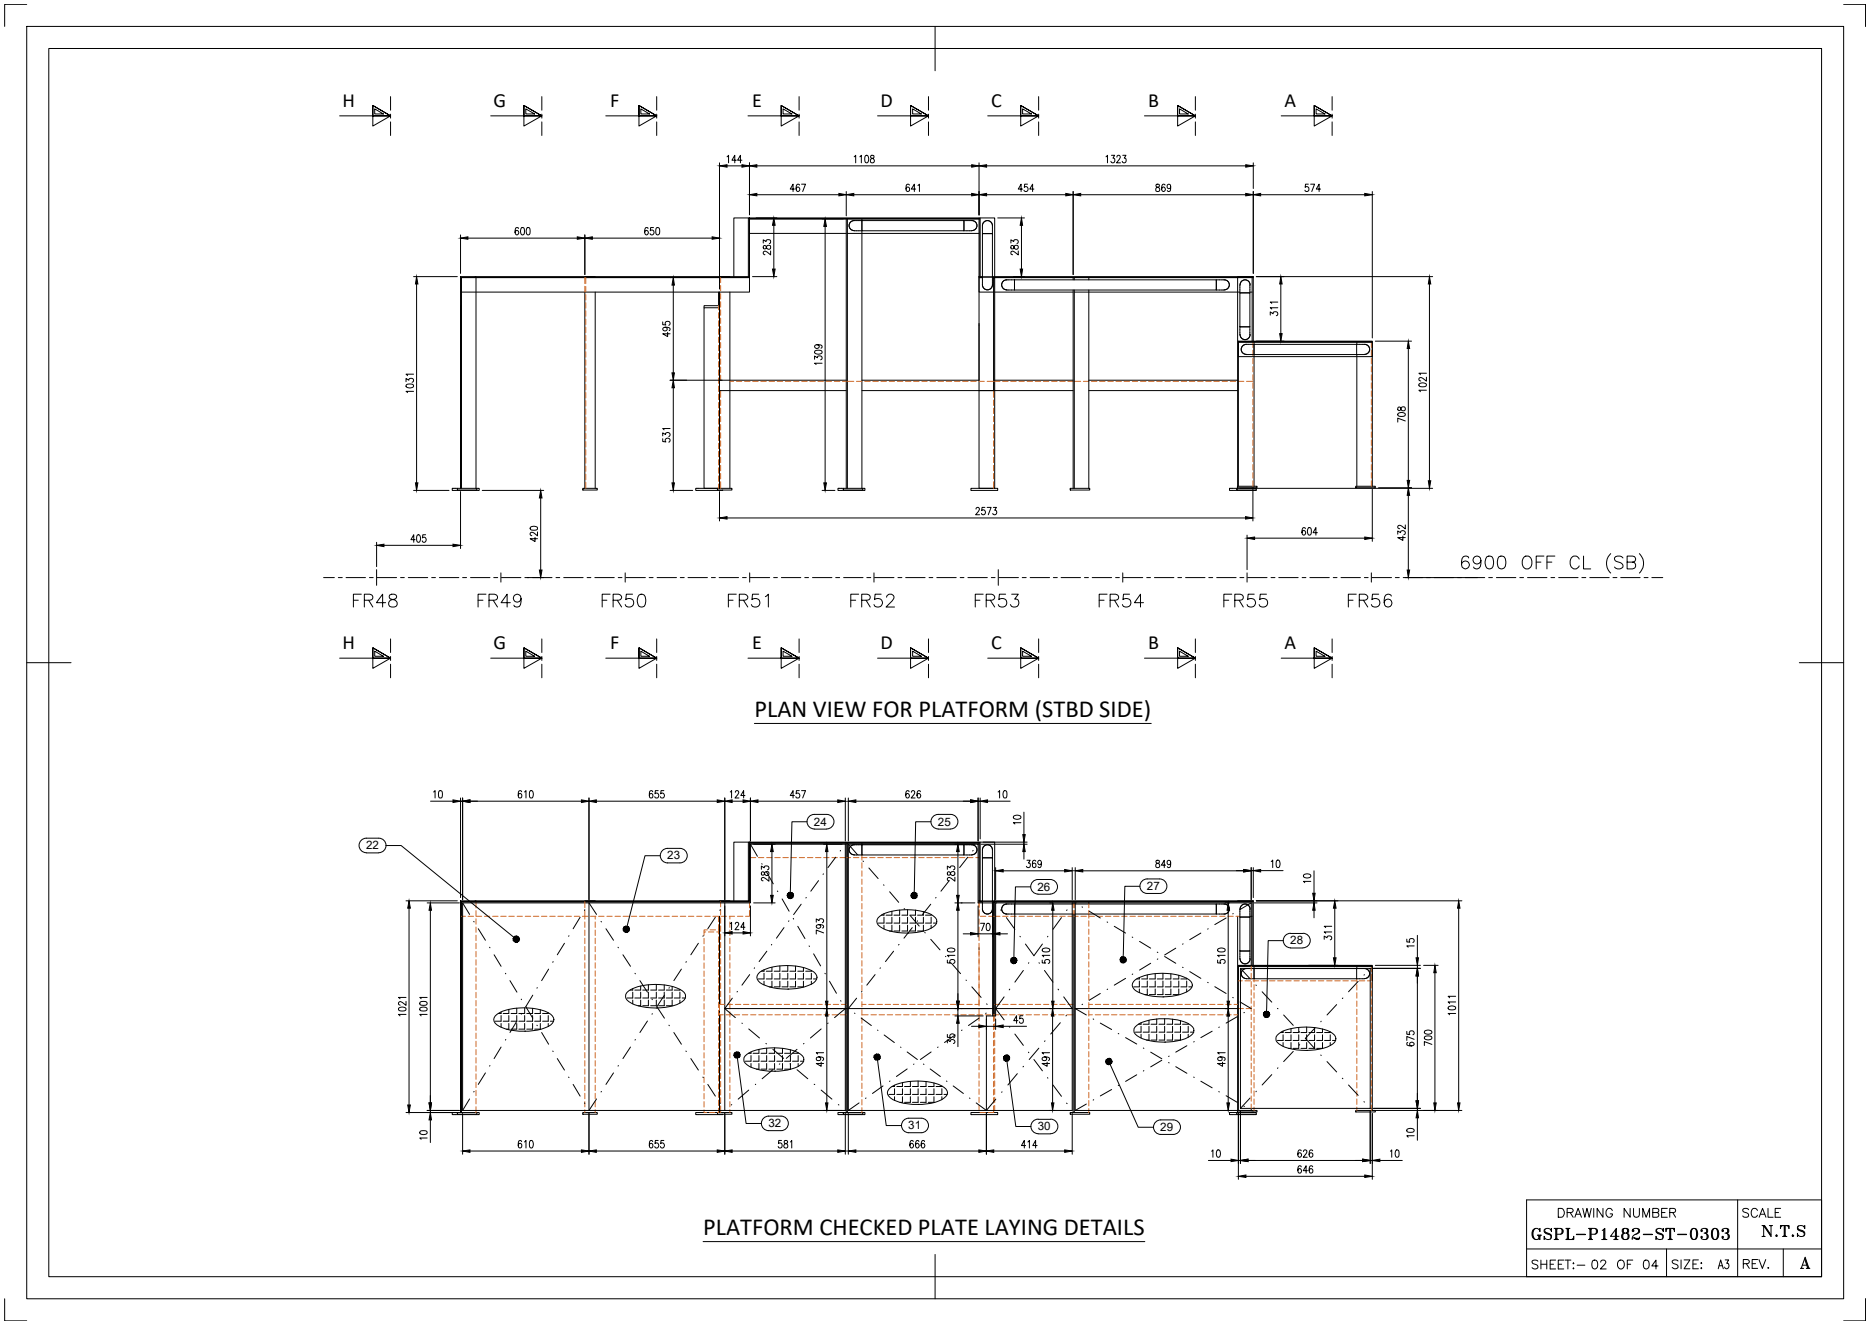
[picture p111: page 2]

PLAN VIEW FOR PLATFORM (STBD SIDE)

PLATFORM CHECKED PLATE LAYING DETAILS

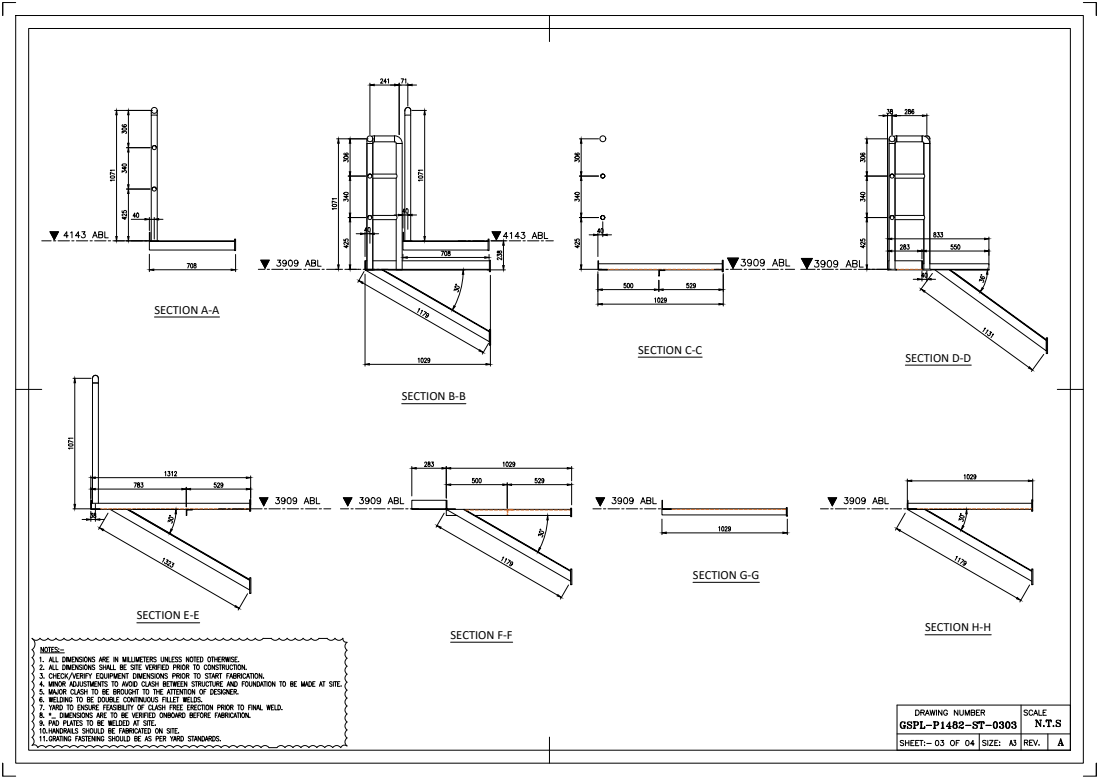
[picture p112: page 3]
SECTION A-A; SECTION B-B; SECTION C-C; SECTION D-D; SECTION E-E; SECTION F-F; SECTION G-G; SECTION H-H

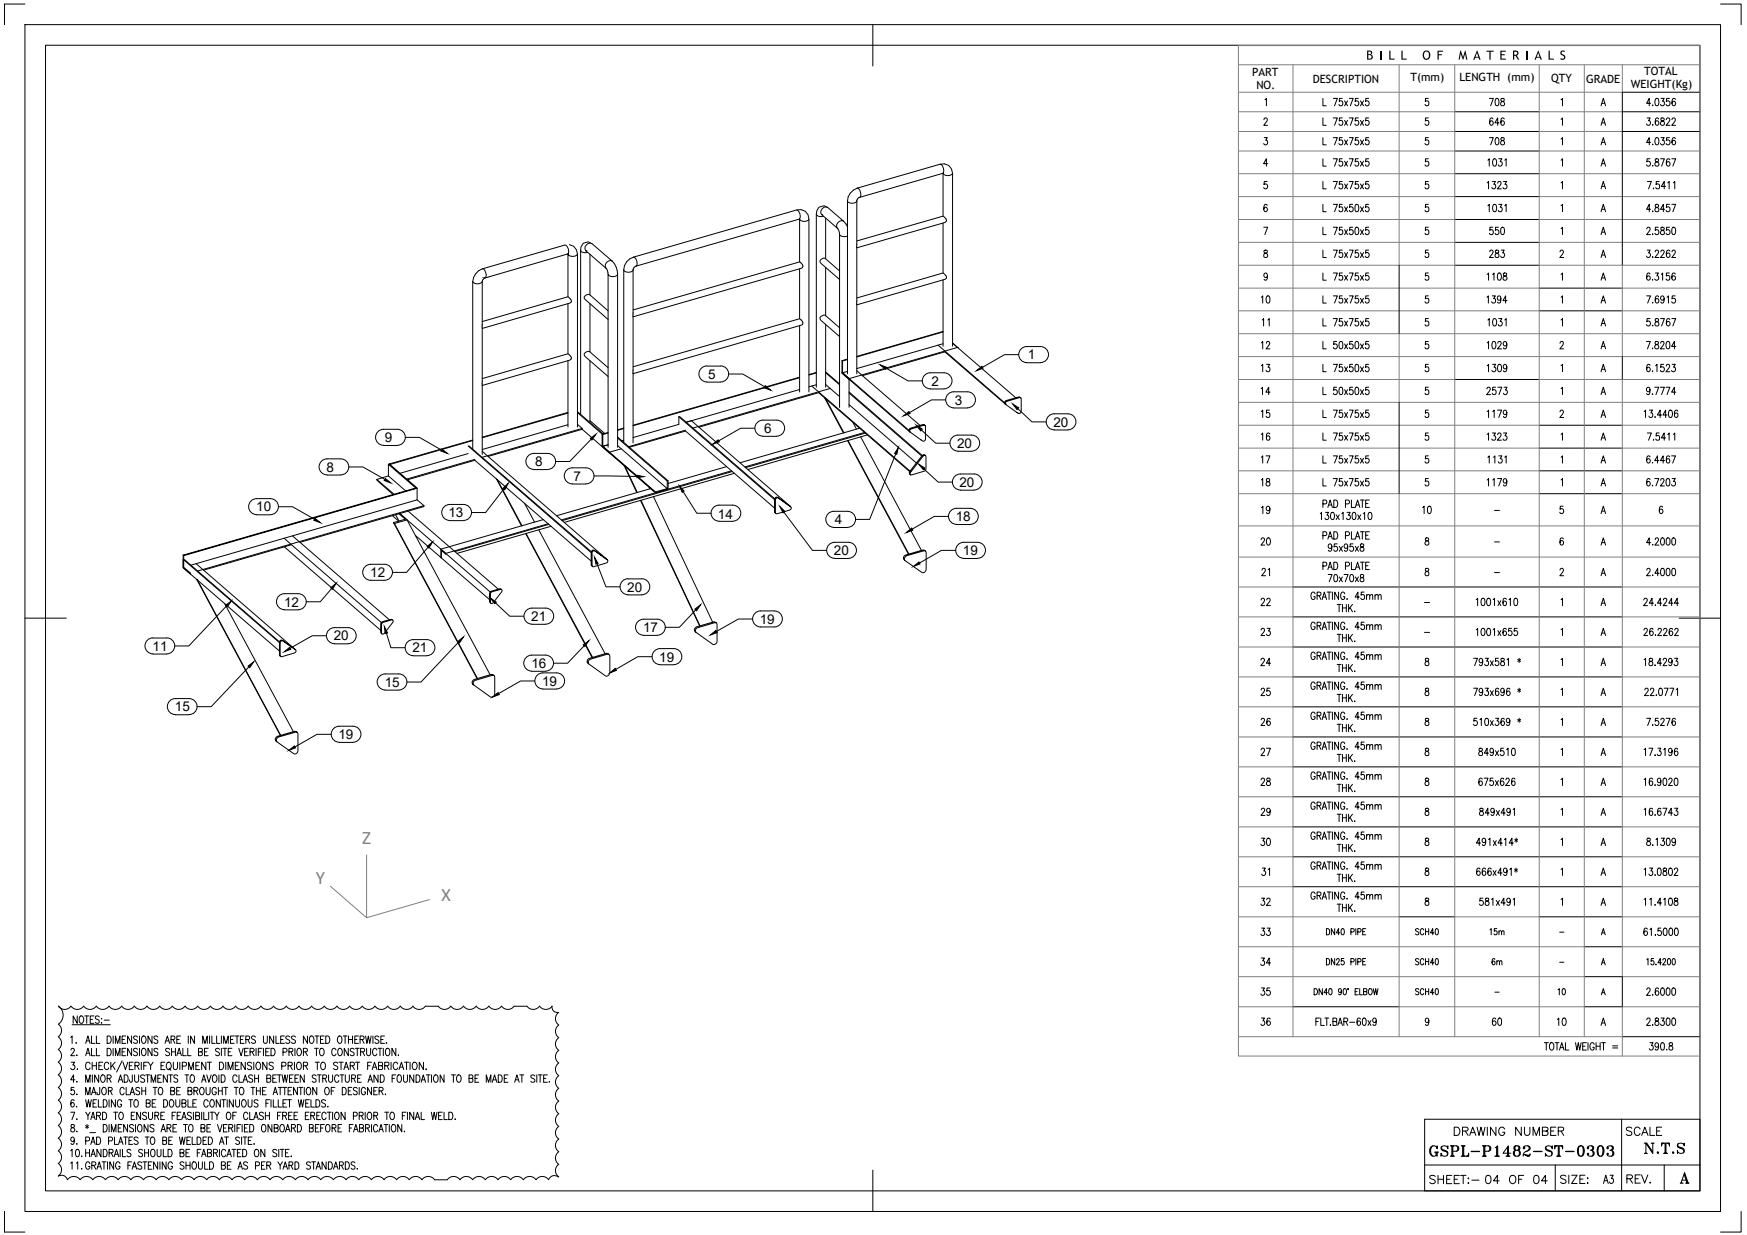
[picture p113: page 4]
MATERIA; PART; DESCRIPTION; LENGTH (mm); QTY; GRADE; TOTAL; WEIGHT(Kg)

SystemId Keyword Description DimensionalDescription PipelineId
