anurakj/J88_stork/Sampling Port.pdf

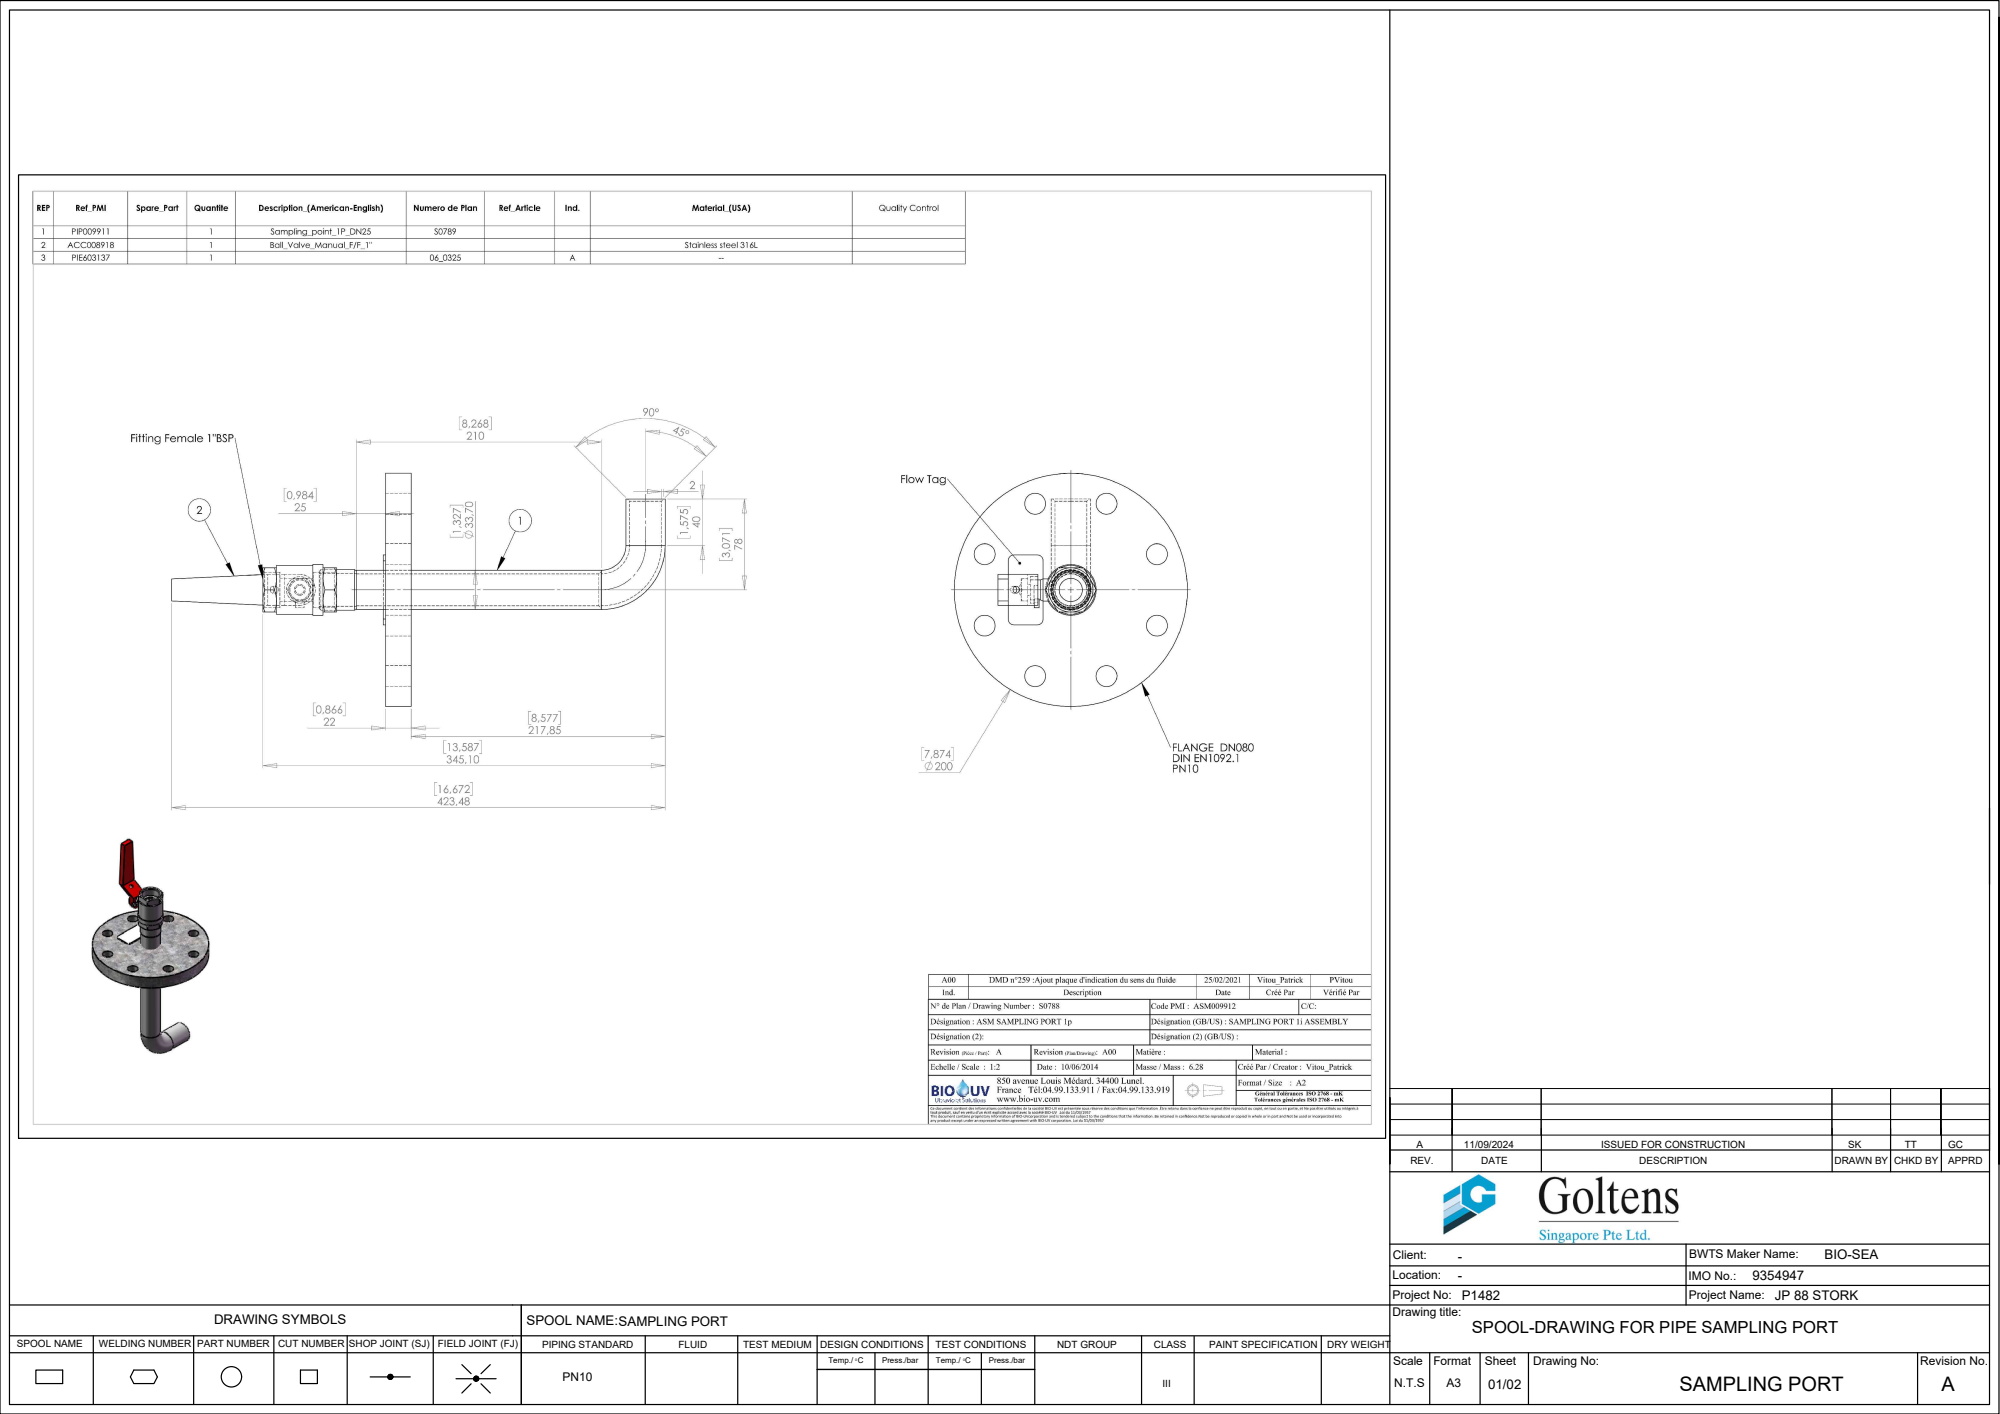
[picture p114: page 1]
SAMPLING PORT; - BIO-SEA; JP 88 STORK; REV.; DATE; DESCRIPTION; DRAWN BY; CHKD BY; APPRD; Drawing title:; Location:; Project No:; Client:; DRAWING SYMBOLS; SPOOL NAME; WELDING NUMBER; PART NUMBER; CUT NUMBER; Temp./ C PIPING STANDARD; FLUID; TEST MEDIUM; DESIGN CONDITIONS SPOOL NAME:; SHOP JOINT (SJ); FIELD JOINT (FJ); PAINT SPECIFICATION; DRY WEIGHT; Scale; Format; Sheet; Drawing No:; Revision No.; Project Name:; IMO No.:; NDT GROUP; Press./bar; Temp./ C; Press./bar TEST CONDITIONS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

BWTS Maker Name:

SPOOL-DRAWING FOR PIPE

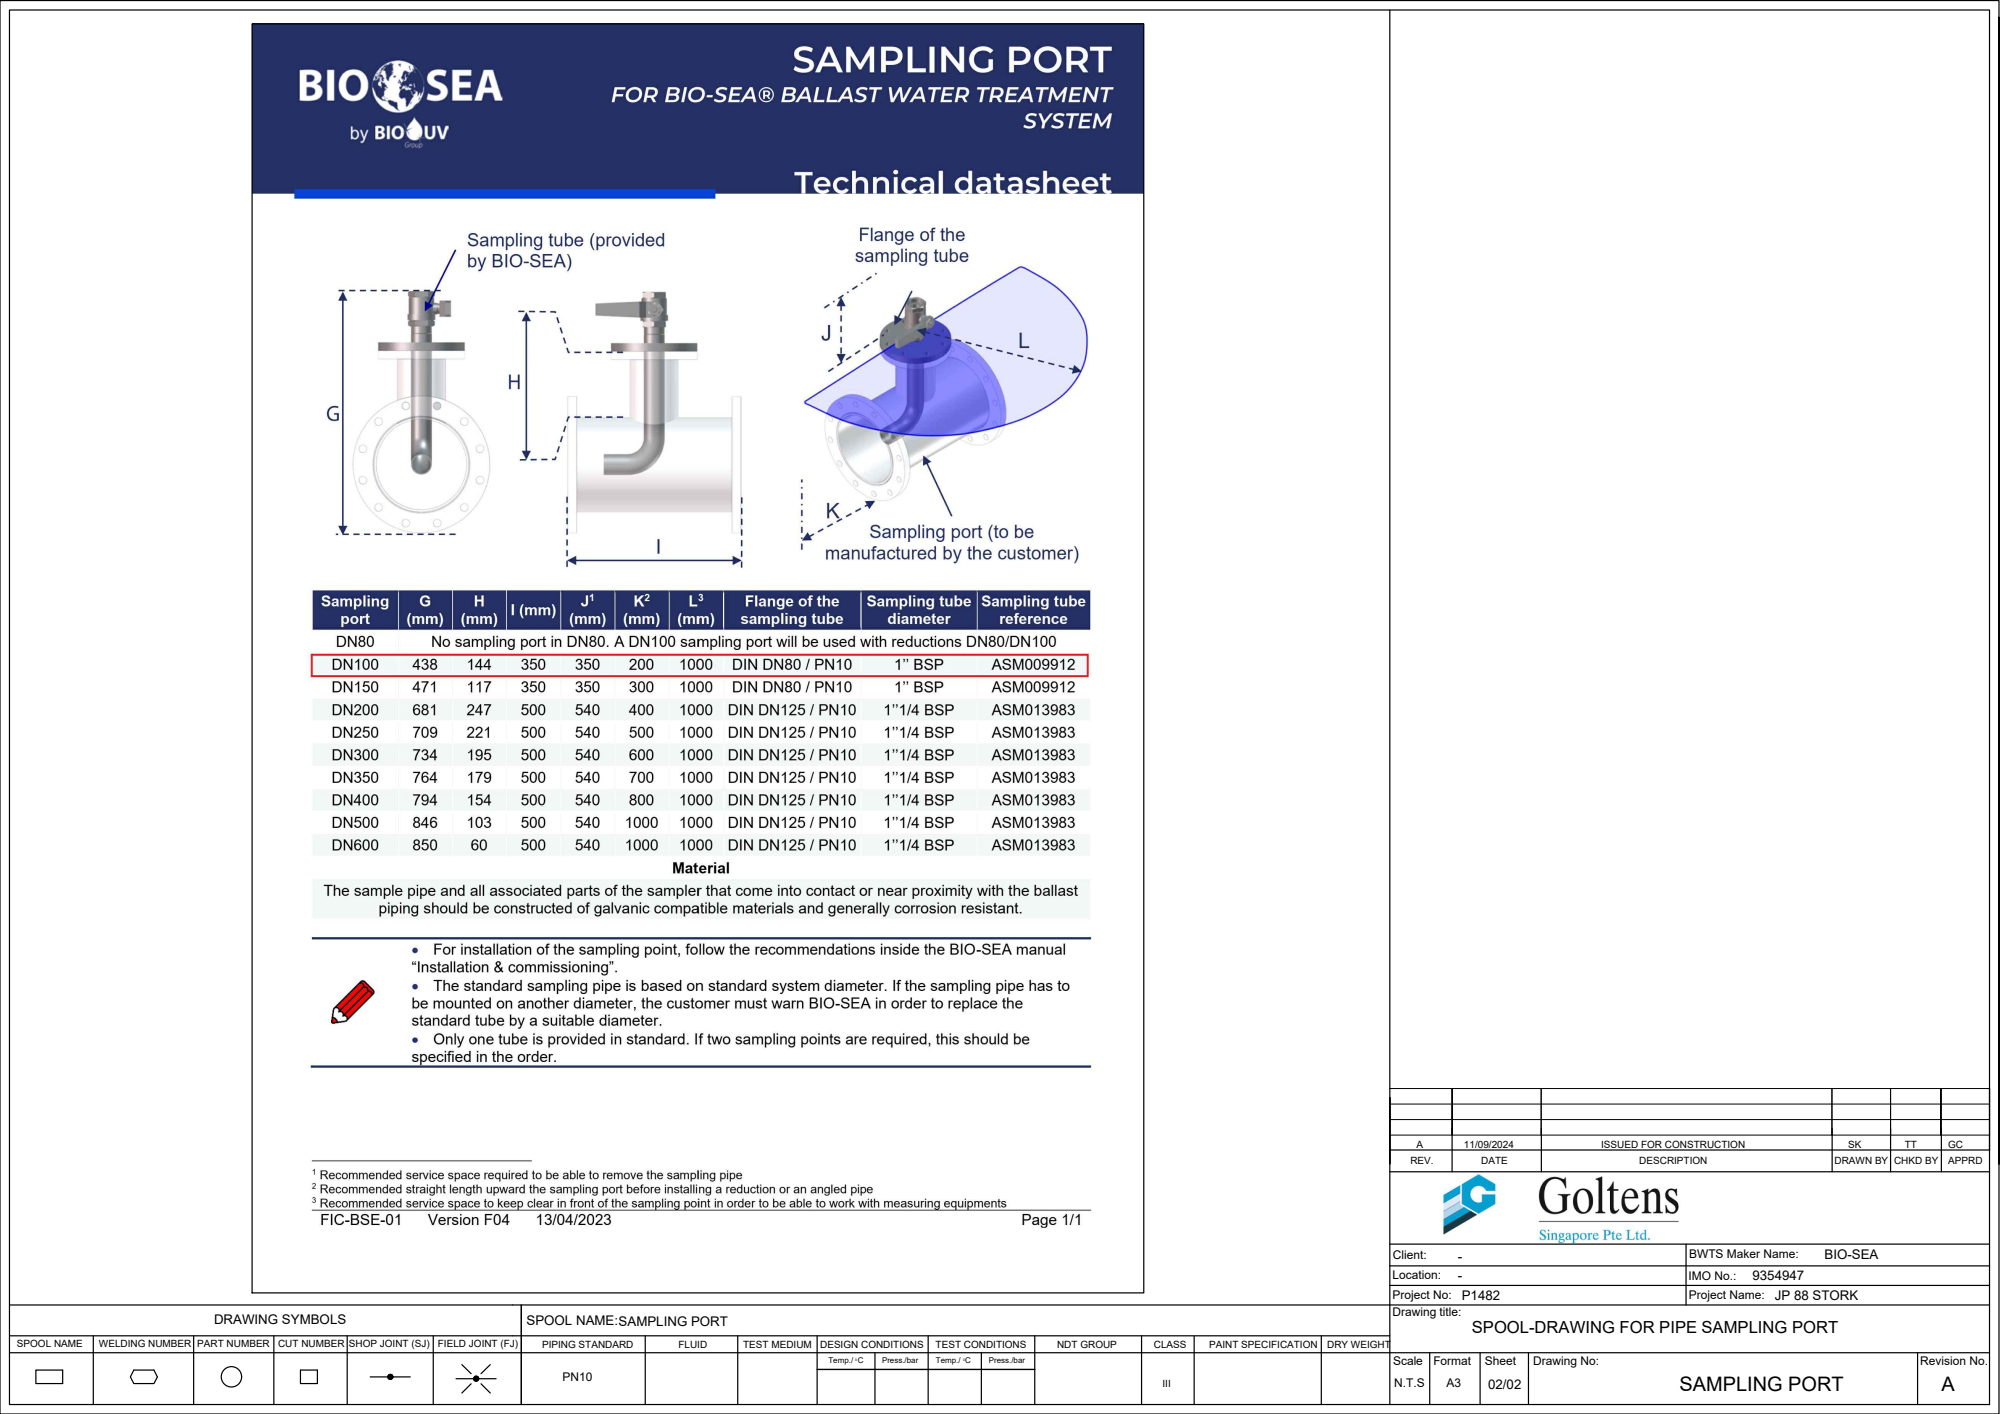
[picture p115: page 2]
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

BWTS Maker Name:

SPOOL-DRAWING FOR PIPE
