anurakj/J88_stork/Bypass_valves_logic_box/Quotation_from_Global_electrical/GSPL-P1482-PI-0007 Valve Configuration list for Bypass R.A.pdf

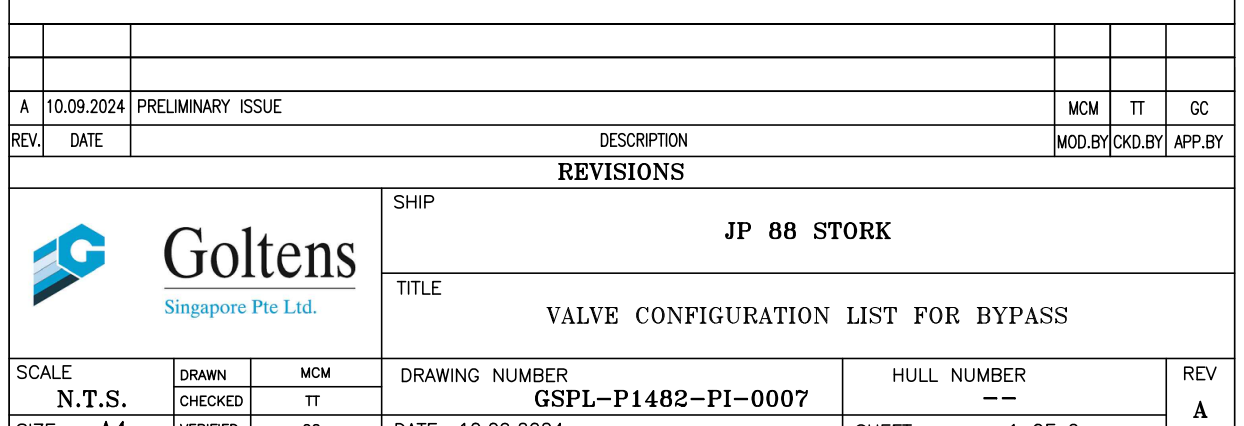
[picture p120: page 1]

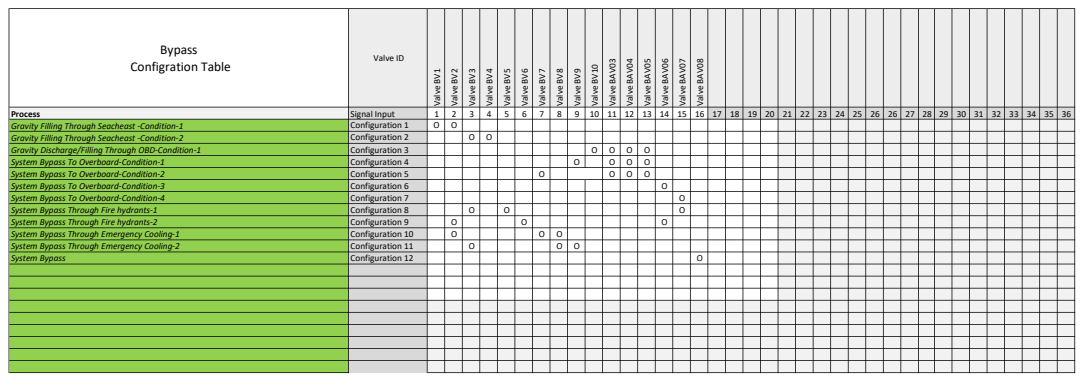
[picture p121: page 2]

Bypass Configration Table | Valve ID | Valve BV1 | Valve BV2 | Valve BV3 | Valve BV4 | Valve BV5 | Valve BV6 | Valve BV7 | Valve BV8 | Valve BV9 | Valve BV10 | Valve BAV03 | Valve BAV04 | Valve BAV05 | Valve BAV06 | Valve BAV07 | Valve BAV08

Process | Signal Input | 1 | 2 | 3 | 4 | 5 | 6 | 7 | 8 | 9 | 10 | 11 | 12 | 13 | 14 | 15 | 16 | 17 | 18 | 19 | 20 | 21 | 22 | 23 | 24 | 25 | 26 | 26 | 27 | 28 | 29 | 30 | 31 | 32 | 33 | 34 | 35 | 36
Gravity Filling Through Seacheast -Condition-1 | Configuration 1 | O | O
Gravity Filling Through Seacheast -Condition-2 | Configuration 2 | | | O | O
Gravity Discharge/Filling Through OBD-Condition-1 | Configuration 3 | | | | | | | | | | O | O | O | O
System Bypass To Overboard-Condition-1 | Configuration 4 | | | | | | | | | O | | O | O | O
System Bypass To Overboard-Condition-2 | Configuration 5 | | | | | | | O | | | | O | O | O
System Bypass To Overboard-Condition-3 | Configuration 6 | | | | | | | | | | | | | | O
System Bypass To Overboard-Condition-4 | Configuration 7 | | | | | | | | | | | | | | | O
System Bypass Through Fire hydrants-1 | Configuration 8 | | | O | | O | | | | | | | | | | O
System Bypass Through Fire hydrants-2 | Configuration 9 | | O | | | | O | | | | | | | | O
System Bypass Through Emergency Cooling-1 | Configuration 10 | | O | | | | | O | O
System Bypass Through Emergency Cooling-2 | Configuration 11 | | | O | | | | | O | O
System Bypass | Configuration 12 | | | | | | | | | | | | | | | | O
