anurakj/J88_stork/GSPL-P1482-PI-0001 BWTS PIPING SCHEMATIC R.D.pdf

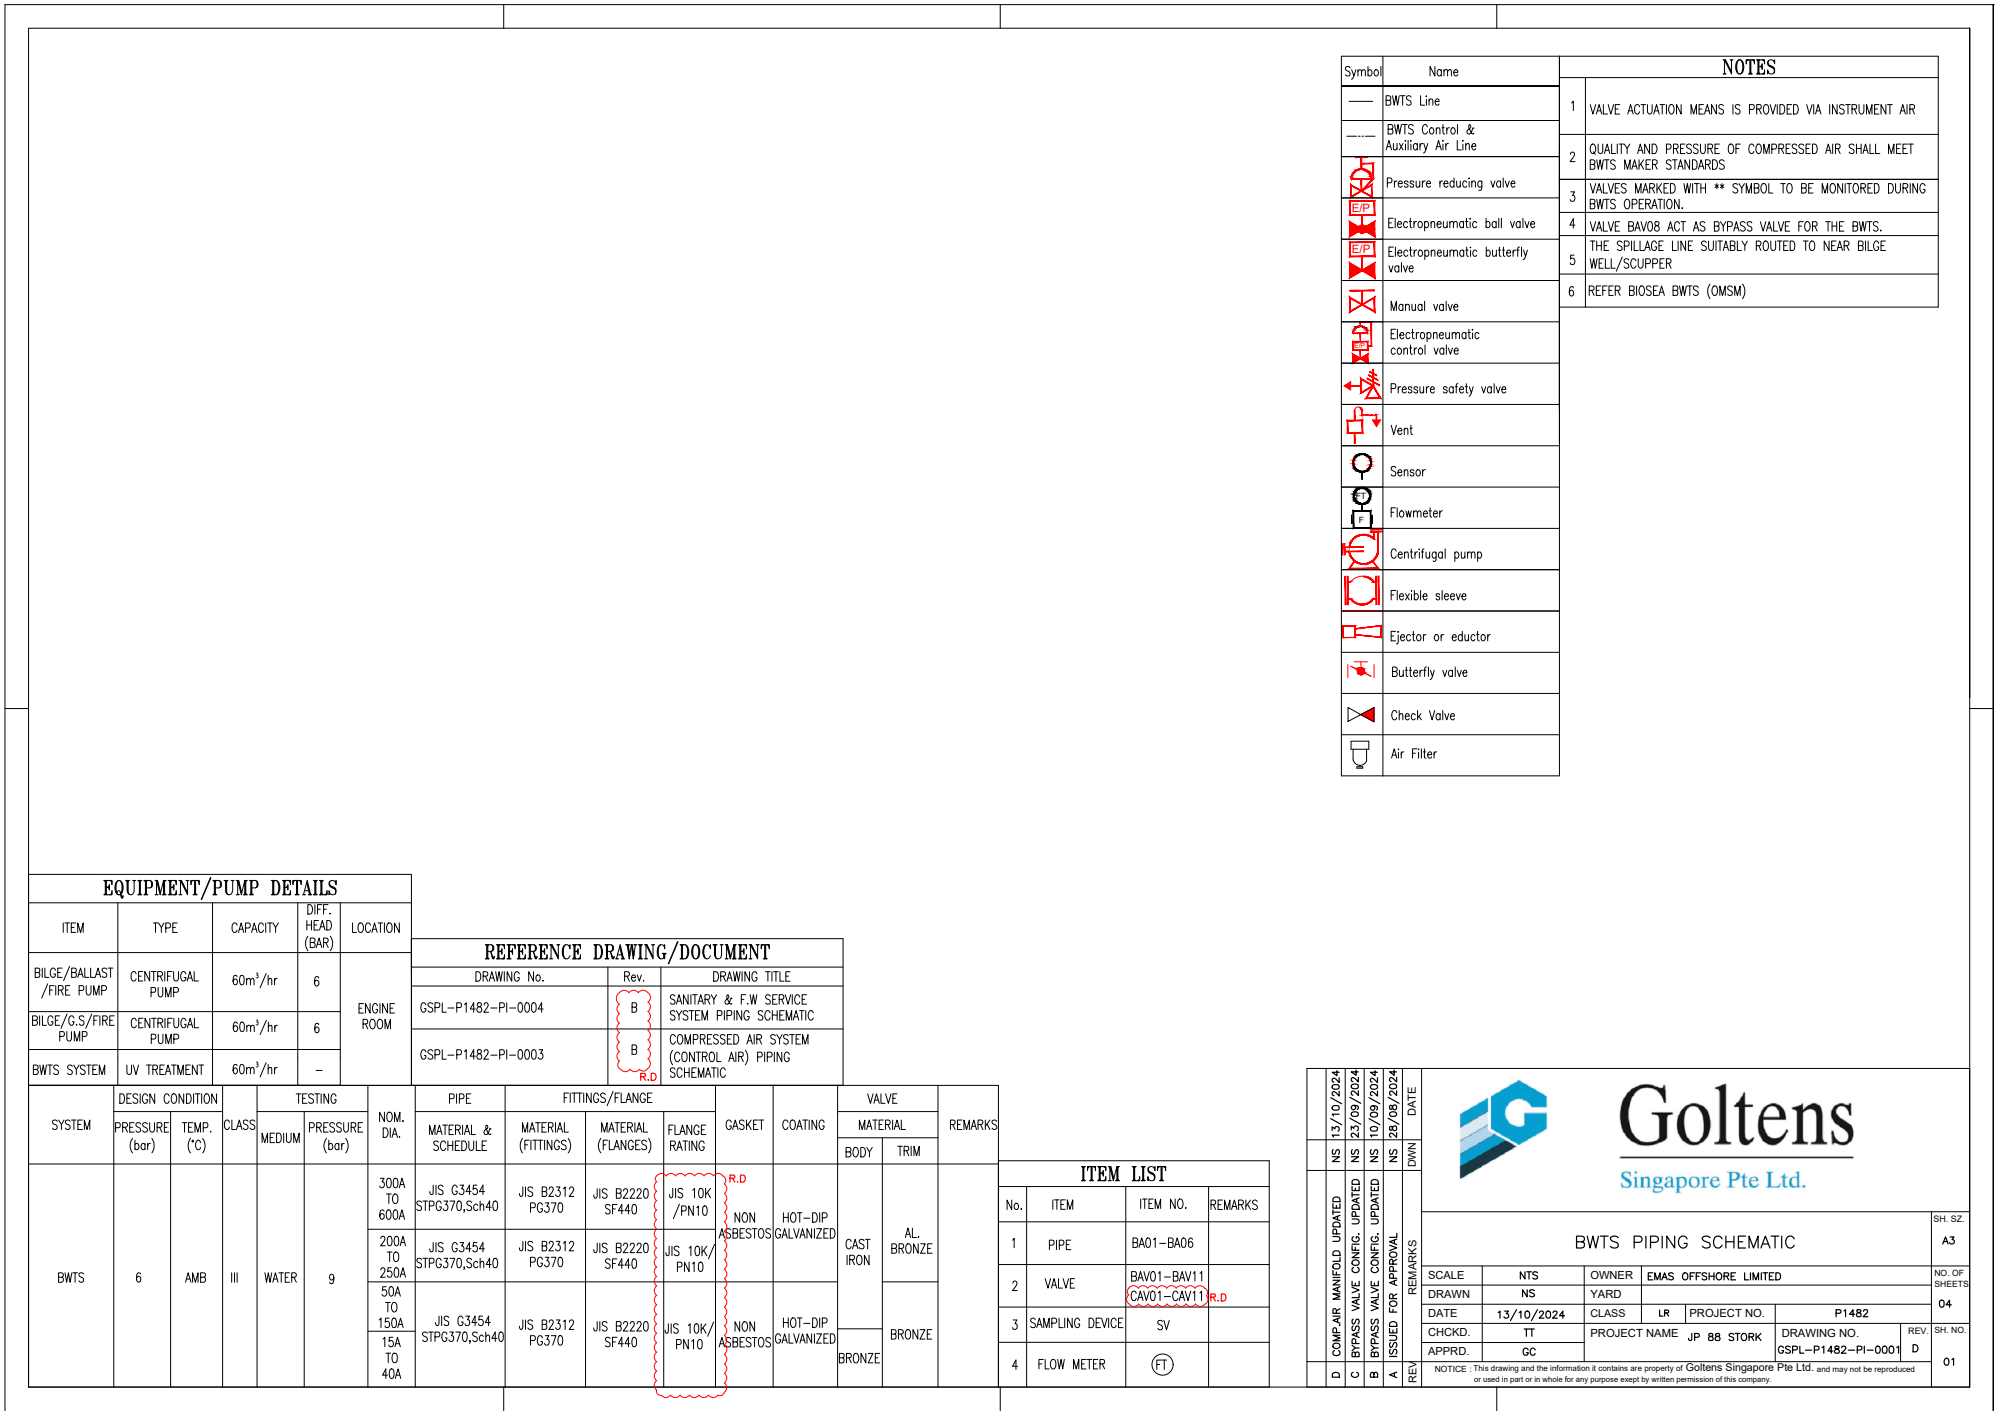
[picture p122: page 1]
CHCKD.; PROJECT NAME; DRAWING NO.

SH. SZ. REMARKS REV DWN DATE

SCALE | | OWNER | | | | NO. OF SHEETS

DRAWN | | YARD
DATE | CLASS | | PROJECT NO.

REV. | SH. NO.

or used in part or in whole for any purpose exept by written permission of this company. NOTICE : APPRD.

This drawing and the information it contains are property of Goltens Singapore Pte Ltd. and may not be reproduced

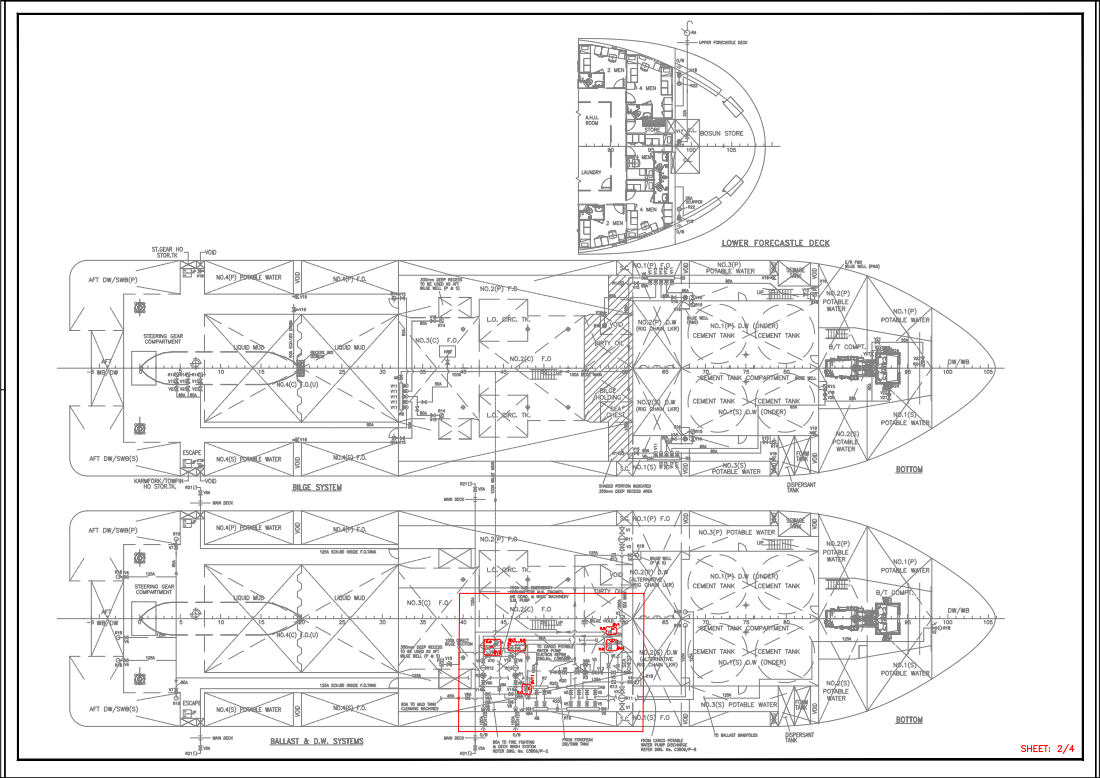
[picture p123: page 2]
UPUP

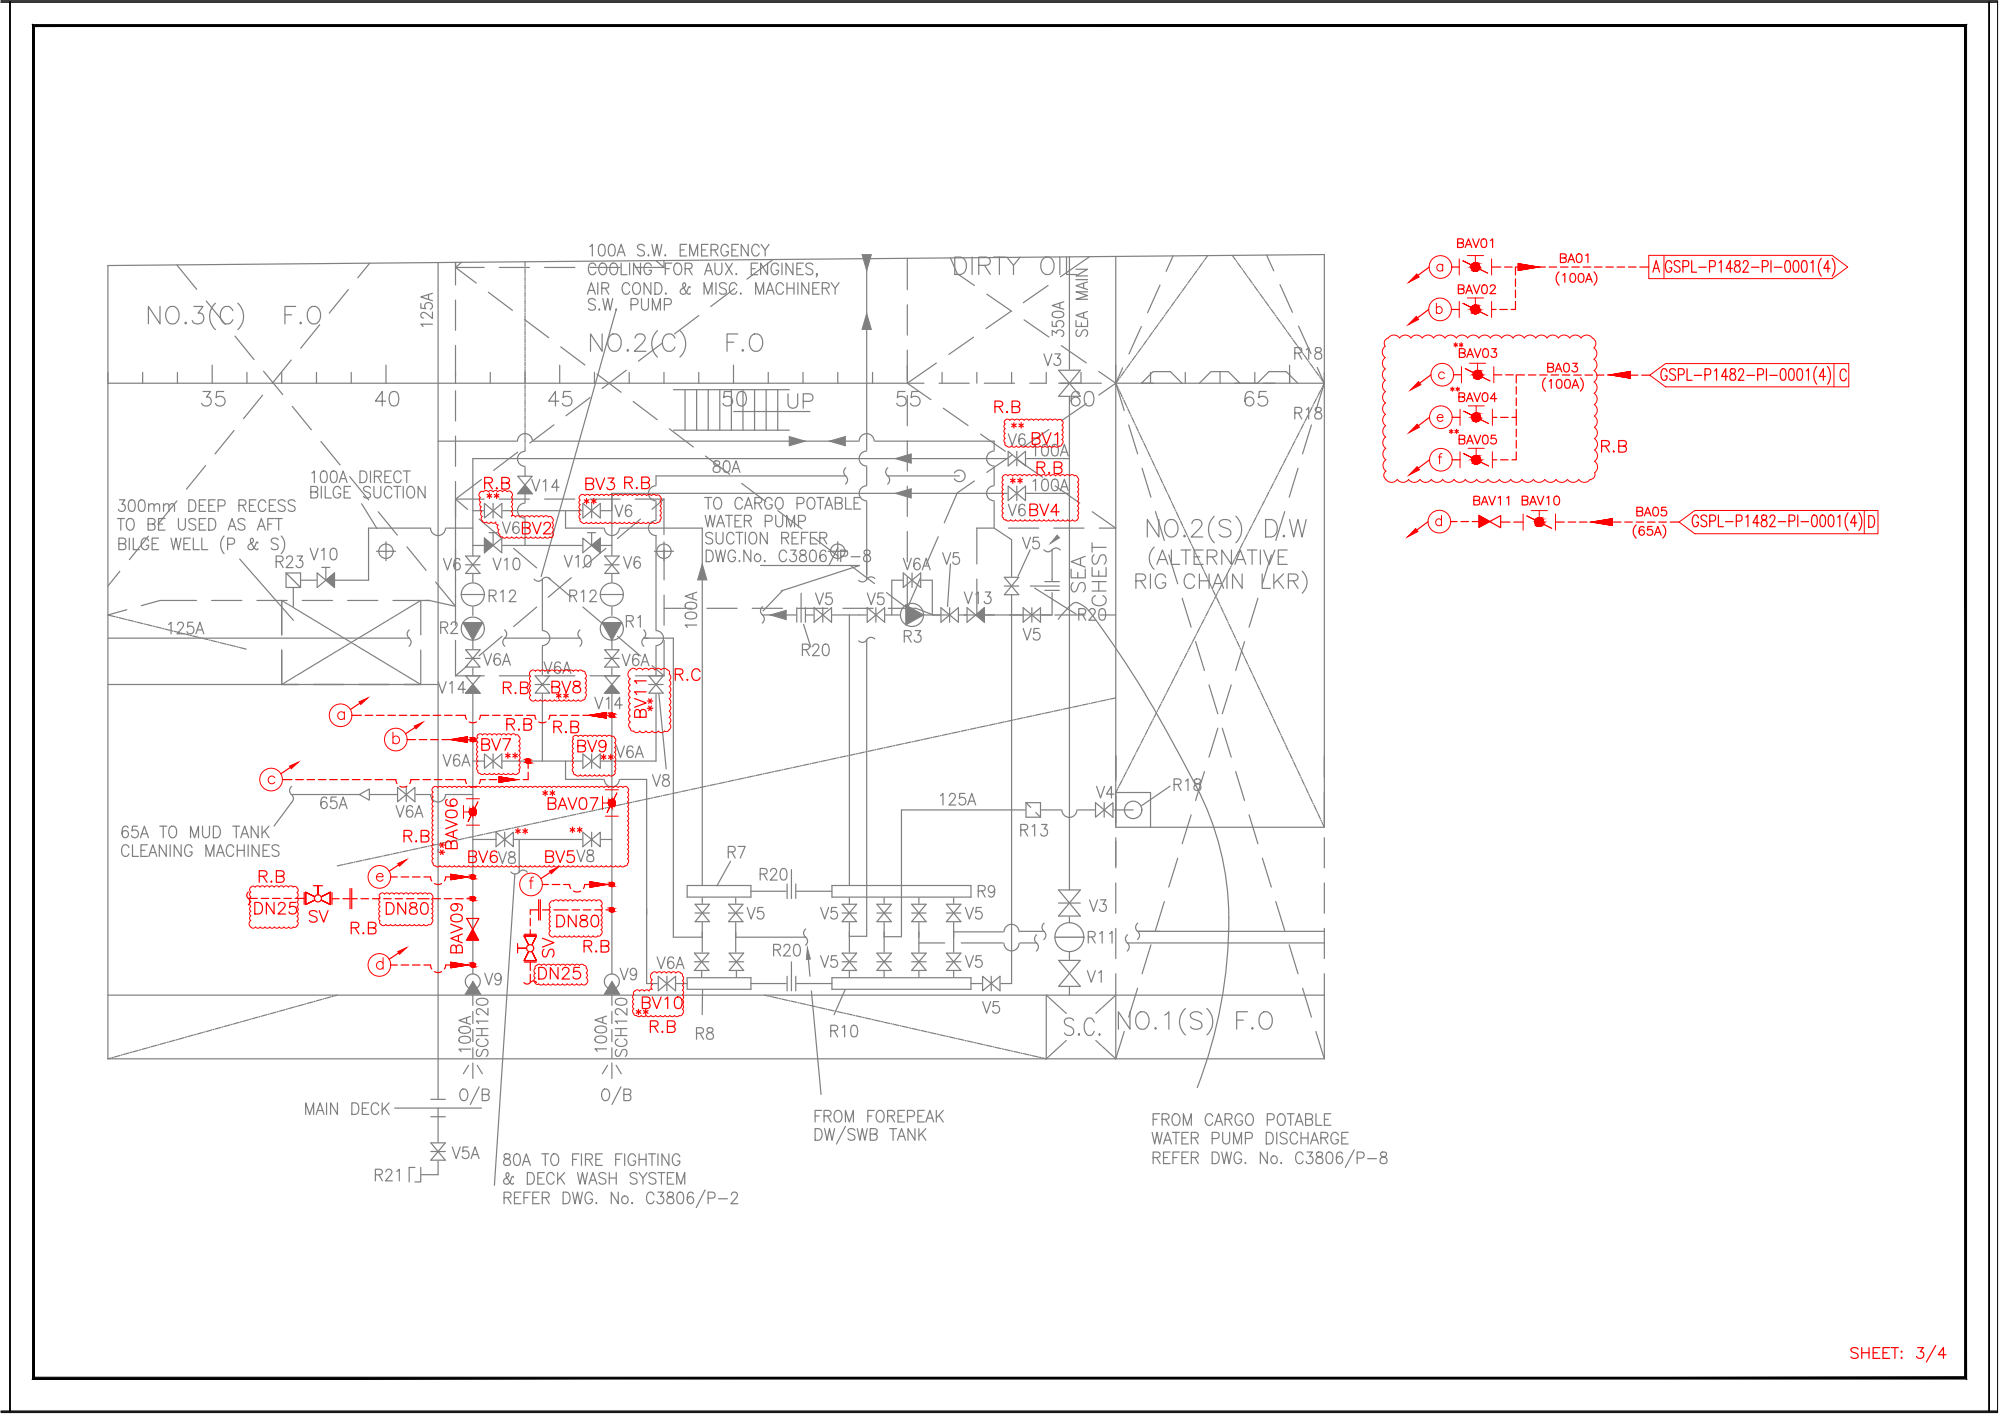
[picture p124: page 3]

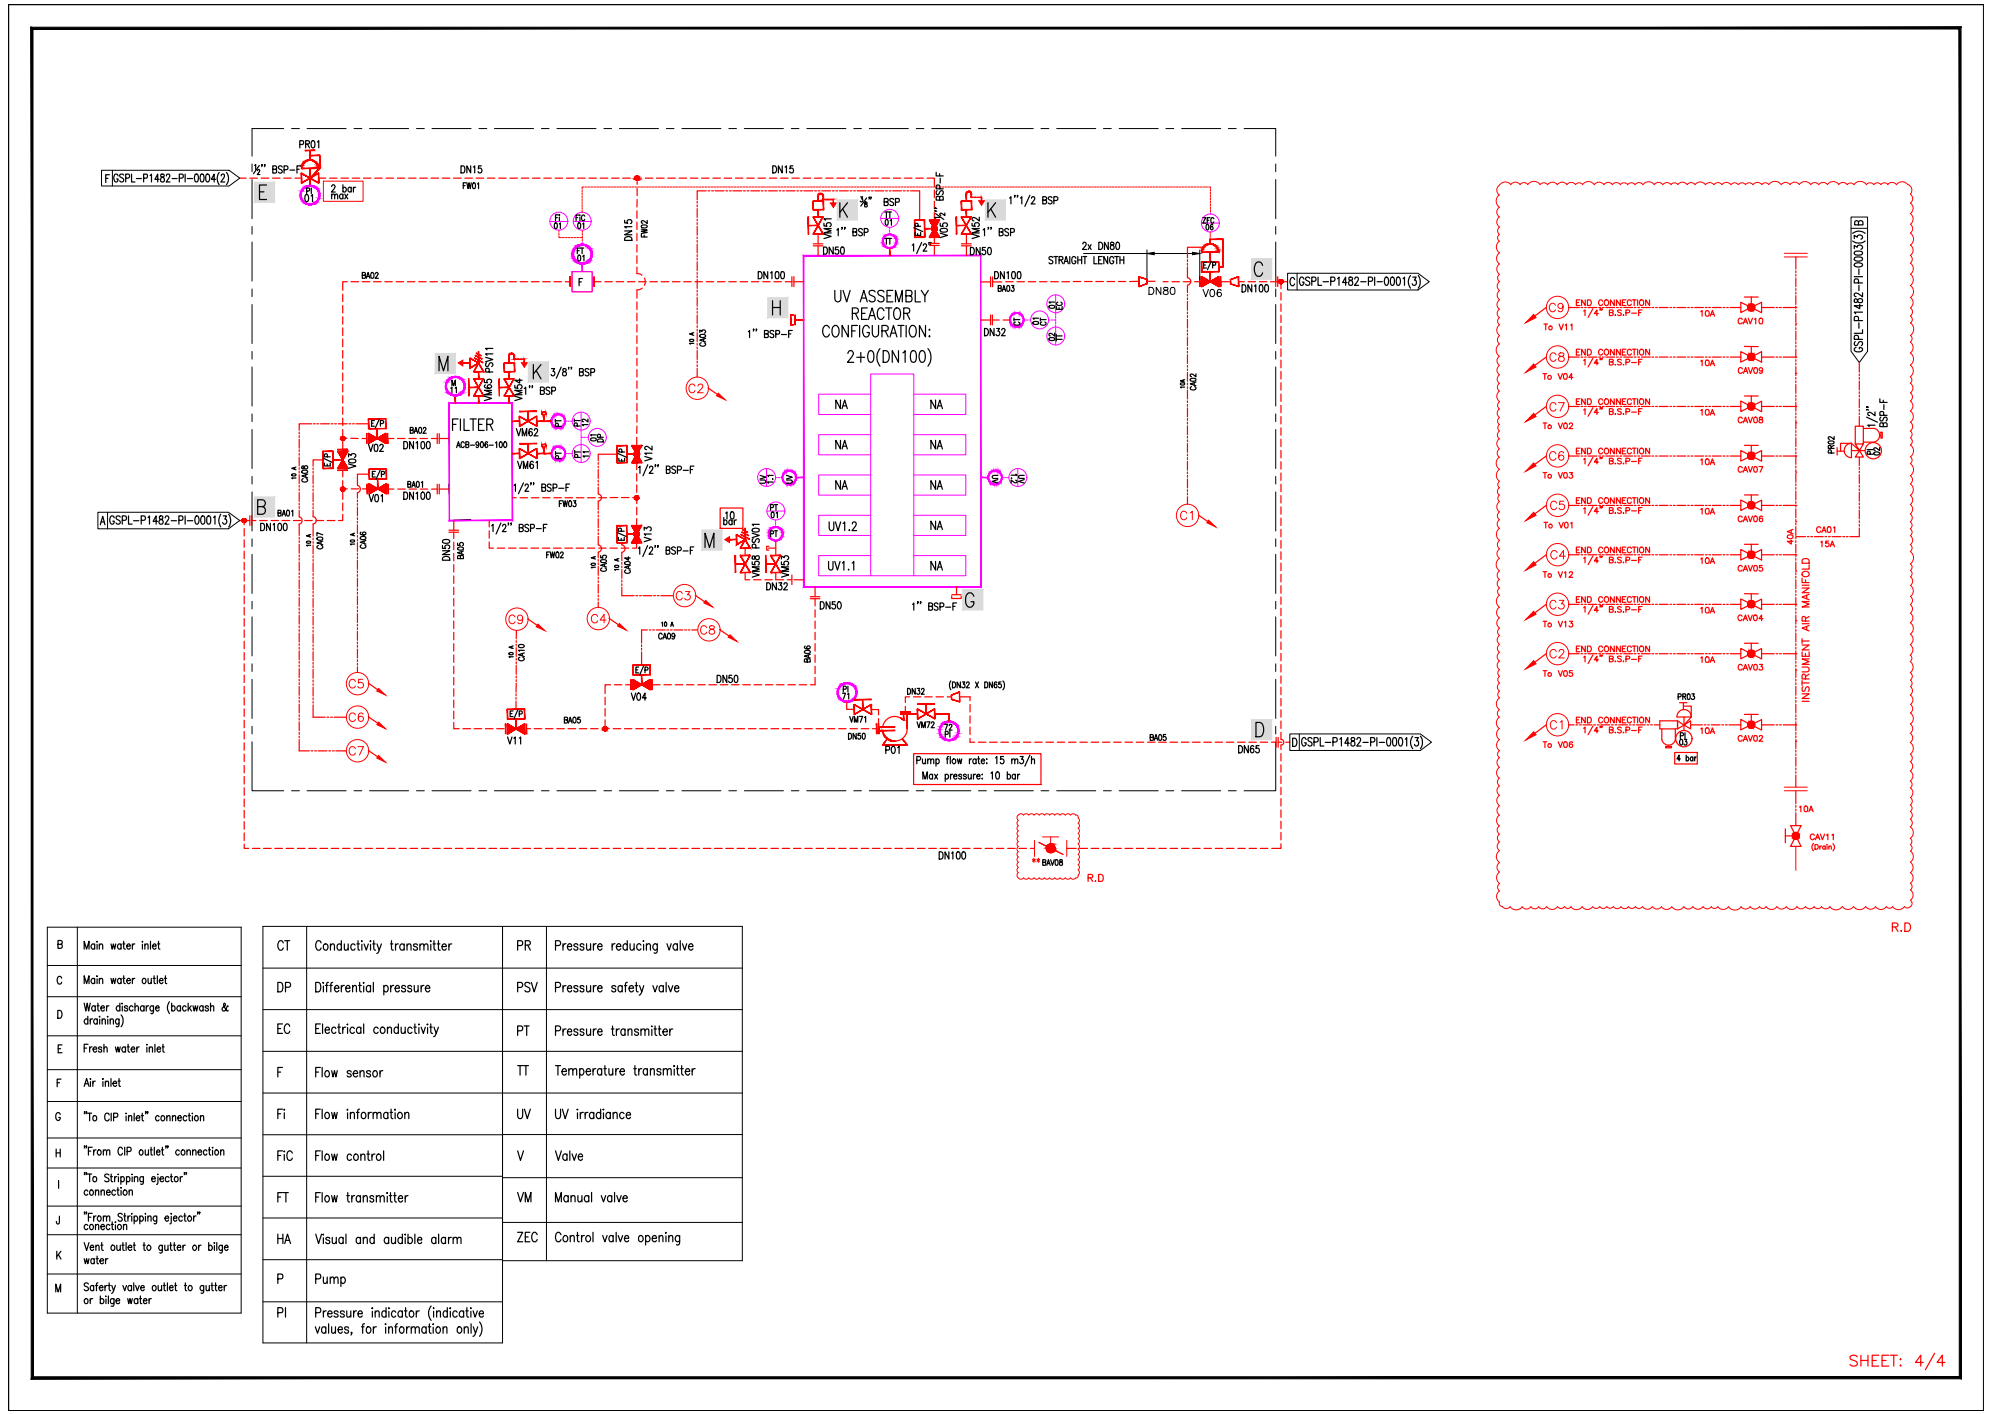
[picture p125: page 4]
