anurakj/J88_stork/GSPL-P1482-PI-0003 COMPRESSED AIR SYSTEM PIPING SCHEMATIC R.B.pdf

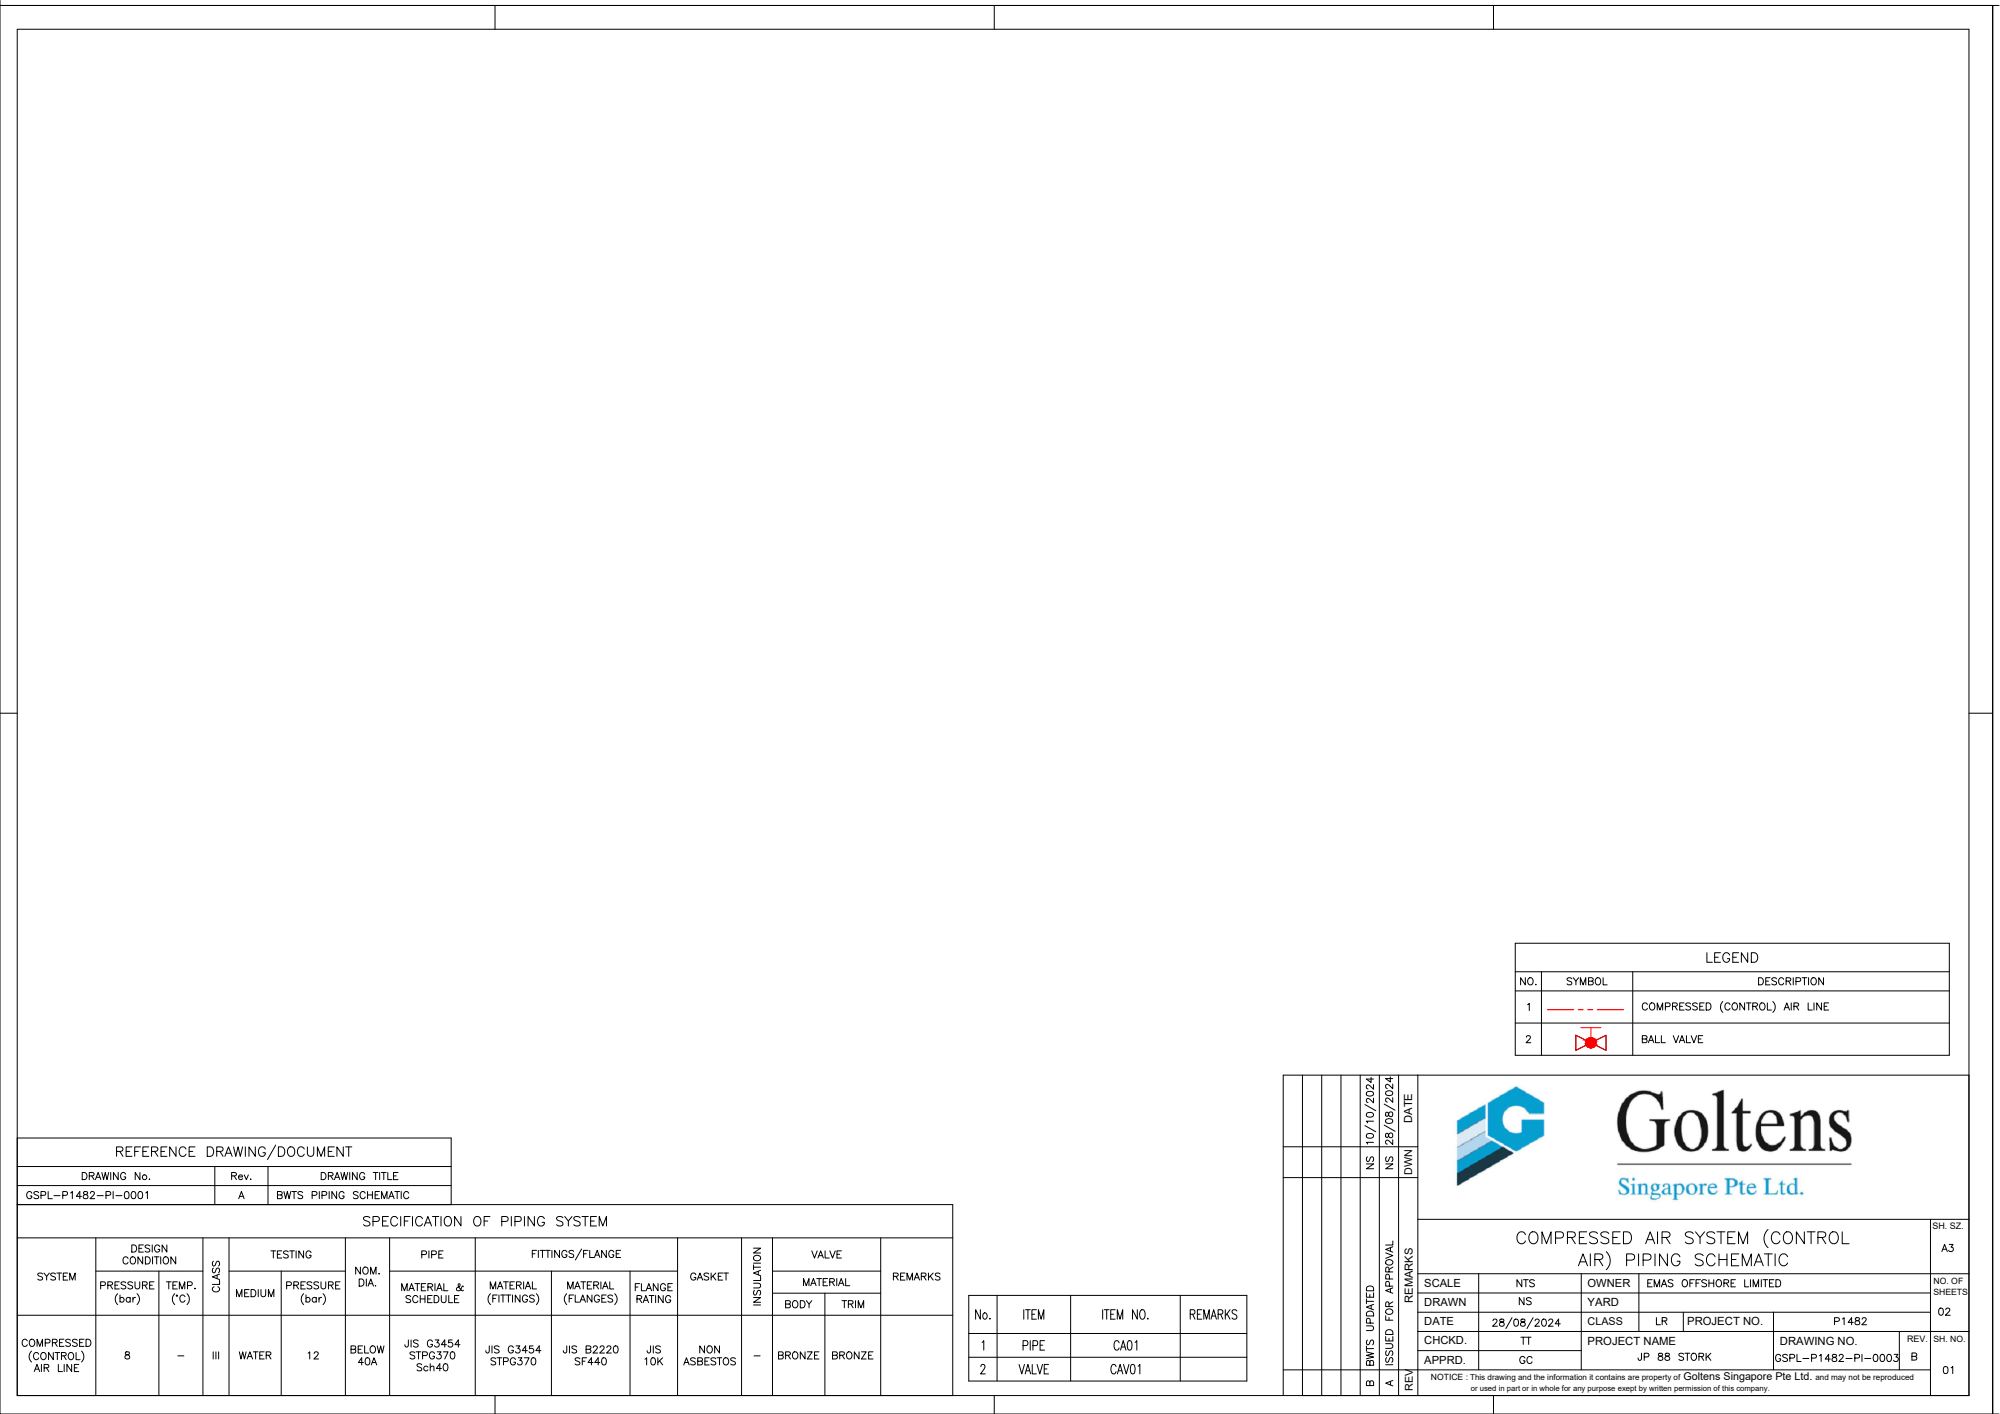
[picture p126: page 1]
CHCKD.; PROJECT NAME; DRAWING NO. or used in part or in whole for any purpose exept by written permission of this company. NOTICE : APPRD.

SH. SZ. REMARKS REV DWN DATE

DRAWN | YARD | PROJECT NO. | | NO. OF REV.
SCALE | OWNER | | | SHEETS

DATE | CLASS

Goltens Singapore Pte Ltd. and may not be reproduced This drawing and the information it contains are property of

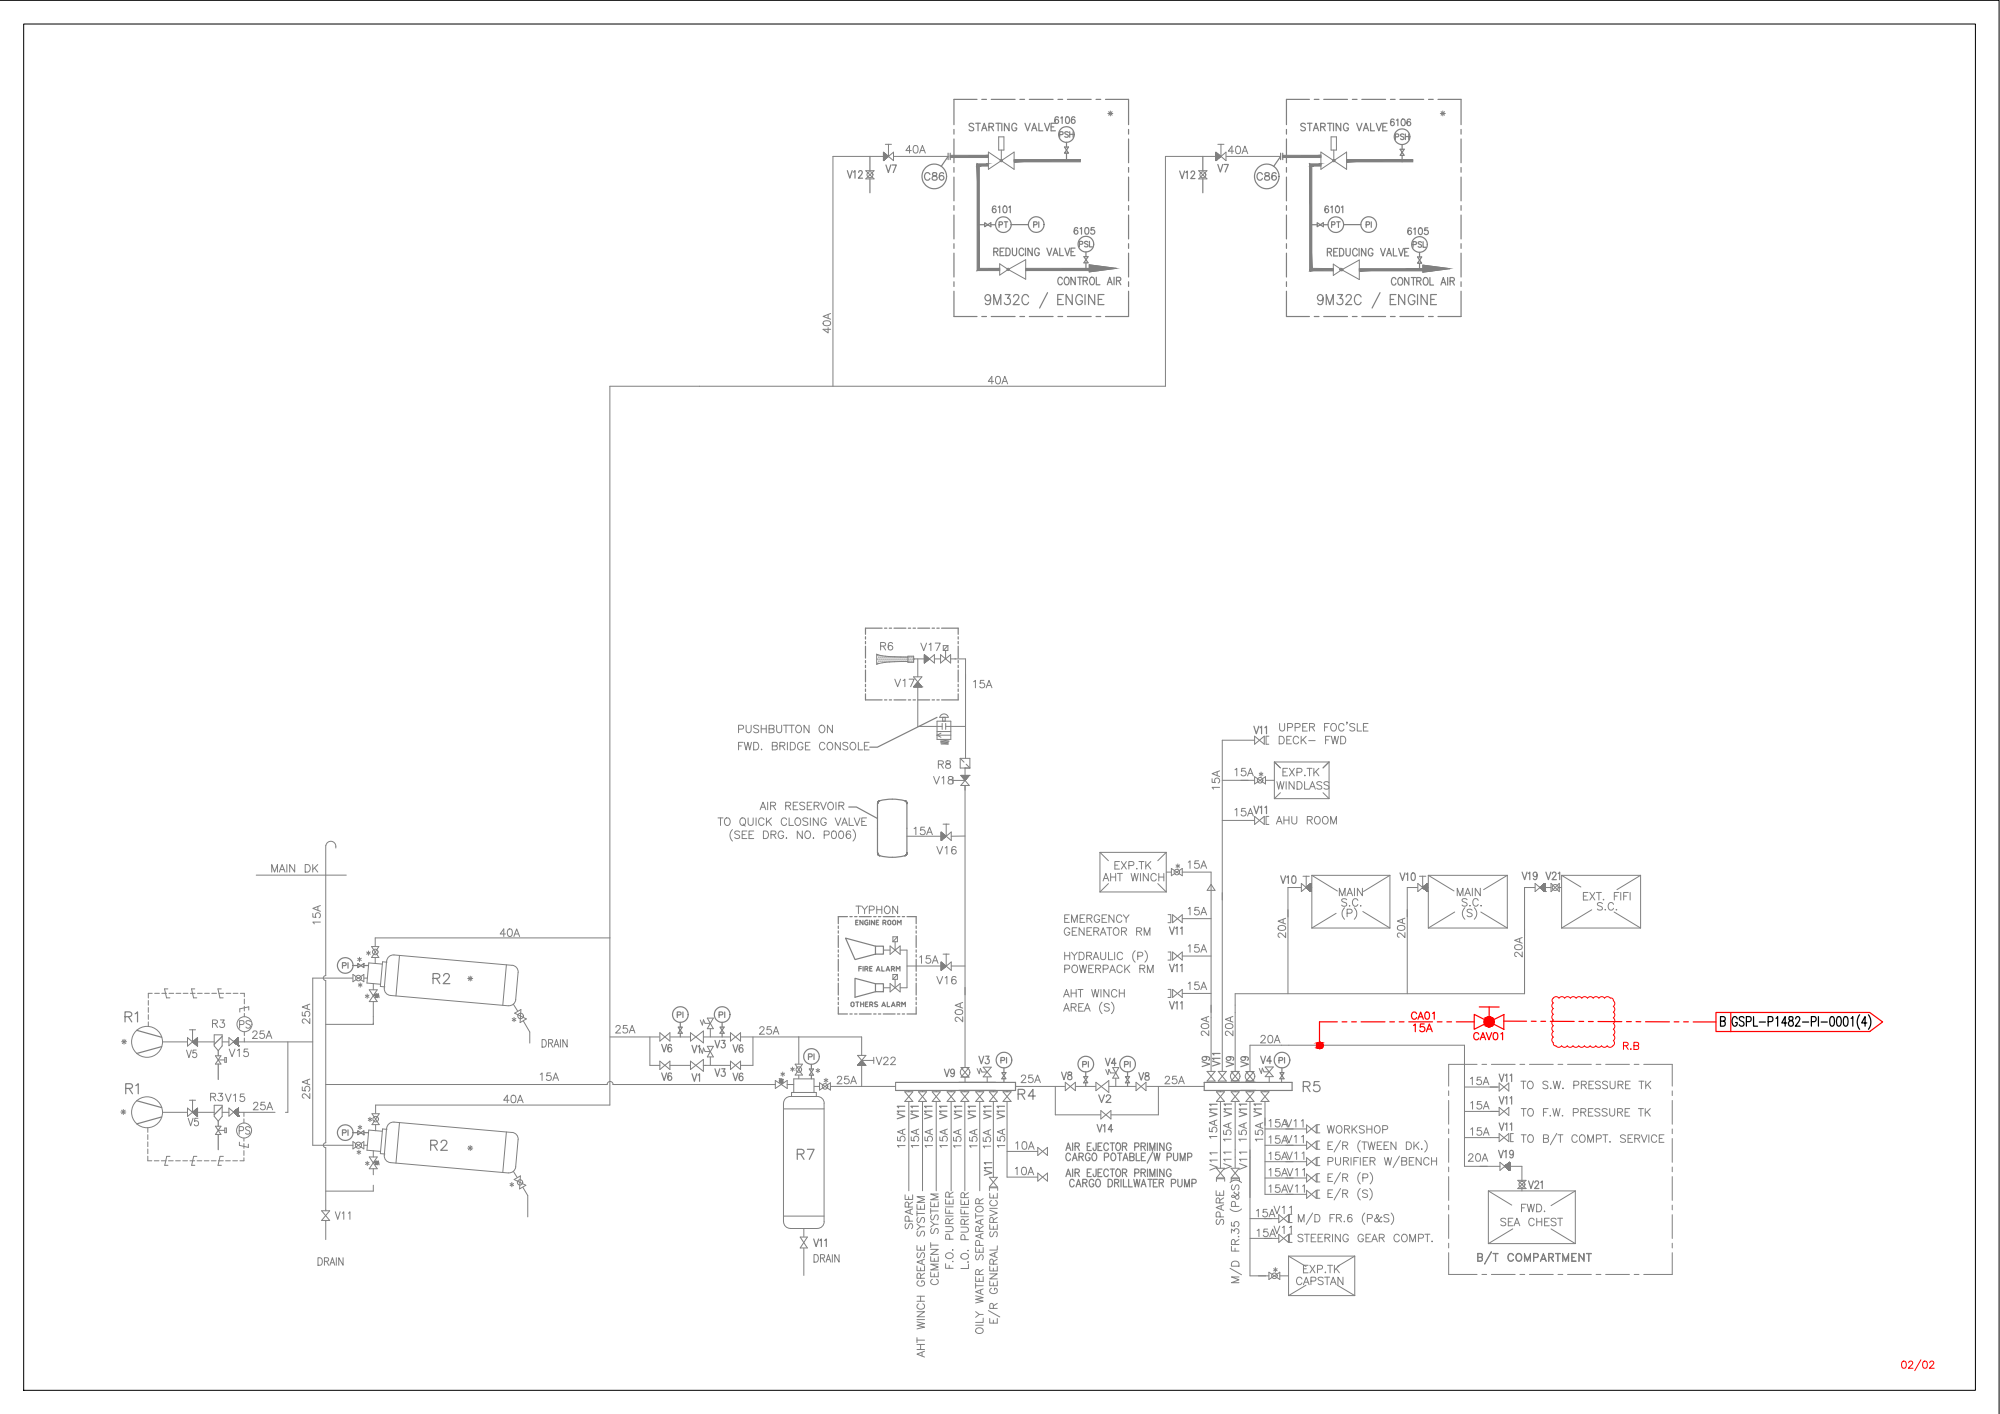
[picture p127: page 2]
