anurakj/J88_stork/Bypass_valves_logic_box/Bypass_valves_box_schematics_rev-B.pdf

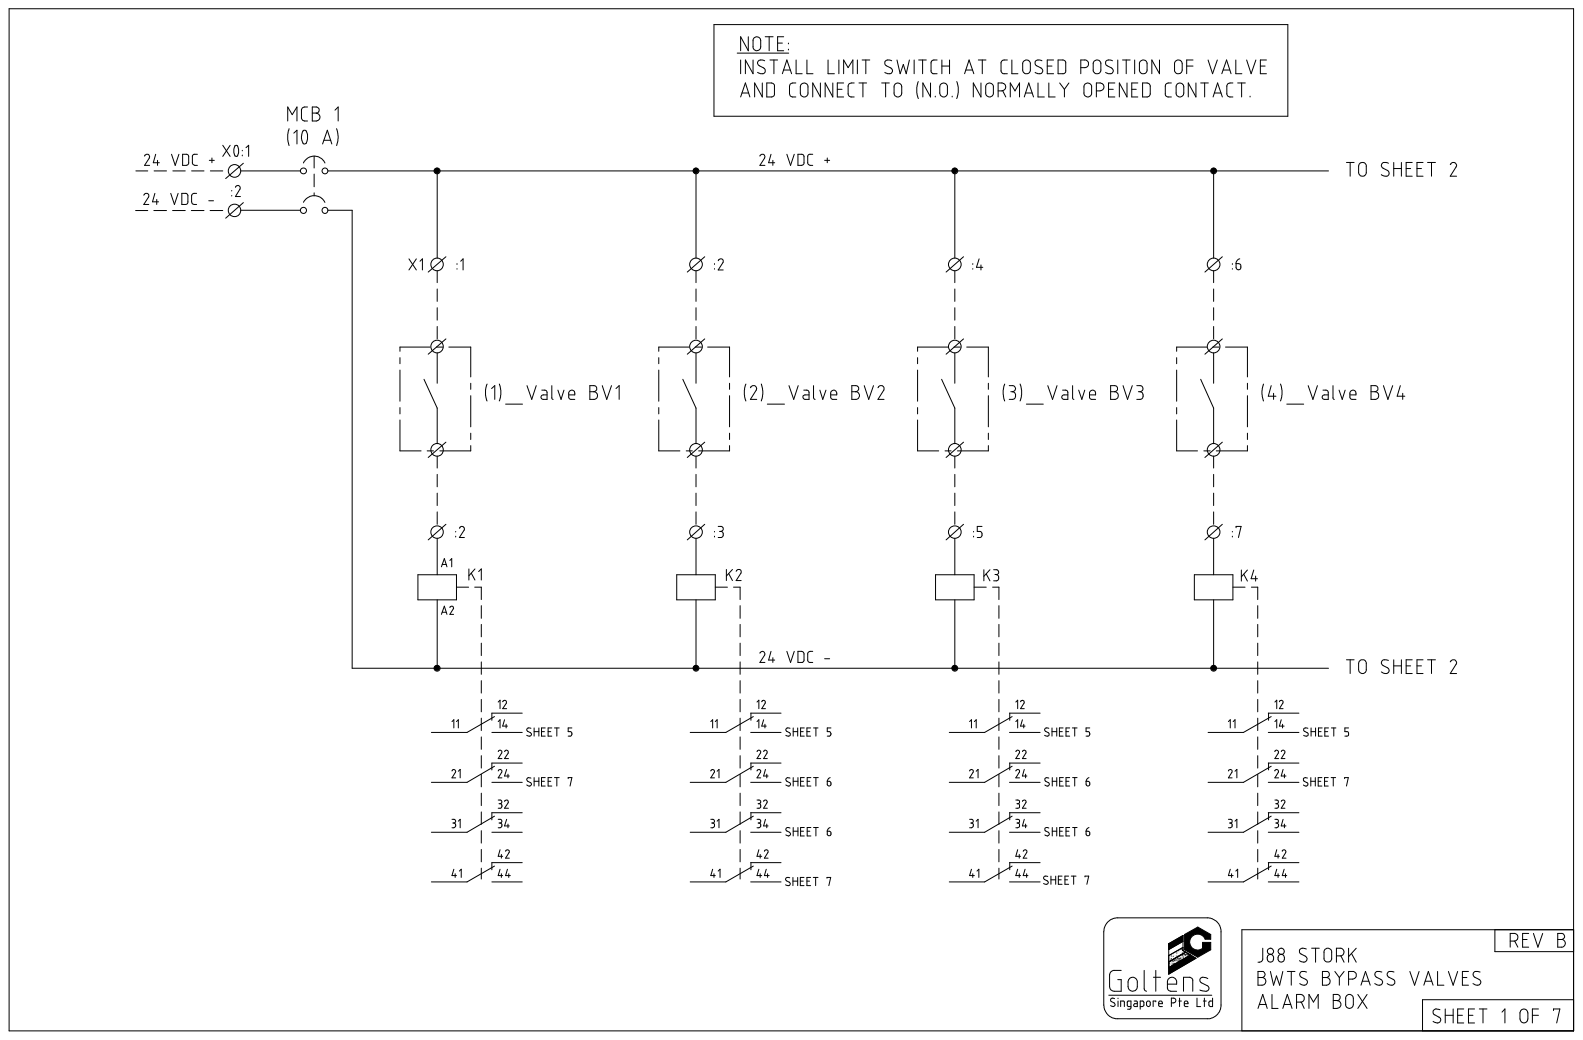
[picture p128: page 1]

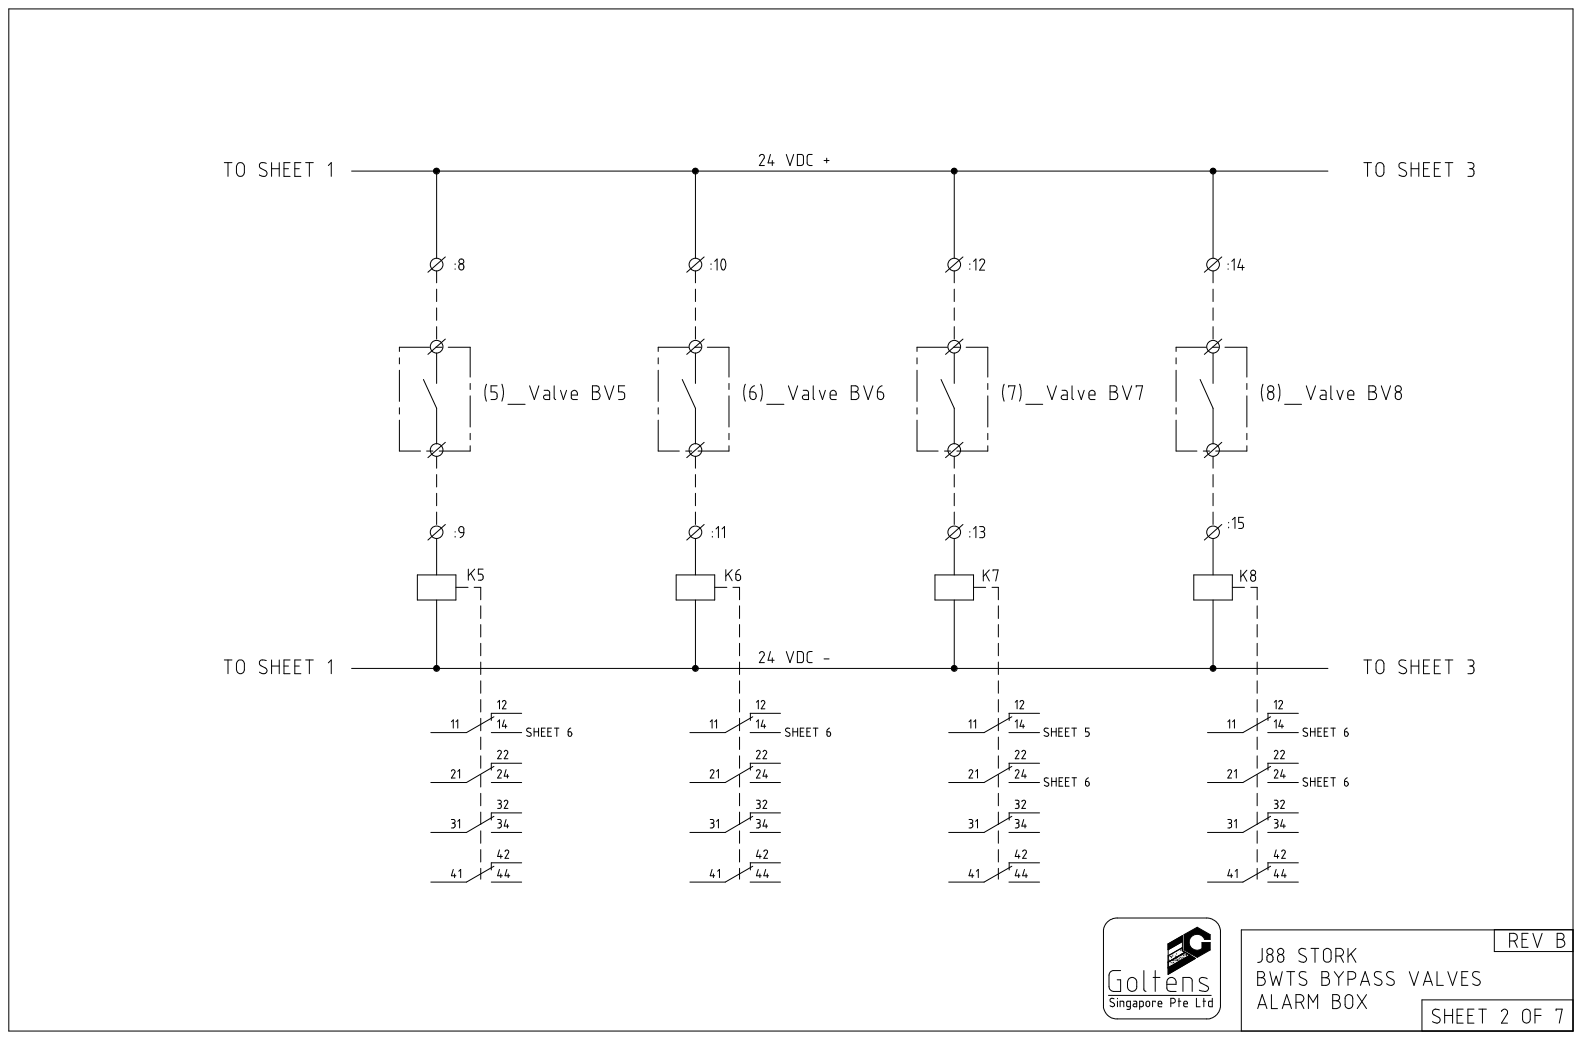
[picture p129: page 2]

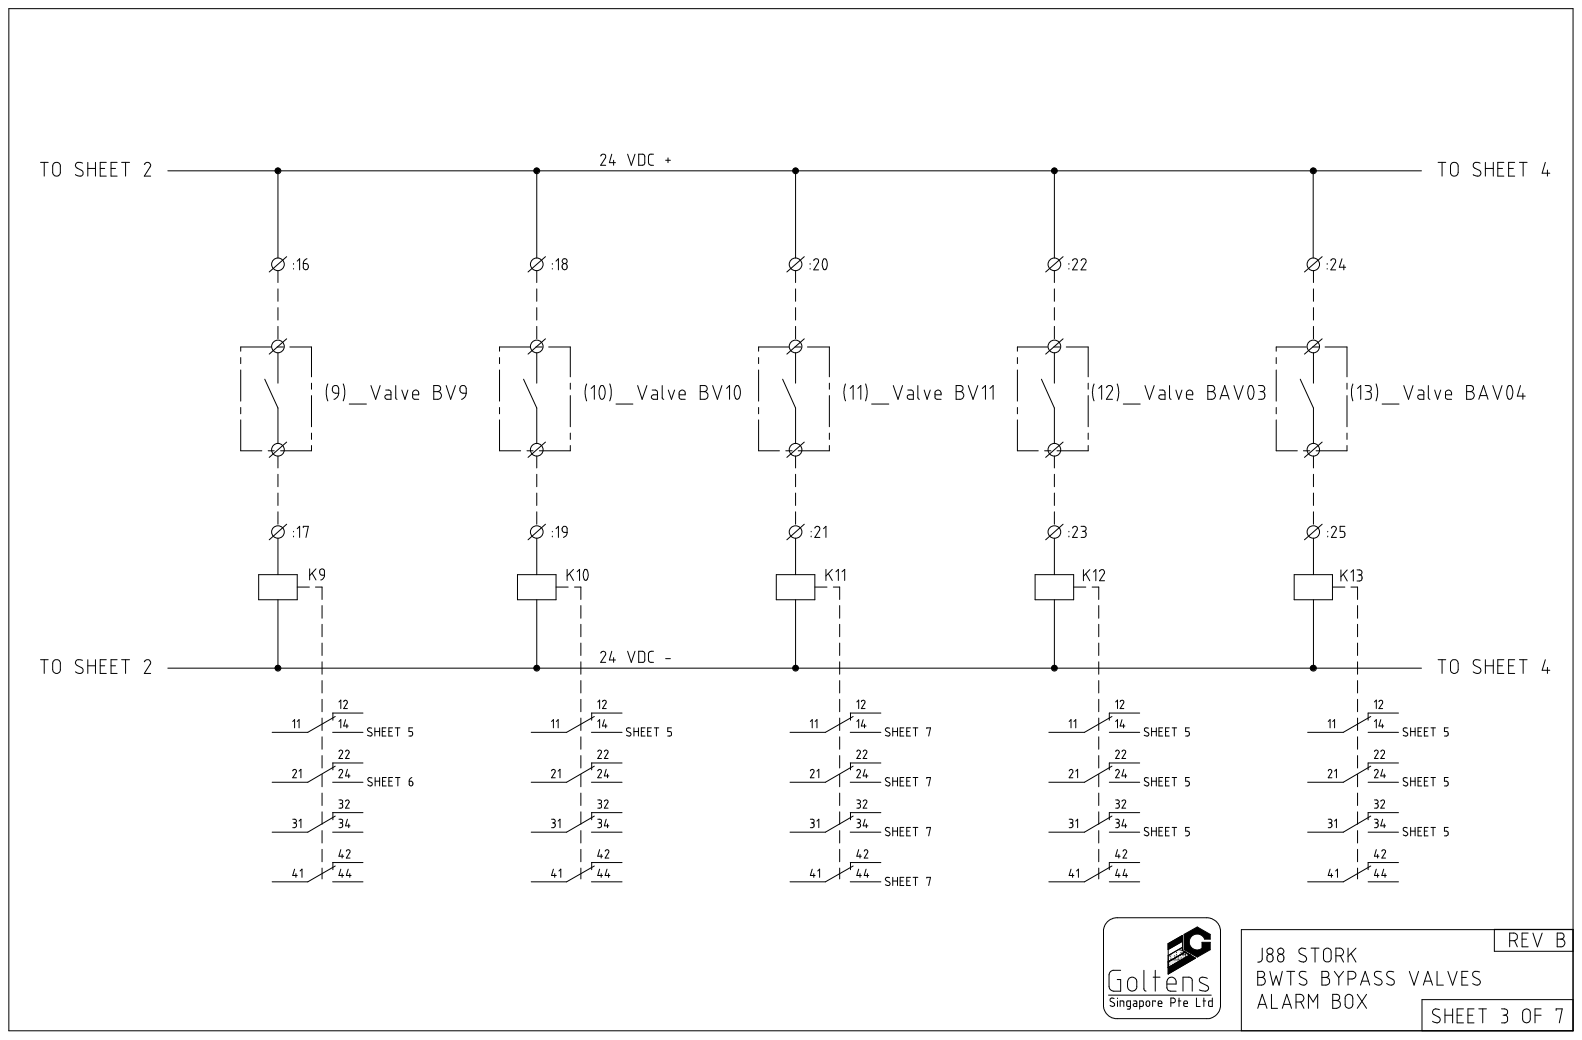
[picture p130: page 3]

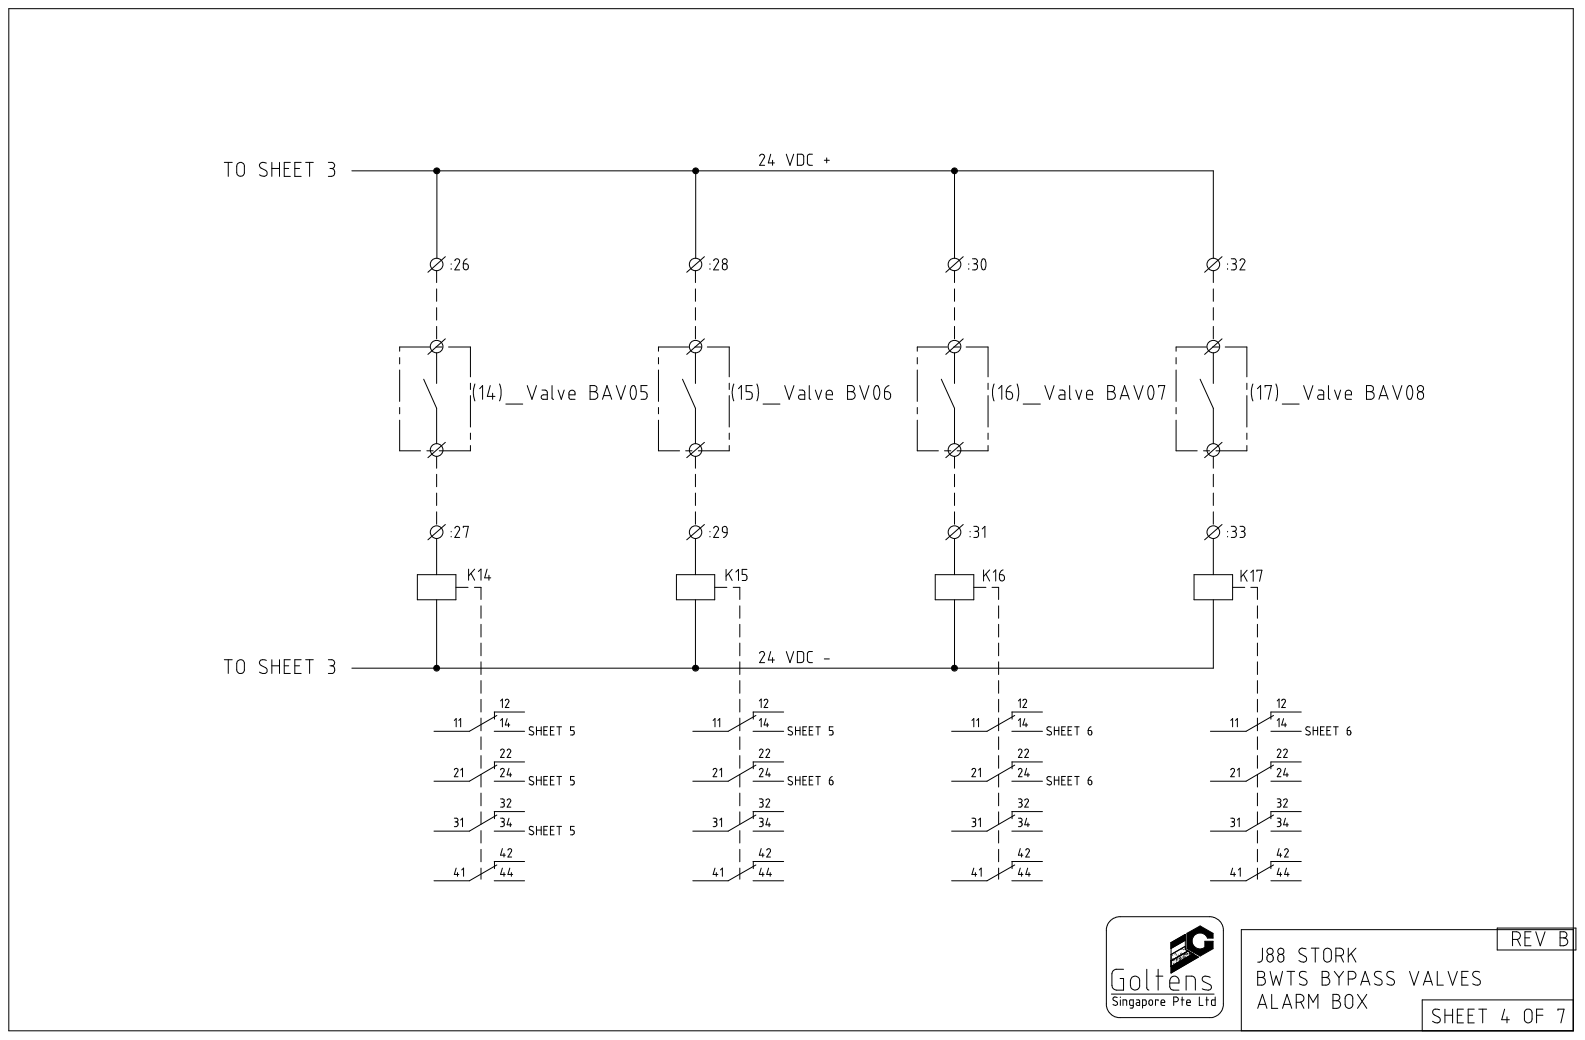
[picture p131: page 4]

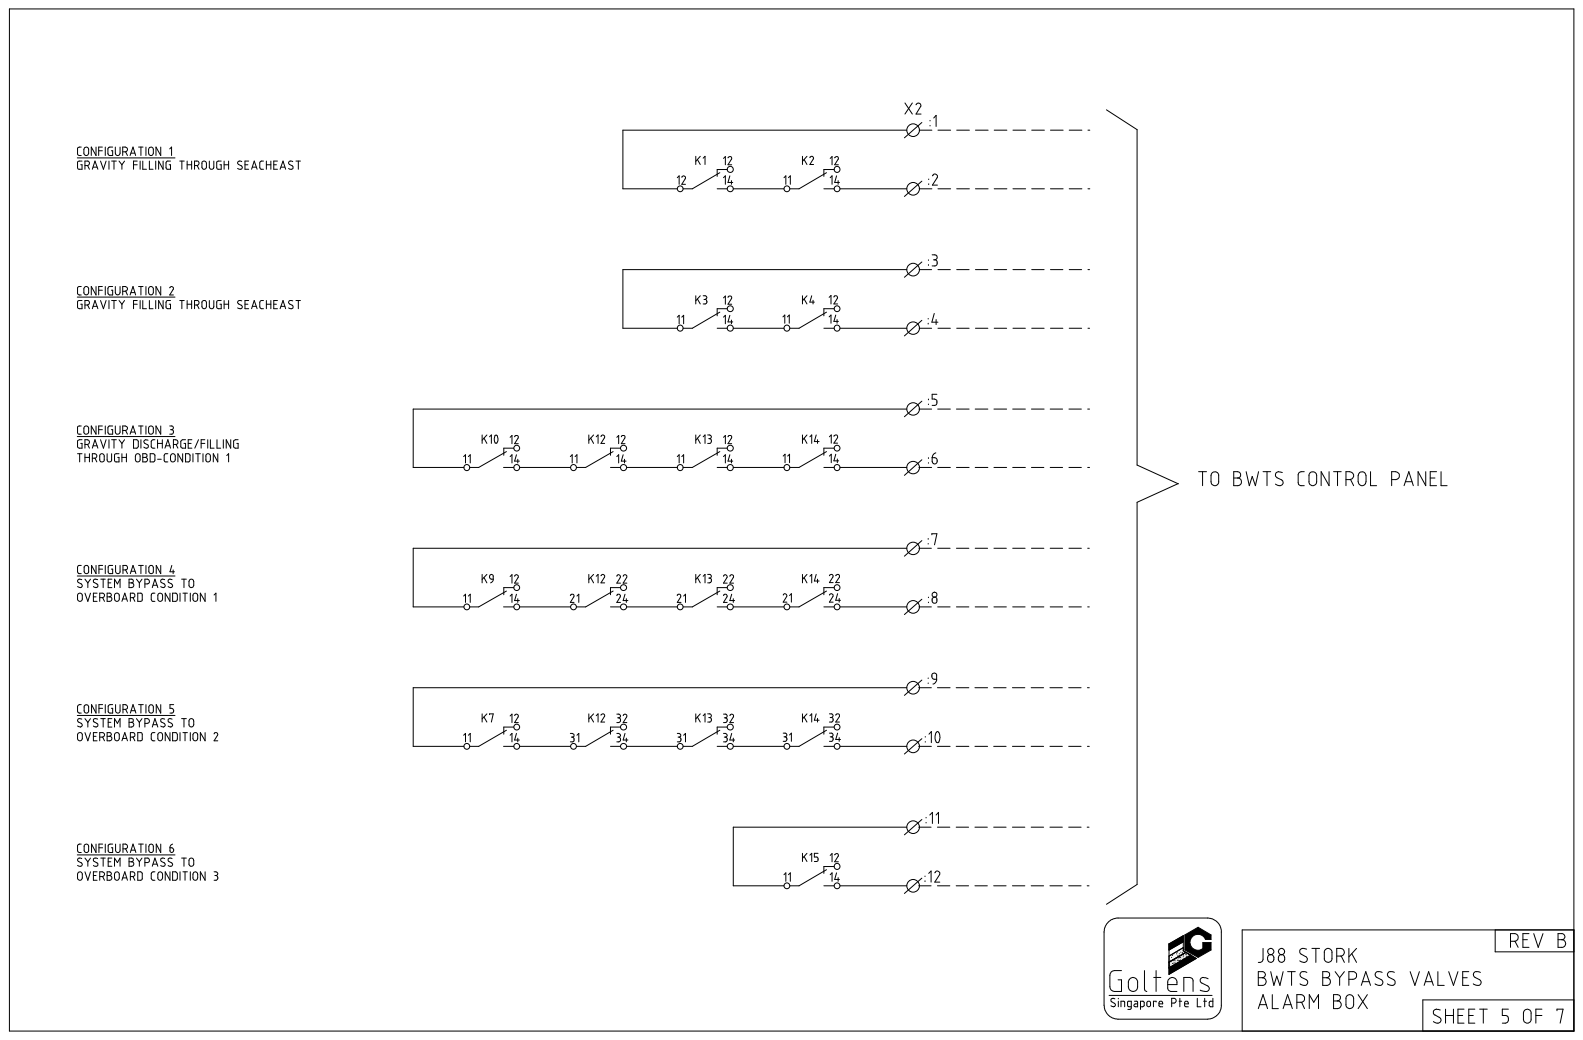
[picture p132: page 5]

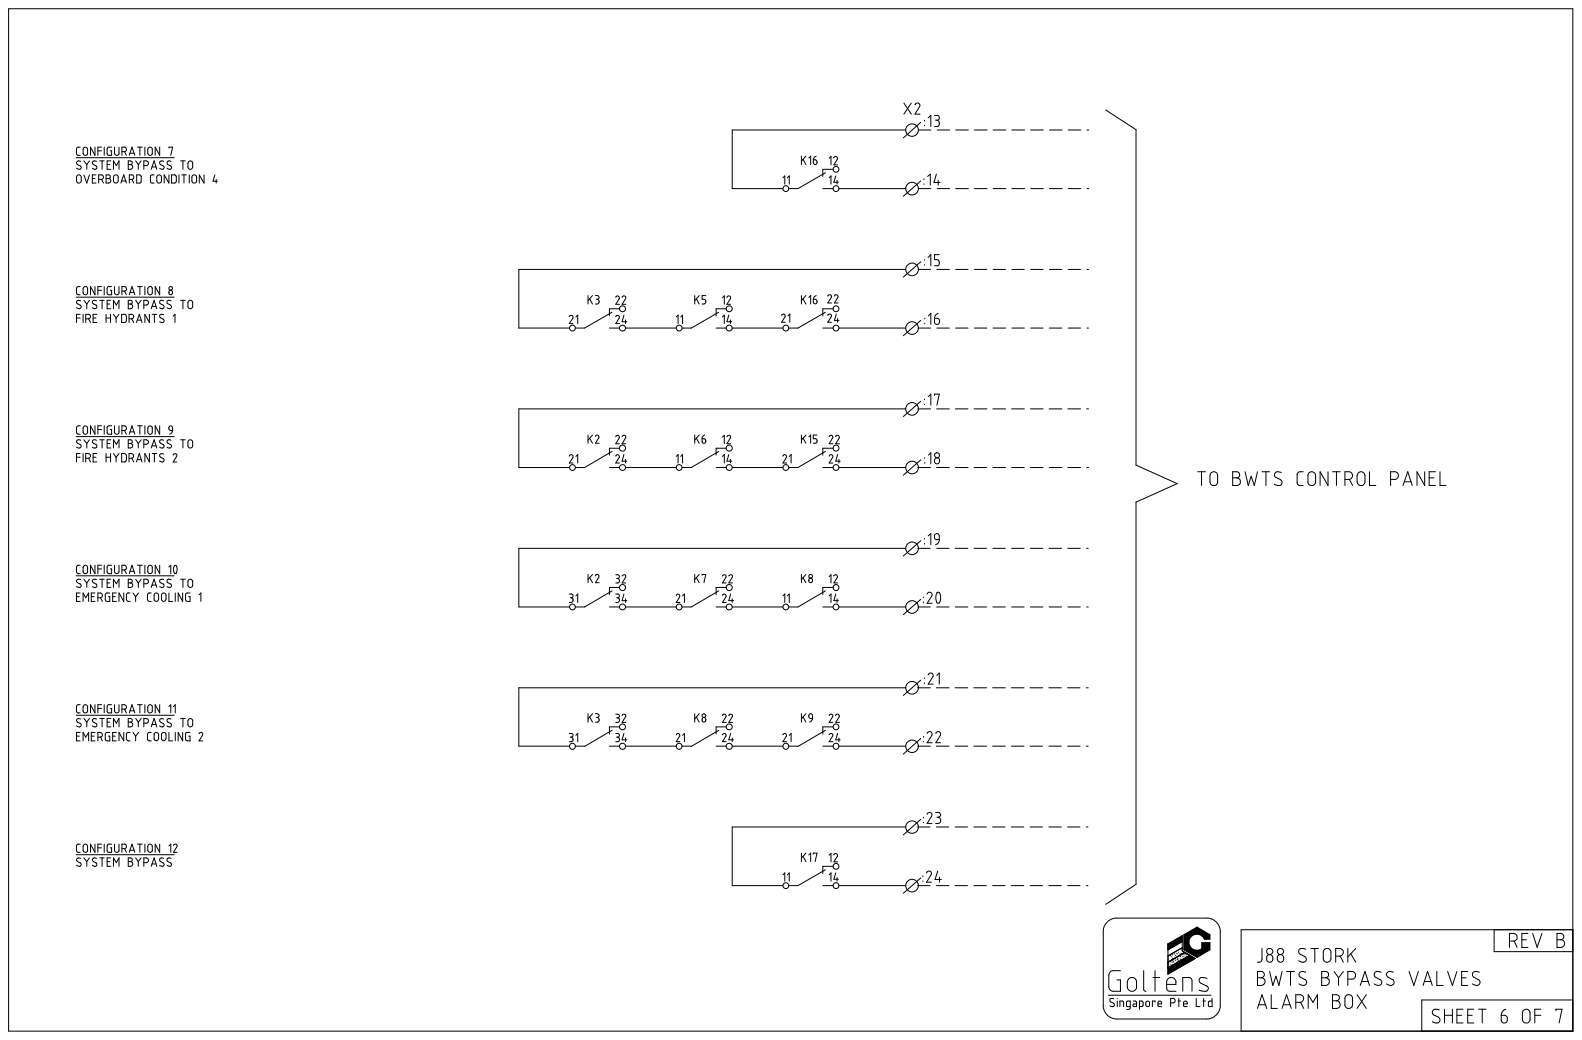
[picture p133: page 6]

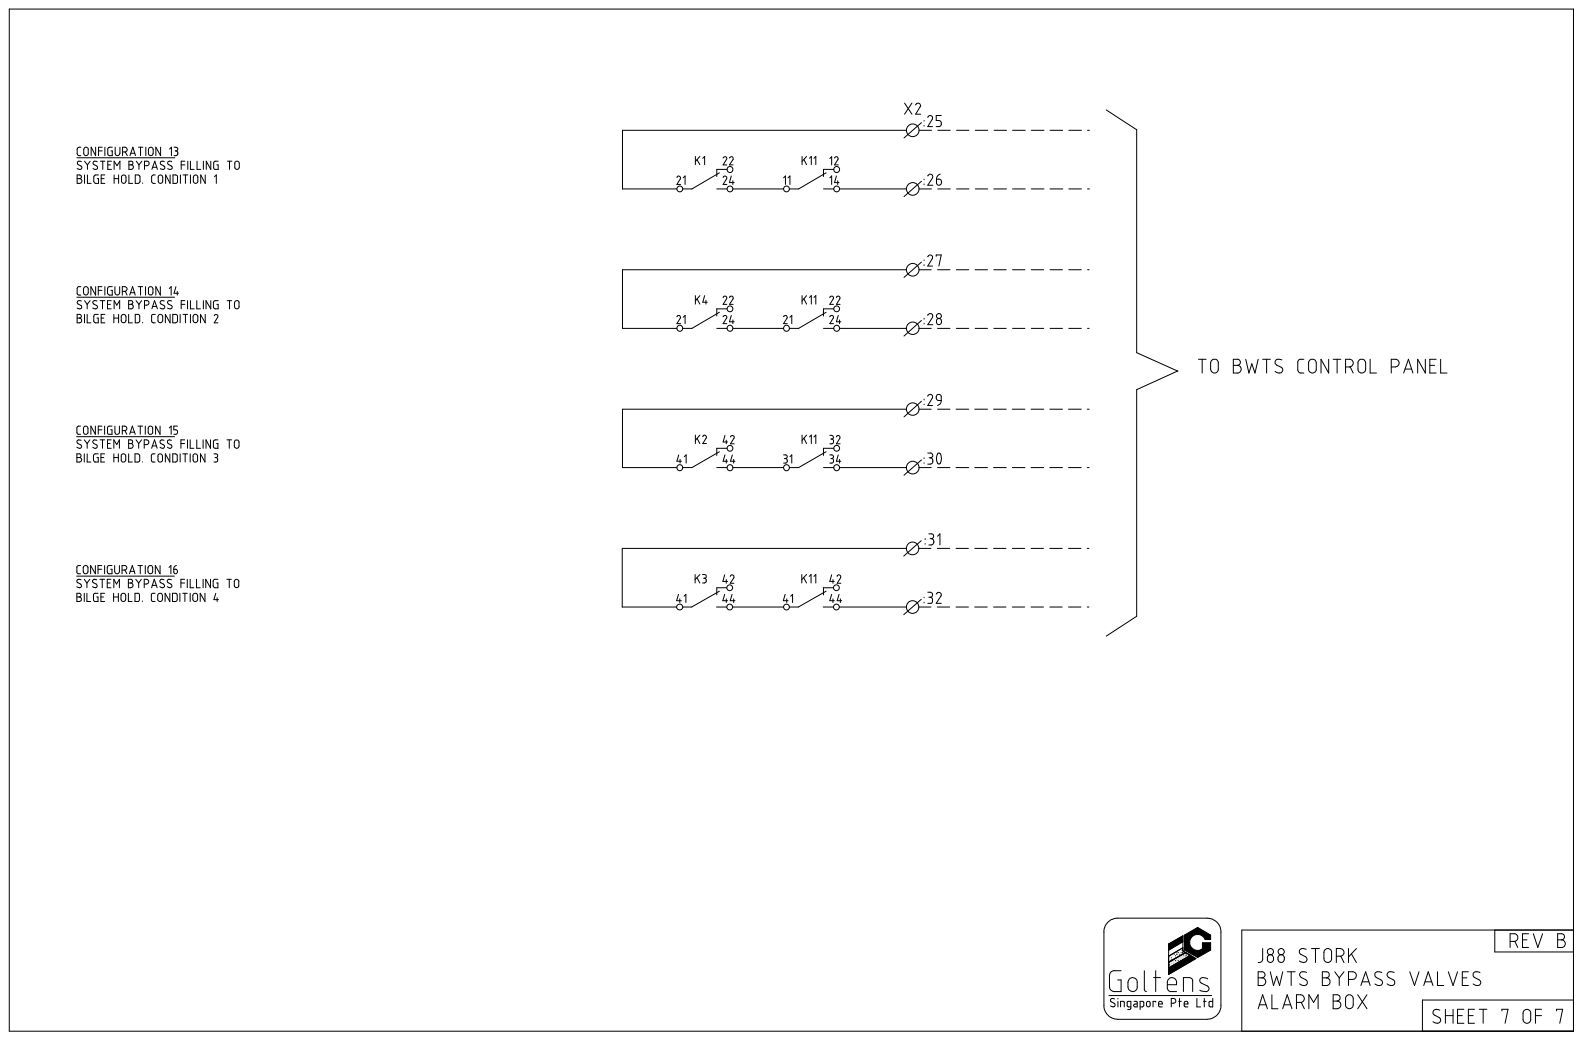
[picture p134: page 7]
