anurakj/J88_stork/GSPL-P1482-EL-0001 Electrical Load Analysis R.A.pdf

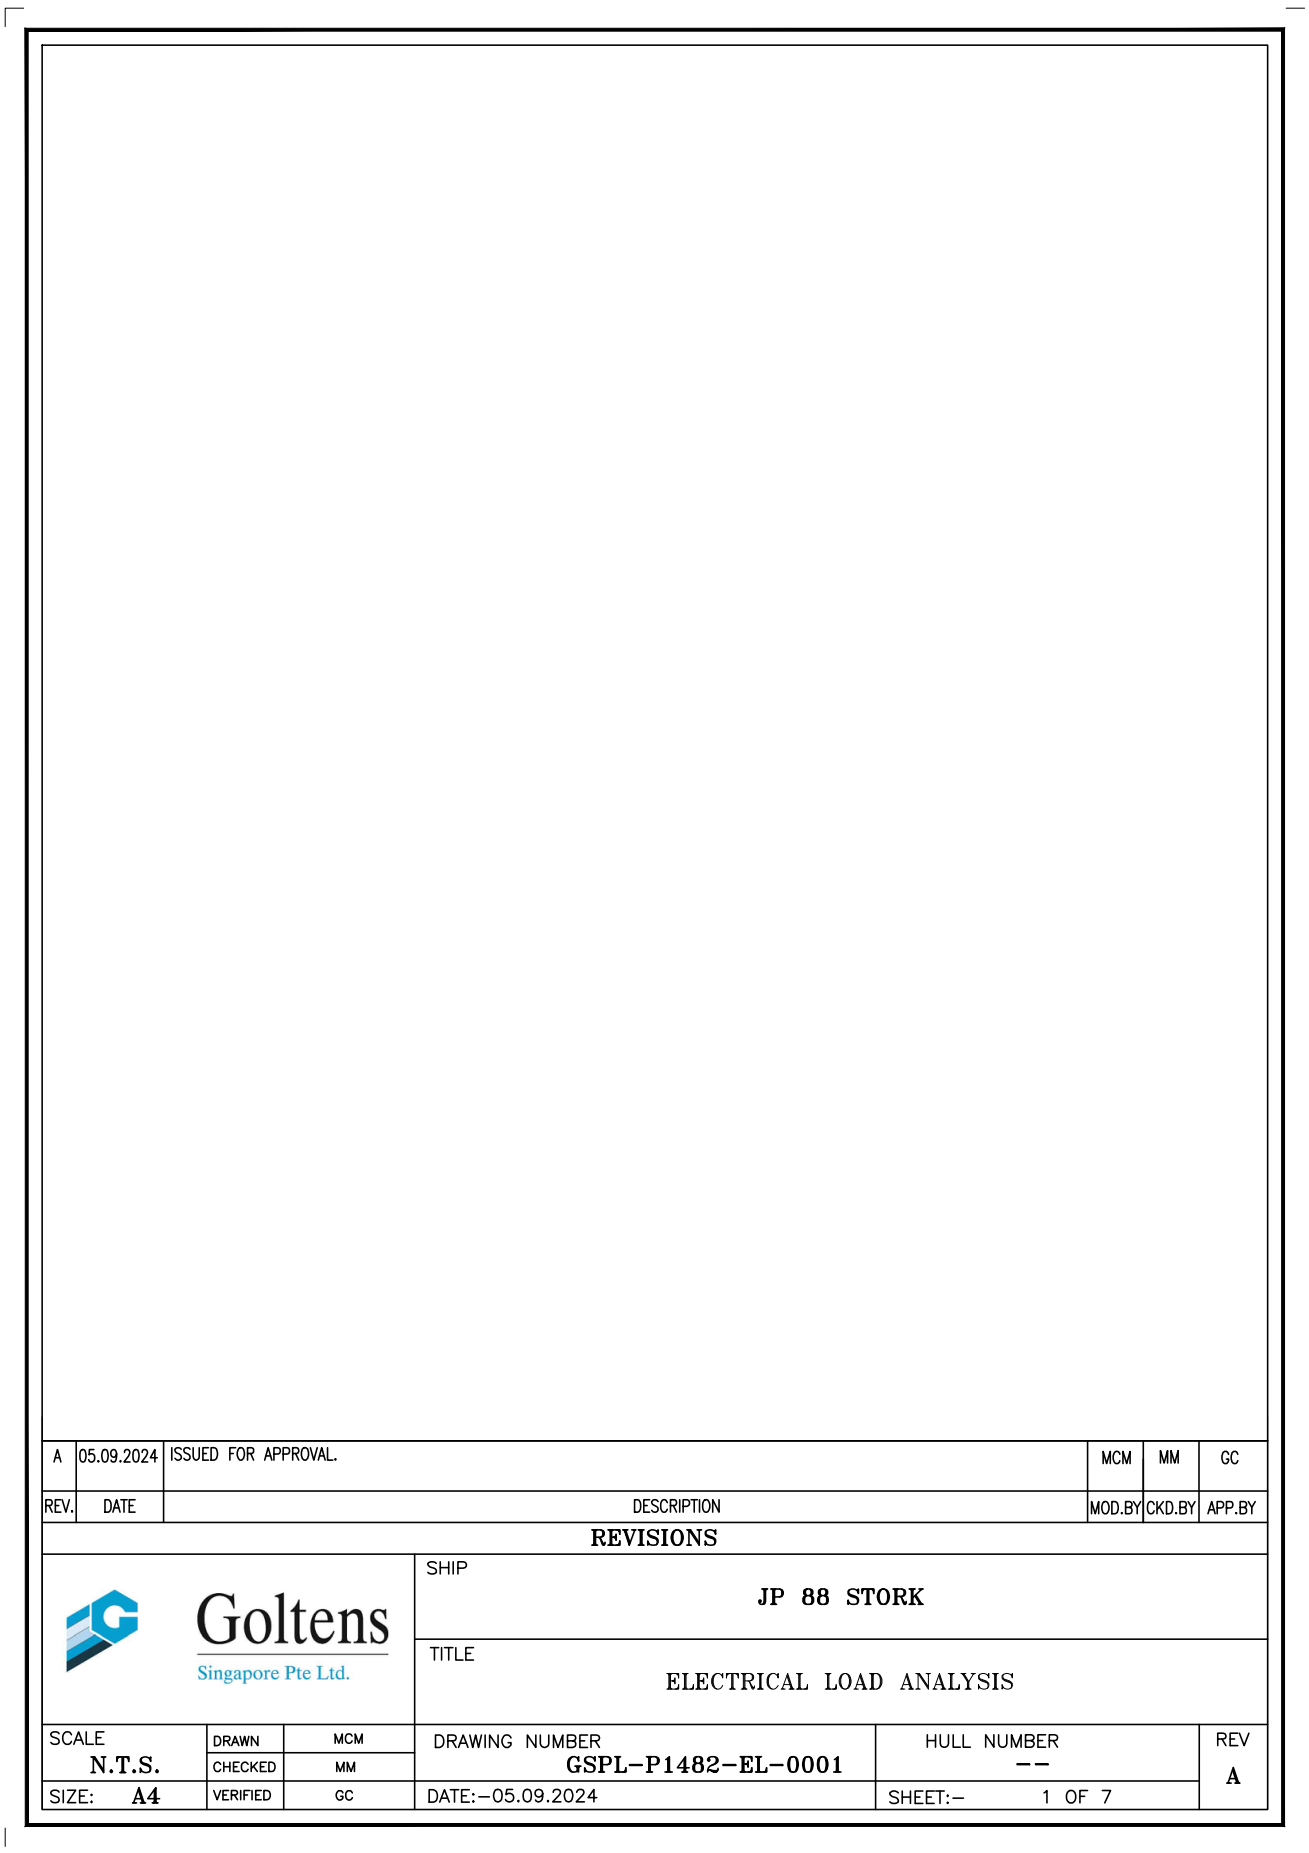
[picture p135: page 1]

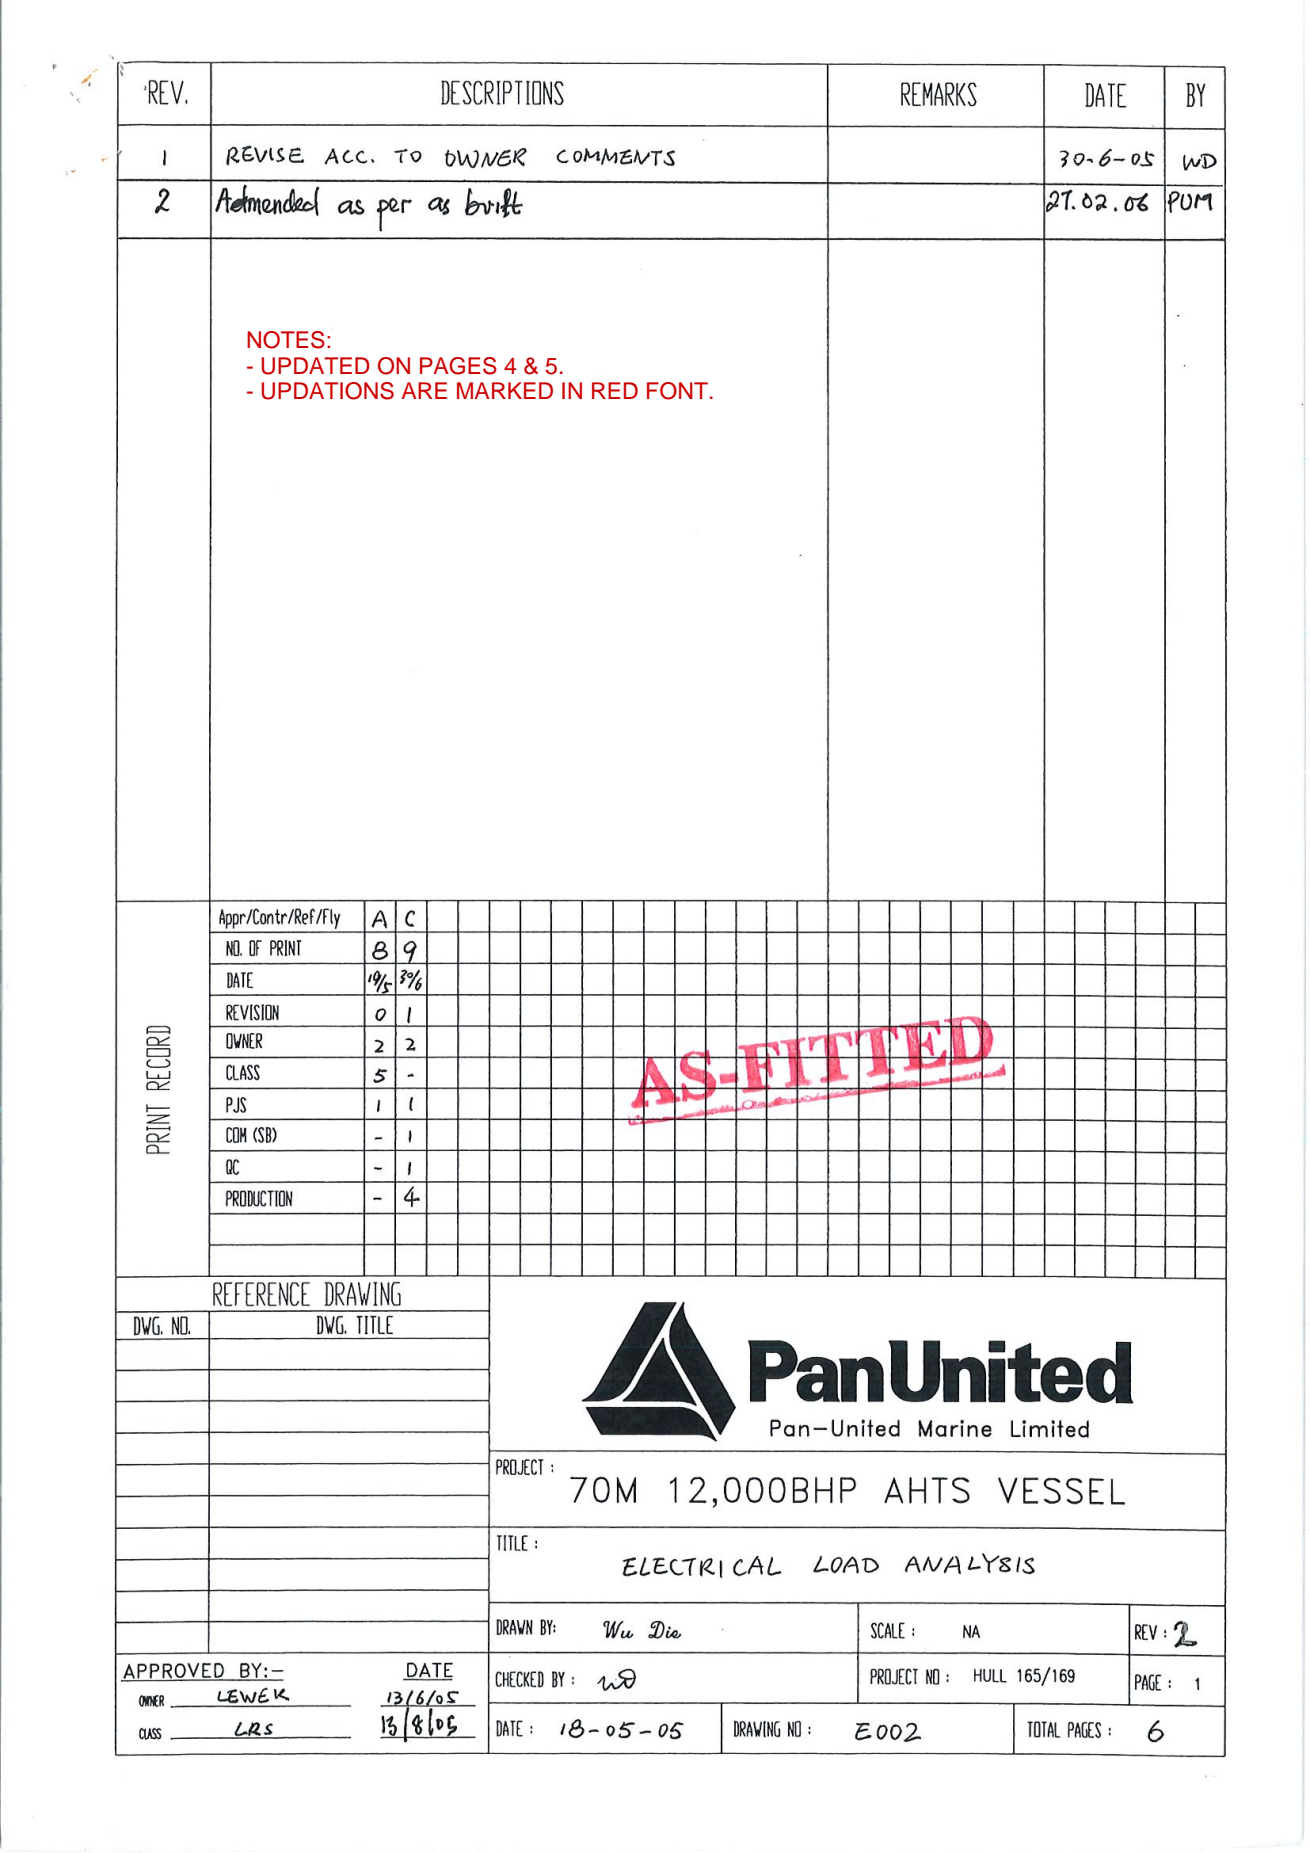
[picture p136: page 2]

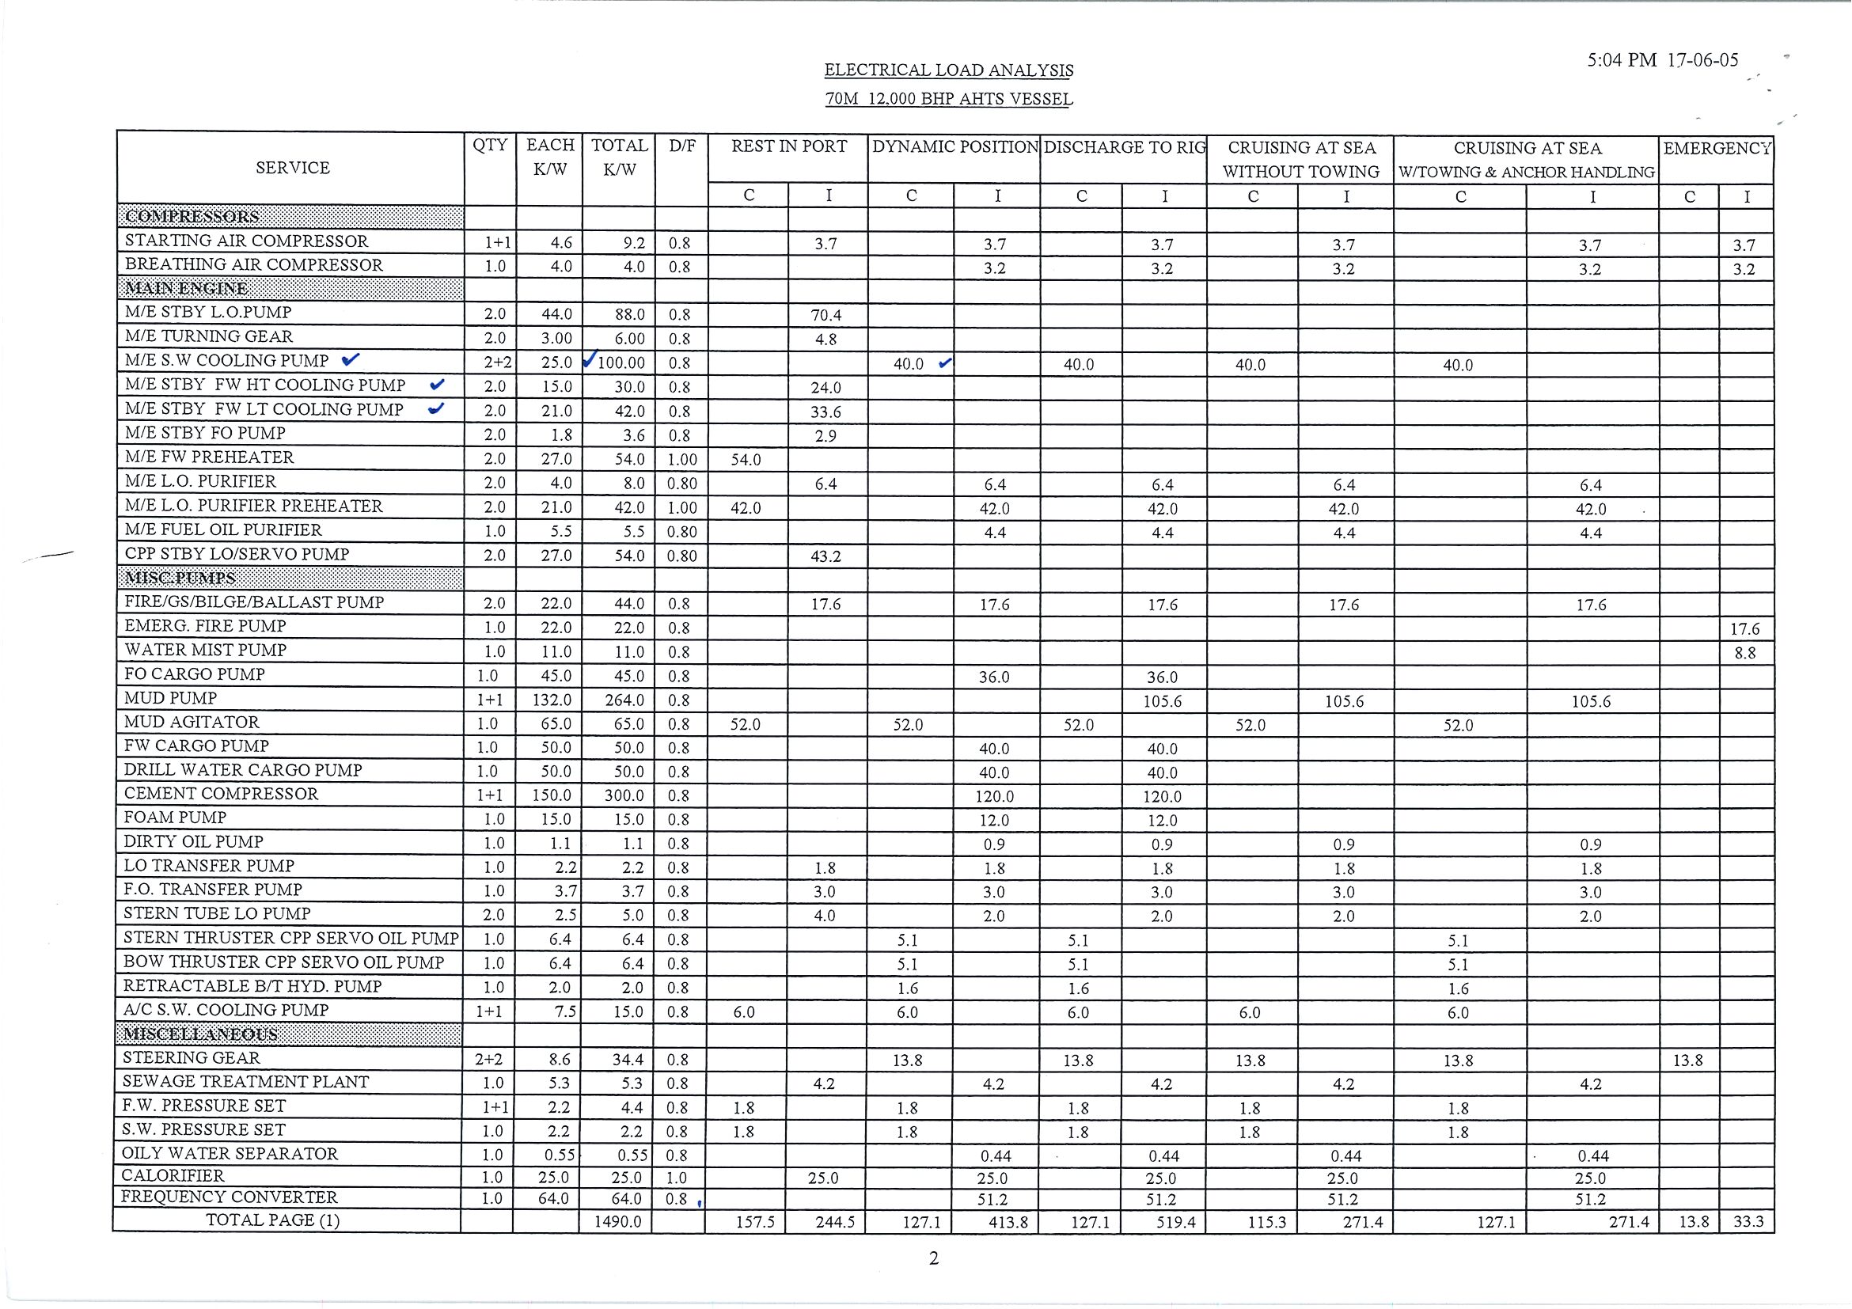
[picture p137: page 3]

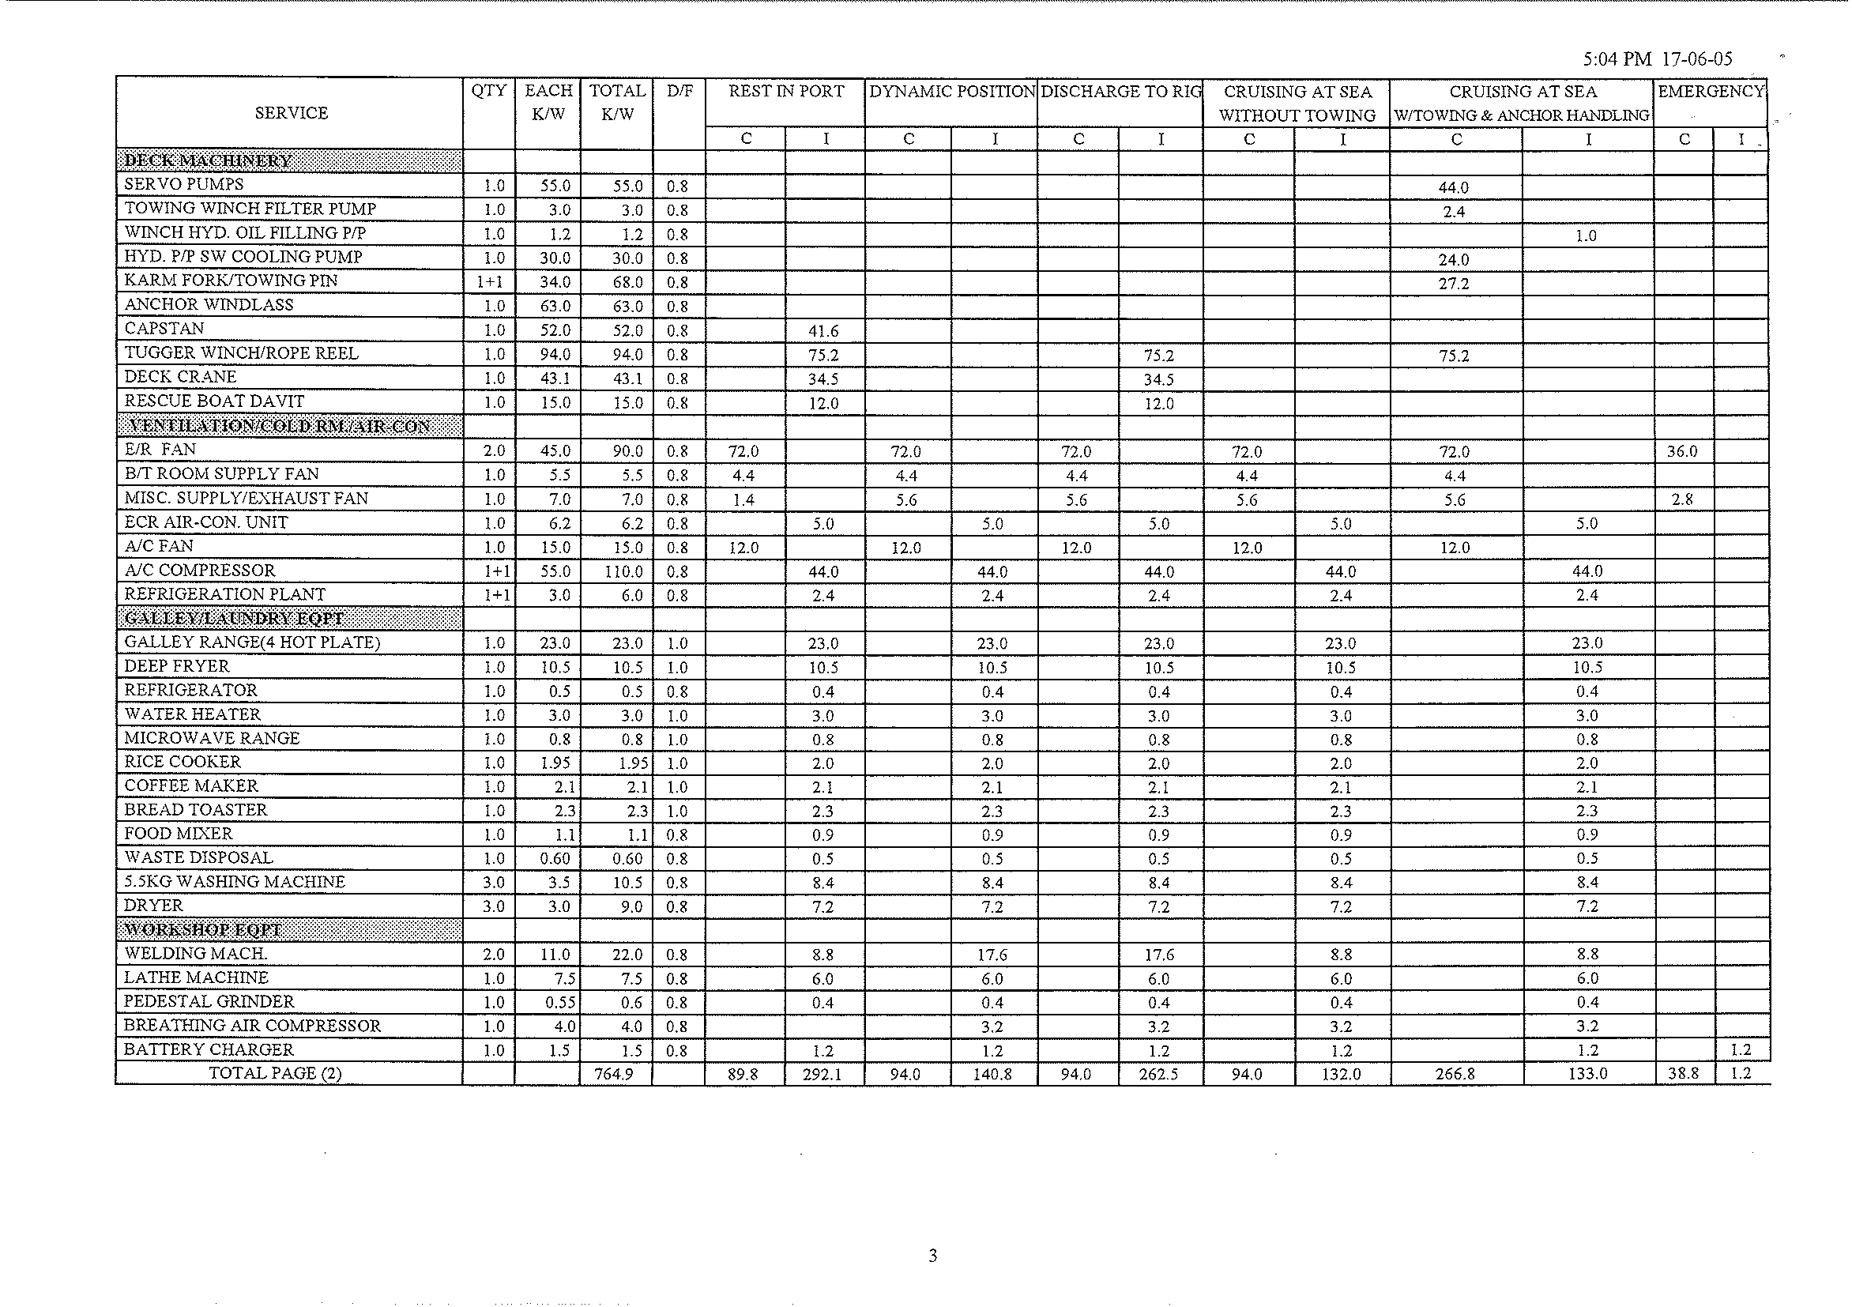
[picture p138: page 4]

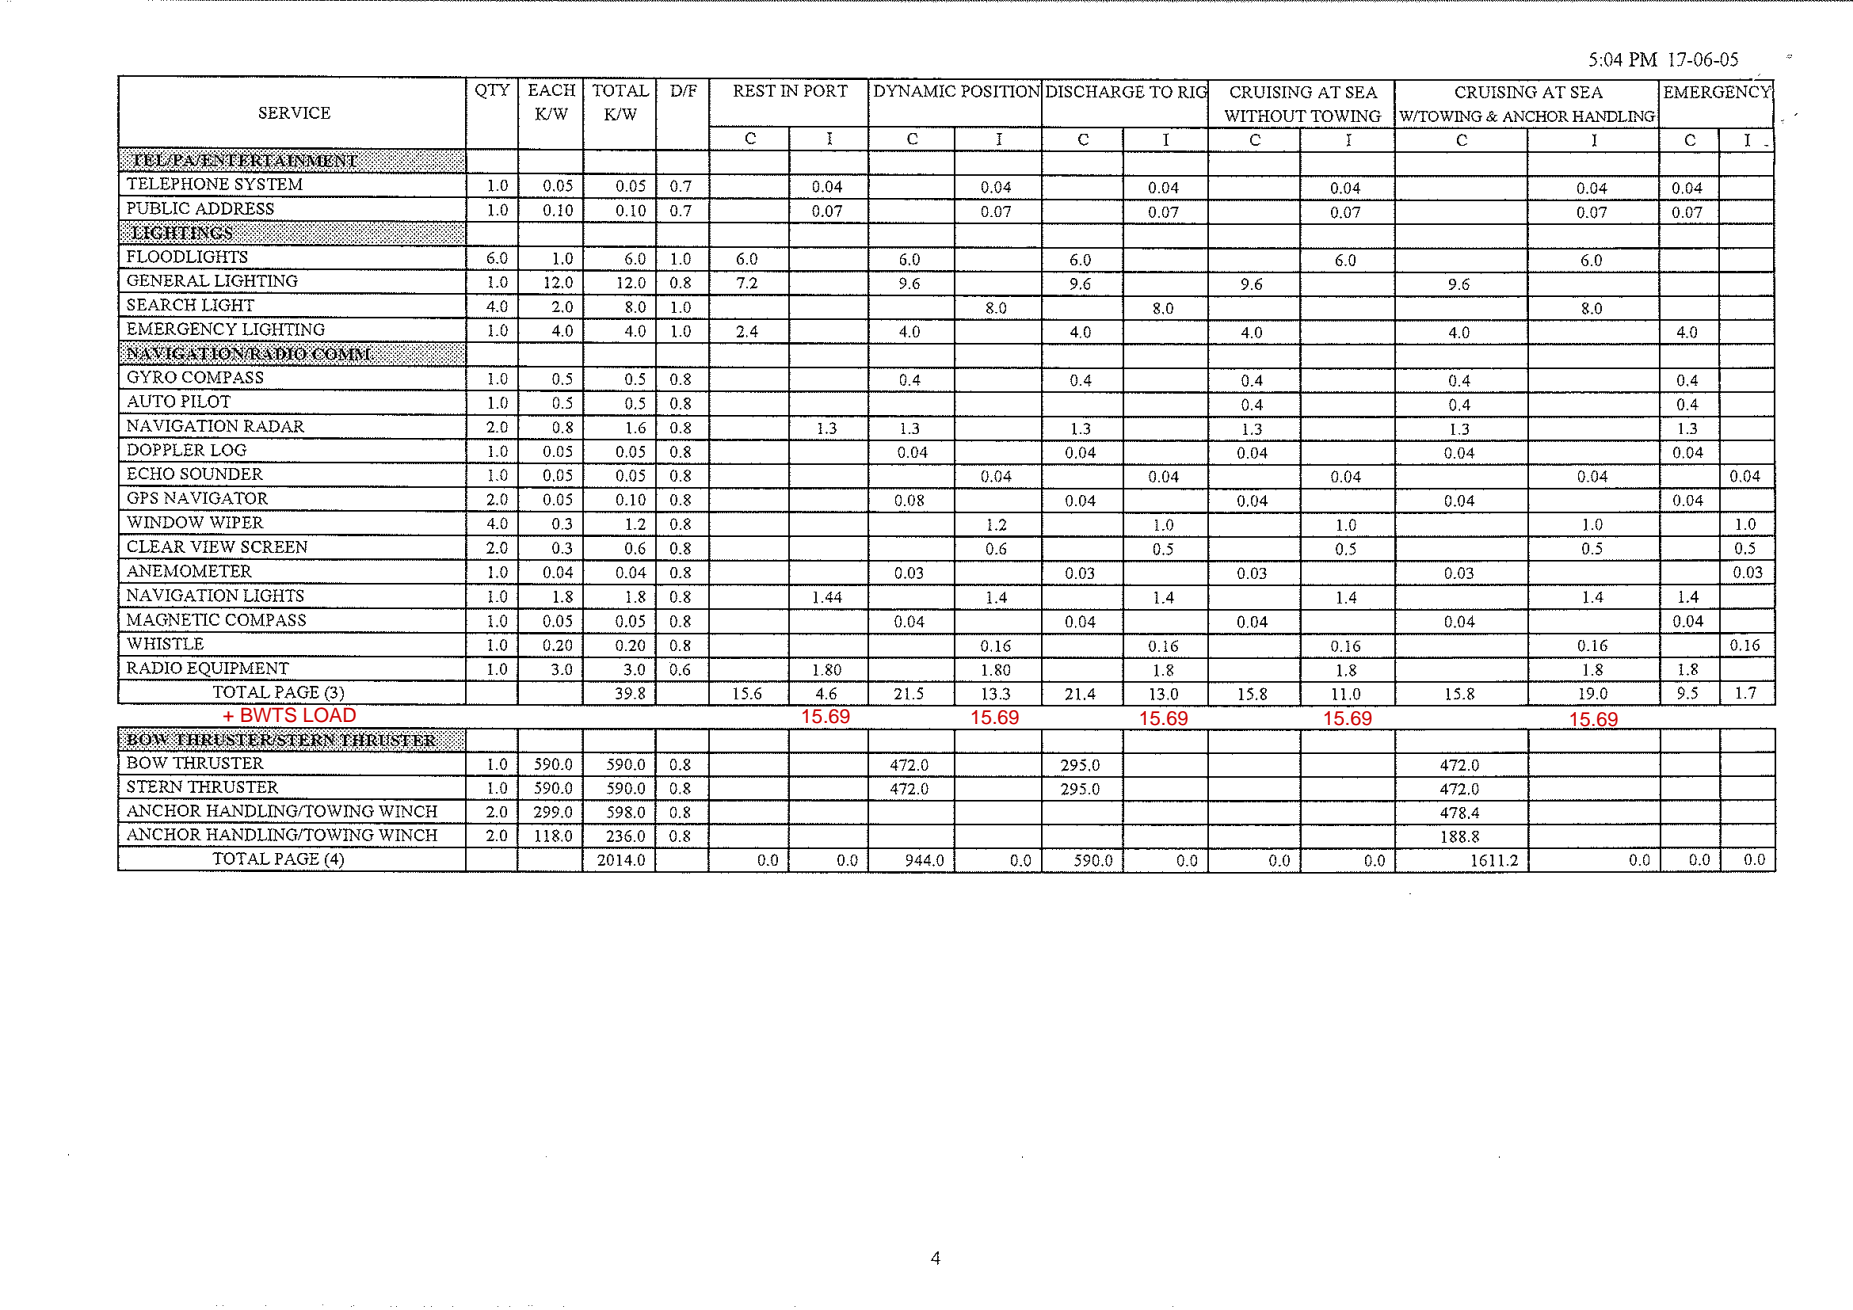
[picture p139: page 5]

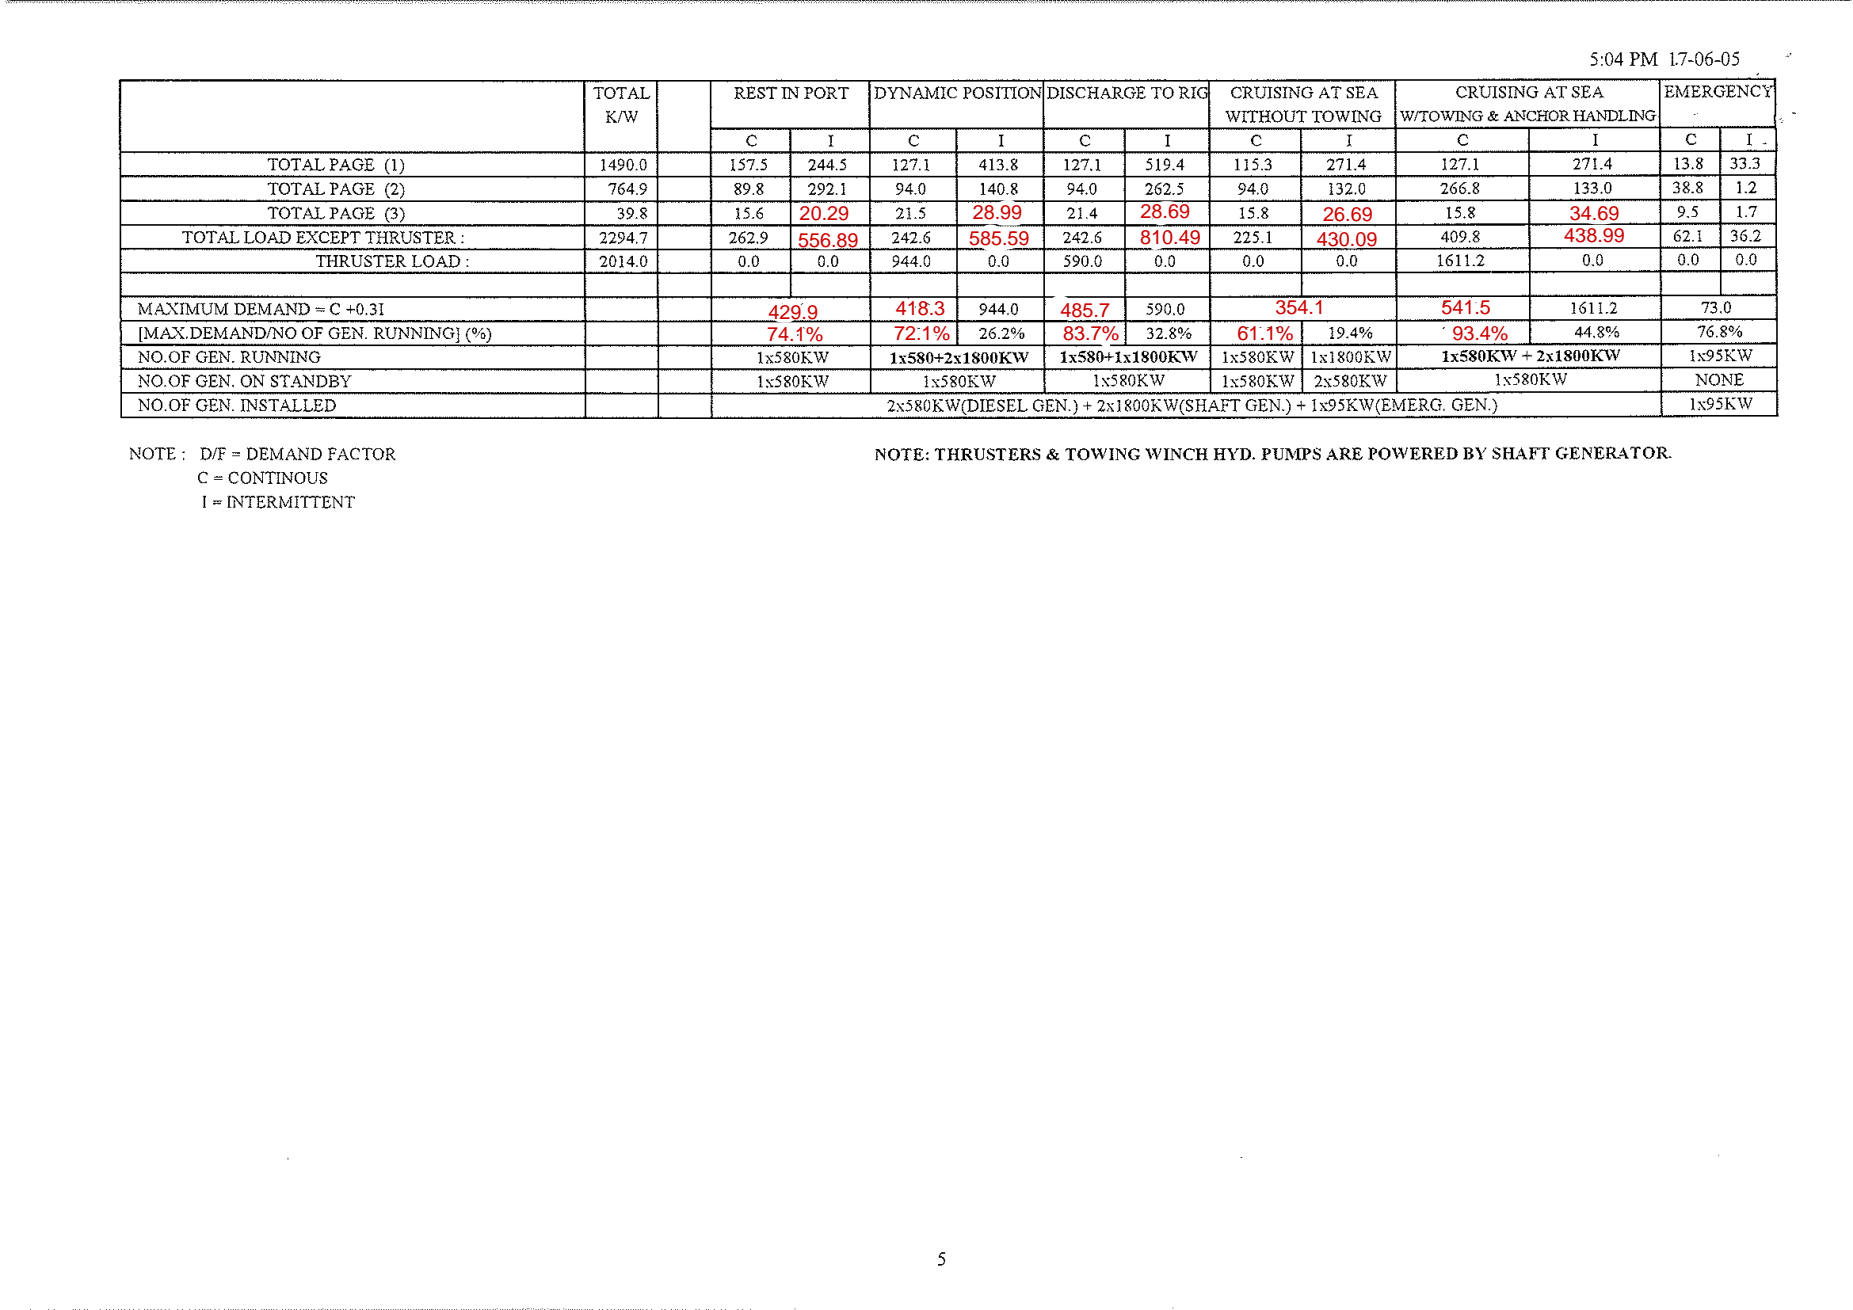
[picture p140: page 6]

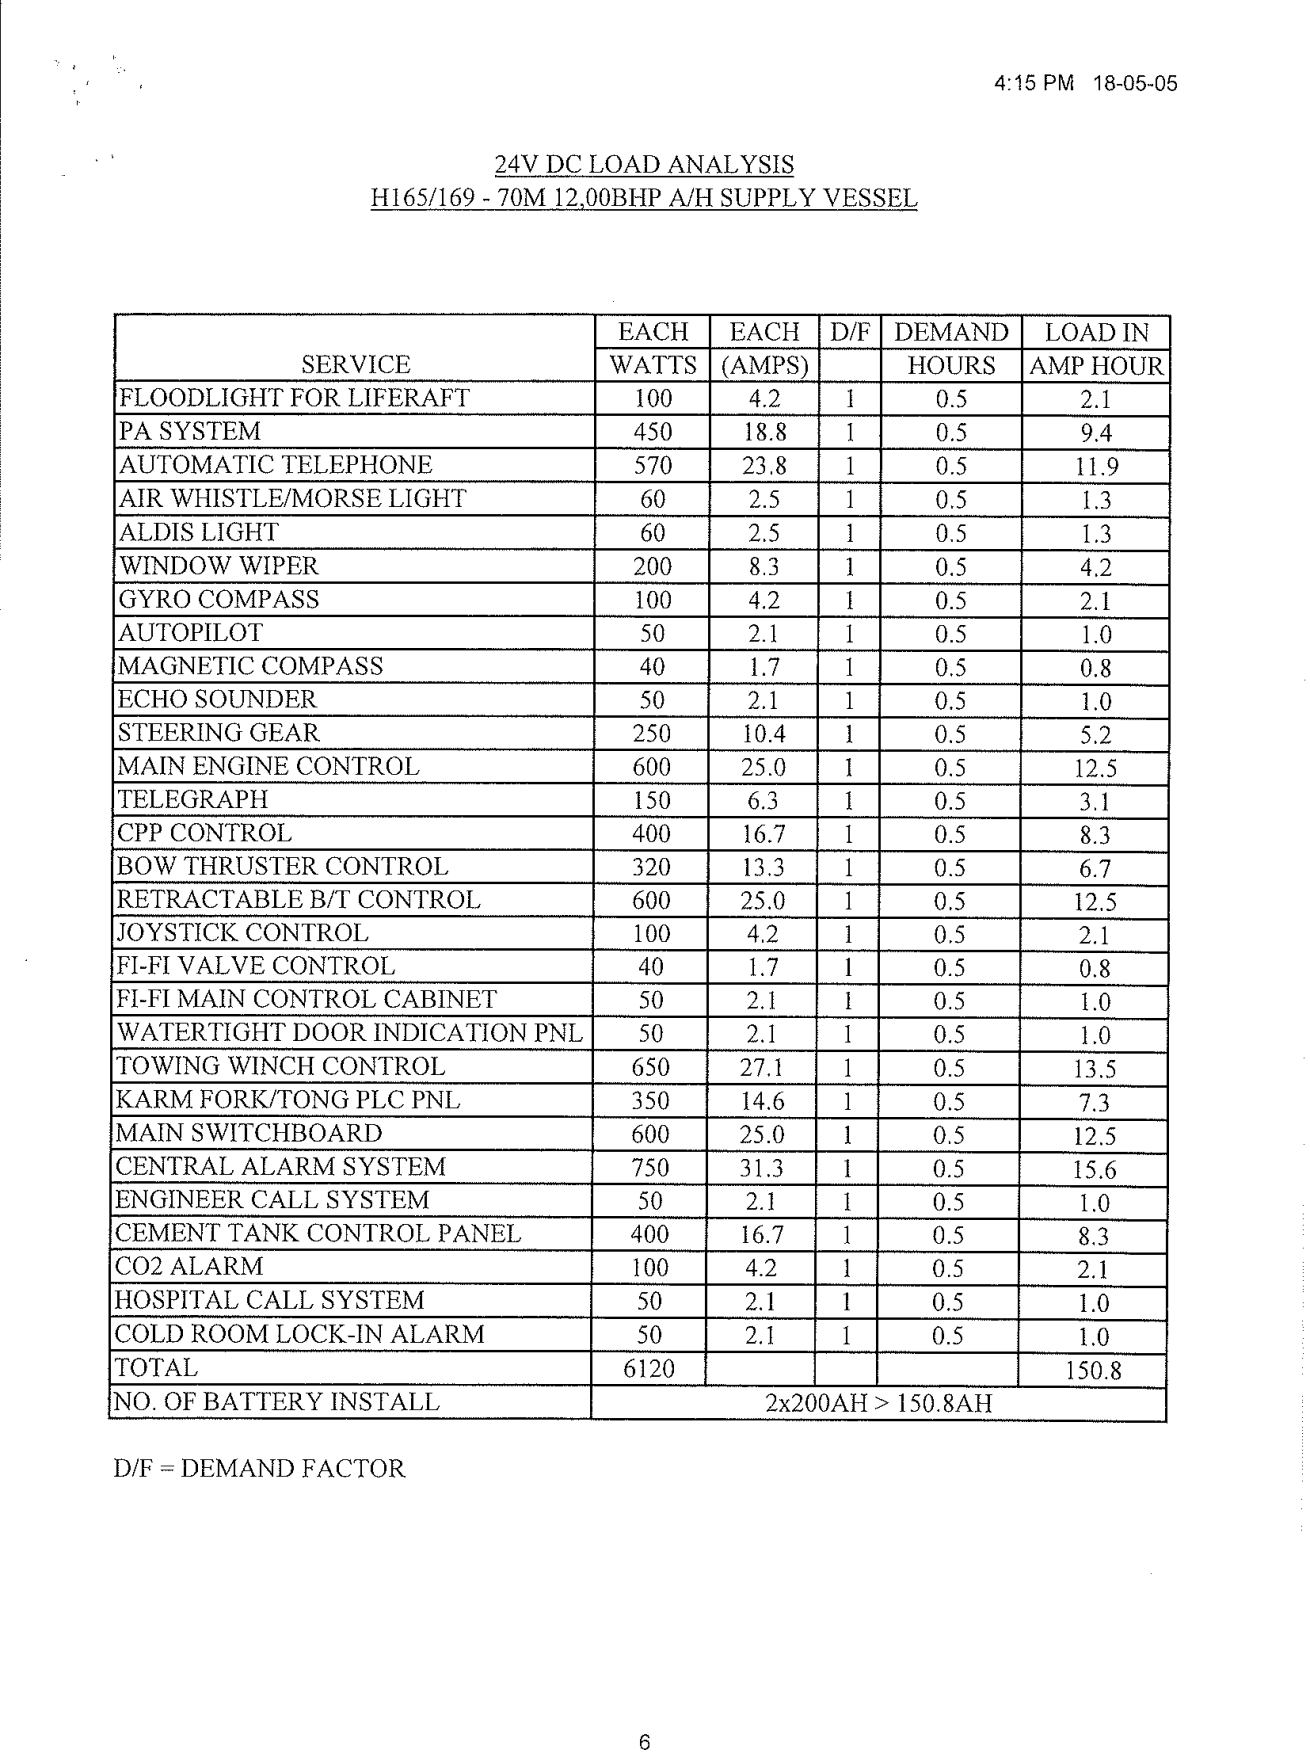
[picture p141: page 7]
