anurakj/J88_stork/GSPL-P1482-PI-0202 Piping Support Arrangement Drawing for BWTS(1 & Above).pdf

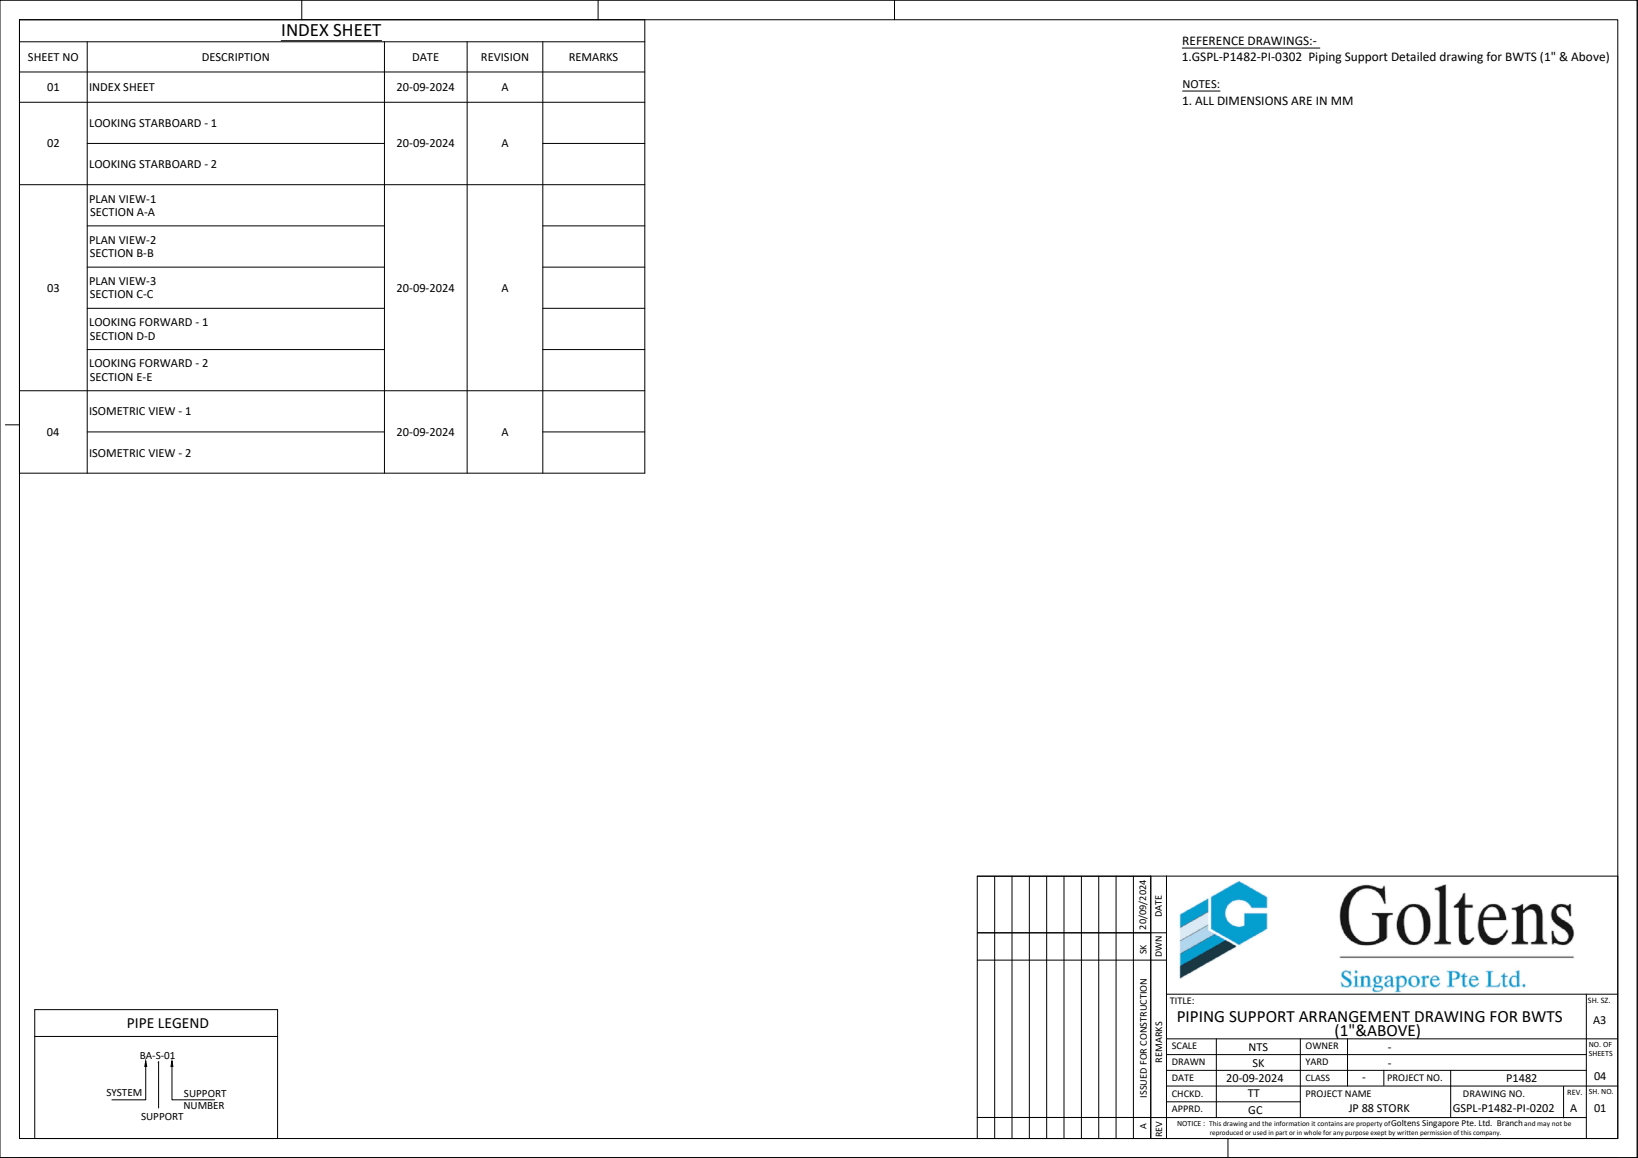
[picture p142: page 1]
PROJECT NO.; SHEETS; reproduced or used in part or in whole for any purpose exept by written permission of this company. NOTICE :; Goltens Singapore Pte. Ltd. Branch and may not be ISSUED FOR CONSTRUCTION A SK 20/09/2024; PIPE LEGEND; INDEX SHEET; LOOKING STARBOARD - 2; PLAN VIEW-1 SECTION A-A; PLAN VIEW-2 SECTION B-B; PLAN VIEW-3 SECTION C-C; LOOKING FORWARD - 1 SECTION D-D; LOOKING FORWARD - 2 SECTION E-E; ISOMETRIC VIEW - 1; ISOMETRIC VIEW - 2

REFERENCE DRAWINGS:-
1.GSPL-P1482-PI-0302 Piping Support Detailed drawing for BWTS (1" & Above)

SHEET NO | DESCRIPTION | DATE | REVISION | REMARKS

01 | INDEX SHEET | 20-09-2024 | A

NOTES:
1. ALL DIMENSIONS ARE IN MM

02 | LOOKING STARBOARD - 1 | 20-09-2024 | A

SH. SZ. REMARKS REV DWN DATE

TITLE:
PIPING SUPPORT ARRANGEMENT DRAWING FOR BWTS

NO. OF REV.

CHCKD. | TT | PROJECT NAME JP 88 STORK | DRAWING NO. GSPL-P1482-PI-0202 | A | SH. NO. 01
APPRD. | GC

This drawing and the information it contains are property of

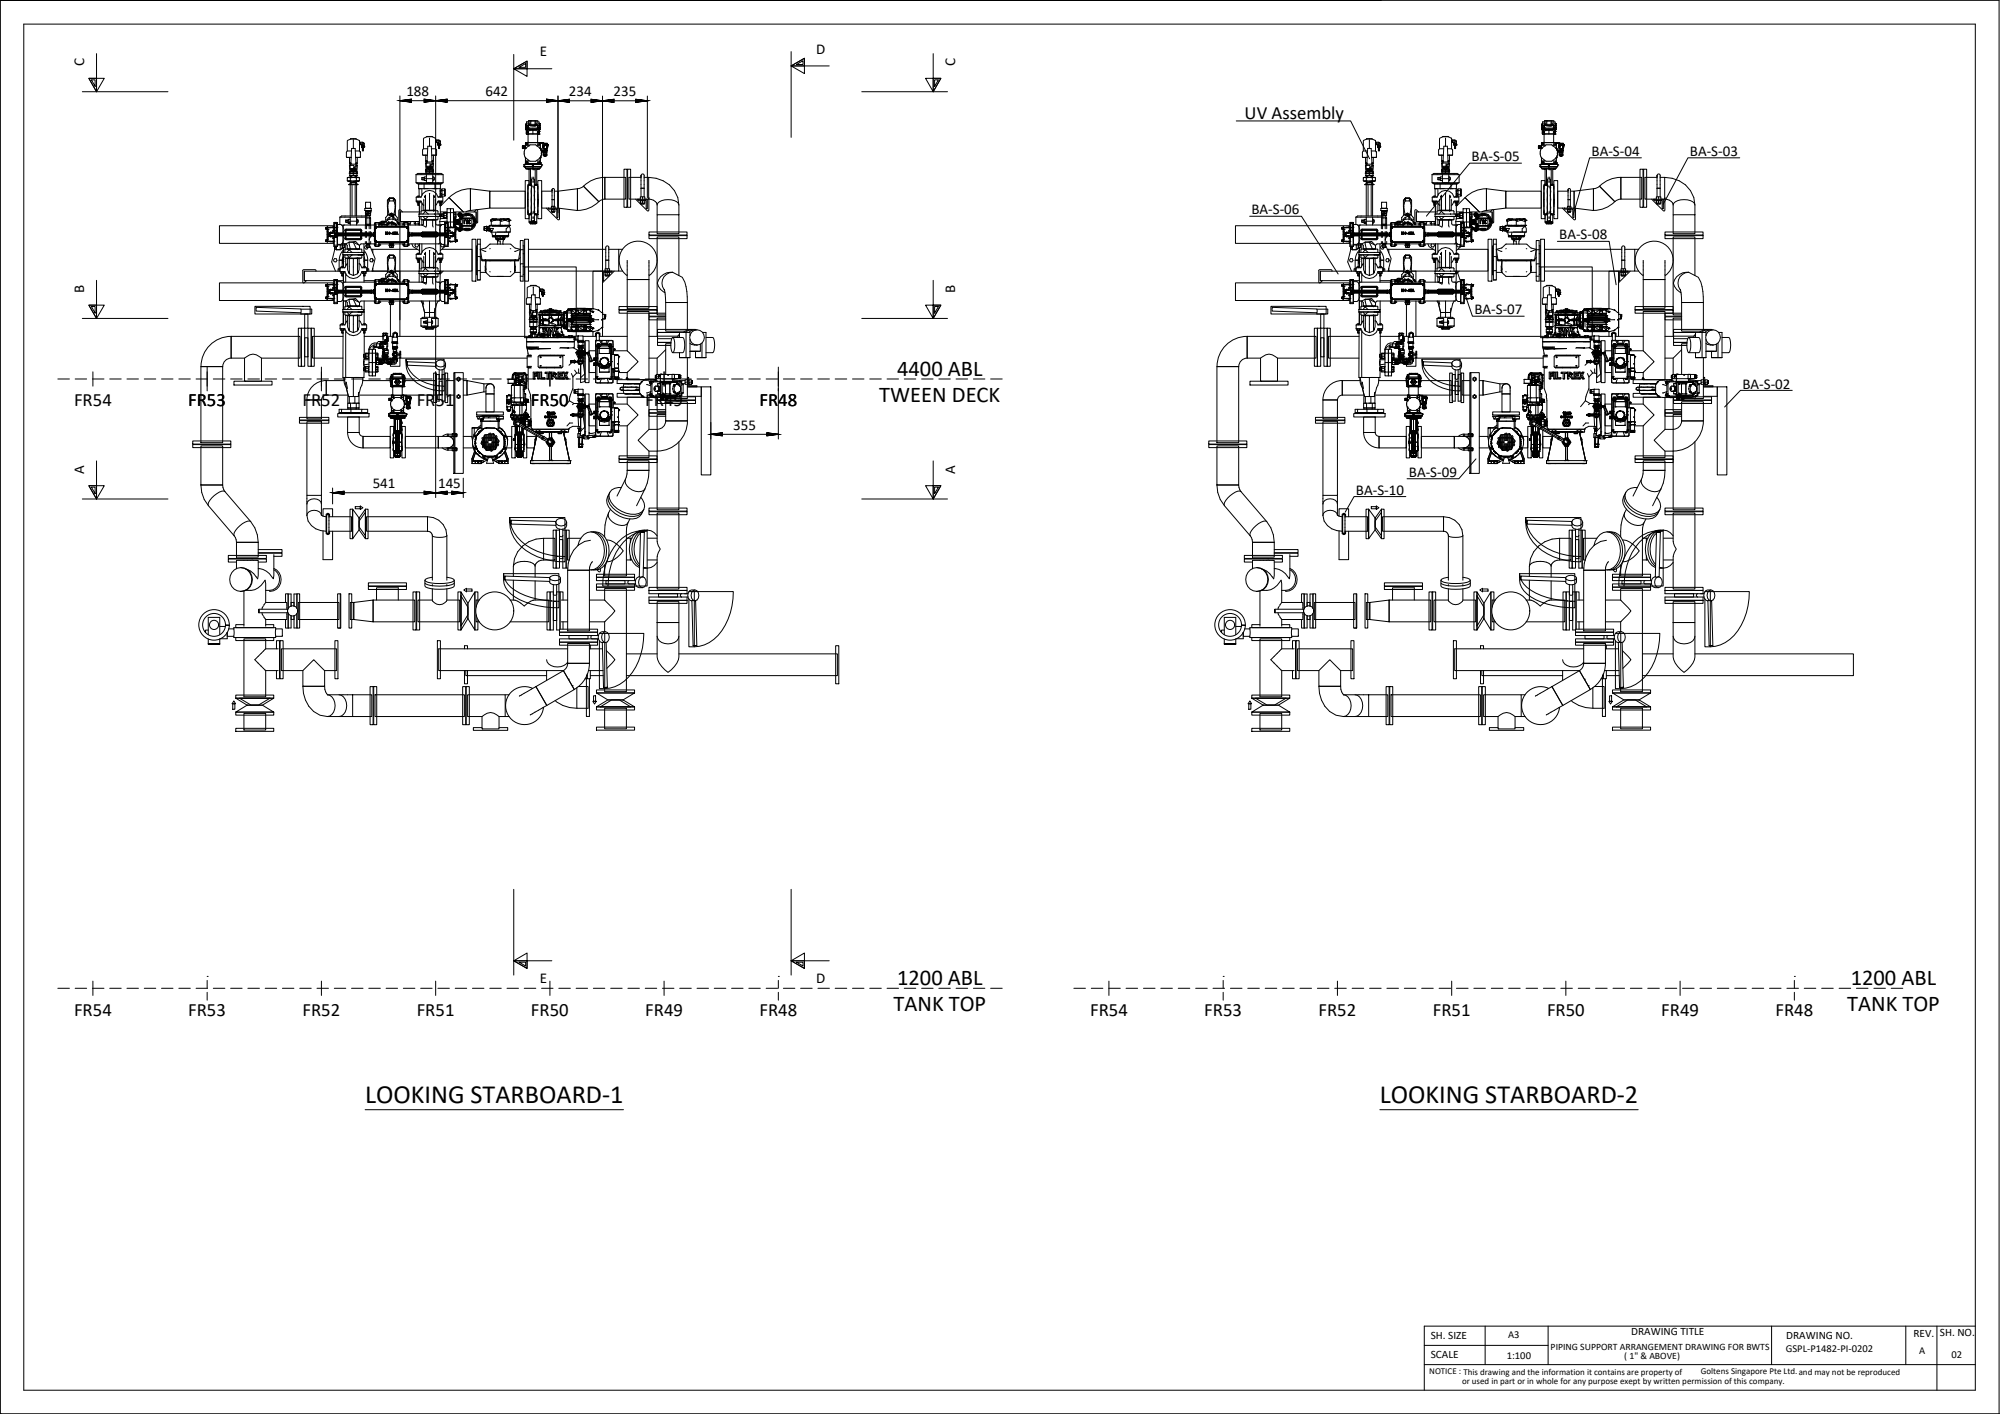
[picture p143: page 2]
4400 ABL; UV Assembly; LOOKING STARBOARD-1; LOOKING STARBOARD-2; TWEEN DECK; 1200 ABL TANK TOP

SCALE | A3 | PIPING SUPPORT ARRANGEMENT DRAWING FOR BWTS ( 1" & ABOVE) | DRAWING NO. DRAWING TITLE SH. SIZE GSPL-P1482-PI-0202 | REV. A | SH. NO. 1:100 02

or used in part or in whole for any purpose exept by written permission of this company. NOTICE : Goltens Singapore Pte Ltd. and may not be reproduced

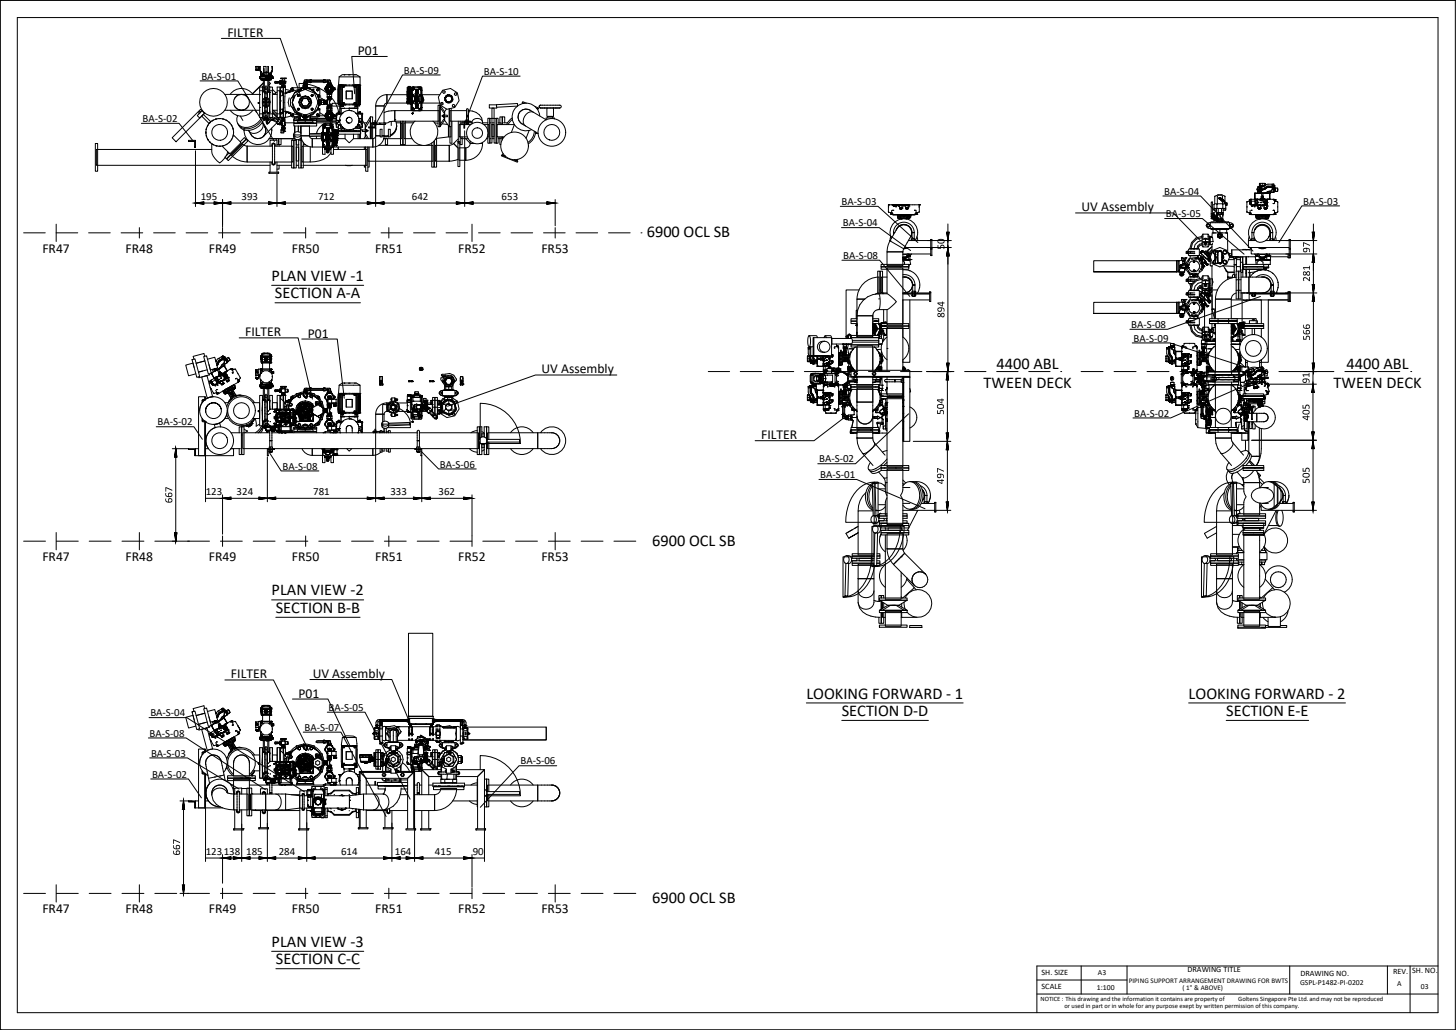
[picture p144: page 3]
SCALE; REV.; or used in part or in whole for any purpose exept by written permission of this company. NOTICE :; Goltens Singapore Pte Ltd. and may not be reproduced GSPL-P1482-PI-0202; 6900 OCL SB; UV Assembly; FILTER; PLAN VIEW -1 SECTION A-A; PLAN VIEW -2 SECTION B-B; PLAN VIEW -3 SECTION C-C; 4400 ABL TWEEN DECK; LOOKING FORWARD - 1 SECTION D-D; LOOKING FORWARD - 2 SECTION E-E

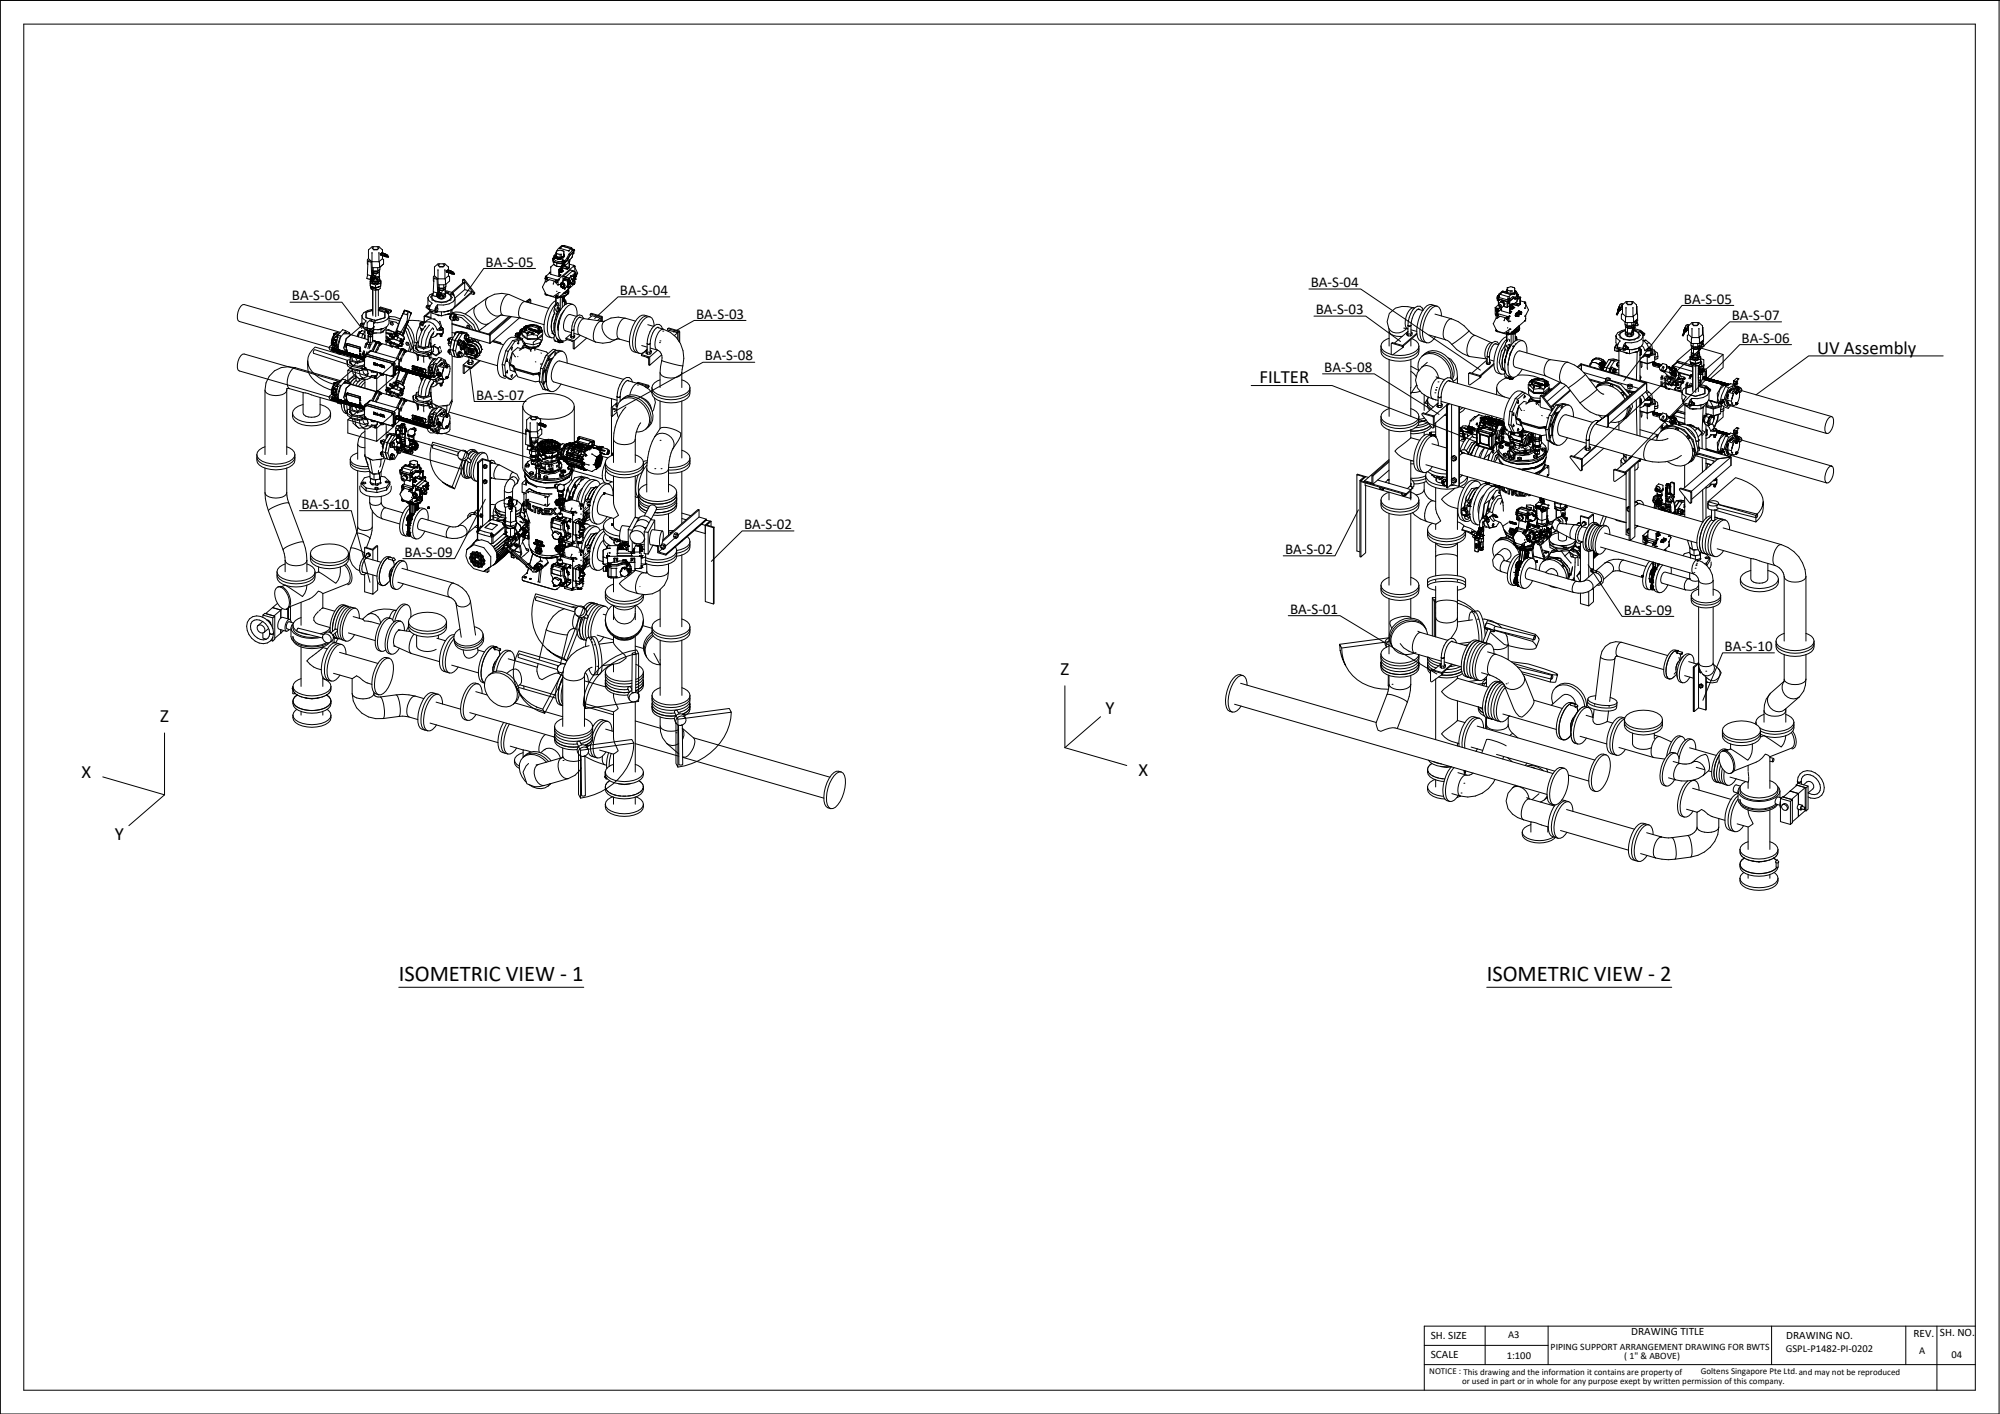
[picture p145: page 4]
SCALE; REV.; or used in part or in whole for any purpose exept by written permission of this company. NOTICE :; Goltens Singapore Pte Ltd. and may not be reproduced GSPL-P1482-PI-0202; UV Assembly; ISOMETRIC VIEW - 1; ISOMETRIC VIEW - 2
