anurakj/J88_stork/Bypass_valves_logic_box/Bypass_valves_box_GA_rev-B.pdf

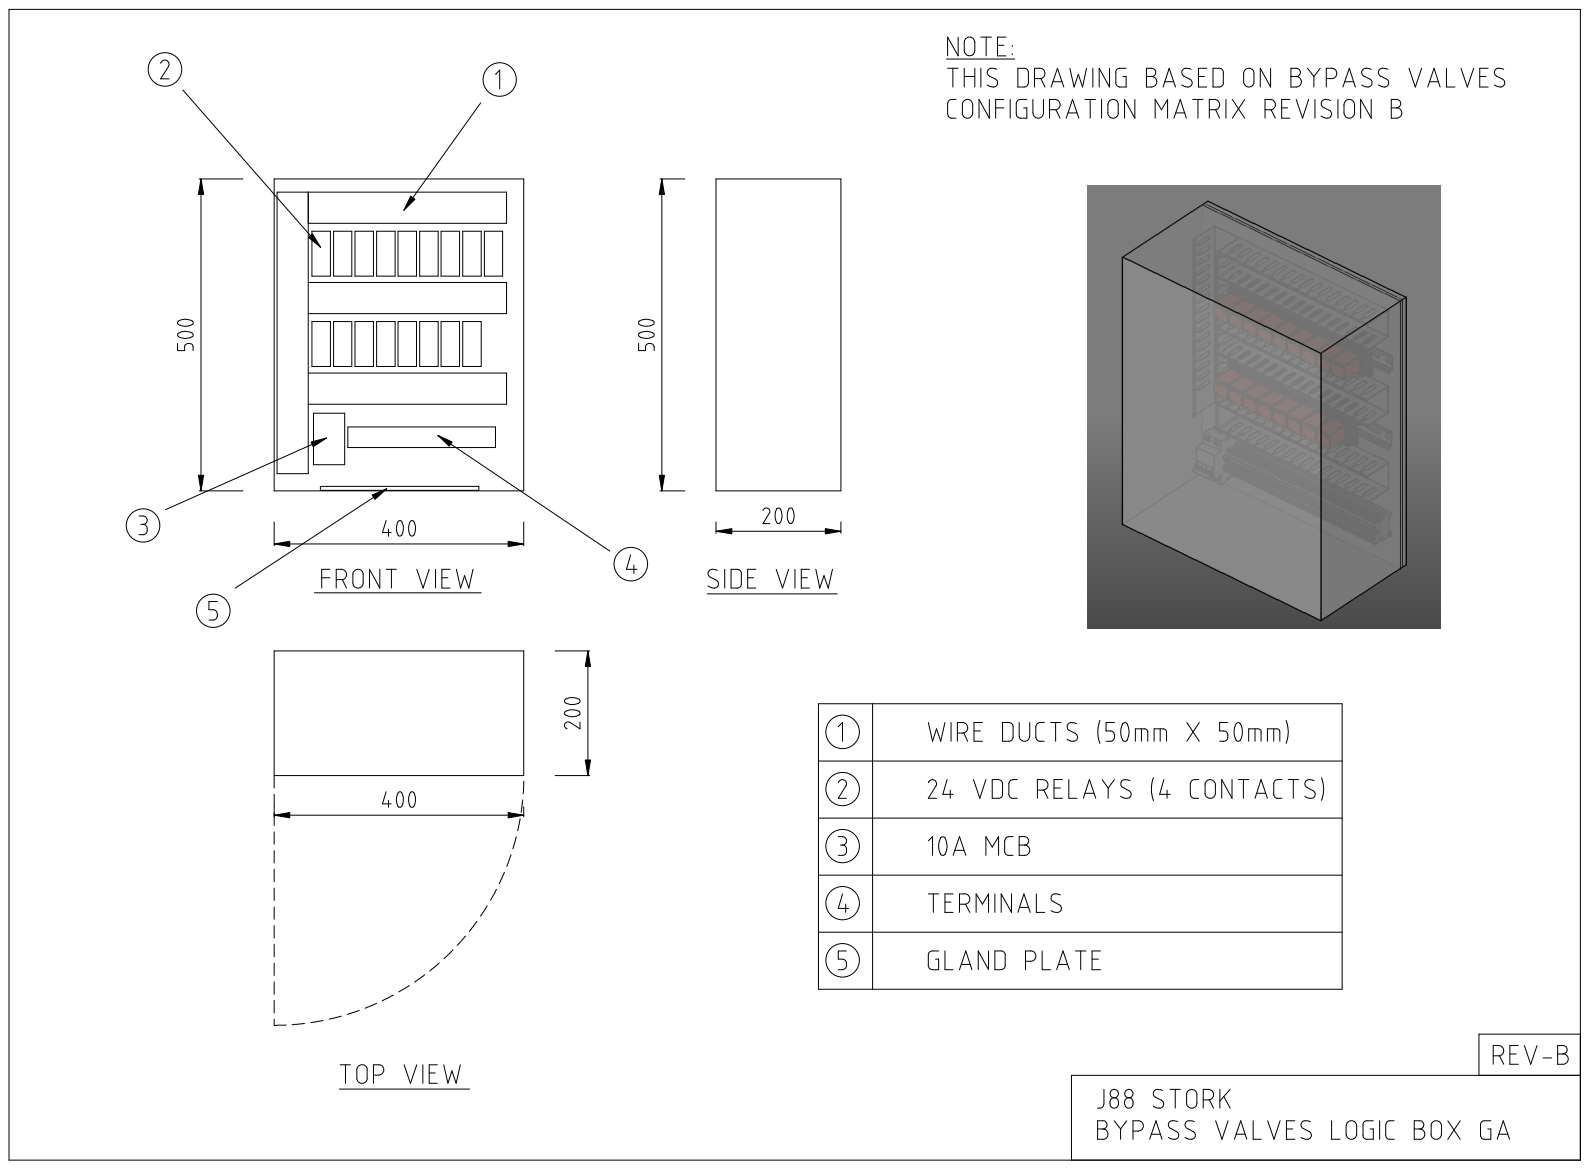
[picture p146: page 1]
