anurakj/J88_stork/0)_old_revisions/GSPL-P1482-ST-0101- Bulk Structural MTO R.A.pdf

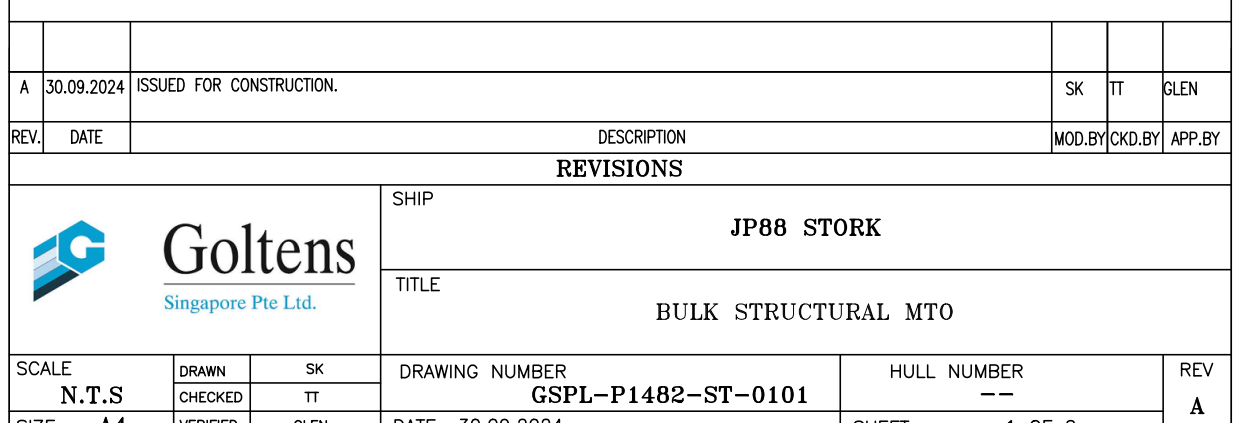
[picture p147: page 1]

SI NO. | DESCRIPTION | DIMENSION (mm) | MATERIAL | QTY | WEIGHT.(Kg) | REMARKS
1 | ANGLE BAR | L 100x75x10 | A Grade steel | 4.5 M | 58.50
2 | ANGLE BAR | L 75x75x10 | A Grade steel | 3 M | 33.00
3 | ANGLE BAR | L 50x50x6 | A Grade steel | 5 M | 22.50
4 | PAD PLATE | 130x130x10 | A Grade steel | 6 Nos. | 4.20
5 | PAD PLATE | 95x95x8 | A Grade steel | 4 Nos. | 1.20
Total Weight (Kg.) | | | | | 119.40

BILL OF MATERIALS

Notes:
1) MTO for gratings not included.
2) Bolting and fastening grade & size are to be as per maker recommendation.
3) Data considered are approximate and based on point cloud data & input documents received.
