anurakj/J88_stork/0)_old_revisions/GSPL-P1482-EL-0002 Electrical Block Diagram for BWTS R.A.pdf

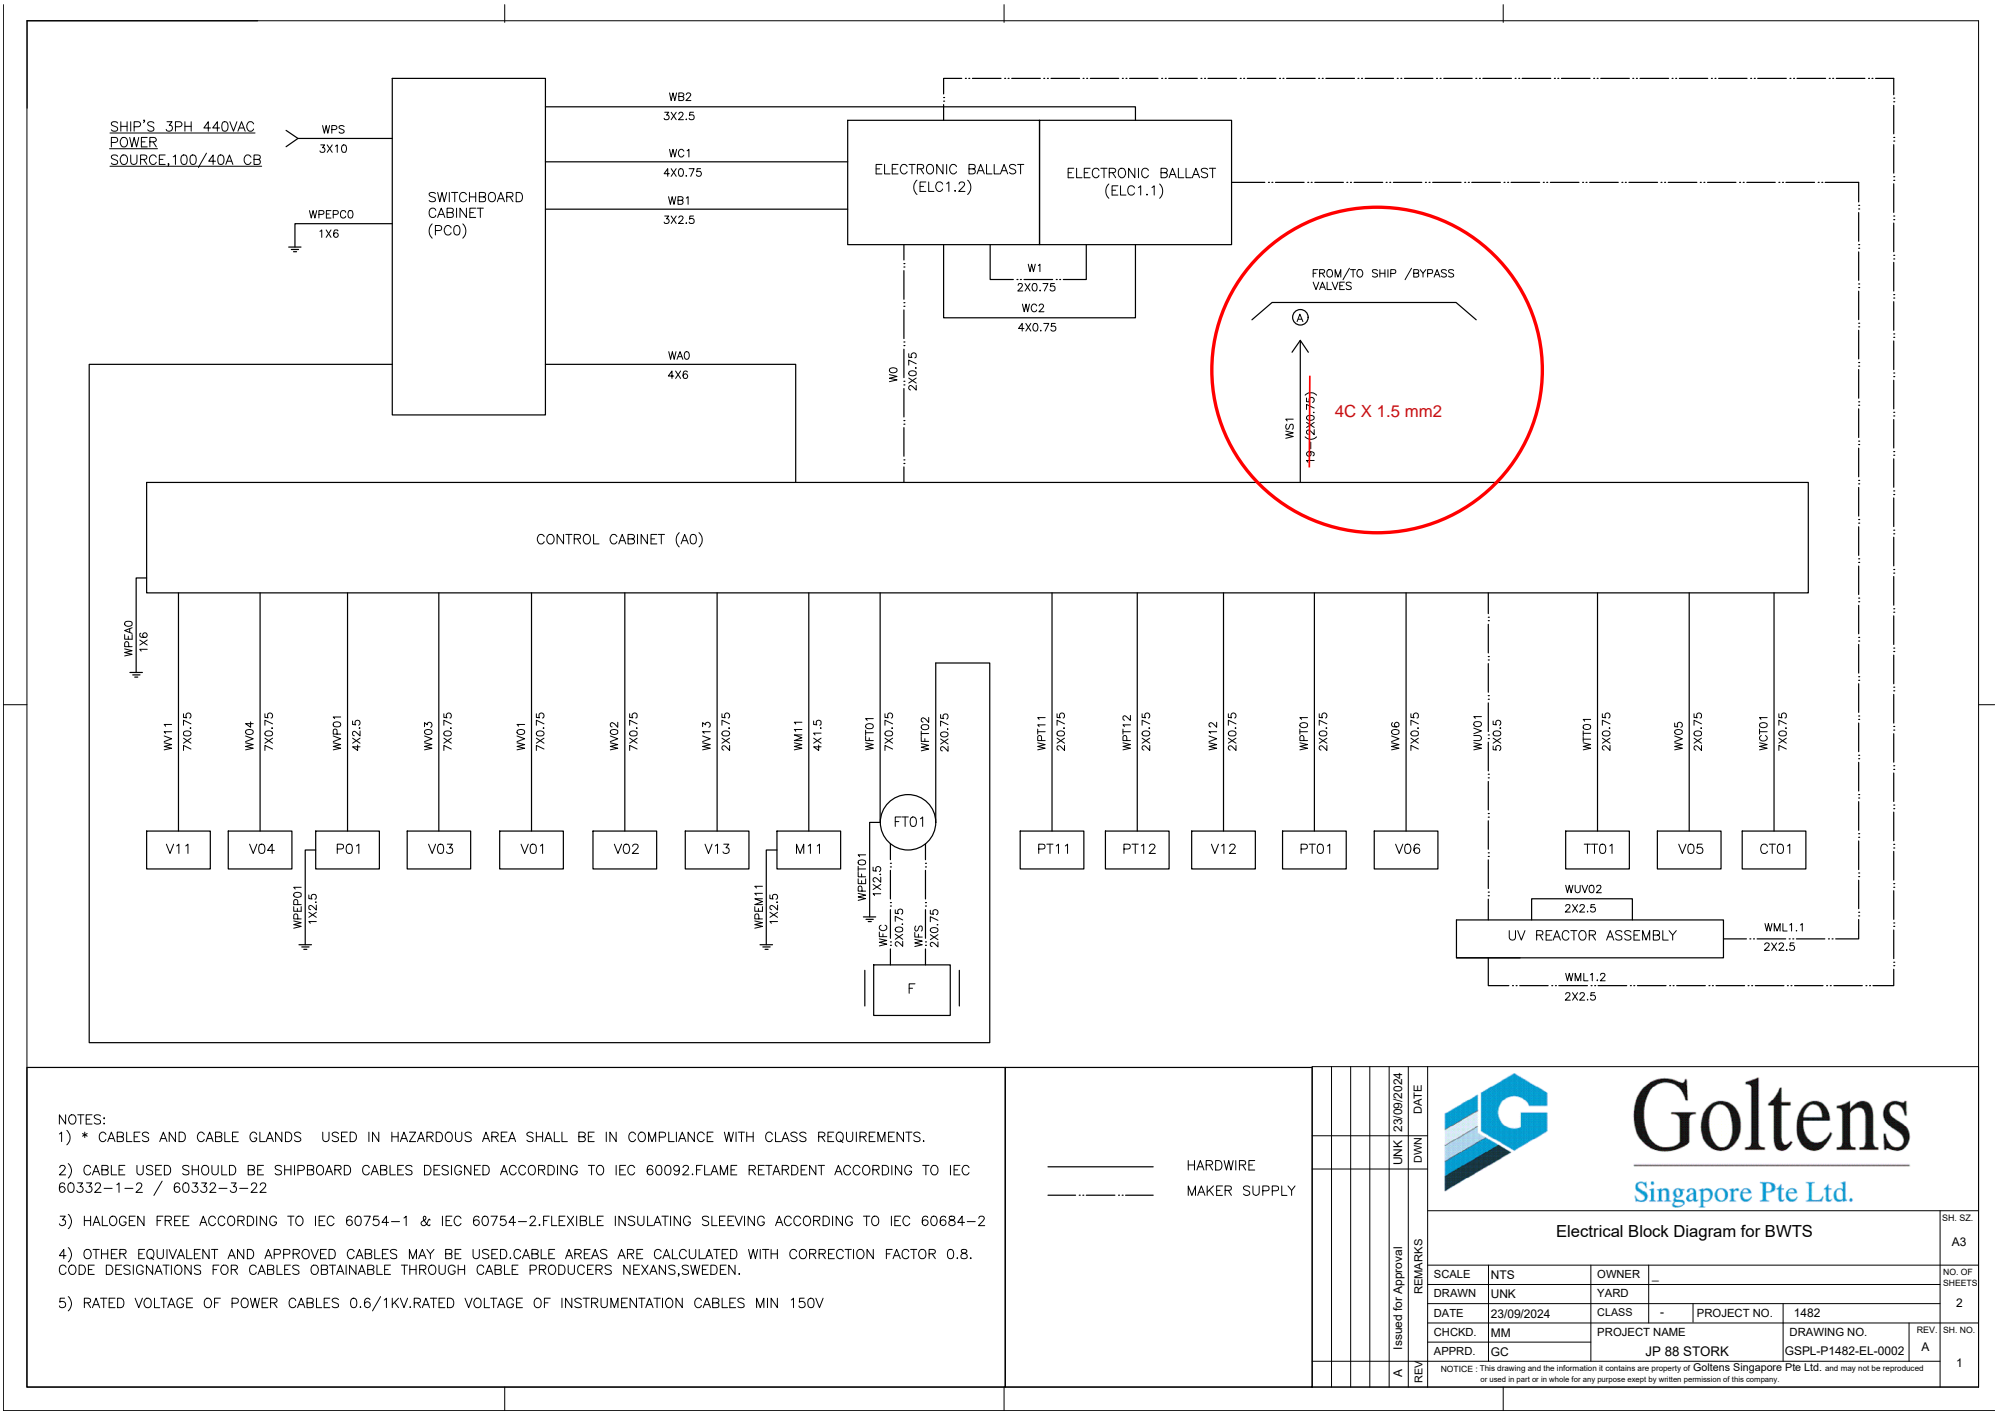
[picture p148: page 1]

Issued for Approval UNK 23/09/2024
SH. SZ. REMARKS REV DWN DATE

Electrical Block Diagram for BWTS | A3

SCALE | NTS | OWNER | _ | NO. OF SHEETS 2
DRAWN | UNK | YARD
DATE | 23/09/2024 | CLASS | - 1482 | PROJECT NO.
CHCKD. | MM | PROJECT NAME JP 88 STORK | DRAWING NO. GSPL-P1482-EL-0002 | REV. A | SH. NO. 1

or used in part or in whole for any purpose exept by written permission of this company. NOTICE : APPRD. | GC

This drawing and the information it contains are property of Goltens Singapore Pte Ltd. and may not be reproduced

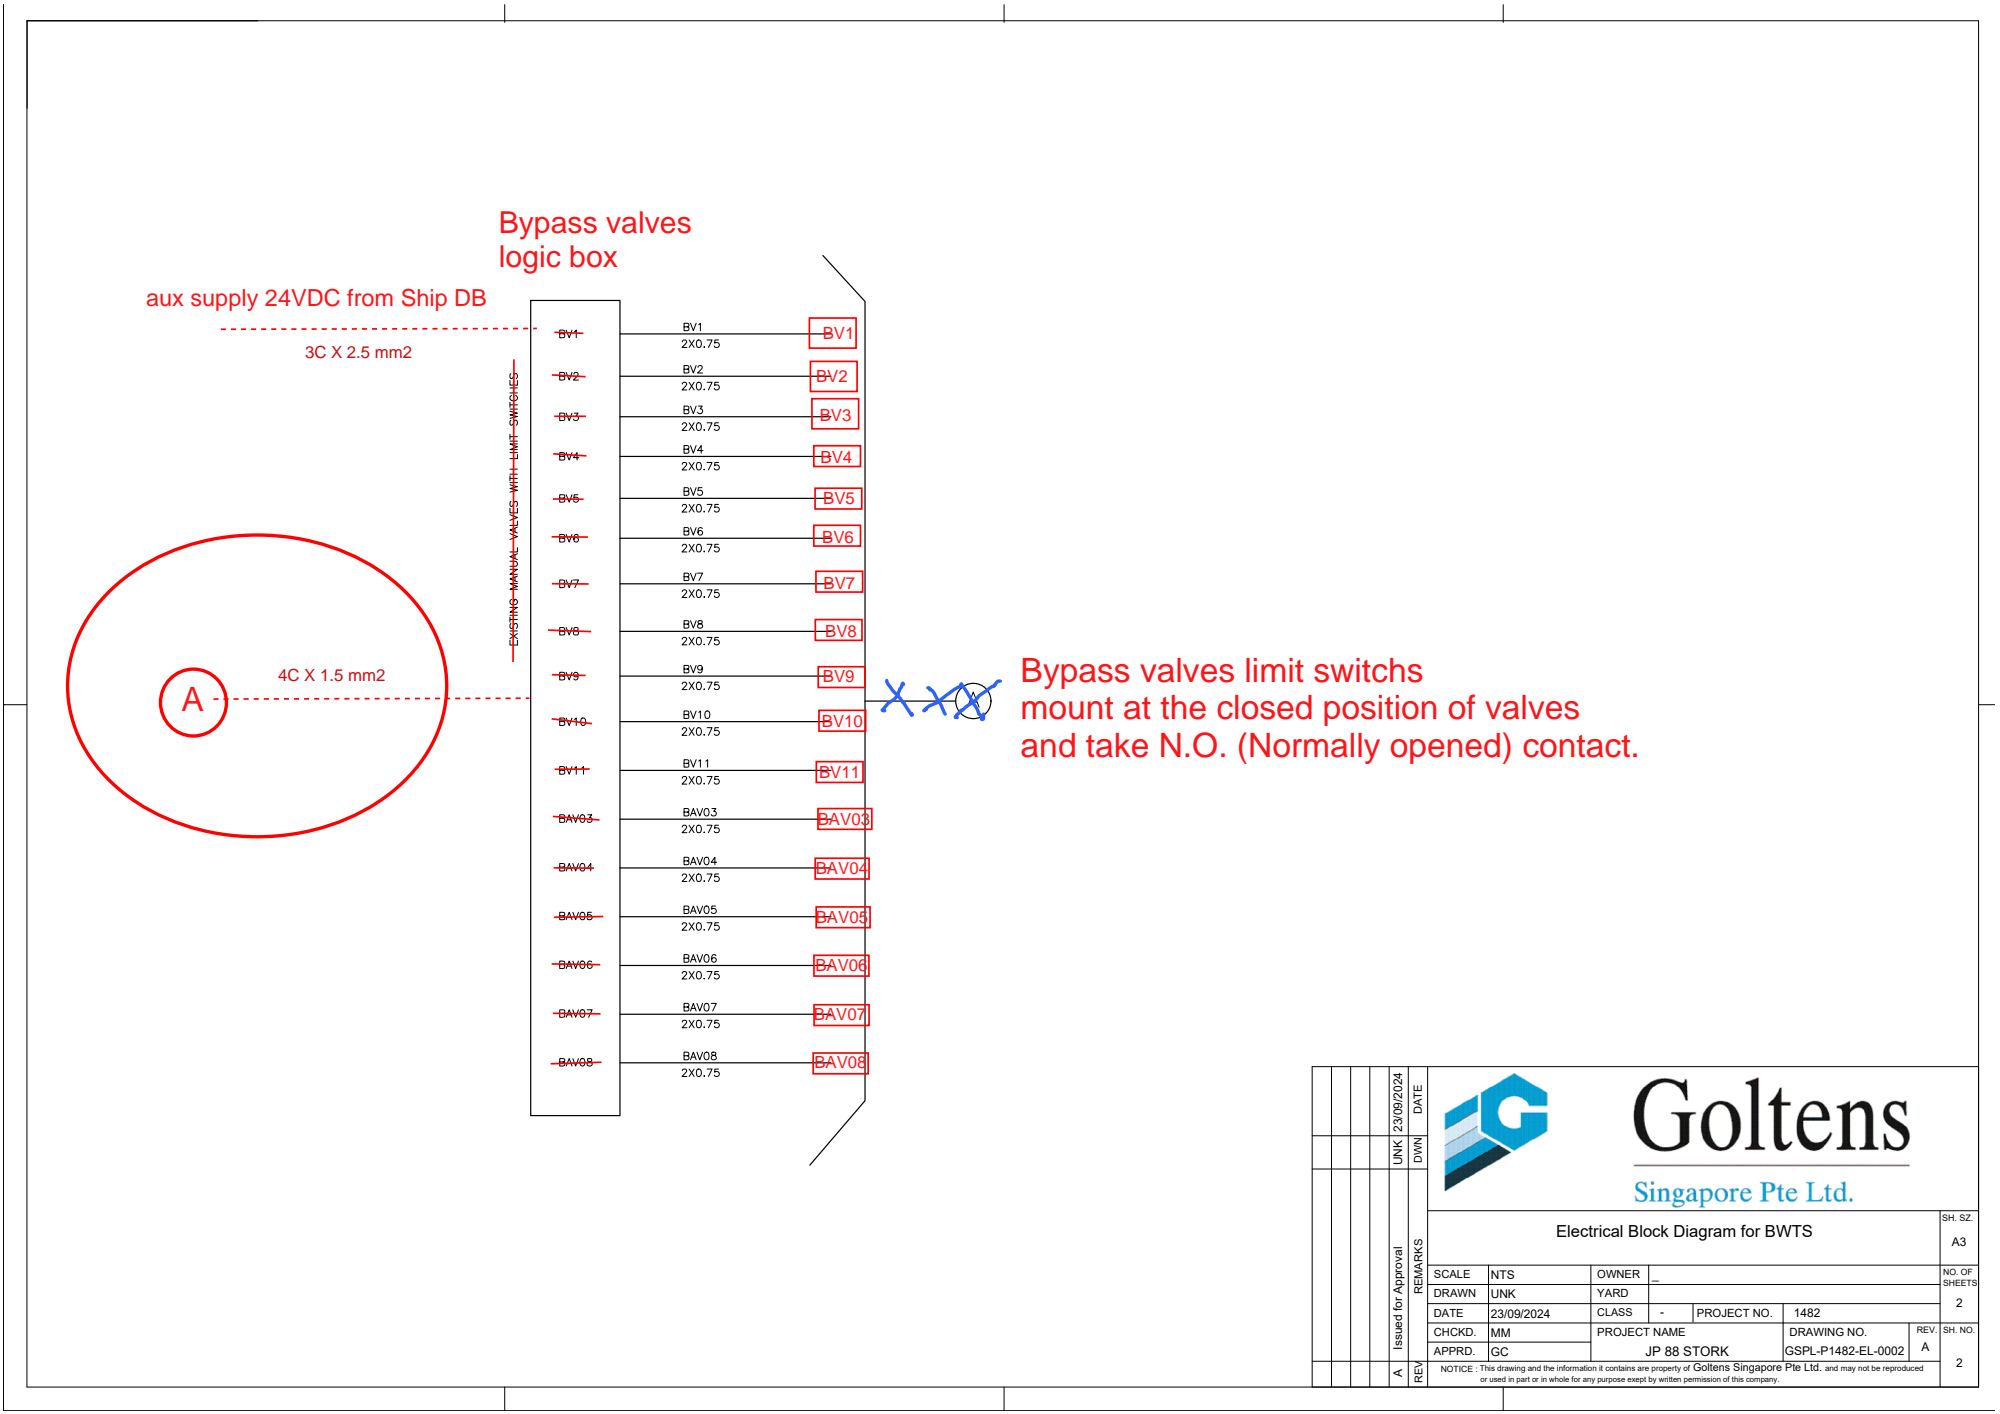
[picture p149: page 2]

Issued for Approval UNK 23/09/2024
SH. SZ. REMARKS REV DWN DATE

Electrical Block Diagram for BWTS | A3

SCALE | NTS | OWNER | _ | NO. OF SHEETS 2
DRAWN | UNK | YARD
DATE | 23/09/2024 | CLASS | - 1482 | PROJECT NO.
CHCKD. | MM | PROJECT NAME JP 88 STORK | DRAWING NO. GSPL-P1482-EL-0002 | REV. A | SH. NO. 2

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
