anurakj/J88_stork/0)_old_revisions/GSPL-P1482-EL-0002 Electrical Block Diagram for BWTS R.D.pdf

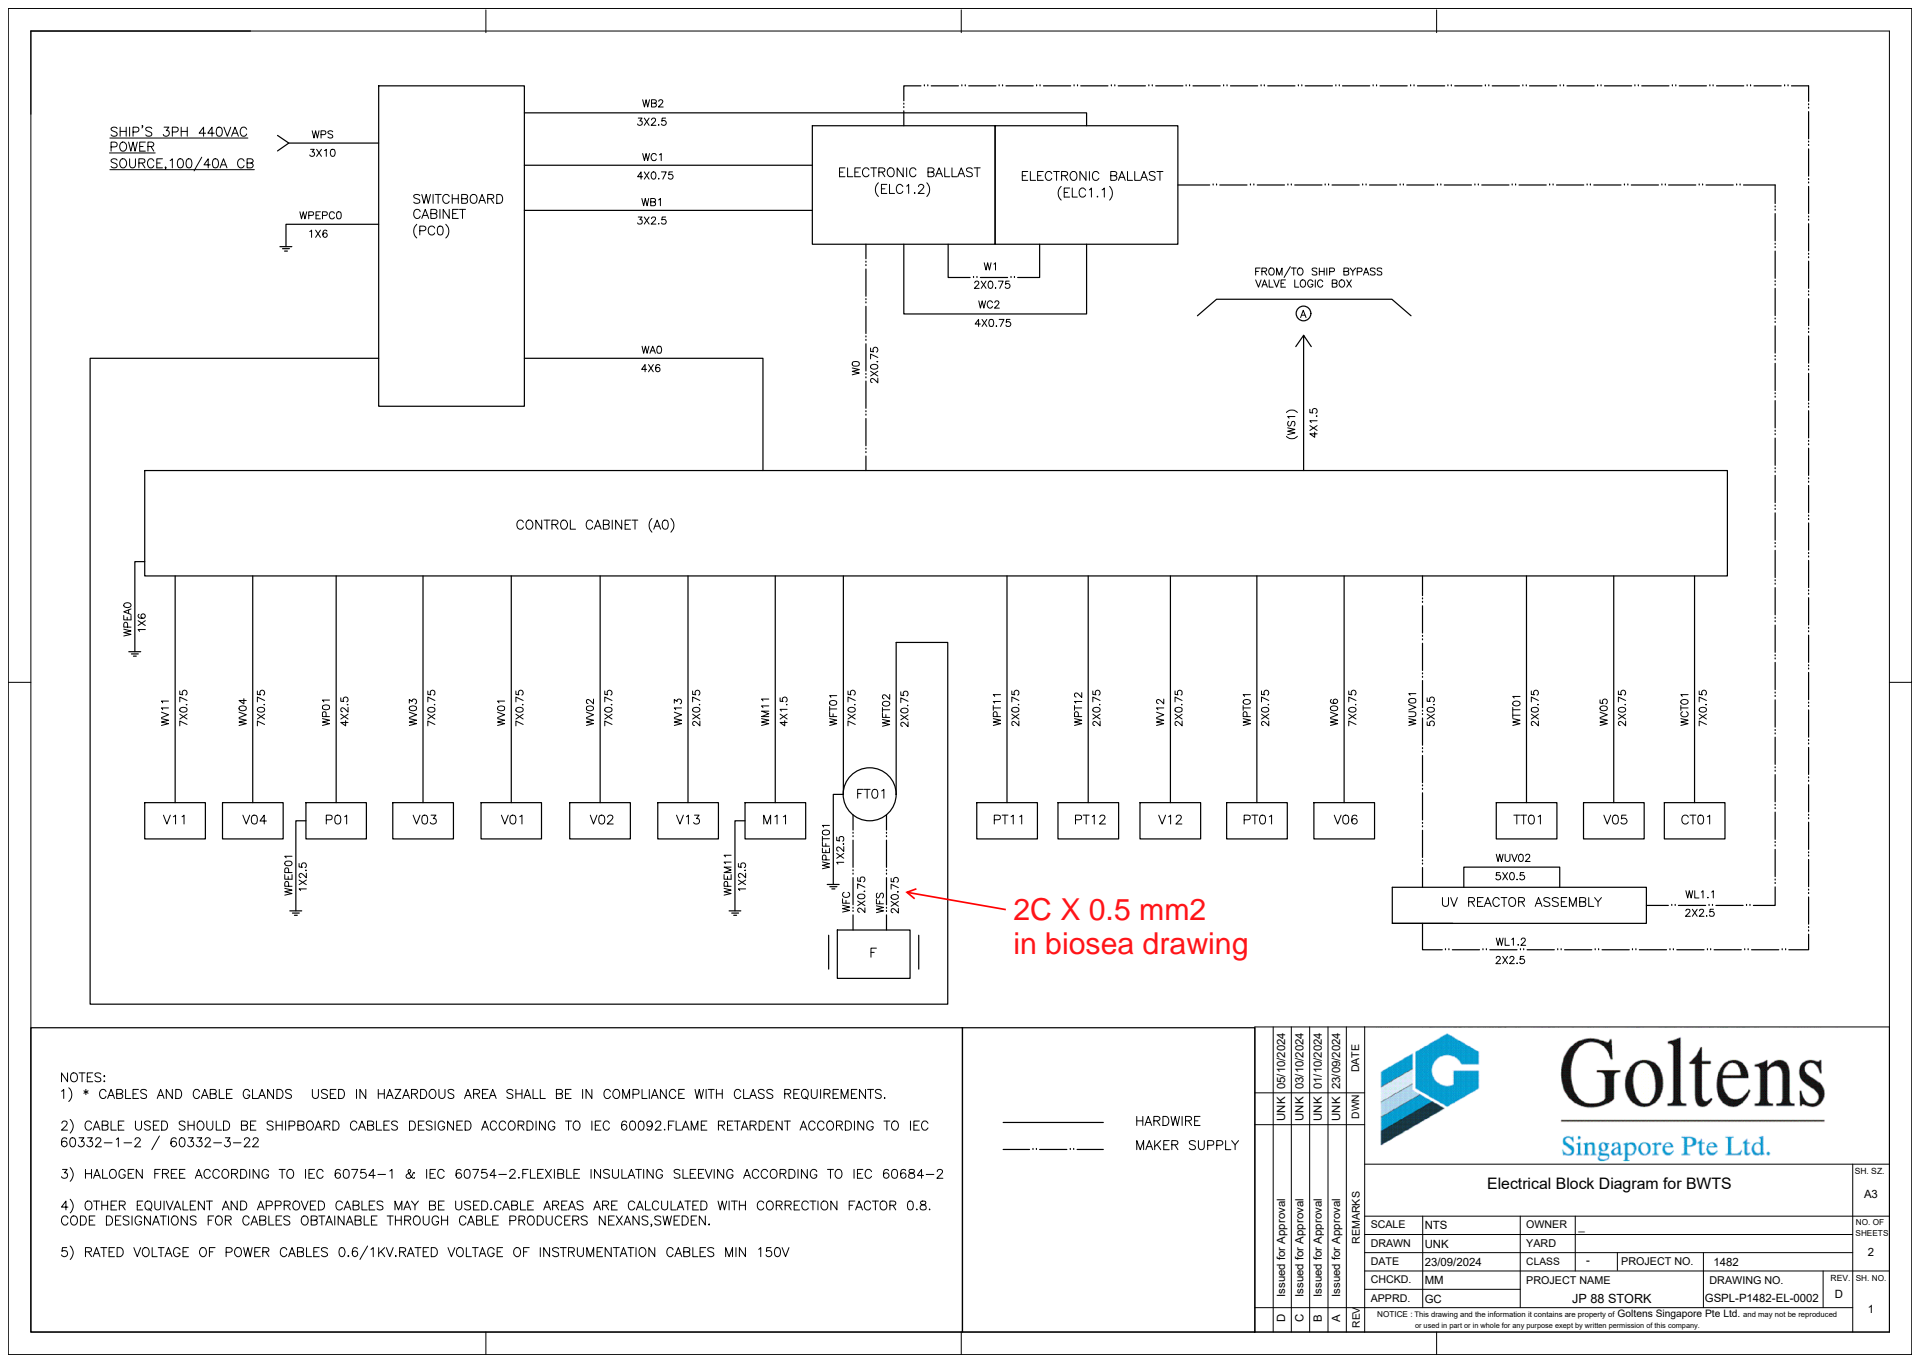
[picture p152: page 1]
This drawing and the information it contains are property of CHCKD.; PROJECT NAME; DRAWING NO. or used in part or in whole for any purpose exept by written permission of this company. NOTICE : APPRD.; Goltens Singapore Pte Ltd. and may not be reproduced DRAWN DATE SCALE; YARD CLASS OWNER; SH. NO. NO. OF REV.

Issued for Approval UNK 23/09/2024 B Issued for Approval UNK 01/10/2024 C Issued for Approval UNK 03/10/2024 D Issued for Approval UNK 05/10/2024

REMARKS REV DWN DATE PROJECT NO. SHEETS Electrical Block Diagram for BWTS JP 88 STORK _ A31 NTS 2 23/09/2024 D A UNK MMGC GSPL-P1482-EL-0002 - 1482

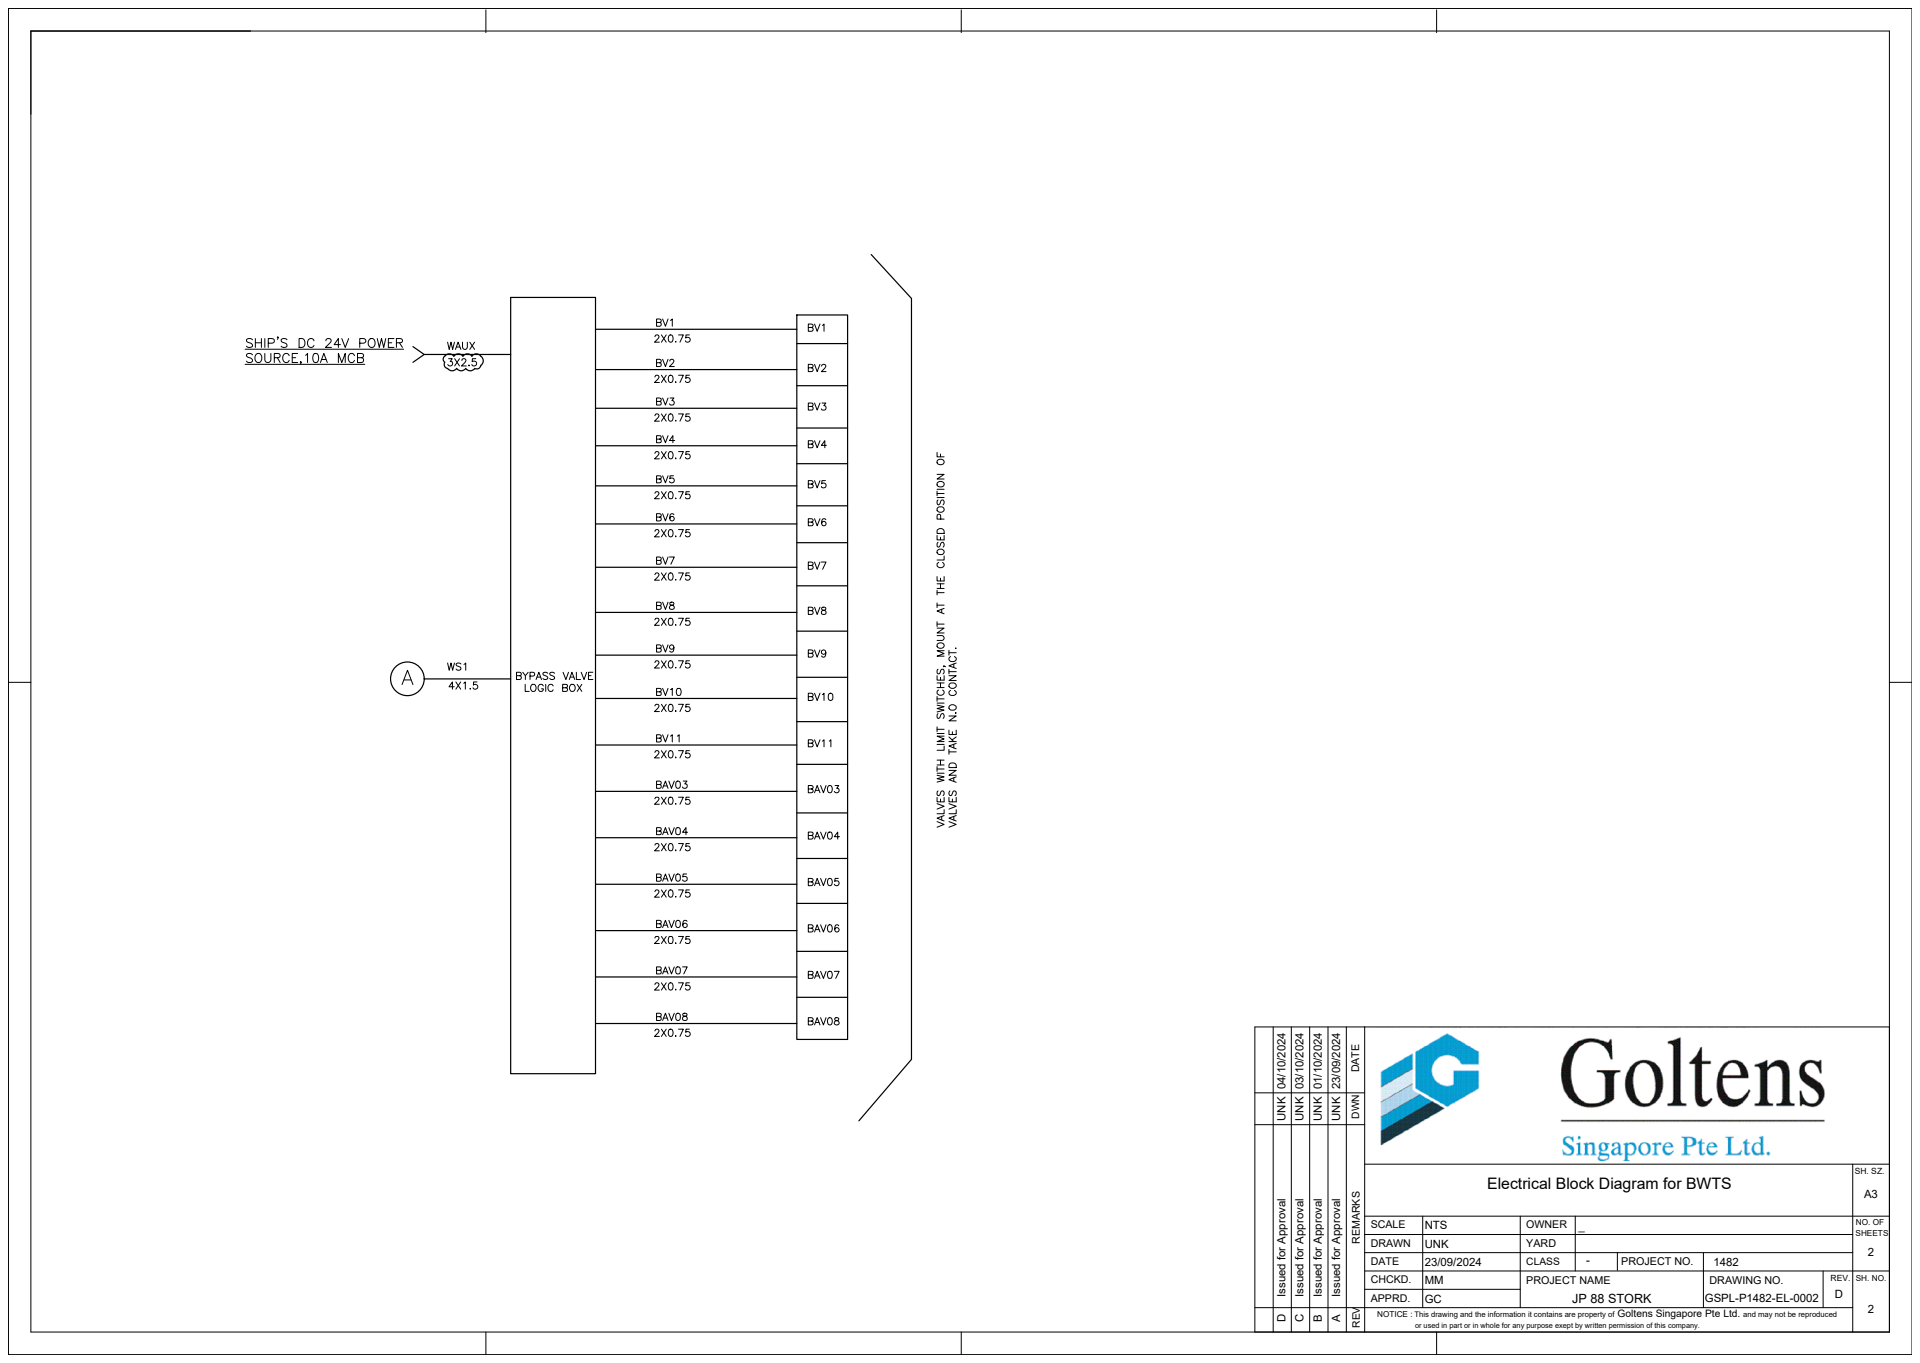
[picture p153: page 2]
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

Issued for Approval UNK 23/09/2024 B Issued for Approval UNK 01/10/2024 C Issued for Approval UNK 03/10/2024 D Issued for Approval UNK 04/10/2024

REMARKS REV DWN DATE PROJECT NO. SHEETS Electrical Block Diagram for BWTS JP 88 STORK _ A32 NTS 2 23/09/2024 D A UNK MMGC GSPL-P1482-EL-0002 - 1482
