anurakj/J88_stork/0)_old_revisions/GSPL-P1482-PI-0001 BWTS PIPING SCHEMATIC R.B - Deballast.pdf

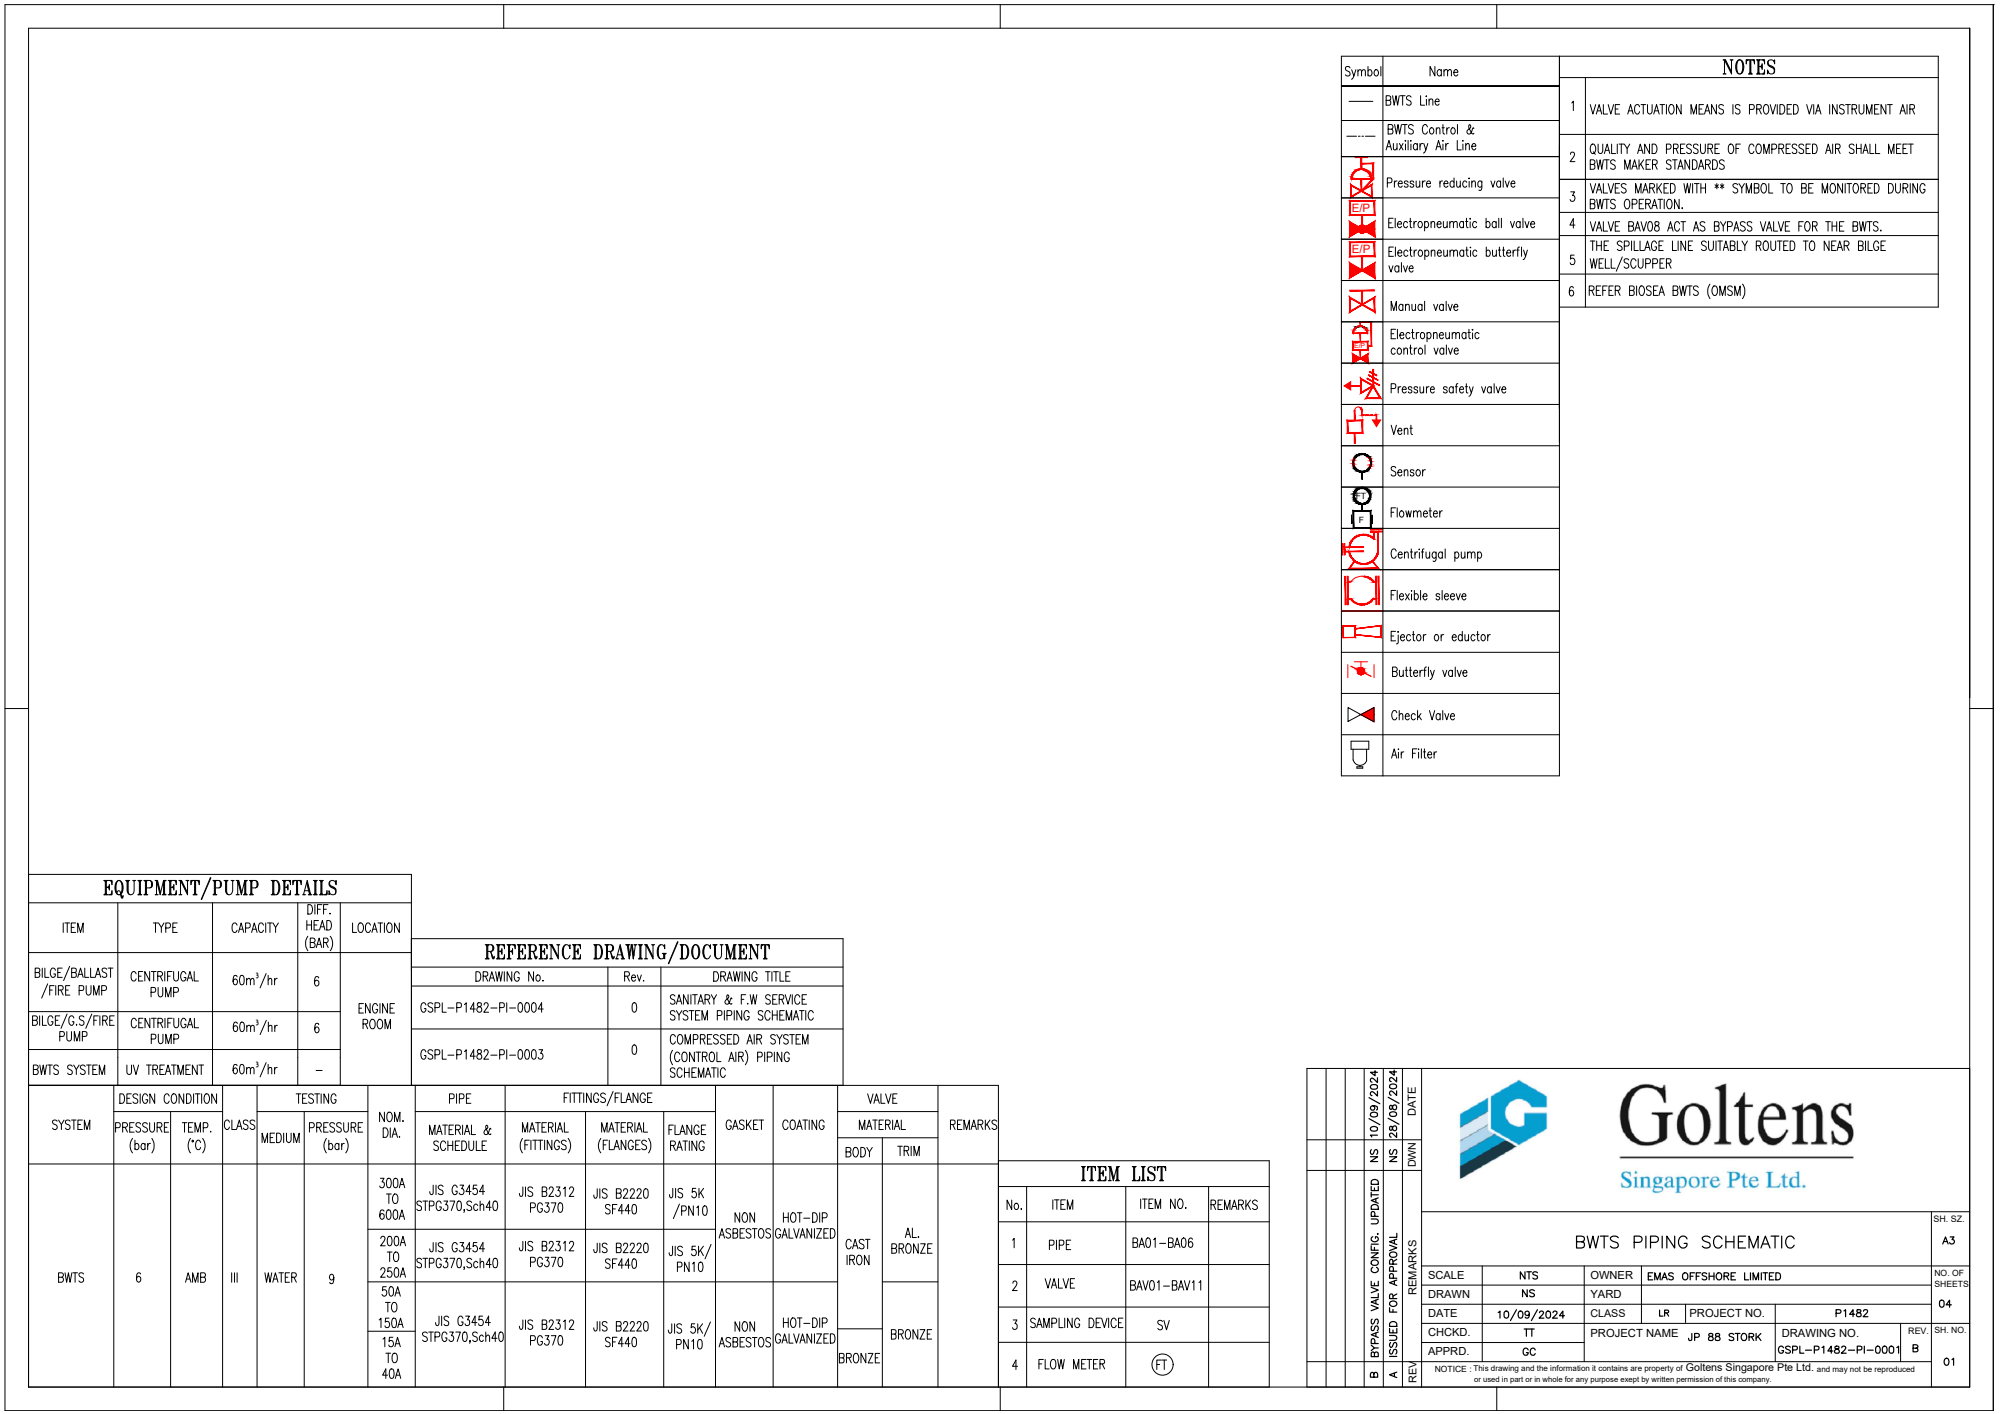
[picture p154: page 1]
CHCKD.; PROJECT NAME; DRAWING NO.

SH. SZ. REMARKS REV DWN DATE

SCALE | | OWNER | | | | NO. OF SHEETS

DRAWN | | YARD
DATE | CLASS | | PROJECT NO.

REV. | SH. NO.

or used in part or in whole for any purpose exept by written permission of this company. NOTICE : APPRD.

This drawing and the information it contains are property of Goltens Singapore Pte Ltd. and may not be reproduced

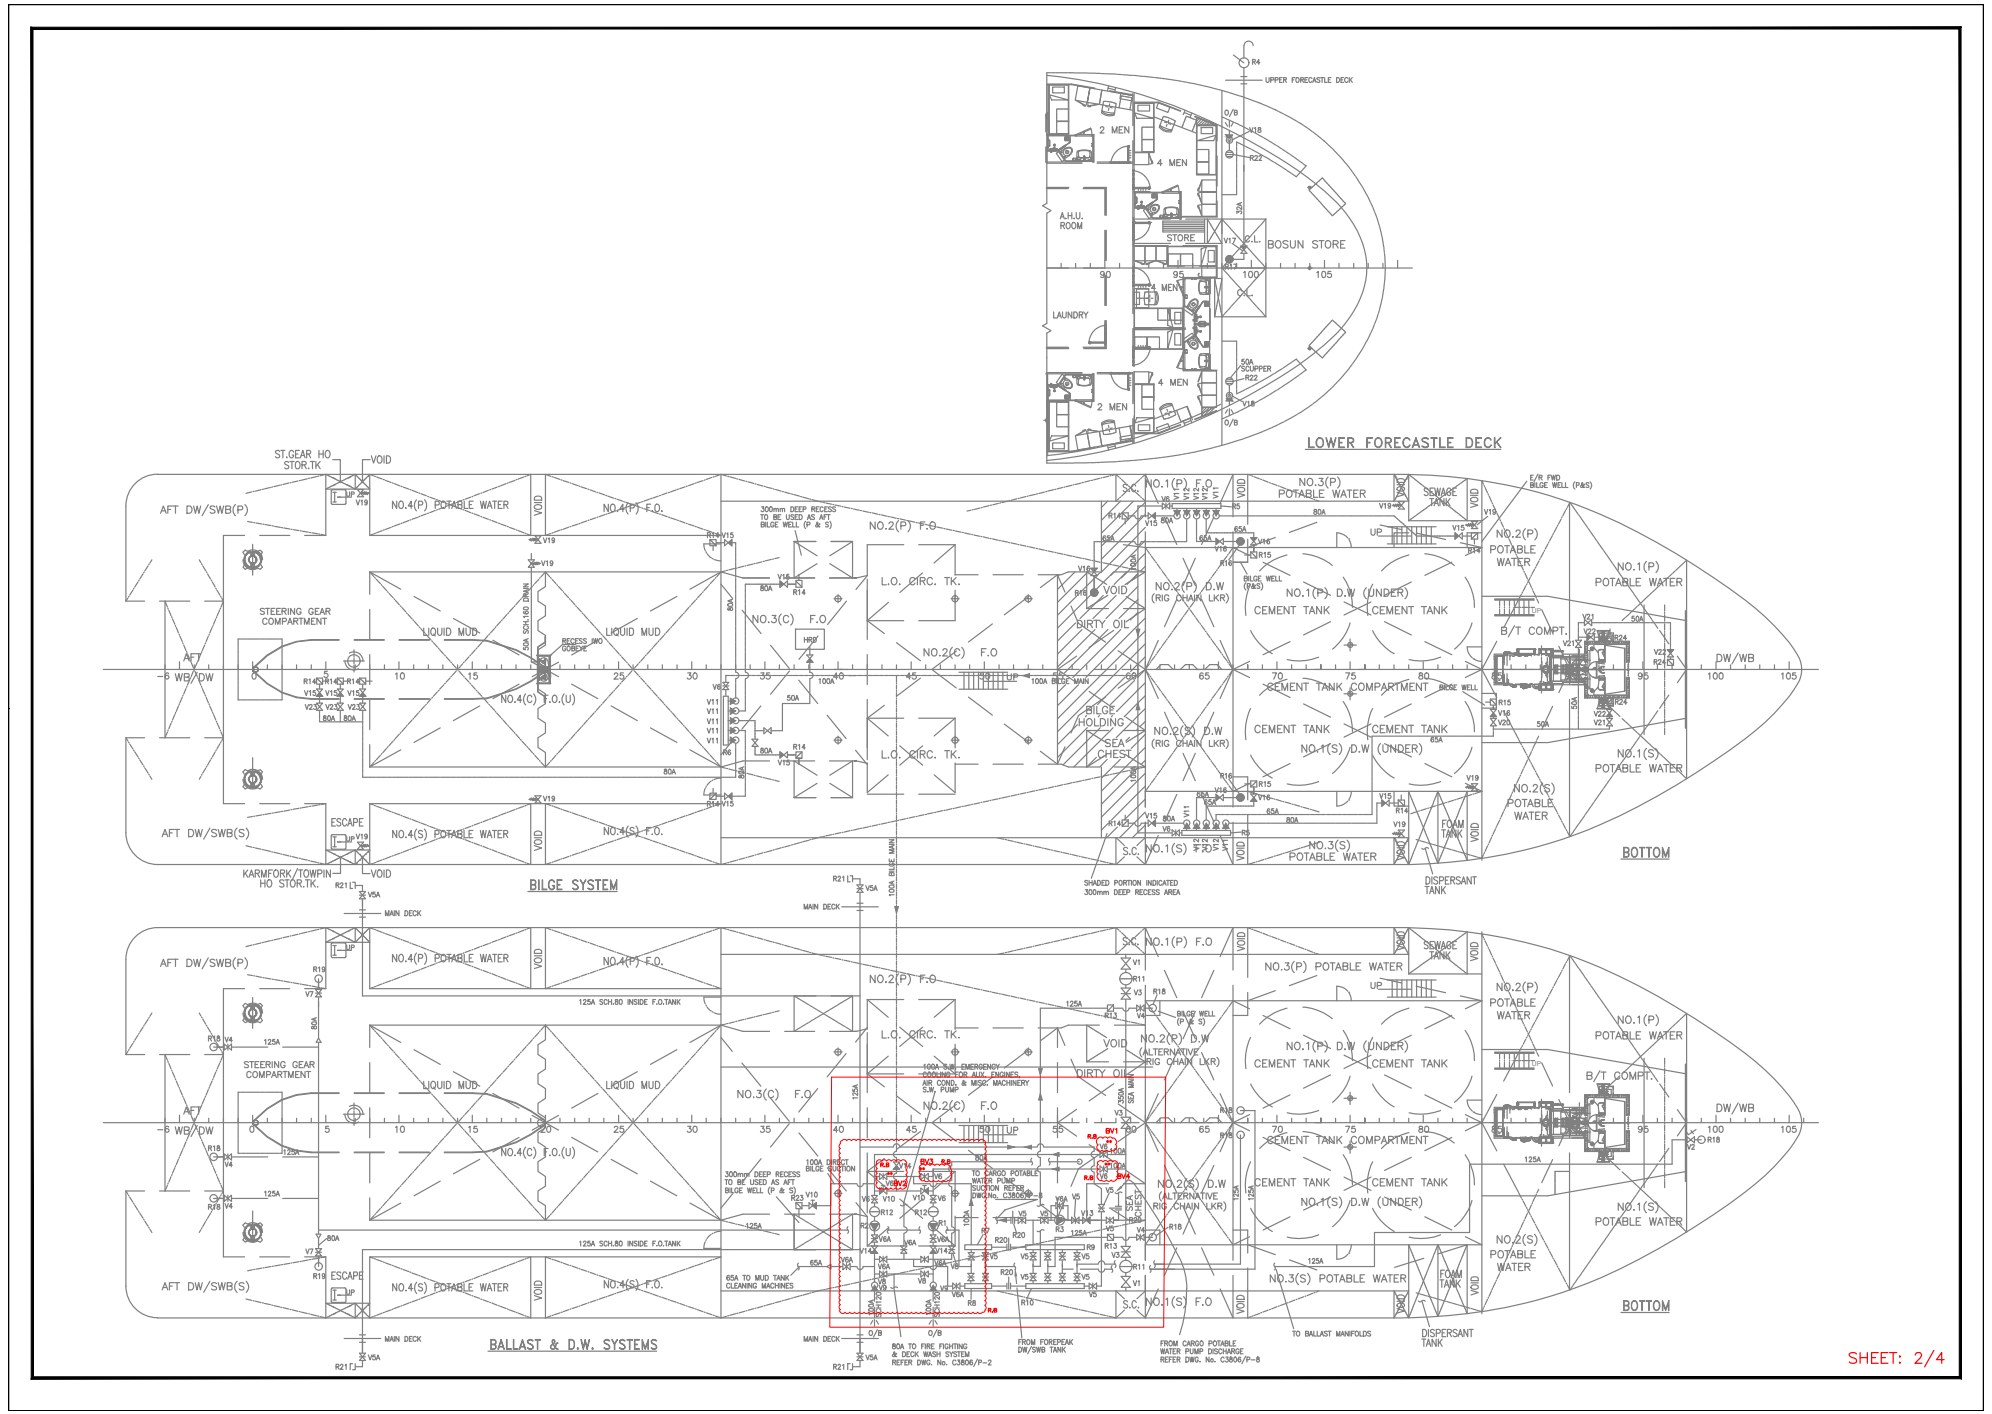
[picture p155: page 2]

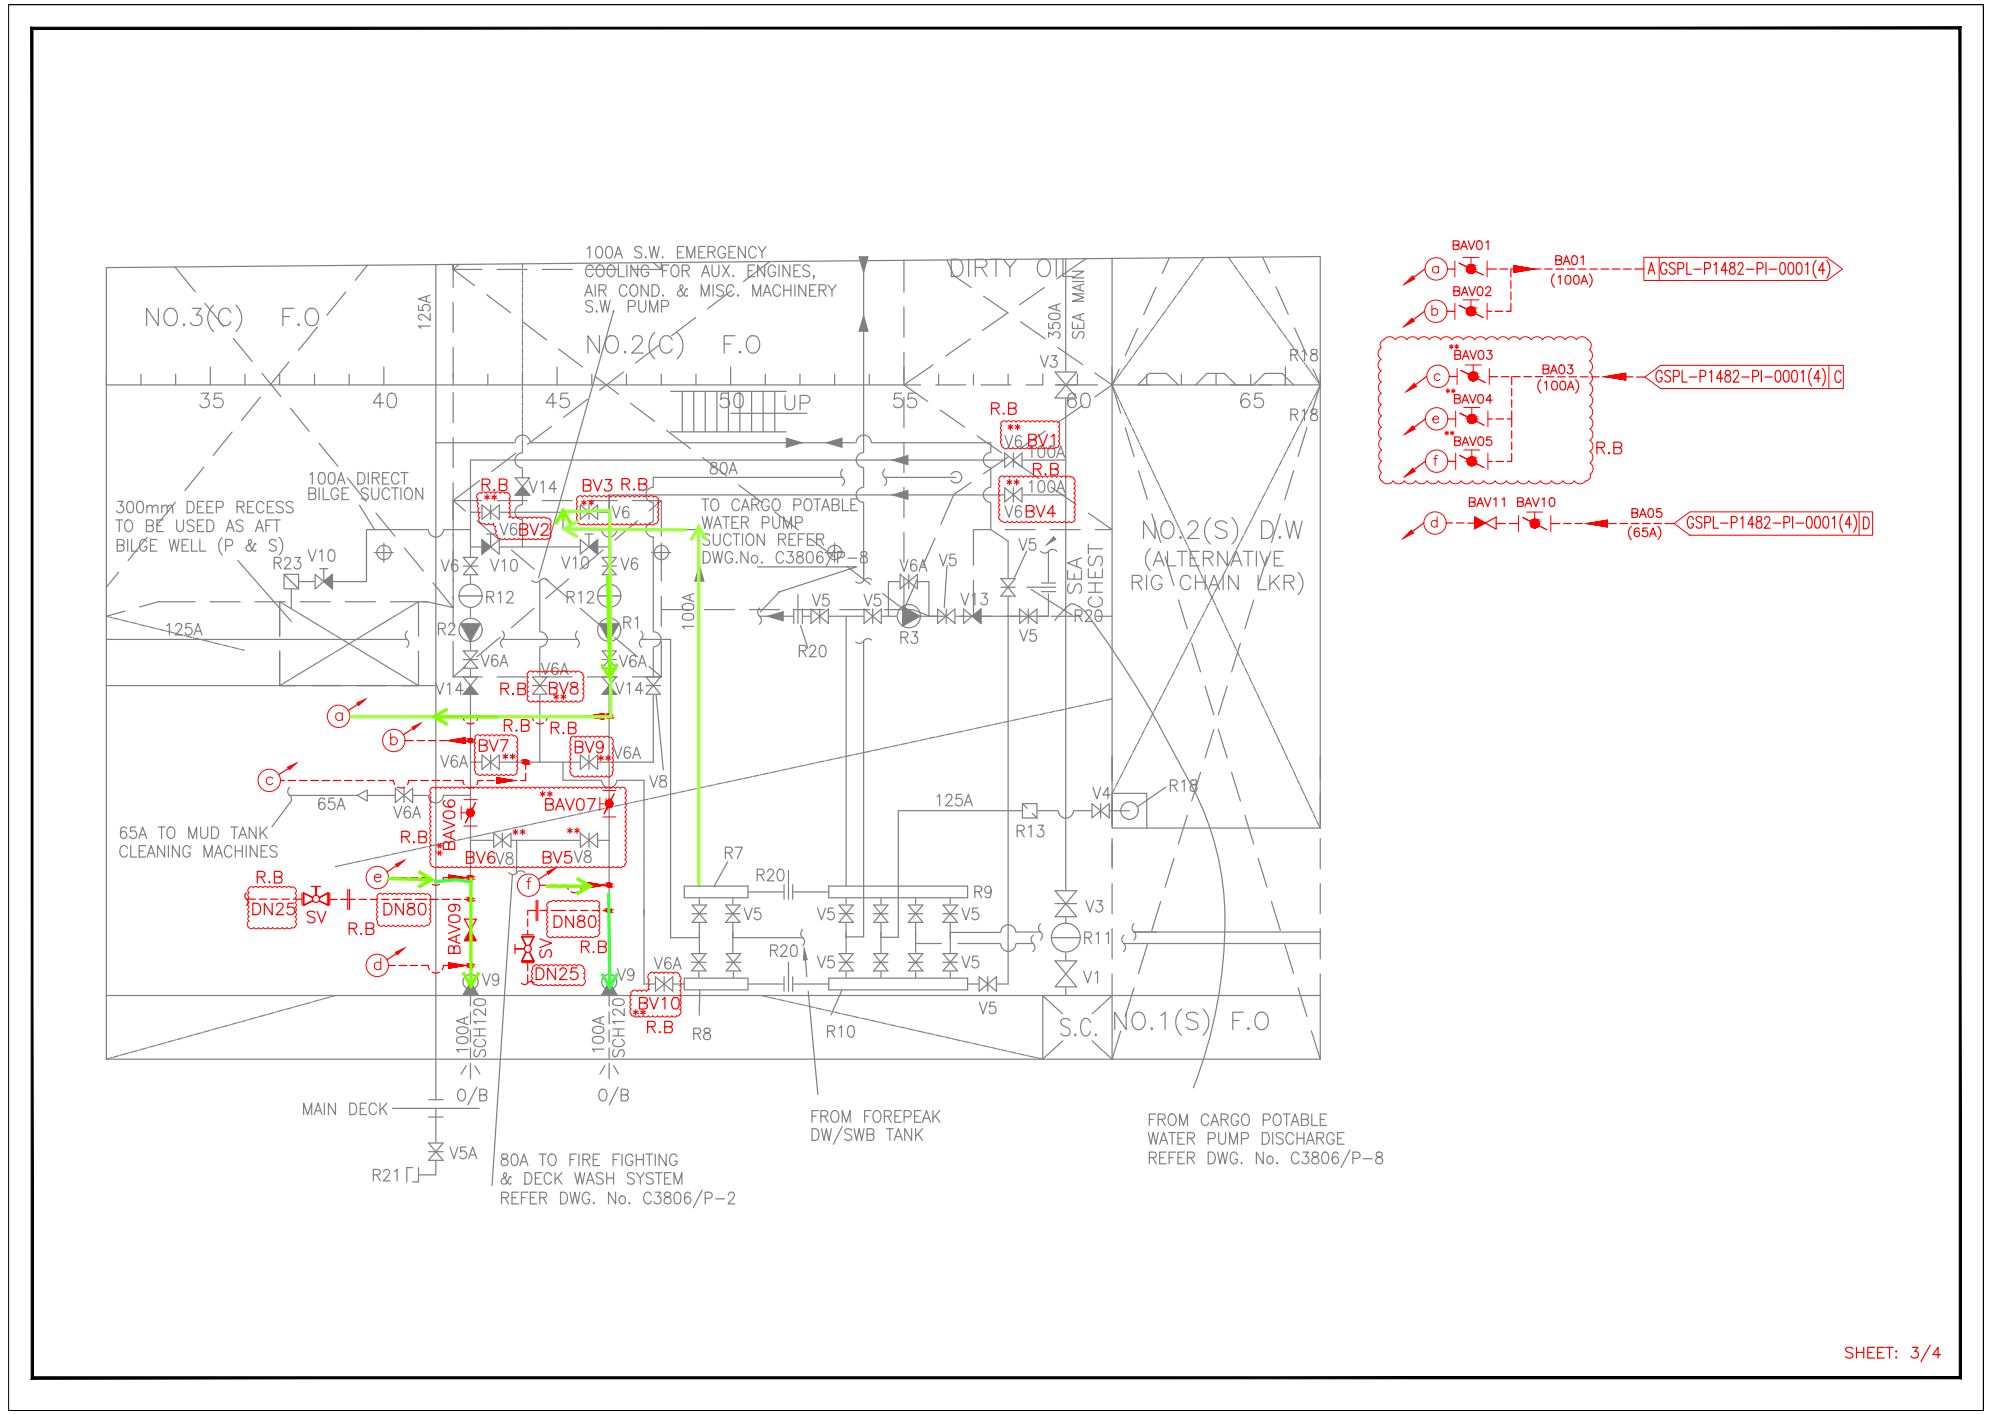
[picture p156: page 3]

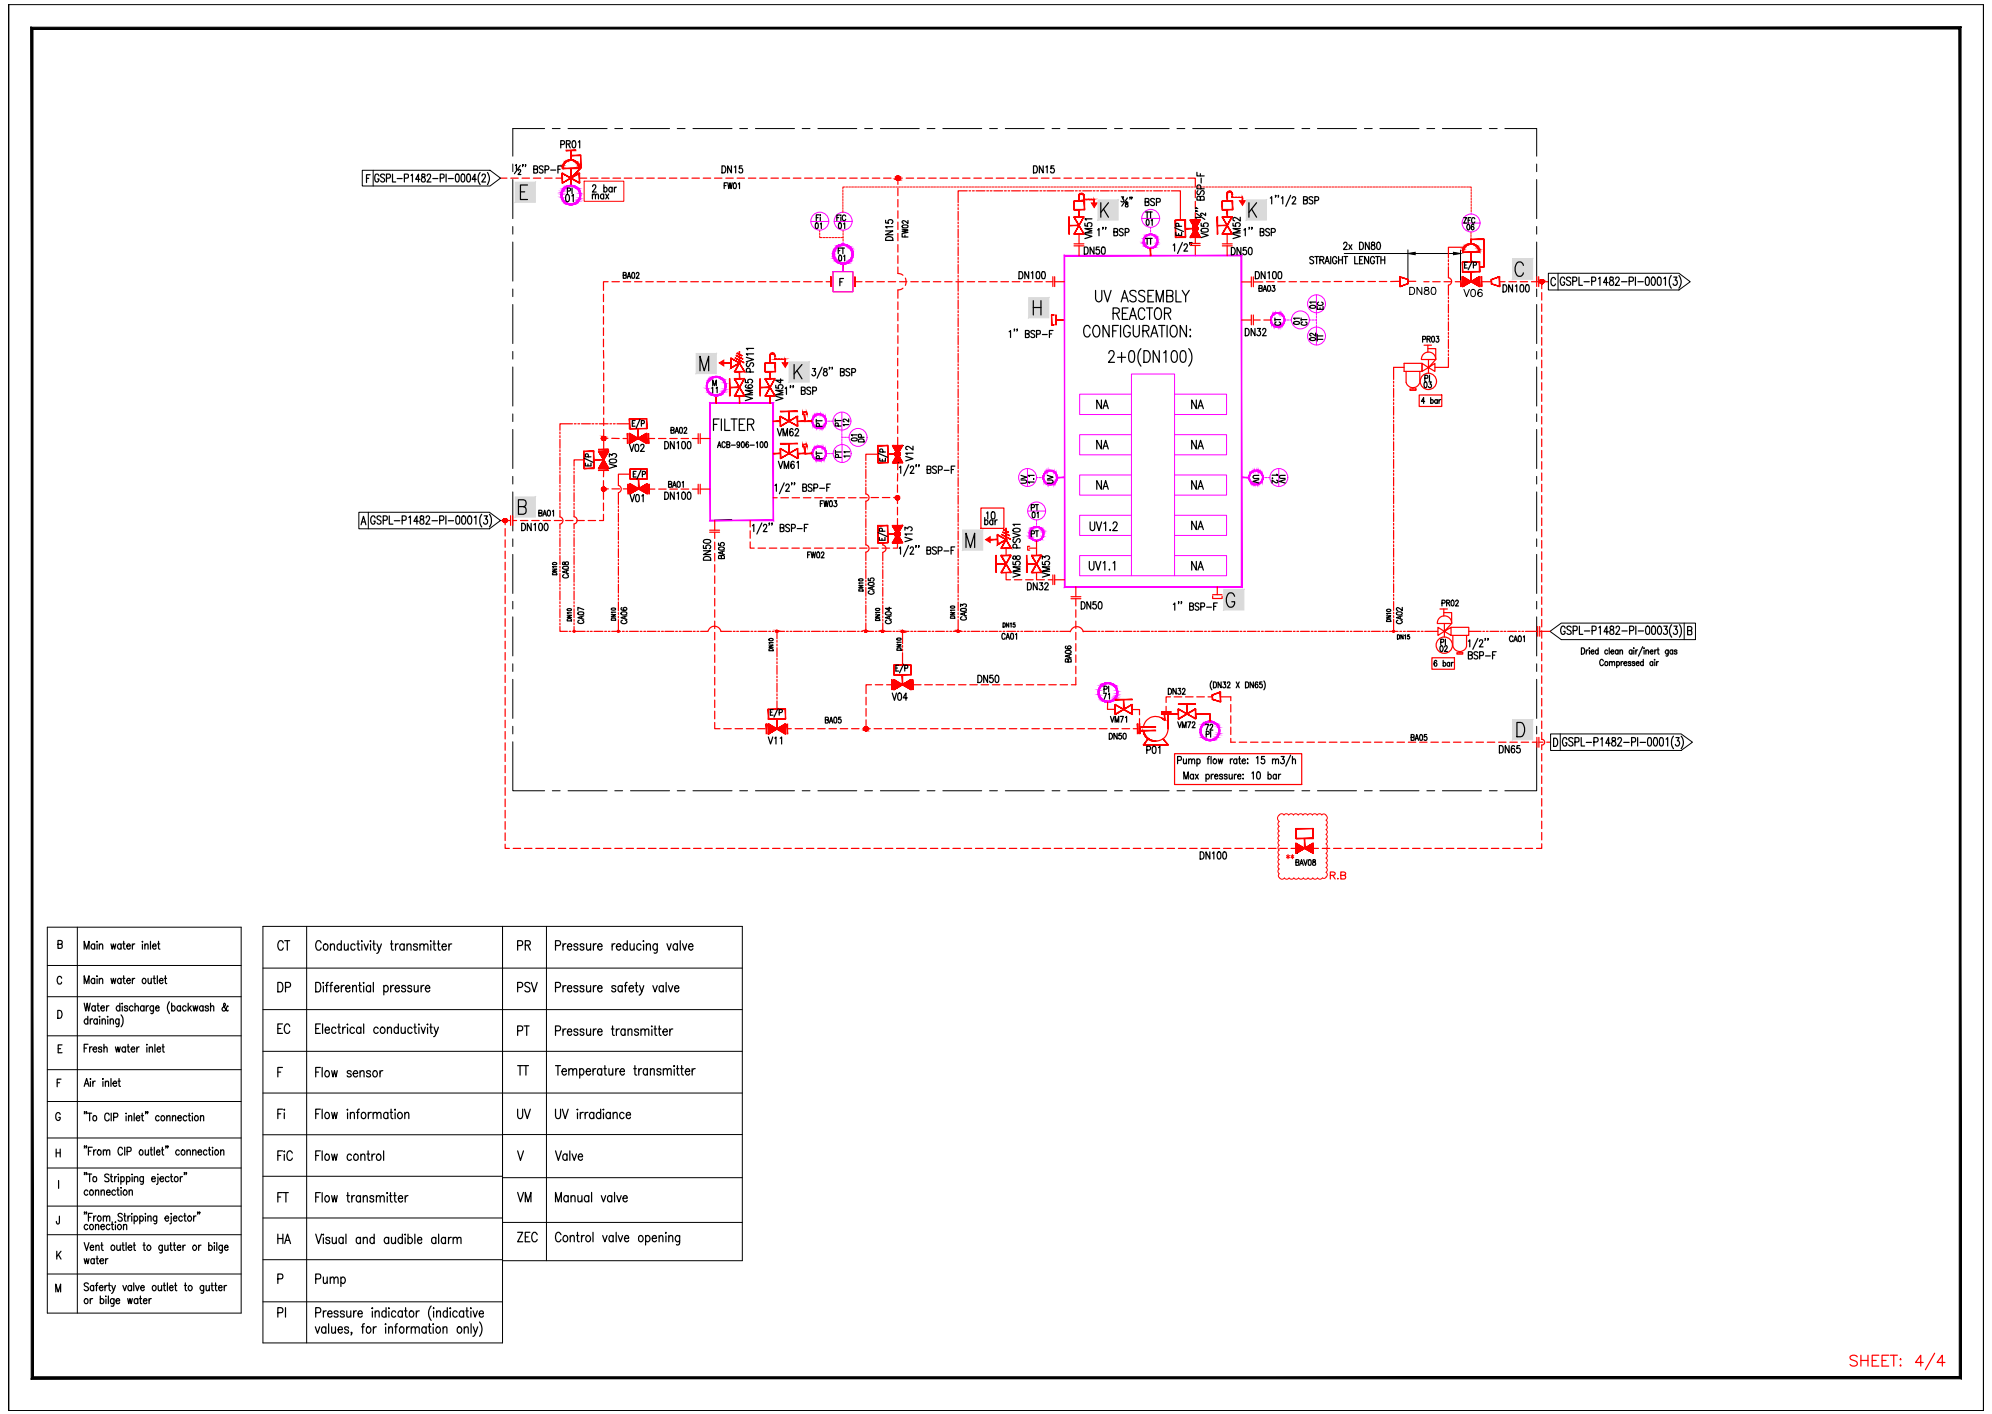
[picture p157: page 4]
