anurakj/J88_stork/0)_old_revisions/GSPL-P1482-PI-0001 BWTS PIPING SCHEMATIC R.C.pdf

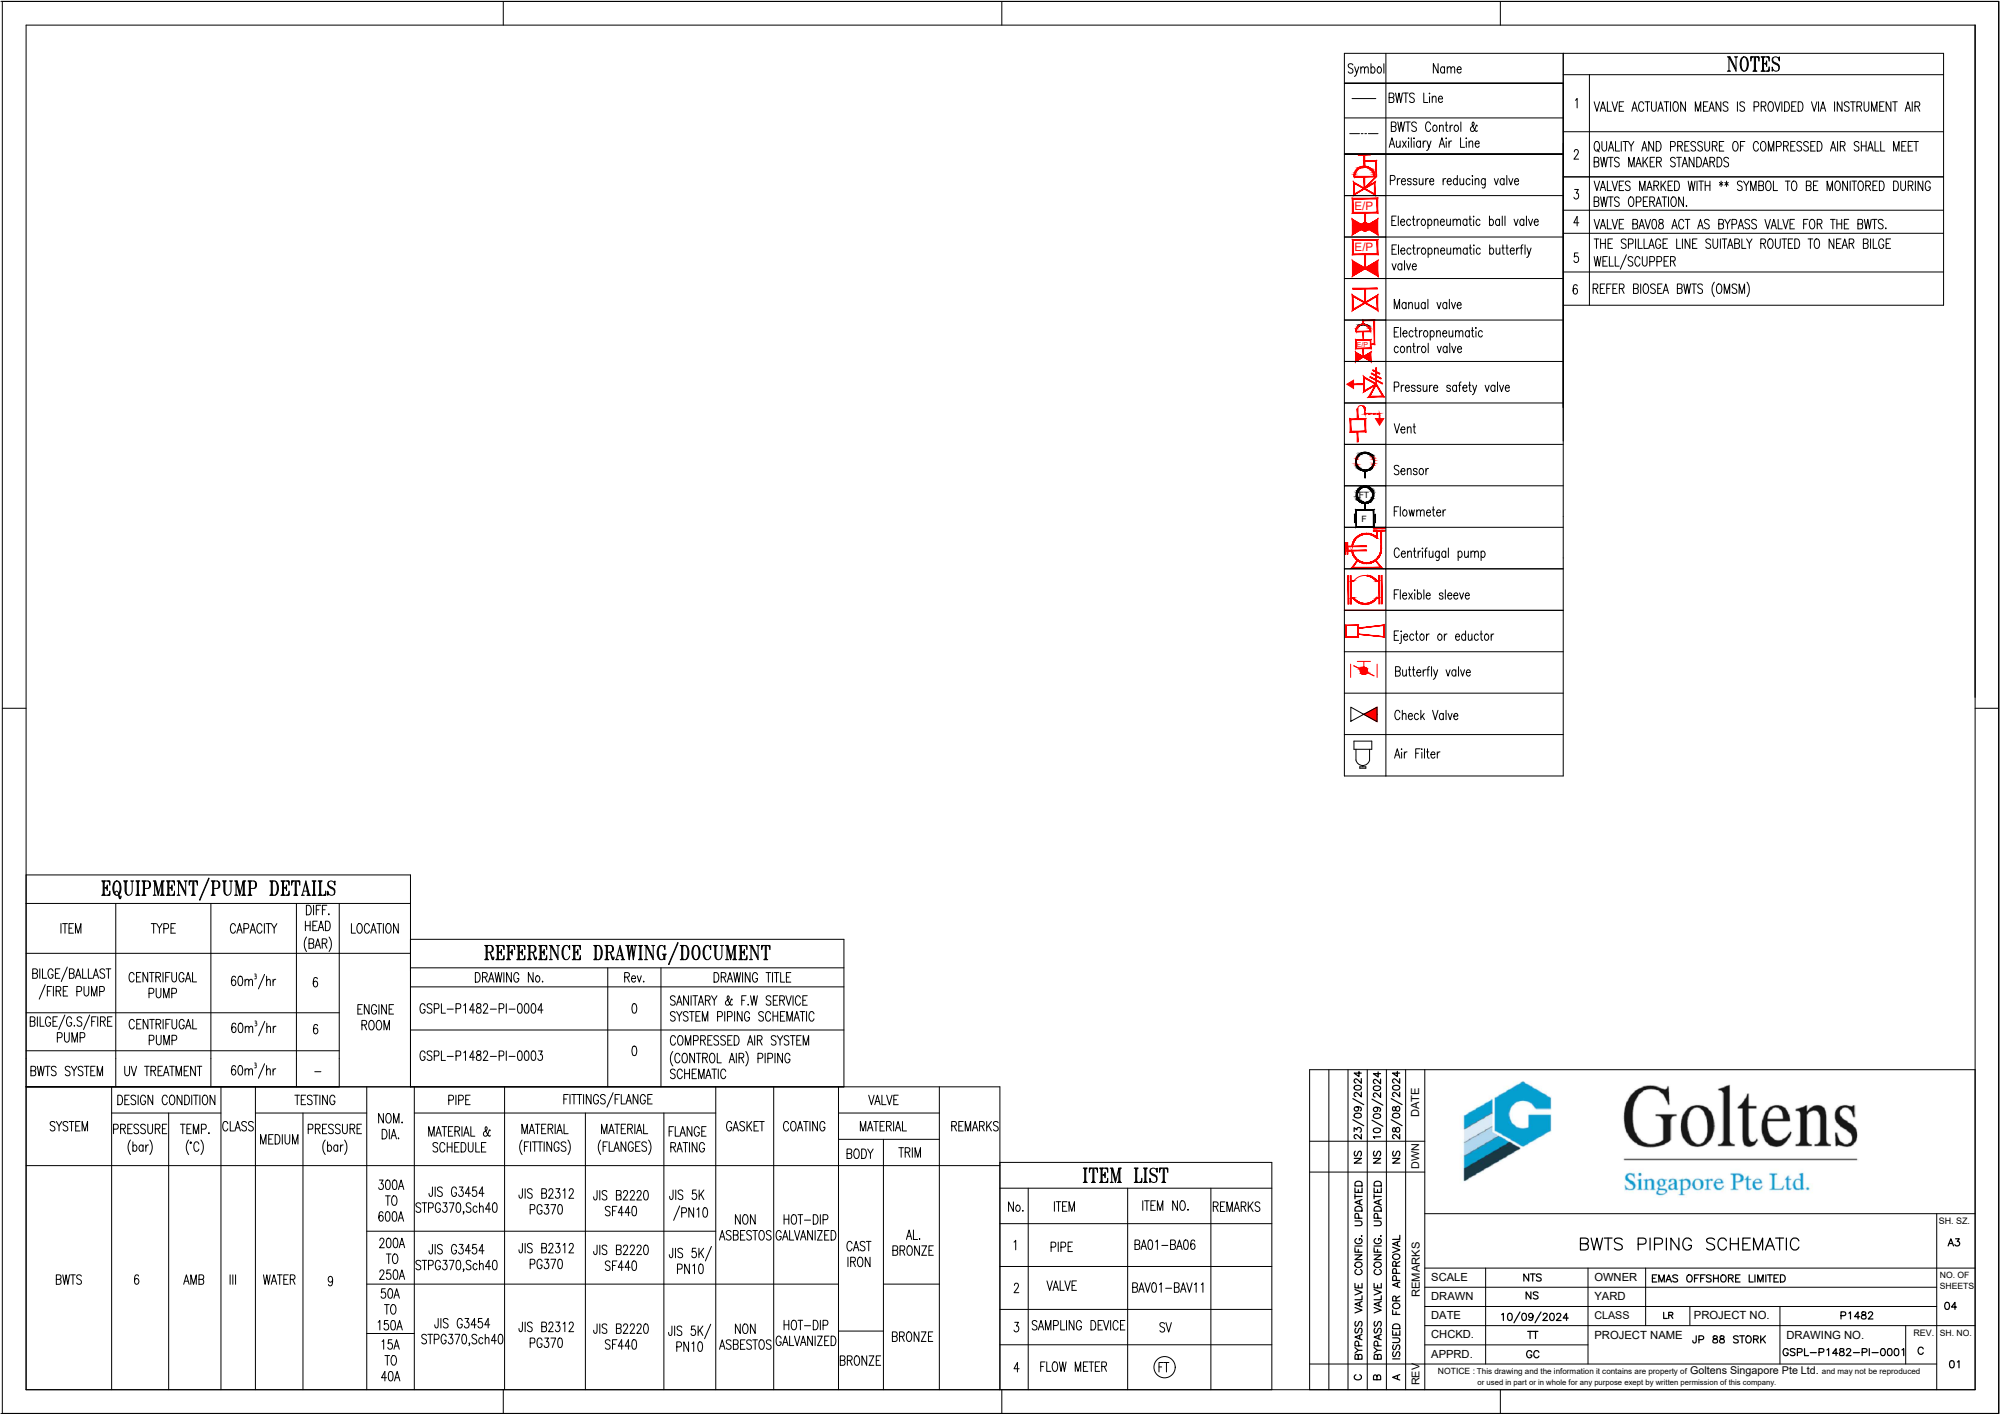
[picture p161: page 1]
This drawing and the information it contains are property of CHCKD.; PROJECT NAME; DRAWING NO. or used in part or in whole for any purpose exept by written permission of this company. NOTICE : APPRD.; Goltens Singapore Pte Ltd. and may not be reproduced DRAWN DATE SCALE; YARD CLASS OWNER; SH. NO. NO. OF REV.

REMARKS REV DWN DATE PROJECT NO. SHEETS ³³ FTFE/P E/P E/P ³

UPUP
